JDSCS-Club/DENVER_CCP/DOC/11_SW코드/CPLD_FPGA/RF_COM/readme.txt

<Download file Content>
1. PAC board download file
  - Main CPU : DPAC_060224.bin
  - CPLD : pac_cpld_130419.jed
  - MP3 chip : Septa_Decord_150721.hex
2. DPO board download file
  - CPLD : dpo_151102.jed
3. VOIP board download file
  - VoIP app image : dvoip_0216.bin
4. INT board downlad file
  - CPLD : pac_int_160126.jed
5. PEI board download file
  - CPLD : pei_151029.jed
