JDSCS-Club/DENVER_CCP/DOC/Others/덴버_전동차_통신시스템_분석.md

# 미국 덴버 전동차 통신 시스템 분석 자료

> 작성일: 2026-04-02  
> 프로젝트: Denver EMU (Electric Multiple Unit) Communication System  
> 발주처: RTD (Regional Transportation District) - Denver, Colorado, USA  
> 원청: 현대로템 (Hyundai Rotem)

---

## 1. 프로젝트 개요

미국 콜로라도주 덴버 RTD 경전철 전동차에 탑재되는 **승객 안내 및 통신 시스템(PIS/Communication System)** 개발·납품 프로젝트.  
현대로템이 차량 제작을 담당하고, 우진산전(JDS)이 통신 시스템 서브시스템을 공급하는 구조.

### 1.1 차량 구성
- A Car / B Car 편성 (2량 1편성 기준, 중련 운행 지원)
- 총 50량 규모 (예비품 포함)

### 1.2 프로젝트 타임라인 (폴더 기반 추정)
| 시기 | 주요 활동 |
|---|---|
| 2011.11 | 초기 설계 검토, PT 발표 (Denver 2011_11_28) |
| 2012.01 | SEPTA 참고 자료 검토, 사양 확정 |
| 2012.03 | 현차 조치 방안 수립 (접지, 커넥터, 트랜스포머) |
| 2012.06 | 캐나다 출장 (프로그램, FPGA, LON 작업) |
| 2012.09~10 | 결선도 수정, ROTEM 도면 수신 |
| 2012.11~12 | 도면 수정, 설계 자료 확정 |
| 2013.01 | 창원 공장 확인 |
| 2013.05 | 설계 변경(설변) 내용 정리 |
| 2016.06 | 자동 방송 불량 시험 |
| 2017.03 | 중련 CI 고장 시험, 출장 |
| 2017.07~09 | CNCS 발열(FAN) 대응, FAN 도면/정비 지침서 |
| 2018.03~06 | MDS DDD 수정, CNCS 485통신, RMM/IPC 문서 작업 |
| 2018.09 | PID 파워 불량/영상 출력 불량 대응 |

---

## 2. 시스템 구성 장치

### 2.1 주요 장치 목록

| 장치 약어 | 장치명 | 기능 |
|---|---|---|
| **CRA** | Central Rack Assembly | 중앙 처리 장치 (메인 컨트롤러) |
| **MDS** | Master Display System (CDT) | 마스터 디스플레이 / 안내 표시 장치 |
| **PID** | Passenger Information Display | 객실 승객 안내 표시기 |
| **PEI** | Passenger Emergency Intercom | 승객 비상 인터콤 |
| **ISP** | Interior Speaker Panel | 객실 내 스피커 패널 |
| **LIC** | Line Intercom Controller | 라인 인터콤 제어기 |
| **CCP** | Cab Control Panel | 운전실 제어 패널 |
| **CNCS** | Communication Network Control System | 통신 네트워크 제어 시스템 |
| **ANSM** | Automatic Next Stop Module | 자동 다음 정거장 안내 모듈 |
| **DPO** | Driver's Panel Operator | 운전자 패널 조작기 |
| **SDI** | Serial Data Interface | 직렬 데이터 인터페이스 |
| **RMM** | Repair & Maintenance Manual | 정비 매뉴얼 (문서) |

### 2.2 통신 프로토콜 및 네트워크

| 기술 | 용도 |
|---|---|
| **LON Works** | 차량 내 제어 네트워크 (Echelon 기반) |
| **RS-485** | CNCS 직렬 통신 |
| **VoIP** | 음성 통신 (AudioCodes 프로세서 기반) |
| **WiMAX** | 무선 데이터 통신 (차량-지상 간) |
| **FTP** | 파일 전송 (데이터 다운로드/업로드) |
| **CCP 통신** | RTS 제어 기반 Cab 간 통신 |
| **CI (Consist Interface)** | 중련 편성 간 인터페이스 |

---

## 3. 하드웨어 설계

### 3.1 회로도 (PCB 보드)
- **LIC-C1** : LIC 메인 보드 Rev.1
- **LIC-C2** : LIC 보드 Rev.2
- **LIC-C3 / C3A** : LIC 보드 Rev.3 (DXF, GERBER, PCB 파일 포함)
- **APEM Switch** : 운전실 조작 스위치 회로

### 3.2 주요 부품 (데이터시트 기반)
| 카테고리 | 부품 |
|---|---|
| CPU | TMS320VC33 (DSP), Qseven 보드 |
| 통신 IC | XR16L784 (UART), MAX3535E (RS-485) |
| CPLD | XC95288XL (Xilinx) |
| VoIP | AudioCodes VoIP Processor, CFM53281 |
| 스피커 | Fly Installed Sound 시리즈 |
| 마이크 | AKG PS3F, Gooseneck MIC (MX405/410) |
| 스위치 | APEM Switch, EAO 시리즈, E-Switch |
| 커넥터 | Souriau MSG, Glenair (넥서스), ITH 시리즈 |
| 전원 | MZH30xx 시리즈 DC-DC |
| 네트워크 | MOXA TN-5508/5516 산업용 스위치 |
| 기타 | ULN2803 (드라이버), 슈퍼캐패시터 |

### 3.3 도면 관리
- 덴버 승인도 (ROTEM 승인)
- 차량 배선도 (A Car: RGA10001, B Car: RGA10002)
- 결선도 (2012.09 수정본)

---

## 4. 소프트웨어 구성

### 4.1 프로그램 구조
| 구분 | 내용 |
|---|---|
| LIC 펌웨어 | LIC 보드 제어 프로그램 (CPLD 포함) |
| CCP 프로그램 | AnCCP_MFC (MFC 기반 응용), CCP DB |
| LON 프로그램 | LON Works 네트워크 제어 |
| FPGA | 하드웨어 로직 설계 |
| DPViewer | 디스플레이 뷰어 프로그램 |
| 필드시험 | FTP 데이터 수집/분석 도구 |

### 4.2 SW 문서 체계 (CMMI 기반)
- **SDB** (Software Design Baseline) - WJ_SDB_001
- **STP** (Software Test Procedure) - WJ-STP-002
- **TP** (Test Procedure) - WJ-TP-001
- **SFD** (Software Functional Description / Dead Reckoning)
- **DDD** (Design Description Document) - MDS용
- **FDR** (Formal Design Review) 패키지
- Door System SW 문서 (REDE114718)

---

## 5. 주요 이슈 및 대응 이력

### 5.1 FMI (Field Modification Instruction) 목록

| FMI # | 내용 | 비고 |
|---|---|---|
| #7 | Audio 필터 | 오디오 품질 개선 |
| #8 | CRA Main Update | 메인 보드 업데이트 |
| #9 | BIOS Update | 시스템 BIOS 갱신 |
| #10 | PID Video Update | 영상 출력 업데이트 |
| #11 | RS-485 Board Replacement | 통신 보드 교체 |
| #12 | Software Update | 전체 SW 업데이트 |
| #13 | CAB Latch | 운전실 래치 개선 |
| #14 | ANSM 교체 작업 방법 | 모듈 교체 절차 |
| #15 | MDS Time Stamp | 시간 동기화 문제 |
| #16 | CCP Update | 제어 패널 업데이트 |
| #17 | FAN | 냉각팬 관련 |
| #18 | LIC / VoIP | 인터콤 및 VoIP 개선 |
| #18-1 | LIC Update | LIC 추가 업데이트 |
| #19, #20 | DPO / PEI | 운전자 패널, 비상 인터콤 |
| #21 | PID Power 서포트 변경 | 전원 공급 구조 변경 |

### 5.2 주요 기술 이슈

| 이슈 | 상세 |
|---|---|
| **CNCS 발열 (FAN)** | CNCS 장치 과열 → FAN 추가 설계, 정비 지침서 작성, 로템 추가 요청 자료 대응 (2017) |
| **자동 방송 불량** | 자동 안내 방송 오작동 → 로그 분석, 현차 시험 (2016.06) |
| **CNCS 485 통신** | RS-485 통신 불안정 → 프로그램 수정 (MainTest 6/7 버전) |
| **CI Shift** | 중련 편성 시 CI 인터페이스 고장 → 시험 대응 (2017.03) |
| **CCP 통신 고장** | RTS 제어 관련 통신 장애 |
| **PID 파워/영상 불량** | PID 전원 불량 및 영상 출력 장애 (2018.09) |
| **Gooseneck MIC 불량** | 마이크 입력 회로 불량 |
| **FTP 부하** | 파일 전송 시 윈도우 시스템 부하 발생 |
| **MDS Time Stamp** | MDS 시간 동기화 오류 |
| **MDS DDD 수정** | 설계 문서 수정 검토 (Paul Lee 수신, 2018) |
| **RF_COM NCR** | RF Communication 부적합 보고서 대응 (VoIP 포함) |
| **PEI-OCC** | 승객 비상 인터콤 ↔ OCC 연동 이슈 |
| **LIC 수리품** | LIC 보드 수리 및 재시험 (S/N 14017) |

---

## 6. 문서 체계

### 6.1 기술 문서
- Communications System Operator's Manual (운영 매뉴얼)
- IPC (Illustrated Parts Catalog) - Ch.10 Communication System (Rev.6~7)
- HMM (Heavy Maintenance Manual)
- RMM (Repair & Maintenance Manual)
- Test Procedure (EMI/EMC 포함)
- RAMS (Reliability, Availability, Maintainability, Safety)
- Denver RTD 문서
- MDS/CDT 인터페이스 문서
- 프로토콜 문서

### 6.2 설계 문서
- 회로도 (LIC-C1 ~ C3A)
- 결선도 / 차량 배선도
- 승인도 (ROTEM 승인)
- BOM (Bill of Materials)
- 데이터시트 (CPU, 통신, 전원, 커넥터 등)

### 6.3 품질/계약 문서
- CMMI SW 공학 문서
- PPS (Project Planning Summary)
- ROTEM 계약서 (PTS)
- 견적 자료
- EMI/EMC 시험 성적서

---

## 7. 협력 업체

| 업체 | 담당 분야 |
|---|---|
| 현대로템 (Hyundai Rotem) | 차량 제작, 원청 |
| RF_COM (r-f_com) | RF 통신 모듈 |
| 아이텍 | 하드웨어/소프트웨어 |
| 엑스바이더 | 시스템 관련 |
| 넥서스 (Nexus) | 커넥터 (Glenair) |
| 원텍 | 부품 공급 |
| 웨이브시스템 | 통신 관련 |
| 앤츠 | IPC 관련 |
| 이지파워 | PCB 제작 |
| HS_INS | 부품/장비 |
| SOURIAU MSG | 커넥터 |
| 에버론 | LON Works 관련 |

---

## 8. 폴더 구조 요약

```
denver/
├── 문서/                          # 기술 문서 전체
│   ├── cmmi/                      # CMMI SW 공학 문서
│   ├── Communications System Operator's Manual/
│   ├── denver fdr/                # FDR (설계 검토) 자료
│   ├── denver ipc/                # IPC (부품 카탈로그)
│   ├── mds(cdt) 문서/             # MDS 인터페이스/FDR 문서
│   ├── EMI_EMC 원본 스켄/         # EMI/EMC 시험 성적서
│   ├── Wimax/                     # WiMAX 통신 자료
│   ├── 업체 자료/                 # 협력업체별 자료
│   ├── 파워 포인트 자료/          # 발표/보고 자료
│   └── 견적 관련 자료/            # 견적/원가 자료
├── 설계/                          # 하드웨어 설계
│   ├── 회로도/                    # LIC-C1~C3A, APEM Switch
│   ├── 도면/                      # 승인도, 배선도, 결선도
│   └── DENVER 그림/               # 시스템 구성도
├── program/                       # 소프트웨어
│   ├── CCP/                       # CCP 프로그램
│   ├── lic/                       # LIC 펌웨어, CPLD
│   ├── DPViewer/                  # 디스플레이 뷰어
│   └── 필드시험/                  # 현장 시험 데이터
├── 이슈사항 정리/                 # 이슈 트래킹
│   ├── FMI/                       # FMI #7~#21
│   ├── CNCS 발열(FAN)/            # 발열 대응
│   ├── 자동 방송 불량/            # 방송 불량 대응
│   └── ... (30개 이슈 폴더)
├── 데이타 시트/                   # 부품 데이터시트
├── 자료/                          # 참고 자료, 사진, LON Works
├── 매뉴얼제출문서/                # IPC/RMM 제출 문서
├── VOIP 시험 자료/                # VoIP 시험
├── SEPTA 문제점/                  # SEPTA 프로젝트 참고
└── MDS 창원 시험 데이타/          # MDS 공장 시험 데이터
```

---

## 9. 핵심 요약

- **프로젝트 성격**: 미국 덴버 RTD 경전철 전동차 통신 시스템 (PIS/PA/Intercom/VoIP)
- **시스템 규모**: CRA, MDS, PID, PEI, ISP, LIC, CCP, CNCS, ANSM 등 10종 이상 장치
- **통신 기술**: LON Works + RS-485 + VoIP + WiMAX 복합 네트워크
- **핵심 HW**: TMS320VC33 DSP, Xilinx CPLD, AudioCodes VoIP, MOXA 산업용 스위치
- **주요 이슈**: CNCS 발열, 자동 방송 불량, RS-485 통신 불안정, PID 전원/영상 불량 등 30건 이상
- **문서 체계**: CMMI 기반 SW 공학 문서 + IPC/RMM/HMM 정비 문서 + EMI/EMC 인증
- **협력사**: RF_COM, 아이텍, 엑스바이더, 넥서스 등 10개 이상 업체 참여
