JDSCS-Club/DENVER_CCP/DOC/06_이슈_대응/FMI/42B-2018-0019 (FMI#19 HARDWARE MODIFICATION DPO_PEI).DOCX

DENVER RTD EAGLE P3
COMMUNICATION SYSTEM

# FIELD MODIFICATION INSTRUCTIONS FMI #19: HARDWARE MODIFICATION

# DPO / PEI

CONTRACT NO. | P110701149
CDRL NO. | N/A
WIS DOC. NO. | 42B-2018-0019
REVISION: | 1.0
DESIGNED: | D. S. JANG
REVIEWED: | J. Y. LEE
APPROVED: | B. J. JONE
DATE: | 2/08/2018

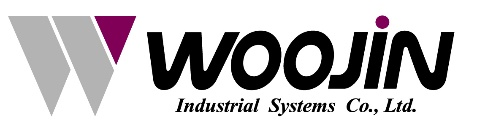
[picture p3: figure]
영문

# Record of Revisions

Rev. | Date | Description | Entered By
1.0 | 2/08/2018 | Initial release | D. S. Jang

# Table of Contents

# 1. Introduction

This FMI provides instructions to install the DPO,PEI and CCP.

# 2. Summary

This modification intends to implement the engineering change proposed as FMI #19. The modification applies to DPO and PEI units installed on the train.

# 3. Circuit changes

## 3.1 DPO / PEI changes

As a result of the DPO / PEI NCR cause analysis, most errors are caused by a malfunction of the AMP IC MP7720 at the speaker output terminals.

In the initial AMP IC design phase, designed DPO/PEI using a 10kΩ resistor (using AMP IC reference circuit) to stabilize the audio output level of the speaker output terminal.

However, the 10kΩ resistor cannot be protected from overload to the AMP IC and caused the operation to be disabled.

Therefore, the board changes the 10kΩ resistor to a 332pF capacitor and switches a circuit that bypasses external noise.

Other previous projects in 2017 have been verified by applying the change circuit. (Domestic Project - Seoul Metro Line No. 2)

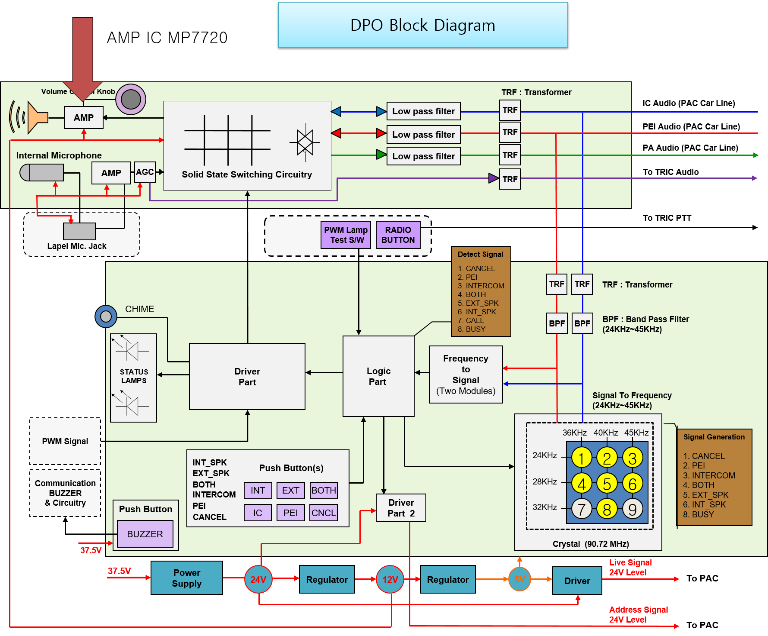
[picture p4: figure]

Figure 1 – DPO AMP IC Location.

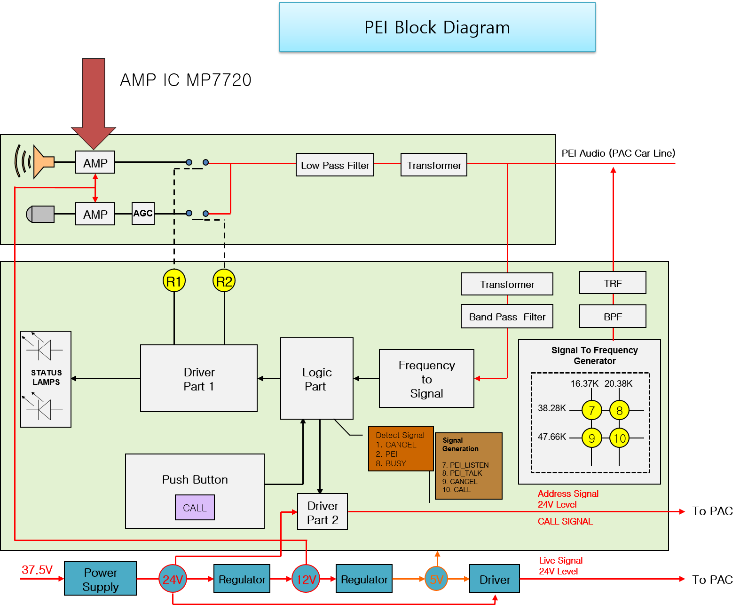
[picture p5: figure]

Figure 2 – PEI AMP IC Location.

1) Before Change
1 Proceeded the DPO and PEI design according to AMP IC MP7720 reference data sheet
2 Request the cause analysis to the IC manufacturer due that the NCR was consistently occurred to same IC
3 Received the scheme change for the Capacitor from IC manufacturer

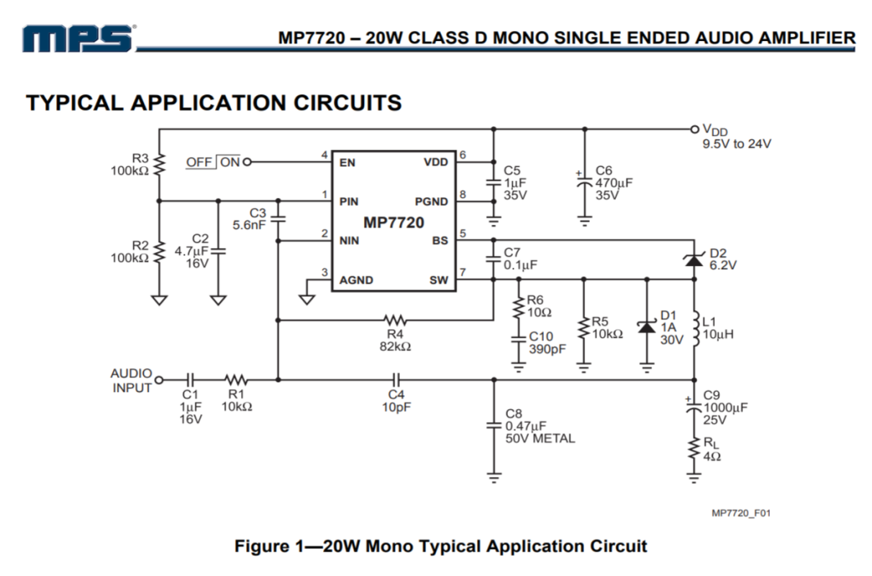
[picture p6: figure]

Figure 3 –AMP IC(MP7720) Reference circuit

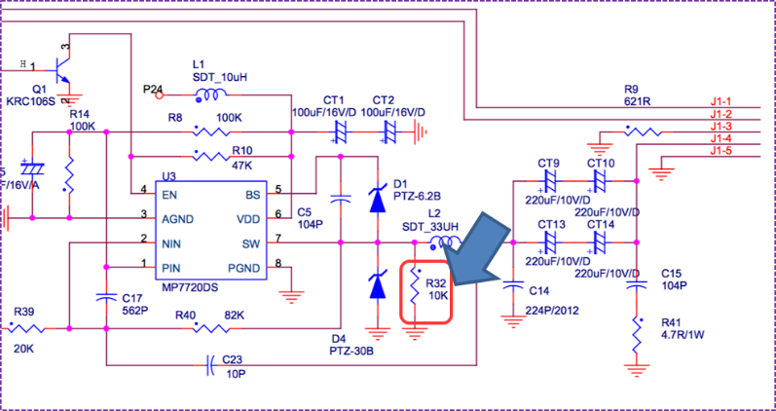
[picture p7: figure]
DPO Schematics

Figure 4 – DPO Board schematics

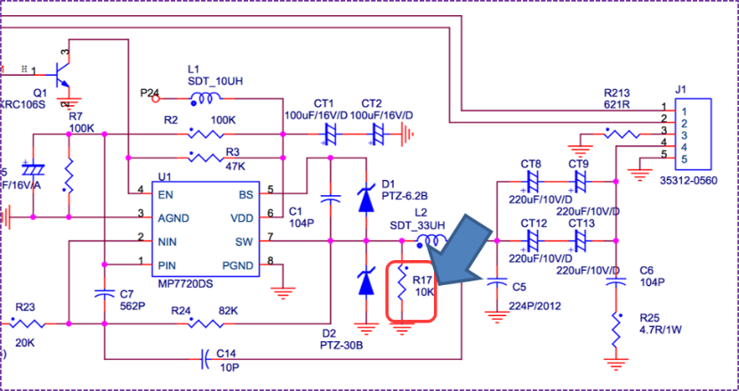
[picture p8: figure]
PEI Schematics

Figure 5 – PEI Board schematics

2) After Change.
1 Performed the simulation for the changes of Resistor to Capacitor
2 Confirmed the same audio output
3 Confirmed the improvement of the output waveform (Shown as the mark in Figure 7 and 8)

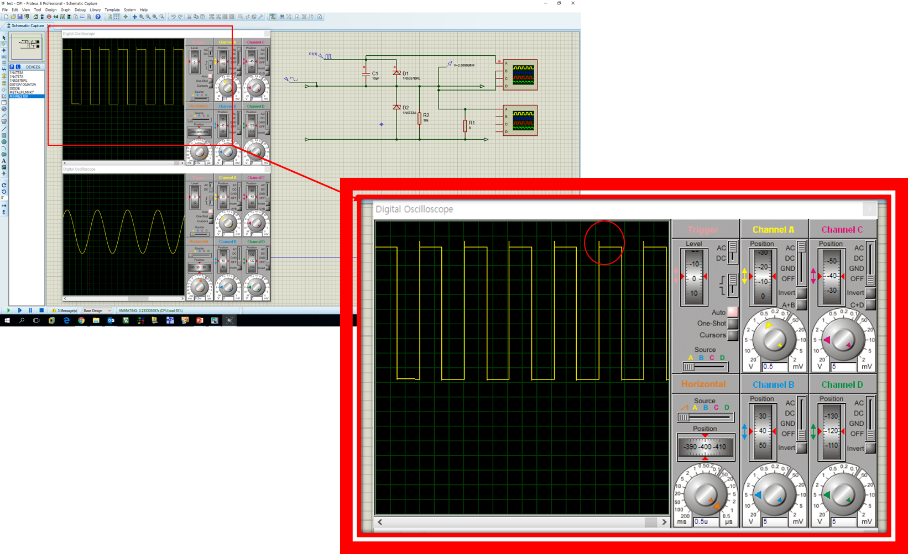
[picture p9: figure]

Figure 7 – 10kΩ Resistor simulation.

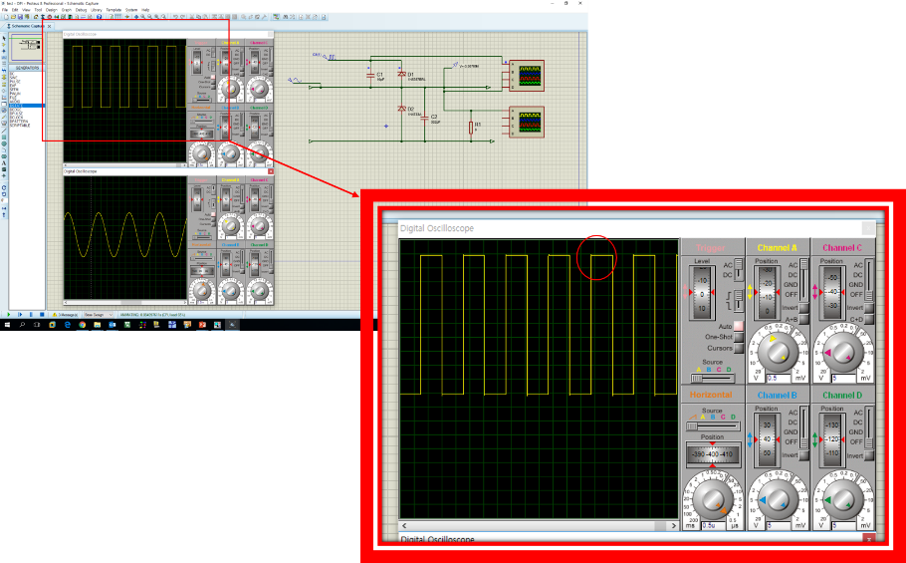
[picture p10: figure]

Figure 8 – 332pF capacitor simulation.

Description | Before Improvement | After Improvement | Remarks
DPO | R32 10kΩ | 332pF | capacitor
PEI | R17 10kΩ | 332pF | capacitor

# 4. Instructions

## 4.1 DPO Instructions

1) Place the COMCB and PICB to OFF position

2) Unscrew 4 mounting bolts on the DPO and PEI

3) Remove the DPO / PEI

4) Conduct PCB operations at designated locations

5) Installation the DPO / PEI

6) Place the COMCB and PICB to ON position

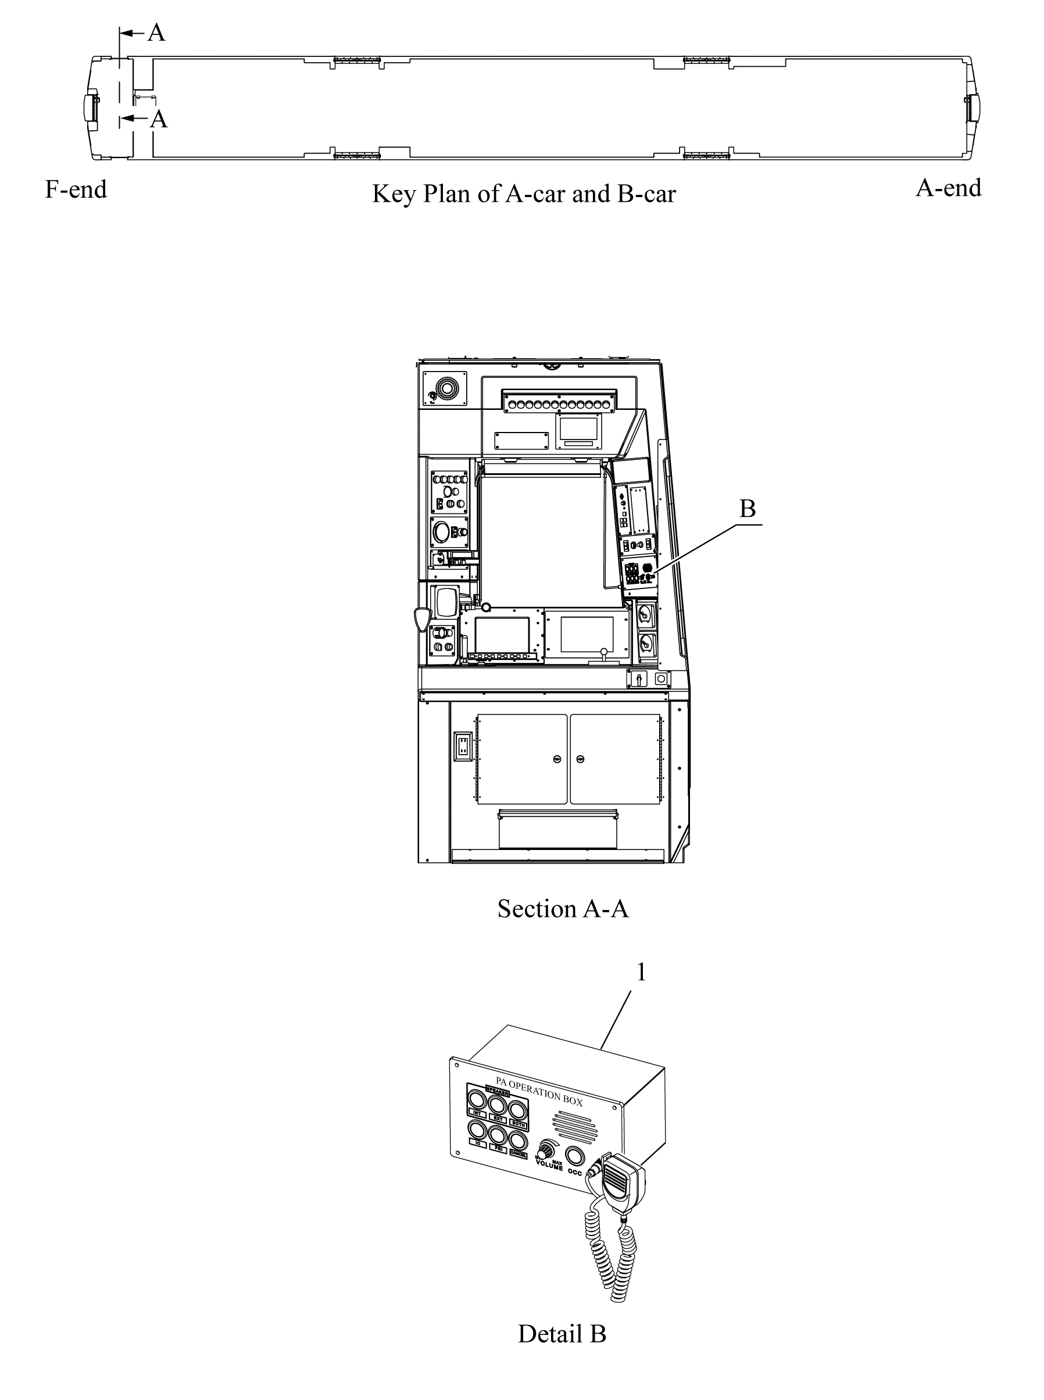
[picture p11: figure]
Loc of Driver PA Operation Box

Figure 9 – DPO Location

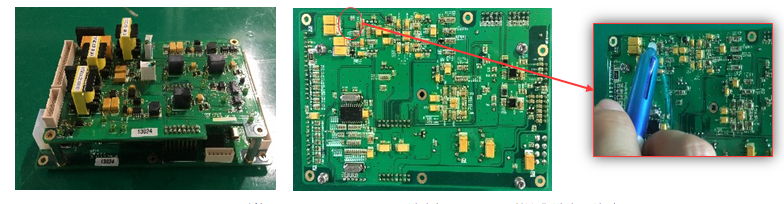
[picture p12: figure]

Figure 10 – DPO Board PCB

## 4.2 PEI Instructions

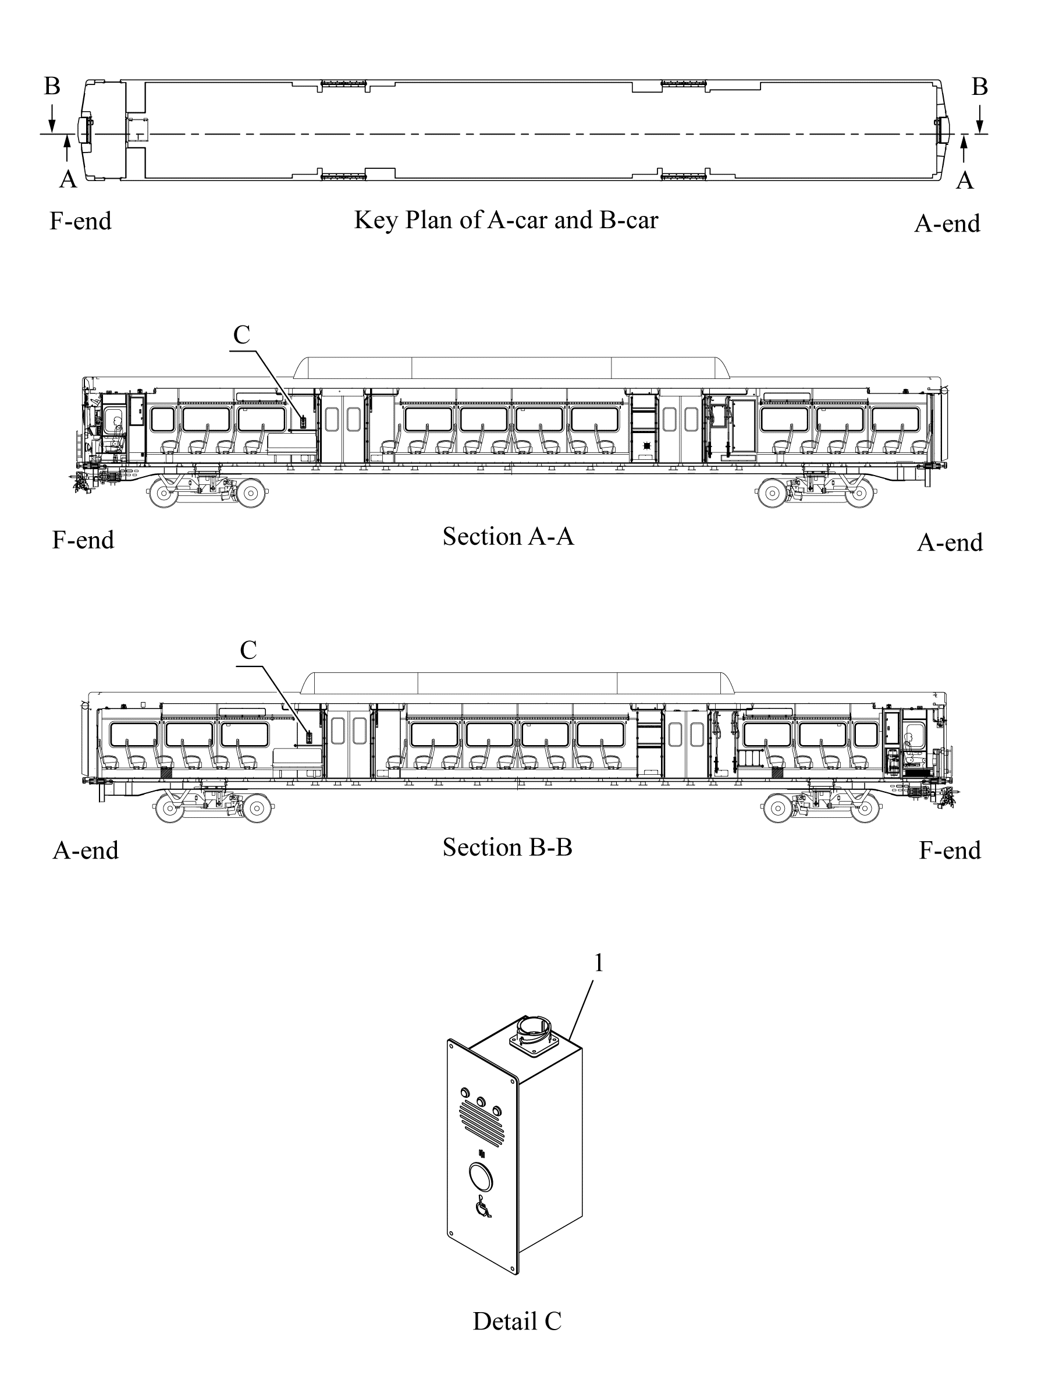
[picture p13: figure]
Location of PEI

Figure 11 – PEI Location

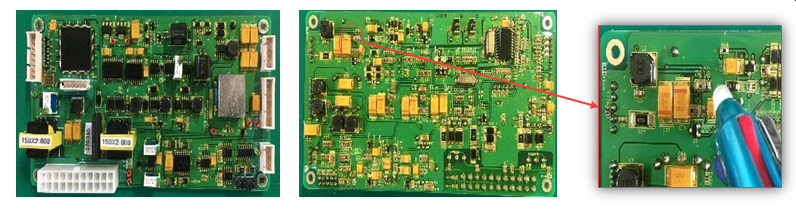
[picture p14: figure]

Figure 12 – PEI Board PCB

# 5. Testing

1) Key-on the cab

2) Using the CCP touchscreen, enter route number 10 or 11

3) Run the route simulation

4) Verify the simulated announcements and displays function appropriately.

7 of 10 © Copyright Woojin Industrial Systems Co., Ltd.

DENVER RTD EAGLE P3 COMMUNICATION SYSTEM FMI #19: HARDWARE MODIFICATION DPO / PEI DOC. NO. 42B-2018-0019 DATE 2/08/2018 REV. NO. 1.0
