JDSCS-Club/DENVER_CCP/DOC/06_이슈_대응/FMI/42B-2018-0020 (FMI #20 HARDWARE MODIFICATION CCP).DOCX

DENVER RTD EAGLE P3
COMMUNICATION SYSTEM

# FIELD MODIFICATION INSTRUCTIONS FMI #20: HARDWARE MODIFICATION

# CCP

CONTRACT NO. | P110701149
CDRL NO. | N/A
WIS DOC. NO. | 42B-2018-0020
REVISION: | 1.0
DESIGNED: | D. S. JANG
REVIEWED: | J. Y. LEE
APPROVED: | B. J. JONE
DATE: | 2/08/2018

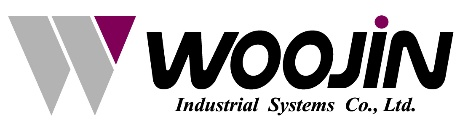
[picture p15: figure]
영문

# Record of Revisions

Rev. | Date | Description | Entered By
1.0 | 2/08/2018 | Initial release | D. S. Jang

# Table of Contents

# 1. Introduction

This FMI provides instructions to install the CCP.

# 2. Summary

This modification intends to implement the engineering change proposed as FMI #20. The modification applies to CCP units installed on the train.

# 3. Circuit changes

## 3.1 CCP CHANGES

As a result of CCP communication failure cause analysis, RTS failure which controls RS-485 communication was detected.

CCP Board controls RS-485 RTS using 74LS123 IC and RTS control time is controlled by capacitor and resistor.

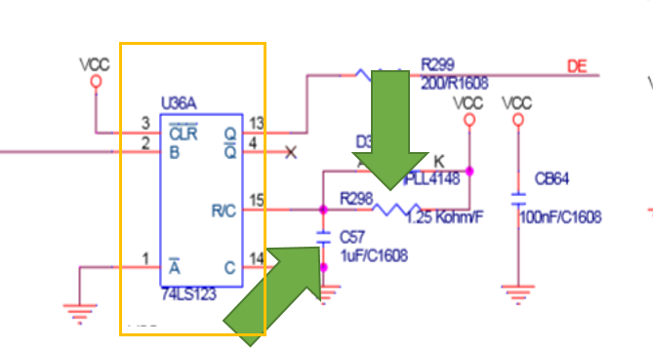
[picture p16: figure]

Figure 1 – CCP Borad RTS Control Circuit

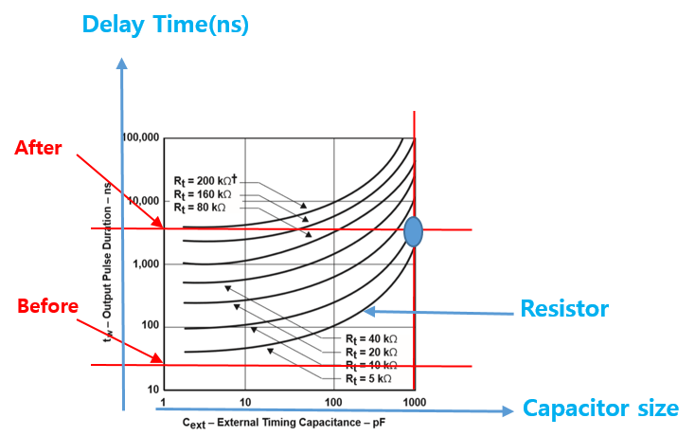
[picture p17: figure]
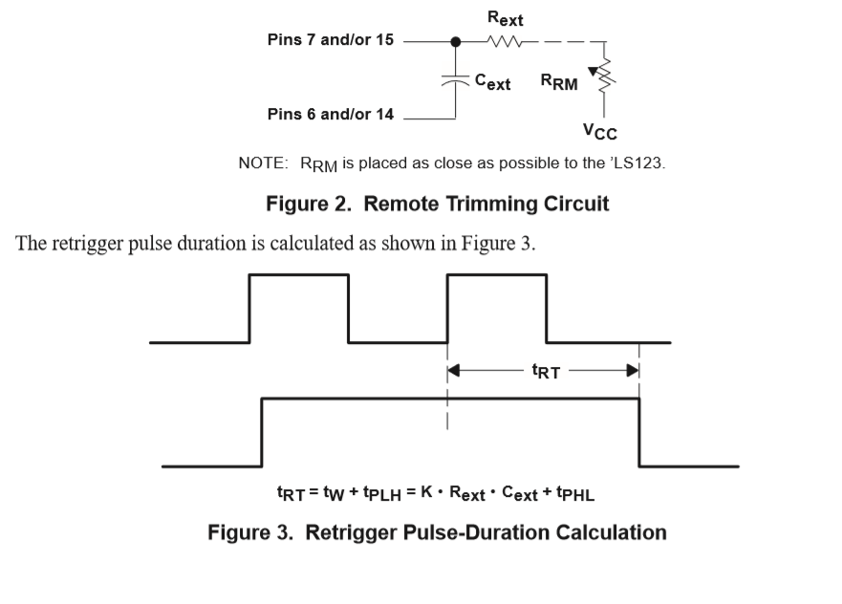
[picture p18: figure]

Figure 1 – CCP Board RTS control mechanism.

1) Before Change

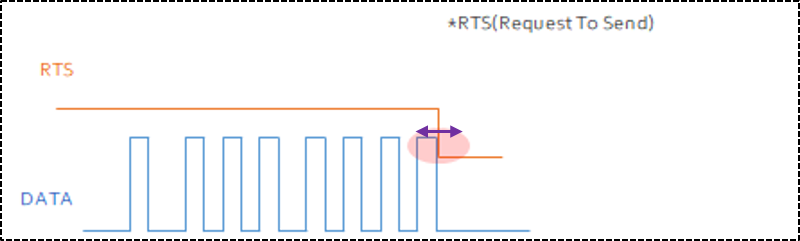
[picture p19: figure]

Figure 2 – Before RTS Control Circuit (R296 1.2kΩ)

CCP Board RTS control is designed to have a delay time of 50ns after transmitting the data. The length of protocol was longer than before since the functionalities were added. In case that the capacitor characteristics are temporary changed by the external factors, the RTS control time will be changed shown as figure 1.

If the RTS time is changed, the last Byte loss of the transferred data will be occurred and recognized as the communication fault

Since the delay time was short, the RTS control time due to external factors (noise and power supply) varied and RS-485 communication failure occurred.

2) After Change

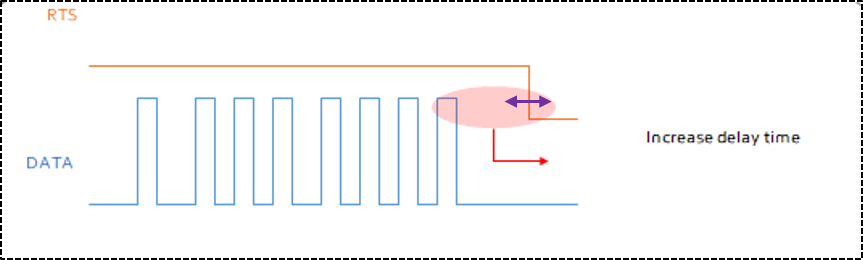
[picture p20: figure]

Figure 3 – After RTS Control Circuit (R296 10KΩ)

The resistance value was changed from 1.2kΩ to 10kΩ and the delay time increased from 50ns to about 1.7ms by about 30,000 times (1,700,000 ns / 50 ns = 34000)

Even if the RTS is changed due to external factors, there will be no issue with RS-485 communication because the sufficient RST control time was secured.

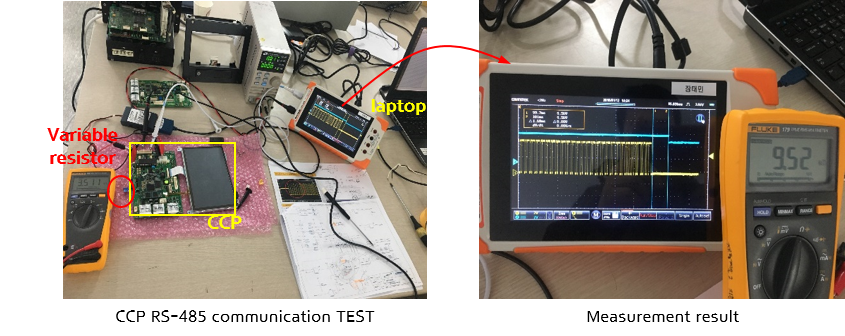
[picture p21: figure]

Figure 3 – CCP RS-485 Communication TEST(R296 10KΩ)

Description | Before Improvement | After Improvement | Remarks
CCP | R296 1.2kΩ(50ns) | R296 10kΩ(1.7ms) | Resistor

# 4. Instructions

## 4.1 CCP Instructions

1) Place the COMCB and PICB to OFF position

2) Unscrew 4 mounting bolts on the DPO and PEI and CCP

3) Remove the DPO / PEI / CCP

4) Conduct PCB operations at designated locations

5) Installation the DPO / PEI /CCP

6) Place the COMCB and PICB to ON position

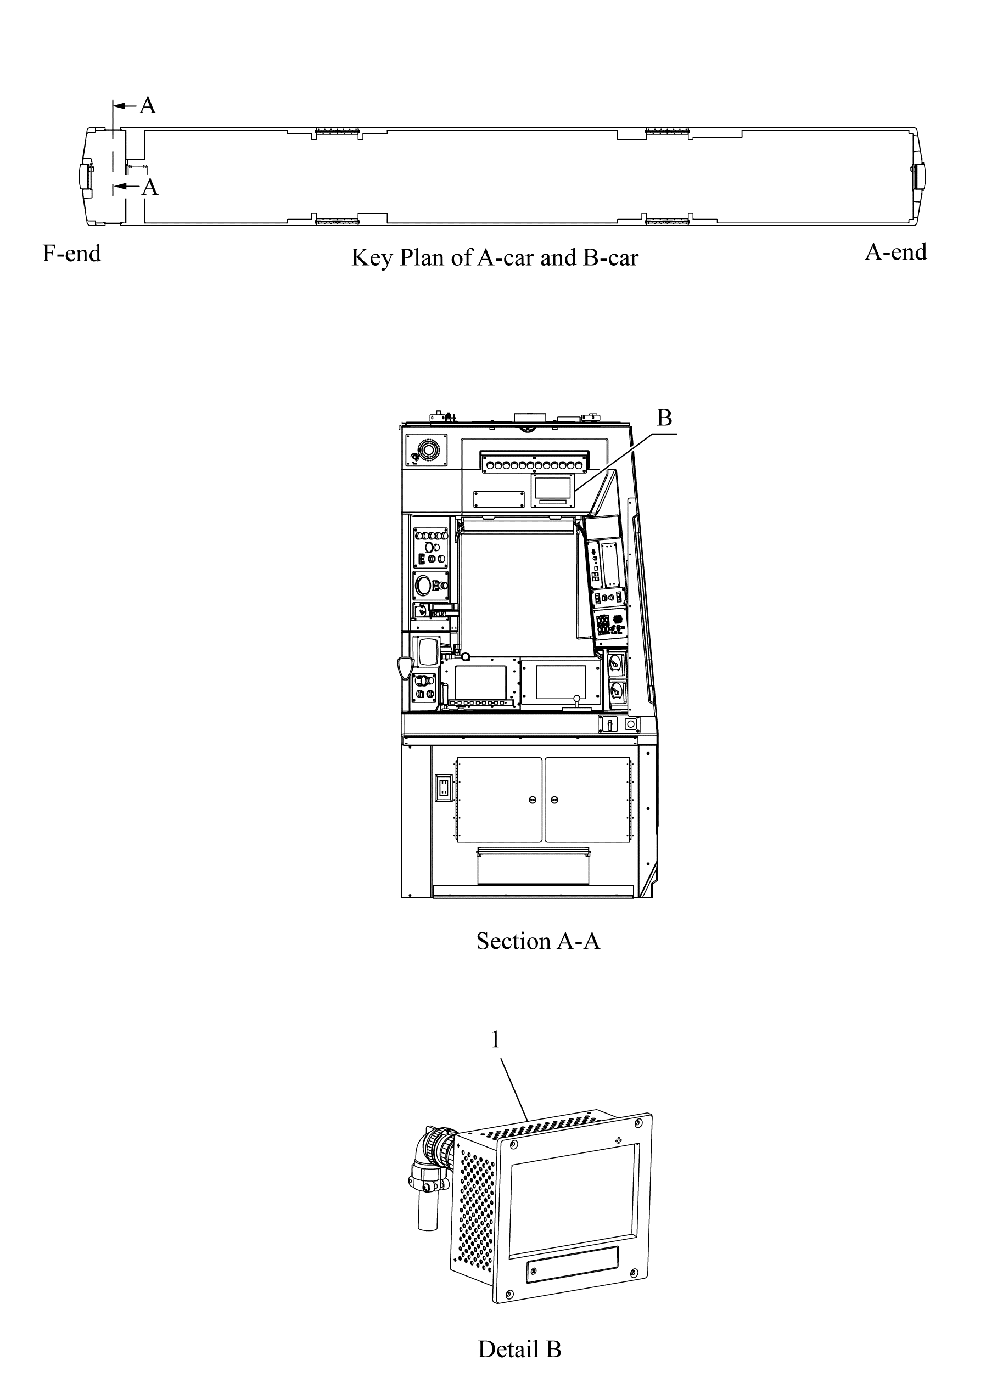
[picture p22: figure]
Location of CCP

Figure 4 – CCP Location

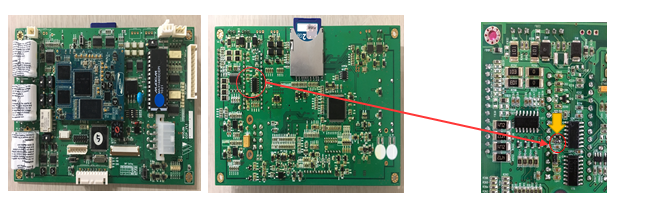
[picture p23: figure]

Figure 5 – CCP Board PCB

# 5. Testing

1) Key-on the cab

2) Using the CCP touchscreen, enter route number 10 or 11

3) Run the route simulation

4) Verify the simulated announcements and displays function appropriately.

8 of 9 © Copyright Woojin Industrial Systems Co., Ltd.

DENVER RTD EAGLE P3 COMMUNICATION SYSTEM FMI #20: HARDWARE MODIFICATION CCP DOC. NO. 42B-2018-0020 DATE 2/08/2018 REV. NO. 1.0
