JDSCS-Club/DENVER_CCP/DOC/06_이슈_대응/FMI/42B-2018-0021 (FMI#21 HARDWARE MODIFICATION PID).docx

DENVER RTD EAGLE P3
COMMUNICATION SYSTEM

# FIELD MODIFICATION INSTRUCTIONS FMI #21: HARDWARE MODIFICATION

# PID

CONTRACT NO. | P110701149
CDRL NO. | N/A
WIS DOC. NO. | 42B-2018-0021
REVISION: | 1.0
DESIGNED: | D. S. JANG
REVIEWED: | J. Y. LEE
APPROVED: | B. J. JONE
DATE: | 15/NOV/2018

영문

# Record of Revisions

Rev. | Date | Description | Entered By
1.0 | 15/NOV/2018 | Initial release | D. S. Jang

# Table of Contents

# 1. Introduction

This FMI provides instructions to install the PID power board.

# 2. Summary

This modification intends to implement the engineering change proposed as FMI #21. The modification applies to PID units installed on the train.

# 3. Changes

## 3.1 PID CHANGE

As a result of PID failure cause analysis, the spacer material between heatsink and baseboard of PID power will change to polyacetal(DURACON).

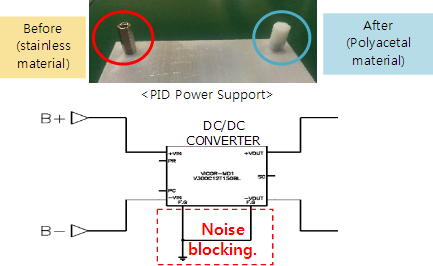
[picture p24: figure]

Figure 1 – PID POWER BOARD CIRCUIT

# 4. Instructions

## 4.1 PID Instructions

1) Place circuit breaker of PID power to OFF position

2) Unscrew 2 mounting bolts on PID.

3) Take off PID power board from PID unit.

4) Unscrew 2 mounting bolts backward of PID power board

5) Unscrew 6 mounting bolts between heatsink and DC/DC converter

6) Change spacer material to polyacetal

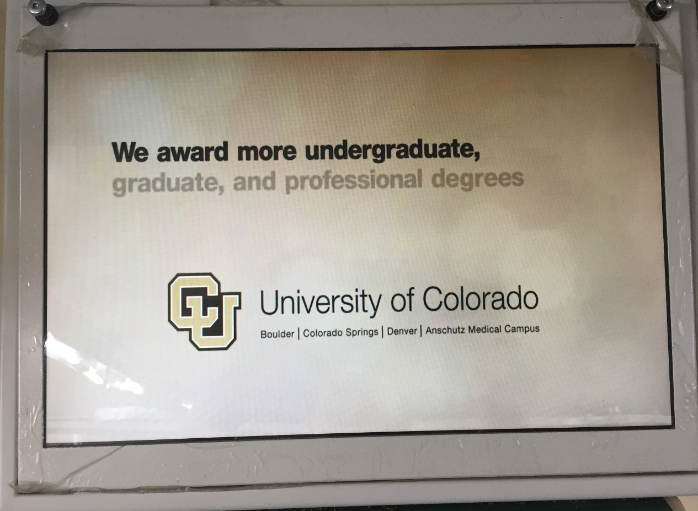
[picture p25: figure]

Figure 2 – PID unit

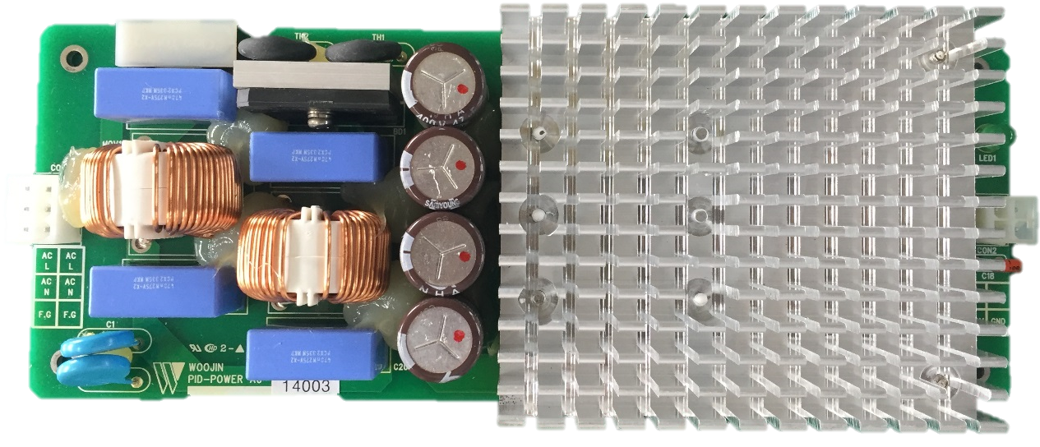
[picture p26: figure]

Figure 3 – PID Power Board

# 5. Testing

1) Turn on PID power circuit breaker

2) Verify the proper operation of PID units.

6 of 6 © Copyright Woojin Industrial Systems Co., Ltd.

DENVER RTD EAGLE P3 COMMUNICATION SYSTEM FMI #21: HARDWARE MODIFICATION PID DOC. NO. 42B-2018-0021 DATE 15/NOV/2018 REV. NO. 1.0
