JDSCS-Club/DENVER_CCP/DOC/06_이슈_대응/FMI/42C-2016-0001_OCC~PEI Proposal_rev1 1_denver.docx

DENVER EAGLE P3
COMMUNICATION SYSTEM

# OCC~PEI INTERFACE PROPOSAL

CONTRACT NO. | P110701149
CDRL NO. | N/A
WIS DOC. NO. | 42C-2016-0001
REVISION: | 1.1
DESIGNED: | J. S. JEONG
REVIEWED: | J. Y. LEE
APPROVED: | B. J. JONE
DATE: | 1/28/2016

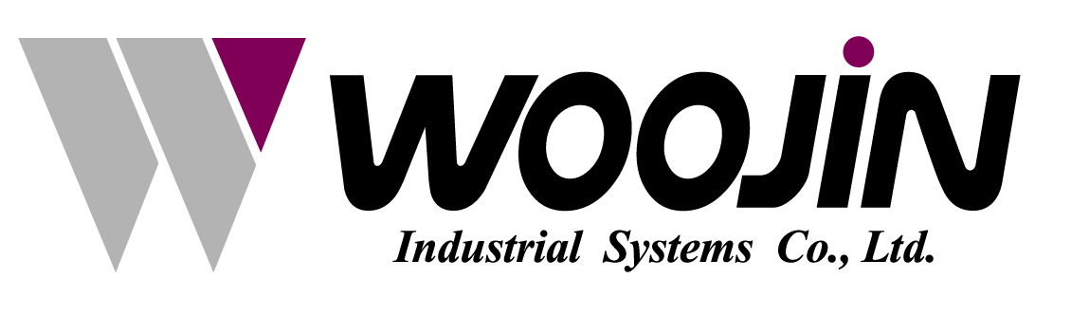
[picture p27: figure]

# Record of Revisions

Rev. | Date | Description | Entered By
1.1 | 1/28/2016 | Initial release | J. S. Jeong

# Table of Contents

# 1. Introduction

This document describes proposed methods to achieve the OCC~PEI communication interface.

# 2. Background

An interface concern has been raised during implementing the OCC~PEI call integration, where the on-board communication/intercom system is half duplex supporting and the wayside Avaya phone system is full duplex.

Based on the approved design, Woojin’s on-board intercom system is half-duplex supported analog-voice transmits. All on-board intercom function have standard ‘listen and push to talk design’ by embedded talk button on the handhold set of DPO and DPH which is the same design as SEPTA SVL. All details is presented on the “Table 3-H” and “Table 3-L” of Woojin On-board communication SFD, 423-309, and approved by DTP.

A VoIP module was later incorporated to the design upon the request from the customer for a ‘way to communicate over the WiMax network’. However, there was no given technical requirement describing what exactly needs to be accomplished. Also there were very limited interfacing discussions and/or documentation during the design phase, which is an essential aspect of a project when different parties need to work together.

Despite the difficulties, the following efforts and discussions were made with regards to this interface:

1) October 2012
  A. Conducted a limited scope of bench test with the Avaya phone at Woojin lab simulator over the VPN remotely
  B. The test verified communication between Avaya phone and Woojin VoIP simulator only
  C. The test did not verify communication down to DPO and individual PEIs from Avaya phone which should require more crucial interface and details design necessary
2) September 2015
  A. Woojin has issued how to implement interface issue between on-board half duplex each PEI and OCC Avaya full duplex phone
  B. Woojin asked DTP to check technical feasibility for push-to-talk from the OCC which is common design for OCC PEI call in terms of call priorities.
  C. DTP said the interface of “OCC to PA/TEXT” with Penta should be the highest priority. So, OCC to PEI interface was not seriously considered
3) November – December 2015
  A. Woojin noticed that DTP didn’t have a complete understanding on the issue
  B. Woojin communicated to DTP again about how it will not work together
  C. Now DTP has obtained understanding on the interfacing concern
4) Discussed about various options:
  A. OCC Avaya phone sending PTT signal over the WiMax – not possible (DTP)
  B. Using specific keys like mute switch or number keys – not feasible (Woojin)
  C. VOX feature – not feasible (Woojin)
  D. Meanwhile Woojin modified an on-board PEI(#4019, F-end) unit incorporating PEI ‘Call’ CPLD logic as push-to talk button – implemented successfully, but needed to be reviewed and approved by DTP.
  E. DTP requested to design development of separate “push-to-talk” box installed on OCC to send a PTT command to on-board PEI, must likely CNCS board of CRA during series of recent discussion.

# 3. ProposAL for OCC PTT SOULTION

Woojin proposes to deploy an additional PTT switch (or a soft button in a form of software) at the OCC to signal the on-board Comm. to switch between talk/listen modes.

While the on-board VoIP of CRA and Avaya telephone server communicates through regular SIP/RTP, the on-board CNCS of CRA and OCC PTT switch will communicate using customized special protocol to manage the talk/listen modes.

Figure below shows the functional concept of the proposed system.

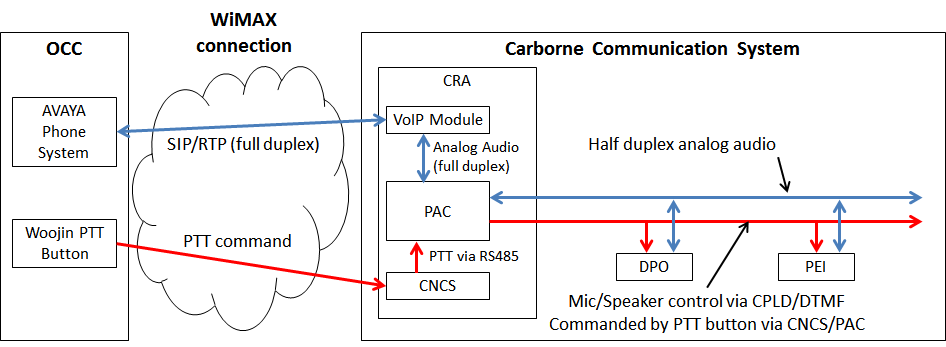
[picture p28: figure]

Figure below shows the limitation of the original system where the OCC and the PEI cannot appropriately communicate.

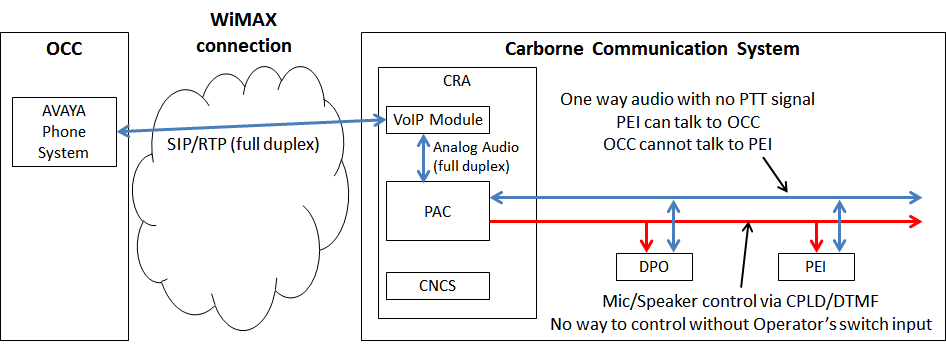
[picture p29: figure]

# 4. Functions

Below describes how the proposed system will function:

1) PEI requests an emergency call
2) No response from DPO for 13 seconds. This time is counted by PAC
3) If PAC does not acknowledge DPO’s response by 13 seconds, PAC signals VoIP to call the specific phone number, i.e. #2000. PAC uses internal dry contact to signal VoIP
4) OCC picks up the call
5) Call session between OCC phone and on-board VoIP module is initiated
6) CNCS and OCC PTT communicates in a different communication channel using custom protocol
7) When OCC PTT is “active”:
  A. PTT sends “PTT active” signal to CNCS over WiMax network
  B. CNCS acknowledges “PTT active” and transfers the signal to PAC board via RS-485 serial link.
  C. PAC acknowledges “PTT active”. Converts to DTMF signal for analog and transfers it to any of activated PEI (or DPO).

: Activate speaker and deactivate microphone on the PEI.

8) When OCC PTT is “inactive”:
  A. PTT sends “PTT inactive” signal to CNCS over WiMax network
A. CNCS acknowledges “PTT inactive” and transfers the signal to PAC board via RS-485 serial link.
  B. PAC acknowledges “PTT inactive”. Converts to DTMF signal for analog and transfers it to any of activated PEI (or DPO).

: Deactivate speaker and deactivate microphone on the PEI.

9) When call is completed, a contact on the VoIP is opened to close PAC communication.
10) PAC clears the call session using DTMF signal (analog)

# 5. Commissioning and Delivery

1) For on-site commissioning purpose, Woojin and Hyundai-Rotem will perform a demonstration using Windows-based software with PTT function described in this proposal. Woojin targets to complete this activity by 1 week after receipt of DTP’s approval.
2) Upon receipt of separate purchase order by DTP, Woojin and Hyundai-Rotem will supply actual PTT switch hardware equipped with the same function.

# 6. Limitations

The proposed PTT solution only considers a single call at a time. Advanced telephone-specific features such as multiple calls from different cars, standby calls in queue, etc. are not supported.

Any further expansion to this interface is out of Woojin’s scope of works and technical capability. Woojin will not be able to support any other request from DTP to review potential expansions besides what is proposed in this document.

2 of 7 © Copyright Woojin Industrial Systems Co., Ltd.

DENVER EAGLE P3 COMMUNICATION SYSTEM OCC~PEI INTERFACE PROPOSAL DOC. NO. 42C-2016-0001 DATE 1/28/2016 REV. NO. 1.1
