JDSCS-Club/DENVER_CCP/DOC/Others/권영진/DENVER SFD.pptx

Communication Rack-A

DC 12V

PSA

SCB

DC 37.5V

Wimx

PA System MA

LIC

WLR

A

LONWORKS for MDS

A

LAN

VTX

LVDS

CNCS

HDD

Digital Video Signal

Digital Video Signal

ATA

PAC

485
Card

VOIP

CAB ON

Door & F/R

ODMETER

DC 37.5V

DC 37.5V

DC 12V

BACK PLAN BOARD

RS485

RS485

PEI ADDRESS, CALL

PEI Audio & Signal

Passenger Emergency
Intercom

ANSM

Passenger Emergency
Intercom

PEI ADDRESS, CALL

PEI Audio & Signal

ANSM

PEI ADDRESS, CALL

PEI Audio & Signal

Dual - tone

DPO ADDRESS, ACT

PA Audio & Signal

IC Audio & Signal, PA Audio

Dual - tone

DPO ADDRESS, ACT

PA Audio & Signal

DPH

PEI TL

Audio

DC 37.5V

Driver PA
Operation Box

Audio

DIMMER

DC 12V

Audio

Driver Microphone

Driver PA
HandSet

Audio

IC TL

CPO ADDRESS, ACT

IC Audio & Signal, PA Audio

MUTE

IC Audio & Signal, PA Audio

CPO ADDRESS, ACT

CPO ADDRESS, ACT

RS485 TL

PA Audio TL

Dual- tone TL

TRF

DC 37.5V

ISP

TRF

Passenger
Emergency
Intercom

TRF

TRF

ISP

TRF

TRF

ISP

TRF

Passenger
Emergency
Intercom

DC 37.5V

TRF

AAB

Interior Speaker CH1

ISP

ISP

Interior Speaker CH1

ISP

ISP

ISP

DC 37.5V

Audio LINE

LEFT Side Exterior Speaker PA

Interior Speaker CH2

Interior Speaker CH2

RIGHT Side Exterior Speaker PA

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
RS485 TL

IC TL

PA Audio TL

Dual- tone TL

RS485 TL

Dual- tone TL

PA Audio TL

PEI TL

IC TL

PEI TL

## Slide 2

Communication Rack-A

DC 12V

PSA

SCB

DC 37.5V

Wimx

PA System MB

LIC

WLR

A

LONWORKS for MDS

A

LAN

VTX

LVDS

CNCS

HDD

Digital Video Signal

Digital Video Signal

ATA

PAC

485
Card

VOIP

CAB ON

Door & F/R

ODMETER

DC 37.5V

DC 37.5V

DC 12V

BACK PLAN BOARD

RS485

RS485

PEI ADDRESS, CALL

PEI Audio & Signal

Passenger Emergency
Intercom

ANSM

Passenger Emergency
Intercom

PEI ADDRESS, CALL

PEI Audio & Signal

ANSM

PEI ADDRESS, CALL

PEI Audio & Signal

Dual - tone

DPO ADDRESS, ACT

PA Audio & Signal

IC Audio & Signal, PA Audio

Dual - tone

DPO ADDRESS, ACT

PA Audio & Signal

DPH

PEI TL

Audio

DC 37.5V

Driver PA
Operation Box

Audio

DIMMER

DC 12V

Audio

Driver Microphone

Driver PA
HandSet

Audio

IC TL

CPO ADDRESS, ACT

IC Audio & Signal, PA Audio

MUTE

IC Audio & Signal, PA Audio

CPO ADDRESS, ACT

CPO ADDRESS, ACT

RS485 TL

PA Audio TL

Dual- tone TL

TRF

DC 37.5V

ISP

TRF

Passenger
Emergency
Intercom

TRF

TRF

ISP

TRF

TRF

ISP

TRF

Passenger
Emergency
Intercom

DC 37.5V

TRF

AAB

Interior Speaker CH1

ISP

ISP

Interior Speaker CH1

ISP

ISP

ISP

DC 37.5V

Audio LINE

LEFT Side Exterior Speaker PA

Interior Speaker CH2

Interior Speaker CH2

RIGHT Side Exterior Speaker PA

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
RS485 TL

IC TL

PA Audio TL

Dual- tone TL

RS485 TL

Dual- tone TL

PA Audio TL

PEI TL

IC TL

PEI TL

## Slide 3

Communication Rack-A

DC 12V

PSA

SCB

LIC

WLR

DC 37.5V

Communication
Control Head

DC 37.5V

CAB ON

ADDRESS

FDI

Passenger Information System MA

LONWORKS for MDS

AC 230V

DC 37.5V

AC 230V

SDI

AC 230V

AC 230V

SDI

AC 230V

LAN

LVDS

VTX

A

Digital Video Signal

Digital Video Signal

PII

AC 230V

ATA

CNCS

HDD

PAC

485
Card

VOIP

AAB

CAB ON

LCD Display

LCD Display

DC 12V

BACK PLAN BOARD

RS485

RS485

Door & F/R

ODMETER

LCD Display

AC 230V

LCD Display

AC 230V

LCD Display

AC 230V

PII

DC 37.5V

PEI TL

IC TL

PA Audio TL

Dual- tone TL

AC 230V

SDI

AC 230V

SDI

Audio LINE

RS485 TL

DC 37.5V

RS485 TL

Dual- tone TL

RS485 TL

Dual- tone TL

IC TL

PEI TL

PA Audio TL

IC TL

PEI TL

PA Audio TL

## Slide 4

Passenger Information System MB

Communication
Control Head

DC 37.5V

CAB ON

ADDRESS

FDI

DC 37.5V

PSA

SCB

LIC

WLR

Communication Rack-A

DC 12V

AC 230V

SDI

AC 230V

SDI

AC 230V

DC 37.5V

AC 230V

LONWORKS for MDS

PII

AC 230V

Digital Video Signal

Digital Video Signal

A

VTX

LVDS

LAN

LCD Display

LCD Display

CAB ON

CNCS

HDD

PAC

485
Card

VOIP

AAB

ATA

DC 12V

Door & F/R

ODMETER

RS485

RS485

BACK PLAN BOARD

LCD Display

AC 230V

LCD Display

AC 230V

LCD Display

AC 230V

DC 37.5V

PII

SDI

AC 230V

SDI

AC 230V

PA Audio TL

Dual- tone TL

PEI TL

IC TL

RS485 TL

Audio LINE

DC 37.5V

RS485 TL

Dual- tone TL

RS485 TL

Dual- tone TL

PA Audio TL

IC TL

PEI TL

PA Audio TL

IC TL

PEI TL

## Slide 5

CSP

ESP

ESP

DPO

P E I

ANS

P E I

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
CONTROLLER
& POWER AMP

DPH

ANS

P E I

ESP

P E I

ESP

CSP

ESP

ESP

DPO

P E I

ANS

P E I

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
CONTROLLER
& POWER AMP

DPH

ANS

P E I

ESP

P E I

ESP

## Slide 6

PA Controller Block Diagram

Audio Amplifier Board

Audio File CNCS
(via USB)

RS-485 CL

Cab On

Door

Conductor Audio

Intercom Audio

Driver Audio

Ether net

Audio File
Memory

Automatic
Broadcasting
Player

PA
Controller

Ether net VoIP
Control UNIT

Line Control

Interior Speaker
Channel 1

Recording
Control

Power AMP
Channel 1

Matching
Transformer

Interior SPK
Volume Control
(Interior Channels)

Power AMP
Channel 2

Matching
Transformer

Interior Speaker
Channel 2

I 2C

Exterior SPK
Volume Control
(Left Channel)

Exterior SPK
Volume Control
(Right Channel)

Power AMP
Channel 3

Exterior Speaker
Channel 1
Left Side

ANS Controller
MCU

Matching
Transformer

I²C (Inter-Integrated Circuit)

Exterior Speaker
Channel 2
Right Side

Power AMP
Channel 4

Matching
Transformer

TRF

TRF

Power
Module

ANS
Microphone

Intercom TL

ANS
Microphone

Trainlines

PA audio TL

Ether net
TL

DC37.5V

PA Controller Block Diagram-R01 - 20110228.ppt

## Slide 7

Diagram 4.5.2.5-B(54P)

Denver DPO Block Diagram

Volume Control Knob

Internal
Microphone

AMP

AMP

AUDIO EXPANDER

Solid State Switching Circuitry

L.P.F

L.P.F

ALC

ALC

Transformer

Transformer

CPO Audio

DPO Audio

AUDIO COMPANDOR

L.P.F

L.P.F

ALC

ALC

Transformer

Transformer

PEI Audio

VOIP Audio

Lapel Mic. Jack

CAB ON

Communication
BUZZER
& Circuitry

Push Button

BUZZER

Push Button

INT

SPEAKER

EXT

BOTH

IC

INTERCOM

PEI

CANCEL

Audio Controller

Logic
Controller

Power
Module

Tone
DRIVER

Transformer

Tone
Generator

Dual Tone Audio

DC37.5V

Tone
Filter

Digital
Detection

Digital
Control

Regulator

Live Signal
Address Signal

To PAC

DC37.5V

(DPO) Block Diagram-R01 - 20110316.ppt

## Slide 8

Diagram 4.5.3.2-B(59P)

Station Trigger Points map

Approaching Station

1001

R

1002

R

1003

A

Platform Station

1004

A

Center Point
Of Station

1005

Station

A

Station 001

TP1 | 1001 | Outer Relative
TP2 | 1002 | Inner Relative
TP3 | 1003 | Approaching Station
TP4 | 1004 | Platform Perimeter
TP5 | 1005 | Center of Station
TP6 | 1006 | Platform Perimeter
TP7 | 1007 | Approaching Station
TP8 | 1008 | Inner Relative
TP9 | 1009 | Outer Relative

A

1006

A

1007

R

1008

R

1009

Platform perimeter

Approaching Station

A

Absolute Trigger Point

R

Relative Trigger Point

## Slide 9

Diagram 4.5.4.3-A(61P)

Automatic
Broadcasting
Player

PA
Controller

A/D
Converter

Power AMP
Channel 1

Matching
Transformer

Interior Speaker
Channel 1

Relay 1

Relay 2

Relay 3

Interior SPK
Volume
Control

Power AMP
Channel 2

Interior Speaker
Channel 2

Relay 4

Matching
Transformer

Relay 5

Relay 6

I C

2

Low Pass Filter

37.5V

+12V

Power
Module

-12V

LPF

ANS
Microphone

ANS
Microphone

## PAC TL & RS-485 Block Diagram

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
RS-485 Train Line Circuitry Block Diagram - 20110331.ppt

## Slide 11

Diagram 5.1.5.12-B(117P)

Married Pair

Married A Car

Married B Car

Rt

Repeat

Rt

CRA

PAC

Rt

Repeat

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
Relay for train consist

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
Relay for train consist

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
## Slide 12

Ether net VoIP Block Diagram

SPI

Recording
AUDIO

RX AMP

TX AMP

LDO

FLASH

To Recording

DSP

BMP

TO RX AUDIO

TO TX AUDIO

TO MCU I/O

GPIO

TO RS-485 Car Line

UART

RMII

Ethernet

SDI

LDO

SDRAM

Regulator

12V

RJ45

Mac

Ether net VoIP Control Block Diagram-R01 - 20110228.ppt

## Slide 13

ANTENNA

TRIC

Screen Data

CCP

CRA/
CRB

Station Code Data

FDI

PID1

CPO

SDI

PII

PID2

INTERNAL/EXTERNAL SPEAKERS

Video Data

Voice Data

DPO

PEI

## Slide 14

Dispatcher

Voice Gateways
(VOIP

DENVER
Wimax Network

Application Server for.
- Text Messaging
- Control Center PA

VIOP

Public Address Audio

Comm
Rack

TEXT DATA

Ethernet

DENVER RTD

LED / LCD

## Slide 15

Communication Rack-A

DC 12V

PSA

SCB

DC 37.5V

Wimx

PA System MA

LIC

WLR

A

LONWORKS for MDS

A

LAN

VTX

LVDS

CNCS

HDD

Digital Video Signal

Digital Video Signal

ATA

PAC

485
Card

VOIP

CAB ON

Door & F/R

ODMETER

DC 37.5V

DC 37.5V

DC 12V

BACK PLAN BOARD

RS485

RS485

PEI ADDRESS, CALL

PEI Audio & Signal

Passenger Emergency
Intercom

ANSM

Passenger Emergency
Intercom

PEI ADDRESS, CALL

PEI Audio & Signal

ANSM

PEI ADDRESS, CALL

PEI Audio & Signal

Dual - tone

DPO ADDRESS, ACT

PA Audio & Signal

IC Audio & Signal, PA Audio

Dual - tone

DPO ADDRESS, ACT

PA Audio & Signal

DPH

PEI TL

Audio

DC 37.5V

Driver PA
Operation Box

Audio

DIMMER

DC 12V

Audio

Driver Microphone

Driver PA
HandSet

Audio

IC TL

CPO ADDRESS, ACT

IC Audio & Signal, PA Audio

MUTE

IC Audio & Signal, PA Audio

CPO ADDRESS, ACT

CPO ADDRESS, ACT

RS485 TL

PA Audio TL

Dual- tone TL

TRF

DC 37.5V

ISP

TRF

Passenger
Emergency
Intercom

TRF

TRF

ISP

TRF

TRF

ISP

TRF

Passenger
Emergency
Intercom

DC 37.5V

TRF

AAB

Interior Speaker CH1

ISP

ISP

Interior Speaker CH1

ISP

ISP

ISP

DC 37.5V

Audio LINE

LEFT Side Exterior Speaker PA

Interior Speaker CH2

Interior Speaker CH2

RIGHT Side Exterior Speaker PA

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
RS485 TL

IC TL

PA Audio TL

Dual- tone TL

RS485 TL

Dual- tone TL

PA Audio TL

PEI TL

IC TL

PEI TL

Communication Rack-A

DC 12V

PSA

SCB

DC 37.5V

Wimx

PA System MB

LIC

WLR

A

LONWORKS for MDS

A

LAN

VTX

LVDS

CNCS

HDD

Digital Video Signal

Digital Video Signal

ATA

PAC

485
Card

VOIP

CAB ON

Door & F/R

ODMETER

DC 37.5V

DC 37.5V

DC 12V

BACK PLAN BOARD

RS485

RS485

PEI ADDRESS, CALL

PEI Audio & Signal

Passenger Emergency
Intercom

ANSM

Passenger Emergency
Intercom

PEI ADDRESS, CALL

PEI Audio & Signal

ANSM

PEI ADDRESS, CALL

PEI Audio & Signal

Dual - tone

DPO ADDRESS, ACT

PA Audio & Signal

IC Audio & Signal, PA Audio

Dual - tone

DPO ADDRESS, ACT

PA Audio & Signal

DPH

PEI TL

Audio

DC 37.5V

Driver PA
Operation Box

Audio

DIMMER

DC 12V

Audio

Driver Microphone

Driver PA
HandSet

Audio

IC TL

CPO ADDRESS, ACT

IC Audio & Signal, PA Audio

MUTE

IC Audio & Signal, PA Audio

CPO ADDRESS, ACT

CPO ADDRESS, ACT

RS485 TL

PA Audio TL

Dual- tone TL

TRF

DC 37.5V

ISP

TRF

Passenger
Emergency
Intercom

TRF

TRF

ISP

TRF

TRF

ISP

TRF

Passenger
Emergency
Intercom

DC 37.5V

TRF

AAB

Interior Speaker CH1

ISP

ISP

Interior Speaker CH1

ISP

ISP

ISP

DC 37.5V

Audio LINE

LEFT Side Exterior Speaker PA

Interior Speaker CH2

Interior Speaker CH2

RIGHT Side Exterior Speaker PA

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
RS485 TL

IC TL

PA Audio TL

Dual- tone TL

RS485 TL

Dual- tone TL

PA Audio TL

PEI TL

IC TL

PEI TL

## Slide 16

RS 485 Train Line Relay States During Inauguration
Inauguration Steps Input Signal | | Married A 1nd | | Married B 2nd | | | Married A 3nd | | Married B 4nd | | | Married A 5nd | | Married B 6nd | | | Married A 7nd | | Married B 8nd
| | PAC A | PAC B | PAC A | PAC B | | PAC A | PAC B | PAC A | PAC B | | PAC A | PAC B | PAC A | PAC B | | PAC A | PAC B | PAC A | PAC B
| | Ra | Rb | Ra | Rb | | Ra | Rb | Ra | Rb | | Ra | Rb | Ra | Rb | | Ra | Rb | Ra | Rb | | | 1 | 2 | 3 | 4 | 5 | 6 | 7 | 8
1. Power ON | | c | c | c | c | | c | c | c | c | | c | c | c | c | | c | c | c | c | | | X | X | X | X | X | X | X | X
| | | | | | | | | | | | | | | | | | | | | | All Relays default to the close (on) State
2. Coupler Check | | c | c | c | c | | c | c | c | c | | c | c | c | c | | c | c | c | c | | | X | X | X | X | X | X | X | X
| | | | | | | | | | | | | | | | | | | | | | PAC - A of the 1st Car & PAC-B of 8th Car both hold a TOC token
3. Cab-ON @(2nd, PAC-A) SET Master PAC | | O | c | c | c | | c | c | c | c | | c | c | c | c | | c | c | c | O | | | X | X | X | X | X | X | X | X
| | | | | | | | | | | | | | | | | | | | | | PAC-A of the 2nd Car is the Master PAC.
4. Request TOC Response | | O | c | c | c | | c | O | c | c | | c | c | c | c | | c | c | c | O | | | 1 | X | X | X | X | X | X | X
| | | | | | | | | | | | | | | | | | | | | | Open(2nd,PAC-A,Rb)to disconnect from Paired PAC-B, Master PAC requests Toc response & (1st. PAC - A) responds.
5. Set HOC Token Flag | | O | c | c | c | | c | c | c | c | | c | c | c | c | | c | c | c | O | | | 1 | X | X | X | X | X | X | X
| | | | | | | | | | | | | | | | | | | | | | Master PAC sets (1st. PAC - A) HOC & then returns all relays to default status.
6. Request TOC Response | | O | c | c | c | | c | c | c | c | | c | c | c | c | | c | c | c | O | | | 1 | X | X | X | X | X | X | 8
| | | | | | | | | | | | | | | | | | | | | | The only remaining remaining TOC token is held by (8th, PAC-B) & responds to the request
7. Get Response & Update Consist Inauguration Tables | | O | c | c | c | | c | c | c | c | | c | c | c | c | | c | c | c | O | | | 1 | X | X | X | X | X | X | 8
| | | | | | | | | | | | | | | | | | | | | | All PAC's update their Inauguration table with HOC, TOC, and Master Info.
8. Pass Token (1ST. PAC-B) | | O | c | C | O | | O | c | c | O | | O | c | c | O | | O | c | c | O | | | 1 | X | X | X | X | X | X | 8
| | | | | | | | | | | | | | | | | | | | | | The PAS Token is passed from the HOC token holder to the next adjacent PAC.
9. Get Response & Update Consist Inauguration Tables | | O | c | C | C | | c | c | c | c | | c | c | c | c | | c | c | c | O | | | 1 | 2 | X | X | X | X | X | 8
| | | | | | | | | | | | | | | | | | | | | | All PAC's update their Inauguration table to include (2st. PAC-B) paramaters.
10. Pass Token (2nd, PAC-A) | | O | c | c | c | | C | O | O | c | | c | O | O | c | | c | O | c | O | | | 1 | 2 | X | X | X | X | X | 8
| | | | | | | | | | | | | | | | | | | | | | The PAS token is passed from the current token holder to the next adjacent PAC.
11. Get Response & Update Consist Inauguration Tables | | O | c | c | c | | C | C | c | c | | c | c | c | c | | c | c | c | O | | | 1 | 2 | 3 | X | X | X | X | 8
| | | | | | | | | | | | | | | | | | | | | | All PAC's update their Inauguration table to include (3st. PAC-B) paramaters.
12. Pass Token (2nd, PAC-A) | | O | c | c | c | | c | c | C | O | | O | c | c | O | | O | c | c | O | | | 1 | 2 | 3 | X | X | X | X | 8
| | | | | | | | | | | | | | | | | | | | | | The PAS token is passed from the current token holder to the next adjacent PAC.
13. Get Response & Update Consist Inauguration Tables | | O | c | c | c | | c | c | C | C | | c | c | c | c | | c | c | c | O | | | 1 | 2 | 3 | 4 | X | X | X | 8
| | | | | | | | | | | | | | | | | | | | | | All PAC's update their Inauguration table to include (4st. PAC-B) paramaters.
14. Pass Token (2nd, PAC-A) | | O | c | c | c | | c | c | c | c | | C | O | O | c | | c | O | c | O | | | 1 | 2 | 3 | 4 | X | X | X | 8
| | | | | | | | | | | | | | | | | | | | | | The PAS token is passed from the current token holder to the next adjacent PAC.
15. Get Response & Update Consist Inauguration Tables | | O | c | c | c | | c | c | c | c | | C | C | c | c | | c | c | c | O | | | 1 | 2 | 3 | 4 | 5 | X | X | 8
| | | | | | | | | | | | | | | | | | | | | | All PAC's update their Inauguration table to include (5st. PAC-B) paramaters.
16. Pass Token (2nd, PAC-A) | | O | c | c | c | | c | c | c | c | | c | c | C | O | | O | c | c | O | | | 1 | 2 | 3 | 4 | 5 | X | X | 8
| | | | | | | | | | | | | | | | | | | | | | The PAS token is passed from the current token holder to the next adjacent PAC.
17. Get Response & Update Consist Inauguration Tables | | O | c | c | c | | c | c | c | c | | c | c | C | C | | c | c | c | O | | | 1 | 2 | 3 | 4 | 5 | 6 | X | 8
| | | | | | | | | | | | | | | | | | | | | | All PAC's update their Inauguration table to include (6st. PAC-B) paramaters.
18. Pass Token (2nd, PAC-A) | | O | c | c | c | | c | c | c | c | | c | c | c | c | | C | O | c | O | | | 1 | 2 | 3 | 4 | 5 | 6 | X | 8
| | | | | | | | | | | | | | | | | | | | | | The PAS token is passed from the current token holder to the next adjacent PAC.
19. Get Response & Update Consist Inauguration Tables | | O | c | c | c | | c | c | c | c | | c | c | c | c | | C | C | c | O | | | 1 | 2 | 3 | 4 | 5 | 6 | 7 | 8
| | | | | | | | | | | | | | | | | | | | | | All PAC's update their Inauguration table to include (8st. PAC-B) paramaters. Inauguration Complete.
| | | | TOC Token Flag | | | | | | | | Master PAC | | | | | C = Closed
| | | | HOC Token Flag | | | | | | | | Update Consist Table | | | | | O = Open
| | | | Passing Token | | | | | | | | Temp TOC Token

## Slide 17

RS 485 Train Line Relay States During Inauguration
Inauguration Steps Input Signal | | Married A 1nd | | Married B 2nd | | | Married A 3nd | | Married B 4nd
| | PAC A | PAC B | PAC A | PAC B | | PAC A | PAC B | PAC A | PAC B
| | Ra | Rb | Ra | Rb | | Ra | Rb | Ra | Rb | | | 1 | 2 | 3 | 4
1. Power ON | | c | c | c | c | | c | c | c | c | | | X | X | X | X
| | | | | | | | | | | | All Relays default to the close (on) State
2. Coupler Check | | c | c | c | c | | c | c | c | c | | | X | X | X | X
| | | | | | | | | | | | PAC - A of the 1st Car & PAC-B of 8th Car both hold a TOC token
3. Cab-ON @(2nd, PAC-A) SET Master PAC | | O | c | c | c | | c | c | c | c | | | X | X | X | X
| | | | | | | | | | | | PAC-A of the 2nd Car is the Master PAC.
4. Request TOC Response | | O | c | c | c | | c | O | c | c | | | 1 | X | X | 4
| | | | | | | | | | | | Open(2nd,PAC-A,Rb)to disconnect from Paired PAC-B, Master PAC requests Toc response & (1st. PAC - A) responds.
5. Set HOC Token Flag | | O | c | c | c | | c | c | c | c | | | 1 | X | X | 4
| | | | | | | | | | | | Master PAC sets (1st. PAC - A) HOC & then returns all relays to default status.
6. Request TOC Response | | O | c | c | c | | c | c | c | c | | | 1 | X | X | 4
| | | | | | | | | | | | The only remaining remaining TOC token is held by (4th, PAC-B) & responds to the request
7. Get Response & Update Consist Inauguration Tables | | O | c | c | c | | c | c | c | c | | | 1 | X | X | 4
| | | | | | | | | | | | All PAC's update their Inauguration table with HOC, TOC, and Master Info.
8. Pass Token (1ST. PAC-B) | | O | c | C | O | | O | c | c | O | | | 1 | X | X | 4
| | | | | | | | | | | | The PAS Token is passed from the HOC token holder to the next adjacent PAC.
9. Get Response & Update Consist Inauguration Tables | | O | c | C | C | | c | c | c | c | | | 1 | 2 | X | 4
| | | | | | | | | | | | All PAC's update their Inauguration table to include (2st. PAC-B) paramaters.
10. Pass Token (2nd, PAC-A) | | O | c | c | c | | C | O | O | c | | | 1 | 2 | X | 4
| | | | | | | | | | | | The PAS token is passed from the current token holder to the next adjacent PAC.
11. Get Response & Update Consist Inauguration Tables | | O | c | c | c | | C | C | c | c | | | 1 | 2 | 3 | 4
| | | | | | | | | | | | All PAC's update their Inauguration table to include (3st. PAC-B) paramaters. Inauguration complete.
C = Closed | | | | TOC Token Flag | | | | | | | | Master PAC
O = Open | | | | HOC Token Flag | | | | | | | | Update Consist Table
| | | | Passing Token | | | | | | | | Temp TOC Token

## Slide 18

PTU

Wayside

CNCS

WLAN

VTX

PAC

LIC

Speakers

PASSENGER

ODOMETER

DOOR

PID

FDI

SDI

PII

CAB

VOIP

REC

PEI

DPO

MDS

CCP

CREW

: External Entity & System

: CS Unit

: Process
