JDSCS-Club/DENVER_CCP/DOC/09_발표_보고/03_DPO_통화절차/InterCom 진행 사항 4월 1째주.pptx

Inter Com 진행 사항.

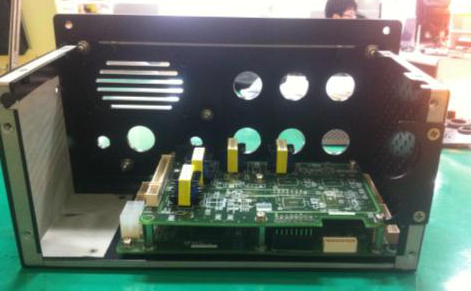
[picture p81: figure]

- DPO BOX 내부 PCB 설계를 변경하여 전체 사이즈를 변경 하였다.

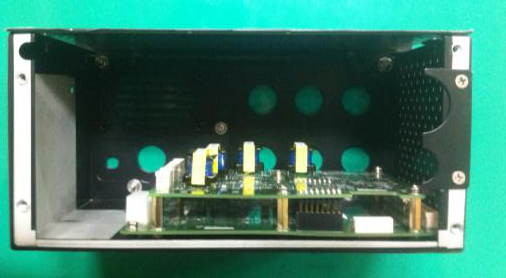
[picture p82: figure]

- PCB를 2층 구조를 변경 하여 배선 이동을 최소화 하였다.

## Slide 2

Inter Com 진행 사항.

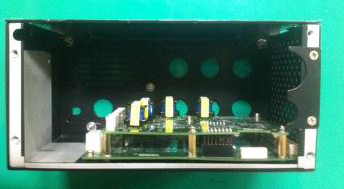
[picture p83: figure]
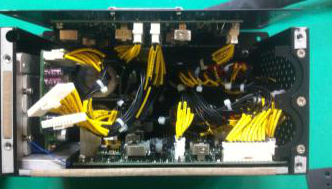
[picture p84: figure]

- PCB 구조를 2층 결합 TYPE 으로 변경하여 배선 이동을 최소화 하였다.

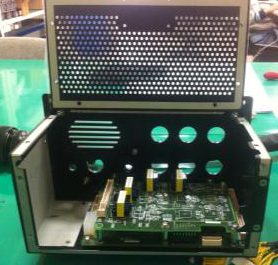
[picture p85: figure]
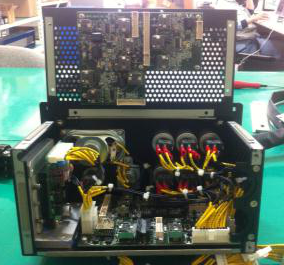
[picture p86: figure]

- PCB가 2층 결합 TYPE 이라 BOX Cover에 공간을 확보 하였다.
- A/S 및 사후 관리 기능을 강화 하였다.

## Slide 3

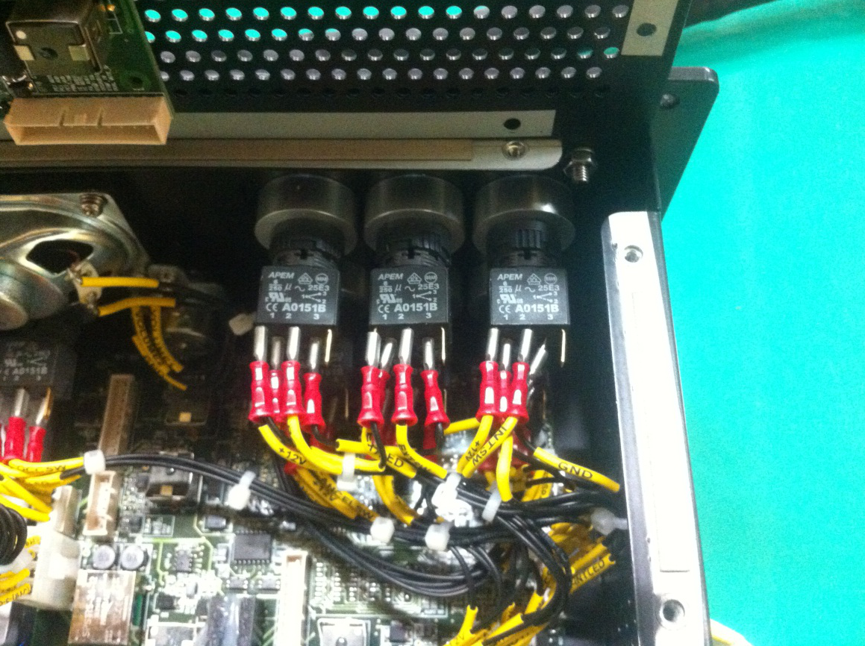
[picture p87: figure]
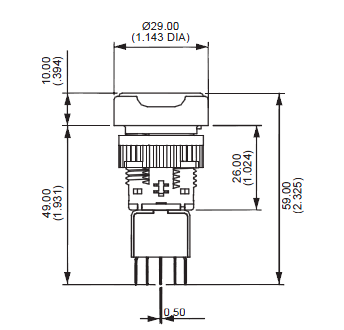
[picture p88: figure]

A1PCA1Y120K3

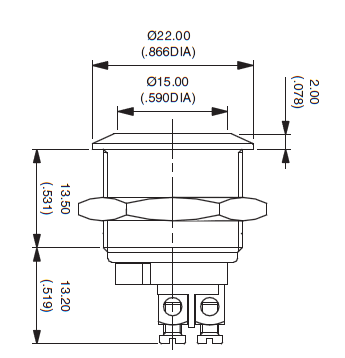
[picture p89: figure]

AV09C703D9

- 길이가 짧은 Switch 를 사용하여 공간을 확보 하였다.

-시행청 요청에 의해 Switch 고장 TYPE 변경.

## Slide 4

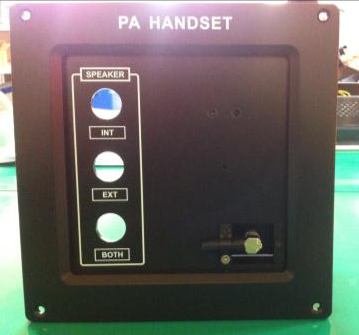
[picture p90: figure]
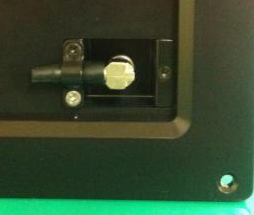
[picture p91: figure]

- 시행청 요청에 따라 HandSet MIC 취부 TYPE 변경.

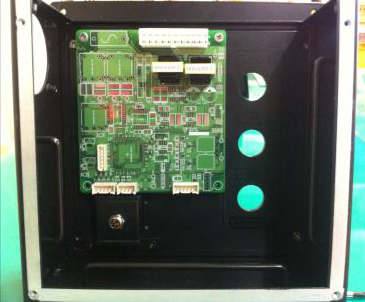
[picture p92: figure]
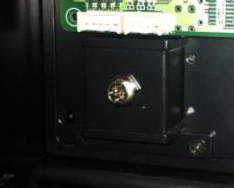
[picture p93: figure]

## 진행 사항 정리.

- Inter-Com PCB 1차 완료.
- Inter-Com Box 샘플 진행 완료.
- 04월 05~06일 1차 단품 TEST 진행 예정.
- DPO Switch 미 입고.4월말 입고 예정.
(기존 Switch 이용하여 1차 TEST 진행 예정)
