JDSCS-Club/DENVER_CCP/DOC/09_발표_보고/03_DPO_통화절차/덴버 RRDCC - InterCom 통신 방식.pptx

## VOIP – InterCom Communication.

OCC

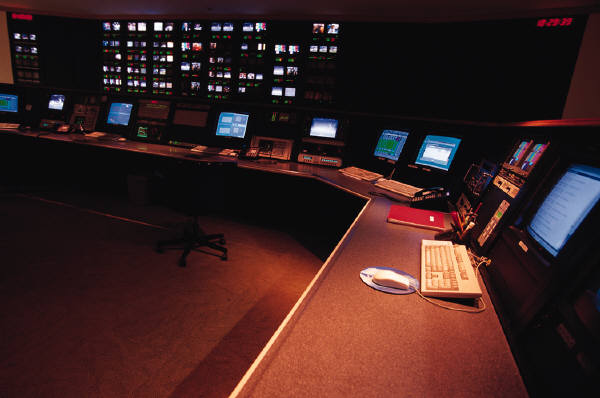
[picture p94: figure]

~~(voip Data) | UNIT CODE

~~(voip Data) | UNIT CODE

DPO CODE

PEI CODE

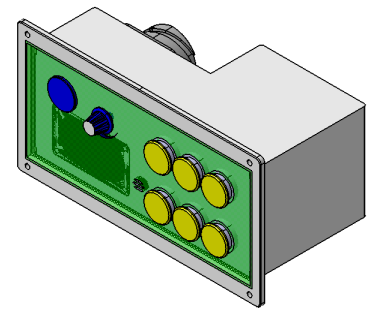
[picture p95: figure]
EMB00000c7c4363

DPO

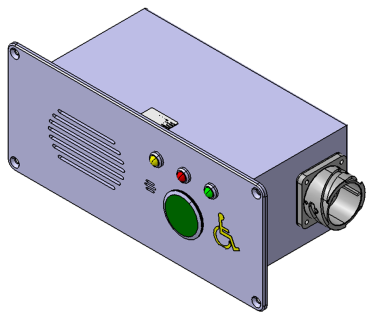
[picture p96: figure]

PEI

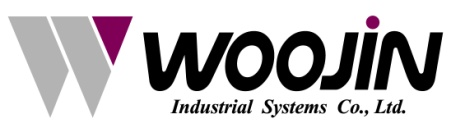
[picture p97: figure]

## Slide 2

OCC -> TRAIN Communication
Flowchart

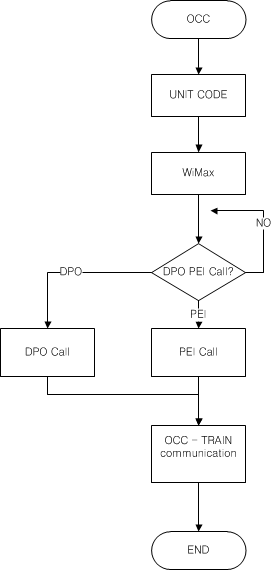
[picture p98: figure]

TRAIN -> OCC Communication
Flowchart

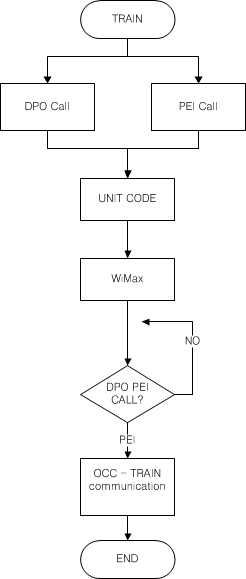
[picture p99: figure]
