JDSCS-Club/DENVER_CCP/DOC/09_발표_보고/04_장치별_기술/GOOSENECK MIC 볼트 돌출 자료.pptx

덴버 GOOSENECK MIC 볼트 취부 사진

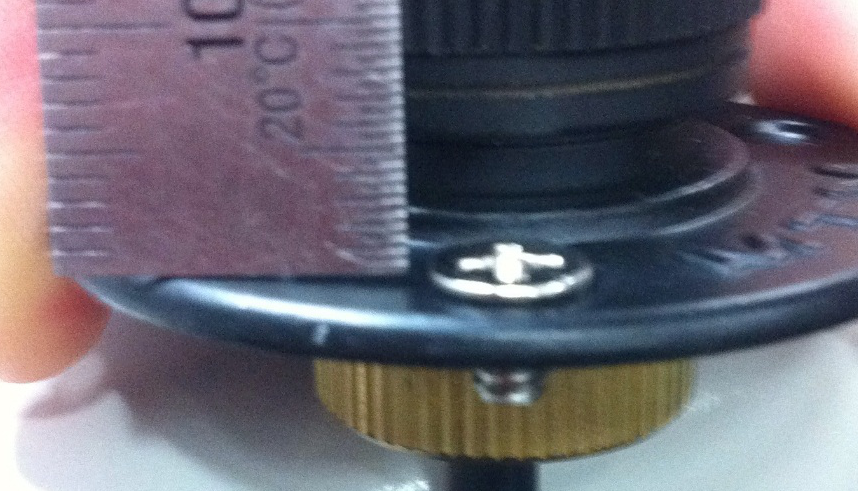
[picture p114: figure]

약 0.5mm 돌출

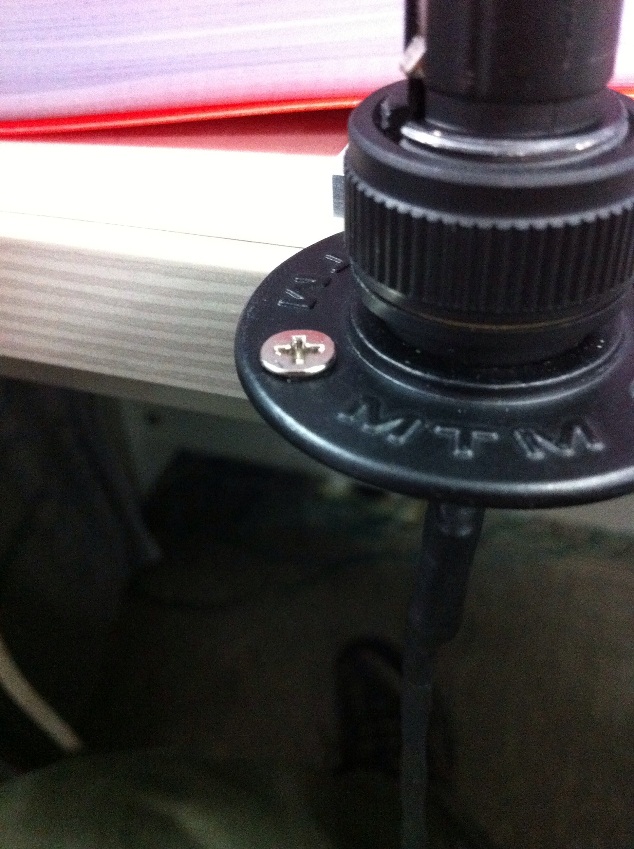
[picture p115: figure]
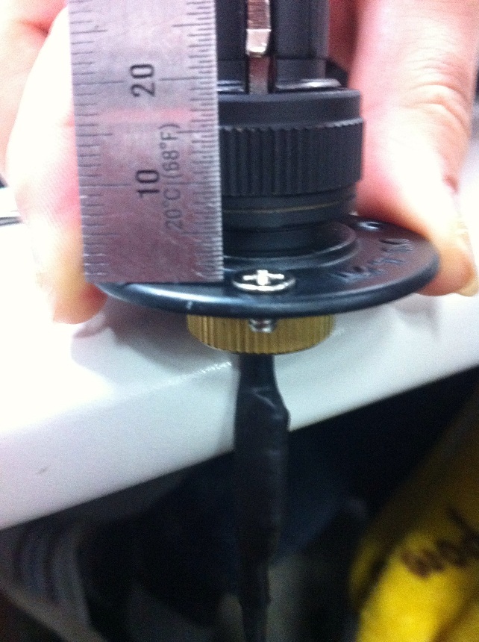
[picture p116: figure]
