JDSCS-Club/DENVER_CCP/DOC/09_발표_보고/04_장치별_기술/PCB 변경 내용.pptx

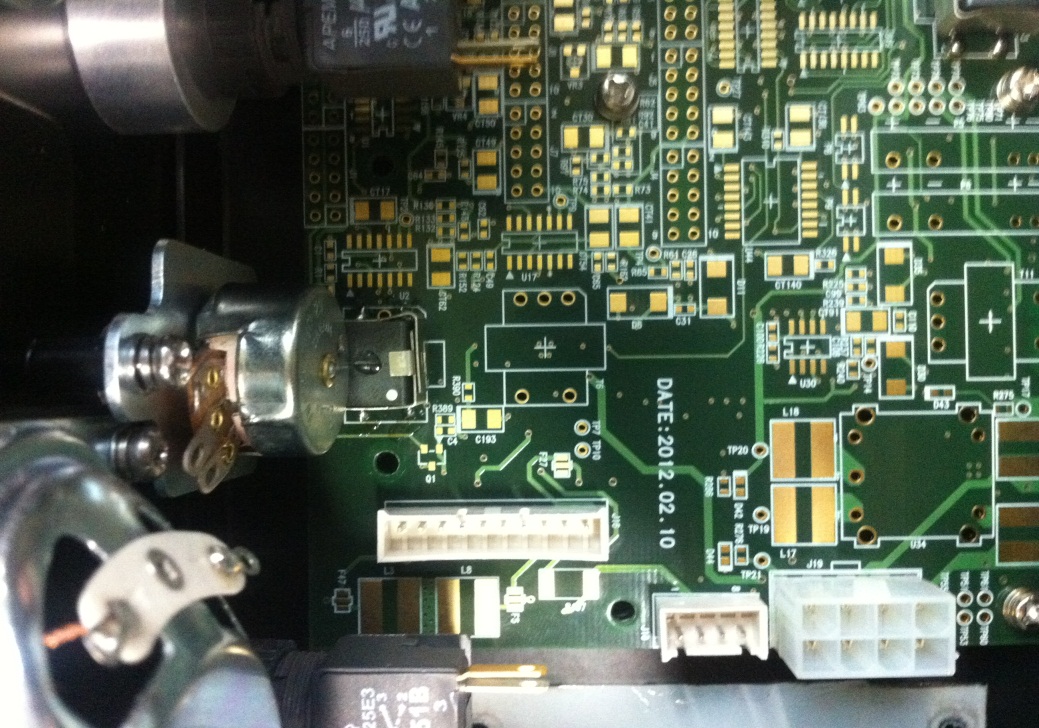
[picture p117: figure]

이동

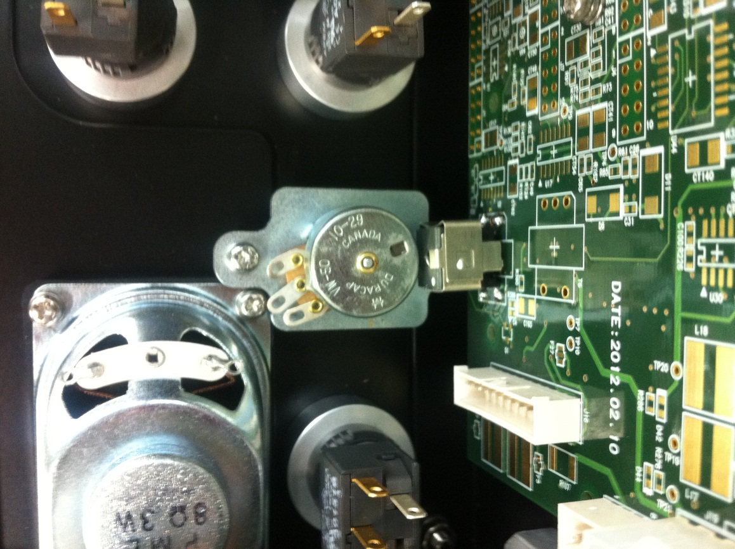
[picture p118: figure]

이부분은
그냥 진행 하겠습니다.

## Slide 2

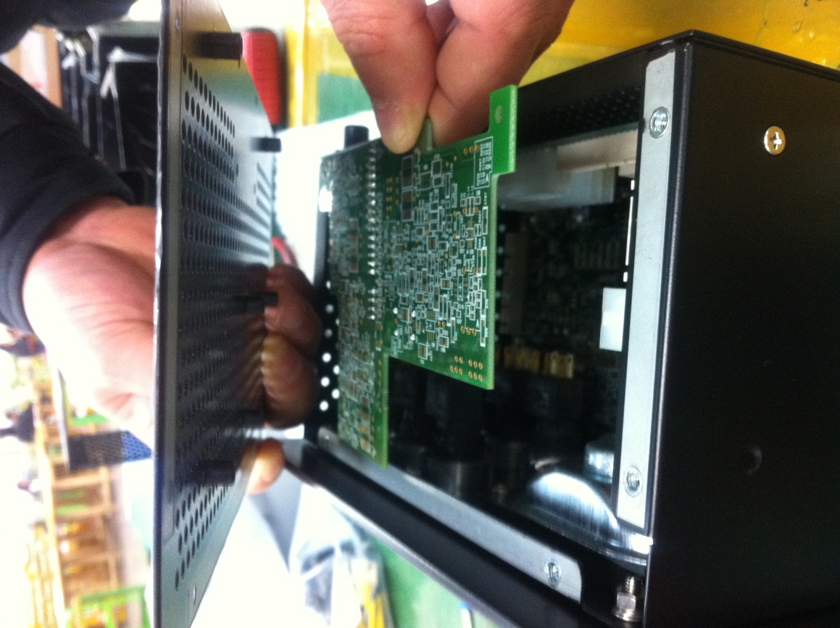
[picture p119: figure]

TOP PCB를 DPO 커버에 취부할 예정 입니다.

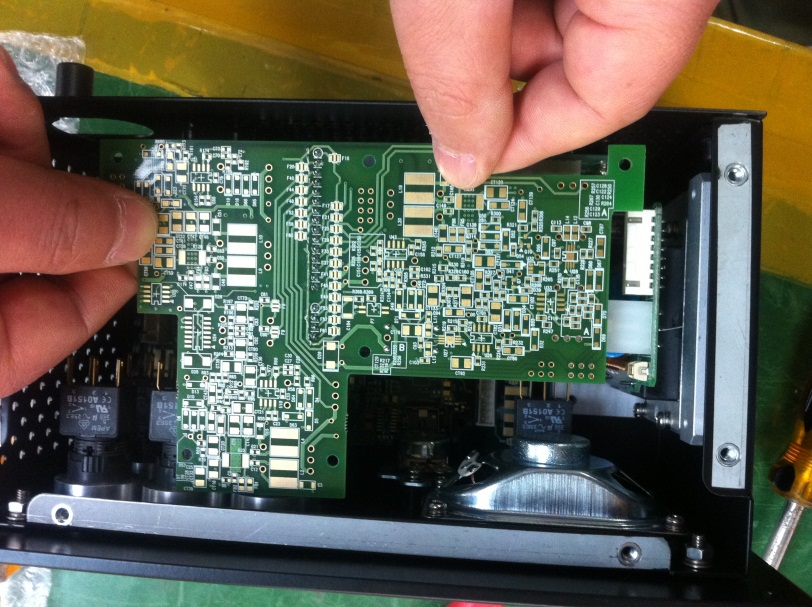
[picture p120: figure]
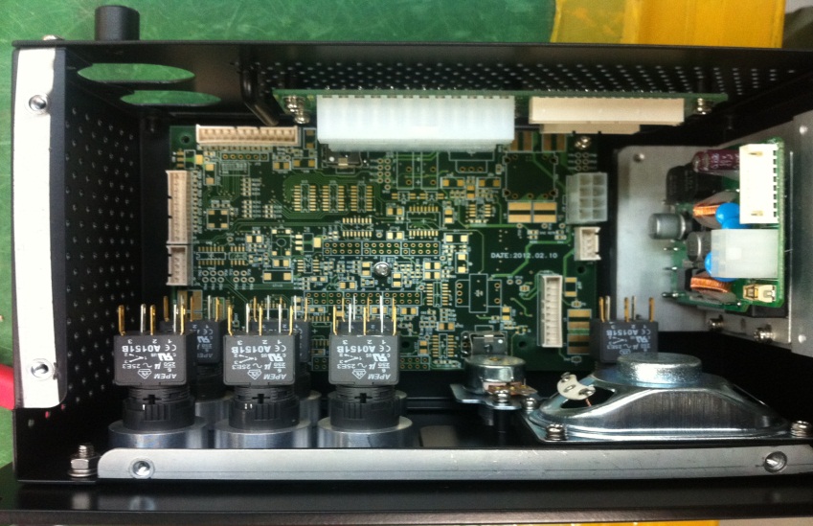
[picture p121: figure]

PCB 변경 사이즈

## Slide 3

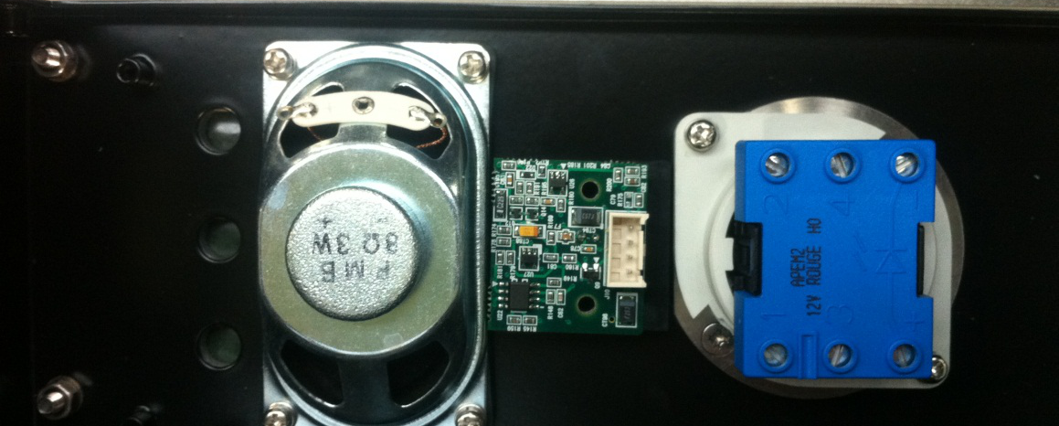
[picture p122: figure]

PCB를 옆으로 크게 작성하여 바닥에 부품을 위로 올려 주세요.

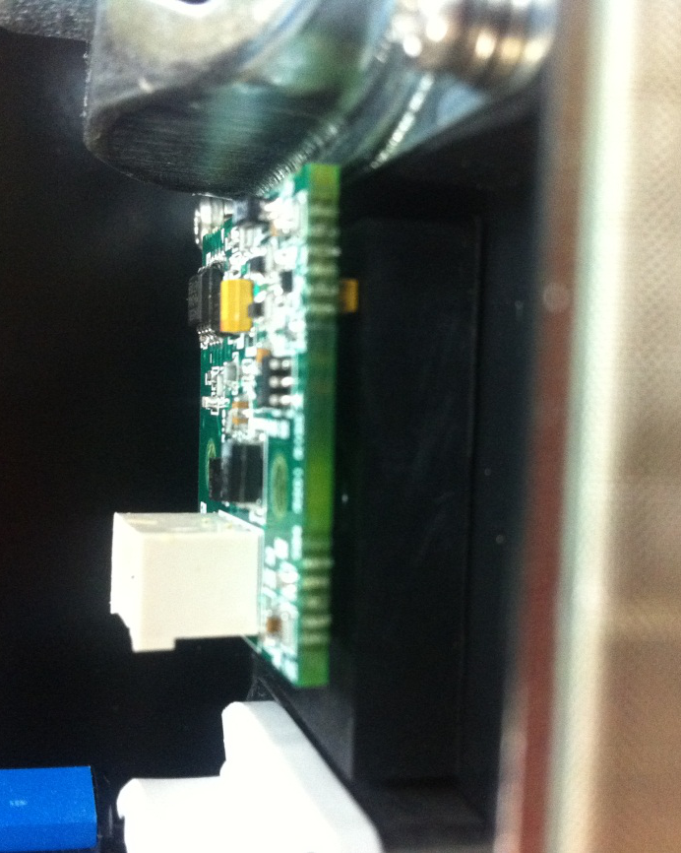
[picture p123: figure]
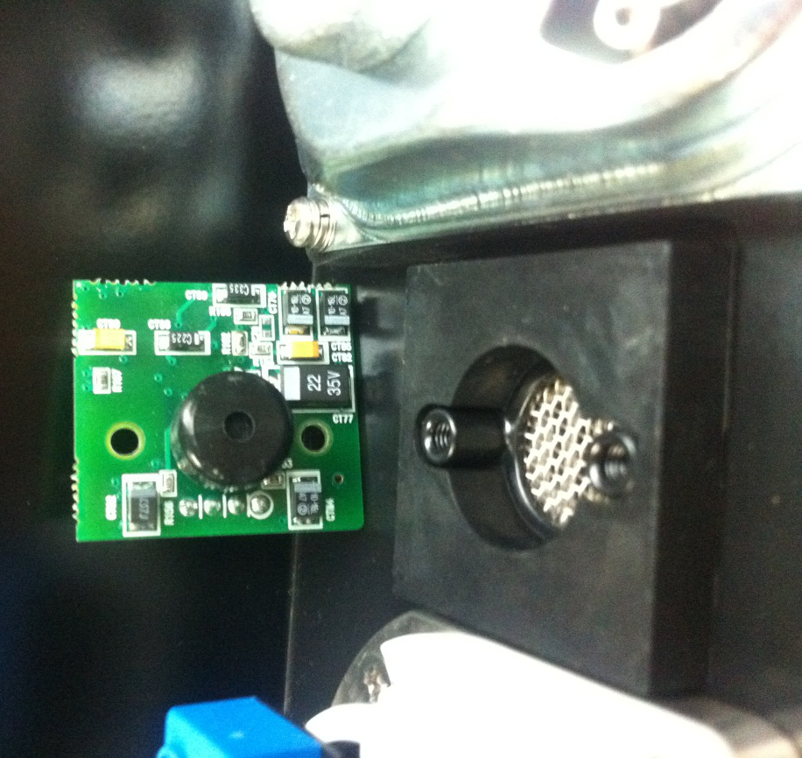
[picture p124: figure]

바닥 부분에 부품이 있어 취부에 문제가 있습니다.

바닥 부분이 사이가 발생 합니다.

## Slide 4

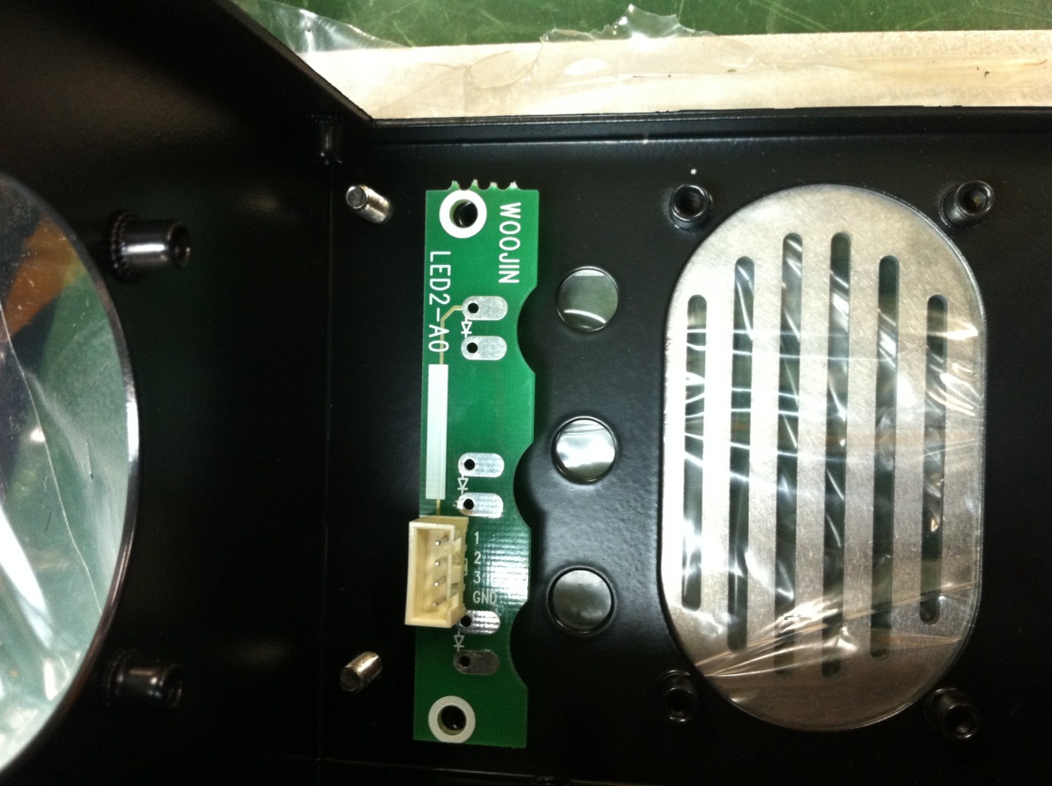
[picture p125: figure]

PCB 중심이 맞지 않습니다.

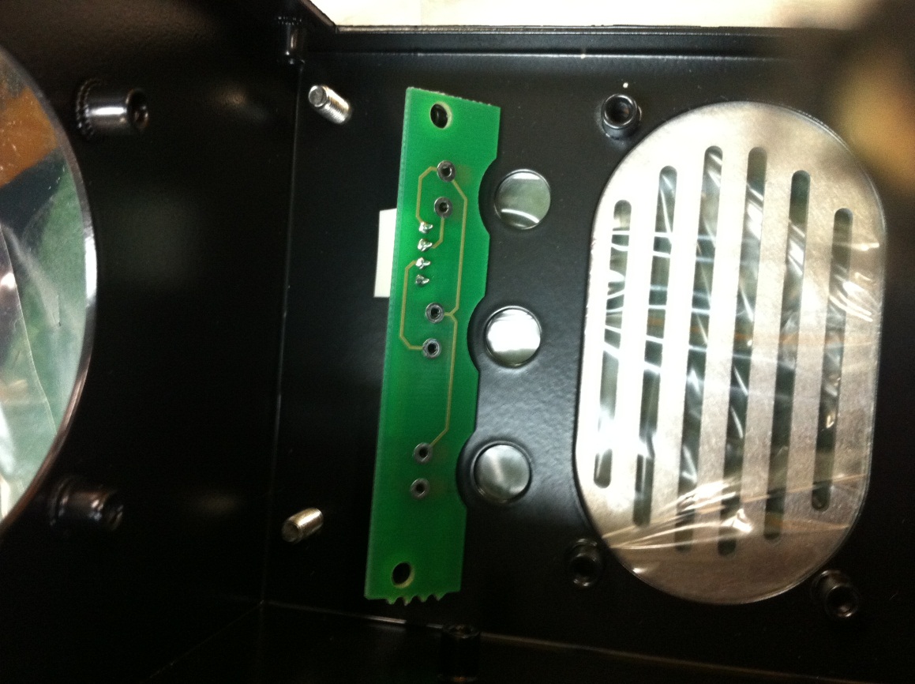
[picture p126: figure]
