JDSCS-Club/DENVER_CCP/DOC/09_발표_보고/04_장치별_기술/Wayside 블럭 다이어 그램.pptx

Woojin Wayside Reply Sheet 수정 내용

Woojin

Inter-M

On-board Ethernet Switch/Router(HR)

Loco Power Supply ??

PEI
(Public Emergency Intercomm)

PA

DVR/
CCTV

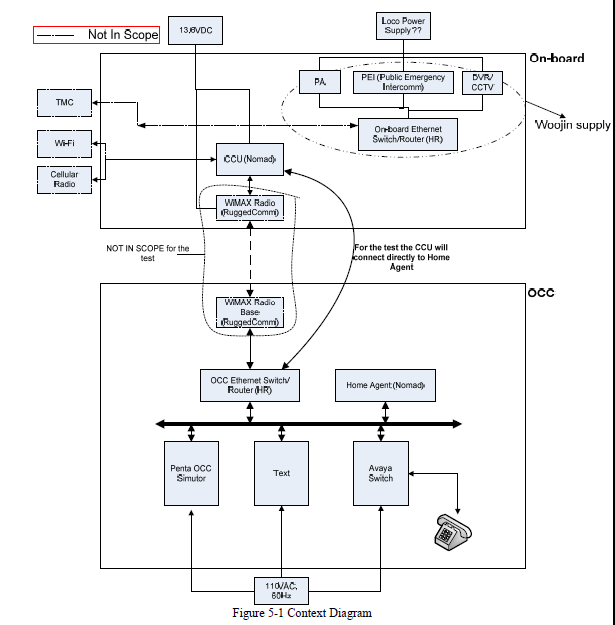
[picture p127: figure]

## Slide 2

Internet-based VPN test 블록 다이어 그램을 간락하게 표현.

Woojin

VPN SERVE

VPN

INTERNET

RSC

Nomad

Penta

Internet-based VPN test 블록 다이어 그램을 간락하게 표현.
- VPN Server를 우진에 설치 하여 각 업체가 접속하는 걸로 진행.
- 각 업체는 우진 VPN Server 로 접속할 IP를 우진에 제공 해야 한다.
- 우진은 각 업체가 IP에 대하여 서버 접속 Seting을 한다.
- 우진은 서버 Seting 후 SIP 전송 관련 포트를 각 업체에 알려 준다.

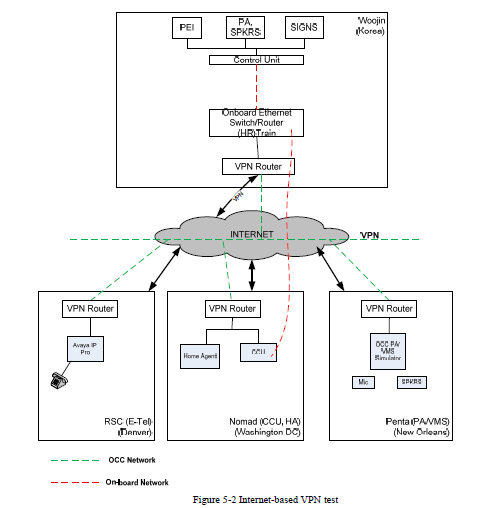
[picture p128: figure]

## Slide 3

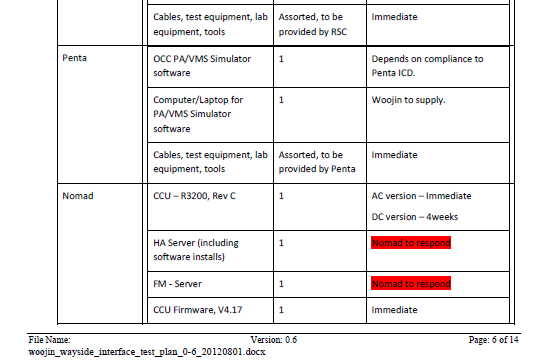
[picture p129: figure]

Woojin은 OCC 운영에 필요한 어떠한
프로그램도 제공 하지 않는다.

## Slide 4

CRA

INTERNET

CRA

VOIP PCB

HUB

VPN SERVER

VPN

E-Net cable

Avaya

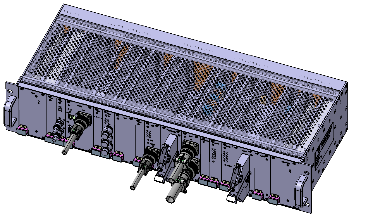
[picture p130: figure]

Woojin
VPN Server

## Slide 5

Woojin

VPN SERVE

VPN

INTERNET

RSC

Nomad

Penta

VPN SERVE

VPN SERVE

VPN SERVE

## Slide 6

Woojin

VPN SERVE

VPN

VPN SERVE

VPN SERVE

VPN

INTERNET

RSC

VPN SERVE

Nomad

VPN SERVE

Penta

VPN SERVE

## Slide 7

Woojin

VPN SERVE

VPN

VPN SERVE

VPN SERVER

CRA

INTERNET

VPN

RSC

Nomad

Penta

## Slide 8

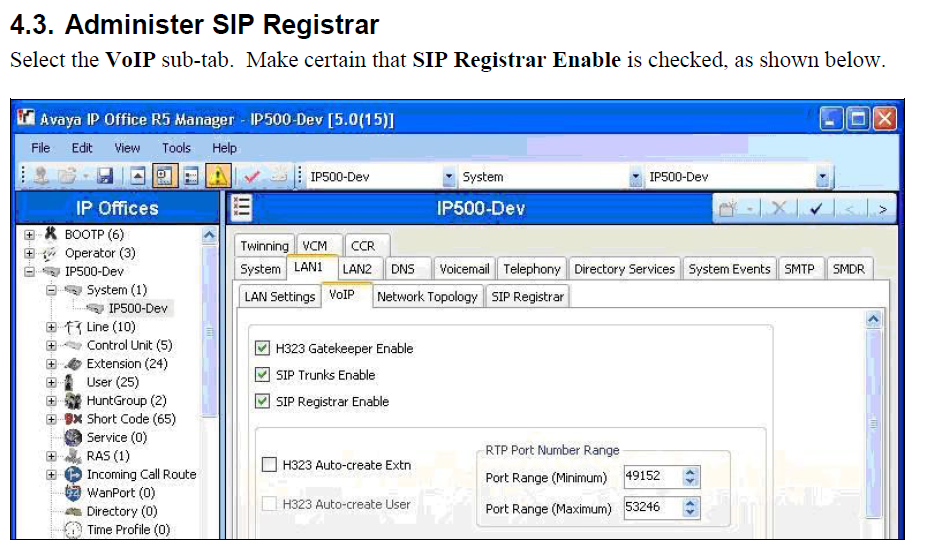
[picture p131: figure]
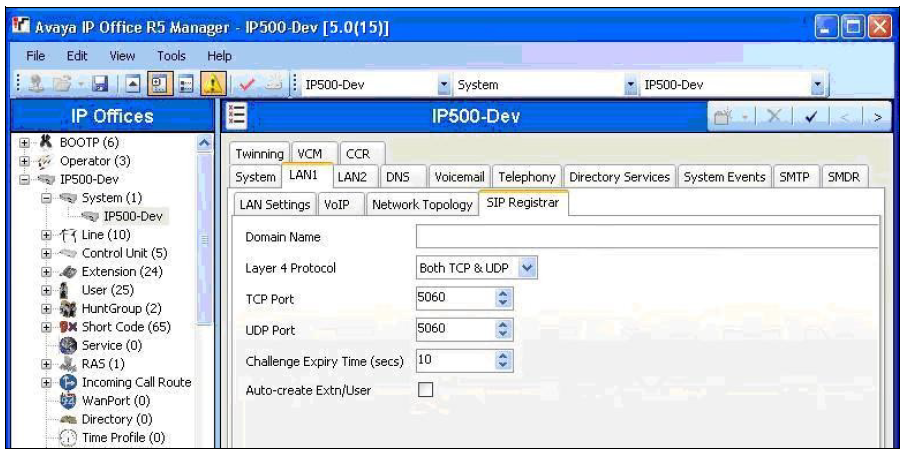
[picture p132: figure]

## Slide 9

Woojin

VPN SERVER

VPN

VPN SERVER

VPN SERVER

CRA

INTERNET

VPN

RSC

VPN SERVER

Nomad

VPN SERVER

Penta

VPN SERVER

## Slide 10

Woojin

VPN SERVE

VPN

VPN SERVE

VPN SERVE

CRA

VOIP VPN

INTERNET

VPN

RSC

VPN SERVE

Nomad

VPN SERVE

Penta

VPN SERVE
