JDSCS-Club/DENVER_CCP/DOC/09_발표_보고/04_장치별_기술/방송 장치 통화 절차 정리[영문].docx

1. Number of using Cab Devices(Scenario list)

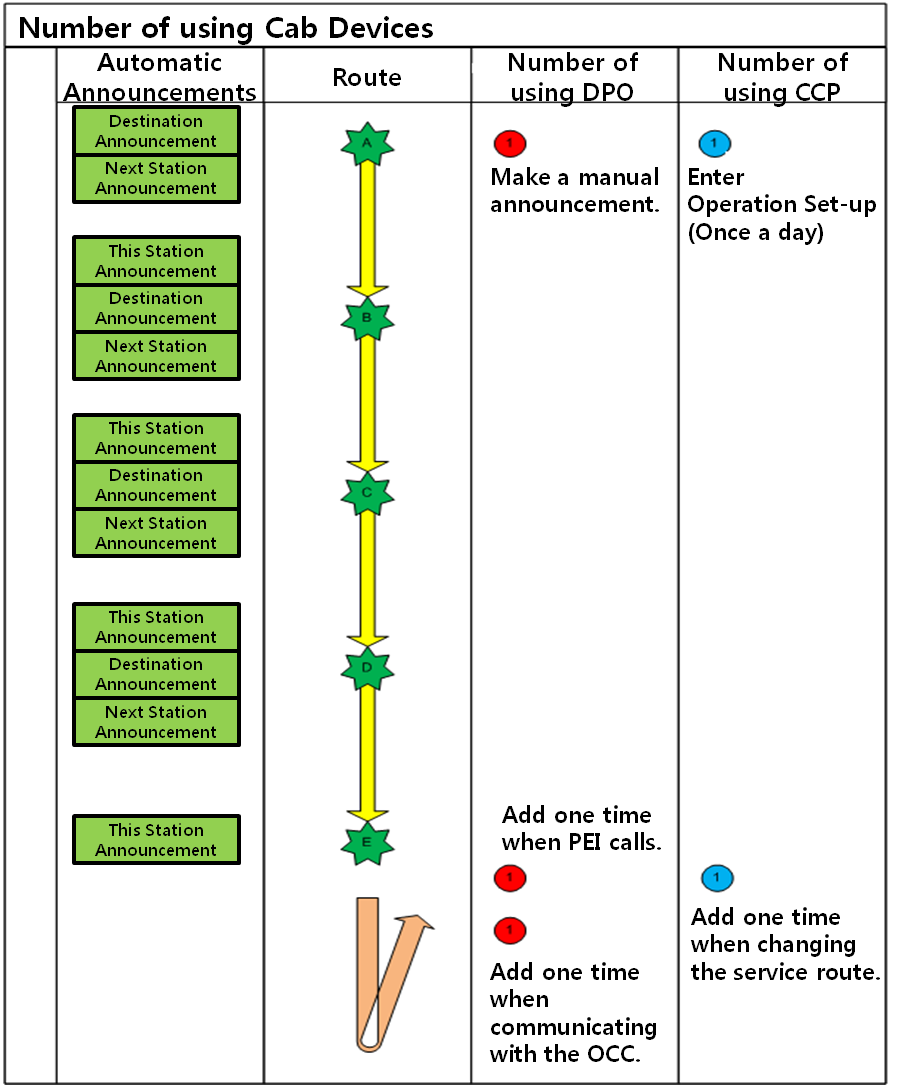
[picture p133: figure]

2. PEI – DPO Communication Function Identification.

# OCC/PEI/Cab to Cab Communication Procedure in an Operator position

2.1 Leading Cab Communication Procedure.

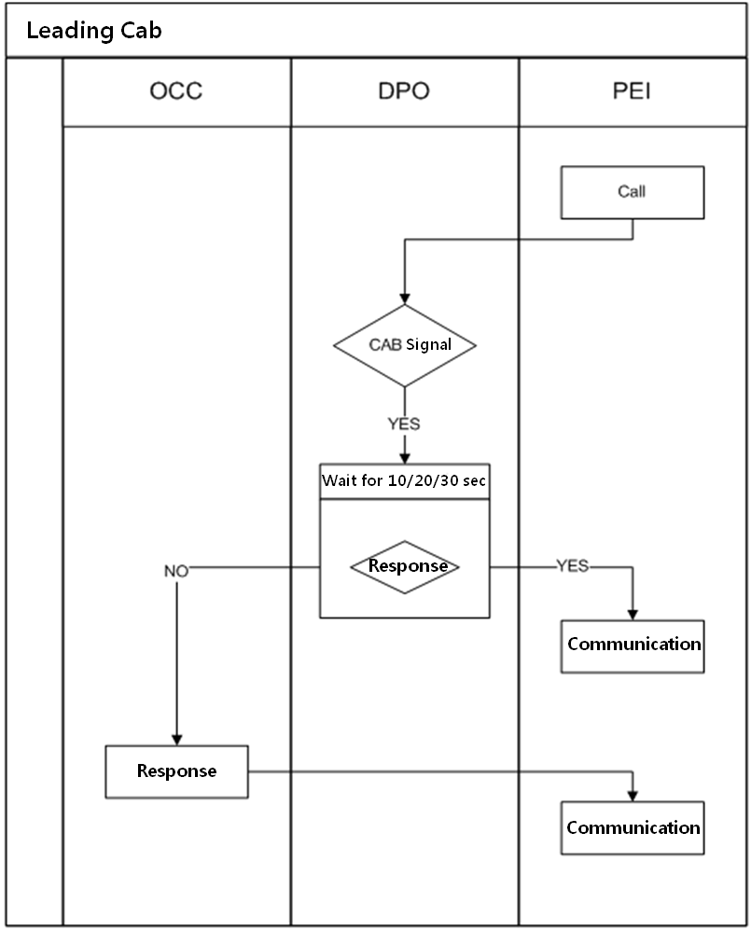
[picture p134: figure]

  2.2 Non-Leading Cab Procedure.

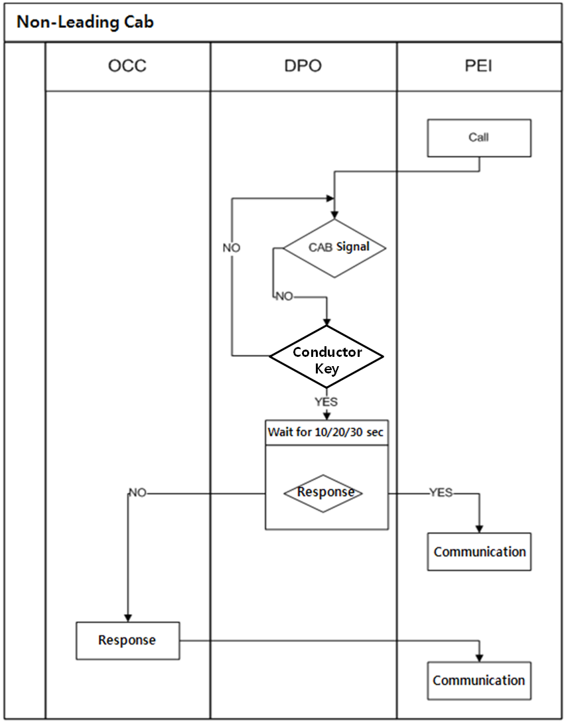
[picture p135: figure]

3. Device with Alarm Sound

3.1 Device Classification.

| Device installed in CAB | Device installed in Passenger Compartment
PEI | - | Announcement which will be played when the PEI push button has been pressed. - Woojin is reviewing the CAB only announcement or alarm sound as DENVER request to eliminate the emergency announcement in the vehicle.

4. Software Update Procedure

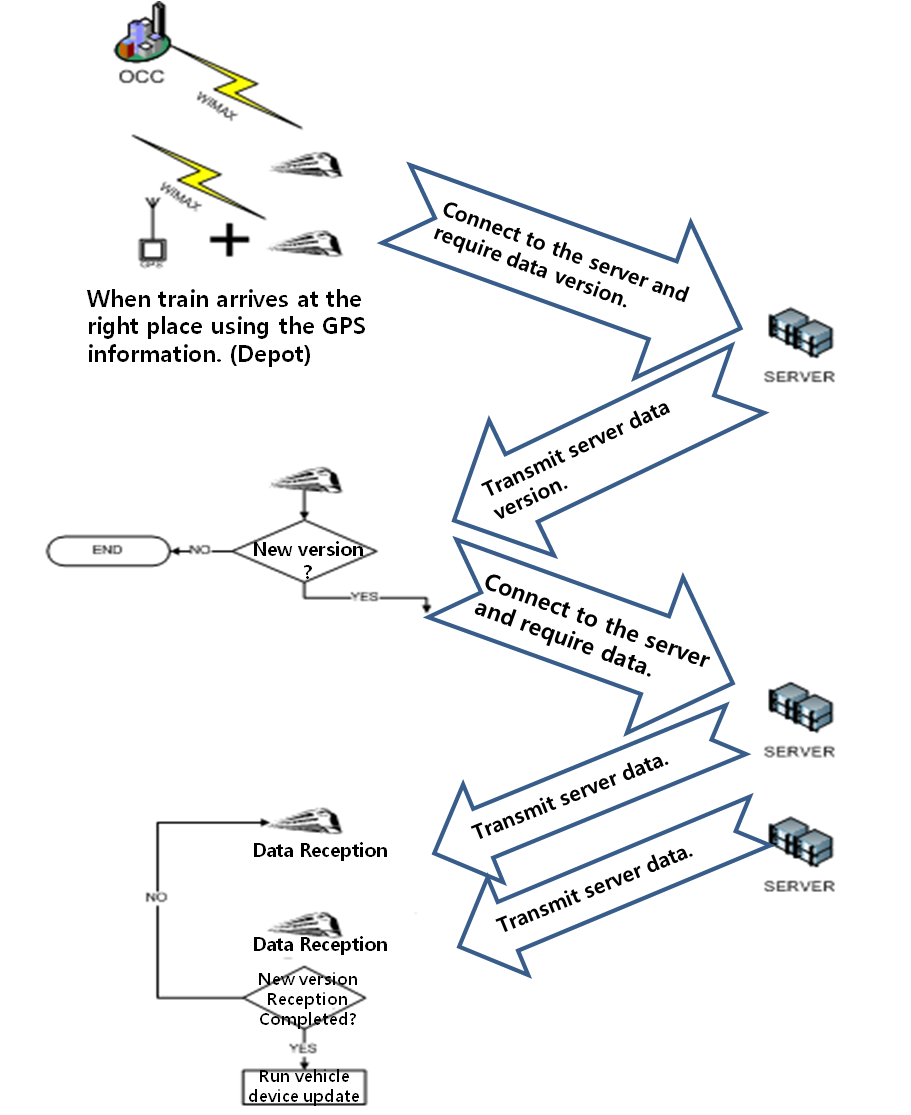
[picture p136: figure]
