JDSCS-Club/DENVER_CCP/DOC/01_인터페이스_설계/MDS_ICD/01_ICD_문서/DDN-0432-0066-R01 Block Diagrams and Schematics.pdf

# Quester Tangent Corporation

## Denver Regional Transportation District (Denver RTD) Contract N8US-30-F0003

# Monitoring and Diagnostic System (MDS)

# Block Diagrams and Schematics

Prepared by: | Steve Dyck
| Hardware Team Lead
Verified by: | Christian Leclerc
| Software Team Lead
Approved by: | Greg Nuttall
| Project Engineer

## Issue Date: 19 October 2011 Document Number: DDN-0432-0066 Revision: R01

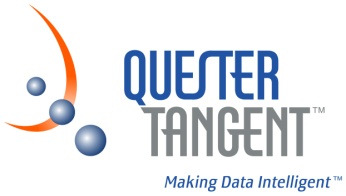
[picture p139: figure]

Eagle P3 Monitoring and Diagnostic System | Block Diagrams and Schematics
DDN-0432-0066-R01 | 2 of 4
DATE | REVISION | DESCRIPTION
02-Sept-2011 | R00 | Initial version
19-Oct-2011 | R01 | Removed Input Ethernet Module references

COPYRIGHT
Copyright © 2011 by Quester Tangent Corporation. All rights reserved. This item and the information contained herein are the property of Quester Tangent Corporation. No part of this document may be reproduced, transmitted, stored in a retrieval system, or translated into any language or computer language in any form or by any means, electronic, mechanical, magnetic, optical, chemical, manual, or otherwise, without the express written permission of Quester Tangent Corporation.

Quester Tangent Corporation
6582 Bryn Road
Saanichton, BC, Canada V8M 1X6 Tel: 250-656-6677
Fax: 250-655-4696
www.questertangent.com

# List of Tables

Table 1: Block Diagrams

HYUNDAI-ROTEM DRAWING NUMBER | QUESTER TANGENT DRAWING NUMBER | TITLE | NOTES
| DBD-MS10-0000 | Central Diagnostic Terminal – Functional Block Diagram
| DBD-DS06-0000 | Fault Display Panel – Functional Block Diagram
| DBD-MS10-1000 | Central Diagnostic Terminal – Modular Block Diagram

Table 2: Electrical Design Schematics – Car-level

HYUNDAI-ROTEM DRAWING NUMBER | QUESTER TANGENT DRAWING NUMBER | TITLE | NOTES
| DSC-0432-1500 | Fault Trainline Schematics | Note 1

Note 1: Fault Trainline schematics provide the architecture for the fault trainlines. This architecture addresses the functional requirements from the TS and PTS in a robust and fault-tolerant manner. The design and implementation of the fault trainlines is Hyundai-Rotem’s responsibility. Quester Tangent has worked with Hyundai-Rotem throughout the development of this design.
