JDSCS-Club/DENVER_CCP/CCP/CCP_PORTING_PLAN_SUPPLEMENT.md

# CCP 포팅 계획서 보완 사항

> 작성일: 2026-04-01
> 최종 수정: 2026-04-01 (GPS 확인 완료, 영문 전용 프로젝트 반영)
> 원본 문서: CCP_PORTING_PLAN.md
> 목적: 원본 계획서에서 누락되거나 미흡한 항목 정리

---

## 보완 항목 요약

| 우선순위 | # | 항목 | 분류 | 비고 |
|---|---|---|---|---|
| 🔴 필수 | 3 | RS-485 방향 제어 방식 확정 | 통신 | |
| 🔴 필수 | 7 | 통신 명령 코드 완전 목록 | 프로토콜 | |
| 🟠 중요 | 2 | 오디오(스피커) 포팅 계획 | 하드웨어 | |
| 🟠 중요 | 10 | i.MX6 BSP/커널 버전 확정 | 플랫폼 | 🟡→🟠 상향 |
| 🟡 권고 | 4 | 문자 인코딩 처리 (WCHAR→char) | 플랫폼 | 🔴→🟡 하향 (영문 전용) |
| 🟡 권고 | 5 | 폰트 렌더링 방안 | UI | 🟠→🟡 하향 (영문 전용) |
| 🟡 권고 | 6 | 실시간성 요구사항 | 플랫폼 | |
| 🟡 권고 | 9 | SW 업데이트 메커니즘 구체화 | 유틸리티 | |
| 🟡 권고 | 8 | 시뮬레이션 모드 구현 계획 | 기능 | |
| ℹ️ 참고 | 11 | 메모리/자원 관리 전략 | 품질 | |
| ℹ️ 참고 | 12 | PAC 통신 에러 처리 상세 | 통신 | |
| ✅ 해결 | 1 | GPS 기능 처리 방향 | 기능 스코프 | 기준 소스에 이미 포함 확인 |

---

## 상세 보완 항목

### 1. ✅ GPS 기능 — 확인 완료, 기존 포팅 범위에 포함

**현황 (수정)**
~~소스코드 버전 현황에 `CCP_1.0.0.4 - 2015-11-13(Gps).zip`이 존재하나, 포팅 계획 전반에 GPS 관련 내용이 전무함.~~

기준 소스(`v1.0.0.4 - 2016-01-31`)에 GPS 기능이 **이미 통합되어 있음을 확인**.
별도 GPS 버전 소스와의 diff 분석이나 추가 Phase는 불필요.

**소스 내 GPS 코드 현황**

| 파일 | GPS 관련 내용 |
|---|---|
| `Packet.h` | `MASK_GPSA`(0x02), `MASK_GPSB`(0x20), `MASK_GPS1`(0x20), `MASK_GPS2`(0x40) 상태 비트 마스크 및 CHECK 매크로, `m_bValidGPS`, `GetGPS()`, `GetValidGPS()` |
| `Packet.cpp` | `SetValidGPS()` 호출 (CNCS 데이터 파싱 시 GPS 유효성 설정), GIA 구조체 파싱 코드 (주석 처리 — 이전 직접 NMEA 파싱 흔적) |
| `DBRoute.cpp` | `SearchTriggerPoint(dblLAT, dblLOT, bOpenDoor)` — GPS 좌표 기반 트리거 포인트 탐색, `distance()` 좌표 간 거리 계산, DB에서 `LONGITUDE`/`LATITUDE` 조회 |
| `DBTrigger.h` | `TP_LAT`, `TP_LOT` 트리거 포인트 좌표 구조체 |
| `CCPDlg.cpp` | `IDC_STATE_GPS` UI 상태 표시, `GetGPS()==1` → "OK" 표시, `GetValidGPS()` 기반 조건 분기 |
| `Serial.cpp` | CNCS A/B 수신 시 GPS 상태 전달 (주석 처리된 `bGpsStatus` 흔적) |

**결론**
- GPS는 CNCS를 경유하여 좌표를 수신하는 방식 (별도 GPS 시리얼 포트/NMEA 파서 불필요)
- 포팅 시 기존 Phase 2(프로토콜 파싱) + Phase 5(DB/노선 로직)에서 자연 포함
- ~~별도 작업 항목 `2-12 | GPS 파서` 추가~~ → 불필요

---

### 2. 오디오(스피커) 포팅 계획 누락 🟠

**현황**
CONFIG 페이지(PageConfig.cpp, 16KB)에 스피커 볼륨 제어가 있으나, API 매핑 테이블 및 Phase 6(하드웨어 연동)에 오디오 관련 내용 없음.

**보완 필요 사항**

API 매핑 테이블 추가:

| WinCE API | Linux 대체 |
|---|---|
| `waveOutSetVolume()` | ALSA `snd_mixer_selem_set_playback_volume()` 또는 `amixer` |
| `PlaySound()` | ALSA `snd_pcm_*` 또는 `aplay` |

Phase 6 추가 항목:
```
6-7 | 오디오 볼륨 제어 | i.MX6 ALSA 사운드 카드 확인, amixer 또는 ALSA API 연동
6-8 | 경보음 출력 | PEI 호출 등 이벤트 발생 시 비프음 출력 방안
```

---

### 3. RS-485 방향 제어 방식 구체화 미흡 🔴

**현황**
Phase 3의 3-7 항목이 "GPIO로 RTS 핀 제어"로만 기술되어 구체성 부족.

**보완 필요 사항**

RS-485 반이중 방향 제어 방식 중 하나를 선택 및 명시:

| 방식 | 설명 | 조건 |
|---|---|---|
| **커널 내장 RS-485** | `TIOCSRS485` ioctl (SER_RS485_ENABLED 플래그) | i.MX6 UART 드라이버 지원 여부 확인 필요 |
| **GPIO 수동 제어** | 송신 전 GPIO(DE/RE 핀) High, 완료 후 Low | 드라이버 미지원 시 사용 |
| **RTS 자동 제어** | `termios` CRTSCTS 플래그 | 하드웨어 흐름 제어 핀이 DE에 연결된 경우 |

추가 명시 사항:
- RS-485 DE 핀에 연결된 i.MX6 GPIO 번호 (회로도 `HW/아이텍/CCP-V1.4` 참조 필요)
- 바이트 전송 완료 후 DE 핀 Low 전환 타이밍 (tcdrain() 완료 후)
- 반이중 타이밍 마진 값 (예: 1ms 대기)

```c
// 권장 구현 예시 (커널 내장 방식)
struct serial_rs485 rs485conf = {
    .flags = SER_RS485_ENABLED | SER_RS485_RTS_ON_SEND,
    .delay_rts_before_send = 0,
    .delay_rts_after_send = 1,
};
ioctl(fd, TIOCSRS485, &rs485conf);
```

---

### 4. 문자 인코딩 처리 (WCHAR → char) 🟡

> ⚠️ 우선순위 변경: 🔴 필수 → 🟡 권고 (덴버 프로젝트 — 영문 전용)

**현황**
WinCE는 UTF-16LE(TCHAR/WCHAR)를 사용하며, Linux에서는 `char`(ASCII/UTF-8)를 사용.
덴버 RTD 프로젝트는 **영문 전용**이므로 한글 인코딩 이슈는 해당 없음.

**영향 범위 (축소)**

| 데이터 | 인코딩 상황 | 영향도 |
|---|---|---|
| `DVDB.dat` 역명/노선명 | 영문 (예: "Union Station", "Peoria") | ASCII 범위, 변환 단순 |
| `HELP.TXT` | 영문 | ASCII 범위, 변환 단순 |
| `password.ini`, `CONFIG.INI` | 숫자/영문 | 영향 없음 |
| 런타임 텍스트 (열차번호, 메시지) | 숫자/영문 | 영향 없음 |

**필요 작업 (단순화)**
- 코드 내 `TCHAR`/`WCHAR`/`_T()` 매크로 → `char`/문자열 리터럴로 일괄 치환
- `_tcscpy`, `_tcslen`, `_stprintf` 등 → `strcpy`, `strlen`, `sprintf`로 변환
- `CString` → `char[]` 또는 `std::string`으로 변환
- 멀티바이트 처리(`mbstowcs`, UTF-8 시퀀스 등)는 **불필요**
- `DVDB.dat`, `HELP.TXT`는 영문이므로 별도 인코딩 변환 도구(`iconv`) 불필요

Phase 2 체크 항목:
```
- [ ] TCHAR/WCHAR → char 일괄 치환 완료 확인
- [ ] _T() 매크로 제거 확인
- [ ] CString → char[]/std::string 변환 확인
```

---

### 5. 폰트 렌더링 방안 🟡

> ⚠️ 우선순위 변경: 🟠 중요 → 🟡 권고 (영문 전용 — 비트맵 폰트로 충분)

**현황**
Phase 4-5에 "비트맵 폰트 또는 간단한 벡터 폰트"로만 기술.

**화면별 텍스트 렌더링 요구사항 (영문 전용)**

| 화면 | 동적 텍스트 | 문자 종류 |
|---|---|---|
| HOME | 열차번호(숫자), 승무원ID(숫자), 역명, ETA | 영문/숫자 |
| TRAIN/CREW | 숫자 입력 | 숫자 |
| ROUTE | 정차역 목록 | 영문 |
| CONFIG | 설정값 | 숫자/영문 |
| CHECK | 장비 상태 코드 | 영문/숫자 |
| HELP | HELP.TXT 내용 표시 | 영문 |
| MESSAGE | 텍스트 메시지 | 영문 |

**권장 방안 (단순화)**

```
비트맵 폰트 (권장): ASCII 95자(0x20~0x7E) 사전 생성
  - 필요 크기별(예: 16px, 24px, 32px) BMP 글리프 테이블 생성
  - 런타임 의존성 없음, 용량 극소 (수 KB)
  - FreeType2 등 외부 라이브러리 불필요
  - 구현 단순: 문자 코드 → 글리프 오프셋 직접 계산
```

~~옵션 A (FreeType2 + 한국어 TTF 폰트)~~ → 불필요
~~Phase 4-11 | 한국어 폰트 크로스 컴파일~~ → 삭제

Phase 4 추가 항목:
```
4-10 | 비트맵 폰트 생성 | ASCII 글리프 테이블 크기별 생성 및 렌더링 함수 구현
```

---

### 6. 실시간성 요구사항 미검토 🟡

**현황**
열차 제어 시스템이나 실시간 응답에 대한 요구사항 및 OS 설정 방안이 없음.

**보완 필요 사항**

시리얼 수신 스레드 스케줄링 정책 명시:
```c
// 권장 설정
struct sched_param param = { .sched_priority = 50 };
pthread_setschedparam(serial_thread, SCHED_FIFO, &param);
```

Linux 커널 설정 확인:
- `CONFIG_PREEMPT_RT` 패치 적용 여부 (Yocto BSP에 포함 여부 확인)
- 적용 불가 시 `CONFIG_PREEMPT` (선점형 커널) 최소 요구

타이머 정밀도:
- `SetTimer` 100ms 주기 → `timer_create(CLOCK_MONOTONIC, ...)` 으로 대체 시 jitter 허용 범위 명시

---

### 7. 통신 명령 코드 완전 목록 부재 🔴

**현황**
계획서에 명령 코드 4개(0x10~0x13)만 명시. Packet.h (25KB)에 더 많은 코드가 정의되어 있을 가능성 높음.

**보완 필요 사항**

`Packet.h` 전수 조사 후 `protocol_def.h`에 반영:
- PEI (승객 비상 인터콤) 관련 명령 코드
- C/I (Consist Information) 관련 명령 코드
- CM (Custom Message) 전송 관련 명령 코드
- 상태 요청/응답 외 이벤트성 명령 코드

**작업 추가**:
```
2-1-a | Packet.h 전수 분석 | 모든 CMD_CODE, 장비ID, 페이로드 구조 목록화 | protocol_def.h 초안
```

---

### 8. 시뮬레이션 모드 구현 계획 없음 🟡

**현황**
CONFIG 페이지에 시뮬레이션 모드가 있으나(PageConfig.cpp), 포팅 계획에 전혀 언급 없음.

**보완 필요 사항**
- 기존 WinCE 시뮬레이션 모드 동작 방식 파악 (Packet.cpp 내 로직 확인)
  - 실제 시리얼 수신 없이 더미 PAC 데이터를 내부 생성하는 방식 추정
- Linux 포팅 시 동일 기능 구현 여부 결정
- 개발 단계에서 실제 보드/장비 없이 테스트 가능하므로 개발 효율에 중요

Phase 2 또는 Phase 5 추가 항목:
```
x-x | 시뮬레이션 모드 | 더미 PAC 데이터 생성기 구현 | sim_pac.c/h
```

---

### 9. 소프트웨어 업데이트 메커니즘 구체화 부족 🟡

**현황**
Update.cpp(14KB)를 단순히 "NandFlash → eMMC 파일 복사, 파일 API 변환"으로만 처리.

**보완 필요 사항**

| 항목 | 현재 계획 | 보완 내용 |
|---|---|---|
| 업데이트 패키지 형식 | 미정 | tar.gz 또는 단일 바이너리 결정 필요 |
| 무결성 검증 | 없음 | MD5/SHA256 체크섬 파일 동봉 |
| 업데이트 후 재시작 | 미정 | `execv()` 재실행 또는 `systemctl restart` |
| 실패 시 롤백 | 없음 | 이전 바이너리 백업 후 업데이트 실패 시 복구 |
| 업데이트 파일 수신 경로 | 미정 | 시리얼 수신? USB 마운트? 네트워크? |

---

### 10. i.MX6 BSP/커널 버전 미확정 🟠

> ⚠️ 우선순위 변경: 🟡 권고 → 🟠 중요 (다른 작업의 전제 조건)

**현황**
타겟 플랫폼에 "Yocto 기반"이라고만 명시. 구체적 버전 정보 없음.

**보완 필요 사항**

| 확인 항목 | 영향 |
|---|---|
| Yocto 릴리즈 (kirkstone / dunfell / honister 등) | 사용 가능한 레시피/패키지 결정 |
| Linux 커널 버전 | `/dev/input` evdev ABI, fbdev 인터페이스 |
| 터치 컨트롤러 드라이버 | tslib 필요 여부, `evdev` 직접 사용 여부 |
| i.MX6 variant | Solo / Dual / Quad — 성능 차이 |
| eMMC 용량 | BMP 리소스 168개 + 폰트 + DB 적재 가능 여부 |

---

### 11. 메모리/자원 관리 전략 없음 ℹ️

**현황**
임베디드 시스템에서 장시간 운행 시 메모리 누수가 심각한 문제가 될 수 있으나 계획 없음.

**권고 사항**
- 동적 할당 최소화 원칙: UI 위젯, DB 결과셋 등 수명이 명확한 객체만 `malloc/free`
- 정적 배열 우선 사용 (스택 또는 전역 배열)
- 개발 단계: `valgrind --leak-check=full` 또는 `-fsanitize=address` 로 누수 점검
- 릴리즈 빌드에서 주기적 메모리 사용량 로깅 (`/proc/self/status` VmRSS 읽기)

---

### 12. PAC 통신 에러 처리 상세 부족 ℹ️

**현황**
리스크 테이블에 "시리얼 타이밍 차이"만 있고, 통신 에러 발생 시 UI/상태 처리 방안 없음.

**보완 필요 사항**

| 에러 상황 | 현재 처리 | 권고 처리 |
|---|---|---|
| PAC 타임아웃 (N초 이상 수신 없음) | 미정 | 상태 LED 황색/적색 전환, 타임아웃 횟수 카운트 |
| CRC 오류 패킷 수신 | 미정 | 패킷 폐기, 오류 카운터 증가, 로그 기록 |
| 시리얼 포트 오픈 실패 | 미정 | 재시도 N회 후 에러 화면 표시 |
| CNCS 송신 실패 | 미정 | 재시도 횟수/간격 정책 명시 |

타임아웃 기준값 (원본 코드 `Serial.cpp` 분석 후 확인):
- PAC 정상 송신 주기 확인 → 타임아웃 임계값 = 정상 주기 × N 배로 설정

---

## 보완 작업 반영 후 갱신 필요 항목

원본 `CCP_PORTING_PLAN.md`에서 다음 섹션 갱신 권고:

| 섹션 | 갱신 내용 |
|---|---|
| 3.2 API 매핑 테이블 | 오디오 API, RS-485 ioctl 추가 |
| 3.1 레이어별 포팅 난이도 | 오디오 레이어 행 추가 |
| 5 단계별 작업 계획 | 오디오, 시뮬레이션 모드, 비트맵 폰트 작업 항목 추가 |
| 8 리스크 및 대응 | WCHAR→char 변환 누락, PAC 에러 처리, 실시간성 리스크 행 추가 |
| 11 체크리스트 | TCHAR/WCHAR 제거 확인, 비트맵 폰트 영문 렌더링 검증 항목 추가 |
| (신규) 12 미결 사항 | BSP 버전, 오디오 코덱 탑재 여부 등 의사결정 대기 항목 목록 |
