JDSCS-Club/DENVER_CCP/DOC/09_발표_보고/01_PDR_FDR_발표/덴버 PDR 발표에 따른 미국 출장 보고서.docx

덴버 PDR 발표에 따른 미국 출장 보고서.

일정 | 내용
5월 23일 | - 미국 LA 오전 10시 도착 - 미국 김상현 과정 숙소로 이동, 짐을 풀고 LA 경전철 및 지하철 승차 및 현장 자료 조사.
5월 24일 | - 오전에 덴버로 출발 오후 3시 30분경 덴버 도착. - 숙소 도착 후 발표 예행 연습.

5월 25일

- 오전 PDR 발표 장소로 이동.
- 오후 Wimax 업체 발표 참가.
- 시행청 코멘트.

1. Communications

- Activated Cab 뿐만 아니라, Non-activated Cab에서도 DPO로 통화가 가능한지?

=> 가능하다.

- DPO, PEI, OCC간 3자 통화가 가능하도록 요청

=> 현재는 DPO가 응답시 OCC와의 통화가 불가능하나, 3자 통화기능의 가능여부를 검토하겠다.

- PEI 전원공급부는 어디에 위치하는가?

=> 박스내부에 위치

- The Emergency Responders와 DPO간 통화는 항시 가능해야 한다.

=> 당사에서는 The Emergency Responder가 OCC와 같은 설비를 갖추어야 가능하다고 답변

=> Train Radio를 통해 긴급상황시 무선통화가 가능 (Mr. Peter Strange)

- PEI 위치 선정시 Bicycle Storage Area 부근에는 사이드 패널쪽으로 이동하여 취부요청

=> PEI 를 세로로 하여 취부하면 가능하다.

- LCD 동작온도, 저장온도와 관련하여 CCP Log-in 필요여부

=> CCP의 경우, 차량 ID를 입력하도록 되어 있음

- 4량 중련운행시 Intermediate Car의 FDI 전원 OFF 가능여부

=> 현재는 기능이 없으나, 검토하겠다.

- DPO Volume Level을 최소 볼륨값을 갖도록 설계요청

=> 최소 볼륨이 Mute가 되지 않도록 설계예정

- CCP Shock Acceleration 설계여부

=> Lateral 4g/ Vertical 4g/ Longitudinal 8g를 견디도록 FEA 해석 후 설계예정

- 저온에 방치하여 고장이 발생하지 않도록 Layover 관련 개념수립

=> 현재는 없으나, Layover Mode에서 일정한 온도를 유지가 필요한지 확인 및 검토하겠다.
5월 26일 | - 덴버 현지 지하철 승차 및 현지 조사.
5월 27일 | - 아침 6시 30분에 체크 아웃 예정. - LA로 이동 후 귀국예정.
