JDSCS-Club/DENVER_CCP/DOC/09_발표_보고/02_시스템_설계/RF38.docx

RF38 | Screen | It would be optimal to have a screen shot showing all systems in the normal condition (PIS is failed, Con key is on) | WOOJIN has attached the initial screen shot showing all systems in the normal condition as follows. | Leo
RF39 | Enter the two digit route number using the touch screen key pad. | Need to provide the possible route numbers as a table. | Please refer the provided table with possible route number. | Leo
RF40 | Crew numbers are not the input. | What does this mean? | WOOJIN has removed the input function of the crew number but the input button still remains by RTDC request. | Leo
RF41 | cold start or a warm start. | Need to define the difference. | Please refer to the Appendix2. Section 3.2.1.1 for the difference with cold start and warm start. | Leo
RF42 | Using the CCP to Change Destination Sign Displays Based on the Route | Auto announcements also | Added the Auto announcements | Leo
RF54 | Sounding the audio alarm of TMS/alerter panel continuously. | Correct? | ATC equipment is not from WOOJIN | Leo
RF94 | EXP - The EXP train is a train that reaches to the destination without a stop. | Clarify – what if multiple EXP are pressed? | The multiple EXP cannot be pressed. If the other EXP is pressed, the selected station will be reset. | Leo
RF95 | LOCAL - The LOCAL train is a train that stops at every station. | How is this different from STOP? | LOCAL is available to stop at the every station to the selected station. But the STOP stops at the selected station only. | Leo
RF97 | near | Should this be in instead of near | The first speaker from the cab. | Leo
RF98 | Turn ON the crew key switch or the master controller key. | Not necessary | If the crew key switch or the master controller key is not Turn ON, PA is not available to operate. | Leo
WS99 | 'Attention! A passenger needs assistance’ | Update to actual message. | RTDC has not given for this actual message to WOOJIN. We will update the actual message before the field test. | Leo
RF100 | For operator, ensure master controller cab control key switch is set to other than OFF position. | Not necessary | It is not necessary. | Leo
RF101 | active | Does it have to be active? | It has to be active | Leo
RF102 | state | Add details about party line and OCC. | Details are added above number 5 of the PA announcement in section 2.2.10.2.1 | Leo

Two digit route number | Route
11 | Denver Union Station 38th / Blake Station Colorado Station Central Park Station Peoria Street Station 40th / Airport Station Denver International Airport Station
51 | Denver Union Station 41st / Fox Street Station Pecos Street Station Federal Boulevard Station Sheridan Boulevard Station Olde Town Arvada Station Arvada Ridge Station Ward Road Station
81 | Denver Union Station South Westminster Station
