JDSCS-Club/DENVER_CCP/DOC/09_발표_보고/02_시스템_설계/로템 수신 - system Blick Diagram.pptx

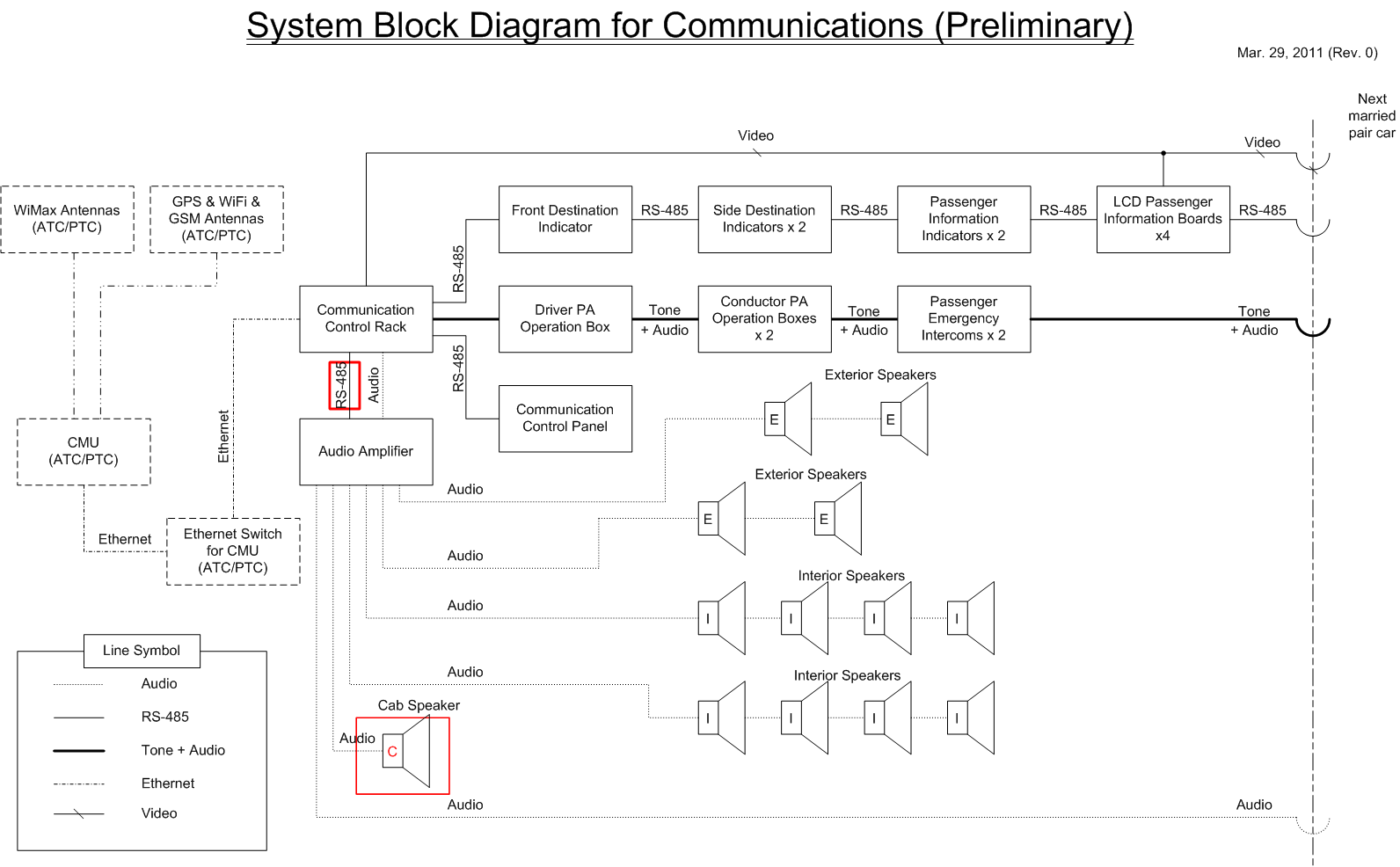
[picture p140: figure]

삭제

삭제
