JDSCS-Club/DENVER_CCP/DOC/09_발표_보고/03_DPO_통화절차/DPO 사진.pptx

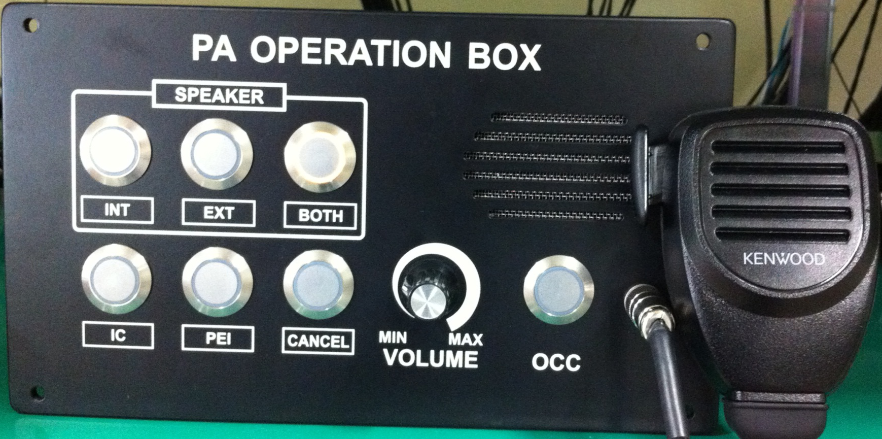
[picture p141: figure]

## Slide 2

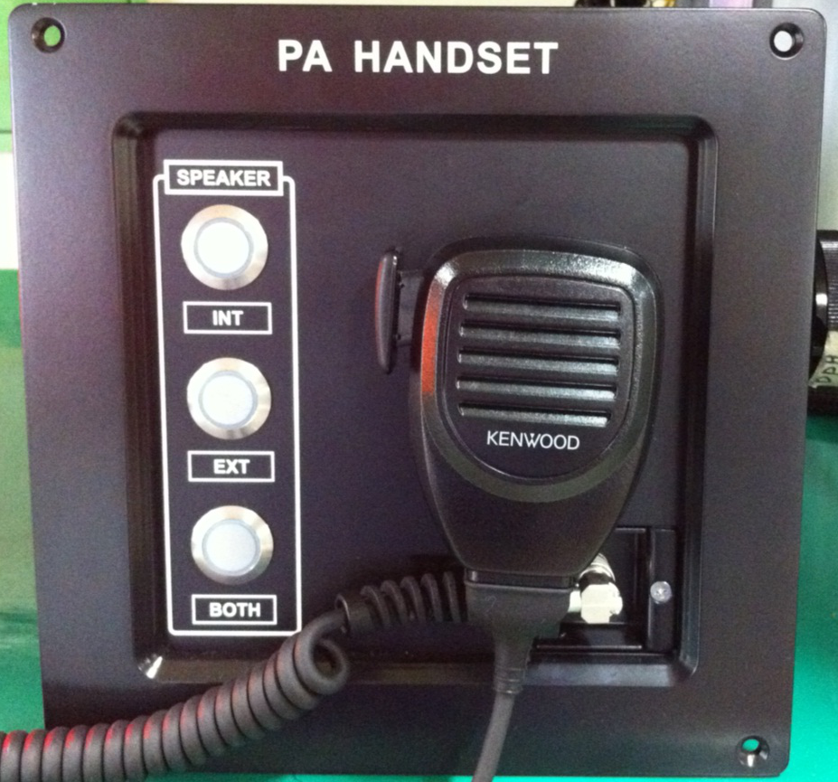
[picture p142: figure]
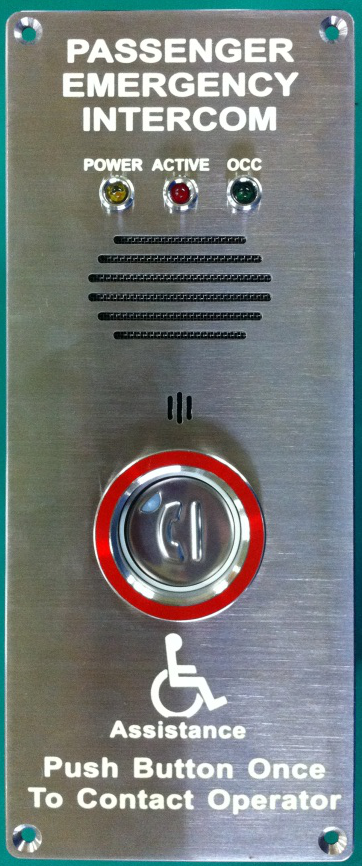
[picture p143: figure]
