JDSCS-Club/DENVER_CCP/DOC/09_발표_보고/03_DPO_통화절차/PEI 점차 추가.pptx

STADLER / 시카고 프로젝트 차량에서
내용을 참고 하였습니다.

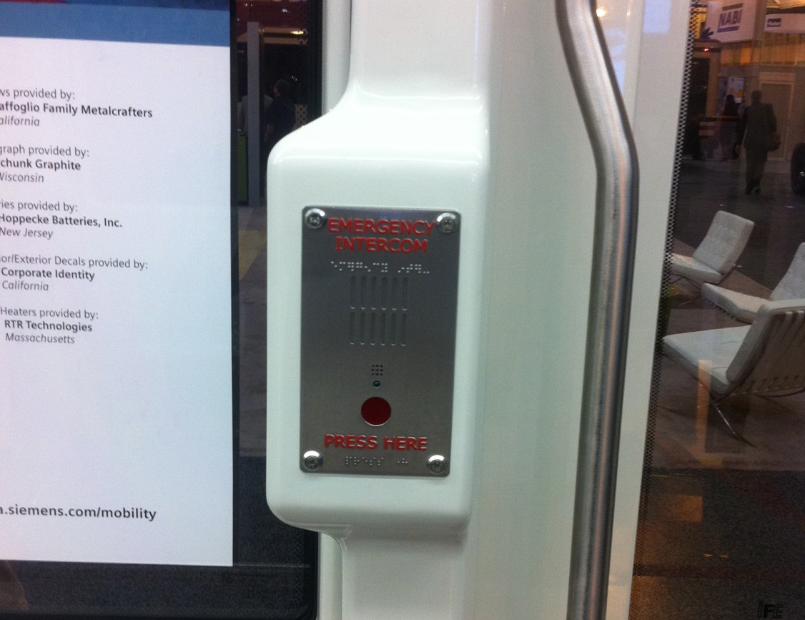
[picture p144: figure]

## Slide 2

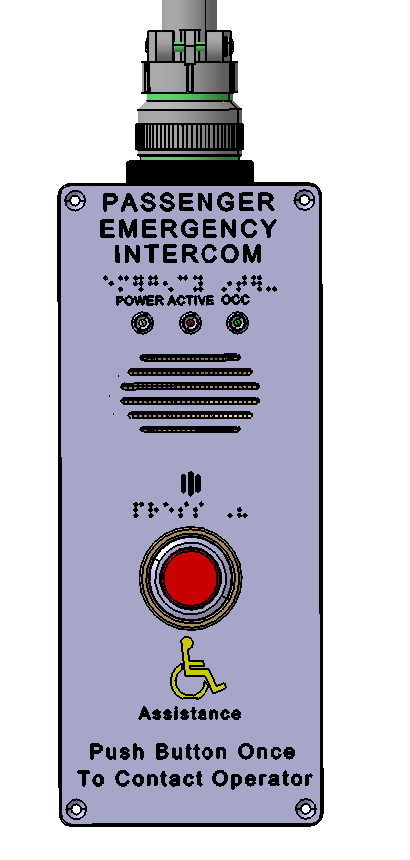
[picture p145: figure]

가격 : 각 장치당 10만원의 작업 비용이 추가로 발생.
기간 : 1달의 작업 시간이 더 필요함.

EMERGENCY INTER COM

PRESS HERE

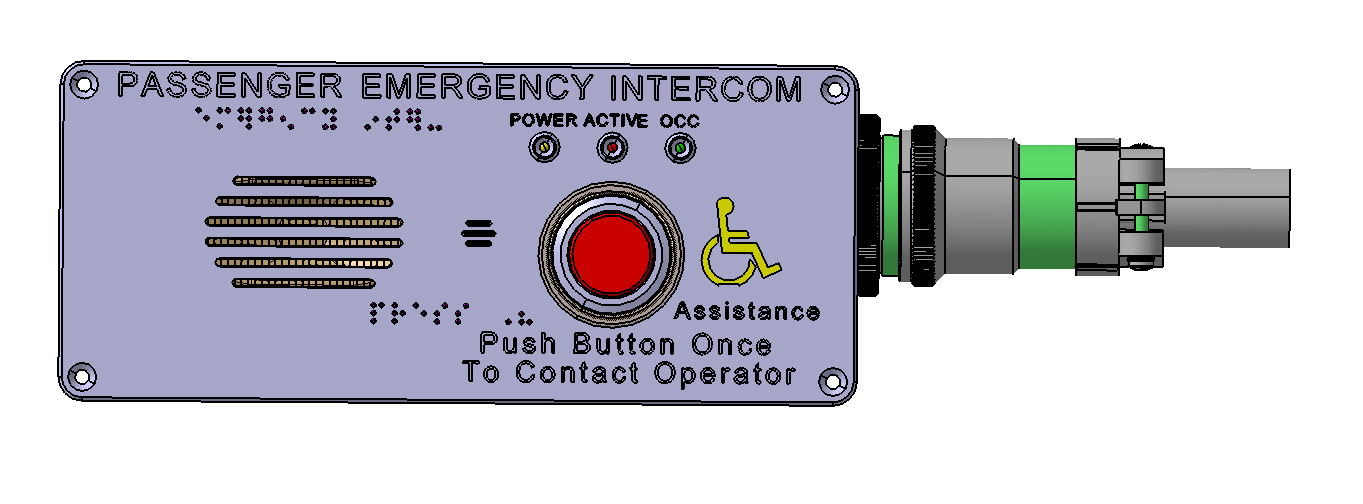
[picture p146: figure]
