JDSCS-Club/DENVER_CCP/DOC/09_발표_보고/04_장치별_기술/BPB 설계.pptx

DC 12

DC 37.5

DC 37.5

DC 5

E-Net

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
(디버깅)
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
(디버깅)
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
RS - 485

120

## Slide 2

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
## Slide 3

WIMAX

2011년 06월 23일 내용 확정.

P
W
R
12H

41 ANTS

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
(디버깅)
4H

79 RF-COM

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
(디버깅)
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
