JDSCS-Club/DENVER_CCP/DOC/09_발표_보고/04_장치별_기술/CCP 운행 스케줄 확인 방법.pptx

MA CBA

MB CBA

1. MA에서 처음 열차 번호를 입력 한다.
2. 시뮬레이션을 진행 한다.
3. 역명 표출을 확인 한다.
4. CBA을 뺀다.

1. MB 에서 CBA 신호를 입력 한다.
2. 운행 스케줄이 MA에서 시뮬레이션 했던 역순으로
설정 되었는가 확인 한다.
3. 시뮬레이션을 진행하여 역명 표출 확인

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
## Slide 2

MA CBA

MB CBA

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
MB에서는 상행 종착역 (E역) 스케줄 설정이 되고, 현재 위치 정보는 GPS 정보를 이용하여 찾는다.

중간에서 CAB 신호가 변경 되었을 경우

중간 역에서 CBA 신호가 빠지고 MB에서 CBA 신고가 들어 가면 운행 DIA는 상행선 종착(E역) 부터 스케줄 설정한다.

현재 위치

①

②
