JDSCS-Club/DENVER_CCP/DOC/09_발표_보고/04_장치별_기술/CRA X4 변경 방안.pptx

< 변경전>

외부 터미널에서 공통 신호라인 단말 처리

< 변경 방안>
