JDSCS-Club/DENVER_CCP/DOC/09_발표_보고/04_장치별_기술/DENVER MDS 인터페이스 추가 관련 내용 정리.pptx

## DENVER MDS 인터페이스 추가 관련 내용 정리.

PTC – CRA – MDS - CI

## Slide 2

DENVER MDS 인터페이스 보완 내용.

1. CRA(MA) 한곳에서만 Lonworks 통신
: SEPTA System 으로 구성시 MA-MB 중 한곳 에서만 Lonworks이 활성화 됩니다.
이 부분에 대한 보안 방법 필요 합니다.

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
## Slide 3

DENVER MDS 인터페이스 보완 내용.

2. CRA BACKUP 기능.
: MA-MB 중 CRA 장치 하나가 이상 동작시 BACKUP 동작이 가능 하다.
하지만 BACKUP 동작시 MDS – CI 동작에 영향을 줄 수 있다.
* 방송/ 표시기 BACKUP 동작 SYSTEM에 대한 하부 장치 보완 필요 합니다.

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
방송/ 표시기 시스템 완전 BACKUP
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
## Slide 4

DENVER MDS 인터페이스 보완 내용.

3. 각 장치간 통신 확인 방법 보완.
: PTC – CRA – MDS – CI 각 장치간 통신 이상에 대한 확인 방법 보안 필요.
장치간 서로 보완적 상태 체크 방법이 간구 되어야 할 것 같습니다.
SEPTA의 경우 명확한 확인 방법이 없어 문제 해결에 오랜 시간과 경비가 소비 되었습니다.

PTC – CRA 통신 이상에 대한
확인 방법
보완 필요.

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
CRA –MDS 통신 이상에 대한
확인 방법
보완 필요.

MDS

MDS

MDS-CI 통신 이상에 대한
확인 방법
보완 필요.

MDS

MDS

CI

CI

CI

CI

## Slide 5

DENVER MDS 인터페이스 애로 사항.

1. 추가 인터페이스에 따른 개발 기간 필요
-> 3개월 이상에 추가 개발 기간이 필요 합니다.
2. 상세 인터페이스 자료 필요.
-> PTC – CRA 상세 인터페이스 자료.
-> CRA – MDS 상세 인터페이스 자료.
3. 추가 경비 방생.
-> 인터페이스 시험 및 개발 기간 연장에 따른 추가 경비 발생.
-> 고장 발생 건수 추가에 대한 대응 인건비 추가 발생.
-> 출장 및 인건비 포함 300,000,000원에 추가 경비 발생.
# 최대한 빠른 대응이 가능 하도록 노력 하겠습니다.
