JDSCS-Club/DENVER_CCP/DOC/09_발표_보고/04_장치별_기술/DPH 취부 방법 설명서.pptx

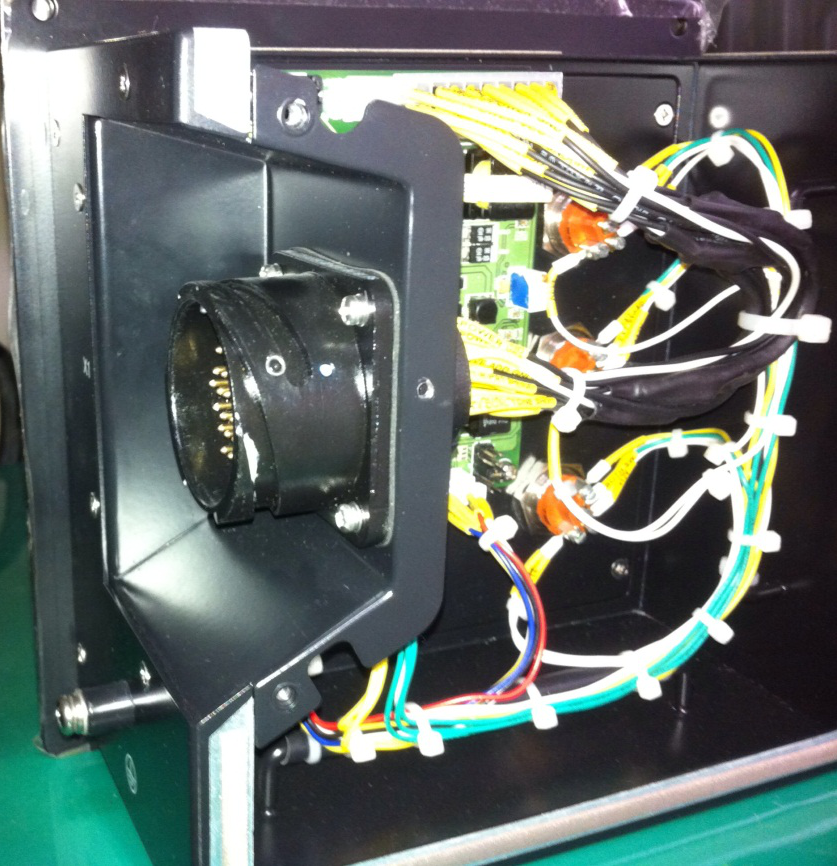
[picture p149: figure]
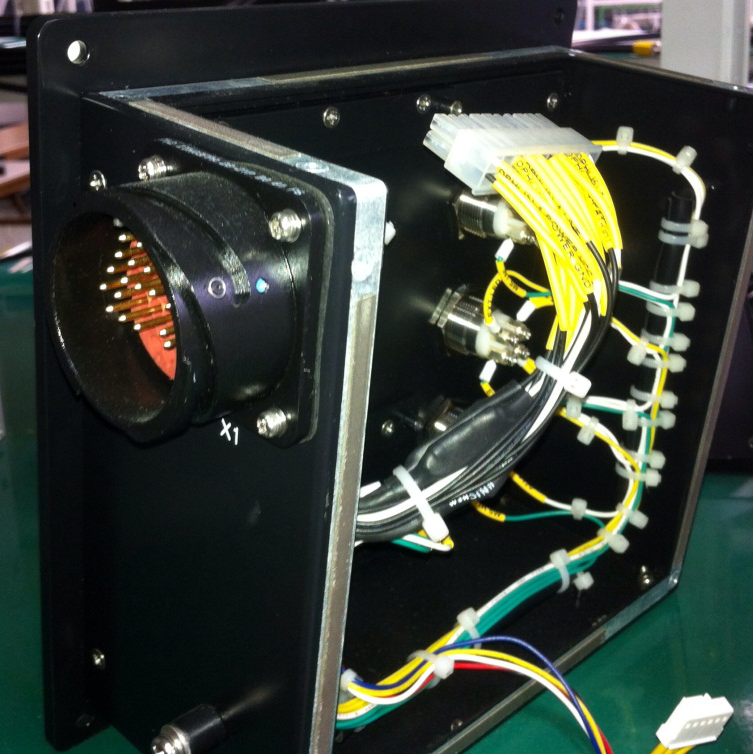
[picture p150: figure]

1차 설계

컨넥터를 박스 안쪽으로 변경 하였다.

2차 최종 설계

## Slide 2

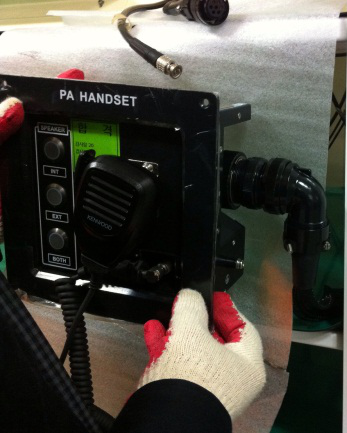
[picture p151: figure]
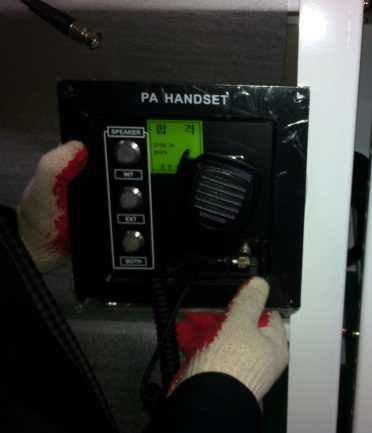
[picture p152: figure]
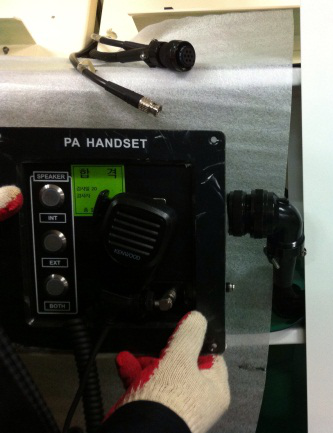
[picture p153: figure]

차량 컨넥터 결합 모습.

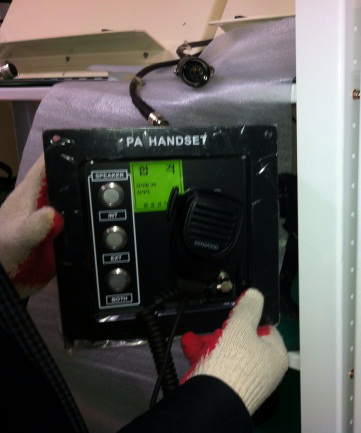
[picture p154: figure]

컨넥터 쪽 부분을 비스듬이 먼저 결합한다..

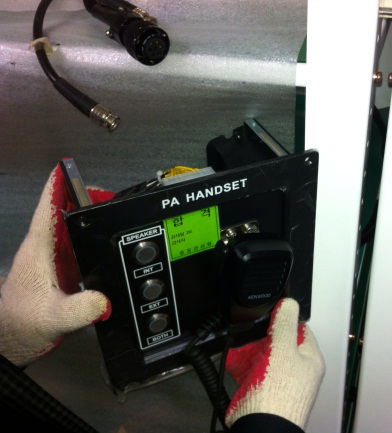
[picture p155: figure]

DPH
