JDSCS-Club/DENVER_CCP/DOC/09_발표_보고/04_장치별_기술/EMI-EMC 시험 SET.pptx

## EMI/EMC 시험SET_1 (PIS SYSTEM)

CCP

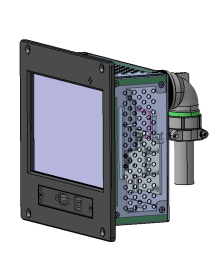
[picture p156: figure]
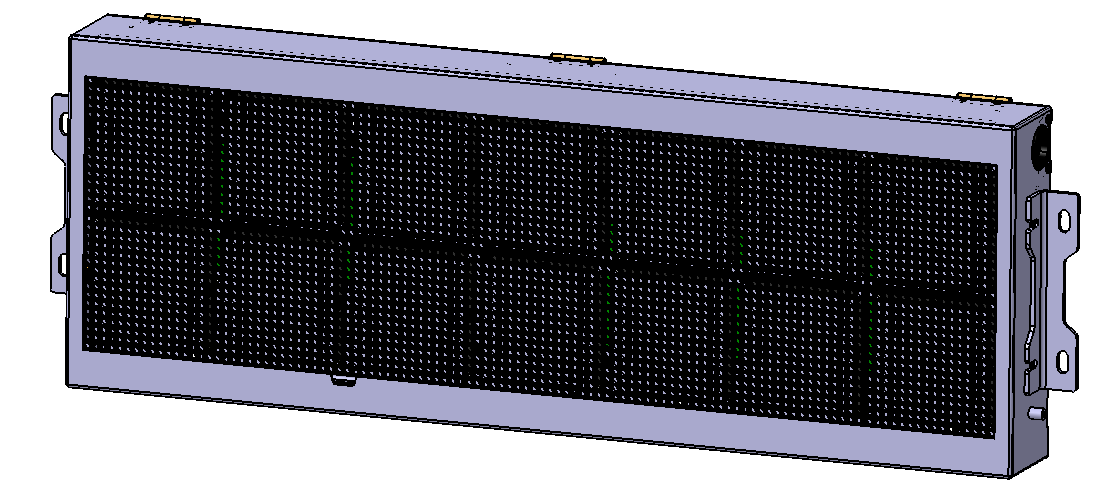
[picture p157: figure]

FDI

: 485

: 동영상
동축 케이블

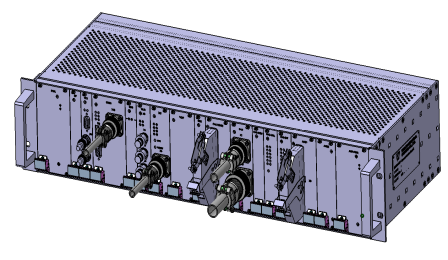
[picture p158: figure]

CRA

SDI

터미널 블럭

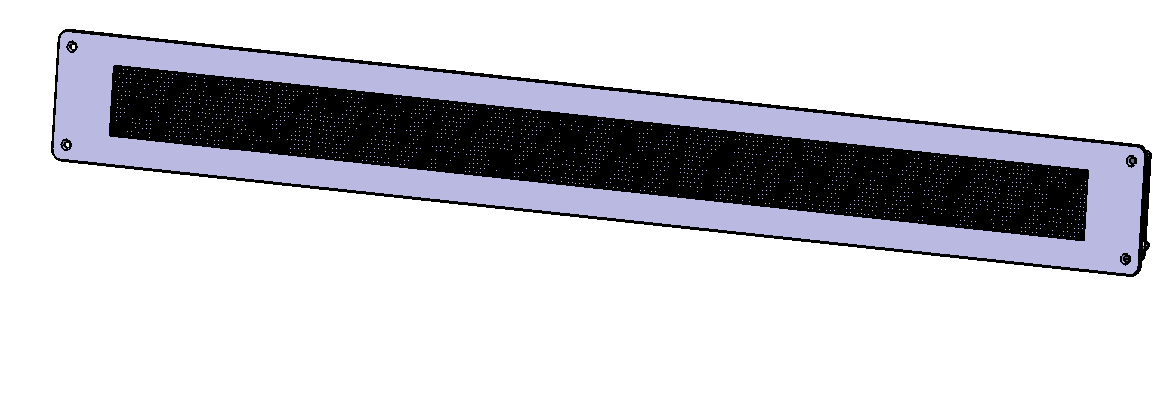
[picture p159: figure]

PID_2

PID_1

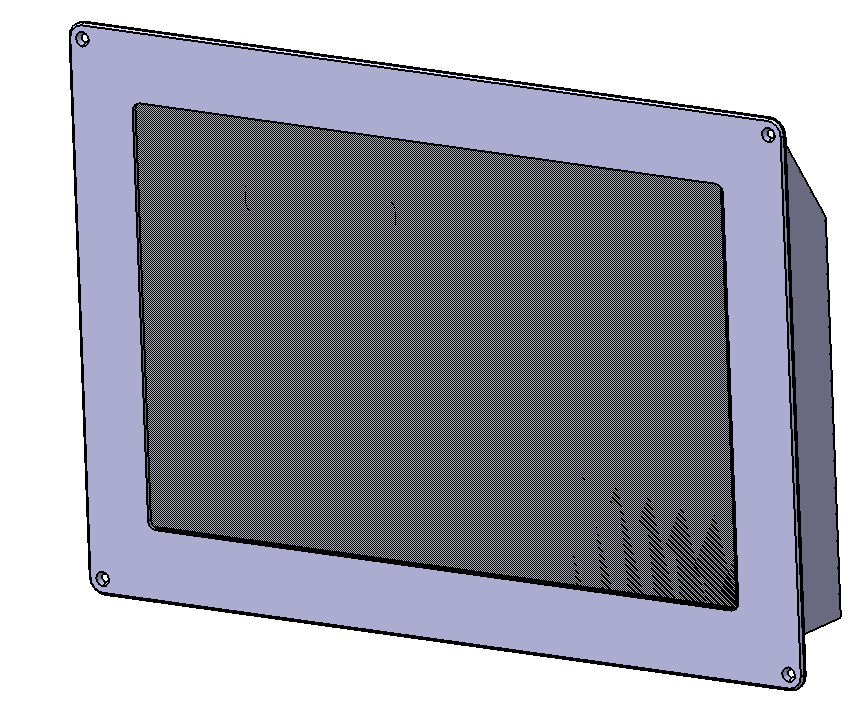
[picture p160: figure]

PII

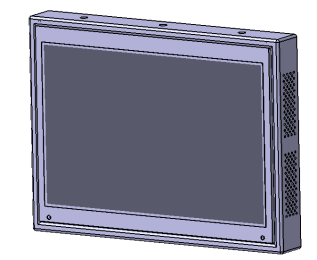
[picture p161: figure]
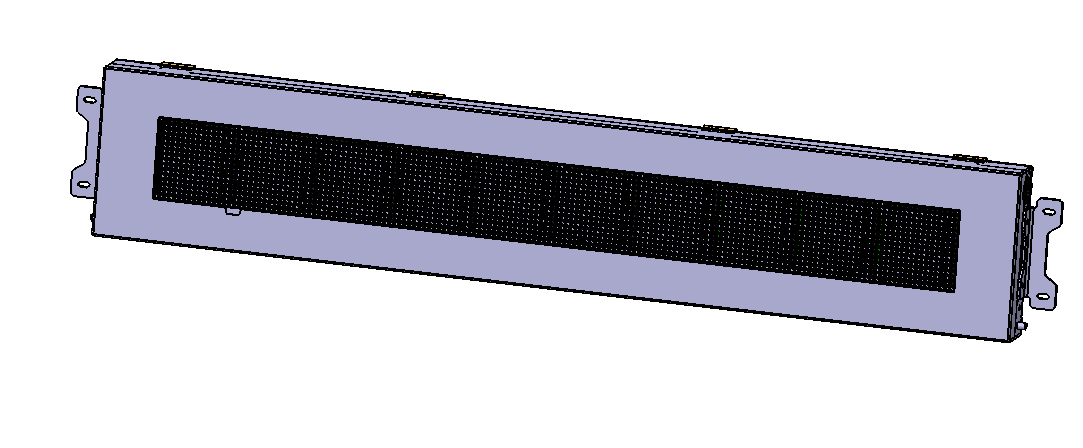
[picture p162: figure]

## EMI/EMC 시험SET_2 (PA SYSTEM)

: PA AUDIO LINE

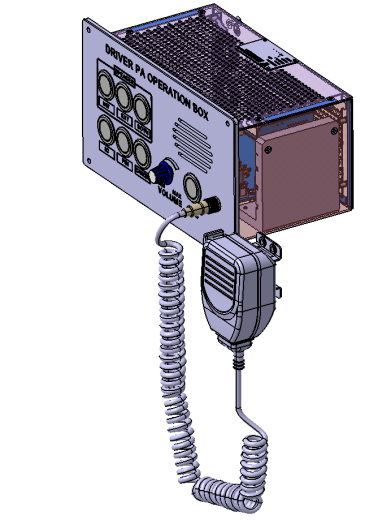
[picture p163: figure]
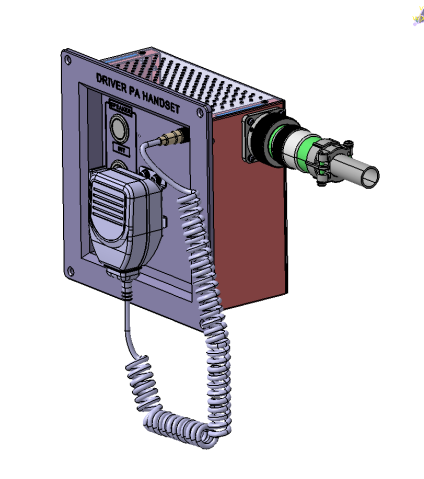
[picture p164: figure]

: PA DUAL TONE LINE

: MIC LINE

DPO

DPH

CRA

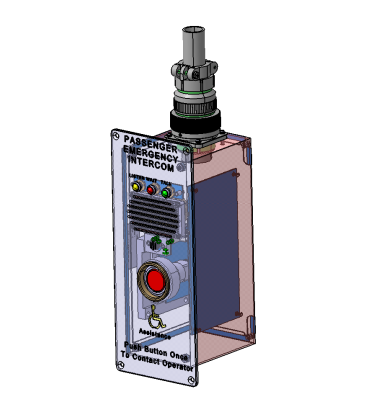
[picture p165: figure]

PEI-2

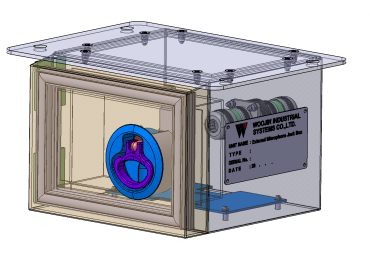
[picture p166: figure]

EMB

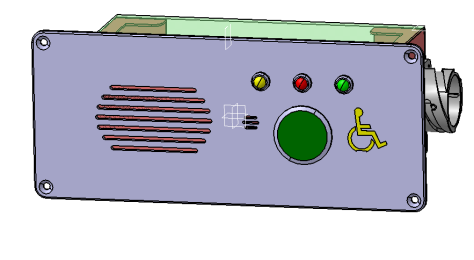
[picture p167: figure]

PEI-1
