JDSCS-Club/DENVER_CCP/DOC/09_발표_보고/04_장치별_기술/LIC S-W 정리.pptx

DENVER LIC 구조 정리.

문서 번호 : DDN-0432-0091-R04_Communications_Car_Monitoring_Network_ICD.
: DDN-0432-0080-R03_MDS_Car_Monitoring_Network_ICD.

1. 시간 전송

변수 | 내용
UNVT_CDT_command nvi00CDTCommand | MDS -> CRA 시간 요청 3600초 마다 요청 한다.
SNVT_time_stamp nvo00TimeStamp | CRA -> MDS 시간 전달

## Slide 2

2. MDS -> CRA 상태 정보 요청.

변수 | 내용
UNVT_subscribe nvi01Subscribe | MDS -> CRA 각 장치 상태 정보는 요청 한다..

UNVT_subscribe nvi01Subscribe
typedef struct { unsigned short param_id; unsigned long update_rate; } UNVT_subscribe;

param_id 내용 정리
param_id | 내용 | Default 시간(초)
param_id = 0 | 상태 데이타 요청. | 9
param_id = 1 | 차량 구성 요청. | 2
param_id = 2 | C/I 위치 요청. | 2
param_id = 3 | 차량 번호 요청. | 6
param_id = 4 | C/I 고장 난 위치 요청. | 2

※ 응답 시간은 update_rate 변수 값에 따라 유동 적으로 변경 될 수 있다.

## Slide 3

3. CRA -> MDS 정보 전송.

변수 | 내용
UNVT_parameter nvo01Parameter | CRA -> MDS 로 정보 전송.

param_id 내용 정리
param_id | 내용
param_id = 1 | 차량 구성 응답.
param_id = 2 | C/I 위치 응답.
param_id = 3 | 차량 번호 응답.
param_id = 4 | C/I 고장 난 위치 응답.

예제 소스
typedef struct { char stx; unsigned short Cmd; unsigned short MagCode; unsigned short Length; char Data[32]; } InData; InData InBuffer; | nvo01Parameter.param_id=1; nvo01Parameter.param_value=make_long(InBuffer.Data[1],InBuffer.Data[0]); propagate(nvo01Parameter);

※ 아래 내용 참고 “QUESTER TANGENT DDD” 문서 참고.

UNVT_parameter nvo01Parameter
typedef struct { unsigned short param_id; signed long param_value; } UNVT_parameter;

## Slide 4

QUESTER TANGENT DDD 문서 내용

ID # | Name (max 60 characters) incl. Units | Available Update Rate (msec) | Scale | Offset | Decimal | Notes | Help General
1 | Train Configuration | 2000 | 1 | 0 | 0 | 0: 2 cars; 1: 4 cars; 2: 6 cars; 3: 8 cars | 0: 2 cars; 1: 4 cars; 2: 6 cars; 3: 8 cars
2 | C/I Position | 2000 | 1 | 0 | 0 | 8 bits are required and corresponding bit for C/I’s position shall be “1” and other bits shall be “0” to indicate the position. The following table shows an example when the C/I is installed in No.2 car. Bit 0: Car 1; Bit 1: Car 2; Bit 2: Car 3; Bit 3: Car 4; Bit 4: Car 5; Bit 5: Car 6; Bit 6: Car 7; Bit 7: Car 8. | 8 bits are required and corresponding bit for C/I’s position shall be “1” and other bits shall be “0” to indicate the position. The following table shows an example when the C/I is installed in No.2 car. Bit 0: Car 1; Bit 1: Car 2; Bit 2: Car 3; Bit 3: Car 4; Bit 4: Car 5; Bit 5: Car 6; Bit 6: Car 7; Bit 7: Car 8.
3 | Car Number | 60000 | 1 | 0 | 0 | Car number coming from the ATC-PTC | Car number coming from the ATC-PTC
4 | Other C/I Fault Condition | 2000 | 1 | 0 | 0 | 8 bits are required and corresponding bit for faulty C/I shall be “1” and bits for healthy C/I shall be “0”. When the car is not connected to the train, the corresponding bit such as Bit5 in 2 cars train shall be “1”. Bit 0: Car 1; Bit 1: Car 2; Bit 2: Car 3; Bit 3: Car 4; Bit 4: Car 5; Bit 5: Car 6; Bit 6: Car 7; Bit 7: Car 8. | 8 bits are required and corresponding bit for faulty C/I shall be “1” and bits for healthy C/I shall be “0”. When the car is not connected to the train, the corresponding bit such as Bit5 in 2 cars train shall be “1”. Bit 0: Car 1; Bit 1: Car 2; Bit 2: Car 3; Bit 3: Car 4; Bit 4: Car 5; Bit 5: Car 6; Bit 6: Car 7; Bit 7: Car 8.

## Slide 5

4. MDS -> CRA 상시 정보 전송.

변수 | 내용
SNVT_state_64 nvi01CDTStBits | MDS -> CRA 상시 정보 전송.

※ DDN-0432-0091-R04_Communications_Car_Monitoring_Network_ICD 문서 참조.
