JDSCS-Club/DENVER_CCP/DOC/09_발표_보고/04_장치별_기술/SDI 커넥터 좌-우측 변경 방법.pptx

1) 커넥터 고정 볼트를 푼다.

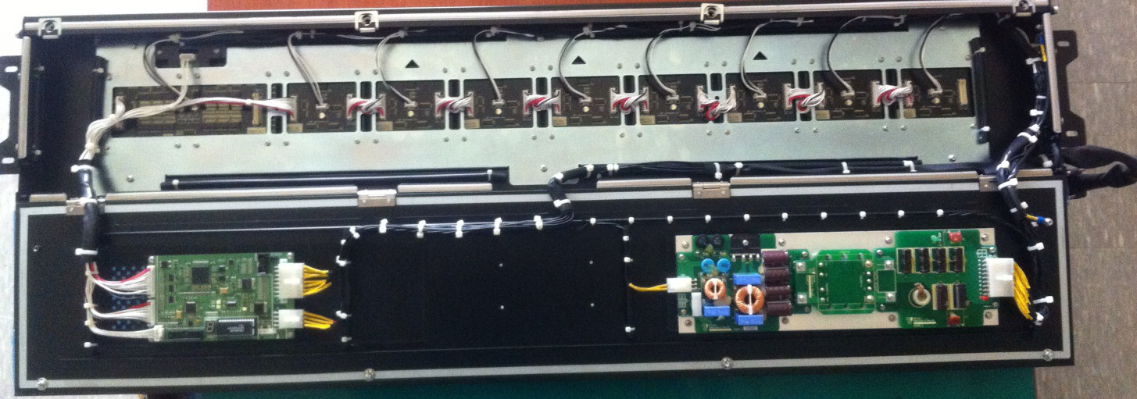
[picture p169: figure]
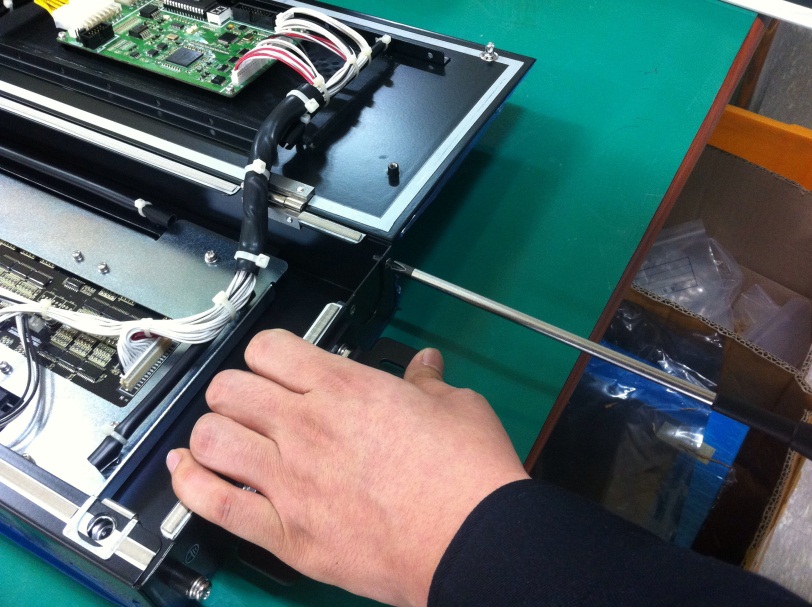
[picture p170: figure]
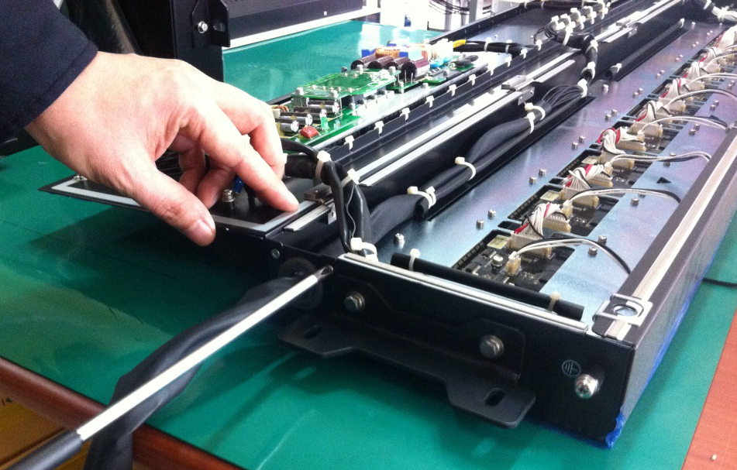
[picture p171: figure]

## Slide 2

2) 커넥터 케이블 타이를 전단 한다.

3) 커넥터 방향을 반대로 변경 한다.

## Slide 3

4) 커넥터를 케이블 타이로 고정 한다

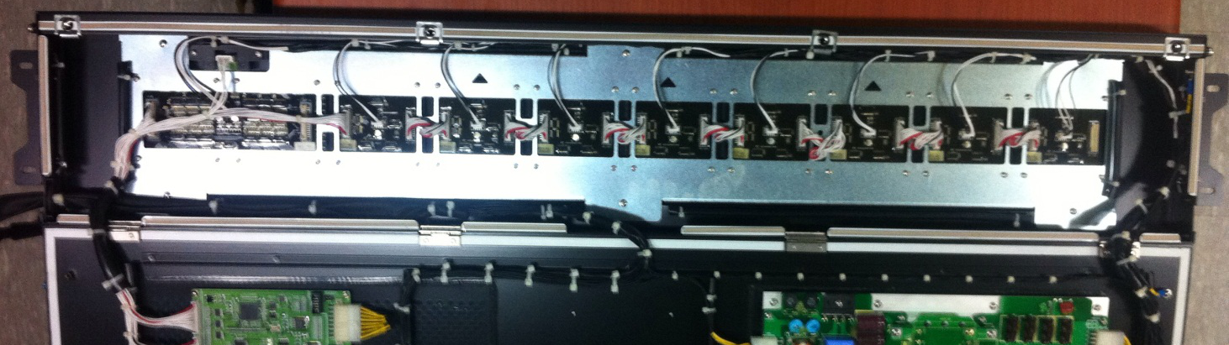
[picture p172: figure]

5) 커넥터 고정 볼트를 조립한다.

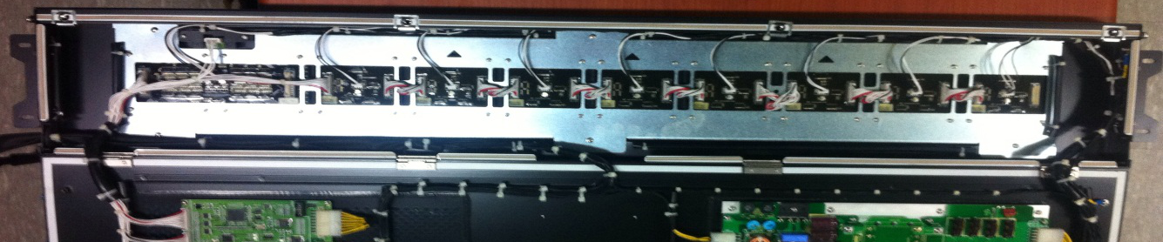
[picture p173: figure]
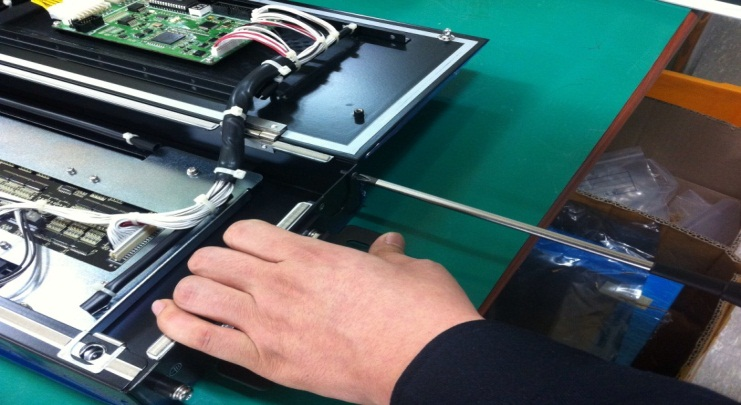
[picture p174: figure]
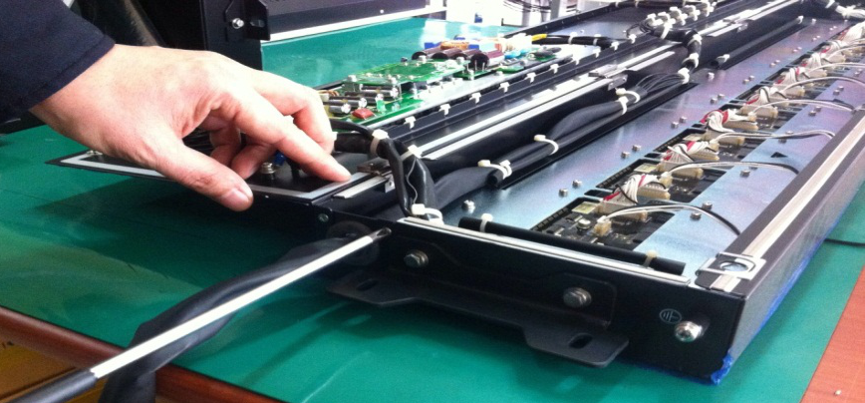
[picture p175: figure]
