JDSCS-Club/DENVER_CCP/DOC/09_발표_보고/04_장치별_기술/덴버 Wimax 협의 내용 정리-2.pptx

DENVER RTD
Communication System

Wimax 기술 협의
2011. 7. 27

## Contents

- 차량 데이터 관리.
- 실시간 문자 전송.
- 긴급 상황.

## 차량 데이터 관리.

Server

MDS

차량

데이터 편집 장치

1. 서버 운용 방법 : FTP? HTTP
2. 차량 및 Server간 데이터 통신 방법 : Wifi or WiMax
3. VOIP 음성 코덱 종류?(사용 칩셋 종류?)
4. 차량에서 수집된 MDS 파일의 이상유무를 판단하는 방법?

## 실시간 문자 전송.

RRDCC


1. SMRT 2호선 구축 방법을 설명.
  1. 차량 Event 일어날 경우, 사령 전송.
  2. 차량상태를 사령에서 호출.
2. 개발 영역
  1. 차량쪽는 우리개발을 한다.
  2. RRDCC쪽의 호출프로그램의 개발?
3. 문자전송종류(고객의 원하는 범위)
  1. Conetnet
  2. 비상 메시지냐??
4. WiMax or CDMA?

## 긴급 상황 1.

RRDCC


PEI On을 하고자 할 경우, RRDCC에서 차량의 호출을 통하여 제어가 가능하도록 함.
1. 개발 영역
  1. 차량쪽는 우리개발을 한다.
  2. OCC쪽의 호출프로그램의 개발?

## 긴급 상황 2.

EMB00000c7c4363

DPO – PEI 통신 Event가 발생할 경우.
- Event 정보를 OCC 로 전송함.
1. 개발 영역
  1. 차량쪽는 우리개발을 한다.
  2. OCC쪽의 모니터링 프로그램의 개발?

## Slide 7

THANK YOU !
Questions ?
