JDSCS-Club/DENVER_CCP/DOC/09_발표_보고/04_장치별_기술/동축 케이블 비교.pptx

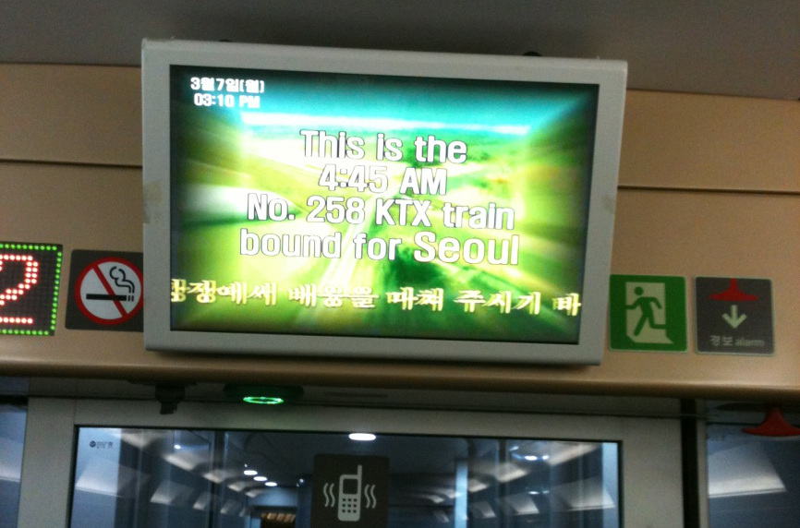
[picture p176: figure]
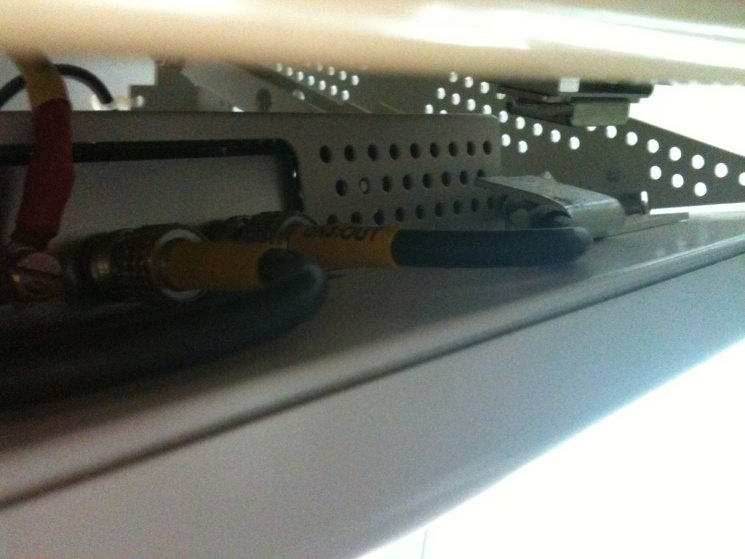
[picture p177: figure]

## Slide 2

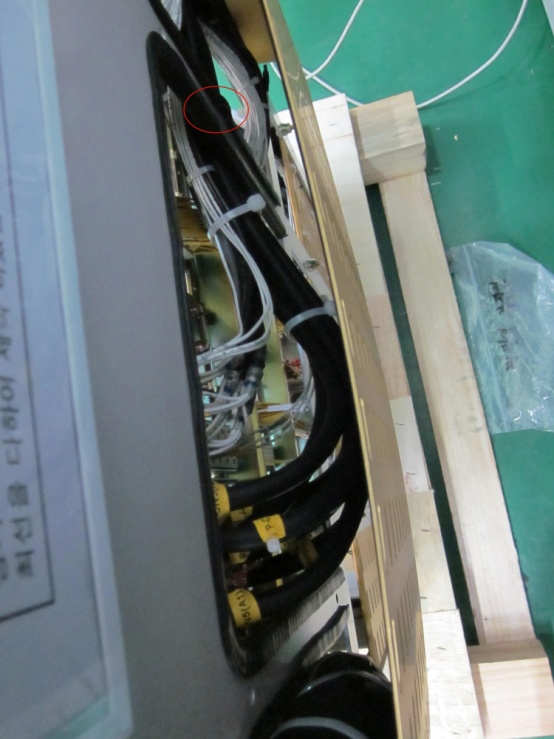
[picture p178: figure]
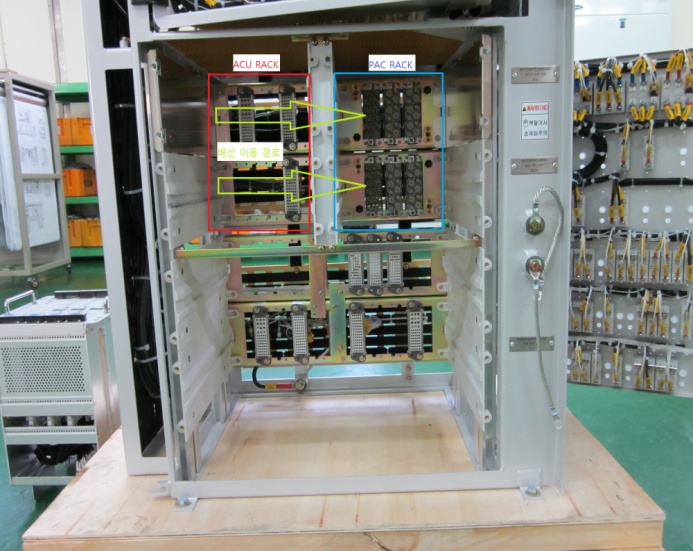
[picture p179: figure]
EMB000017ec0b4e
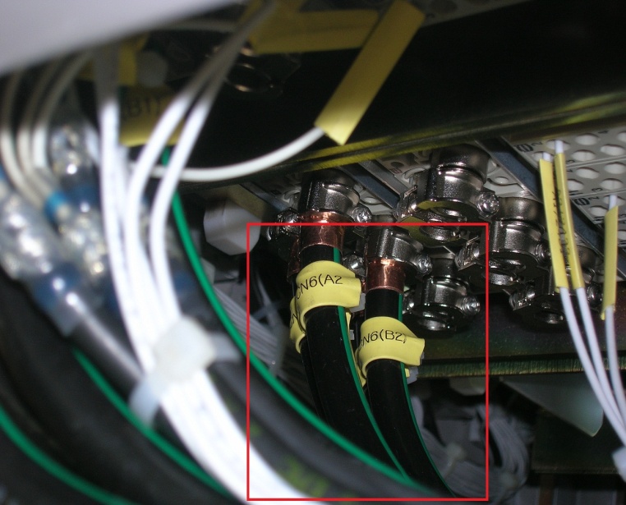
[picture p180: figure]
EMB000017ec0b4d

## Slide 3

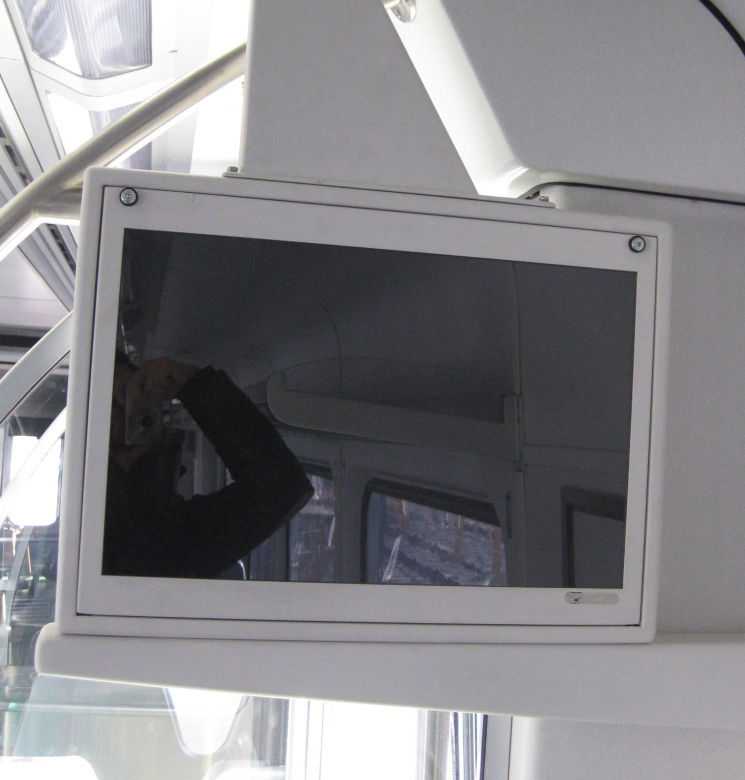
[picture p181: figure]
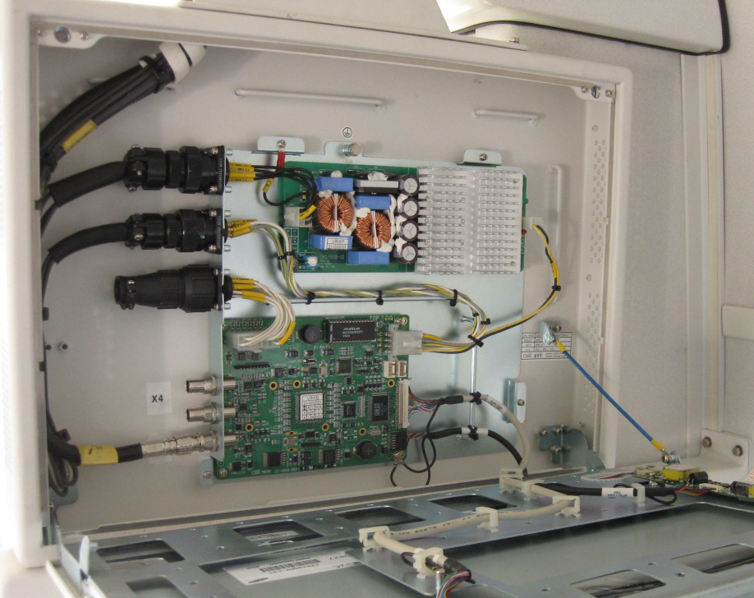
[picture p182: figure]
