JDSCS-Club/DENVER_CCP/DOC/09_발표_보고/04_장치별_기술/방송 장치 통화 절차 정리.docx

1. Cab에 설치 되는 방송 장치들의 사용 회수(빈도) 시나리오 나열.
2. PEI – DPO 통화 기능 확인 (선두 캡과 선두가 아닌 캡).

# Operator 입장에서 OCC/PEI/Cab to Cab 통신 절차.

2.1 선두 캡 통화 절차.

  2.2 선두가 아닌 캡 통화 절차.
3. 경고음 발생 장치.

3.1 장치 구분.

| CAB 설치 장치 | 객실 설치 장치
PEI | - | PEI 선택 시 방송. - 전체 방송기능 삭제 요청으로 운전실만 방송하는 기능 검토.
