JDSCS-Club/DENVER_CCP/DOC/02_설계_도면/시스템구성도/CRAO3.bmp

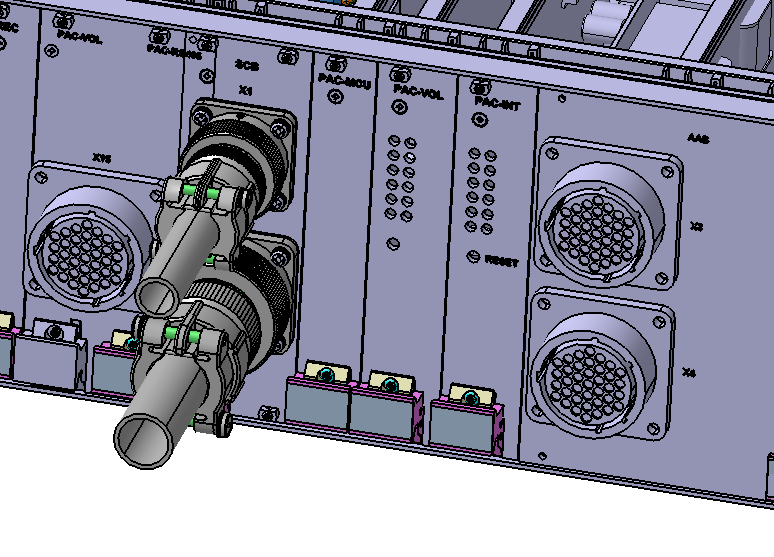
DOC/02_설계_도면/시스템구성도/CRAO3.bmp
