JDSCS-Club/DENVER_CCP/DOC/02_설계_도면/시스템구성도/IMG_1138.JPG

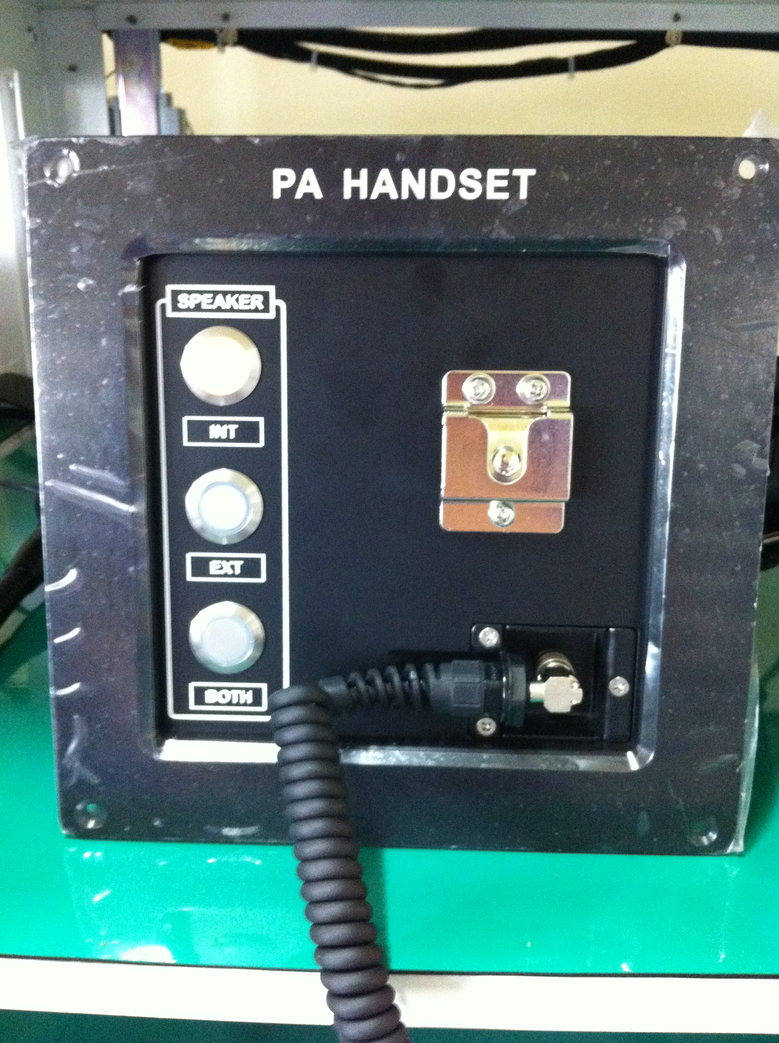
DOC/02_설계_도면/시스템구성도/IMG_1138.JPG
