JDSCS-Club/DENVER_CCP/DOC/02_설계_도면/시스템구성도/PII(2).bmp

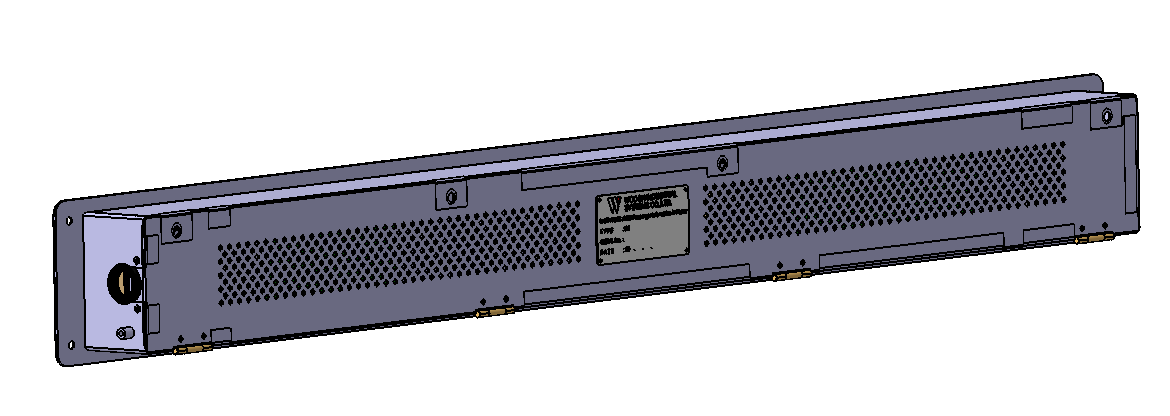
DOC/02_설계_도면/시스템구성도/PII(2).bmp
