JDSCS-Club/DENVER_CCP/DOC/02_설계_도면/회로도/APEM_Switch/APEM_3.bmp

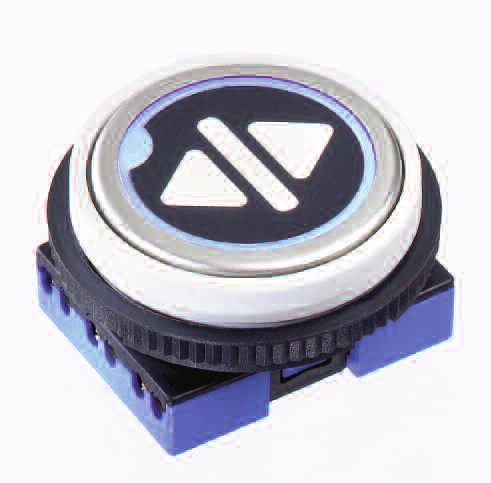
DOC/02_설계_도면/회로도/APEM_Switch/APEM_3.bmp
