JDSCS-Club/DENVER_CCP/DOC/02_설계_도면/회로도/APEM_Switch/APEM_11.bmp

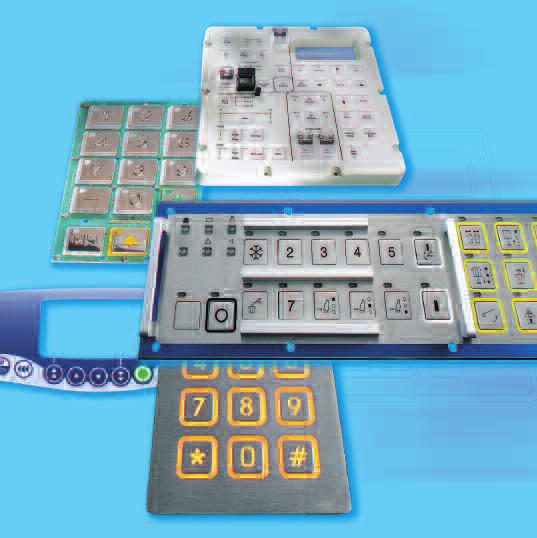
DOC/02_설계_도면/회로도/APEM_Switch/APEM_11.bmp
