JDSCS-Club/DENVER_CCP/DOC/03_시험_인증/VOIP_시험_자료/Denver_Train_VOIP_Setting.JPG

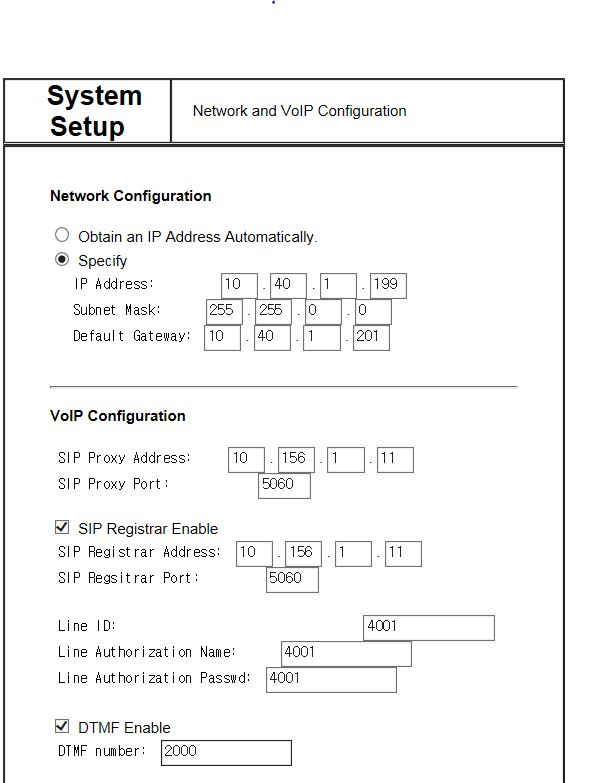
DOC/03_시험_인증/VOIP_시험_자료/Denver_Train_VOIP_Setting.JPG
