JDSCS-Club/DENVER_CCP/DOC/03_시험_인증/VOIP_시험_자료/September 2015 2708.jpg

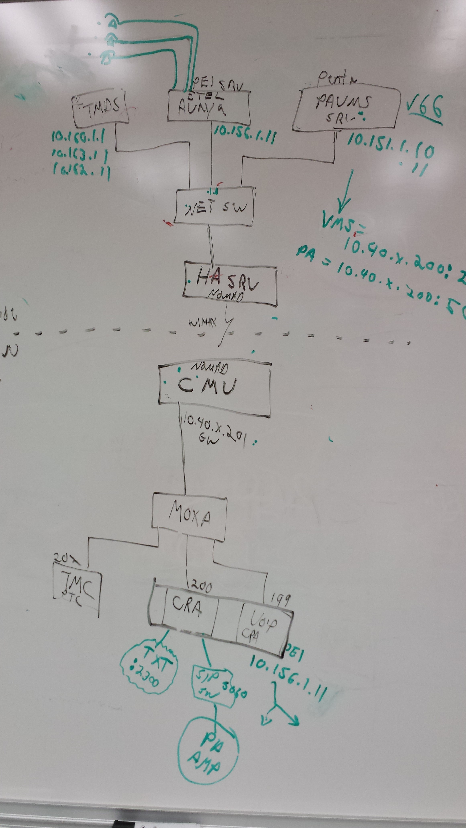
DOC/03_시험_인증/VOIP_시험_자료/September 2015 2708.jpg
