JDSCS-Club/DENVER_CCP/DOC/03_시험_인증/VOIP_시험_자료/UNADJUSTEDNONRAW_thumb_71a7.jpg

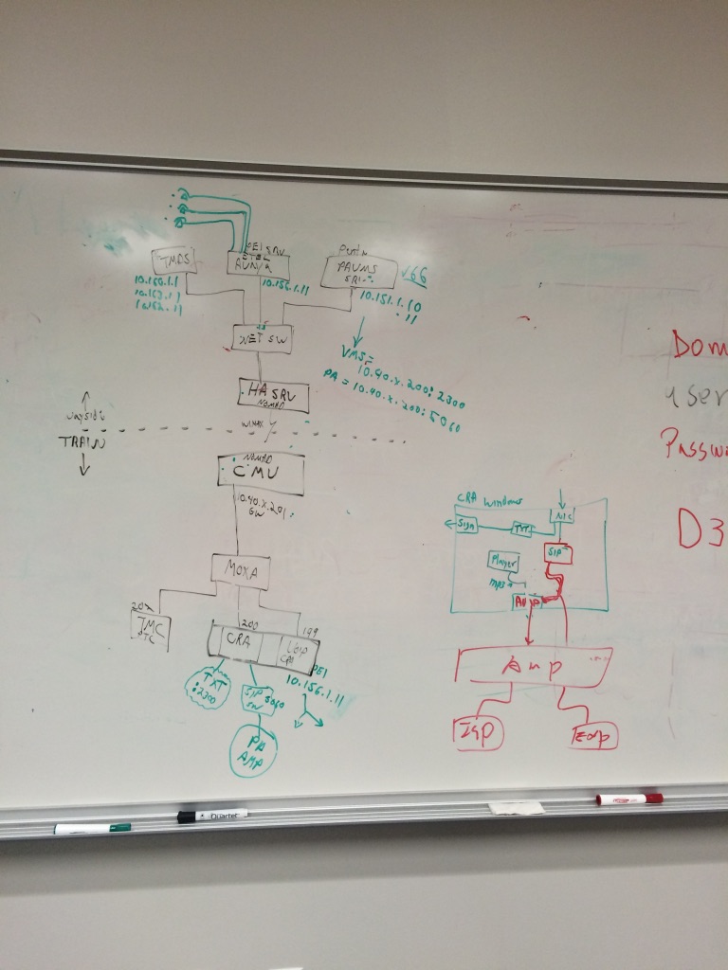
DOC/03_시험_인증/VOIP_시험_자료/UNADJUSTEDNONRAW_thumb_71a7.jpg
