JDSCS-Club/DENVER_CCP/DOC/05_정비_매뉴얼/IPC/IPC_기타/1.SSR315-AF.gif

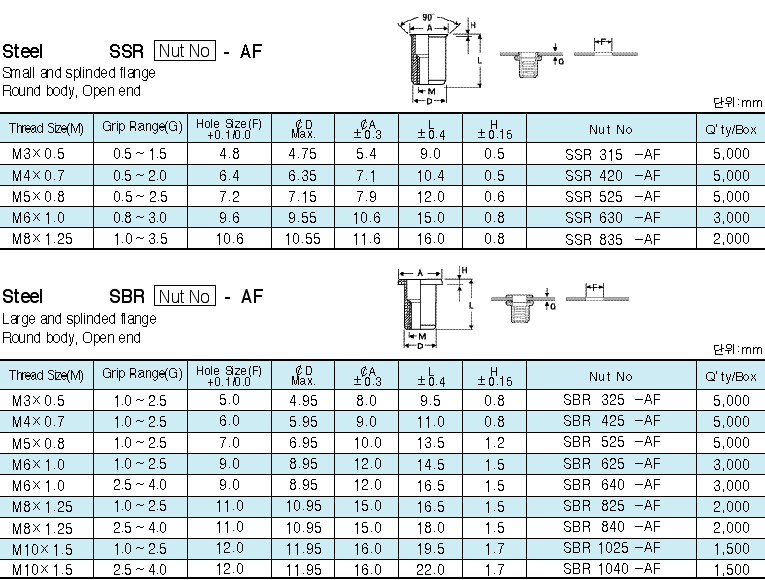
DOC/05_정비_매뉴얼/IPC/IPC_기타/1.SSR315-AF.gif
