JDSCS-Club/DENVER_CCP/DOC/05_정비_매뉴얼/IPC/IPC_기타/8.LAD1140-05.jpg

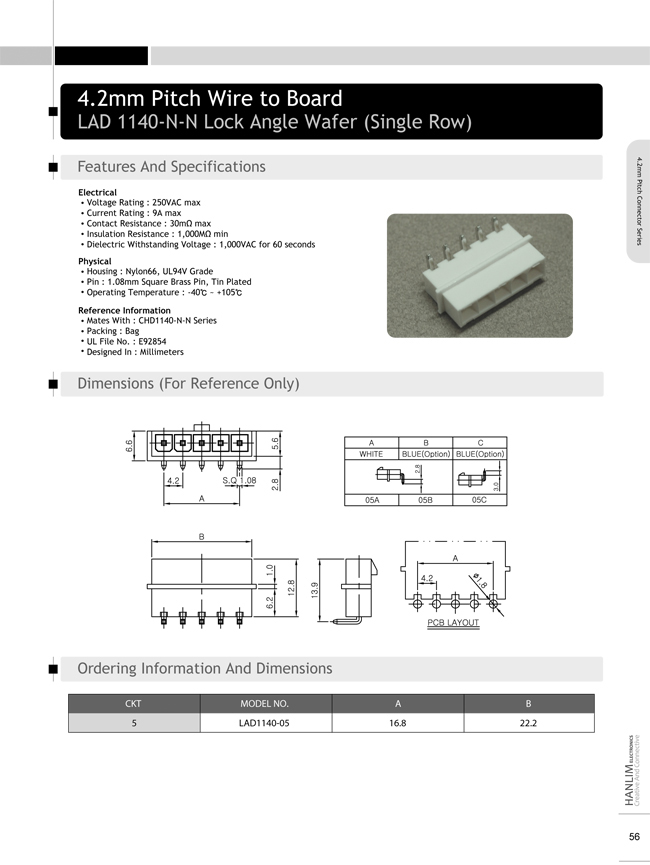
DOC/05_정비_매뉴얼/IPC/IPC_기타/8.LAD1140-05.jpg
