JDSCS-Club/DENVER_CCP/DOC/05_정비_매뉴얼/IPC/IPC_기타/11.BNC3124.jpg

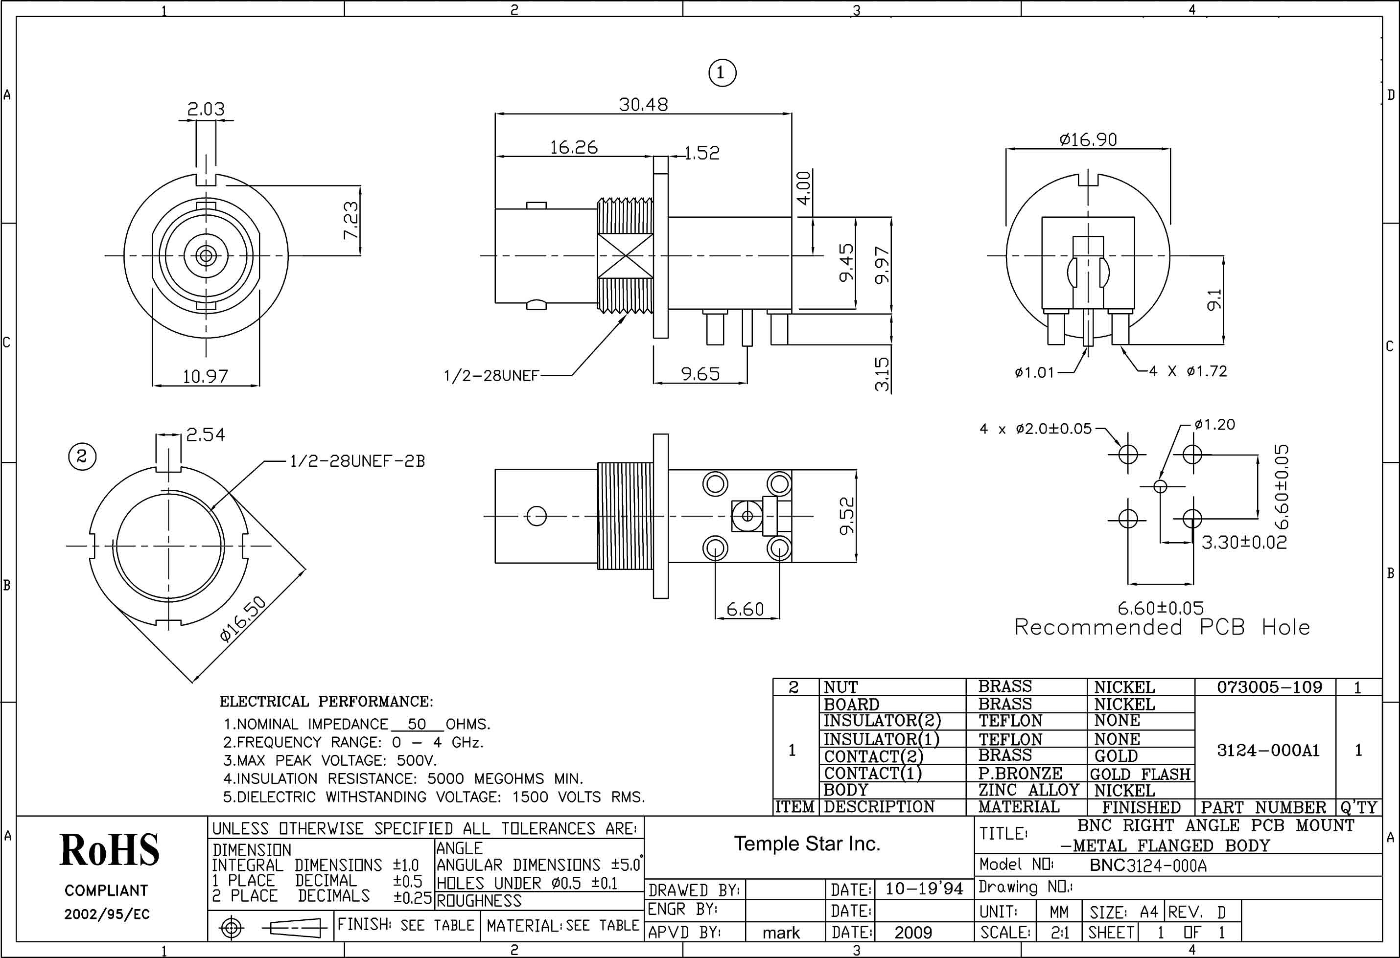
DOC/05_정비_매뉴얼/IPC/IPC_기타/11.BNC3124.jpg
