JDSCS-Club/DENVER_CCP/DOC/05_정비_매뉴얼/IPC/IPC_기타/45.ITS-1163.jpg

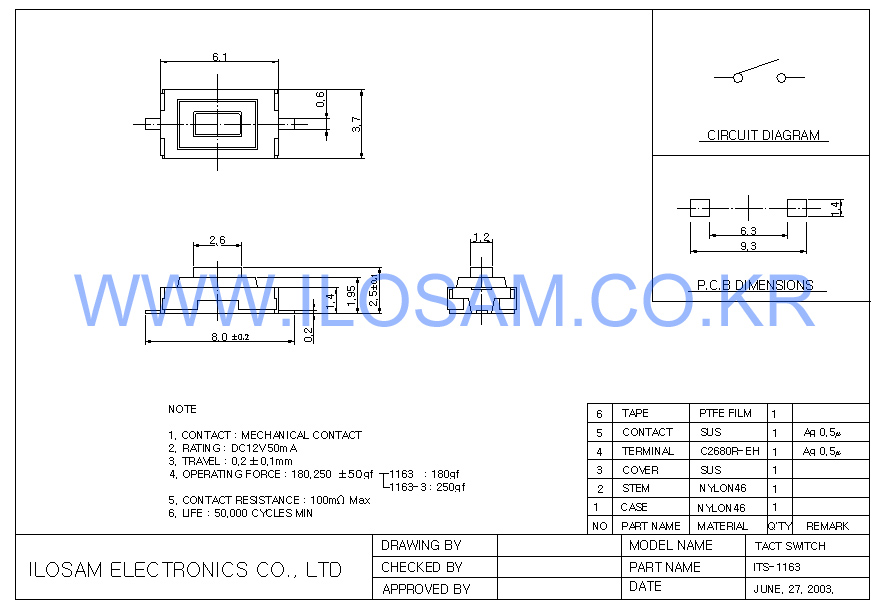
DOC/05_정비_매뉴얼/IPC/IPC_기타/45.ITS-1163.jpg
