JDSCS-Club/DENVER_CCP/DOC/05_정비_매뉴얼/RMM_HMM/CRA FAN ASSY IPC_20180625.PNG

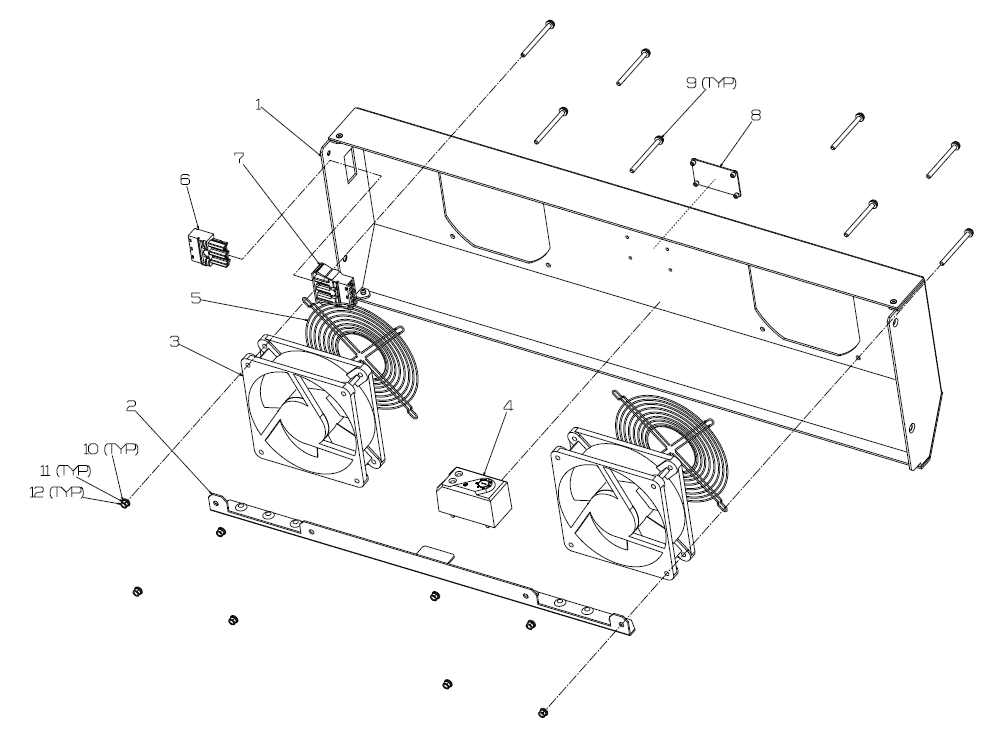
DOC/05_정비_매뉴얼/RMM_HMM/CRA FAN ASSY IPC_20180625.PNG
