JDSCS-Club/DENVER_CCP/DOC/05_정비_매뉴얼/RMM_HMM/DENVER 이미지_20180524.PNG

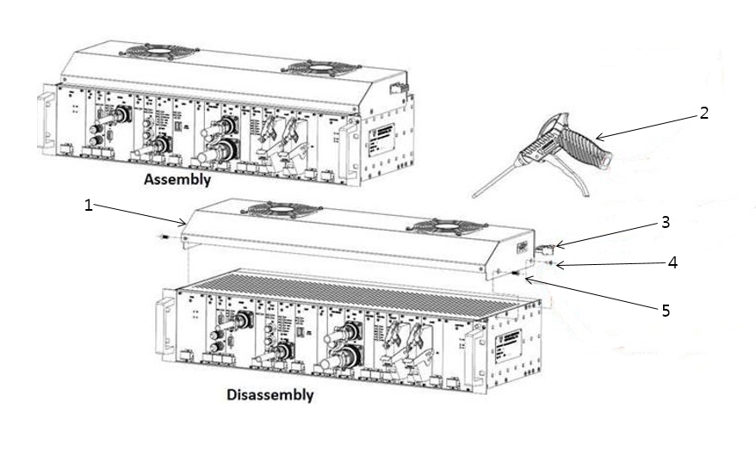
DOC/05_정비_매뉴얼/RMM_HMM/DENVER 이미지_20180524.PNG
