JDSCS-Club/DENVER_CCP/DOC/05_정비_매뉴얼/RMM_HMM/스크린샷 2018-04-20 오전 9.33.16.png

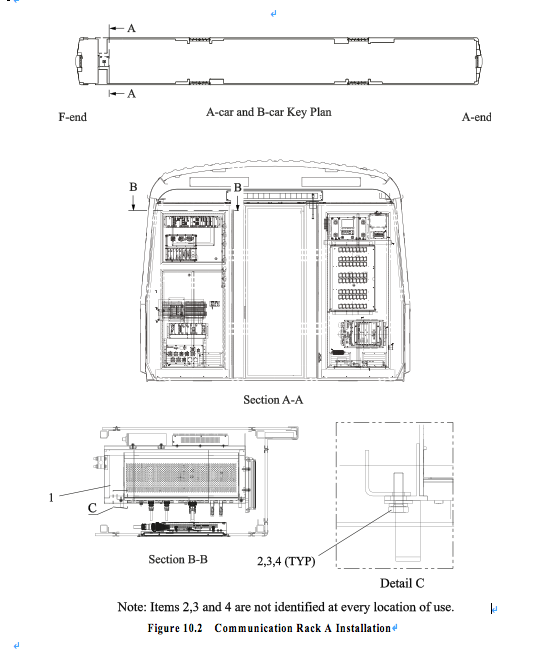
DOC/05_정비_매뉴얼/RMM_HMM/스크린샷 2018-04-20 오전 9.33.16.png
