JDSCS-Club/DENVER_CCP/DOC/06_이슈_대응/CCP_통신/02_회로도_데이터시트/74LS123_캡처3.PNG

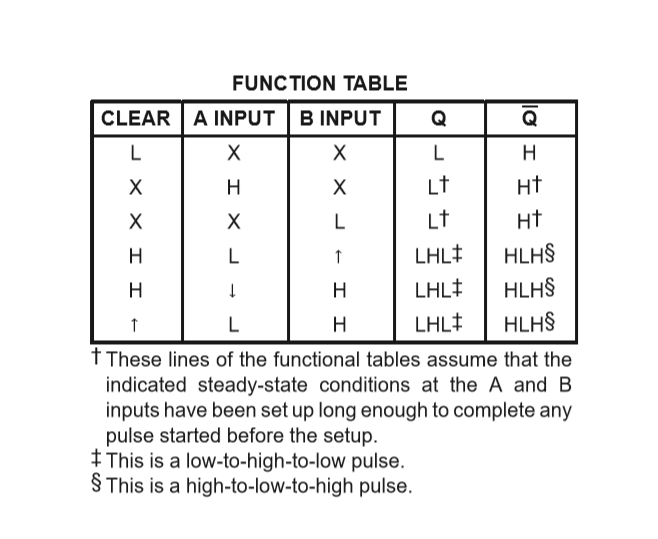
DOC/06_이슈_대응/CCP_통신/02_회로도_데이터시트/74LS123_캡처3.PNG
