JDSCS-Club/DENVER_CCP/DOC/06_이슈_대응/CCP_통신/03_사진_동영상/IMG_6256.JPG

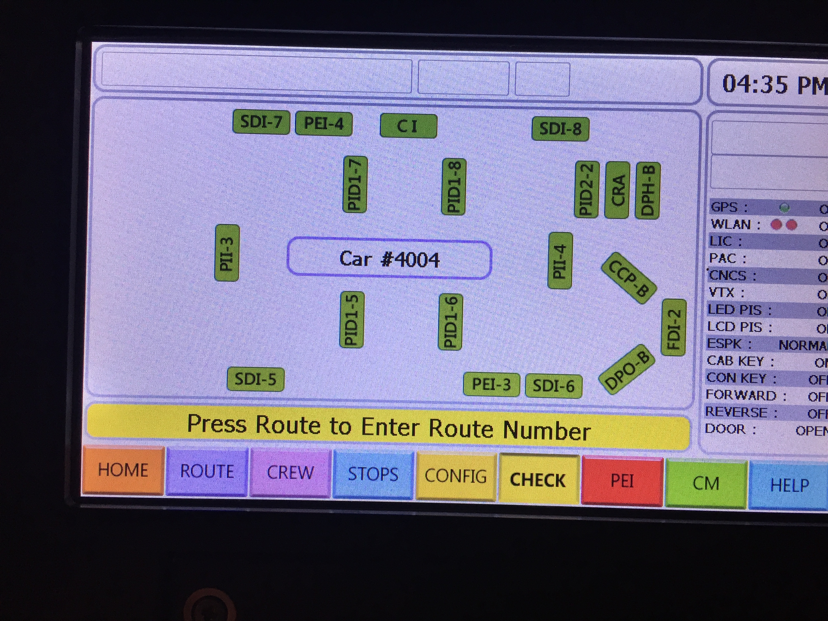
DOC/06_이슈_대응/CCP_통신/03_사진_동영상/IMG_6256.JPG
