JDSCS-Club/DENVER_CCP/DOC/06_이슈_대응/CNCS_발열/05_사진_동영상/IMG_6443.JPG

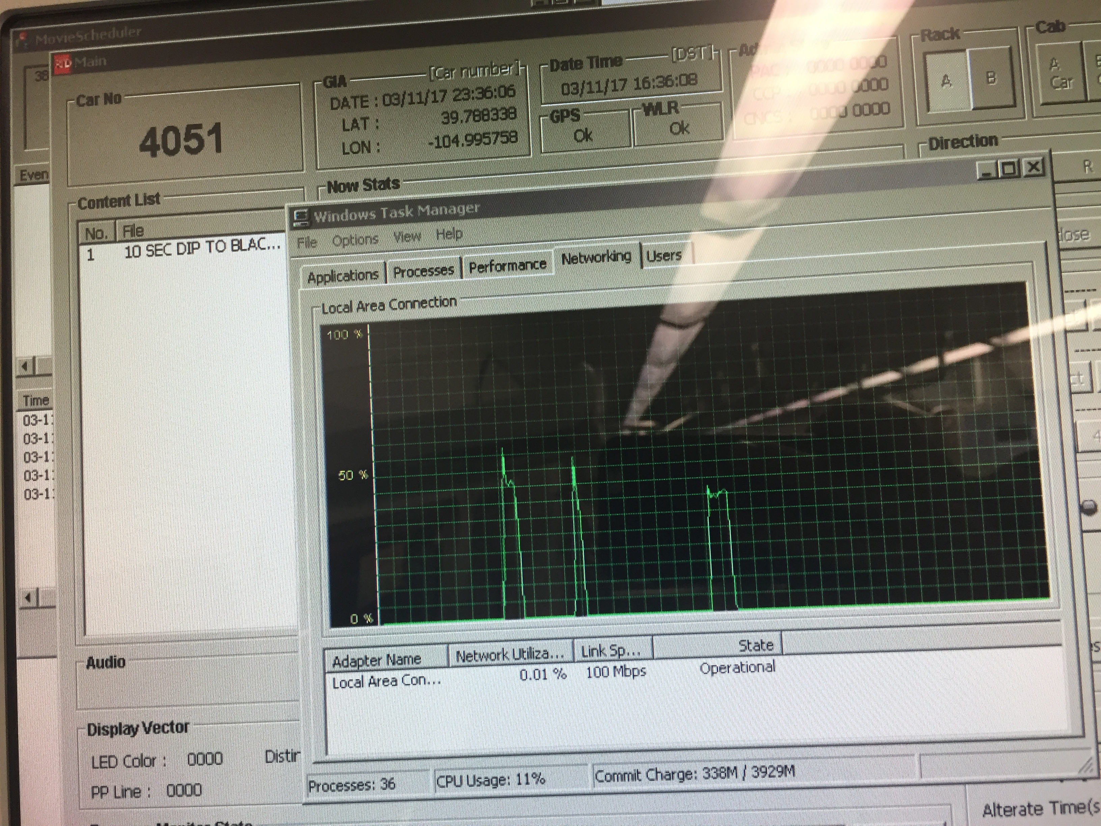
DOC/06_이슈_대응/CNCS_발열/05_사진_동영상/IMG_6443.JPG
