JDSCS-Club/DENVER_CCP/DOC/06_이슈_대응/CNCS_발열/05_사진_동영상/스크린샷 2017-07-26 00.22.52.png

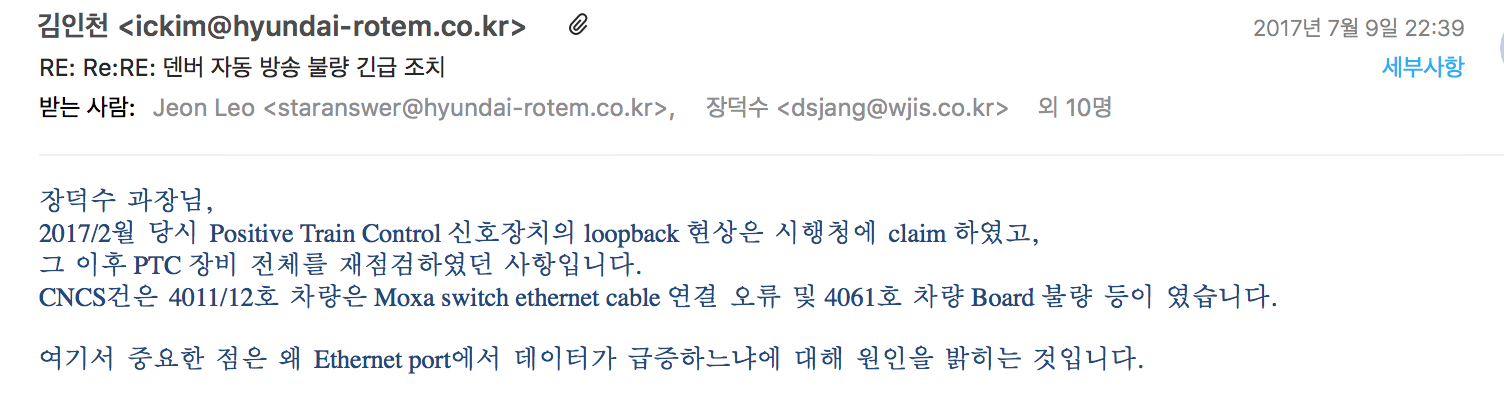
DOC/06_이슈_대응/CNCS_발열/05_사진_동영상/스크린샷 2017-07-26 00.22.52.png
