JDSCS-Club/DENVER_CCP/DOC/06_이슈_대응/CNCS_발열/05_사진_동영상/써멀 구리스.jpeg

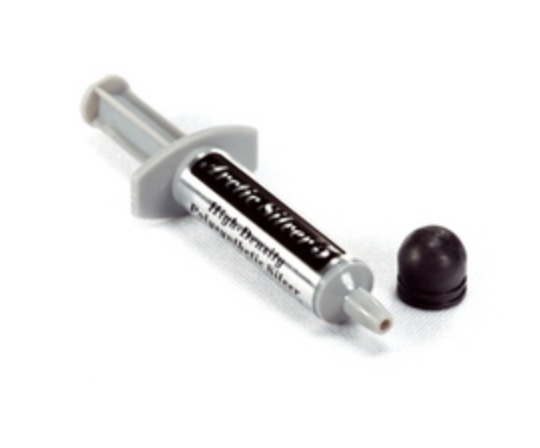
DOC/06_이슈_대응/CNCS_발열/05_사진_동영상/써멀 구리스.jpeg
