JDSCS-Club/DENVER_CCP/DOC/06_이슈_대응/FMI/IC 업체 회신.PNG

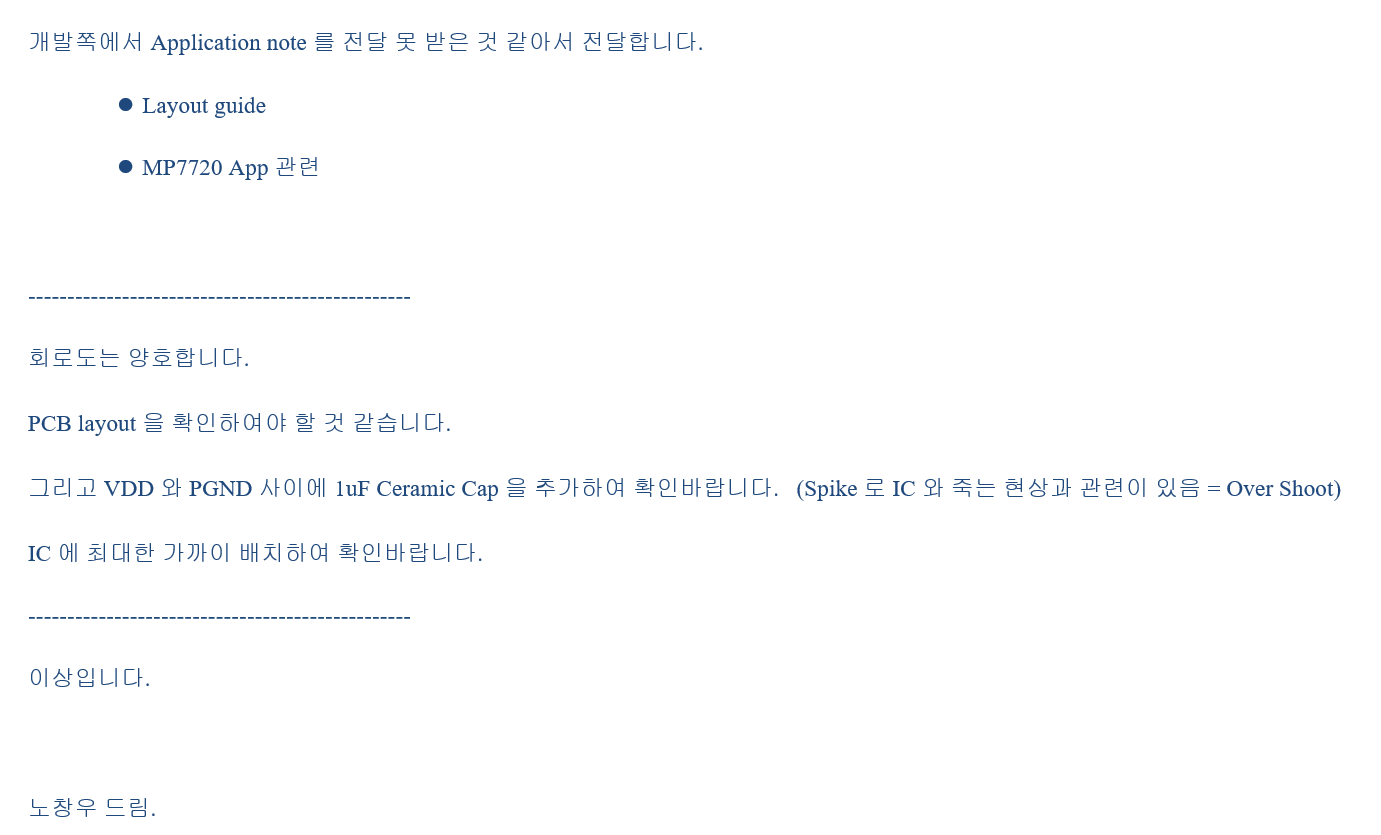
DOC/06_이슈_대응/FMI/IC 업체 회신.PNG
