JDSCS-Club/DENVER_CCP/DOC/06_이슈_대응/FMI/IMG_3931.JPG

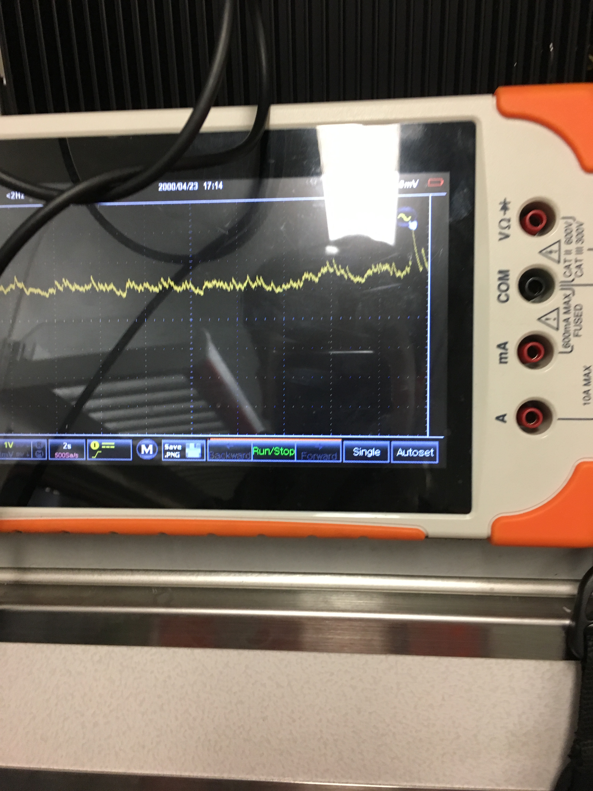
DOC/06_이슈_대응/FMI/IMG_3931.JPG
