JDSCS-Club/DENVER_CCP/DOC/06_이슈_대응/FMI/voip 부팅 화면 1.PNG

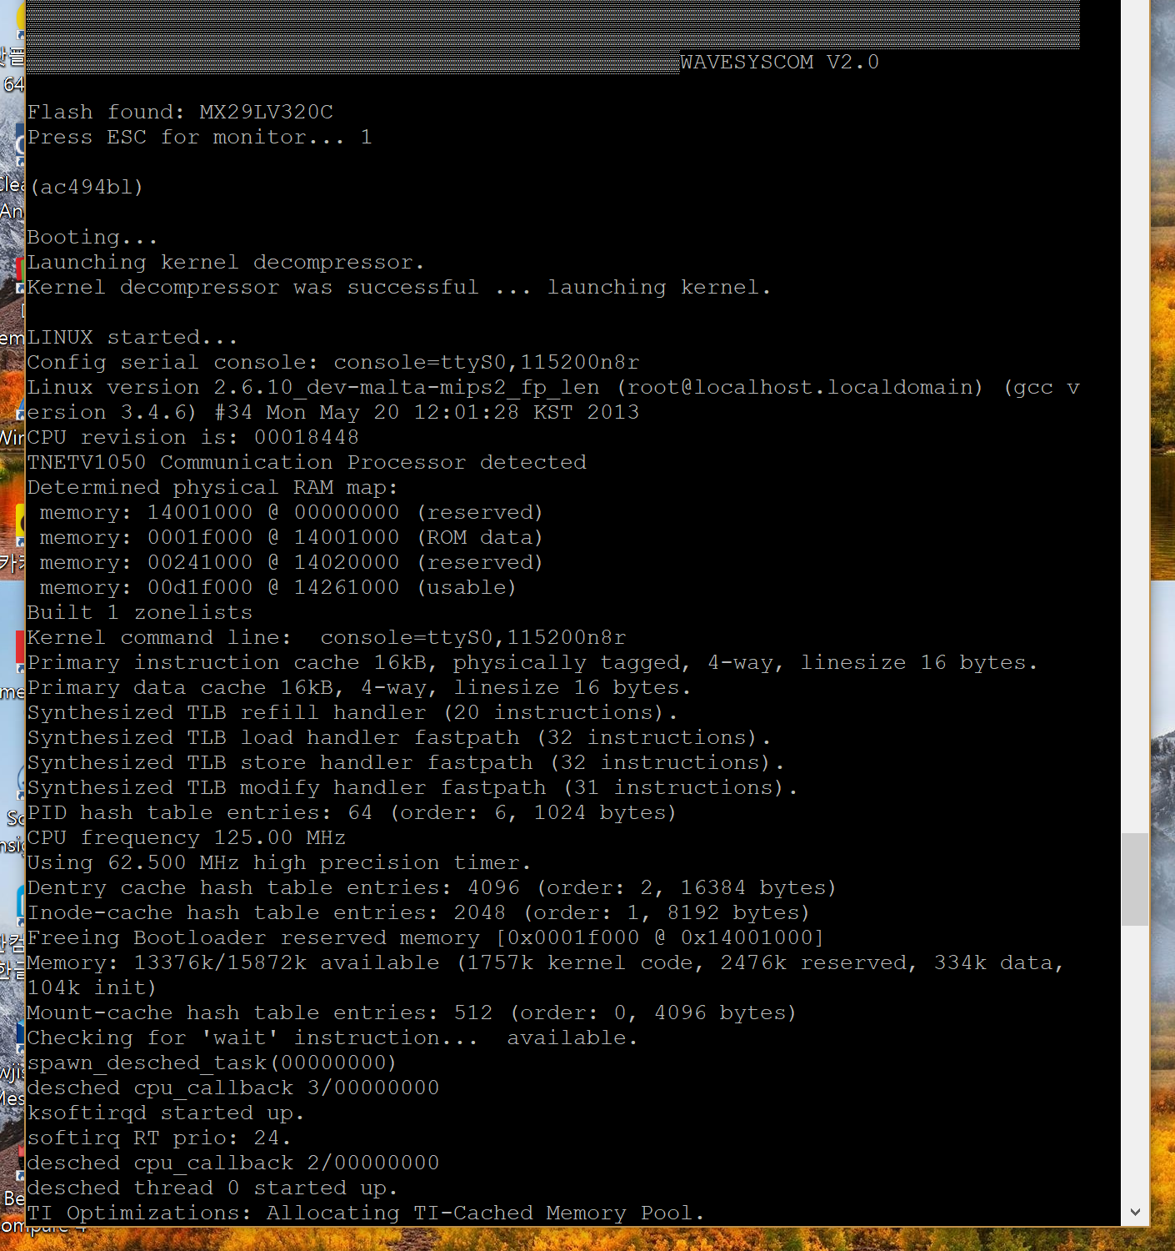
DOC/06_이슈_대응/FMI/voip 부팅 화면 1.PNG
