JDSCS-Club/DENVER_CCP/DOC/06_이슈_대응/PID_불량/02_영상신호_측정/VideoSignal at X6 of CRA on 4061A_01.PNG

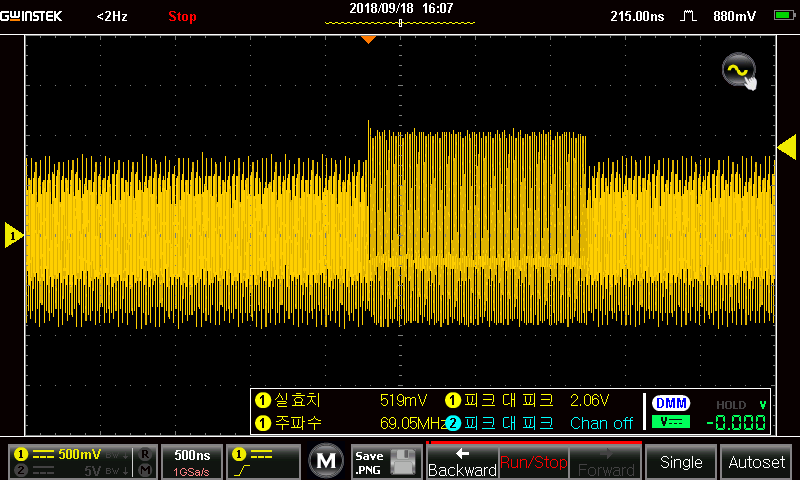
DOC/06_이슈_대응/PID_불량/02_영상신호_측정/VideoSignal at X6 of CRA on 4061A_01.PNG
