JDSCS-Club/DENVER_CCP/DOC/06_이슈_대응/PID_불량/03_오실로스코프_캡처/DS0004.PNG

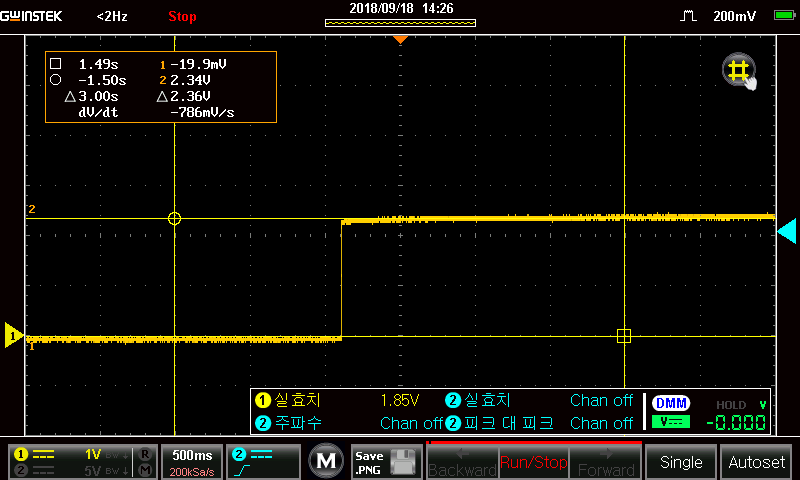
DOC/06_이슈_대응/PID_불량/03_오실로스코프_캡처/DS0004.PNG
