JDSCS-Club/DENVER_CCP/DOC/06_이슈_대응/RS485_통신/04_스크린샷/스크린샷 2018-02-21 오후 10.03.00.png

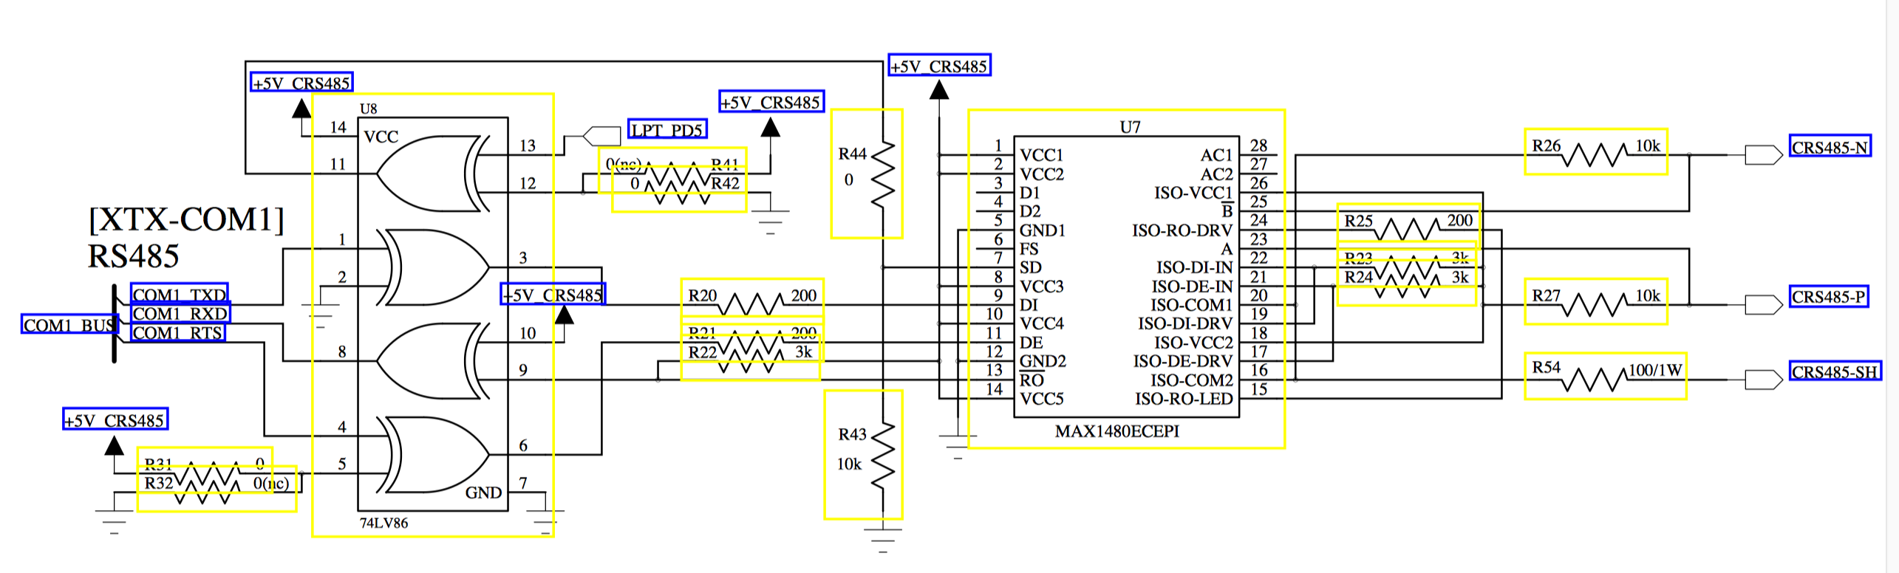
DOC/06_이슈_대응/RS485_통신/04_스크린샷/스크린샷 2018-02-21 오후 10.03.00.png
