JDSCS-Club/DENVER_CCP/DOC/06_이슈_대응/기타_문서/02_VoIP_관련/x-lite set.gif

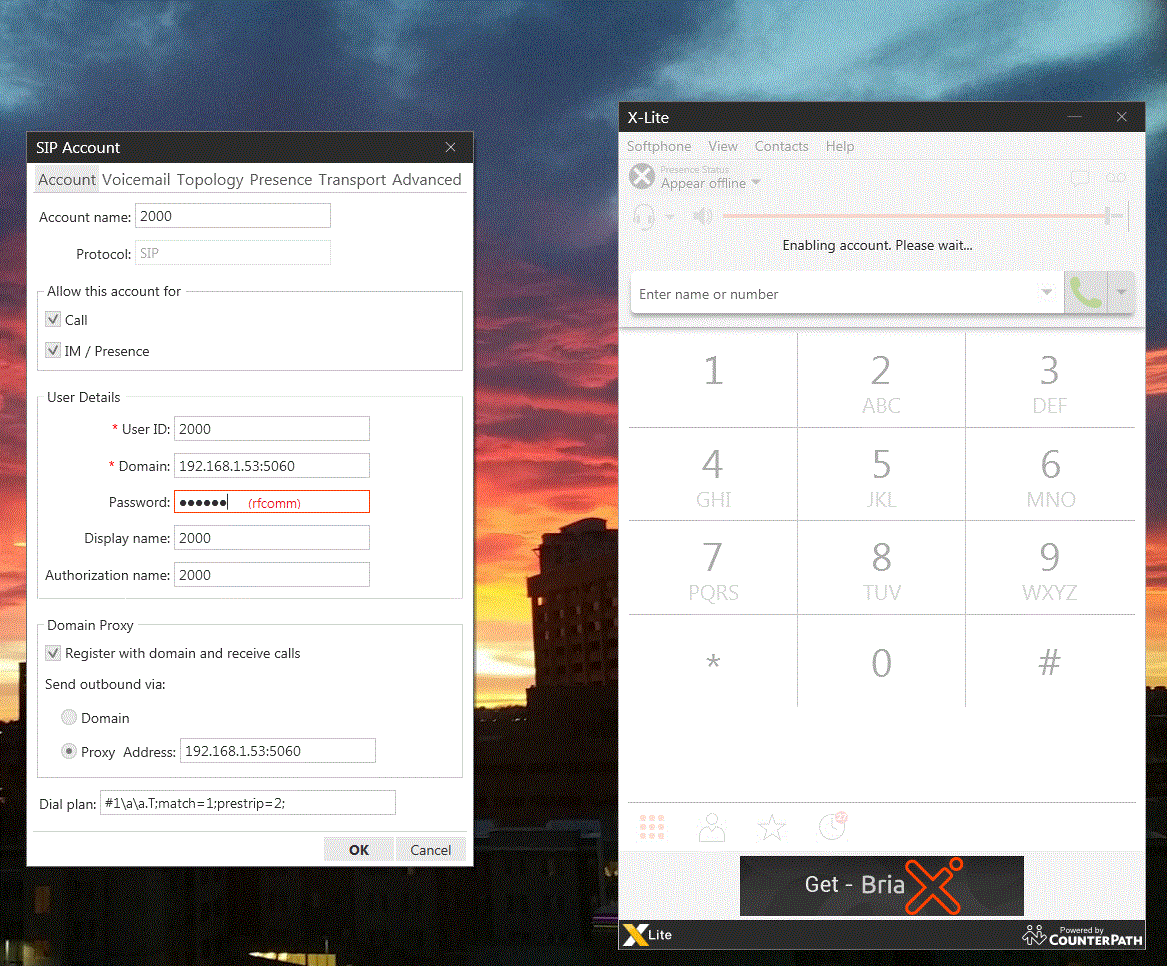
DOC/06_이슈_대응/기타_문서/02_VoIP_관련/x-lite set.gif
