JDSCS-Club/DENVER_CCP/DOC/06_이슈_대응/기타_문서/06_사진_동영상/20180305_100800.jpg

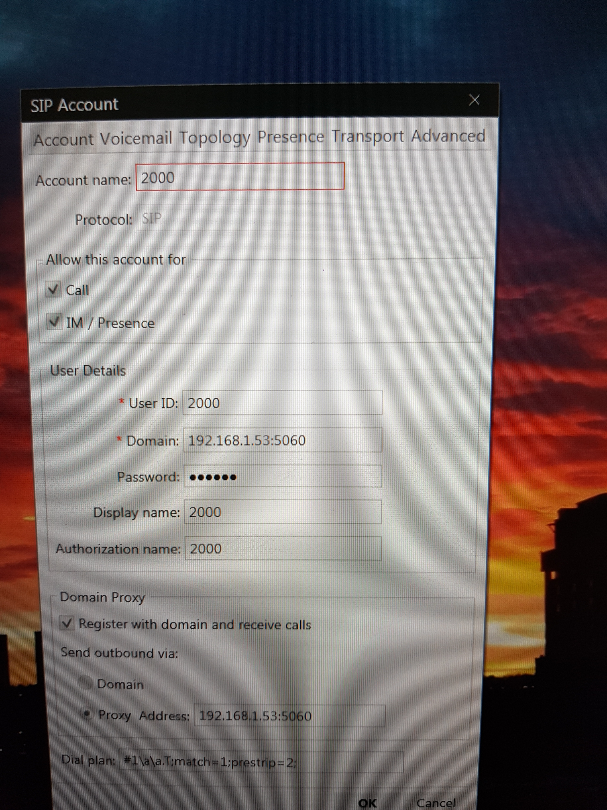
DOC/06_이슈_대응/기타_문서/06_사진_동영상/20180305_100800.jpg
