JDSCS-Club/DENVER_CCP/DOC/06_이슈_대응/자동방송_불량/06_사진_동영상/IMG_5081.jpg

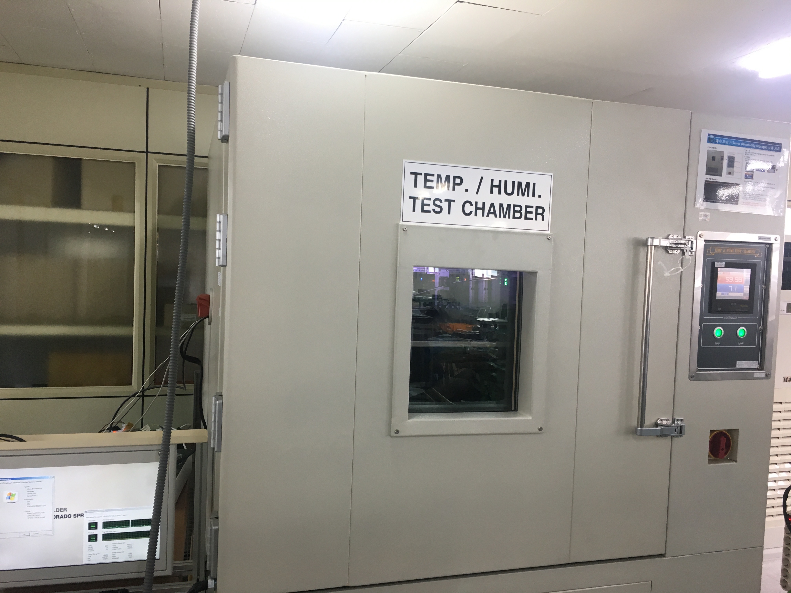
DOC/06_이슈_대응/자동방송_불량/06_사진_동영상/IMG_5081.jpg
