JDSCS-Club/DENVER_CCP/DOC/06_이슈_대응/자동방송_불량/06_사진_동영상/스크린샷 2017-07-09 20.33.39.png

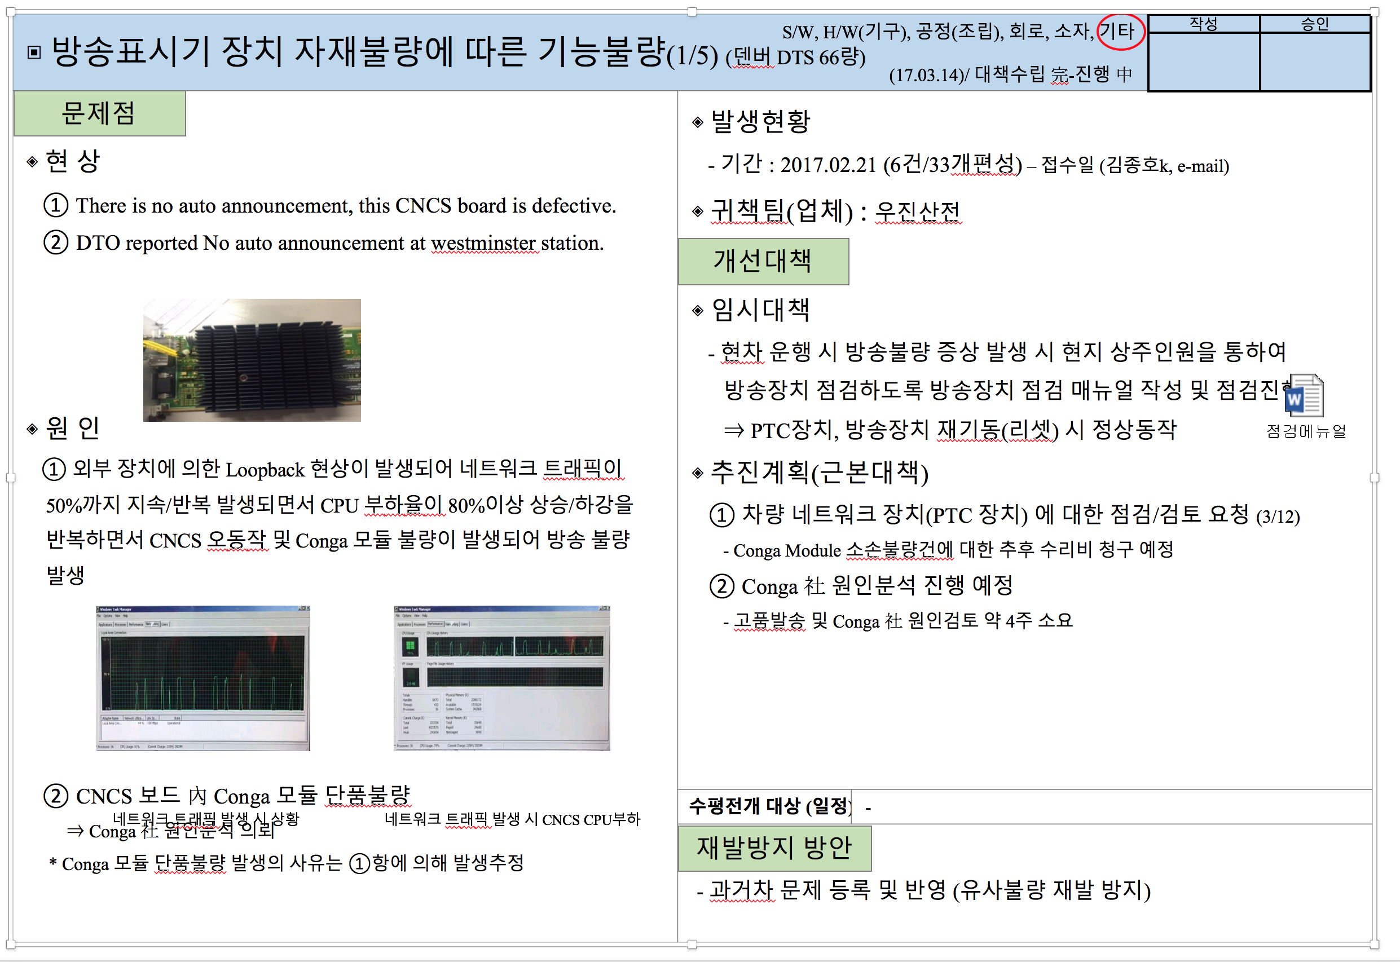
DOC/06_이슈_대응/자동방송_불량/06_사진_동영상/스크린샷 2017-07-09 20.33.39.png
