JDSCS-Club/DENVER_CCP/DOC/09_발표_보고/09_기타/Drawing1.jpg

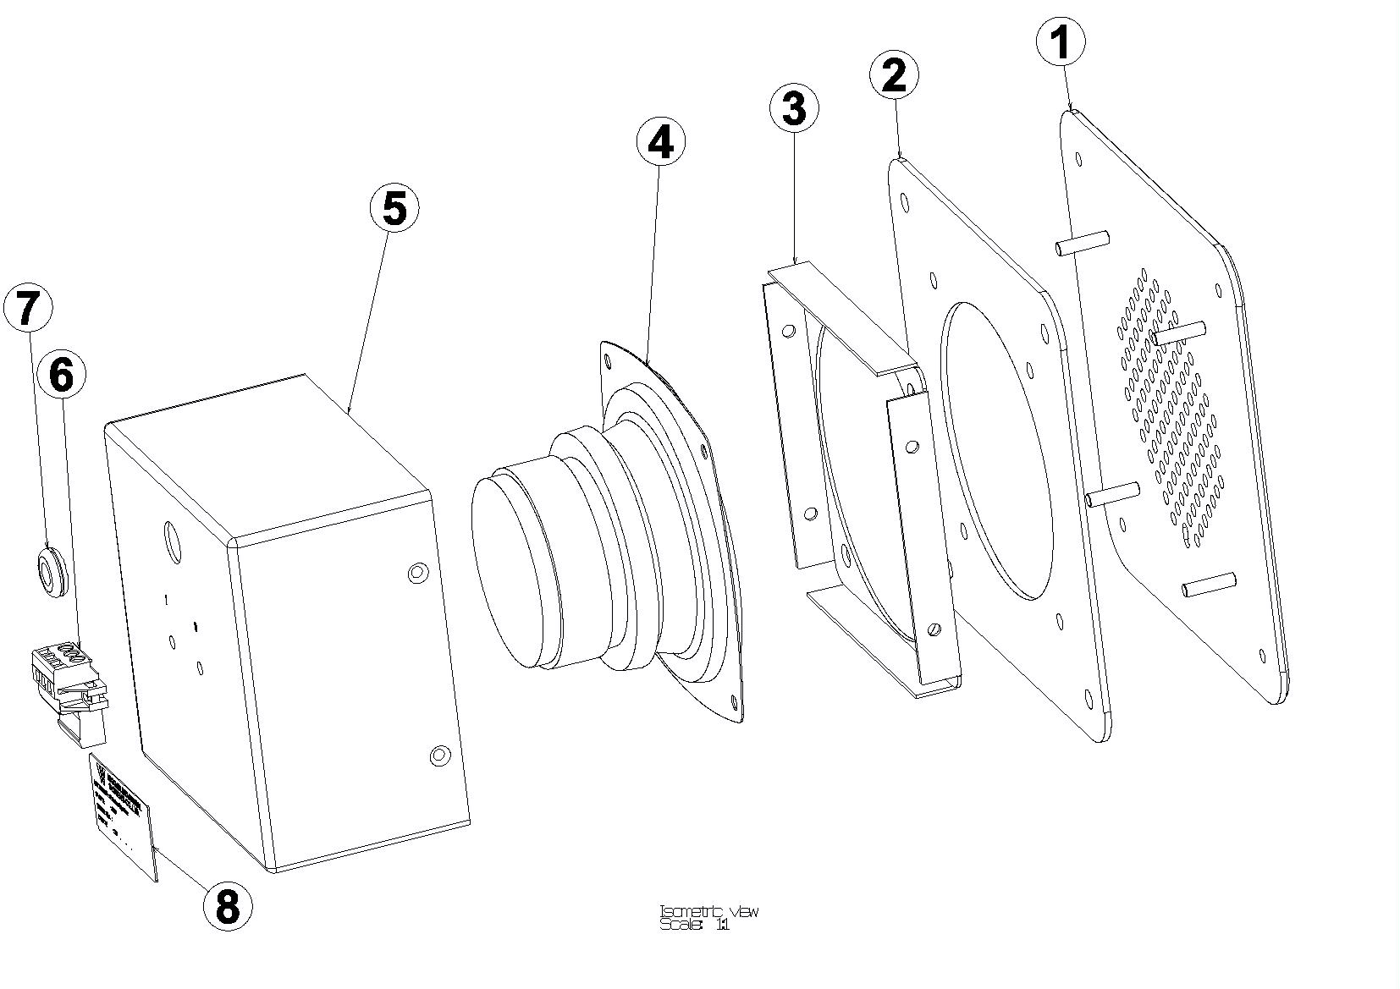
DOC/09_발표_보고/09_기타/Drawing1.jpg
