JDSCS-Club/DENVER_CCP/DOC/11_SW코드/2012_06_04(케나다 출장 완료)/LonScanner_Data/20170321/CRA_MA.JPG

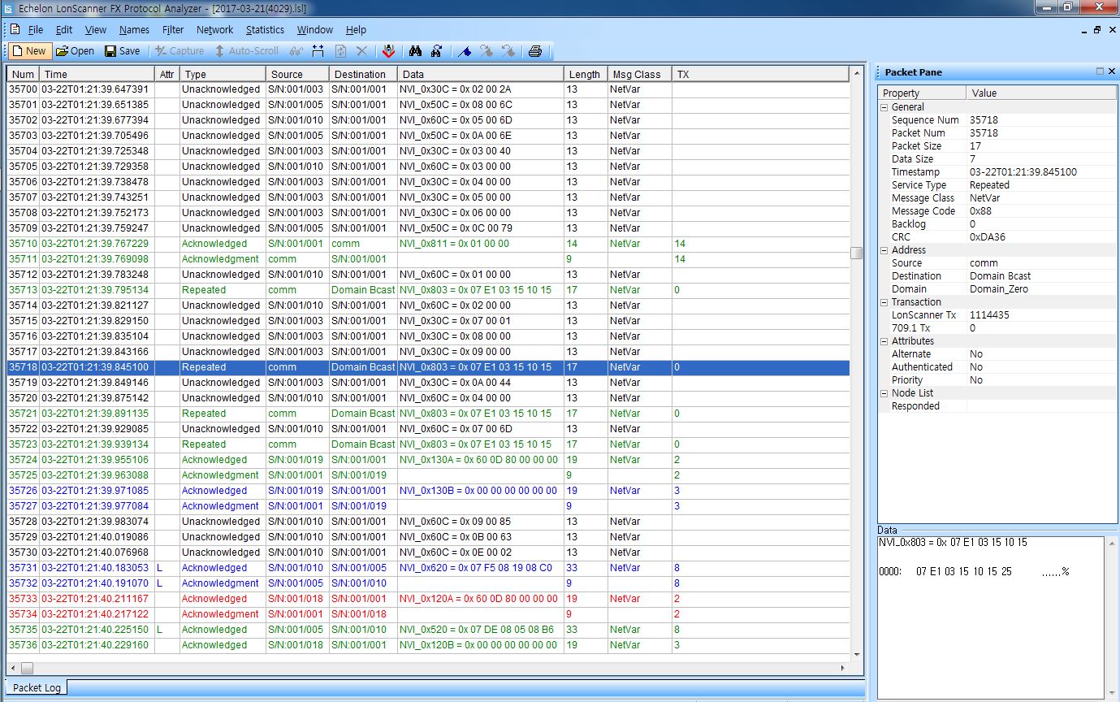
DOC/11_SW코드/2012_06_04(케나다 출장 완료)/LonScanner_Data/20170321/CRA_MA.JPG
