JDSCS-Club/DENVER_CCP/DOC/11_SW코드/lic/LON_Works/참고자료_소스/(특수법인)한국전파진흥협회_통장사본.jpg

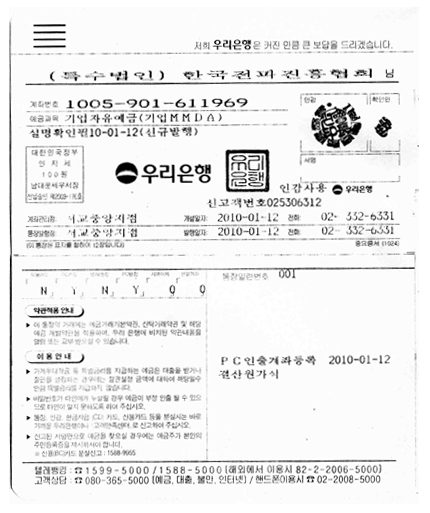
DOC/11_SW코드/lic/LON_Works/참고자료_소스/(특수법인)한국전파진흥협회_통장사본.jpg
