JDSCS-Club/DENVER_CCP/W_USA자료/DTO PSA Parts List 102919.xlsx

DTO Woojin Parts Supply Agreement Quantities Worksheet
Parts |  | WISK PART NUMBER | Part Number / Drawing Number | In-Service |  |  |  |  |  |  |  |  |  | Unit Price (USD)
 |  |  |  | MA | MB | MP | 2016 | 2017 | 2018 | 2019 | Total | Qty/Yr | Tot. Qty
CONTROLS
Communication Rack A |  |  | R1D1473-25838 | 33 | 33 | 66 | 0 | 0 | 0 | 0 | 0 | 0 | 0 | $50878.33333
 | Comm Rack Enclosure |  | R1D00287 | 33 | 33 | 66 | 0 | 0 | 0 | 0 | 0 | 0 | 0 | $0
 | Backplane Board |  | R1D001044 | 33 | 33 | 66 | 0 | 1 | 0 | 0 | 1 | 0 | 0 | $0
 | Power Supply ASSY |  | R1D000283 | 33 | 33 | 66 | 0 | 0 | 0 | 0 | 0 | 0 | 0 | $0
 | Signal Control Board |  | R1D000292 | 33 | 33 | 66 | 0 | 0 | 0 | 0 | 0 | 0 | 0 | $0
 | LonWorks Int. Card |  | R1D000262 | 33 | 33 | 66 | 0 | 1 | 1 | 0 | 2 | 0 | 0 | $0
 | Wireless LAN Router |  | R1D000308 | 33 | 33 | 66 | 0 | 0 | 0 | 0 | 0 | 0 | 0 | $0
 | Video TX Board |  | R1D000304 | 33 | 33 | 66 | 0 | 0 | 0 | 0 | 0 | 0 | 0 | $0
 | Hard Disk Drive Board |  | R1D000258 | 33 | 33 | 66 | 0 | 1 | 4 | 7 | 12 | 5 | 25 | $0
 | Content & Control Server |  | R1D000253 | 33 | 33 | 66 | 6 | 3 | 1 | 4 | 14 | 6 | 30 | $0
 | PAC-INT |  | R1D000270 | 33 | 33 | 66 | 2 | 3 | 1 | 0 | 6 | 3 | 15 | $0
 | PAC-MCU |  | R1D000274 | 33 | 33 | 66 | 1 | 3 | 2 | 0 | 6 | 3 | 15 | $0
 | PAC-VOL |  | R1D000278 | 33 | 33 | 66 | 0 | 0 | 0 | 0 | 0 | 0 | 0 | $0
 | PAC-RS485 |  | R1D000266 | 33 | 33 | 66 | 0 | 2 | 1 | 0 | 3 | 3 | 15 | $0
 | AAB1 board |  | R1D000242 | 33 | 33 | 66 | 0 | 1 | 0 | 0 | 1 | 2 | 10 | $0
 | AAB2 board |  | R1D000245 | 33 | 33 | 66 | 0 | 0 | 0 | 0 | 0 | 0 | 0 | $0
 | AMP Power |  | R1D000249 | 33 | 33 | 66 | 1 | 2 | 2 | 2 | 7 | 3 | 15 | $0
 | AF Board |  | R1D000288 | 33 | 33 | 66 | 0 | 0 | 0 | 0 | 0 | 0 | 0 | $0
 | VOIP Board |  | R1D000300 | 33 | 33 | 66 | 0 | 2 | 0 | 0 | 2 | 2 | 10 | $0
Communication Control Panel |  |  | R1D000312 | 33 | 33 | 66 | 0 | 0 | 0 | 0 | 0 | 0 | 0 | $3343.433333
 | 7” Touchscreen + LCD |  | LMS700KF05 + MN070000ACD 7Inch WIDE | 33 | 33 | 66 | 0 | 0 | 0 | 0 | 0 | 0 | 0 | $0
 | CCP Power Supply Board |  | R1D000316 | 33 | 33 | 66 | 0 | 0 | 1 | 0 | 1 | 0 | 0 | $0
 | CCP Control Board |  | R1D000313 | 33 | 33 | 66 | 0 | 4 | 4 | 0 | 8 | 4 | 20 | $0
LED SIGNS
Front Destination Indicator |  |  | R1B000015 | 33 | 33 | 66 | 0 | 0 | 0 | 0 | 0 | 0 | 0 | $3721.386667
Side Destination Indicator |  |  | R1B000019 | 132 | 132 | 264 | 0 | 0 | 0 | 0 | 0 | 0 | 0 | $3689.406
Passenger Information Indicator |  |  | R1B000024 | 66 | 66 | 132 | 0 | 0 | 0 | 0 | 0 | 0 | 0 | $4785.470667
 | FDI/SDI Power Supply Board |  | R1D000325 | 165 | 165 | 330 | 0 | 0 | 0 | 1 | 1 | 0 | 0 | $0
 | PII Power Supply Board |  | R1D000350 | 66 | 66 | 132 | 0 | 0 | 0 | 0 | 0 | 0 | 0 | $0
 | FDI/SDI Amber LED Module |  | R1D000320 |  |  |  | 0 | 2 | 0 | 0 | 2 | 2 | 10 | $0
 | RGB LED Module |  | R1D000332 |  |  |  | 0 | 0 | 0 | 0 | 0 | 0 | 0 | $0
 | PII Amber LED Module |  | R1D000348 |  |  |  | 0 | 0 | 0 | 0 | 0 | 0 | 0 | $0
 | FDI/SDI Light Sensor |  | R1D000326 | 165 | 165 | 330 | 0 | 0 | 0 | 0 | 0 | 0 | 0 | $0
 | LED Control Board |  | R1D000324 | 231 | 231 | 462 | 0 | 0 | 0 | 2 | 2 | 2 | 10 | $0
LCD DISPLAY & AUDIO
Passenger Information Display 1 |  |  | R1C000038 | 132 | 132 | 264 | 0 | 0 | 0 | 0 | 0 | 0 | 0 | $4794.192667
Passenger Information Display 2 |  |  | R1C000042 | 33 | 33 | 66 | 0 | 0 | 0 | 0 | 0 | 0 | 0 | $6316.181667
 | PID1 Enclosure |  |  | 165 | 165 | 330 | 0 | 0 | 0 | 0 | 0 | 0 | 0 | $0
 | PID2 Enclosure |  |  | 165 | 165 | 330 | 0 | 0 | 0 | 0 | 0 | 0 | 0 | $0
 | PID Power Supply |  | R1D000337 | 165 | 165 | 330 | 2 | 4 | 10 | 6 | 22 | 5 | 25 | $0
 | VRX Board |  | R1D000338 | 165 | 165 | 330 | 0 | 4 | 1 | 6 | 11 | 3 | 15 | $0
 | 19” LCD Panel + Inverter |  | LTM190BT03 + GH317A | 165 | 165 | 330 | 0 | 0 | 0 | 0 | 0 | 0 | 0 | $0
Cab Speaker |  |  | R1D000412 | 33 | 33 | 66 | 0 | 0 | 0 | 0 | 0 | 0 | 0 | $465.1733333
Interior Speaker |  |  | R1D000399 | 264 | 264 | 528 | 0 | 1 | 1 | 0 | 2 | 2 | 10 | $581.4666667
Exterior Speaker |  |  | R1D000400 | 132 | 132 | 264 | 0 | 1 | 2 | 1 | 4 | 2 | 10 | $436.1
Transformer (Ext. Speaker) |  |  | R1D000416 | 66 | 66 | 132 | 0 | 0 | 0 | 0 | 0 | 0 | 0 | $577.1056667
Jumper Plug and Receptacle ASSY |  |  |  | 33 | - | 33 | 0 | 0 | 0 | 0 | 0 | 0 | 0 | $766.0823333
 | Jumper Plug |  |  | 33 | - | 33 | 0 | 0 | 0 | 0 | 0 | 0 | 0 | $0
 | Receptacle |  |  | 33 | 33 | 66 | 0 | 0 | 0 | 0 | 0 | 0 | 0 | $0
INTERCOMS
Driver PA Operation Box |  |  | R1C000049 | 33 | 33 | 66 | 1 | 1 | 1 | 0 | 3 | 2 | 10 | $4724.416667
 | DPO Power Board |  | R1D000375 | 33 | 33 | 66 | 0 | 0 | 0 | 0 | 0 | 0 | 0 | $0
 | DPO Control Board |  | R1D000372_a | 33 | 33 | 66 | 0 | 7 | 4 | 2 | 13 | 5 | 25 | $0
Driver PA Handheld Box |  |  |  | 33 | 33 | 66 | 0 | 0 | 0 | 0 | 0 | 0 | 0 | $4052.822667
 | DPH Power Board |  |  | 33 | 33 | 66 | 0 | 0 | 0 | 0 | 0 | 0 | 0 | $0
 | DPH Control Board |  |  | 33 | 33 | 66 | 0 | 0 | 0 | 0 | 0 | 0 | 0 | $0
Passenger Emergency Intercom |  |  | R1D000468 | 66 | 66 | 132 | 0 | 0 | 0 | 0 | 0 | 0 | 0 | $5596.616667
 | PEI Power Board |  | R1D000389 | 66 | 66 | 132 | 0 | 0 | 0 | 1 | 1 | 2 | 10 | $0
 | PEI Control Board |  | R1D000386_a | 66 | 66 | 132 | 4 | 1 | 2 | 6 | 13 | 5 | 25 | $0
Microphones
Driver Microphone Assembly |  |  | R1D1473-25863_11~13 | 33 | 33 | 66 | 0 | 0 | 0 | 0 | 0 | 0 | 0 | $901.2733333
 | Gooseneck Mic |  |  | 33 | 33 | 66 | 0 | 0 | 1 | 1 | 2 | 2 | 10 | $0
 | Pushbutton |  |  | 33 | 33 | 66 | 0 | 0 | 0 | 2 | 2 | 2 | 10 | $0
ANSM |  |  | AOM-4544P-2R | 66 | 66 | 132 | 0 | 0 | 0 | 0 | 0 | 0 | 0 | $905.6343333
