JDSCS-Club/DENVER_CCP/W_USA자료/SEPTA SLV PSA Parts List.xlsx

Sheet: Sheet1
 | SPARE PARTS SOLD FOR SEPTA SL PROJECT UP 2014 TO 2/2019
 |  |  |  | Globe Connect |  |  |  |  | Qual Tran |  |  |  |  | Roraima |  |  |  |  | SEPTA
 | Item # | Description | COGS | Quoted Date | Date | Qty | Unit Price | Amount | Quoted Date | Date | Qty | Unit Price | Amount | Quoted Date | Date | Qty | Unit Price | Amount | Quoted Date | Date | Qty | Unit Price | Amount
1 | LTM190BT03 | PID 1&2 TFT LCD Panel | 240.00 |  |  |  |  |  |  |  |  |  |  |  |  |  |  |  | 2019-03-21 | 2019-04-03 | 10 | 572.90 | 5729.00 | informal quote via email
2 | LMS700KF06 | TFT - LCD unit touch screen part number LMS700KF05 for AVS/AVL Terminal | 0.00 |  |  |  |  |  |  |  |  |  |  |  |  |  |  |  |  | 2016-09-14 | 1 | 331.00 | 331.00 | one piece for sample testing
 |  |  | 191.00 |  |  |  |  |  |  |  |  |  |  |  |  |  |  |  | 2017-02-03 | 2017-03-20 | 7 | 423.25 | 2962.75
 |  |  | 191.00 |  |  |  |  |  |  |  |  |  |  |  |  |  |  |  | 2017-03-27 | 2017-06-15 | 25 | 423.25 | 10581.25
 |  |  | 220.00 |  |  |  |  |  | 2018-10-04 | 2018-12-13 | 25 | 503.81 | 12595.25
 |  |  | 220.00 |  |  |  |  |  |  |  |  |  |  |  |  |  |  |  | 2019-03-21 | 2019-04-01 | 10 | 532.00 | 5320.00 | open PO
3 | R1D1355-21525 | Communication System: Speaker Exterior SL V | 250.00 |  |  |  |  |  |  |  |  |  |  |  |  |  |  |  | 2013-12-16 | 2014-03-12 | 20 | 300.00 | 6000.00
 |  |  | 200.00 |  |  |  |  |  |  |  |  |  |  |  |  |  |  |  |  | 2015-07-14 | 6 | 435.00 | 2610.00
 |  |  | 225.00 |  |  |  |  |  | 2016-05-24 | 2016-09-12 | 8 | 580.00 | 4640.00
 |  |  | 225.00 |  |  |  |  |  | 2016-11-29 | 2017-01-13 | 8 | 580.00 | 4640.00
 |  |  | 170.00 |  |  |  |  |  |  |  |  |  |  |  |  |  |  |  | 2019-03-11 | 2019-03-15 | 5 | 555.34 | 2776.70 | open PO
4 | R1D1355-21526 | Jumper Plug and Receptacle Assy | 2120.00 | 2017-02-07 | 2017-04-27 | 10 | 3200.00 | 32000.00
5 | R1D1355-21528 | LED Front Destination Indicator | 3285.00 |  |  |  |  |  |  |  |  |  |  |  |  |  |  |  | 2018-02-26 | 2018-09-10 | 10 | 5376.80 | 53768.00
6 | R1D1355-21529 | LED Passenger Information Indicator | 2936.00 |  |  |  |  |  |  |  |  |  |  |  |  |  |  |  | 2017-12-18 | 2018-07-12 | 5 | 4992.94 | 24964.70
 |  |  | 2747.00 |  |  |  |  |  |  |  |  |  |  |  |  |  |  |  | 2018-11-29 | 2018-12-18 | 5 | 4992.94 | 24964.70 | open PO
7 | R1D1355-21530 | Exterior Side Destination Right Hand | 3072.30 |  |  |  |  |  |  |  |  |  |  |  |  |  |  |  | 2018-01-26 | 2018-07-31 | 3 | 5116.36 | 15349.08
8 | R1D1355-21552 | AVS/AVL Terminal 7" TFT Touch (CCP) | 2847.00 |  |  |  |  |  |  |  |  |  |  |  |  |  |  |  | 2015-12-09 | 2016-07-06 | 5 | 3913.00 | 19565.00
 |  |  | 2847.00 |  |  |  |  |  |  |  |  |  |  |  |  |  |  |  | 3/20/2015 ? | 2015-11-23 | 6 | 3913.00 | 23478.00
 |  |  | 3141.00 |  |  |  |  |  | 2017-02-10 | 2017-08-18 | 5 | 3908.20 | 19541.00
 |  |  | 4000.00 |  |  |  |  |  |  |  |  |  |  |  |  |  |  |  | 2019-03-11 | 2019-01-09 | 5 | 5892.90 | 29464.50 | open PO rev requested from 4403.32
9 | R1D1355-21628 | PAC-VOL / PAC-RS485 FRONT PANEL | 36.00 |  |  |  |  |  |  |  |  |  |  |  |  |  |  |  | 2018-10-04 | 2018-12-21 | 25 | 61.27 | 1531.75
10 | R1D1355-21629 | AAB FRONT PANEL | 42.00 |  |  |  |  |  |  |  |  |  |  |  |  |  |  |  | 2018-10-04 | 2018-12-21 | 25 | 69.77 | 1744.25
11 | R1D1355-21801 | PSA FRONT PANEL | 34.00 |  |  |  |  |  |  |  |  |  |  |  |  |  |  |  | 2018-10-04 | 2018-12-21 | 25 | 58.43 | 1460.75
12 | R1D1355-21804 | SCB FRONT PANEL | 33.00 |  |  |  |  |  |  |  |  |  |  |  |  |  |  |  | 2018-10-04 | 2018-12-21 | 25 | 57.02 | 1425.50
13 | R1D1355-21807 | LIC FRONT PANEL | 35.00 |  |  |  |  |  |  |  |  |  |  |  |  |  |  |  | 2018-10-04 | 2018-12-21 | 25 | 59.85 | 1496.25
14 | R1D1355-21809 | WLR FRONT PANEL | 33.00 |  |  |  |  |  |  |  |  |  |  |  |  |  |  |  | 2018-10-04 | 2018-12-21 | 25 | 57.02 | 1425.50
15 | R1D1355-21811 | GIA FRONT PANEL | 33.00 |  |  |  |  |  |  |  |  |  |  |  |  |  |  |  | 2018-10-04 | 2018-12-21 | 25 | 57.02 | 1425.50
16 | R1D1355-21813 | VTX FRONT PANEL | 33.00 |  |  |  |  |  |  |  |  |  |  |  |  |  |  |  | 2018-10-04 | 2018-12-21 | 25 | 57.02 | 1425.50
17 | R1D1355-21815 | HDD FRONT PANEL | 29.00 |  |  |  |  |  |  |  |  |  |  |  |  |  |  |  | 2018-10-04 | 2018-12-21 | 25 | 51.35 | 1283.75
18 | R1D1355-21817 | CNCS FRONT PANEL | 35.00 |  |  |  |  |  |  |  |  |  |  |  |  |  |  |  | 2018-10-04 | 2018-12-21 | 25 | 59.85 | 1496.25
19 | R1D1355-21819 | PAC-INT FRONT PANEL | 29.00 |  |  |  |  |  |  |  |  |  |  |  |  |  |  |  | 2018-10-04 | 2018-12-21 | 25 | 51.35 | 1283.75
20 | R1D1355-21822 | PAC-MCU FRONT PANEL | 40.00 |  |  |  |  |  |  |  |  |  |  |  |  |  |  |  | 2018-10-04 | 2018-12-21 | 25 | 66.94 | 1673.50
21 | R1D1355-21927 | Signal Connection Board Woojin ESP01086-002 | 722.00 |  |  |  |  |  |  |  |  |  |  | 2017-07-25 | 2018-02-08 | 12 | 1222.00 | 14664.00
22 | R1D1355-21932 | PA Control Board PAC-INT | 1220.00 |  |  |  |  |  |  |  |  |  |  |  |  |  |  |  | 2019-03-12 | 2019-04-01 | 10 | 1986.30 | 19863.00 | open PO
23 | R1D1355-21937 | PAC MCU Board Woojin ESP01086-009 | 919.00 |  |  |  |  |  |  |  |  |  |  | 2017-07-25 | 2018-02-08 | 12 | 1517.50 | 18210.00
24 | R1D1355-21945 | RS485 - Communication Board for SEPTA SL | 1250.00 |  |  |  |  |  |  |  |  |  |  |  |  |  |  |  | 2018-05-31 | 2019-02-05 | 15 | 2375.33 | 35629.95
 |  |  | 1280.00 |  |  |  |  |  |  |  |  |  |  |  |  |  |  |  | 2019-03-11 | 2019-03-18 | 10 | 2375.33 | 23753.30 | open PO
25 | R1D1355-21954 | Audio Amp Board 2 SEPTA 5903001504 | 860.00 |  |  |  |  |  |  |  |  |  |  |  |  |  |  |  | 2019-03-11 | 2019-03-15 | 12 | 1382.90 | 16594.80 | open PO
26 | R1D1355-21995 | Hard Disk Support Board Woojin ESP01086-008 | 525.00 |  |  |  |  |  |  |  |  |  |  | 2017-07-25 | 2018-02-08 | 12 | 926.50 | 11118.00
27 | R1D1355-22048 | Video TX Board Woojin ESP01086-006 | 853.00 |  |  |  |  |  |  |  |  |  |  | 2017-07-25 | 2018-02-08 | 12 | 1418.50 | 17022.00
28 | R1D1355-22059 | Wireless LAN Board C/L 59-05409-517 | 656.00 |  |  |  |  |  |  |  |  |  |  | 2017-07-25 | 2018-05-25 | 11 | 1123.00 | 12353.00
 |  |  | 656.00 |  |  |  |  |  |  |  |  |  |  | 2017-07-25 | 2018-06-18 | 1 | 1123.00 | 1123.00
29 | R1D1355-22068 | Audio Amplifier Power Board C/L 59-05409-505 | 1178.00 | 2017-07-25 | 2018-02-15 | 3 | 1920.66 | 5761.98
 |  |  | 1178.00 |  | 2018-05-03 | 9 | 1920.66 | 17285.94
30 | R1D1355-22088 | Power Supply Board C/L 59-05409-515 | 1077.00 |  |  |  |  |  |  |  |  |  |  | 2017-07-25 | 2018-02-14 | 12 | 1772.19 | 21266.28
31 | R1D1355-22114 | Interface GPS C/L 59-02627-501 | 984.00 |  |  |  |  |  |  |  |  |  |  | 2017-07-25 | 2018-02-16 | 3 | 1615.00 | 4845.00
 |  |  | 1009.00 |  |  |  |  |  |  |  |  |  |  |  |  |  |  |  | 2019-05-03 |  | 5 | 1890.93 | 9454.65 | pending PO
32 | R1D1355-22144 | PAC-Vol - Communication Board for SEPTA SL | 1170.00 |  |  |  |  |  |  |  |  |  |  |  |  |  |  |  | 2018-05-31 | 2019-02-05 | 15 | 2240.09 | 33601.35
 |  |  | 1170.00 |  |  |  |  |  |  |  |  |  |  |  |  |  |  |  | 2019-03-11 | 2019-03-18 | 10 | 2240.09 | 22400.90 | open PO
33 | R1D1357-2150309 | Buzzer Communication SL V | 340.00 |  |  |  |  |  |  |  |  |  |  |  |  |  |  |  | mid 2014? | 2014-08-19 | 10 | 634.60 | 6346.00
 |  |  |  |  |  |  |  | 55047.92 |  |  |  |  | 41416.25 |  |  |  |  | 100601.28 |  |  |  |  | 407451.88
 |  |  |  |  |  |  |  |  |  |  |  |  |  |  |  |  |  |  |  |  |  | GRAND TOTAL | 604517.33

Sheet: Sheet2
 | Item # | Description | COGS | Quoted Date | Date | Qty | Unit Price | Amount
1 | LTM190BT03 | PID 1&2 TFT LCD Panel | 240.00 | 2019-03-21 | 2019-04-03 | 10 | 572.90 | 5729.00 | 2019-03-21 | 10
2 | LMS700KF07 | TFT - LCD unit touch screen part number LMS700KF05 for AVS/AVL Terminal | 220.00 | 2019-03-21 | 2019-04-01 | 10 | 532.00 | 5320.00 | 2017-03-20 | 67
2 | LMS700KF07 | TFT - LCD unit touch screen part number LMS700KF05 for AVS/AVL Terminal | 220.00 | 2018-10-04 | 2018-12-13 | 25 | 503.81 | 12595.25 | 2017-03-20 | 58
2 | LMS700KF07 | TFT - LCD unit touch screen part number LMS700KF05 for AVS/AVL Terminal | 191.00 | 2017-03-27 | 2017-06-15 | 25 | 423.25 | 10581.25
2 | LMS700KF07 | TFT - LCD unit touch screen part number LMS700KF05 for AVS/AVL Terminal | 191.00 | 2017-02-03 | 2017-03-20 | 7 | 423.25 | 2962.75
2 | LMS700KF06 | TFT - LCD unit touch screen part number LMS700KF05 for AVS/AVL Terminal | 0.00 |  | 2016-09-14 | 1 | 331.00 | 331.00
3 | R1D1355-21525 | Communication System: Speaker Exterior SL V | 250.00 | 2019-03-21 | 2019-04-01 | 10 | 532.00 | 5320.00 | 2014-03-12 | 52
3 | R1D1355-21525 | Communication System: Speaker Exterior SL V | 170.00 | 2016-11-29 | 2017-01-13 | 8 | 580.00 | 4640.00
3 | R1D1355-21525 | Communication System: Speaker Exterior SL V | 225.00 | 2016-05-24 | 2016-09-12 | 8 | 580.00 | 4640.00
3 | R1D1355-21525 | Communication System: Speaker Exterior SL V | 225.00 |  | 2015-07-14 | 6 | 435.00 | 2610.00
3 | R1D1355-21525 | Communication System: Speaker Exterior SL V | 200.00 | 2013-12-16 | 2014-03-12 | 20 | 300.00 | 6000.00
4 | R1D1355-21526 | Jumper Plug and Receptacle Assy | 2120.00 | 2017-02-07 | 2017-04-27 | 10 | 3200.00 | 32000.00 | 2017-04-27 | 10
5 | R1D1355-21528 | LED Front Destination Indicator | 3285.00 | 2018-02-26 | 2018-09-10 | 10 | 5376.80 | 53768.00 | 2018-09-10 | 10
6 | R1D1355-21529 | LED Passenger Information Indicator | 2747.00 | 2018-11-29 | 2018-12-18 | 5 | 4992.94 | 24964.70 | 2018-07-12 | 10
6 | R1D1355-21529 | LED Passenger Information Indicator | 2936.00 | 2017-12-18 | 2018-07-12 | 5 | 4992.94 | 24964.70
7 | R1D1355-21530 | Exterior Side Destination Right Hand | 3072.30 | 2018-01-26 | 2018-07-31 | 3 | 5116.36 | 15349.08 | 2018-07-31 | 3
8 | R1D1355-21552 | AVS/AVL Terminal 7" TFT Touch (CCP) | 4000.00 | 2019-03-11 | 2019-01-09 | 5 | 5892.90 | 29464.50 | 2015-11-23 | 21
8 | R1D1355-21552 | AVS/AVL Terminal 7" TFT Touch (CCP) | 3141.00 | 2017-02-10 | 2017-08-18 | 5 | 3908.20 | 19541.00
8 | R1D1355-21552 | AVS/AVL Terminal 7" TFT Touch (CCP) | 2847.00 | 2015-12-09 | 2016-07-06 | 5 | 3913.00 | 19565.00
8 | R1D1355-21552 | AVS/AVL Terminal 7" TFT Touch (CCP) | 2847.00 | 3/20/2015 ? | 2015-11-23 | 6 | 3913.00 | 23478.00
9 | R1D1355-21628 | PAC-VOL / PAC-RS485 FRONT PANEL | 36.00 | 2018-10-04 | 2018-12-21 | 25 | 61.27 | 1531.75
10 | R1D1355-21629 | AAB FRONT PANEL | 42.00 | 2018-10-04 | 2018-12-21 | 25 | 69.77 | 1744.25
11 | R1D1355-21801 | PSA FRONT PANEL | 34.00 | 2018-10-04 | 2018-12-21 | 25 | 58.43 | 1460.75
12 | R1D1355-21804 | SCB FRONT PANEL | 33.00 | 2018-10-04 | 2018-12-21 | 25 | 57.02 | 1425.50
13 | R1D1355-21807 | LIC FRONT PANEL | 35.00 | 2018-10-04 | 2018-12-21 | 25 | 59.85 | 1496.25
14 | R1D1355-21809 | WLR FRONT PANEL | 33.00 | 2018-10-04 | 2018-12-21 | 25 | 57.02 | 1425.50
15 | R1D1355-21811 | GIA FRONT PANEL | 33.00 | 2018-10-04 | 2018-12-21 | 25 | 57.02 | 1425.50
16 | R1D1355-21813 | VTX FRONT PANEL | 33.00 | 2018-10-04 | 2018-12-21 | 25 | 57.02 | 1425.50
17 | R1D1355-21815 | HDD FRONT PANEL | 29.00 | 2018-10-04 | 2018-12-21 | 25 | 51.35 | 1283.75
18 | R1D1355-21817 | CNCS FRONT PANEL | 35.00 | 2018-10-04 | 2018-12-21 | 25 | 59.85 | 1496.25
19 | R1D1355-21819 | PAC-INT FRONT PANEL | 29.00 | 2018-10-04 | 2018-12-21 | 25 | 51.35 | 1283.75
20 | R1D1355-21822 | PAC-MCU FRONT PANEL | 40.00 | 2018-10-04 | 2018-12-21 | 25 | 66.94 | 1673.50
21 | R1D1355-21927 | Signal Connection Board Woojin ESP01086-002 | 722.00 | 2017-07-25 | 2018-02-08 | 12 | 1222.00 | 14664.00 | 2018-02-08 | 12
22 | R1D1355-21932 | PA Control Board PAC-INT | 1220.00 | 2019-03-12 | 2019-04-01 | 10 | 1986.30 | 19863.00 | 2019-04-01 | 10
23 | R1D1355-21937 | PAC MCU Board Woojin ESP01086-009 | 919.00 | 2017-07-25 | 2018-02-08 | 12 | 1517.50 | 18210.00 | 2018-02-08 | 12
24 | R1D1355-21945 | RS485 - Communication Board for SEPTA SL | 1280.00 | 2019-03-11 | 2019-03-18 | 10 | 2375.33 | 23753.30 | 2019-02-05 | 25
24 | R1D1355-21945 | RS485 - Communication Board for SEPTA SL | 1250.00 | 2018-05-31 | 2019-02-05 | 15 | 2375.33 | 35629.95 | 2019-03-18
25 | R1D1355-21954 | Audio Amp Board 2 SEPTA 5903001504 | 860.00 | 2019-03-11 | 2019-03-15 | 12 | 1382.90 | 16594.80 | 2019-03-15 | 12
26 | R1D1355-21995 | Hard Disk Support Board Woojin ESP01086-008 | 525.00 | 2017-07-25 | 2018-02-08 | 12 | 926.50 | 11118.00 | 2018-02-08 | 12
27 | R1D1355-22048 | Video TX Board Woojin ESP01086-006 | 853.00 | 2017-07-25 | 2018-02-08 | 12 | 1418.50 | 17022.00 | 2018-02-08 | 12
28 | R1D1355-22059 | Wireless LAN Board C/L 59-05409-517 | 656.00 | 2017-07-25 | 2018-06-18 | 1 | 1123.00 | 1123.00 | 2018-05-25 | 12
28 | R1D1355-22059 | Wireless LAN Board C/L 59-05409-517 | 656.00 | 2017-07-25 | 2018-05-25 | 11 | 1123.00 | 12353.00
29 | R1D1355-22068 | Audio Amplifier Power Board C/L 59-05409-505 | 1178.00 | 2017-07-25 | 2018-05-03 | 9 | 1920.66 | 17285.94 | 2018-02-15 | 12
29 | R1D1355-22068 | Audio Amplifier Power Board C/L 59-05409-505 | 1178.00 | 2017-07-25 | 2018-02-15 | 3 | 1920.66 | 5761.98
30 | R1D1355-22088 | Power Supply Board C/L 59-05409-515 | 1077.00 | 2017-07-25 | 2018-02-14 | 12 | 1772.19 | 21266.28 | 2018-02-14 | 12
31 | R1D1355-22114 | Interface GPS C/L 59-02627-501 | 984.00 | 2017-07-25 | 2018-02-16 | 3 | 1615.00 | 4845.00 | 2018-02-16 | 8
31 | R1D1355-22114 | Interface GPS C/L 59-02627-501 | 1009.00 | 2019-05-03 |  | 5 | 1890.93 | 9454.65
32 | R1D1355-22144 | PAC-Vol - Communication Board for SEPTA SL | 1170.00 | 2019-03-11 | 2019-03-18 | 10 | 2240.09 | 22400.90 | 2019-02-05 | 25
32 | R1D1355-22144 | PAC-Vol - Communication Board for SEPTA SL | 1170.00 | 2018-05-31 | 2019-02-05 | 15 | 2240.09 | 33601.35
33 | R1D1357-2150309 | Buzzer Communication SL V | 340.00 | mid 2014? | 2014-08-19 | 10 | 634.60 | 6346.00

Sheet: Sheet3
SEPTA Silverliner V Parts Supply Agreement Quantities Worksheet
Parts |  | Part Number / Drawing Number | In Service |  |  |  | PSA Recommended |  | Latest WISK Quote to Sharon | Quoted Date | Cost of Goods from 김선희 과장 | Quoted Date | Comparison | Difference in Time | WISK Quote to Use | Price Notes | Notes
 |  |  | SC | MPA | MPB | TOTAL | Qty / yr | Total Qty
Communication Rack A |  | R1D1355-21518 | 38 | 41 | - | 79 |  | 0 |  |  |  |  | $0.00 | NA | $18702.24
Communication Rack B |  | R1D1355-21521 | 38 | - | 41 | 79 |  | 0 |  |  |  |  | $0.00 | NA | $12958.04
 | Comm Rack Enclosure + Backplane Board | R1D1355-21519_A R1D1355-21521_B | 76 | 41 | 41 | 158 |  | 0 |  |  |  |  | $0.00 | NA | $2580.00
 | Comm Rack Enclosure | R1D1355-21521_R |  |  |  |  |  |  | $1560.00 | 2018-05-31 | $1800.00 | 2019-06-11 | $240.00 | 12 months | $1800.00
 | Backplane Board | R1D1355-21627 |  |  |  |  |  |  | $780.00 | 2018-05-31 |  |  | $0.00 | NA | $780.00
 | Power Supply ASSY | R1D1355-22088 | 76 | 41 | 41 | 158 | 2 | 10 | $1517.18 | 2017-08-24 | $1292.40 | 2019-06-11 | -$224.78 | 22 months | $1517.18 | re-engineered; conversion rate 1100
 | Signal Control Board | R1D1355-21927 | 76 | 41 | 41 | 158 | 2 | 10 | $722.00 | 2017-07-25 | $866.40 | 2019-06-11 | $144.40 | 23 months | $866.40
 | LonWorks Int. Card | R1D1355-21942 | 38 | 41 | - | 79 | 2 | 10 |  |  | $720.00 | 2019-06-11 | $0.00 | NA | $720.00
 | Wireless LAN Router | R1D1355-22059 | 38 | 41 | - | 79 | 2 | 10 | $656.00 | 2017-07-25 | $787.20 | 2019-06-11 | $131.20 | 23 months | $787.20
 | GPS Interface ASSY | R1D1355-22114 | 38 | 41 | - | 79 | 2 | 10 | $1009.00 | 2019-05-03 | $1200.00 | 2019-06-11 | $191.00 | 1 months | $1200.00
 | Video TX Board | R1D1355-22048 | 38 | 41 | - | 79 | 2 | 10 | $853.00 | 2017-07-25 | $853.00 | 2019-06-11 | NC | 23 months | $853.00
 | Hard Disk Drive Board 2 | R1D020767 | 38 | 41 | - | 79 | 5 | 25 | $896.00 | 2018-04-24 | $564.00 | 2019-06-11 | -$332.00 | 14 months | $564.00 | $525.00 was the price before re-engineering, concern is no change in base board; conversion rate 1081 from 4/25/18 | Considering age, high replacement rate anticipated
 | Content & Control Server 2 | R1C008308 | 38 | 41 | - | 79 | 5 | 25 | $2493.00 | 2018-04-24 | $1680.00 | 2019-06-11 | -$813.00 | 14 months | $1680.00 | $1680.00 is the quote of before or after re-engineering?; conversion rate 1081 from 4/25/18
 | PAC-INT | R1D1355-21932 | 76 | 41 | 41 | 158 | 3 | 15 | $1220.00 | 2019-03-12 | $1220.00 | 2019-06-11 | NC | 3 months | $1220.00
 | PAC-MCU | R1D1355-21937 | 76 | 41 | 41 | 158 | 4 | 20 | $919.00 | 2017-07-25 | $1102.80 | 2019-06-11 | $183.80 | 23 months | $1102.80
 | PAC-VOL | R1D1355-22144 | 76 | 41 | 41 | 158 | 4 | 20 | $1170.00 | 2019-03-11 | $1170.00 | 2019-06-11 | NC | 3 months | $1170.00 |  | PAC-Vol boards are possible to fix and reuse based on repair procedures using BTE
 | PAC-RS485 | R1D1355-21945 | 76 | 41 | 41 | 158 | 8 | 40 | $1280.00 | 2019-03-11 | $1280.00 | 2019-06-11 | NC | 3 months | $1280.00
 | RS-485 IC Chip |  | 456 | 246 | 246 | 948 | 20 | 100 |  |  | $30.00 | 2019-06-11 | $0.00 | NA |  | Price from 장덕수 과장 | New chips that are under testing
 | ~~Audio Amplifier Board~~ |  | 76 | 41 | 41 | 158 | 2 | 10 |  |  | ~~$1178.00~~ | ~~2019-06-11~~ | $0.00 | NA |  | Looks like an error, refer to AAB Power quote from 7/25/2017
 | AAB1 board (with front panel) | R1D1355-21950 | 76 | 41 | 41 | 158 | 5 | 25 | $969.00 | 2019-08-19 |  |  | $0.00 | NA | $969.00
 | AAB2 board (without front panel) | R1D1355-21954 | 76 | 41 | 41 | 158 |  | 0 | $860.00 | 2019-03-11 |  |  | $0.00 | NA | $860.00
 | AAB Power (without front panel) | R1D1355-22068 | 76 | 41 | 41 | 158 | 2 | 10 | $1332.66 | 2017-08-24 | $1178.00 | 2017-07-25 | -$154.66 | #NUM! | $1332.66 | re-engineered; conversion rate 1100
 | RCB Board | R1D1355-23579 | 38 | - | 41 | 79 |  | 0 |  |  | $60.00 | 2019-06-11 | $0.00 | NA | $60.00
Communication Control Panel |  | R1D1355-21552 | 76 | 41 | 41 | 158 | 2 | 10 | $4000.00 | 2019-03-11 | $4800.00 | 2019-06-11 | $800.00 | 3 months | $4800.00 | The requoted price from HQ was $4000 and in 3months it has jumped $800 Need to discuss with HQ
 | 7” Touchscreen + LCD | LMS700KF07 | 76 | 41 | 41 | 158 | 30 | 150 | $220.00 | 2019-03-21 | $144.00 | 2019-06-11 | -$76.00 | 3 months | $220.00 |  | nearly 60 screens ordered in span of 2 years
 | CCP Power Supply Board | PWR-CCP | 76 | 41 | 41 | 158 | 2 | 10 | $827.42 | 2017-08-24 | $864.00 | 2019-06-11 | $36.58 | 22 months | $864.00 | re-engineered; conversion rate 1100
 | CCP Control Board | R1D1355-22102 | 76 | 41 | 41 | 158 | 4 | 20 |  |  | $2835.60 | 2019-06-11 | $0.00 | NA | $2835.60
Front Destination Indicator |  | R1D1355-21528 | 76 | 41 | 41 | 158 |  | 0 | $3285.00 | 2018-02-26 | $3942.00 | 2019-06-11 | $657.00 | 15 months | $3942.00
Side Destination Indicator |  | R1D1355-21530 | 152 | 164 | 164 | 480 |  | 0 | $3072.30 | 2018-01-26 | $3686.40 | 2019-06-11 | $614.10 | 16 months | $3686.40
Passenger Information Indicator |  | R1D1355-21529 | 76 | 82 | 82 | 240 |  | 0 | $2747.00 | 2018-11-29 | $3296.40 | 2019-06-11 | $549.40 | 6 months | $3296.40
 | FDI/SDI Power Supply Board | PWR-FDI/SDI | 228 | 205 | 205 | 638 | 4 | 20 |  |  | $1020.00 | 2019-06-11 | $0.00 | NA | $1020.00
 | PII Power Supply Board | PWR-PII | 76 | 82 | 82 | 240 | 3 | 15 | $916.58 | 2017-08-24 | $960.00 | 2019-06-11 | $43.42 | 22 months | $960.00 | re-engineered; conversion rate 1100
 | FDI/SDI Amber LED Module | ODTLM-096CY-16A1 | 1976 | 1722 | 1722 | 5420 | 250 | 1250 |  |  | $254.00 | 2019-06-11 | $0.00 | NA | $254.00 |  | Considering the number of modules and the age of equipment, high replacement rate anticipated in the upcoming years.
 | FDI/SDI RGB LED Module | ODTLM-096CF-16B1 | 304 | 246 | 246 | 796 | 40 | 200 |  |  | $216.00 | 2019-06-11 | $0.00 | NA | $216.00
 | PII Amber LED Module | ODTLM-064CY-16B1 | 608 | 656 | 656 | 1920 | 100 | 500 |  |  | $576.00 | 2019-06-11 | $0.00 | NA | $576.00
 | FDI/SDI Light Sensor | BH1715FVC-E | 205 | 205 | 205 | 638 |  | 0 |  |  | $120.00 | 2019-06-11 | $0.00 | NA | $120.00
 | LED Control Board | ST-LEDC | 304 | 287 | 287 | 878 | 4 | 20 |  |  | $600.00 | 2019-06-11 | $0.00 | NA | $600.00
Passenger Information Display 1 |  | R1D1355-05496 | 152 | 164 | 164 | 480 |  | 0 |  |  | $3000.00 | 2019-06-11 | $0.00 | NA | $3000.00
Passenger Information Display 2 |  | R1C1356-05497 | 76 | 82 | 82 | 240 |  | 0 |  |  | $3000.00 | 2019-06-11 | $0.00 | NA | $3000.00
 | PID Power Supply | PWR-PID | 228 | 246 | 246 | 720 | 5 | 25 |  |  | $1080.00 | 2019-06-11 | $0.00 | NA | $1080.00
 | VRX Board | SP-RX | 228 | 246 | 246 | 720 | 5 | 25 |  |  | $1080.00 | 2019-06-11 | $0.00 | NA | $1080.00
 | 19” LCD Panel + Inverter | LTM190BT03 | 228 | 246 | 246 | 720 | 150 | 750 | $240.00 | 2019-03-21 | $288.00 | 2019-06-11 | $48.00 | 3 months | $288.00 |  | 19" screens will be harder and harder to find as time passes
Cab Speaker |  | R1D1358-21410 | 76 | 41 | 41 | 158 |  | 0 |  |  | $264.00 | 2019-06-11 | $0.00 | NA | $264.00
Interior Speaker |  | R1D1358-21438 | 304 | 328 | 328 | 960 |  | 0 |  |  | $480.00 | 2019-06-11 | $0.00 | NA | $480.00
Exterior Speaker |  | R1D1355-21525 | 152 | 164 | 164 | 480 | 12 | 60 | $250.00 | 2019-03-21 | $360.00 | 2019-06-11 | $110.00 | 3 months | $360.00
Transformer (Ext. Speaker) |  | R1D1361-21493 | 152 | 164 | 164 | 480 |  | 0 |  |  | $240.00 | 2019-06-11 | $0.00 | NA | $240.00
Driver Microphone Jack |  | R1D1361-21501 | 76 | 41 | 41 | 158 |  | 0 |  |  | $240.00 | 2019-06-11 | $0.00 | NA | $240.00
Ambient Noise Sensing Mic. |  | R1D1361-21499 | 38 | 41 | 41 | 120 |  | 0 |  |  | $240.00 | 2019-06-11 | $0.00 | NA | $240.00
Jumper Plug and Receptacle ASSY |  | R1D1355-21526 | 0 | 41 | 0 | 41 | 2 | 10 | $2120.00 | 2017-02-07 | $2544.00 | 2019-06-11 | $424.00 | 28 months | $2544.00
 | Jumper Plug |  | 0 | 41 | 0 | 41 |  | 0 |  |  | $1560.00 | 2019-06-11 | $0.00 | NA | $1560.00
 | Receptacle |  | 0 | 41 | 41 | 82 |  | 0 |  |  | $720.00 | 2019-06-11 | $0.00 | NA | $720.00
~~Wireless LAN/GPS Antenna~~ |  | ~~SWA 0859/360/4/0/DFRX30~~ | 38 | 41 | - | 79 | 4 | 20 |  |  |  |  | $0.00 | NA
 |  |  |  |  |  |  |  |  |  |  |  |  |  |  |  |  | High priority items
 |  |  |  |  |  |  |  |  |  |  |  |  |  |  |  |  | Moderate priority items
 |  |  |  |  |  |  |  |  |  |  |  |  |  |  |  |  | Low priority items
