JDSCS-Club/DENVER_CCP/DOC/04_SW_문서/CMMI/Attachment 2_Combustible Material Matrix.xls

Combustible Material Matrix
Vehicle Component | Location | Material Description | Flammability |  | Smoke Density (ASTM E 662) |  |  |  | Toxicity per BSS 7239 (ppm) |  |  |  |  |  | Material Weight (lb) | Heat Value (BTU/lb) | Total Heat Release (BTU) | Test Report No.
 |  |  | Test Method | Test Value | Flaming Mode |  | Non-Flaming Mode |  | CO | HF | NO2 | HCL | HCN | SO2
 |  |  |  |  | Ds(1.5) | Ds(4.0) | Ds(1.5) | Ds(4.0)
