JDSCS-Club/DENVER_CCP/DOC/02_설계_도면/BOM/ccp.xlsx

 |  |  |  |  | B O M L I S T
BOM 번호: 10007309-01 [10007309][R1D1473-25842][] (CCP)COMMUNICATION CONTROL PANEL
BOM 설명: 덴버 CCP
No | LEVEL | 품목코드 | 도면번호 | 품 명 | 품 명 | 수량 SET수량 | 조달 형태 | 품질 등급 | 구매L/T 양산/개발 | 표준 공수 | 품목형태
1 | 01.__.__.__.__.__.__ | 30138666 | R1D000312 | BOX ASS'Y | ASS'Y/ | 1 | 내자 | 무검사 | 0 / 0 | 0 | 제관품
2 | __.01.__.__.__.__.__ | 20064091 | R1D000315 | FRONT PANEL ASS'Y | ASS'Y/ | 1 | 내자 | 무검사 | 0 / 0 | 0 | 제어PANEL류
3 | __.__.01.__.__.__.__ | 30139236 |  | FRONT PANEL | AL(A6061)/ | 1 | 외작 | C | 0 / 0 | 0 | 제관품
4 | __.__.02.__.__.__.__ | 30140818 |  | COVER | A6061/AL | 1 | 외작 | C | 0 / 0 | 0 | 제관품
5 | __.__.03.__.__.__.__ | 30138677 |  | PLATE | A6061/AL | 1 | 내자 | 무검사 | 54 / 83 | 0 | 제관품
6 | __.__.04.__.__.__.__ | 30140819 |  | COVER PIN | 304SS/ | 1 | 외작 | C | 0 / 0 | 0 | 제관품
7 | __.02.__.__.__.__.__ | 30138671 | R1D000318 | UPPER COVER | ASS'Y/ | 1 | 내자 | 무검사 | 54 / 83 | 0 | 제관품
8 | __.__.01.__.__.__.__ | 30140820 |  | UPPER COVER | A366-91,t1.0/ | 1 | 외작 | C | 0 / 0 | 0 | 제관품
9 | __.03.__.__.__.__.__ | 30138672 | R1D000455 | REAR COVER | ASS'Y/ | 1 | 내자 | 무검사 | 54 / 83 | 0 | 제관품
10 | __.__.01.__.__.__.__ | 30140821 |  | REAR COVER | A591-CQ,t=1.6/ | 1 | 외작 | C | 0 / 0 | 0 | 제관품
11 | __.__.02.__.__.__.__ | 30138680 |  | EARTH PAD | #10-24 UNC 12I STAND-OFF/ | 1 | 내자 | 무검사 | 0 / 0 | 0 | 제관품
12 | __.__.03.__.__.__.__ | 30139467 |  | BLIND NUT | M3/ | 4 | 외작 | C | 0 / 0 | 0 | 제관품
13 | __.__.04.__.__.__.__ | 30140822 |  | WIRE SUPPORT | D4,L130,H10/SS400 | 1 | 내자 | 무검사 | 0 / 0 | 0 | 제관품
14 | __.04.__.__.__.__.__ | 30138675 | R1D000460 | LCD BRACKET | ASS'Y/ | 1 | 내자 | 무검사 | 54 / 83 | 0 | 제관품
15 | __.__.01.__.__.__.__ | 30140823 |  | LCD BRACKET | A366-91,t1.0/ | 1 | 외작 | C | 0 / 0 | 0 | 제관품
16 | __.__.02.__.__.__.__ | 30139352 |  | EARTH PAD | #10-24 UNC 12I STAND-OFF/ | 1 | 외작 | C | 0 / 0 | 0 | 제관품
17 | __.__.03.__.__.__.__ | 30139467 |  | BLIND NUT | M3/ | 4 | 외작 | C | 0 / 0 | 0 | 제관품
18 | __.__.04.__.__.__.__ | 30140822 |  | WIRE SUPPORT | D4,L130,H10/SS400 | 1 | 내자 | 무검사 | 0 / 0 | 0 | 제관품
19 | __.05.__.__.__.__.__ | 30139347 | R1D000454 | FRAME | ASS'Y/ | 1 | 외작 | C | 0 / 0 | 0 | 제관품
20 | __.__.01.__.__.__.__ | 30139348 |  | FRAME | A366-91,t=1.0/ | 1 | 외작 | C | 0 / 0 | 0 | 제관품
21 | __.__.02.__.__.__.__ | 30139349 |  | STANDOFF | D5,M3,L5.6/ | 5 | 내자 | 무검사 | 0 / 0 | 0 | 가공품
22 | __.__.03.__.__.__.__ | 30139350 |  | BILND NUT | M3/ | 8 | 내자 | 무검사 | 0 / 0 | 0 | 시중품
23 | 02.__.__.__.__.__.__ | 30120766 |  | TFT-LCD UNIT | LMS700KF05/ | 1 | 내자 | A | 0 / 0 | 0 | 시중품
24 | 03.__.__.__.__.__.__ | 30140824 | R1D000316 | POWER SUPPLY | ASS'Y/ | 1 | 내자 | 무검사 | 0 / 0 | 0 | 전자부품
25 | __.01.__.__.__.__.__ | 30140825 |  | POWER | CCP-PCB,12V,50W/ | 1 | 내자 | 무검사 | 0 / 0 | 0 | 전자부품
26 | __.02.__.__.__.__.__ | 30139450 |  | CONNECTOR | LAD1140-4P/ | 1 | 외자 | 무검사 | 0 / 0 | 0 | 전자부품
27 | __.03.__.__.__.__.__ | 30139449 |  | CONNECTOR | LAD1140-6P/ | 1 | 외자 | 무검사 | 0 / 0 | 0 | 전자부품
28 | 04.__.__.__.__.__.__ | 20064100 | R1D000313 | CCP CONTROL BOARD | CCP-CB/ | 1 | 내자 | 무검사 | 0 / 0 | 0 | P.C.B BOARD
29 | __.01.__.__.__.__.__ | 30139341 |  | CONTROL BOARD | CCP CPU BOARD ASS'Y/ | 1 | 내자 | 무검사 | 0 / 0 | 0 | PCB
30 | __.02.__.__.__.__.__ | 30139342 |  | SC CARD HOLDER | ASS'Y/ | 1 | 내자 | 무검사 | 0 / 0 | 0 | 모름
31 | __.03.__.__.__.__.__ | 30139343 |  | CONNECTOR | 05002HR-40A01/ | 1 | 내자 | 무검사 | 0 / 0 | 0 | 전자부품
32 | __.04.__.__.__.__.__ | 30139344 |  | CONNECTOR | 10003HR-NNL,10003HR-04L/ | 1 | 내자 | 무검사 | 0 / 0 | 0 | 전자부품
33 | __.05.__.__.__.__.__ | 30139345 |  | CONNECTOR | 039291088/ | 1 | 외자 | 무검사 | 0 / 0 | 0 | 전자부품
34 | __.06.__.__.__.__.__ | 30127387 |  | CONNECTOR | SMW250-02/ | 2 | 내자 | 무검사 | 0 / 0 | 0 | 시중품
35 | __.07.__.__.__.__.__ | 30139335 |  | CONNECTOR | SMW250-03/ | 5 | 내자 | A | 0 / 0 | 0 | 시중품
36 | __.08.__.__.__.__.__ | 30139336 |  | CONNECTOR | SMW250-04/ | 1 | 내자 | A | 0 / 0 | 0 | 시중품
37 | __.09.__.__.__.__.__ | 30137956 |  | CONNECTOR | SMW250-08/ | 2 | 내자 | 무검사 | 0 / 0 | 0 | 전기부품
38 | 05.__.__.__.__.__.__ | 30138685 |  | CONNECTOR | ITH03FPA22-14PB0G1F6/ | 1 | 내자 | 무검사 | 0 / 0 | 0 | 전자부품
39 | 06.__.__.__.__.__.__ | 30138686 |  | CONNECTOR | ITH08F22-14SB0F3/ | 1 | 내자 | 무검사 | 0 / 0 | 0 | 전자부품
40 | 07.__.__.__.__.__.__ | 30139313 | R1D000452(02) | NAME PLATE(CCP) | t=1.0/AL | 1 | 내자 | 무검사 | 0 / 0 | 0 | 명판
41 | 08.__.__.__.__.__.__ | 30138688 |  | BOLT&NUT LIST | ASS'Y/ | 1 | 내자 | 무검사 | 0 / 0 | 0 | 모름
42 | 09.__.__.__.__.__.__ | 30138689 |  | WIRE MESH | DUST FILTER #25/ | 2 | 내자 | 무검사 | 0 / 0 | 0 | 모름
43 | 10.__.__.__.__.__.__ | 30138690 |  | EMC GASKET | SF050010R-C-NA-A/ | 4 | 내자 | 무검사 | 29 / 58 | 0 | 시중품
44 | 11.__.__.__.__.__.__ | 30120765 |  | TOUCH SCREEN UNIT | MN070000ACD 7Inch WIDE/ | 1 | 내자 | A | 0 / 0 | 0 | 시중품
45 | 12.__.__.__.__.__.__ | 30120836 |  | MICRO SPEAKER | HSP1710-8(0.5W, 8Ω)/ | 1 | 내자 | 무검사 | 0 / 0 | 0 | 전기부품
46 | 13.__.__.__.__.__.__ | 30139334 | R1D000314 | DOWNLOAD BOARD | ASS'Y/ | 1 | 내자 | 무검사 | 0 / 0 | 0 | PCB
47 | __.01.__.__.__.__.__ | 30139335 |  | CONNECTOR | SMW250-03/ | 1 | 내자 | A | 0 / 0 | 0 | 시중품
48 | __.02.__.__.__.__.__ | 30139336 |  | CONNECTOR | SMW250-04/ | 1 | 내자 | A | 0 / 0 | 0 | 시중품
49 | __.03.__.__.__.__.__ | 30139337 |  | CONNECTOR | DSUB 9PIN/ | 1 | 내자 | 무검사 | 0 / 0 | 0 | 전자부품
50 | __.04.__.__.__.__.__ | 30139338 |  | CONNECTOR | DSUB 4PIN/ | 1 | 내자 | 무검사 | 0 / 0 | 0 | 전자부품
51 | 14.__.__.__.__.__.__ | 30139339 | R1D000453 | CR FORM SHEET | CR FORM, t=2.0/ | 1 | 내자 | 무검사 | 0 / 0 | 0 | 가공품
52 | __.01.__.__.__.__.__ | 30139340 |  | SHEET | CR FORM, EPDM, t2.0, BLACK/ | 1 | 내자 | 무검사 | 0 / 0 | 0 | 가공품
53 | 15.__.__.__.__.__.__ | 30140826 |  | CAPTIVE SCREW | F5-M4-P2/ | 1 | 외자 | 무검사 | 0 / 0 | 0 | 시중품
54 | 16.__.__.__.__.__.__ | 20064153 | R1D000446 | CCP WIRING DIAGRAM | ASS'Y/ | 1 | 내작 | 무검사 | 0 / 0 | 0 | 하네스도
55 | __.01.__.__.__.__.__ | 30067016 |  | WIRE | 100G0111-0.5-0/ | 1 | 내자 | C | 39 / 58 | 0 | 전선
56 | __.02.__.__.__.__.__ | 30128047 |  | WIRE | 100G1121-0.5-0/9/ | 1 | 외자 | 무검사 | 0 / 0 | 0 | 전선
57 | __.03.__.__.__.__.__ | 30075141 |  | WIRE | 100G0121-0.75-0/9-0/ | 1 | 외자 | C | 0 / 0 | 0 | 전선
58 | __.04.__.__.__.__.__ | 30115073 |  | CONNECTOR | 5557-04R/ | 1 | 내자 | 무검사 | 0 / 0 | 0 | 전자부품
59 | __.05.__.__.__.__.__ | 30139216 |  | CONNECTOR | 5557-06R/ | 1 | 내자 | 무검사 | 0 / 0 | 0 | 전자부품
60 | __.06.__.__.__.__.__ | 30081231 |  | TERMINAL | 5556, AWG18-24/ | 18 | 외자 | 무검사 | 0 / 0 | 0 | 전기부품
61 | __.07.__.__.__.__.__ | 30140827 |  | CONNECTOR | 5557-008R/ | 1 | 외자 | 무검사 | 0 / 0 | 0 | 전자부품
62 | __.08.__.__.__.__.__ | 30124456 |  | CONNECTOR | SMH250-02/ | 1 | 내자 | A | 0 / 0 | 0 | 시중품
63 | __.09.__.__.__.__.__ | 30121361 |  | CONNECTOR | SMH250-03/SMH250-03 | 3 | 내자 | A | 0 / 0 | 0 | 시중품
64 | __.10.__.__.__.__.__ | 30133749 |  | CONNECTOR | SMH250-04/ | 2 | 내자 | A | 0 / 0 | 0 | 시중품
65 | __.11.__.__.__.__.__ | 30124458 |  | CONNECTOR | SMH250-06/ | 1 | 내자 | A | 0 / 0 | 0 | 시중품
66 | __.12.__.__.__.__.__ | 30139220 |  | TERMINAL | SMH250-02/ | 27 | 내자 | A | 0 / 0 | 0 | 시중품
