JDSCS-Club/DENVER_CCP/DOC/02_설계_도면/BOM/cra.xlsx

 |  |  |  | B O M L I S T
BOM 번호: 10007307-01 [10007307][R1D1473-25838][] (CRA)COMMUNICATIONS RACK-A
BOM 설명: 미국 DENVER CRA
No | LEVEL | 품목코드 | 도면번호 | 품 명 | 품 명 | 수량 SET수량 | 조달 형태 | 품질 등급 | 구매L/T 양산/개발 | 표준 공수 | 품목형태
1 | 01.__.__.__.__.__.__ | 30138569 | R1D000283 | POWER SUPPLY | ASS'Y/ | 1 | 외작 | 무검사 | 0 / 0 | 0 | 제관품
2 | __.01.__.__.__.__.__ | 20064035 | R1D000285 | PWR FRT PANEL ASS'Y | ASS'Y/ | 1 | 외작 | 무검사 | 0 / 0 | 0 | 제어PANEL류
3 | __.__.01.__.__.__.__ | 20064036 | R1D000284 | FRONT PANEL | AL, t=2.5/ | 1 | 내자 | 무검사 | 0 / 0 | 0 | 제어PANEL류
4 | __.__.02.__.__.__.__ | 30138570 |  | FIXING BOLT | 21101-101.M2.5,L=12.5/ | 3 | 내자 | 무검사 | 0 / 0 | 0 | 가공품
5 | __.__.03.__.__.__.__ | 30138571 |  | METAL SLEEVE | 21100-660/ | 3 | 내자 | 무검사 | 0 / 0 | 0 | 모름
6 | __.__.04.__.__.__.__ | 30138572 |  | OVAL BOLT | 21100-429,M2.5,L=8/ | 2 | 내자 | 무검사 | 0 / 0 | 0 | 가공품
7 | __.__.05.__.__.__.__ | 30138573 |  | PB HOLDER | 60807-181/ | 2 | 외작 | B | 0 / 0 | 0 | 가공품
8 | __.__.06.__.__.__.__ | 30138574 |  | BOLT | 21101-220,M2.5,L=10/ | 2 | 내자 | 무검사 | 0 / 0 | 0 | 가공품
9 | __.__.07.__.__.__.__ | 30138575 |  | HANDLE | CANTILEVER/ | 1 | 내자 | 무검사 | 0 / 0 | 0 | 가공품
10 | __.02.__.__.__.__.__ | 20064037 | R1D000286 | PWR PCB BOARD ASS'Y | ASS'Y/ | 1 | 내자 | 무검사 | 0 / 0 | 0 | P.C.B BOARD
11 | __.__.01.__.__.__.__ | 30138576 |  | PWR PCB BOARD | ASS'Y/ | 1 | 내자 | 무검사 | 0 / 0 | 0 | PCB
12 | __.__.02.__.__.__.__ | 60007433 |  | RH BOLT | M2.5,L=12/ | 2 | 내자 | 무검사 | 0 / 0 | 0 | 공용(볼트류)
13 | __.__.03.__.__.__.__ | 30138577 |  | FLAT-WASHER | M2.5XΦ5Xt0.5/ | 2 | 내자 | 무검사 | 0 / 0 | 0 | 모름
14 | __.__.04.__.__.__.__ | 30138578 |  | SPRING WASHER | M2.5XΦ5Xt0.8/ | 2 | 내자 | 무검사 | 0 / 0 | 0 | 모름
15 | __.__.05.__.__.__.__ | 30136180 |  | CONNECTOR | ASS'Y/ASS'Y | 1 | 내자 | 무검사 | 0 / 0 | 0 | 전기부품
16 | __.__.06.__.__.__.__ | 30138579 |  | LIGHTING | ASS'Y/ | 2 | 내자 | 무검사 | 0 / 0 | 0 | 전기부품
17 | __.__.07.__.__.__.__ | 30138580 |  | HEATSINK | ASS'Y/ | 1 | 내자 | 무검사 | 0 / 0 | 0 | 가공품
18 | 02.__.__.__.__.__.__ | 30138581 | R1D000296 | SP ASS'Y | ASS'Y/ | 1 | 내자 | 무검사 | 0 / 0 | 0 | 가공품
19 | __.01.__.__.__.__.__ | 20064038 | R1D000297 | SP FRT PANEL ASS'Y | ASS'Y/ | 1 | 내자 | 무검사 | 0 / 0 | 0 | 제어PANEL류
20 | __.__.01.__.__.__.__ | 20064040 | R1D000298 | FRONT PANEL | AL, t=2.5/ | 1 | 내자 | 무검사 | 0 / 0 | 0 | 제어PANEL류
21 | __.__.02.__.__.__.__ | 30138570 |  | FIXING BOLT | 21101-101.M2.5,L=12.5/ | 1 | 내자 | 무검사 | 0 / 0 | 0 | 가공품
22 | __.__.03.__.__.__.__ | 30138571 |  | METAL SLEEVE | 21100-660/ | 1 | 내자 | 무검사 | 0 / 0 | 0 | 모름
23 | __.__.04.__.__.__.__ | 30138572 |  | OVAL BOLT | 21100-429,M2.5,L=8/ | 1 | 내자 | 무검사 | 0 / 0 | 0 | 가공품
24 | __.__.05.__.__.__.__ | 30138573 |  | PB HOLDER | 60807-181/ | 1 | 외작 | B | 0 / 0 | 0 | 가공품
25 | __.__.06.__.__.__.__ | 30138574 |  | BOLT | 21101-220,M2.5,L=10/ | 1 | 내자 | 무검사 | 0 / 0 | 0 | 가공품
26 | __.__.07.__.__.__.__ | 30138575 |  | HANDLE | CANTILEVER/ | 1 | 내자 | 무검사 | 0 / 0 | 0 | 가공품
27 | __.02.__.__.__.__.__ | 20064039 | R1D000299 | SP PCB BOARD ASS'Y | ASS'Y/ | 1 | 내자 | 무검사 | 0 / 0 | 0 | P.C.B BOARD
28 | __.__.01.__.__.__.__ | 30138582 |  | SP PCB BOARD | ASS'Y/ | 1 | 내자 | 무검사 | 0 / 0 | 0 | PCB
29 | __.__.02.__.__.__.__ | 60007433 |  | RH BOLT | M2.5,L=12/ | 2 | 내자 | 무검사 | 0 / 0 | 0 | 공용(볼트류)
30 | __.__.03.__.__.__.__ | 30138577 |  | FLAT-WASHER | M2.5XΦ5Xt0.5/ | 2 | 내자 | 무검사 | 0 / 0 | 0 | 모름
31 | __.__.04.__.__.__.__ | 30138578 |  | SPRING WASHER | M2.5XΦ5Xt0.8/ | 2 | 내자 | 무검사 | 0 / 0 | 0 | 모름
32 | __.__.05.__.__.__.__ | 30138583 |  | CONNECTOR | 850030177/ | 1 | 내자 | 무검사 | 0 / 0 | 0 | 전자부품
33 | 03.__.__.__.__.__.__ | 30138584 | R1D000304 | VTX ASS'Y | ASS'Y/ | 1 | 내자 | 무검사 | 0 / 0 | 0 | 제관품
34 | __.01.__.__.__.__.__ | 20064041 | R1D000305 | VTX FRT PANEL ASS'Y | ASS'Y/ | 1 | 내자 | 무검사 | 0 / 0 | 0 | 제어PANEL류
35 | __.__.01.__.__.__.__ | 20064043 | R1D000306 | FRONT PANEL | AL, t=2.5/ | 1 | 내자 | 무검사 | 0 / 0 | 0 | 제어PANEL류
36 | __.__.02.__.__.__.__ | 30138570 |  | FIXING BOLT | 21101-101.M2.5,L=12.5/ | 1 | 내자 | 무검사 | 0 / 0 | 0 | 가공품
37 | __.__.03.__.__.__.__ | 30138571 |  | METAL SLEEVE | 21100-660/ | 1 | 내자 | 무검사 | 0 / 0 | 0 | 모름
38 | __.__.04.__.__.__.__ | 30138572 |  | OVAL BOLT | 21100-429,M2.5,L=8/ | 1 | 내자 | 무검사 | 0 / 0 | 0 | 가공품
39 | __.__.05.__.__.__.__ | 30138573 |  | PB HOLDER | 60807-181/ | 1 | 외작 | B | 0 / 0 | 0 | 가공품
40 | __.__.06.__.__.__.__ | 30138574 |  | BOLT | 21101-220,M2.5,L=10/ | 1 | 내자 | 무검사 | 0 / 0 | 0 | 가공품
41 | __.__.07.__.__.__.__ | 30138575 |  | HANDLE | CANTILEVER/ | 1 | 내자 | 무검사 | 0 / 0 | 0 | 가공품
42 | __.02.__.__.__.__.__ | 20064042 | R1D000307 | VTX PCB BOARD ASS'Y | ASS'Y/ | 1 | 내자 | 무검사 | 0 / 0 | 0 | P.C.B BOARD
43 | __.__.01.__.__.__.__ | 30138585 |  | VTX BOARD ASS'Y | ASS'Y/ | 1 | 내자 | 무검사 | 0 / 0 | 0 | PCB
44 | __.__.02.__.__.__.__ | 60007433 |  | RH BOLT | M2.5,L=12/ | 2 | 내자 | 무검사 | 0 / 0 | 0 | 공용(볼트류)
45 | __.__.03.__.__.__.__ | 30138577 |  | FLAT-WASHER | M2.5XΦ5Xt0.5/ | 2 | 내자 | 무검사 | 0 / 0 | 0 | 모름
46 | __.__.04.__.__.__.__ | 30138578 |  | SPRING WASHER | M2.5XΦ5Xt0.8/ | 2 | 내자 | 무검사 | 0 / 0 | 0 | 모름
47 | __.__.05.__.__.__.__ | 30138586 |  | CONNECTOR | 364915/ | 1 | 내자 | 무검사 | 0 / 0 | 0 | 전자부품
48 | __.__.06.__.__.__.__ | 30138587 |  | LIGHTING | 7511A62/ | 1 | 내자 | 무검사 | 0 / 0 | 0 | 전기부품
49 | __.__.07.__.__.__.__ | 30138588 |  | D-SUB CONNECTOR | 748390,15F/ | 1 | 내자 | 무검사 | 0 / 0 | 0 | 전기부품
50 | __.__.08.__.__.__.__ | 30138589 |  | BNC CONNECTOR | CTP-BR-4001-Z,75ohm/ | 2 | 내자 | 무검사 | 0 / 0 | 0 | 전기부품
51 | __.__.09.__.__.__.__ | 30138590 |  | U5 IC SOCKET | 28PIN/ | 1 | 내자 | 무검사 | 0 / 0 | 0 | 전자부품
52 | __.__.10.__.__.__.__ | 30138591 |  | U5-IC | MAX1480ECEPI/ | 1 | 내자 | 무검사 | 0 / 0 | 0 | 모름
53 | 04.__.__.__.__.__.__ | 30138592 | R1D000253 | CNCS ASS'Y | ASS'Y/ | 1 | 내자 | 무검사 | 0 / 0 | 0 | 제관품
54 | __.01.__.__.__.__.__ | 20064044 | R1D000255 | CNCS FRT PANEL ASS'Y | ASS'Y/ | 1 | 내자 | 무검사 | 0 / 0 | 0 | 제어PANEL류
55 | __.__.01.__.__.__.__ | 20064046 | R1D000254 | FRONT PANEL | AL, t=2.5/ | 1 | 내자 | 무검사 | 0 / 0 | 0 | 제어PANEL류
56 | __.__.02.__.__.__.__ | 30138570 |  | FIXING BOLT | 21101-101.M2.5,L=12.5/ | 3 | 내자 | 무검사 | 0 / 0 | 0 | 가공품
57 | __.__.03.__.__.__.__ | 30138571 |  | METAL SLEEVE | 21100-660/ | 3 | 내자 | 무검사 | 0 / 0 | 0 | 모름
58 | __.__.04.__.__.__.__ | 30138572 |  | OVAL BOLT | 21100-429,M2.5,L=8/ | 1 | 내자 | 무검사 | 0 / 0 | 0 | 가공품
59 | __.__.05.__.__.__.__ | 30138573 |  | PB HOLDER | 60807-181/ | 1 | 외작 | B | 0 / 0 | 0 | 가공품
60 | __.__.06.__.__.__.__ | 30138574 |  | BOLT | 21101-220,M2.5,L=10/ | 1 | 내자 | 무검사 | 0 / 0 | 0 | 가공품
61 | __.__.07.__.__.__.__ | 30138575 |  | HANDLE | CANTILEVER/ | 1 | 내자 | 무검사 | 0 / 0 | 0 | 가공품
62 | __.02.__.__.__.__.__ | 20064045 | R1D000256 | CNCS PCB BOARD ASS'Y | ASS'Y/ | 1 | 내자 | 무검사 | 0 / 0 | 0 | P.C.B BOARD
63 | __.__.01.__.__.__.__ | 30138593 |  | CNCS PCB BOARD | ASS'Y/ | 1 | 내자 | 무검사 | 0 / 0 | 0 | PCB
64 | __.__.02.__.__.__.__ | 60007433 |  | RH BOLT | M2.5,L=12/ | 2 | 내자 | 무검사 | 0 / 0 | 0 | 공용(볼트류)
65 | __.__.03.__.__.__.__ | 30138577 |  | FLAT-WASHER | M2.5XΦ5Xt0.5/ | 2 | 내자 | 무검사 | 0 / 0 | 0 | 모름
66 | __.__.04.__.__.__.__ | 30138578 |  | SPRING WASHER | M2.5XΦ5Xt0.8/ | 2 | 내자 | 무검사 | 0 / 0 | 0 | 모름
67 | __.__.05.__.__.__.__ | 30138594 |  | CONNECTOR | 364918/ | 1 | 내자 | 무검사 | 0 / 0 | 0 | 전자부품
68 | __.__.06.__.__.__.__ | 30138587 |  | LIGHTING | 7511A62/ | 3 | 내자 | 무검사 | 0 / 0 | 0 | 전기부품
69 | __.__.07.__.__.__.__ | 30138595 |  | USB CONNECTOR | USB-A-2L/ | 7 | 내자 | 무검사 | 0 / 0 | 0 | 시중품
70 | __.__.08.__.__.__.__ | 30138596 |  | D-USB CONNECTOR | 748390,15F/ | 1 | 내자 | 무검사 | 0 / 0 | 0 | 전자부품
71 | __.__.09.__.__.__.__ | 30138597 |  | HEAT SINK | ASS'Y/ | 1 | 내자 | 무검사 | 0 / 0 | 0 | 가공품
72 | __.__.10.__.__.__.__ | 30138599 |  | MODULE | CONGA-X945/ | 1 | 내자 | 무검사 | 0 / 0 | 0 | 전자부품
73 | __.__.11.__.__.__.__ | 30138605 |  | CONNECTOR | X945-FX8-100-SV/ | 4 | 내자 | 무검사 | 0 / 0 | 0 | 전자부품
74 | __.03.__.__.__.__.__ | 60007434 |  | RH BOLT | M5 X L14/ | 4 | 내자 | 무검사 | 0 / 0 | 0 | 공용(볼트류)
75 | 05.__.__.__.__.__.__ | 30138609 | R1D000258 | HDD ASS'Y | ASS'Y/ | 1 | 내자 | 무검사 | 0 / 0 | 0 | 제관품
76 | __.01.__.__.__.__.__ | 20064047 | R1D000260 | HDD FRT PANEL ASS'Y | ASS'Y/ | 1 | 내자 | 무검사 | 0 / 0 | 0 | 제어PANEL류
77 | __.__.01.__.__.__.__ | 20064049 | R1D000259 | FRONT PANEL | AL, t=2.5/ | 1 | 내자 | 무검사 | 0 / 0 | 0 | 제어PANEL류
78 | __.__.02.__.__.__.__ | 30138570 |  | FIXING BOLT | 21101-101.M2.5,L=12.5/ | 1 | 내자 | 무검사 | 0 / 0 | 0 | 가공품
79 | __.__.03.__.__.__.__ | 30138571 |  | METAL SLEEVE | 21100-660/ | 1 | 내자 | 무검사 | 0 / 0 | 0 | 모름
80 | __.__.04.__.__.__.__ | 30138572 |  | OVAL BOLT | 21100-429,M2.5,L=8/ | 1 | 내자 | 무검사 | 0 / 0 | 0 | 가공품
81 | __.__.05.__.__.__.__ | 30138573 |  | PB HOLDER | 60807-181/ | 1 | 외작 | B | 0 / 0 | 0 | 가공품
82 | __.__.06.__.__.__.__ | 30138574 |  | BOLT | 21101-220,M2.5,L=10/ | 1 | 내자 | 무검사 | 0 / 0 | 0 | 가공품
83 | __.__.07.__.__.__.__ | 30138575 |  | HANDLE | CANTILEVER/ | 1 | 내자 | 무검사 | 0 / 0 | 0 | 가공품
84 | __.02.__.__.__.__.__ | 20064048 | R1D000261 | HDD PCB BOARD ASS'Y | ASS'Y/ | 1 | 내자 | 무검사 | 0 / 0 | 0 | P.C.B BOARD
85 | __.__.01.__.__.__.__ | 30120978 |  | HDD PCB BOARD | ASS'Y/ | 1 | 외작 | A | 0 / 0 | 0 | PCB
86 | __.__.02.__.__.__.__ | 60007433 |  | RH BOLT | M2.5,L=12/ | 2 | 내자 | 무검사 | 0 / 0 | 0 | 공용(볼트류)
87 | __.__.03.__.__.__.__ | 30138577 |  | FLAT-WASHER | M2.5XΦ5Xt0.5/ | 2 | 내자 | 무검사 | 0 / 0 | 0 | 모름
88 | __.__.04.__.__.__.__ | 30138578 |  | SPRING WASHER | M2.5XΦ5Xt0.8/ | 2 | 내자 | 무검사 | 0 / 0 | 0 | 모름
89 | __.__.05.__.__.__.__ | 30138621 |  | CONNECTOR | 254324/ | 1 | 내자 | 무검사 | 0 / 0 | 0 | 전자부품
90 | __.__.06.__.__.__.__ | 30138587 |  | LIGHTING | 7511A62/ | 1 | 내자 | 무검사 | 0 / 0 | 0 | 전기부품
91 | __.__.07.__.__.__.__ | 30138622 |  | HARD DISK SATA | AP-SAFD254QA 032GS/ | 1 | 내자 | 무검사 | 0 / 0 | 0 | 전자부품
92 | __.__.08.__.__.__.__ | 30138623 |  | HDD SUB BOARD | ASS'Y/ | 1 | 내자 | 무검사 | 0 / 0 | 0 | 모름
93 | __.__.09.__.__.__.__ | 30138624 |  | SATA CONNECTOR | 7103ST-715F-02/ | 1 | 외자 | 무검사 | 0 / 0 | 0 | 전자부품
94 | 06.__.__.__.__.__.__ | 30138625 | R1D000308 | WLR ASS'Y | ASS'Y/ | 1 | 내자 | 무검사 | 0 / 0 | 0 | 제관품
95 | __.01.__.__.__.__.__ | 20064050 | R1D000310 | WLR FRT PANEL ASS'Y | ASS'Y/ | 1 | 내자 | 무검사 | 0 / 0 | 0 | 제어PANEL류
96 | __.__.01.__.__.__.__ | 20064052 | R1D000309 | FRONT PANEL | AL, t=2.5/ | 1 | 내자 | 무검사 | 0 / 0 | 0 | 제어PANEL류
97 | __.__.02.__.__.__.__ | 30138570 |  | FIXING BOLT | 21101-101.M2.5,L=12.5/ | 1 | 내자 | 무검사 | 0 / 0 | 0 | 가공품
98 | __.__.03.__.__.__.__ | 30138571 |  | METAL SLEEVE | 21100-660/ | 1 | 내자 | 무검사 | 0 / 0 | 0 | 모름
99 | __.__.04.__.__.__.__ | 30138572 |  | OVAL BOLT | 21100-429,M2.5,L=8/ | 1 | 내자 | 무검사 | 0 / 0 | 0 | 가공품
100 | __.__.05.__.__.__.__ | 30138573 |  | PB HOLDER | 60807-181/ | 1 | 외작 | B | 0 / 0 | 0 | 가공품
101 | __.__.06.__.__.__.__ | 30138574 |  | BOLT | 21101-220,M2.5,L=10/ | 1 | 내자 | 무검사 | 0 / 0 | 0 | 가공품
102 | __.__.07.__.__.__.__ | 30138575 |  | HANDLE | CANTILEVER/ | 1 | 내자 | 무검사 | 0 / 0 | 0 | 가공품
103 | __.02.__.__.__.__.__ | 20064051 | R1D000311 | WLR PCB BOARD ASS'Y | ASS'Y/ | 1 | 내자 | 무검사 | 0 / 0 | 0 | P.C.B BOARD
104 | __.__.01.__.__.__.__ | 30120975 |  | WLR PCB BOARD | ASS'Y/ | 1 | 외작 | 무검사 | 0 / 0 | 0 | PCB
105 | __.__.02.__.__.__.__ | 60007433 |  | RH BOLT | M2.5,L=12/ | 2 | 내자 | 무검사 | 0 / 0 | 0 | 공용(볼트류)
106 | __.__.03.__.__.__.__ | 30138577 |  | FLAT-WASHER | M2.5XΦ5Xt0.5/ | 2 | 내자 | 무검사 | 0 / 0 | 0 | 모름
107 | __.__.04.__.__.__.__ | 30138578 |  | SPRING WASHER | M2.5XΦ5Xt0.8/ | 2 | 내자 | 무검사 | 0 / 0 | 0 | 모름
108 | __.__.05.__.__.__.__ | 30138626 |  | CONNECTOR | 364915/ | 1 | 내자 | 무검사 | 0 / 0 | 0 | 전자부품
109 | __.__.06.__.__.__.__ | 30138587 |  | LIGHTING | 7511A62/ | 3 | 내자 | 무검사 | 0 / 0 | 0 | 전기부품
110 | __.__.07.__.__.__.__ | 30138627 |  | CONNECTOR | 35312-04/ | 3 | 내자 | 무검사 | 0 / 0 | 0 | 전자부품
111 | __.__.08.__.__.__.__ | 30138628 |  | TRANSFORMER MODULE | HX1234NL/ | 2 | 내자 | 무검사 | 0 / 0 | 0 | 전기부품
112 | 07.__.__.__.__.__.__ | 30138629 | R1D000300 | VOIP ASS'Y | ASS'Y/ | 1 | 내자 | 무검사 | 0 / 0 | 0 | 제관품
113 | __.01.__.__.__.__.__ | 20064053 | R1D000302 | VOIP FRT PANEL ASS'Y | ASS'Y/ | 1 | 내자 | 무검사 | 0 / 0 | 0 | 제어PANEL류
114 | __.__.01.__.__.__.__ | 20064055 | R1D000303 | FRONT PANEL | AL, t=2.5/ | 1 | 내자 | 무검사 | 0 / 0 | 0 | 제어PANEL류
115 | __.__.02.__.__.__.__ | 30138570 |  | FIXING BOLT | 21101-101.M2.5,L=12.5/ | 3 | 내자 | 무검사 | 0 / 0 | 0 | 가공품
116 | __.__.03.__.__.__.__ | 30138571 |  | METAL SLEEVE | 21100-660/ | 3 | 내자 | 무검사 | 0 / 0 | 0 | 모름
117 | __.__.04.__.__.__.__ | 30138572 |  | OVAL BOLT | 21100-429,M2.5,L=8/ | 1 | 내자 | 무검사 | 0 / 0 | 0 | 가공품
118 | __.__.05.__.__.__.__ | 30138573 |  | PB HOLDER | 60807-181/ | 1 | 외작 | B | 0 / 0 | 0 | 가공품
119 | __.__.06.__.__.__.__ | 30138574 |  | BOLT | 21101-220,M2.5,L=10/ | 1 | 내자 | 무검사 | 0 / 0 | 0 | 가공품
120 | __.__.07.__.__.__.__ | 30138575 |  | HANDLE | CANTILEVER/ | 1 | 내자 | 무검사 | 0 / 0 | 0 | 가공품
121 | __.02.__.__.__.__.__ | 20064054 | R1D000301 | VOIP PCB BOARD ASS'Y | ASS'Y/ | 1 | 내자 | 무검사 | 0 / 0 | 0 | P.C.B BOARD
122 | __.__.01.__.__.__.__ | 30138630 |  | VOIP PCB BOARD | ASS'Y/ | 1 | 외작 | 무검사 | 0 / 0 | 0 | PCB
123 | __.__.02.__.__.__.__ | 60007433 |  | RH BOLT | M2.5,L=12/ | 2 | 내자 | 무검사 | 0 / 0 | 0 | 공용(볼트류)
124 | __.__.03.__.__.__.__ | 30138577 |  | FLAT-WASHER | M2.5XΦ5Xt0.5/ | 2 | 내자 | 무검사 | 0 / 0 | 0 | 모름
125 | __.__.04.__.__.__.__ | 30138578 |  | SPRING WASHER | M2.5XΦ5Xt0.8/ | 2 | 내자 | 무검사 | 0 / 0 | 0 | 모름
126 | __.__.05.__.__.__.__ | 30138583 |  | CONNECTOR | 850030177/ | 1 | 내자 | 무검사 | 0 / 0 | 0 | 전자부품
127 | 08.__.__.__.__.__.__ | 30138631 | R1D000288 | REC ASS'Y | ASS'Y/ | 1 | 내자 | 무검사 | 0 / 0 | 0 | 제관품
128 | __.01.__.__.__.__.__ | 20064057 | R1D000289 | REC FRT PANEL ASS'Y | ASS'Y/ | 1 | 내자 | 무검사 | 0 / 0 | 0 | 제어PANEL류
129 | __.__.01.__.__.__.__ | 20064059 | R1D000290 | FRONT PANEL | AL, t=2.5/ | 1 | 내자 | 무검사 | 0 / 0 | 0 | 제어PANEL류
130 | __.__.02.__.__.__.__ | 30138570 |  | FIXING BOLT | 21101-101.M2.5,L=12.5/ | 1 | 내자 | 무검사 | 0 / 0 | 0 | 가공품
131 | __.__.03.__.__.__.__ | 30138571 |  | METAL SLEEVE | 21100-660/ | 1 | 내자 | 무검사 | 0 / 0 | 0 | 모름
132 | __.__.04.__.__.__.__ | 30138572 |  | OVAL BOLT | 21100-429,M2.5,L=8/ | 1 | 내자 | 무검사 | 0 / 0 | 0 | 가공품
133 | __.__.05.__.__.__.__ | 30138573 |  | PB HOLDER | 60807-181/ | 1 | 외작 | B | 0 / 0 | 0 | 가공품
134 | __.__.06.__.__.__.__ | 30138574 |  | BOLT | 21101-220,M2.5,L=10/ | 1 | 내자 | 무검사 | 0 / 0 | 0 | 가공품
135 | __.__.07.__.__.__.__ | 30138575 |  | HANDLE | CANTILEVER/ | 1 | 내자 | 무검사 | 0 / 0 | 0 | 가공품
136 | __.02.__.__.__.__.__ | 20064058 | R1D000291 | REC PCB BOARD ASS'Y | ASS'Y/ | 1 | 내자 | 무검사 | 0 / 0 | 0 | P.C.B BOARD
137 | __.__.01.__.__.__.__ | 30138632 |  | REC PCB BOARD | ASS'Y/ | 1 | 외작 | 무검사 | 0 / 0 | 0 | PCB
138 | __.__.02.__.__.__.__ | 60007433 |  | RH BOLT | M2.5,L=12/ | 2 | 내자 | 무검사 | 0 / 0 | 0 | 공용(볼트류)
139 | __.__.03.__.__.__.__ | 30138577 |  | FLAT-WASHER | M2.5XΦ5Xt0.5/ | 2 | 내자 | 무검사 | 0 / 0 | 0 | 모름
140 | __.__.04.__.__.__.__ | 30138578 |  | SPRING WASHER | M2.5XΦ5Xt0.8/ | 2 | 내자 | 무검사 | 0 / 0 | 0 | 모름
141 | __.__.05.__.__.__.__ | 30138583 |  | CONNECTOR | 850030177/ | 1 | 내자 | 무검사 | 0 / 0 | 0 | 전자부품
142 | 09.__.__.__.__.__.__ | 30138633 | R1D000262 | LIC ASS'Y | ASS'Y/ | 1 | 내자 | 무검사 | 0 / 0 | 0 | 제관품
143 | __.01.__.__.__.__.__ | 20064060 | R1D000264 | LIC FRT PANEL ASS'Y | ASS'Y/ | 1 | 내자 | 무검사 | 0 / 0 | 0 | 제어PANEL류
144 | __.__.01.__.__.__.__ | 20064062 | R1D000263 | FRONT PANEL | AL, t=2.5/ | 1 | 내자 | 무검사 | 0 / 0 | 0 | 제어PANEL류
145 | __.__.02.__.__.__.__ | 30138570 |  | FIXING BOLT | 21101-101.M2.5,L=12.5/ | 3 | 내자 | 무검사 | 0 / 0 | 0 | 가공품
146 | __.__.03.__.__.__.__ | 30138571 |  | METAL SLEEVE | 21100-660/ | 3 | 내자 | 무검사 | 0 / 0 | 0 | 모름
147 | __.__.04.__.__.__.__ | 30138572 |  | OVAL BOLT | 21100-429,M2.5,L=8/ | 1 | 내자 | 무검사 | 0 / 0 | 0 | 가공품
148 | __.__.05.__.__.__.__ | 30138573 |  | PB HOLDER | 60807-181/ | 1 | 외작 | B | 0 / 0 | 0 | 가공품
149 | __.__.06.__.__.__.__ | 30138574 |  | BOLT | 21101-220,M2.5,L=10/ | 1 | 내자 | 무검사 | 0 / 0 | 0 | 가공품
150 | __.__.07.__.__.__.__ | 30138575 |  | HANDLE | CANTILEVER/ | 1 | 내자 | 무검사 | 0 / 0 | 0 | 가공품
151 | __.02.__.__.__.__.__ | 20064061 | R1D000265 | LIC PCB BOARD ASS'Y | ASS'Y/ | 1 | 내자 | 무검사 | 0 / 0 | 0 | P.C.B BOARD
152 | __.__.01.__.__.__.__ | 30138634 |  | LIC PCB BOARD | ASS'Y/ | 1 | 외작 | 무검사 | 0 / 0 | 0 | PCB
153 | __.__.02.__.__.__.__ | 60007433 |  | RH BOLT | M2.5,L=12/ | 2 | 내자 | 무검사 | 0 / 0 | 0 | 공용(볼트류)
154 | __.__.03.__.__.__.__ | 30138577 |  | FLAT-WASHER | M2.5XΦ5Xt0.5/ | 2 | 내자 | 무검사 | 0 / 0 | 0 | 모름
155 | __.__.04.__.__.__.__ | 30138578 |  | SPRING WASHER | M2.5XΦ5Xt0.8/ | 2 | 내자 | 무검사 | 0 / 0 | 0 | 모름
156 | __.__.05.__.__.__.__ | 30138583 |  | CONNECTOR | 850030177/ | 1 | 내자 | 무검사 | 0 / 0 | 0 | 전자부품
157 | __.__.06.__.__.__.__ | 30138587 |  | LIGHTING | 7511A62/ | 4 | 내자 | 무검사 | 0 / 0 | 0 | 전기부품
158 | __.03.__.__.__.__.__ | 60007435 |  | RH BOLT | M3 X L14/ | 4 | 내자 | 무검사 | 0 / 0 | 0 | 공용(볼트류)
159 | 10.__.__.__.__.__.__ | 30138635 | R1D000266 | PAC 485 ASS'Y | ASS'Y/ | 1 | 내자 | 무검사 | 0 / 0 | 0 | 제관품
160 | __.01.__.__.__.__.__ | 20064063 | R1D000267 | PAC 485 FRT PANEL ASS'Y | ASS'Y/ | 1 | 내자 | 무검사 | 0 / 0 | 0 | 제어PANEL류
161 | __.__.01.__.__.__.__ | 20064065 | R1D000268 | FRONT PANEL | AL, t=2.5/ | 1 | 내자 | 무검사 | 0 / 0 | 0 | 제어PANEL류
162 | __.__.02.__.__.__.__ | 30138570 |  | FIXING BOLT | 21101-101.M2.5,L=12.5/ | 3 | 내자 | 무검사 | 0 / 0 | 0 | 가공품
163 | __.__.03.__.__.__.__ | 30138571 |  | METAL SLEEVE | 21100-660/ | 3 | 내자 | 무검사 | 0 / 0 | 0 | 모름
164 | __.__.04.__.__.__.__ | 30138572 |  | OVAL BOLT | 21100-429,M2.5,L=8/ | 2 | 내자 | 무검사 | 0 / 0 | 0 | 가공품
165 | __.__.05.__.__.__.__ | 30138573 |  | PB HOLDER | 60807-181/ | 2 | 외작 | B | 0 / 0 | 0 | 가공품
166 | __.__.06.__.__.__.__ | 30138574 |  | BOLT | 21101-220,M2.5,L=10/ | 2 | 내자 | 무검사 | 0 / 0 | 0 | 가공품
167 | __.__.07.__.__.__.__ | 30138575 |  | HANDLE | CANTILEVER/ | 1 | 내자 | 무검사 | 0 / 0 | 0 | 가공품
168 | __.02.__.__.__.__.__ | 20064064 | R1D000269 | PAC 485 PCB BOARD ASS'Y | ASS'Y/ | 1 | 내자 | 무검사 | 0 / 0 | 0 | P.C.B BOARD
169 | __.__.01.__.__.__.__ | 30138636 |  | PAC 485 PCB BOARD | ASS'Y/ | 1 | 외작 | 무검사 | 0 / 0 | 0 | PCB
170 | __.__.02.__.__.__.__ | 60007433 |  | RH BOLT | M2.5,L=12/ | 2 | 내자 | 무검사 | 0 / 0 | 0 | 공용(볼트류)
171 | __.__.03.__.__.__.__ | 30138577 |  | FLAT-WASHER | M2.5XΦ5Xt0.5/ | 2 | 내자 | 무검사 | 0 / 0 | 0 | 모름
172 | __.__.04.__.__.__.__ | 30138578 |  | SPRING WASHER | M2.5XΦ5Xt0.8/ | 2 | 내자 | 무검사 | 0 / 0 | 0 | 모름
173 | __.__.05.__.__.__.__ | 30138583 |  | CONNECTOR | 850030177/ | 1 | 내자 | 무검사 | 0 / 0 | 0 | 전자부품
174 | __.__.06.__.__.__.__ | 30138637 |  | CONNECTOR | MSG59P-L111/ | 1 | 내자 | 무검사 | 0 / 0 | 0 | 전자부품
175 | 11.__.__.__.__.__.__ | 30138638 | R1D000292 | SCB ASS'Y | ASS'Y/ | 1 | 내자 | 무검사 | 0 / 0 | 0 | 제관품
176 | __.01.__.__.__.__.__ | 20064066 | R1D000294 | SCB FRT PANEL ASS'Y | ASS'Y/ | 1 | 내자 | 무검사 | 0 / 0 | 0 | 제어PANEL류
177 | __.__.01.__.__.__.__ | 20064068 | R1D000293 | FRONT PANEL | AL, t=2.5/ | 1 | 내자 | 무검사 | 0 / 0 | 0 | 제어PANEL류
178 | __.__.02.__.__.__.__ | 30138570 |  | FIXING BOLT | 21101-101.M2.5,L=12.5/ | 3 | 내자 | 무검사 | 0 / 0 | 0 | 가공품
179 | __.__.03.__.__.__.__ | 30138571 |  | METAL SLEEVE | 21100-660/ | 3 | 내자 | 무검사 | 0 / 0 | 0 | 모름
180 | __.__.04.__.__.__.__ | 30138572 |  | OVAL BOLT | 21100-429,M2.5,L=8/ | 1 | 내자 | 무검사 | 0 / 0 | 0 | 가공품
181 | __.__.05.__.__.__.__ | 30138573 |  | PB HOLDER | 60807-181/ | 1 | 외작 | B | 0 / 0 | 0 | 가공품
182 | __.__.06.__.__.__.__ | 30138574 |  | BOLT | 21101-220,M2.5,L=10/ | 1 | 내자 | 무검사 | 0 / 0 | 0 | 가공품
183 | __.__.07.__.__.__.__ | 30138575 |  | HANDLE | CANTILEVER/ | 1 | 내자 | 무검사 | 0 / 0 | 0 | 가공품
184 | __.02.__.__.__.__.__ | 20064067 | R1D000295 | SCB PCB BOARD ASS'Y | ASS'Y/ | 1 | 내자 | 무검사 | 0 / 0 | 0 | P.C.B BOARD
185 | __.__.01.__.__.__.__ | 30138639 |  | SCB 485 PCB BOARD | ASS'Y/ | 1 | 외작 | 무검사 | 0 / 0 | 0 | PCB
186 | __.__.02.__.__.__.__ | 60007433 |  | RH BOLT | M2.5,L=12/ | 2 | 내자 | 무검사 | 0 / 0 | 0 | 공용(볼트류)
187 | __.__.03.__.__.__.__ | 30138577 |  | FLAT-WASHER | M2.5XΦ5Xt0.5/ | 2 | 내자 | 무검사 | 0 / 0 | 0 | 모름
188 | __.__.04.__.__.__.__ | 30138578 |  | SPRING WASHER | M2.5XΦ5Xt0.8/ | 2 | 내자 | 무검사 | 0 / 0 | 0 | 모름
189 | __.__.05.__.__.__.__ | 30138583 |  | CONNECTOR | 850030177/ | 1 | 내자 | 무검사 | 0 / 0 | 0 | 전자부품
190 | __.03.__.__.__.__.__ | 60007435 |  | RH BOLT | M3 X L14/ | 8 | 내자 | 무검사 | 0 / 0 | 0 | 공용(볼트류)
191 | 12.__.__.__.__.__.__ | 30138640 | R1D000274 | PAC-MCU ASS'Y | ASS'Y/ | 1 | 내자 | 무검사 | 0 / 0 | 0 | 제관품
192 | __.01.__.__.__.__.__ | 20064069 | R1D000275 | PAC-MCU FRT PANEL ASS'Y | ASS'Y/ | 1 | 내자 | 무검사 | 0 / 0 | 0 | 제어PANEL류
193 | __.__.01.__.__.__.__ | 20064071 | R1D000276 | FRONT PANEL | AL, t=2.5/ | 1 | 내자 | 무검사 | 0 / 0 | 0 | 제어PANEL류
194 | __.__.02.__.__.__.__ | 30138570 |  | FIXING BOLT | 21101-101.M2.5,L=12.5/ | 1 | 내자 | 무검사 | 0 / 0 | 0 | 가공품
195 | __.__.03.__.__.__.__ | 30138571 |  | METAL SLEEVE | 21100-660/ | 1 | 내자 | 무검사 | 0 / 0 | 0 | 모름
196 | __.__.04.__.__.__.__ | 30138572 |  | OVAL BOLT | 21100-429,M2.5,L=8/ | 1 | 내자 | 무검사 | 0 / 0 | 0 | 가공품
197 | __.__.05.__.__.__.__ | 30138573 |  | PB HOLDER | 60807-181/ | 1 | 외작 | B | 0 / 0 | 0 | 가공품
198 | __.__.06.__.__.__.__ | 30138574 |  | BOLT | 21101-220,M2.5,L=10/ | 1 | 내자 | 무검사 | 0 / 0 | 0 | 가공품
199 | __.__.07.__.__.__.__ | 30138575 |  | HANDLE | CANTILEVER/ | 1 | 내자 | 무검사 | 0 / 0 | 0 | 가공품
200 | __.02.__.__.__.__.__ | 20064070 | R1D000277 | PAC-MCU PCB BOARD ASS'Y | ASS'Y/ | 1 | 내자 | 무검사 | 0 / 0 | 0 | P.C.B BOARD
201 | __.__.01.__.__.__.__ | 30138641 |  | PAC MCU PCB BOARD | ASS'Y/ | 1 | 외작 | 무검사 | 0 / 0 | 0 | PCB
202 | __.__.02.__.__.__.__ | 60007433 |  | RH BOLT | M2.5,L=12/ | 2 | 내자 | 무검사 | 0 / 0 | 0 | 공용(볼트류)
203 | __.__.03.__.__.__.__ | 30138577 |  | FLAT-WASHER | M2.5XΦ5Xt0.5/ | 2 | 내자 | 무검사 | 0 / 0 | 0 | 모름
204 | __.__.04.__.__.__.__ | 30138578 |  | SPRING WASHER | M2.5XΦ5Xt0.8/ | 2 | 내자 | 무검사 | 0 / 0 | 0 | 모름
205 | __.__.05.__.__.__.__ | 30138583 |  | CONNECTOR | 850030177/ | 1 | 내자 | 무검사 | 0 / 0 | 0 | 전자부품
206 | 13.__.__.__.__.__.__ | 30138642 | R1D000278 | PAC-VOL ASS'Y | ASS'Y/ | 1 | 내자 | 무검사 | 0 / 0 | 0 | 제관품
207 | __.01.__.__.__.__.__ | 20064072 | R1D000279 | PAC-VOL FRT PANEL ASS'Y | ASS'Y/ | 1 | 내자 | 무검사 | 0 / 0 | 0 | 제어PANEL류
208 | __.__.01.__.__.__.__ | 20064075 | R1D000280 | FRONT PANEL | AL, t=2.5/ | 1 | 내자 | 무검사 | 0 / 0 | 0 | 제어PANEL류
209 | __.__.02.__.__.__.__ | 30138570 |  | FIXING BOLT | 21101-101.M2.5,L=12.5/ | 1 | 내자 | 무검사 | 0 / 0 | 0 | 가공품
210 | __.__.03.__.__.__.__ | 30138571 |  | METAL SLEEVE | 21100-660/ | 1 | 내자 | 무검사 | 0 / 0 | 0 | 모름
211 | __.__.04.__.__.__.__ | 30138572 |  | OVAL BOLT | 21100-429,M2.5,L=8/ | 1 | 내자 | 무검사 | 0 / 0 | 0 | 가공품
212 | __.__.05.__.__.__.__ | 30138573 |  | PB HOLDER | 60807-181/ | 1 | 외작 | B | 0 / 0 | 0 | 가공품
213 | __.__.06.__.__.__.__ | 30138574 |  | BOLT | 21101-220,M2.5,L=10/ | 1 | 내자 | 무검사 | 0 / 0 | 0 | 가공품
214 | __.__.07.__.__.__.__ | 30138575 |  | HANDLE | CANTILEVER/ | 1 | 내자 | 무검사 | 0 / 0 | 0 | 가공품
215 | __.02.__.__.__.__.__ | 20064074 | R1D000281 | PAC-VOL PCB BOARD ASS'Y | ASS'Y/ | 1 | 내자 | 무검사 | 0 / 0 | 0 | P.C.B BOARD
216 | __.__.01.__.__.__.__ | 30138643 |  | PAC VOL PCB BOARD | ASS'Y/ | 1 | 외작 | 무검사 | 0 / 0 | 0 | PCB
217 | __.__.02.__.__.__.__ | 60007433 |  | RH BOLT | M2.5,L=12/ | 2 | 내자 | 무검사 | 0 / 0 | 0 | 공용(볼트류)
218 | __.__.03.__.__.__.__ | 30138577 |  | FLAT-WASHER | M2.5XΦ5Xt0.5/ | 2 | 내자 | 무검사 | 0 / 0 | 0 | 모름
219 | __.__.04.__.__.__.__ | 30138578 |  | SPRING WASHER | M2.5XΦ5Xt0.8/ | 2 | 내자 | 무검사 | 0 / 0 | 0 | 모름
220 | __.__.05.__.__.__.__ | 30138583 |  | CONNECTOR | 850030177/ | 1 | 내자 | 무검사 | 0 / 0 | 0 | 전자부품
221 | 14.__.__.__.__.__.__ | 30138644 | R1D000270 | PAC-INT ASS'Y | ASS'Y/ | 1 | 내자 | 무검사 | 0 / 0 | 0 | 제관품
222 | __.01.__.__.__.__.__ | 20064077 | R1D000271 | PAC-INT FRT PANEL ASS'Y | ASS'Y/ | 1 | 내자 | 무검사 | 0 / 0 | 0 | 제어PANEL류
223 | __.__.01.__.__.__.__ | 20064079 | R1D000272 | FRONT PANEL | AL, t=2.5/ | 1 | 내자 | 무검사 | 0 / 0 | 0 | 제어PANEL류
224 | __.__.02.__.__.__.__ | 30138570 |  | FIXING BOLT | 21101-101.M2.5,L=12.5/ | 1 | 내자 | 무검사 | 0 / 0 | 0 | 가공품
225 | __.__.03.__.__.__.__ | 30138571 |  | METAL SLEEVE | 21100-660/ | 1 | 내자 | 무검사 | 0 / 0 | 0 | 모름
226 | __.__.04.__.__.__.__ | 30138572 |  | OVAL BOLT | 21100-429,M2.5,L=8/ | 1 | 내자 | 무검사 | 0 / 0 | 0 | 가공품
227 | __.__.05.__.__.__.__ | 30138573 |  | PB HOLDER | 60807-181/ | 1 | 외작 | B | 0 / 0 | 0 | 가공품
228 | __.__.06.__.__.__.__ | 30138574 |  | BOLT | 21101-220,M2.5,L=10/ | 1 | 내자 | 무검사 | 0 / 0 | 0 | 가공품
229 | __.__.07.__.__.__.__ | 30138575 |  | HANDLE | CANTILEVER/ | 1 | 내자 | 무검사 | 0 / 0 | 0 | 가공품
230 | __.02.__.__.__.__.__ | 20064078 | R1D000273 | PAC-INT PCB BOARD ASS'Y | ASS'Y/ | 1 | 내자 | 무검사 | 0 / 0 | 0 | P.C.B BOARD
231 | __.__.01.__.__.__.__ | 30138649 |  | PAC INT PCB BOARD | ASS'Y/ | 1 | 외작 | 무검사 | 0 / 0 | 0 | PCB
232 | __.__.02.__.__.__.__ | 60007433 |  | RH BOLT | M2.5,L=12/ | 2 | 내자 | 무검사 | 0 / 0 | 0 | 공용(볼트류)
233 | __.__.03.__.__.__.__ | 30138577 |  | FLAT-WASHER | M2.5XΦ5Xt0.5/ | 2 | 내자 | 무검사 | 0 / 0 | 0 | 모름
234 | __.__.04.__.__.__.__ | 30138578 |  | SPRING WASHER | M2.5XΦ5Xt0.8/ | 2 | 내자 | 무검사 | 0 / 0 | 0 | 모름
235 | __.__.05.__.__.__.__ | 30138583 |  | CONNECTOR | 850030177/ | 1 | 내자 | 무검사 | 0 / 0 | 0 | 전자부품
236 | 15.__.__.__.__.__.__ | 30138650 | R1D000242 | AAB1 ASS'Y | ASS'Y/ | 1 | 내자 | 무검사 | 0 / 0 | 0 | 제관품
237 | __.01.__.__.__.__.__ | 20064080 | R1D000243 | AAB1 FRT PANEL ASS'Y | ASS'Y/ | 1 | 내자 | 무검사 | 0 / 0 | 0 | 제어PANEL류
238 | __.__.01.__.__.__.__ | 20064082 | R1D000319 | FRONT PANEL | AL, t=2.5/ | 1 | 내자 | 무검사 | 0 / 0 | 0 | 제어PANEL류
239 | __.__.02.__.__.__.__ | 30138570 |  | FIXING BOLT | 21101-101.M2.5,L=12.5/ | 3 | 내자 | 무검사 | 0 / 0 | 0 | 가공품
240 | __.__.03.__.__.__.__ | 30138571 |  | METAL SLEEVE | 21100-660/ | 3 | 내자 | 무검사 | 0 / 0 | 0 | 모름
241 | __.__.04.__.__.__.__ | 30138572 |  | OVAL BOLT | 21100-429,M2.5,L=8/ | 2 | 내자 | 무검사 | 0 / 0 | 0 | 가공품
242 | __.__.05.__.__.__.__ | 30138573 |  | PB HOLDER | 60807-181/ | 2 | 외작 | B | 0 / 0 | 0 | 가공품
243 | __.__.06.__.__.__.__ | 30138574 |  | BOLT | 21101-220,M2.5,L=10/ | 2 | 내자 | 무검사 | 0 / 0 | 0 | 가공품
244 | __.__.07.__.__.__.__ | 30138575 |  | HANDLE | CANTILEVER/ | 1 | 내자 | 무검사 | 0 / 0 | 0 | 가공품
245 | __.02.__.__.__.__.__ | 20064081 | R1D000244 | AAB1 PCB BOARD ASS'Y | ASS'Y/ | 1 | 내자 | 무검사 | 0 / 0 | 0 | P.C.B BOARD
246 | __.__.01.__.__.__.__ | 30138651 |  | AAB1 PCB BOARD | ASS'Y/ | 1 | 외작 | 무검사 | 0 / 0 | 0 | PCB
247 | __.__.02.__.__.__.__ | 60007433 |  | RH BOLT | M2.5,L=12/ | 2 | 내자 | 무검사 | 0 / 0 | 0 | 공용(볼트류)
248 | __.__.03.__.__.__.__ | 30138577 |  | FLAT-WASHER | M2.5XΦ5Xt0.5/ | 2 | 내자 | 무검사 | 0 / 0 | 0 | 모름
249 | __.__.04.__.__.__.__ | 30138578 |  | SPRING WASHER | M2.5XΦ5Xt0.8/ | 2 | 내자 | 무검사 | 0 / 0 | 0 | 모름
250 | __.__.05.__.__.__.__ | 30138583 |  | CONNECTOR | 850030177/ | 1 | 내자 | 무검사 | 0 / 0 | 0 | 전자부품
251 | __.__.06.__.__.__.__ | 30138637 |  | CONNECTOR | MSG59P-L111/ | 1 | 내자 | 무검사 | 0 / 0 | 0 | 전자부품
252 | 16.__.__.__.__.__.__ | 30138652 | R1D000245 | AAB2 ASS'Y | ASS'Y/ | 1 | 내자 | 무검사 | 0 / 0 | 0 | 제관품
253 | __.01.__.__.__.__.__ | 20064083 | R1D000246 | AAB2 FRT PANEL ASS'Y | ASS'Y/ | 1 | 내자 | 무검사 | 0 / 0 | 0 | 제어PANEL류
254 | __.__.01.__.__.__.__ | 20064086 | R1D000247 | FRONT PANEL | AL, t=2.5/ | 1 | 내자 | 무검사 | 0 / 0 | 0 | 제어PANEL류
255 | __.__.02.__.__.__.__ | 30138570 |  | FIXING BOLT | 21101-101.M2.5,L=12.5/ | 3 | 내자 | 무검사 | 0 / 0 | 0 | 가공품
256 | __.__.03.__.__.__.__ | 30138571 |  | METAL SLEEVE | 21100-660/ | 3 | 내자 | 무검사 | 0 / 0 | 0 | 모름
257 | __.__.04.__.__.__.__ | 30138572 |  | OVAL BOLT | 21100-429,M2.5,L=8/ | 2 | 내자 | 무검사 | 0 / 0 | 0 | 가공품
258 | __.__.05.__.__.__.__ | 30138573 |  | PB HOLDER | 60807-181/ | 2 | 외작 | B | 0 / 0 | 0 | 가공품
259 | __.__.06.__.__.__.__ | 30138574 |  | BOLT | 21101-220,M2.5,L=10/ | 2 | 내자 | 무검사 | 0 / 0 | 0 | 가공품
260 | __.__.07.__.__.__.__ | 30138575 |  | HANDLE | CANTILEVER/ | 1 | 내자 | 무검사 | 0 / 0 | 0 | 가공품
261 | __.02.__.__.__.__.__ | 20064085 | R1D000248 | AAB1 PCB BOARD ASS'Y | ASS'Y/ | 1 | 내자 | 무검사 | 0 / 0 | 0 | P.C.B BOARD
262 | __.__.01.__.__.__.__ | 30138656 |  | AAB2 PCB BOARD | ASS'Y/ | 1 | 외작 | 무검사 | 0 / 0 | 0 | PCB
263 | __.__.02.__.__.__.__ | 60007433 |  | RH BOLT | M2.5,L=12/ | 2 | 내자 | 무검사 | 0 / 0 | 0 | 공용(볼트류)
264 | __.__.03.__.__.__.__ | 30138577 |  | FLAT-WASHER | M2.5XΦ5Xt0.5/ | 2 | 내자 | 무검사 | 0 / 0 | 0 | 모름
265 | __.__.04.__.__.__.__ | 30138578 |  | SPRING WASHER | M2.5XΦ5Xt0.8/ | 2 | 내자 | 무검사 | 0 / 0 | 0 | 모름
266 | __.__.05.__.__.__.__ | 30138583 |  | CONNECTOR | 850030177/ | 1 | 내자 | 무검사 | 0 / 0 | 0 | 전자부품
267 | 17.__.__.__.__.__.__ | 30138657 | R1D000249 | AMP PWR ASS'Y | ASS'Y/ | 1 | 내자 | 무검사 | 0 / 0 | 0 | 제관품
268 | __.01.__.__.__.__.__ | 20064087 | R1D000251 | AMP PWR FRT PANEL ASS'Y | ASS'Y/ | 1 | 내자 | 무검사 | 0 / 0 | 0 | 제어PANEL류
269 | __.__.01.__.__.__.__ | 20064090 | R1D000250 | FRONT PANEL | AL, t=2.5/ | 1 | 내자 | 무검사 | 0 / 0 | 0 | 제어PANEL류
270 | __.__.02.__.__.__.__ | 30138570 |  | FIXING BOLT | 21101-101.M2.5,L=12.5/ | 3 | 내자 | 무검사 | 0 / 0 | 0 | 가공품
271 | __.__.03.__.__.__.__ | 30138571 |  | METAL SLEEVE | 21100-660/ | 3 | 내자 | 무검사 | 0 / 0 | 0 | 모름
272 | __.__.04.__.__.__.__ | 30138572 |  | OVAL BOLT | 21100-429,M2.5,L=8/ | 2 | 내자 | 무검사 | 0 / 0 | 0 | 가공품
273 | __.__.05.__.__.__.__ | 30138573 |  | PB HOLDER | 60807-181/ | 2 | 외작 | B | 0 / 0 | 0 | 가공품
274 | __.__.06.__.__.__.__ | 30138574 |  | BOLT | 21101-220,M2.5,L=10/ | 2 | 내자 | 무검사 | 0 / 0 | 0 | 가공품
275 | __.__.07.__.__.__.__ | 30138575 |  | HANDLE | CANTILEVER/ | 1 | 내자 | 무검사 | 0 / 0 | 0 | 가공품
276 | __.02.__.__.__.__.__ | 20064089 | R1D000252 | AMP PWR PCB BOARD ASS'Y | ASS'Y/ | 1 | 내자 | 무검사 | 0 / 0 | 0 | P.C.B BOARD
277 | __.__.01.__.__.__.__ | 30138658 |  | AMP PWR PCB BOARD | ASS'Y/ | 1 | 외작 | 무검사 | 0 / 0 | 0 | PCB
278 | __.__.02.__.__.__.__ | 60007433 |  | RH BOLT | M2.5,L=12/ | 2 | 내자 | 무검사 | 0 / 0 | 0 | 공용(볼트류)
279 | __.__.03.__.__.__.__ | 30138577 |  | FLAT-WASHER | M2.5XΦ5Xt0.5/ | 2 | 내자 | 무검사 | 0 / 0 | 0 | 모름
280 | __.__.04.__.__.__.__ | 30138578 |  | SPRING WASHER | M2.5XΦ5Xt0.8/ | 2 | 내자 | 무검사 | 0 / 0 | 0 | 모름
281 | __.__.05.__.__.__.__ | 30136180 |  | CONNECTOR | ASS'Y/ASS'Y | 1 | 내자 | 무검사 | 0 / 0 | 0 | 전기부품
282 | __.__.06.__.__.__.__ | 30138579 |  | LIGHTING | ASS'Y/ | 2 | 내자 | 무검사 | 0 / 0 | 0 | 전기부품
283 | __.__.07.__.__.__.__ | 30135054 |  | HEAT SINK | ASS'Y/ | 1 | 내자 | 무검사 | 0 / 0 | 0 | 전자부품
284 | 18.__.__.__.__.__.__ | 30139264 |  | PACR RACK | 21inch,120HP,SCHROFF/ASS'Y | 2 | 내작 | 무검사 | 0 / 0 | 0 | 제관품
285 | 19.__.__.__.__.__.__ | 30139312 | R1D000452(01) | NAME PLATE(CRA) | t=1.0/AL | 1 | 내자 | 무검사 | 0 / 0 | 0 | 명판
286 | 20.__.__.__.__.__.__ | 30138967 |  | CONNECTOR | BCP-C5FA/ | 2 | 외자 | C | 0 / 0 | 0 | 전자부품
287 | 21.__.__.__.__.__.__ | 30138968 |  | CONNECTOR | FRITS4102R14S-07PB1G1F6/ | 1 | 외자 | C | 0 / 0 | 0 | 전자부품
288 | 22.__.__.__.__.__.__ | 30138969 |  | CONNECTOR | FRITS4106F14S-07SB1F6/ | 1 | 외자 | C | 0 / 0 | 0 | 전자부품
289 | 23.__.__.__.__.__.__ | 30138970 |  | CONNECTOR | 801-009-07M9-210PA/ | 3 | 외자 | C | 0 / 0 | 0 | 전자부품
290 | 24.__.__.__.__.__.__ | 30138972 |  | CONNECTOR | 801-007-16M9-210SA/ | 3 | 외자 | C | 0 / 0 | 0 | 전자부품
291 | 25.__.__.__.__.__.__ | 30138973 |  | CONNECTOR | FRITS4102R14S-07PB0G1F6/ | 1 | 외자 | C | 0 / 0 | 0 | 전자부품
292 | 26.__.__.__.__.__.__ | 30138974 |  | CONNECTOR | FRITS4106F14S-07SB0F6/ | 1 | 외자 | C | 0 / 0 | 0 | 전자부품
293 | 27.__.__.__.__.__.__ | 30138975 |  | CONNECTOR | MSG59RR-L111/ | 1 | 외자 | C | 0 / 0 | 0 | 전자부품
294 | 28.__.__.__.__.__.__ | 30138976 |  | CONNECTOR | MSG59/ | 1 | 외자 | C | 0 / 0 | 0 | 전자부품
295 | 29.__.__.__.__.__.__ | 30138977 |  | CONNECTOR | FRITS4102R16S-1PB0G1F6/ | 1 | 외자 | C | 0 / 0 | 0 | 전자부품
296 | 30.__.__.__.__.__.__ | 30138978 |  | CONNECTOR | FRITS4106F16S-1SB0F6/ | 1 | 외자 | C | 0 / 0 | 0 | 전자부품
297 | 31.__.__.__.__.__.__ | 30138979 |  | CONNECTOR | FRITS4102F20-29PB0G1F6/ | 1 | 외자 | C | 0 / 0 | 0 | 전자부품
298 | 32.__.__.__.__.__.__ | 30138980 |  | CONNECTOR | FRITS4106F20-29SB0F6/ | 1 | 외자 | C | 0 / 0 | 0 | 전자부품
299 | 33.__.__.__.__.__.__ | 30138976 |  | CONNECTOR | MSG59/ | 1 | 외자 | C | 0 / 0 | 0 | 전자부품
300 | 34.__.__.__.__.__.__ | 60007449 |  | FLAT HEAD SCREW BOLT | M4X8/ | 32 | 내자 | 무검사 | 0 / 0 | 0 | 공용(볼트류)
