JDSCS-Club/DENVER_CCP/DOC/02_설계_도면/BOM/csp.xlsx

 |  |  |  |  |  | B O M L I S T
BOM 번호: 10007321-01 [10007321][R1D1473-25859][] (CSP)Cab Speaker Ass'y
BOM 설명: 미국 DENVER CSP
No | LEVEL | 품목코드 | 도면번호 |  | 품 명 |  | 수량 SET수량 | 조달 형태 | 품질 등급 | 구매L/T 양산/개발 | 표준 공수 | 품목형태
1 | 01.__.__.__.__.__.__ | 30139000 | R1D000412 | BOX ASS'Y |  | ASS'Y/ | 1 | 외작 | C | 0 / 0 | 0 | 제관품
2 | __.01.__.__.__.__.__ | 30139001 | R1D000409 | FRONT PLATE |  | ASS'Y/ | 1 | 외작 | C | 0 / 0 | 0 | 제관품
3 | __.__.01.__.__.__.__ | 30139005 |  | PANEL |  | 366-91,t3.0/ | 1 | 외작 | C | 0 / 0 | 0 | 제관품
4 | __.__.02.__.__.__.__ | 30139488 |  | WELDING NUT |  | D6,M4,L6/ | 4 | 내자 | 무검사 | 0 / 0 | 0 | 제관품
5 | __.02.__.__.__.__.__ | 30139002 | R1D000407 | BRACKET |  | ASS'Y/ | 4 | 외작 | C | 0 / 0 | 0 | 제관품
6 | __.__.01.__.__.__.__ | 30139007 |  | BRACKET |  | A366-91,t=1.2/ | 1 | 외작 | C | 0 / 0 | 0 | 제관품
7 | __.__.02.__.__.__.__ | 30139489 |  | HEXA HEAD STANDOF |  | D6,M4,L10.8/ | 2 | 내자 | 무검사 | 0 / 0 | 0 | 가공품
8 | __.__.03.__.__.__.__ | 30139487 |  | CLINCHING NUT |  | M3,L2/ | 4 | 내자 | 무검사 | 0 / 0 | 0 | 시중품
9 | __.03.__.__.__.__.__ | 30139003 | R1D000408 | COVER |  | ASS'Y/ | 2 | 외작 | C | 0 / 0 | 0 | 제관품
10 | __.__.01.__.__.__.__ | 30139009 |  | COVER |  | A366-91,t1.0/ | 1 | 외작 | C | 0 / 0 | 0 | 제관품
11 | __.__.02.__.__.__.__ | 30139490 |  | CLINCHING NUT |  | D6,M3,L2/ | 2 | 내자 | 무검사 | 0 / 0 | 0 | 시중품
12 | __.04.__.__.__.__.__ | 30139004 | R4D000411 | PLATE |  | ASS'Y/ | 2 | 외작 | C | 0 / 0 | 0 | 제관품
13 | __.__.01.__.__.__.__ | 30139010 |  | PLATE |  | A366-91,t=1.0/ | 1 | 외작 | C | 0 / 0 | 0 | 제관품
14 | 02.__.__.__.__.__.__ | 30138988 | R1D000405 | SPEAKER |  | CW-100B25/ | 1 | 내자 | C | 0 / 0 | 0 | 전기부품
15 | 03.__.__.__.__.__.__ | 30139011 |  | VOLUME CONTROL |  | VW50/ | 1 | 외자 | 무검사 | 0 / 0 | 0 | 전기부품
16 | 04.__.__.__.__.__.__ | 30118493 |  | CONNECTOR |  | 231-603/019-000/ | 1 | 내자 | C | 0 / 0 | 0 | 전기부품
17 | 05.__.__.__.__.__.__ | 30118494 |  | CONNECTOR |  | 231-103/037-000/ | 1 | 내자 | C | 0 / 0 | 0 | 전기부품
18 | 06.__.__.__.__.__.__ | 30139324 | R1D000452(13) | NAME PLATE(CSP) |  | t=1.0/AL | 1 | 내자 | 무검사 | 0 / 0 | 0 | 명판
19 | 07.__.__.__.__.__.__ | 30138939 | R1D000397 | GROMMET(ISP, ESP, CSP) |  | RUBBER/ | 1 | 외작 | 무검사 | 0 / 0 | 0 | 모름
20 | __.01.__.__.__.__.__ | 30139484 |  | GROMMET |  | EPDM,φ15mm(0.59)/ | 1 | 내자 | 무검사 | 0 / 0 | 0 | 모름
21 | 08.__.__.__.__.__.__ | 30139013 |  | EMC GASKET |  | SF050010R-C-NA-A/ | 1 | 내자 | 무검사 | 0 / 0 | 0 | 시중품
22 | 09.__.__.__.__.__.__ | 30139014 |  | BOLT&WASHER LIST |  | ASS'Y/ | 1 | 내자 | 무검사 | 0 / 0 | 0 | 모름
23 | 10.__.__.__.__.__.__ | 30139491 | R1D000410 | CSP GASKET |  | t=5.0/RUBBER | 1 | 내자 | 무검사 | 0 / 0 | 0 | 시중품
24 | 11.__.__.__.__.__.__ | 30139304 | R1D000449(01) | MESH(ESP,ISP,CSP) |  | ASS'Y/ | 1 | 내자 | 무검사 | 0 / 0 | 0 | 모름
25 | __.01.__.__.__.__.__ | 30139305 |  | MESH |  | SCREEN#24,φ0.3,OPEN 50%/304SS | 1 | 내자 | 무검사 | 0 / 0 | 0 | 시중품
26 | __.02.__.__.__.__.__ | 30139306 | R1D000449(02) | SHEET |  | 304SS,t=0.7/ | 2 | 내자 | 무검사 | 0 / 0 | 0 | 가공품
27 | 12.__.__.__.__.__.__ | 20064169 | R1D000499 | CSP WIRING DIAGRAM |  | ASS'Y/ | 1 | 내작 | 무검사 | 0 / 0 | 0 | 하네스도
28 | __.01.__.__.__.__.__ | 30054010 |  | WIRE |  | 100G0111-1.2-0/ | 1 | 외자 | 무검사 | 0 / 0 | 0 | 전기부품
29 | __.02.__.__.__.__.__ | 30124437 |  | FERRULES SLEEVE |  | 0.75SQ, 6mm/ | 2 | 내자 | 무검사 | 0 / 0 | 0 | 전자부품
30 | 13.__.__.__.__.__.__ | 30139492 | R1D000501 | CSP VW50&KNOB |  | ASS'Y/ | 1 | 내작 | A | 0 / 0 | 0 | 가공품
31 | __.01.__.__.__.__.__ | 30139493 |  | POTENSION METER |  | VW50/ | 1 | 내자 | 무검사 | 0 / 0 | 0 | 모름
32 | __.02.__.__.__.__.__ | 30098195 |  | KNOB |  | F-9/ | 1 | 외작 | B | 0 / 0 | 0 | 가공품
