JDSCS-Club/DENVER_CCP/DOC/02_설계_도면/BOM/DENVER 파트리스트.xlsx

Sheet: cra
 |  |  |  | B O M L I S T
BOM 번호: 10007307-01 [10007307][R1D1473-25838][] (CRA)COMMUNICATIONS RACK-A
BOM 설명: 미국 DENVER CRA
No | LEVEL | 품목코드 | 도면번호 | 품 명 | 품 명 | 수량 SET수량 | 조달 형태 | 품질 등급 | 구매L/T 양산/개발 | 표준 공수 | 품목형태
1 | 01.__.__.__.__.__.__ | 30138569 | R1D000283 | POWER SUPPLY | ASS'Y/ | 1 | 외작 | 무검사 | 0 / 0 | 0 | 제관품
2 | __.01.__.__.__.__.__ | 20064035 | R1D000285 | PWR FRT PANEL ASS'Y | ASS'Y/ | 1 | 외작 | 무검사 | 0 / 0 | 0 | 제어PANEL류
3 | __.__.01.__.__.__.__ | 20064036 | R1D000284 | FRONT PANEL | AL, t=2.5/ | 1 | 내자 | 무검사 | 0 / 0 | 0 | 제어PANEL류
4 | __.__.02.__.__.__.__ | 30138570 |  | FIXING BOLT | 21101-101.M2.5,L=12.5/ | 3 | 내자 | 무검사 | 0 / 0 | 0 | 가공품
5 | __.__.03.__.__.__.__ | 30138571 |  | METAL SLEEVE | 21100-660/ | 3 | 내자 | 무검사 | 0 / 0 | 0 | 모름
6 | __.__.04.__.__.__.__ | 30138572 |  | OVAL BOLT | 21100-429,M2.5,L=8/ | 2 | 내자 | 무검사 | 0 / 0 | 0 | 가공품
7 | __.__.05.__.__.__.__ | 30138573 |  | PB HOLDER | 60807-181/ | 2 | 외작 | B | 0 / 0 | 0 | 가공품
8 | __.__.06.__.__.__.__ | 30138574 |  | BOLT | 21101-220,M2.5,L=10/ | 2 | 내자 | 무검사 | 0 / 0 | 0 | 가공품
9 | __.__.07.__.__.__.__ | 30138575 |  | HANDLE | CANTILEVER/ | 1 | 내자 | 무검사 | 0 / 0 | 0 | 가공품
10 | __.02.__.__.__.__.__ | 20064037 | R1D000286 | PWR PCB BOARD ASS'Y | ASS'Y/ | 1 | 내자 | 무검사 | 0 / 0 | 0 | P.C.B BOARD
11 | __.__.01.__.__.__.__ | 30138576 |  | PWR PCB BOARD | ASS'Y/ | 1 | 내자 | 무검사 | 0 / 0 | 0 | PCB
12 | __.__.02.__.__.__.__ | 60007433 |  | RH BOLT | M2.5,L=12/ | 2 | 내자 | 무검사 | 0 / 0 | 0 | 공용(볼트류)
13 | __.__.03.__.__.__.__ | 30138577 |  | FLAT-WASHER | M2.5XΦ5Xt0.5/ | 2 | 내자 | 무검사 | 0 / 0 | 0 | 모름
14 | __.__.04.__.__.__.__ | 30138578 |  | SPRING WASHER | M2.5XΦ5Xt0.8/ | 2 | 내자 | 무검사 | 0 / 0 | 0 | 모름
15 | __.__.05.__.__.__.__ | 30136180 |  | CONNECTOR | ASS'Y/ASS'Y | 1 | 내자 | 무검사 | 0 / 0 | 0 | 전기부품
16 | __.__.06.__.__.__.__ | 30138579 |  | LIGHTING | ASS'Y/ | 2 | 내자 | 무검사 | 0 / 0 | 0 | 전기부품
17 | __.__.07.__.__.__.__ | 30138580 |  | HEATSINK | ASS'Y/ | 1 | 내자 | 무검사 | 0 / 0 | 0 | 가공품
18 | 02.__.__.__.__.__.__ | 30138581 | R1D000296 | SP ASS'Y | ASS'Y/ | 1 | 내자 | 무검사 | 0 / 0 | 0 | 가공품
19 | __.01.__.__.__.__.__ | 20064038 | R1D000297 | SP FRT PANEL ASS'Y | ASS'Y/ | 1 | 내자 | 무검사 | 0 / 0 | 0 | 제어PANEL류
20 | __.__.01.__.__.__.__ | 20064040 | R1D000298 | FRONT PANEL | AL, t=2.5/ | 1 | 내자 | 무검사 | 0 / 0 | 0 | 제어PANEL류
21 | __.__.02.__.__.__.__ | 30138570 |  | FIXING BOLT | 21101-101.M2.5,L=12.5/ | 1 | 내자 | 무검사 | 0 / 0 | 0 | 가공품
22 | __.__.03.__.__.__.__ | 30138571 |  | METAL SLEEVE | 21100-660/ | 1 | 내자 | 무검사 | 0 / 0 | 0 | 모름
23 | __.__.04.__.__.__.__ | 30138572 |  | OVAL BOLT | 21100-429,M2.5,L=8/ | 1 | 내자 | 무검사 | 0 / 0 | 0 | 가공품
24 | __.__.05.__.__.__.__ | 30138573 |  | PB HOLDER | 60807-181/ | 1 | 외작 | B | 0 / 0 | 0 | 가공품
25 | __.__.06.__.__.__.__ | 30138574 |  | BOLT | 21101-220,M2.5,L=10/ | 1 | 내자 | 무검사 | 0 / 0 | 0 | 가공품
26 | __.__.07.__.__.__.__ | 30138575 |  | HANDLE | CANTILEVER/ | 1 | 내자 | 무검사 | 0 / 0 | 0 | 가공품
27 | __.02.__.__.__.__.__ | 20064039 | R1D000299 | SP PCB BOARD ASS'Y | ASS'Y/ | 1 | 내자 | 무검사 | 0 / 0 | 0 | P.C.B BOARD
28 | __.__.01.__.__.__.__ | 30138582 |  | SP PCB BOARD | ASS'Y/ | 1 | 내자 | 무검사 | 0 / 0 | 0 | PCB
29 | __.__.02.__.__.__.__ | 60007433 |  | RH BOLT | M2.5,L=12/ | 2 | 내자 | 무검사 | 0 / 0 | 0 | 공용(볼트류)
30 | __.__.03.__.__.__.__ | 30138577 |  | FLAT-WASHER | M2.5XΦ5Xt0.5/ | 2 | 내자 | 무검사 | 0 / 0 | 0 | 모름
31 | __.__.04.__.__.__.__ | 30138578 |  | SPRING WASHER | M2.5XΦ5Xt0.8/ | 2 | 내자 | 무검사 | 0 / 0 | 0 | 모름
32 | __.__.05.__.__.__.__ | 30138583 |  | CONNECTOR | 850030177/ | 1 | 내자 | 무검사 | 0 / 0 | 0 | 전자부품
33 | 03.__.__.__.__.__.__ | 30138584 | R1D000304 | VTX ASS'Y | ASS'Y/ | 1 | 내자 | 무검사 | 0 / 0 | 0 | 제관품
34 | __.01.__.__.__.__.__ | 20064041 | R1D000305 | VTX FRT PANEL ASS'Y | ASS'Y/ | 1 | 내자 | 무검사 | 0 / 0 | 0 | 제어PANEL류
35 | __.__.01.__.__.__.__ | 20064043 | R1D000306 | FRONT PANEL | AL, t=2.5/ | 1 | 내자 | 무검사 | 0 / 0 | 0 | 제어PANEL류
36 | __.__.02.__.__.__.__ | 30138570 |  | FIXING BOLT | 21101-101.M2.5,L=12.5/ | 1 | 내자 | 무검사 | 0 / 0 | 0 | 가공품
37 | __.__.03.__.__.__.__ | 30138571 |  | METAL SLEEVE | 21100-660/ | 1 | 내자 | 무검사 | 0 / 0 | 0 | 모름
38 | __.__.04.__.__.__.__ | 30138572 |  | OVAL BOLT | 21100-429,M2.5,L=8/ | 1 | 내자 | 무검사 | 0 / 0 | 0 | 가공품
39 | __.__.05.__.__.__.__ | 30138573 |  | PB HOLDER | 60807-181/ | 1 | 외작 | B | 0 / 0 | 0 | 가공품
40 | __.__.06.__.__.__.__ | 30138574 |  | BOLT | 21101-220,M2.5,L=10/ | 1 | 내자 | 무검사 | 0 / 0 | 0 | 가공품
41 | __.__.07.__.__.__.__ | 30138575 |  | HANDLE | CANTILEVER/ | 1 | 내자 | 무검사 | 0 / 0 | 0 | 가공품
42 | __.02.__.__.__.__.__ | 20064042 | R1D000307 | VTX PCB BOARD ASS'Y | ASS'Y/ | 1 | 내자 | 무검사 | 0 / 0 | 0 | P.C.B BOARD
43 | __.__.01.__.__.__.__ | 30138585 |  | VTX BOARD ASS'Y | ASS'Y/ | 1 | 내자 | 무검사 | 0 / 0 | 0 | PCB
44 | __.__.02.__.__.__.__ | 60007433 |  | RH BOLT | M2.5,L=12/ | 2 | 내자 | 무검사 | 0 / 0 | 0 | 공용(볼트류)
45 | __.__.03.__.__.__.__ | 30138577 |  | FLAT-WASHER | M2.5XΦ5Xt0.5/ | 2 | 내자 | 무검사 | 0 / 0 | 0 | 모름
46 | __.__.04.__.__.__.__ | 30138578 |  | SPRING WASHER | M2.5XΦ5Xt0.8/ | 2 | 내자 | 무검사 | 0 / 0 | 0 | 모름
47 | __.__.05.__.__.__.__ | 30138586 |  | CONNECTOR | 364915/ | 1 | 내자 | 무검사 | 0 / 0 | 0 | 전자부품
48 | __.__.06.__.__.__.__ | 30138587 |  | LIGHTING | 7511A62/ | 1 | 내자 | 무검사 | 0 / 0 | 0 | 전기부품
49 | __.__.07.__.__.__.__ | 30138588 |  | D-SUB CONNECTOR | 748390,15F/ | 1 | 내자 | 무검사 | 0 / 0 | 0 | 전기부품
50 | __.__.08.__.__.__.__ | 30138589 |  | BNC CONNECTOR | CTP-BR-4001-Z,75ohm/ | 2 | 내자 | 무검사 | 0 / 0 | 0 | 전기부품
51 | __.__.09.__.__.__.__ | 30138590 |  | U5 IC SOCKET | 28PIN/ | 1 | 내자 | 무검사 | 0 / 0 | 0 | 전자부품
52 | __.__.10.__.__.__.__ | 30138591 |  | U5-IC | MAX1480ECEPI/ | 1 | 내자 | 무검사 | 0 / 0 | 0 | 모름
53 | 04.__.__.__.__.__.__ | 30138592 | R1D000253 | CNCS ASS'Y | ASS'Y/ | 1 | 내자 | 무검사 | 0 / 0 | 0 | 제관품
54 | __.01.__.__.__.__.__ | 20064044 | R1D000255 | CNCS FRT PANEL ASS'Y | ASS'Y/ | 1 | 내자 | 무검사 | 0 / 0 | 0 | 제어PANEL류
55 | __.__.01.__.__.__.__ | 20064046 | R1D000254 | FRONT PANEL | AL, t=2.5/ | 1 | 내자 | 무검사 | 0 / 0 | 0 | 제어PANEL류
56 | __.__.02.__.__.__.__ | 30138570 |  | FIXING BOLT | 21101-101.M2.5,L=12.5/ | 3 | 내자 | 무검사 | 0 / 0 | 0 | 가공품
57 | __.__.03.__.__.__.__ | 30138571 |  | METAL SLEEVE | 21100-660/ | 3 | 내자 | 무검사 | 0 / 0 | 0 | 모름
58 | __.__.04.__.__.__.__ | 30138572 |  | OVAL BOLT | 21100-429,M2.5,L=8/ | 1 | 내자 | 무검사 | 0 / 0 | 0 | 가공품
59 | __.__.05.__.__.__.__ | 30138573 |  | PB HOLDER | 60807-181/ | 1 | 외작 | B | 0 / 0 | 0 | 가공품
60 | __.__.06.__.__.__.__ | 30138574 |  | BOLT | 21101-220,M2.5,L=10/ | 1 | 내자 | 무검사 | 0 / 0 | 0 | 가공품
61 | __.__.07.__.__.__.__ | 30138575 |  | HANDLE | CANTILEVER/ | 1 | 내자 | 무검사 | 0 / 0 | 0 | 가공품
62 | __.02.__.__.__.__.__ | 20064045 | R1D000256 | CNCS PCB BOARD ASS'Y | ASS'Y/ | 1 | 내자 | 무검사 | 0 / 0 | 0 | P.C.B BOARD
63 | __.__.01.__.__.__.__ | 30138593 |  | CNCS PCB BOARD | ASS'Y/ | 1 | 내자 | 무검사 | 0 / 0 | 0 | PCB
64 | __.__.02.__.__.__.__ | 60007433 |  | RH BOLT | M2.5,L=12/ | 2 | 내자 | 무검사 | 0 / 0 | 0 | 공용(볼트류)
65 | __.__.03.__.__.__.__ | 30138577 |  | FLAT-WASHER | M2.5XΦ5Xt0.5/ | 2 | 내자 | 무검사 | 0 / 0 | 0 | 모름
66 | __.__.04.__.__.__.__ | 30138578 |  | SPRING WASHER | M2.5XΦ5Xt0.8/ | 2 | 내자 | 무검사 | 0 / 0 | 0 | 모름
67 | __.__.05.__.__.__.__ | 30138594 |  | CONNECTOR | 364918/ | 1 | 내자 | 무검사 | 0 / 0 | 0 | 전자부품
68 | __.__.06.__.__.__.__ | 30138587 |  | LIGHTING | 7511A62/ | 3 | 내자 | 무검사 | 0 / 0 | 0 | 전기부품
69 | __.__.07.__.__.__.__ | 30138595 |  | USB CONNECTOR | USB-A-2L/ | 7 | 내자 | 무검사 | 0 / 0 | 0 | 시중품
70 | __.__.08.__.__.__.__ | 30138596 |  | D-USB CONNECTOR | 748390,15F/ | 1 | 내자 | 무검사 | 0 / 0 | 0 | 전자부품
71 | __.__.09.__.__.__.__ | 30138597 |  | HEAT SINK | ASS'Y/ | 1 | 내자 | 무검사 | 0 / 0 | 0 | 가공품
72 | __.__.10.__.__.__.__ | 30138599 |  | MODULE | CONGA-X945/ | 1 | 내자 | 무검사 | 0 / 0 | 0 | 전자부품
73 | __.__.11.__.__.__.__ | 30138605 |  | CONNECTOR | X945-FX8-100-SV/ | 4 | 내자 | 무검사 | 0 / 0 | 0 | 전자부품
74 | __.03.__.__.__.__.__ | 60007434 |  | RH BOLT | M5 X L14/ | 4 | 내자 | 무검사 | 0 / 0 | 0 | 공용(볼트류)
75 | 05.__.__.__.__.__.__ | 30138609 | R1D000258 | HDD ASS'Y | ASS'Y/ | 1 | 내자 | 무검사 | 0 / 0 | 0 | 제관품
76 | __.01.__.__.__.__.__ | 20064047 | R1D000260 | HDD FRT PANEL ASS'Y | ASS'Y/ | 1 | 내자 | 무검사 | 0 / 0 | 0 | 제어PANEL류
77 | __.__.01.__.__.__.__ | 20064049 | R1D000259 | FRONT PANEL | AL, t=2.5/ | 1 | 내자 | 무검사 | 0 / 0 | 0 | 제어PANEL류
78 | __.__.02.__.__.__.__ | 30138570 |  | FIXING BOLT | 21101-101.M2.5,L=12.5/ | 1 | 내자 | 무검사 | 0 / 0 | 0 | 가공품
79 | __.__.03.__.__.__.__ | 30138571 |  | METAL SLEEVE | 21100-660/ | 1 | 내자 | 무검사 | 0 / 0 | 0 | 모름
80 | __.__.04.__.__.__.__ | 30138572 |  | OVAL BOLT | 21100-429,M2.5,L=8/ | 1 | 내자 | 무검사 | 0 / 0 | 0 | 가공품
81 | __.__.05.__.__.__.__ | 30138573 |  | PB HOLDER | 60807-181/ | 1 | 외작 | B | 0 / 0 | 0 | 가공품
82 | __.__.06.__.__.__.__ | 30138574 |  | BOLT | 21101-220,M2.5,L=10/ | 1 | 내자 | 무검사 | 0 / 0 | 0 | 가공품
83 | __.__.07.__.__.__.__ | 30138575 |  | HANDLE | CANTILEVER/ | 1 | 내자 | 무검사 | 0 / 0 | 0 | 가공품
84 | __.02.__.__.__.__.__ | 20064048 | R1D000261 | HDD PCB BOARD ASS'Y | ASS'Y/ | 1 | 내자 | 무검사 | 0 / 0 | 0 | P.C.B BOARD
85 | __.__.01.__.__.__.__ | 30120978 |  | HDD PCB BOARD | ASS'Y/ | 1 | 외작 | A | 0 / 0 | 0 | PCB
86 | __.__.02.__.__.__.__ | 60007433 |  | RH BOLT | M2.5,L=12/ | 2 | 내자 | 무검사 | 0 / 0 | 0 | 공용(볼트류)
87 | __.__.03.__.__.__.__ | 30138577 |  | FLAT-WASHER | M2.5XΦ5Xt0.5/ | 2 | 내자 | 무검사 | 0 / 0 | 0 | 모름
88 | __.__.04.__.__.__.__ | 30138578 |  | SPRING WASHER | M2.5XΦ5Xt0.8/ | 2 | 내자 | 무검사 | 0 / 0 | 0 | 모름
89 | __.__.05.__.__.__.__ | 30138621 |  | CONNECTOR | 254324/ | 1 | 내자 | 무검사 | 0 / 0 | 0 | 전자부품
90 | __.__.06.__.__.__.__ | 30138587 |  | LIGHTING | 7511A62/ | 1 | 내자 | 무검사 | 0 / 0 | 0 | 전기부품
91 | __.__.07.__.__.__.__ | 30138622 |  | HARD DISK SATA | AP-SAFD254QA 032GS/ | 1 | 내자 | 무검사 | 0 / 0 | 0 | 전자부품
92 | __.__.08.__.__.__.__ | 30138623 |  | HDD SUB BOARD | ASS'Y/ | 1 | 내자 | 무검사 | 0 / 0 | 0 | 모름
93 | __.__.09.__.__.__.__ | 30138624 |  | SATA CONNECTOR | 7103ST-715F-02/ | 1 | 외자 | 무검사 | 0 / 0 | 0 | 전자부품
94 | 06.__.__.__.__.__.__ | 30138625 | R1D000308 | WLR ASS'Y | ASS'Y/ | 1 | 내자 | 무검사 | 0 / 0 | 0 | 제관품
95 | __.01.__.__.__.__.__ | 20064050 | R1D000310 | WLR FRT PANEL ASS'Y | ASS'Y/ | 1 | 내자 | 무검사 | 0 / 0 | 0 | 제어PANEL류
96 | __.__.01.__.__.__.__ | 20064052 | R1D000309 | FRONT PANEL | AL, t=2.5/ | 1 | 내자 | 무검사 | 0 / 0 | 0 | 제어PANEL류
97 | __.__.02.__.__.__.__ | 30138570 |  | FIXING BOLT | 21101-101.M2.5,L=12.5/ | 1 | 내자 | 무검사 | 0 / 0 | 0 | 가공품
98 | __.__.03.__.__.__.__ | 30138571 |  | METAL SLEEVE | 21100-660/ | 1 | 내자 | 무검사 | 0 / 0 | 0 | 모름
99 | __.__.04.__.__.__.__ | 30138572 |  | OVAL BOLT | 21100-429,M2.5,L=8/ | 1 | 내자 | 무검사 | 0 / 0 | 0 | 가공품
100 | __.__.05.__.__.__.__ | 30138573 |  | PB HOLDER | 60807-181/ | 1 | 외작 | B | 0 / 0 | 0 | 가공품
101 | __.__.06.__.__.__.__ | 30138574 |  | BOLT | 21101-220,M2.5,L=10/ | 1 | 내자 | 무검사 | 0 / 0 | 0 | 가공품
102 | __.__.07.__.__.__.__ | 30138575 |  | HANDLE | CANTILEVER/ | 1 | 내자 | 무검사 | 0 / 0 | 0 | 가공품
103 | __.02.__.__.__.__.__ | 20064051 | R1D000311 | WLR PCB BOARD ASS'Y | ASS'Y/ | 1 | 내자 | 무검사 | 0 / 0 | 0 | P.C.B BOARD
104 | __.__.01.__.__.__.__ | 30120975 |  | WLR PCB BOARD | ASS'Y/ | 1 | 외작 | 무검사 | 0 / 0 | 0 | PCB
105 | __.__.02.__.__.__.__ | 60007433 |  | RH BOLT | M2.5,L=12/ | 2 | 내자 | 무검사 | 0 / 0 | 0 | 공용(볼트류)
106 | __.__.03.__.__.__.__ | 30138577 |  | FLAT-WASHER | M2.5XΦ5Xt0.5/ | 2 | 내자 | 무검사 | 0 / 0 | 0 | 모름
107 | __.__.04.__.__.__.__ | 30138578 |  | SPRING WASHER | M2.5XΦ5Xt0.8/ | 2 | 내자 | 무검사 | 0 / 0 | 0 | 모름
108 | __.__.05.__.__.__.__ | 30138626 |  | CONNECTOR | 364915/ | 1 | 내자 | 무검사 | 0 / 0 | 0 | 전자부품
109 | __.__.06.__.__.__.__ | 30138587 |  | LIGHTING | 7511A62/ | 3 | 내자 | 무검사 | 0 / 0 | 0 | 전기부품
110 | __.__.07.__.__.__.__ | 30138627 |  | CONNECTOR | 35312-04/ | 3 | 내자 | 무검사 | 0 / 0 | 0 | 전자부품
111 | __.__.08.__.__.__.__ | 30138628 |  | TRANSFORMER MODULE | HX1234NL/ | 2 | 내자 | 무검사 | 0 / 0 | 0 | 전기부품
112 | 07.__.__.__.__.__.__ | 30138629 | R1D000300 | VOIP ASS'Y | ASS'Y/ | 1 | 내자 | 무검사 | 0 / 0 | 0 | 제관품
113 | __.01.__.__.__.__.__ | 20064053 | R1D000302 | VOIP FRT PANEL ASS'Y | ASS'Y/ | 1 | 내자 | 무검사 | 0 / 0 | 0 | 제어PANEL류
114 | __.__.01.__.__.__.__ | 20064055 | R1D000303 | FRONT PANEL | AL, t=2.5/ | 1 | 내자 | 무검사 | 0 / 0 | 0 | 제어PANEL류
115 | __.__.02.__.__.__.__ | 30138570 |  | FIXING BOLT | 21101-101.M2.5,L=12.5/ | 3 | 내자 | 무검사 | 0 / 0 | 0 | 가공품
116 | __.__.03.__.__.__.__ | 30138571 |  | METAL SLEEVE | 21100-660/ | 3 | 내자 | 무검사 | 0 / 0 | 0 | 모름
117 | __.__.04.__.__.__.__ | 30138572 |  | OVAL BOLT | 21100-429,M2.5,L=8/ | 1 | 내자 | 무검사 | 0 / 0 | 0 | 가공품
118 | __.__.05.__.__.__.__ | 30138573 |  | PB HOLDER | 60807-181/ | 1 | 외작 | B | 0 / 0 | 0 | 가공품
119 | __.__.06.__.__.__.__ | 30138574 |  | BOLT | 21101-220,M2.5,L=10/ | 1 | 내자 | 무검사 | 0 / 0 | 0 | 가공품
120 | __.__.07.__.__.__.__ | 30138575 |  | HANDLE | CANTILEVER/ | 1 | 내자 | 무검사 | 0 / 0 | 0 | 가공품
121 | __.02.__.__.__.__.__ | 20064054 | R1D000301 | VOIP PCB BOARD ASS'Y | ASS'Y/ | 1 | 내자 | 무검사 | 0 / 0 | 0 | P.C.B BOARD
122 | __.__.01.__.__.__.__ | 30138630 |  | VOIP PCB BOARD | ASS'Y/ | 1 | 외작 | 무검사 | 0 / 0 | 0 | PCB
123 | __.__.02.__.__.__.__ | 60007433 |  | RH BOLT | M2.5,L=12/ | 2 | 내자 | 무검사 | 0 / 0 | 0 | 공용(볼트류)
124 | __.__.03.__.__.__.__ | 30138577 |  | FLAT-WASHER | M2.5XΦ5Xt0.5/ | 2 | 내자 | 무검사 | 0 / 0 | 0 | 모름
125 | __.__.04.__.__.__.__ | 30138578 |  | SPRING WASHER | M2.5XΦ5Xt0.8/ | 2 | 내자 | 무검사 | 0 / 0 | 0 | 모름
126 | __.__.05.__.__.__.__ | 30138583 |  | CONNECTOR | 850030177/ | 1 | 내자 | 무검사 | 0 / 0 | 0 | 전자부품
127 | 08.__.__.__.__.__.__ | 30138631 | R1D000288 | REC ASS'Y | ASS'Y/ | 1 | 내자 | 무검사 | 0 / 0 | 0 | 제관품
128 | __.01.__.__.__.__.__ | 20064057 | R1D000289 | REC FRT PANEL ASS'Y | ASS'Y/ | 1 | 내자 | 무검사 | 0 / 0 | 0 | 제어PANEL류
129 | __.__.01.__.__.__.__ | 20064059 | R1D000290 | FRONT PANEL | AL, t=2.5/ | 1 | 내자 | 무검사 | 0 / 0 | 0 | 제어PANEL류
130 | __.__.02.__.__.__.__ | 30138570 |  | FIXING BOLT | 21101-101.M2.5,L=12.5/ | 1 | 내자 | 무검사 | 0 / 0 | 0 | 가공품
131 | __.__.03.__.__.__.__ | 30138571 |  | METAL SLEEVE | 21100-660/ | 1 | 내자 | 무검사 | 0 / 0 | 0 | 모름
132 | __.__.04.__.__.__.__ | 30138572 |  | OVAL BOLT | 21100-429,M2.5,L=8/ | 1 | 내자 | 무검사 | 0 / 0 | 0 | 가공품
133 | __.__.05.__.__.__.__ | 30138573 |  | PB HOLDER | 60807-181/ | 1 | 외작 | B | 0 / 0 | 0 | 가공품
134 | __.__.06.__.__.__.__ | 30138574 |  | BOLT | 21101-220,M2.5,L=10/ | 1 | 내자 | 무검사 | 0 / 0 | 0 | 가공품
135 | __.__.07.__.__.__.__ | 30138575 |  | HANDLE | CANTILEVER/ | 1 | 내자 | 무검사 | 0 / 0 | 0 | 가공품
136 | __.02.__.__.__.__.__ | 20064058 | R1D000291 | REC PCB BOARD ASS'Y | ASS'Y/ | 1 | 내자 | 무검사 | 0 / 0 | 0 | P.C.B BOARD
137 | __.__.01.__.__.__.__ | 30138632 |  | REC PCB BOARD | ASS'Y/ | 1 | 외작 | 무검사 | 0 / 0 | 0 | PCB
138 | __.__.02.__.__.__.__ | 60007433 |  | RH BOLT | M2.5,L=12/ | 2 | 내자 | 무검사 | 0 / 0 | 0 | 공용(볼트류)
139 | __.__.03.__.__.__.__ | 30138577 |  | FLAT-WASHER | M2.5XΦ5Xt0.5/ | 2 | 내자 | 무검사 | 0 / 0 | 0 | 모름
140 | __.__.04.__.__.__.__ | 30138578 |  | SPRING WASHER | M2.5XΦ5Xt0.8/ | 2 | 내자 | 무검사 | 0 / 0 | 0 | 모름
141 | __.__.05.__.__.__.__ | 30138583 |  | CONNECTOR | 850030177/ | 1 | 내자 | 무검사 | 0 / 0 | 0 | 전자부품
142 | 09.__.__.__.__.__.__ | 30138633 | R1D000262 | LIC ASS'Y | ASS'Y/ | 1 | 내자 | 무검사 | 0 / 0 | 0 | 제관품
143 | __.01.__.__.__.__.__ | 20064060 | R1D000264 | LIC FRT PANEL ASS'Y | ASS'Y/ | 1 | 내자 | 무검사 | 0 / 0 | 0 | 제어PANEL류
144 | __.__.01.__.__.__.__ | 20064062 | R1D000263 | FRONT PANEL | AL, t=2.5/ | 1 | 내자 | 무검사 | 0 / 0 | 0 | 제어PANEL류
145 | __.__.02.__.__.__.__ | 30138570 |  | FIXING BOLT | 21101-101.M2.5,L=12.5/ | 3 | 내자 | 무검사 | 0 / 0 | 0 | 가공품
146 | __.__.03.__.__.__.__ | 30138571 |  | METAL SLEEVE | 21100-660/ | 3 | 내자 | 무검사 | 0 / 0 | 0 | 모름
147 | __.__.04.__.__.__.__ | 30138572 |  | OVAL BOLT | 21100-429,M2.5,L=8/ | 1 | 내자 | 무검사 | 0 / 0 | 0 | 가공품
148 | __.__.05.__.__.__.__ | 30138573 |  | PB HOLDER | 60807-181/ | 1 | 외작 | B | 0 / 0 | 0 | 가공품
149 | __.__.06.__.__.__.__ | 30138574 |  | BOLT | 21101-220,M2.5,L=10/ | 1 | 내자 | 무검사 | 0 / 0 | 0 | 가공품
150 | __.__.07.__.__.__.__ | 30138575 |  | HANDLE | CANTILEVER/ | 1 | 내자 | 무검사 | 0 / 0 | 0 | 가공품
151 | __.02.__.__.__.__.__ | 20064061 | R1D000265 | LIC PCB BOARD ASS'Y | ASS'Y/ | 1 | 내자 | 무검사 | 0 / 0 | 0 | P.C.B BOARD
152 | __.__.01.__.__.__.__ | 30138634 |  | LIC PCB BOARD | ASS'Y/ | 1 | 외작 | 무검사 | 0 / 0 | 0 | PCB
153 | __.__.02.__.__.__.__ | 60007433 |  | RH BOLT | M2.5,L=12/ | 2 | 내자 | 무검사 | 0 / 0 | 0 | 공용(볼트류)
154 | __.__.03.__.__.__.__ | 30138577 |  | FLAT-WASHER | M2.5XΦ5Xt0.5/ | 2 | 내자 | 무검사 | 0 / 0 | 0 | 모름
155 | __.__.04.__.__.__.__ | 30138578 |  | SPRING WASHER | M2.5XΦ5Xt0.8/ | 2 | 내자 | 무검사 | 0 / 0 | 0 | 모름
156 | __.__.05.__.__.__.__ | 30138583 |  | CONNECTOR | 850030177/ | 1 | 내자 | 무검사 | 0 / 0 | 0 | 전자부품
157 | __.__.06.__.__.__.__ | 30138587 |  | LIGHTING | 7511A62/ | 4 | 내자 | 무검사 | 0 / 0 | 0 | 전기부품
158 | __.03.__.__.__.__.__ | 60007435 |  | RH BOLT | M3 X L14/ | 4 | 내자 | 무검사 | 0 / 0 | 0 | 공용(볼트류)
159 | 10.__.__.__.__.__.__ | 30138635 | R1D000266 | PAC 485 ASS'Y | ASS'Y/ | 1 | 내자 | 무검사 | 0 / 0 | 0 | 제관품
160 | __.01.__.__.__.__.__ | 20064063 | R1D000267 | PAC 485 FRT PANEL ASS'Y | ASS'Y/ | 1 | 내자 | 무검사 | 0 / 0 | 0 | 제어PANEL류
161 | __.__.01.__.__.__.__ | 20064065 | R1D000268 | FRONT PANEL | AL, t=2.5/ | 1 | 내자 | 무검사 | 0 / 0 | 0 | 제어PANEL류
162 | __.__.02.__.__.__.__ | 30138570 |  | FIXING BOLT | 21101-101.M2.5,L=12.5/ | 3 | 내자 | 무검사 | 0 / 0 | 0 | 가공품
163 | __.__.03.__.__.__.__ | 30138571 |  | METAL SLEEVE | 21100-660/ | 3 | 내자 | 무검사 | 0 / 0 | 0 | 모름
164 | __.__.04.__.__.__.__ | 30138572 |  | OVAL BOLT | 21100-429,M2.5,L=8/ | 2 | 내자 | 무검사 | 0 / 0 | 0 | 가공품
165 | __.__.05.__.__.__.__ | 30138573 |  | PB HOLDER | 60807-181/ | 2 | 외작 | B | 0 / 0 | 0 | 가공품
166 | __.__.06.__.__.__.__ | 30138574 |  | BOLT | 21101-220,M2.5,L=10/ | 2 | 내자 | 무검사 | 0 / 0 | 0 | 가공품
167 | __.__.07.__.__.__.__ | 30138575 |  | HANDLE | CANTILEVER/ | 1 | 내자 | 무검사 | 0 / 0 | 0 | 가공품
168 | __.02.__.__.__.__.__ | 20064064 | R1D000269 | PAC 485 PCB BOARD ASS'Y | ASS'Y/ | 1 | 내자 | 무검사 | 0 / 0 | 0 | P.C.B BOARD
169 | __.__.01.__.__.__.__ | 30138636 |  | PAC 485 PCB BOARD | ASS'Y/ | 1 | 외작 | 무검사 | 0 / 0 | 0 | PCB
170 | __.__.02.__.__.__.__ | 60007433 |  | RH BOLT | M2.5,L=12/ | 2 | 내자 | 무검사 | 0 / 0 | 0 | 공용(볼트류)
171 | __.__.03.__.__.__.__ | 30138577 |  | FLAT-WASHER | M2.5XΦ5Xt0.5/ | 2 | 내자 | 무검사 | 0 / 0 | 0 | 모름
172 | __.__.04.__.__.__.__ | 30138578 |  | SPRING WASHER | M2.5XΦ5Xt0.8/ | 2 | 내자 | 무검사 | 0 / 0 | 0 | 모름
173 | __.__.05.__.__.__.__ | 30138583 |  | CONNECTOR | 850030177/ | 1 | 내자 | 무검사 | 0 / 0 | 0 | 전자부품
174 | __.__.06.__.__.__.__ | 30138637 |  | CONNECTOR | MSG59P-L111/ | 1 | 내자 | 무검사 | 0 / 0 | 0 | 전자부품
175 | 11.__.__.__.__.__.__ | 30138638 | R1D000292 | SCB ASS'Y | ASS'Y/ | 1 | 내자 | 무검사 | 0 / 0 | 0 | 제관품
176 | __.01.__.__.__.__.__ | 20064066 | R1D000294 | SCB FRT PANEL ASS'Y | ASS'Y/ | 1 | 내자 | 무검사 | 0 / 0 | 0 | 제어PANEL류
177 | __.__.01.__.__.__.__ | 20064068 | R1D000293 | FRONT PANEL | AL, t=2.5/ | 1 | 내자 | 무검사 | 0 / 0 | 0 | 제어PANEL류
178 | __.__.02.__.__.__.__ | 30138570 |  | FIXING BOLT | 21101-101.M2.5,L=12.5/ | 3 | 내자 | 무검사 | 0 / 0 | 0 | 가공품
179 | __.__.03.__.__.__.__ | 30138571 |  | METAL SLEEVE | 21100-660/ | 3 | 내자 | 무검사 | 0 / 0 | 0 | 모름
180 | __.__.04.__.__.__.__ | 30138572 |  | OVAL BOLT | 21100-429,M2.5,L=8/ | 1 | 내자 | 무검사 | 0 / 0 | 0 | 가공품
181 | __.__.05.__.__.__.__ | 30138573 |  | PB HOLDER | 60807-181/ | 1 | 외작 | B | 0 / 0 | 0 | 가공품
182 | __.__.06.__.__.__.__ | 30138574 |  | BOLT | 21101-220,M2.5,L=10/ | 1 | 내자 | 무검사 | 0 / 0 | 0 | 가공품
183 | __.__.07.__.__.__.__ | 30138575 |  | HANDLE | CANTILEVER/ | 1 | 내자 | 무검사 | 0 / 0 | 0 | 가공품
184 | __.02.__.__.__.__.__ | 20064067 | R1D000295 | SCB PCB BOARD ASS'Y | ASS'Y/ | 1 | 내자 | 무검사 | 0 / 0 | 0 | P.C.B BOARD
185 | __.__.01.__.__.__.__ | 30138639 |  | SCB 485 PCB BOARD | ASS'Y/ | 1 | 외작 | 무검사 | 0 / 0 | 0 | PCB
186 | __.__.02.__.__.__.__ | 60007433 |  | RH BOLT | M2.5,L=12/ | 2 | 내자 | 무검사 | 0 / 0 | 0 | 공용(볼트류)
187 | __.__.03.__.__.__.__ | 30138577 |  | FLAT-WASHER | M2.5XΦ5Xt0.5/ | 2 | 내자 | 무검사 | 0 / 0 | 0 | 모름
188 | __.__.04.__.__.__.__ | 30138578 |  | SPRING WASHER | M2.5XΦ5Xt0.8/ | 2 | 내자 | 무검사 | 0 / 0 | 0 | 모름
189 | __.__.05.__.__.__.__ | 30138583 |  | CONNECTOR | 850030177/ | 1 | 내자 | 무검사 | 0 / 0 | 0 | 전자부품
190 | __.03.__.__.__.__.__ | 60007435 |  | RH BOLT | M3 X L14/ | 8 | 내자 | 무검사 | 0 / 0 | 0 | 공용(볼트류)
191 | 12.__.__.__.__.__.__ | 30138640 | R1D000274 | PAC-MCU ASS'Y | ASS'Y/ | 1 | 내자 | 무검사 | 0 / 0 | 0 | 제관품
192 | __.01.__.__.__.__.__ | 20064069 | R1D000275 | PAC-MCU FRT PANEL ASS'Y | ASS'Y/ | 1 | 내자 | 무검사 | 0 / 0 | 0 | 제어PANEL류
193 | __.__.01.__.__.__.__ | 20064071 | R1D000276 | FRONT PANEL | AL, t=2.5/ | 1 | 내자 | 무검사 | 0 / 0 | 0 | 제어PANEL류
194 | __.__.02.__.__.__.__ | 30138570 |  | FIXING BOLT | 21101-101.M2.5,L=12.5/ | 1 | 내자 | 무검사 | 0 / 0 | 0 | 가공품
195 | __.__.03.__.__.__.__ | 30138571 |  | METAL SLEEVE | 21100-660/ | 1 | 내자 | 무검사 | 0 / 0 | 0 | 모름
196 | __.__.04.__.__.__.__ | 30138572 |  | OVAL BOLT | 21100-429,M2.5,L=8/ | 1 | 내자 | 무검사 | 0 / 0 | 0 | 가공품
197 | __.__.05.__.__.__.__ | 30138573 |  | PB HOLDER | 60807-181/ | 1 | 외작 | B | 0 / 0 | 0 | 가공품
198 | __.__.06.__.__.__.__ | 30138574 |  | BOLT | 21101-220,M2.5,L=10/ | 1 | 내자 | 무검사 | 0 / 0 | 0 | 가공품
199 | __.__.07.__.__.__.__ | 30138575 |  | HANDLE | CANTILEVER/ | 1 | 내자 | 무검사 | 0 / 0 | 0 | 가공품
200 | __.02.__.__.__.__.__ | 20064070 | R1D000277 | PAC-MCU PCB BOARD ASS'Y | ASS'Y/ | 1 | 내자 | 무검사 | 0 / 0 | 0 | P.C.B BOARD
201 | __.__.01.__.__.__.__ | 30138641 |  | PAC MCU PCB BOARD | ASS'Y/ | 1 | 외작 | 무검사 | 0 / 0 | 0 | PCB
202 | __.__.02.__.__.__.__ | 60007433 |  | RH BOLT | M2.5,L=12/ | 2 | 내자 | 무검사 | 0 / 0 | 0 | 공용(볼트류)
203 | __.__.03.__.__.__.__ | 30138577 |  | FLAT-WASHER | M2.5XΦ5Xt0.5/ | 2 | 내자 | 무검사 | 0 / 0 | 0 | 모름
204 | __.__.04.__.__.__.__ | 30138578 |  | SPRING WASHER | M2.5XΦ5Xt0.8/ | 2 | 내자 | 무검사 | 0 / 0 | 0 | 모름
205 | __.__.05.__.__.__.__ | 30138583 |  | CONNECTOR | 850030177/ | 1 | 내자 | 무검사 | 0 / 0 | 0 | 전자부품
206 | 13.__.__.__.__.__.__ | 30138642 | R1D000278 | PAC-VOL ASS'Y | ASS'Y/ | 1 | 내자 | 무검사 | 0 / 0 | 0 | 제관품
207 | __.01.__.__.__.__.__ | 20064072 | R1D000279 | PAC-VOL FRT PANEL ASS'Y | ASS'Y/ | 1 | 내자 | 무검사 | 0 / 0 | 0 | 제어PANEL류
208 | __.__.01.__.__.__.__ | 20064075 | R1D000280 | FRONT PANEL | AL, t=2.5/ | 1 | 내자 | 무검사 | 0 / 0 | 0 | 제어PANEL류
209 | __.__.02.__.__.__.__ | 30138570 |  | FIXING BOLT | 21101-101.M2.5,L=12.5/ | 1 | 내자 | 무검사 | 0 / 0 | 0 | 가공품
210 | __.__.03.__.__.__.__ | 30138571 |  | METAL SLEEVE | 21100-660/ | 1 | 내자 | 무검사 | 0 / 0 | 0 | 모름
211 | __.__.04.__.__.__.__ | 30138572 |  | OVAL BOLT | 21100-429,M2.5,L=8/ | 1 | 내자 | 무검사 | 0 / 0 | 0 | 가공품
212 | __.__.05.__.__.__.__ | 30138573 |  | PB HOLDER | 60807-181/ | 1 | 외작 | B | 0 / 0 | 0 | 가공품
213 | __.__.06.__.__.__.__ | 30138574 |  | BOLT | 21101-220,M2.5,L=10/ | 1 | 내자 | 무검사 | 0 / 0 | 0 | 가공품
214 | __.__.07.__.__.__.__ | 30138575 |  | HANDLE | CANTILEVER/ | 1 | 내자 | 무검사 | 0 / 0 | 0 | 가공품
215 | __.02.__.__.__.__.__ | 20064074 | R1D000281 | PAC-VOL PCB BOARD ASS'Y | ASS'Y/ | 1 | 내자 | 무검사 | 0 / 0 | 0 | P.C.B BOARD
216 | __.__.01.__.__.__.__ | 30138643 |  | PAC VOL PCB BOARD | ASS'Y/ | 1 | 외작 | 무검사 | 0 / 0 | 0 | PCB
217 | __.__.02.__.__.__.__ | 60007433 |  | RH BOLT | M2.5,L=12/ | 2 | 내자 | 무검사 | 0 / 0 | 0 | 공용(볼트류)
218 | __.__.03.__.__.__.__ | 30138577 |  | FLAT-WASHER | M2.5XΦ5Xt0.5/ | 2 | 내자 | 무검사 | 0 / 0 | 0 | 모름
219 | __.__.04.__.__.__.__ | 30138578 |  | SPRING WASHER | M2.5XΦ5Xt0.8/ | 2 | 내자 | 무검사 | 0 / 0 | 0 | 모름
220 | __.__.05.__.__.__.__ | 30138583 |  | CONNECTOR | 850030177/ | 1 | 내자 | 무검사 | 0 / 0 | 0 | 전자부품
221 | 14.__.__.__.__.__.__ | 30138644 | R1D000270 | PAC-INT ASS'Y | ASS'Y/ | 1 | 내자 | 무검사 | 0 / 0 | 0 | 제관품
222 | __.01.__.__.__.__.__ | 20064077 | R1D000271 | PAC-INT FRT PANEL ASS'Y | ASS'Y/ | 1 | 내자 | 무검사 | 0 / 0 | 0 | 제어PANEL류
223 | __.__.01.__.__.__.__ | 20064079 | R1D000272 | FRONT PANEL | AL, t=2.5/ | 1 | 내자 | 무검사 | 0 / 0 | 0 | 제어PANEL류
224 | __.__.02.__.__.__.__ | 30138570 |  | FIXING BOLT | 21101-101.M2.5,L=12.5/ | 1 | 내자 | 무검사 | 0 / 0 | 0 | 가공품
225 | __.__.03.__.__.__.__ | 30138571 |  | METAL SLEEVE | 21100-660/ | 1 | 내자 | 무검사 | 0 / 0 | 0 | 모름
226 | __.__.04.__.__.__.__ | 30138572 |  | OVAL BOLT | 21100-429,M2.5,L=8/ | 1 | 내자 | 무검사 | 0 / 0 | 0 | 가공품
227 | __.__.05.__.__.__.__ | 30138573 |  | PB HOLDER | 60807-181/ | 1 | 외작 | B | 0 / 0 | 0 | 가공품
228 | __.__.06.__.__.__.__ | 30138574 |  | BOLT | 21101-220,M2.5,L=10/ | 1 | 내자 | 무검사 | 0 / 0 | 0 | 가공품
229 | __.__.07.__.__.__.__ | 30138575 |  | HANDLE | CANTILEVER/ | 1 | 내자 | 무검사 | 0 / 0 | 0 | 가공품
230 | __.02.__.__.__.__.__ | 20064078 | R1D000273 | PAC-INT PCB BOARD ASS'Y | ASS'Y/ | 1 | 내자 | 무검사 | 0 / 0 | 0 | P.C.B BOARD
231 | __.__.01.__.__.__.__ | 30138649 |  | PAC INT PCB BOARD | ASS'Y/ | 1 | 외작 | 무검사 | 0 / 0 | 0 | PCB
232 | __.__.02.__.__.__.__ | 60007433 |  | RH BOLT | M2.5,L=12/ | 2 | 내자 | 무검사 | 0 / 0 | 0 | 공용(볼트류)
233 | __.__.03.__.__.__.__ | 30138577 |  | FLAT-WASHER | M2.5XΦ5Xt0.5/ | 2 | 내자 | 무검사 | 0 / 0 | 0 | 모름
234 | __.__.04.__.__.__.__ | 30138578 |  | SPRING WASHER | M2.5XΦ5Xt0.8/ | 2 | 내자 | 무검사 | 0 / 0 | 0 | 모름
235 | __.__.05.__.__.__.__ | 30138583 |  | CONNECTOR | 850030177/ | 1 | 내자 | 무검사 | 0 / 0 | 0 | 전자부품
236 | 15.__.__.__.__.__.__ | 30138650 | R1D000242 | AAB1 ASS'Y | ASS'Y/ | 1 | 내자 | 무검사 | 0 / 0 | 0 | 제관품
237 | __.01.__.__.__.__.__ | 20064080 | R1D000243 | AAB1 FRT PANEL ASS'Y | ASS'Y/ | 1 | 내자 | 무검사 | 0 / 0 | 0 | 제어PANEL류
238 | __.__.01.__.__.__.__ | 20064082 | R1D000319 | FRONT PANEL | AL, t=2.5/ | 1 | 내자 | 무검사 | 0 / 0 | 0 | 제어PANEL류
239 | __.__.02.__.__.__.__ | 30138570 |  | FIXING BOLT | 21101-101.M2.5,L=12.5/ | 3 | 내자 | 무검사 | 0 / 0 | 0 | 가공품
240 | __.__.03.__.__.__.__ | 30138571 |  | METAL SLEEVE | 21100-660/ | 3 | 내자 | 무검사 | 0 / 0 | 0 | 모름
241 | __.__.04.__.__.__.__ | 30138572 |  | OVAL BOLT | 21100-429,M2.5,L=8/ | 2 | 내자 | 무검사 | 0 / 0 | 0 | 가공품
242 | __.__.05.__.__.__.__ | 30138573 |  | PB HOLDER | 60807-181/ | 2 | 외작 | B | 0 / 0 | 0 | 가공품
243 | __.__.06.__.__.__.__ | 30138574 |  | BOLT | 21101-220,M2.5,L=10/ | 2 | 내자 | 무검사 | 0 / 0 | 0 | 가공품
244 | __.__.07.__.__.__.__ | 30138575 |  | HANDLE | CANTILEVER/ | 1 | 내자 | 무검사 | 0 / 0 | 0 | 가공품
245 | __.02.__.__.__.__.__ | 20064081 | R1D000244 | AAB1 PCB BOARD ASS'Y | ASS'Y/ | 1 | 내자 | 무검사 | 0 / 0 | 0 | P.C.B BOARD
246 | __.__.01.__.__.__.__ | 30138651 |  | AAB1 PCB BOARD | ASS'Y/ | 1 | 외작 | 무검사 | 0 / 0 | 0 | PCB
247 | __.__.02.__.__.__.__ | 60007433 |  | RH BOLT | M2.5,L=12/ | 2 | 내자 | 무검사 | 0 / 0 | 0 | 공용(볼트류)
248 | __.__.03.__.__.__.__ | 30138577 |  | FLAT-WASHER | M2.5XΦ5Xt0.5/ | 2 | 내자 | 무검사 | 0 / 0 | 0 | 모름
249 | __.__.04.__.__.__.__ | 30138578 |  | SPRING WASHER | M2.5XΦ5Xt0.8/ | 2 | 내자 | 무검사 | 0 / 0 | 0 | 모름
250 | __.__.05.__.__.__.__ | 30138583 |  | CONNECTOR | 850030177/ | 1 | 내자 | 무검사 | 0 / 0 | 0 | 전자부품
251 | __.__.06.__.__.__.__ | 30138637 |  | CONNECTOR | MSG59P-L111/ | 1 | 내자 | 무검사 | 0 / 0 | 0 | 전자부품
252 | 16.__.__.__.__.__.__ | 30138652 | R1D000245 | AAB2 ASS'Y | ASS'Y/ | 1 | 내자 | 무검사 | 0 / 0 | 0 | 제관품
253 | __.01.__.__.__.__.__ | 20064083 | R1D000246 | AAB2 FRT PANEL ASS'Y | ASS'Y/ | 1 | 내자 | 무검사 | 0 / 0 | 0 | 제어PANEL류
254 | __.__.01.__.__.__.__ | 20064086 | R1D000247 | FRONT PANEL | AL, t=2.5/ | 1 | 내자 | 무검사 | 0 / 0 | 0 | 제어PANEL류
255 | __.__.02.__.__.__.__ | 30138570 |  | FIXING BOLT | 21101-101.M2.5,L=12.5/ | 3 | 내자 | 무검사 | 0 / 0 | 0 | 가공품
256 | __.__.03.__.__.__.__ | 30138571 |  | METAL SLEEVE | 21100-660/ | 3 | 내자 | 무검사 | 0 / 0 | 0 | 모름
257 | __.__.04.__.__.__.__ | 30138572 |  | OVAL BOLT | 21100-429,M2.5,L=8/ | 2 | 내자 | 무검사 | 0 / 0 | 0 | 가공품
258 | __.__.05.__.__.__.__ | 30138573 |  | PB HOLDER | 60807-181/ | 2 | 외작 | B | 0 / 0 | 0 | 가공품
259 | __.__.06.__.__.__.__ | 30138574 |  | BOLT | 21101-220,M2.5,L=10/ | 2 | 내자 | 무검사 | 0 / 0 | 0 | 가공품
260 | __.__.07.__.__.__.__ | 30138575 |  | HANDLE | CANTILEVER/ | 1 | 내자 | 무검사 | 0 / 0 | 0 | 가공품
261 | __.02.__.__.__.__.__ | 20064085 | R1D000248 | AAB1 PCB BOARD ASS'Y | ASS'Y/ | 1 | 내자 | 무검사 | 0 / 0 | 0 | P.C.B BOARD
262 | __.__.01.__.__.__.__ | 30138656 |  | AAB2 PCB BOARD | ASS'Y/ | 1 | 외작 | 무검사 | 0 / 0 | 0 | PCB
263 | __.__.02.__.__.__.__ | 60007433 |  | RH BOLT | M2.5,L=12/ | 2 | 내자 | 무검사 | 0 / 0 | 0 | 공용(볼트류)
264 | __.__.03.__.__.__.__ | 30138577 |  | FLAT-WASHER | M2.5XΦ5Xt0.5/ | 2 | 내자 | 무검사 | 0 / 0 | 0 | 모름
265 | __.__.04.__.__.__.__ | 30138578 |  | SPRING WASHER | M2.5XΦ5Xt0.8/ | 2 | 내자 | 무검사 | 0 / 0 | 0 | 모름
266 | __.__.05.__.__.__.__ | 30138583 |  | CONNECTOR | 850030177/ | 1 | 내자 | 무검사 | 0 / 0 | 0 | 전자부품
267 | 17.__.__.__.__.__.__ | 30138657 | R1D000249 | AMP PWR ASS'Y | ASS'Y/ | 1 | 내자 | 무검사 | 0 / 0 | 0 | 제관품
268 | __.01.__.__.__.__.__ | 20064087 | R1D000251 | AMP PWR FRT PANEL ASS'Y | ASS'Y/ | 1 | 내자 | 무검사 | 0 / 0 | 0 | 제어PANEL류
269 | __.__.01.__.__.__.__ | 20064090 | R1D000250 | FRONT PANEL | AL, t=2.5/ | 1 | 내자 | 무검사 | 0 / 0 | 0 | 제어PANEL류
270 | __.__.02.__.__.__.__ | 30138570 |  | FIXING BOLT | 21101-101.M2.5,L=12.5/ | 3 | 내자 | 무검사 | 0 / 0 | 0 | 가공품
271 | __.__.03.__.__.__.__ | 30138571 |  | METAL SLEEVE | 21100-660/ | 3 | 내자 | 무검사 | 0 / 0 | 0 | 모름
272 | __.__.04.__.__.__.__ | 30138572 |  | OVAL BOLT | 21100-429,M2.5,L=8/ | 2 | 내자 | 무검사 | 0 / 0 | 0 | 가공품
273 | __.__.05.__.__.__.__ | 30138573 |  | PB HOLDER | 60807-181/ | 2 | 외작 | B | 0 / 0 | 0 | 가공품
274 | __.__.06.__.__.__.__ | 30138574 |  | BOLT | 21101-220,M2.5,L=10/ | 2 | 내자 | 무검사 | 0 / 0 | 0 | 가공품
275 | __.__.07.__.__.__.__ | 30138575 |  | HANDLE | CANTILEVER/ | 1 | 내자 | 무검사 | 0 / 0 | 0 | 가공품
276 | __.02.__.__.__.__.__ | 20064089 | R1D000252 | AMP PWR PCB BOARD ASS'Y | ASS'Y/ | 1 | 내자 | 무검사 | 0 / 0 | 0 | P.C.B BOARD
277 | __.__.01.__.__.__.__ | 30138658 |  | AMP PWR PCB BOARD | ASS'Y/ | 1 | 외작 | 무검사 | 0 / 0 | 0 | PCB
278 | __.__.02.__.__.__.__ | 60007433 |  | RH BOLT | M2.5,L=12/ | 2 | 내자 | 무검사 | 0 / 0 | 0 | 공용(볼트류)
279 | __.__.03.__.__.__.__ | 30138577 |  | FLAT-WASHER | M2.5XΦ5Xt0.5/ | 2 | 내자 | 무검사 | 0 / 0 | 0 | 모름
280 | __.__.04.__.__.__.__ | 30138578 |  | SPRING WASHER | M2.5XΦ5Xt0.8/ | 2 | 내자 | 무검사 | 0 / 0 | 0 | 모름
281 | __.__.05.__.__.__.__ | 30136180 |  | CONNECTOR | ASS'Y/ASS'Y | 1 | 내자 | 무검사 | 0 / 0 | 0 | 전기부품
282 | __.__.06.__.__.__.__ | 30138579 |  | LIGHTING | ASS'Y/ | 2 | 내자 | 무검사 | 0 / 0 | 0 | 전기부품
283 | __.__.07.__.__.__.__ | 30135054 |  | HEAT SINK | ASS'Y/ | 1 | 내자 | 무검사 | 0 / 0 | 0 | 전자부품
284 | 18.__.__.__.__.__.__ | 30139264 |  | PACR RACK | 21inch,120HP,SCHROFF/ASS'Y | 2 | 내작 | 무검사 | 0 / 0 | 0 | 제관품
285 | 19.__.__.__.__.__.__ | 30139312 | R1D000452(01) | NAME PLATE(CRA) | t=1.0/AL | 1 | 내자 | 무검사 | 0 / 0 | 0 | 명판
286 | 20.__.__.__.__.__.__ | 30138967 |  | CONNECTOR | BCP-C5FA/ | 2 | 외자 | C | 0 / 0 | 0 | 전자부품
287 | 21.__.__.__.__.__.__ | 30138968 |  | CONNECTOR | FRITS4102R14S-07PB1G1F6/ | 1 | 외자 | C | 0 / 0 | 0 | 전자부품
288 | 22.__.__.__.__.__.__ | 30138969 |  | CONNECTOR | FRITS4106F14S-07SB1F6/ | 1 | 외자 | C | 0 / 0 | 0 | 전자부품
289 | 23.__.__.__.__.__.__ | 30138970 |  | CONNECTOR | 801-009-07M9-210PA/ | 3 | 외자 | C | 0 / 0 | 0 | 전자부품
290 | 24.__.__.__.__.__.__ | 30138972 |  | CONNECTOR | 801-007-16M9-210SA/ | 3 | 외자 | C | 0 / 0 | 0 | 전자부품
291 | 25.__.__.__.__.__.__ | 30138973 |  | CONNECTOR | FRITS4102R14S-07PB0G1F6/ | 1 | 외자 | C | 0 / 0 | 0 | 전자부품
292 | 26.__.__.__.__.__.__ | 30138974 |  | CONNECTOR | FRITS4106F14S-07SB0F6/ | 1 | 외자 | C | 0 / 0 | 0 | 전자부품
293 | 27.__.__.__.__.__.__ | 30138975 |  | CONNECTOR | MSG59RR-L111/ | 1 | 외자 | C | 0 / 0 | 0 | 전자부품
294 | 28.__.__.__.__.__.__ | 30138976 |  | CONNECTOR | MSG59/ | 1 | 외자 | C | 0 / 0 | 0 | 전자부품
295 | 29.__.__.__.__.__.__ | 30138977 |  | CONNECTOR | FRITS4102R16S-1PB0G1F6/ | 1 | 외자 | C | 0 / 0 | 0 | 전자부품
296 | 30.__.__.__.__.__.__ | 30138978 |  | CONNECTOR | FRITS4106F16S-1SB0F6/ | 1 | 외자 | C | 0 / 0 | 0 | 전자부품
297 | 31.__.__.__.__.__.__ | 30138979 |  | CONNECTOR | FRITS4102F20-29PB0G1F6/ | 1 | 외자 | C | 0 / 0 | 0 | 전자부품
298 | 32.__.__.__.__.__.__ | 30138980 |  | CONNECTOR | FRITS4106F20-29SB0F6/ | 1 | 외자 | C | 0 / 0 | 0 | 전자부품
299 | 33.__.__.__.__.__.__ | 30138976 |  | CONNECTOR | MSG59/ | 1 | 외자 | C | 0 / 0 | 0 | 전자부품
300 | 34.__.__.__.__.__.__ | 60007449 |  | FLAT HEAD SCREW BOLT | M4X8/ | 32 | 내자 | 무검사 | 0 / 0 | 0 | 공용(볼트류)

Sheet: ccp
 |  |  |  |  | B O M L I S T
BOM 번호: 10007309-01 [10007309][R1D1473-25842][] (CCP)COMMUNICATION CONTROL PANEL
BOM 설명: 덴버 CCP
No | LEVEL | 품목코드 | 도면번호 | 품 명 | 품 명 |  | 수량 SET수량 | 조달 형태 | 품질 등급 | 구매L/T 양산/개발 | 표준 공수 | 품목형태
1 | 01.__.__.__.__.__.__ | 30138666 | R1D000312 | BOX ASS'Y | ASS'Y/ | 보성 | 1 | 내자 | 무검사 | 0 / 0 | 0 | 제관품
2 | __.01.__.__.__.__.__ | 20064091 | R1D000315 | FRONT PANEL ASS'Y | ASS'Y/ | 보성 | 1 | 내자 | 무검사 | 0 / 0 | 0 | 제어PANEL류
3 | __.__.01.__.__.__.__ | 30139236 |  | FRONT PANEL | AL(A6061)/ |  | 1 | 외작 | C | 0 / 0 | 0 | 제관품
4 | __.__.02.__.__.__.__ | 30140818 |  | COVER | A6061/AL |  | 1 | 외작 | C | 0 / 0 | 0 | 제관품
5 | __.__.03.__.__.__.__ | 30138677 |  | PLATE | A6061/AL |  | 1 | 내자 | 무검사 | 54 / 83 | 0 | 제관품
6 | __.__.04.__.__.__.__ | 30140819 |  | COVER PIN | 304SS/ |  | 1 | 외작 | C | 0 / 0 | 0 | 제관품
7 | __.02.__.__.__.__.__ | 30138671 | R1D000318 | UPPER COVER | ASS'Y/ | 보성 | 1 | 내자 | 무검사 | 54 / 83 | 0 | 제관품
8 | __.__.01.__.__.__.__ | 30140820 |  | UPPER COVER | A366-91,t1.0/ |  | 1 | 외작 | C | 0 / 0 | 0 | 제관품
9 | __.03.__.__.__.__.__ | 30138672 | R1D000455 | REAR COVER | ASS'Y/ | 보성 | 1 | 내자 | 무검사 | 54 / 83 | 0 | 제관품
10 | __.__.01.__.__.__.__ | 30140821 |  | REAR COVER | A591-CQ,t=1.6/ |  | 1 | 외작 | C | 0 / 0 | 0 | 제관품
11 | __.__.02.__.__.__.__ | 30138680 |  | EARTH PAD | #10-24 UNC 12I STAND-OFF/ |  | 1 | 내자 | 무검사 | 0 / 0 | 0 | 제관품
12 | __.__.03.__.__.__.__ | 30139467 |  | BLIND NUT | M3/ |  | 4 | 외작 | C | 0 / 0 | 0 | 제관품
13 | __.__.04.__.__.__.__ | 30140822 |  | WIRE SUPPORT | D4,L130,H10/SS400 |  | 1 | 내자 | 무검사 | 0 / 0 | 0 | 제관품
14 | __.04.__.__.__.__.__ | 30138675 | R1D000460 | LCD BRACKET | ASS'Y/ | 보성 | 1 | 내자 | 무검사 | 54 / 83 | 0 | 제관품
15 | __.__.01.__.__.__.__ | 30140823 |  | LCD BRACKET | A366-91,t1.0/ |  | 1 | 외작 | C | 0 / 0 | 0 | 제관품
16 | __.__.02.__.__.__.__ | 30139352 |  | EARTH PAD | #10-24 UNC 12I STAND-OFF/ |  | 1 | 외작 | C | 0 / 0 | 0 | 제관품
17 | __.__.03.__.__.__.__ | 30139467 |  | BLIND NUT | M3/ |  | 4 | 외작 | C | 0 / 0 | 0 | 제관품
18 | __.__.04.__.__.__.__ | 30140822 |  | WIRE SUPPORT | D4,L130,H10/SS400 |  | 1 | 내자 | 무검사 | 0 / 0 | 0 | 제관품
19 | __.05.__.__.__.__.__ | 30139347 | R1D000454 | FRAME | ASS'Y/ | 보성 | 1 | 외작 | C | 0 / 0 | 0 | 제관품
20 | __.__.01.__.__.__.__ | 30139348 |  | FRAME | A366-91,t=1.0/ |  | 1 | 외작 | C | 0 / 0 | 0 | 제관품
21 | __.__.02.__.__.__.__ | 30139349 |  | STANDOFF | D5,M3,L5.6/ |  | 5 | 내자 | 무검사 | 0 / 0 | 0 | 가공품
22 | __.__.03.__.__.__.__ | 30139350 |  | BILND NUT | M3/ |  | 8 | 내자 | 무검사 | 0 / 0 | 0 | 시중품
23 | 02.__.__.__.__.__.__ | 30120766 |  | TFT-LCD UNIT | LMS700KF05/ | 아이텍 | 1 | 내자 | A | 0 / 0 | 0 | 시중품
24 | 03.__.__.__.__.__.__ | 30140824 | R1D000316 | POWER SUPPLY | ASS'Y/ | 이즈파워 | 1 | 내자 | 무검사 | 0 / 0 | 0 | 전자부품
25 | __.01.__.__.__.__.__ | 30140825 |  | POWER | CCP-PCB,12V,50W/ |  | 1 | 내자 | 무검사 | 0 / 0 | 0 | 전자부품
26 | __.02.__.__.__.__.__ | 30139450 |  | CONNECTOR | LAD1140-4P/ |  | 1 | 외자 | 무검사 | 0 / 0 | 0 | 전자부품
27 | __.03.__.__.__.__.__ | 30139449 |  | CONNECTOR | LAD1140-6P/ |  | 1 | 외자 | 무검사 | 0 / 0 | 0 | 전자부품
28 | 04.__.__.__.__.__.__ | 20064100 | R1D000313 | CCP CONTROL BOARD | CCP-CB/ | 아이텍 | 1 | 내자 | 무검사 | 0 / 0 | 0 | P.C.B BOARD
29 | __.01.__.__.__.__.__ | 30139341 |  | CONTROL BOARD | CCP CPU BOARD ASS'Y/ |  | 1 | 내자 | 무검사 | 0 / 0 | 0 | PCB
30 | __.02.__.__.__.__.__ | 30139342 |  | SC CARD HOLDER | ASS'Y/ |  | 1 | 내자 | 무검사 | 0 / 0 | 0 | 모름
31 | __.03.__.__.__.__.__ | 30139343 |  | CONNECTOR | 05002HR-40A01/ |  | 1 | 내자 | 무검사 | 0 / 0 | 0 | 전자부품
32 | __.04.__.__.__.__.__ | 30139344 |  | CONNECTOR | 10003HR-NNL,10003HR-04L/ |  | 1 | 내자 | 무검사 | 0 / 0 | 0 | 전자부품
33 | __.05.__.__.__.__.__ | 30139345 |  | CONNECTOR | 039291088/ |  | 1 | 외자 | 무검사 | 0 / 0 | 0 | 전자부품
34 | __.06.__.__.__.__.__ | 30127387 |  | CONNECTOR | SMW250-02/ |  | 2 | 내자 | 무검사 | 0 / 0 | 0 | 시중품
35 | __.07.__.__.__.__.__ | 30139335 |  | CONNECTOR | SMW250-03/ |  | 5 | 내자 | A | 0 / 0 | 0 | 시중품
36 | __.08.__.__.__.__.__ | 30139336 |  | CONNECTOR | SMW250-04/ |  | 1 | 내자 | A | 0 / 0 | 0 | 시중품
37 | __.09.__.__.__.__.__ | 30137956 |  | CONNECTOR | SMW250-08/ |  | 2 | 내자 | 무검사 | 0 / 0 | 0 | 전기부품
38 | 05.__.__.__.__.__.__ | 30138685 |  | CONNECTOR | ITH03FPA22-14PB0G1F6/ |  | 1 | 내자 | 무검사 | 0 / 0 | 0 | 전자부품
39 | 06.__.__.__.__.__.__ | 30138686 |  | CONNECTOR | ITH08F22-14SB0F3/ |  | 1 | 내자 | 무검사 | 0 / 0 | 0 | 전자부품
40 | 07.__.__.__.__.__.__ | 30139313 | R1D000452(02) | NAME PLATE(CCP) | t=1.0/AL |  | 1 | 내자 | 무검사 | 0 / 0 | 0 | 명판
41 | 08.__.__.__.__.__.__ | 30138688 |  | BOLT&NUT LIST | ASS'Y/ |  | 1 | 내자 | 무검사 | 0 / 0 | 0 | 모름
42 | 09.__.__.__.__.__.__ | 30138689 |  | WIRE MESH | DUST FILTER #25/ |  | 2 | 내자 | 무검사 | 0 / 0 | 0 | 모름
43 | 10.__.__.__.__.__.__ | 30138690 |  | EMC GASKET | SF050010R-C-NA-A/ |  | 4 | 내자 | 무검사 | 29 / 58 | 0 | 시중품
44 | 11.__.__.__.__.__.__ | 30120765 |  | TOUCH SCREEN UNIT | MN070000ACD 7Inch WIDE/ | 아이텍 | 1 | 내자 | A | 0 / 0 | 0 | 시중품
45 | 12.__.__.__.__.__.__ | 30120836 |  | MICRO SPEAKER | HSP1710-8(0.5W, 8Ω)/ |  | 1 | 내자 | 무검사 | 0 / 0 | 0 | 전기부품
46 | 13.__.__.__.__.__.__ | 30139334 | R1D000314 | DOWNLOAD BOARD | ASS'Y/ | 아이텍 | 1 | 내자 | 무검사 | 0 / 0 | 0 | PCB
47 | __.01.__.__.__.__.__ | 30139335 |  | CONNECTOR | SMW250-03/ |  | 1 | 내자 | A | 0 / 0 | 0 | 시중품
48 | __.02.__.__.__.__.__ | 30139336 |  | CONNECTOR | SMW250-04/ |  | 1 | 내자 | A | 0 / 0 | 0 | 시중품
49 | __.03.__.__.__.__.__ | 30139337 |  | CONNECTOR | DSUB 9PIN/ |  | 1 | 내자 | 무검사 | 0 / 0 | 0 | 전자부품
50 | __.04.__.__.__.__.__ | 30139338 |  | CONNECTOR | DSUB 4PIN/ |  | 1 | 내자 | 무검사 | 0 / 0 | 0 | 전자부품
51 | 14.__.__.__.__.__.__ | 30139339 | R1D000453 | CR FORM SHEET | CR FORM, t=2.0/ |  | 1 | 내자 | 무검사 | 0 / 0 | 0 | 가공품
52 | __.01.__.__.__.__.__ | 30139340 |  | SHEET | CR FORM, EPDM, t2.0, BLACK/ |  | 1 | 내자 | 무검사 | 0 / 0 | 0 | 가공품
53 | 15.__.__.__.__.__.__ | 30140826 |  | CAPTIVE SCREW | F5-M4-P2/ |  | 1 | 외자 | 무검사 | 0 / 0 | 0 | 시중품
54 | 16.__.__.__.__.__.__ | 20064153 | R1D000446 | CCP WIRING DIAGRAM | ASS'Y/ |  | 1 | 내작 | 무검사 | 0 / 0 | 0 | 하네스도
55 | __.01.__.__.__.__.__ | 30067016 |  | WIRE | 100G0111-0.5-0/ |  | 1 | 내자 | C | 39 / 58 | 0 | 전선
56 | __.02.__.__.__.__.__ | 30128047 |  | WIRE | 100G1121-0.5-0/9/ |  | 1 | 외자 | 무검사 | 0 / 0 | 0 | 전선
57 | __.03.__.__.__.__.__ | 30075141 |  | WIRE | 100G0121-0.75-0/9-0/ |  | 1 | 외자 | C | 0 / 0 | 0 | 전선
58 | __.04.__.__.__.__.__ | 30115073 |  | CONNECTOR | 5557-04R/ |  | 1 | 내자 | 무검사 | 0 / 0 | 0 | 전자부품
59 | __.05.__.__.__.__.__ | 30139216 |  | CONNECTOR | 5557-06R/ |  | 1 | 내자 | 무검사 | 0 / 0 | 0 | 전자부품
60 | __.06.__.__.__.__.__ | 30081231 |  | TERMINAL | 5556, AWG18-24/ |  | 18 | 외자 | 무검사 | 0 / 0 | 0 | 전기부품
61 | __.07.__.__.__.__.__ | 30140827 |  | CONNECTOR | 5557-008R/ |  | 1 | 외자 | 무검사 | 0 / 0 | 0 | 전자부품
62 | __.08.__.__.__.__.__ | 30124456 |  | CONNECTOR | SMH250-02/ |  | 1 | 내자 | A | 0 / 0 | 0 | 시중품
63 | __.09.__.__.__.__.__ | 30121361 |  | CONNECTOR | SMH250-03/SMH250-03 |  | 3 | 내자 | A | 0 / 0 | 0 | 시중품
64 | __.10.__.__.__.__.__ | 30133749 |  | CONNECTOR | SMH250-04/ |  | 2 | 내자 | A | 0 / 0 | 0 | 시중품 | a
65 | __.11.__.__.__.__.__ | 30124458 |  | CONNECTOR | SMH250-06/ |  | 1 | 내자 | A | 0 / 0 | 0 | 시중품
66 | __.12.__.__.__.__.__ | 30139220 |  | TERMINAL | SMH250-02/ |  | 27 | 내자 | A | 0 / 0 | 0 | 시중품

Sheet: fdi
 |  |  |  |  | B O M L I S T
BOM 번호: 10007310-01 [10007310][R1D1473-25849][] (FDI)LED Front Destination SIGN
BOM 설명: 미국 DENVER FDI
No | LEVEL | 품목코드 | 도면번호 | 품 명 | 품 명 | 수량 SET수량 | 조달 형태 | 품질 등급 | 구매L/T 양산/개발 | 표준 공수 | 품목형태 | 품목형태
1 | 01.__.__.__.__.__.__ | 30139043 | R1B000015 | BOX ASS'Y | ASS'Y/ | 1 | 외작 | C | 0 / 0 | 0 |  | 제관품
2 | __.01.__.__.__.__.__ | 30139044 | R1B000017 | FRAME | ASS'Y/ | 1 | 외작 | C | 0 / 0 | 0 |  | 제관품
3 | __.__.01.__.__.__.__ | 30139049 |  | FRAME | A591-CQ,t=1.2/ | 1 | 외작 | C | 0 / 0 | 0 |  | 제관품
4 | __.__.02.__.__.__.__ | 30139050 |  | BOSS | A366-91, D8, M3, L6/ | 2 | 외작 | C | 0 / 0 | 0 |  | 제관품
5 | __.__.03.__.__.__.__ | 30139051 |  | BOSS | A366-91, D8, M4, L6/ | 6 | 외작 | C | 0 / 0 | 0 |  | 제관품
6 | __.__.04.__.__.__.__ | 30139052 |  | EARTH PAD | D8, M4, L10/ | 6 | 외작 | C | 0 / 0 | 0 |  | 제관품
7 | __.__.05.__.__.__.__ | 30139053 |  | W/D NUT | M5/ | 4 | 외작 | C | 0 / 0 | 0 |  | 제관품
8 | __.__.06.__.__.__.__ | 30139054 |  | WIRE SUPPORT | A366-91,D4, L280, H13/ | 4 | 외작 | C | 0 / 0 | 0 |  | 제관품
9 | __.__.07.__.__.__.__ | 30139055 |  | WIRE SUPPORT | A366-91,D4, L110, H12/ | 1 | 외작 | C | 0 / 0 | 0 |  | 제관품
10 | __.__.08.__.__.__.__ | 30139056 |  | EARTH PAD | #10-24 UNC/ | 1 | 외작 | C | 0 / 0 | 0 |  | 제관품
11 | __.02.__.__.__.__.__ | 30139045 | R1B000016 | COVER | ASS'Y/ | 1 | 외작 | C | 0 / 0 | 0 |  | 제관품
12 | __.__.01.__.__.__.__ | 30139057 |  | COVER | A591-CQ, t=1.2/ | 1 | 외작 | C | 0 / 0 | 0 |  | 제관품
13 | __.__.02.__.__.__.__ | 30139076 |  | WIRE SUPPORT | SPCC, D4, L10, H13/ | 4 | 외작 | C | 0 / 0 | 0 |  | 제관품
14 | __.__.03.__.__.__.__ | 30139088 |  | BOSS | SPCC, D6, M3, H6/ | 4 | 외작 | C | 0 / 0 | 0 |  | 제관품
15 | __.__.04.__.__.__.__ | 30139089 |  | BOSS | SPCC, D6, M3, H7/ | 8 | 외작 | C | 0 / 0 | 0 |  | 제관품
16 | __.__.05.__.__.__.__ | 30139095 |  | EARTH PAD | SPCC, D6, M3, H6/ | 1 | 외작 | C | 0 / 0 | 0 |  | 제관품
17 | __.__.06.__.__.__.__ | 30139096 |  | FRAME | SPCC, t1.2, L640/ | 1 | 외작 | C | 0 / 0 | 0 |  | 제관품
18 | __.__.07.__.__.__.__ | 30139097 |  | FRAME | SPCC, t1.2, L560/ | 1 | 외작 | C | 0 / 0 | 0 |  | 제관품
19 | __.03.__.__.__.__.__ | 30139046 | R1B000018 | LED BRKT | ASS'Y/ | 1 | 외작 | C | 0 / 0 | 0 |  | 제관품
20 | __.__.01.__.__.__.__ | 30139104 |  | LED BRACKET | A366-91,t=1.2/ | 1 | 외작 | C | 0 / 0 | 0 |  | 제관품
21 | __.04.__.__.__.__.__ | 30139047 | R1D000328 | INSTALL BRKT | ASS'Y/ | 1 | 외작 | C | 0 / 0 | 0 |  | 제관품
22 | __.__.01.__.__.__.__ | 30139108 |  | BRACKET | A569,t=3.2/ | 1 | 외작 | C | 0 / 0 | 0 |  | 제관품
23 | __.05.__.__.__.__.__ | 30139109 | R1D000333 | BRACKET | ASS'Y/ | 1 | 외작 | C | 0 / 0 | 0 |  | 제관품
24 | __.__.01.__.__.__.__ | 30139110 |  | BRACKET | A366-91,t=1.0/ | 1 | 외작 | C | 0 / 0 | 0 |  | 제관품
25 | __.__.02.__.__.__.__ | 30139111 |  | NUT | SS400,L=7/ | 2 | 외작 | C | 0 / 0 | 0 |  | 제관품
26 | __.06.__.__.__.__.__ | 30139105 | R1D000321 | CONNECTOR BRACKET | ASS'Y/ | 1 | 외작 | C | 0 / 0 | 0 |  | 제관품
27 | __.__.01.__.__.__.__ | 30139106 |  | CONNECTOR BRACKET | A569,t=2.0/ | 1 | 외작 | C | 0 / 0 | 0 |  | 제관품
28 | __.__.02.__.__.__.__ | 30138793 |  | POP NUT | M3/ | 4 | 외작 | C | 0 / 0 | 0 |  | 제관품
29 | __.07.__.__.__.__.__ | 30140805 | R1D000327 | BRACKET | ASS'Y/ | 1 | 외작 | C | 0 / 0 | 0 |  | 제관품
30 | __.__.01.__.__.__.__ | 30140806 |  | BRACKET | A366-91,t1.0/ | 1 | 외작 | C | 0 / 0 | 0 |  | 제관품
31 | __.__.02.__.__.__.__ | 30139467 |  | BLIND NUT | M3/ | 2 | 외작 | C | 0 / 0 | 0 |  | 제관품
32 | __.08.__.__.__.__.__ | 30139048 | R1D000329 | HINGE | ASS'Y/ | 1 | 외작 | C | 0 / 0 | 0 |  | 제관품
33 | __.__.01.__.__.__.__ | 30139112 |  | HINGE | HS-2638-F/ | 1 | 외작 | C | 0 / 0 | 0 |  | 제관품
34 | __.__.02.__.__.__.__ | 30139113 |  | HINGE | HS-2638-PIN/ | 1 | 외작 | C | 0 / 0 | 0 |  | 제관품
35 | 02.__.__.__.__.__.__ | 30138733 | R1D000320 | AMBER LED MODULE | ODTLM-096CY-16A1/ | 10 | 내자 | A | 0 / 0 | 0 |  | 전기부품
36 | 03.__.__.__.__.__.__ | 30138742 | R1D000325 | POWER BOARD | VICOR/ | 1 | 내자 | 무검사 | 0 / 0 | 0 |  | PCB
37 | __.01.__.__.__.__.__ | 30140840 |  | CONNECTOR | 5569-06/ | 1 | 외자 | 무검사 | 0 / 0 | 0 |  | 전기부품
38 | __.02.__.__.__.__.__ | 30140856 |  | CONNECTOR | 5569-18/ | 1 | 외자 | 무검사 | 0 / 0 | 0 |  | 전기부품
39 | 04.__.__.__.__.__.__ | 30138734 | R1D000324 | FDI SDI PII CONTROL BOARD | LEDC/ | 1 | 내자 | 무검사 | 0 / 0 | 0 |  | PCB
40 | __.01.__.__.__.__.__ | 30140857 |  | CONNECTOR | 5569-16A1/ | 1 | 외자 | 무검사 | 0 / 0 | 0 |  | 전기부품
41 | __.02.__.__.__.__.__ | 30139243 |  | CONNECTOR | 5569-08A1/ | 1 | 외자 | 무검사 | 0 / 0 | 0 |  | 전기부품
42 | __.03.__.__.__.__.__ | 30140858 |  | CONNECTOR | 35312-05/ | 1 | 내자 | 무검사 | 0 / 0 | 0 |  | 전자부품
43 | __.04.__.__.__.__.__ | 30140859 |  | CONNECTOR | B15B-PH-K-S/ | 2 | 내자 | 무검사 | 0 / 0 | 0 |  | 전자부품
44 | __.05.__.__.__.__.__ | 30140860 |  | CONNECTOR | B12B-PH-K-S/ | 2 | 내자 | 무검사 | 0 / 0 | 0 |  | 전자부품
45 | 05.__.__.__.__.__.__ | 30138703 |  | CONNECTOR | ITH030F22-14PBG0F1F6/ | 1 | 외자 | C | 39 / 58 | 0 |  | 전자부품
46 | 06.__.__.__.__.__.__ | 30138704 |  | CONNECTOR | ITH06F22-14SB0F6/ | 1 | 내자 | 무검사 | 0 / 0 | 0 |  | 전자부품
47 | 07.__.__.__.__.__.__ | 30139107 | R1D000332 | RGB LED MODULE | ODTLM-096CF-16B1/ | 2 | 내자 | A | 0 / 0 | 0 |  | 전기부품
48 | 08.__.__.__.__.__.__ | 30139311 | R1D000451 | GROMMET(FDI,SDI,PII,DPO) | RUBBER/ | 1 | 외작 | 무검사 | 0 / 0 | 0 |  | 모름
49 | 09.__.__.__.__.__.__ | 30139314 | R1D000452(03) | NAME PLATE(FDI) | t=1.0/AL | 1 | 내자 | 무검사 | 0 / 0 | 0 |  | 명판
50 | 10.__.__.__.__.__.__ | 30138690 |  | EMC GASKET | SF050010R-C-NA-A/ | 12 | 내자 | 무검사 | 29 / 58 | 0 |  | 시중품
51 | 11.__.__.__.__.__.__ | 30120840 |  | PHILLIPS RECESS | D3-316-713-190/ | 4 | 외자 | A | 0 / 0 | 0 |  | 전기부품
52 | 12.__.__.__.__.__.__ | 30120532 |  | RECEPTACLE SLIP ON | D3-336-330-190/ | 4 | 외자 | A | 0 / 0 | 0 |  | 전기부품
53 | 13.__.__.__.__.__.__ | 30139114 |  | RECEPTACLE SLIP N | D3-328-101-200/ | 4 | 외자 | A | 0 / 0 | 0 |  | 전기부품
54 | 14.__.__.__.__.__.__ | 30120534 |  | 6MM CPU HEAD EMBELISHR | D3-376-001-049/ | 4 | 외자 | A | 0 / 0 | 0 |  | 전기부품
55 | 15.__.__.__.__.__.__ | 30120535 |  | EJECTOR SPRING STAINLESS | D4-EHF5-3-950-QA/ | 4 | 외자 | A | 0 / 0 | 0 |  | 전기부품
56 | 16.__.__.__.__.__.__ | 30139122 | R1D000326 | LIGHT SENSOR | LEDS/ | 1 | 내자 | 무검사 | 0 / 0 | 0 |  | PCB
57 | 17.__.__.__.__.__.__ | 30140861 |  | RUBBER TUBE | ø17,t0.5/ | 1 | 내자 | 무검사 | 0 / 0 | 0 |  | 모름
58 | 18.__.__.__.__.__.__ | 30139127 |  | BOLT&WASHER LIST | ASS'Y/ | 1 | 내자 | 무검사 | 0 / 0 | 0 |  | 모름
59 | 19.__.__.__.__.__.__ | 20064152 | R1D000445 | FDI WIRING DIAGRAM | ASS'Y/ | 1 | 내작 | 무검사 | 0 / 0 | 0 |  | 하네스도
60 | __.01.__.__.__.__.__ | 30127617 |  | WIRE | 100G0111-0.75-0/ | 1 | 외자 | 무검사 | 0 / 0 | 0 |  | 전선
61 | __.02.__.__.__.__.__ | 30139217 |  | WIRE | 100G1121-0.75-2/6/ | 1 | 외자 | C | 0 / 0 | 0 |  | 전선
62 | __.03.__.__.__.__.__ | 30139216 |  | CONNECTOR | 5557-06R/ | 1 | 내자 | 무검사 | 0 / 0 | 0 |  | 전자부품
63 | __.04.__.__.__.__.__ | 30139218 |  | CONNECTOR | 5557-16R/ | 1 | 외자 | 무검사 | 0 / 0 | 0 |  | 전자부품
64 | __.05.__.__.__.__.__ | 30110820 |  | CONNECTOR HOUSING | 5557-08R/ | 1 | 외자 | 무검사 | 0 / 0 | 0 |  | 전자부품
65 | __.06.__.__.__.__.__ | 30139218 |  | CONNECTOR | 5557-16R/ | 1 | 외자 | 무검사 | 0 / 0 | 0 |  | 전자부품
66 | __.07.__.__.__.__.__ | 30081231 |  | TERMINAL | 5556, AWG18-24/ | 53 | 외자 | 무검사 | 0 / 0 | 0 |  | 전기부품
67 | __.08.__.__.__.__.__ | 30139219 |  | CONNECTOR | 03597/ | 2 | 내자 | 무검사 | 0 / 0 | 0 |  | 전자부품

Sheet: sdi
 |  |  |  |  | B O M L I S T
BOM 번호: 10007311-01 [10007311][R1D1473-25850][] (SDI)LED SIDE DESTINATION SIGN
BOM 설명: 덴버 SDI1
No | LEVEL | 품목코드 | 도면번호 | 품 명 | 품 명 | 수량 SET수량 | 조달 형태 | 품질 등급 | 구매L/T 양산/개발 | 표준 공수 | 품목형태
1 | 01.__.__.__.__.__.__ | 30138712 | R1B000019 | SDI BOX ASS'Y | ASS'Y/ | 1 | 내자 | 무검사 | 0 / 0 | 0 | 제관품
2 | __.01.__.__.__.__.__ | 30138713 | R1B000021 | FRAME | ASS'Y/ | 1 | 내자 | 무검사 | 0 / 0 | 0 | 제관품
3 | __.__.01.__.__.__.__ | 30138719 |  | FRAME | A591-CQ,t1.2/ | 1 | 내자 | 무검사 | 54 / 83 | 0 | 제관품
4 | __.__.02.__.__.__.__ | 30138720 |  | EARTH PAD | #10-24 UNCXL10[0.47]/ | 2 | 내자 | 무검사 | 0 / 0 | 0 | 제관품
5 | __.__.03.__.__.__.__ | 30138721 |  | EARTH PAD | D8[0.31],M4,H6[0.24]/ | 2 | 내자 | 무검사 | 0 / 0 | 0 | 제관품
6 | __.__.04.__.__.__.__ | 30139496 |  | BLIND NUT | M4/ | 6 | 외작 | C | 0 / 0 | 0 | 제관품
7 | __.__.05.__.__.__.__ | 30140782 |  | HEXA HEAD STANDOFF | D8,M4,H6/ | 2 | 내자 | 무검사 | 0 / 0 | 0 | 가공품
8 | __.__.06.__.__.__.__ | 30140781 |  | HEXA HEAD STANDOFF | M5/ | 4 | 내자 | 무검사 | 0 / 0 | 0 | 가공품
9 | __.__.07.__.__.__.__ | 30140783 |  | WIRE SUPPORT | D4,L351,H8/SS400 | 2 | 외작 | C | 0 / 0 | 0 | 제관품
10 | __.__.08.__.__.__.__ | 30140784 |  | WIRE SUPPORT | D4,L103,H8/SS400 | 2 | 외작 | C | 0 / 0 | 0 | 제관품
11 | __.02.__.__.__.__.__ | 30138714 | R1B000020 | COVER | ASS'Y/ | 1 | 내자 | 무검사 | 54 / 83 | 0 | 제관품
12 | __.__.01.__.__.__.__ | 30140785 |  | COVER | A591-CQ,t1.2/ | 1 | 외작 | C | 54 / 83 | 0 | 제관품
13 | __.__.02.__.__.__.__ | 30140786 |  | HEXA HEAD STANDOFF | M3,H6/ | 4 | 내자 | 무검사 | 0 / 0 | 0 | 가공품
14 | __.__.03.__.__.__.__ | 30140787 |  | HEXA HEAD STANDOFF | M3,H8/ | 8 | 내자 | 무검사 | 0 / 0 | 0 | 가공품
15 | __.__.04.__.__.__.__ | 30138700 |  | EARTH PAD | M4 H6[0.24]/ | 2 | 내자 | 무검사 | 0 / 0 | 0 | 제관품
16 | __.__.05.__.__.__.__ | 30138727 |  | WIRE SUPPORT | D4[0.16],L110[4.33],H13[0.51]/SPCC | 4 | 내자 | 무검사 | 0 / 0 | 0 | 제관품
17 | __.__.06.__.__.__.__ | 30138728 |  | PLATE | A366-91,t1.2[0.05],L998[39.32]/ | 1 | 내자 | 무검사 | 0 / 0 | 0 | 제관품
18 | __.__.07.__.__.__.__ | 30138729 |  | PLATE | A366-91,t1.2[0.05],L909[35.81]/ | 1 | 내자 | 무검사 | 0 / 0 | 0 | 제관품
19 | __.03.__.__.__.__.__ | 30138715 | R1B000022 | LED BRACKET | ASS'Y/ | 1 | 내자 | 무검사 | 54 / 83 | 0 | 제관품
20 | __.__.01.__.__.__.__ | 30140788 |  | LED BRACKET | A366-91,t1.2/ | 1 | 외작 | C | 0 / 0 | 0 | 제관품
21 | __.__.02.__.__.__.__ | 30140789 |  | WIRE SUPPORT | D4,L100,H10/SS400 | 1 | 내자 | 무검사 | 0 / 0 | 0 | 제관품
22 | __.04.__.__.__.__.__ | 30138716 | R1D000334 | INSTALL BRKT | ASS'Y/ | 2 | 내자 | 무검사 | 54 / 83 | 0 | 제관품
23 | __.__.01.__.__.__.__ | 30140790 |  | INSTALL BRKT | A569,t2/ | 1 | 외작 | C | 0 / 0 | 0 | 제관품
24 | __.05.__.__.__.__.__ | 30139109 | R1D000333 | BRACKET | ASS'Y/ | 1 | 외작 | C | 0 / 0 | 0 | 제관품
25 | __.__.01.__.__.__.__ | 30139110 |  | BRACKET | A366-91,t=1.0/ | 1 | 외작 | C | 0 / 0 | 0 | 제관품
26 | __.__.02.__.__.__.__ | 30139111 |  | NUT | SS400,L=7/ | 2 | 외작 | C | 0 / 0 | 0 | 제관품
27 | __.06.__.__.__.__.__ | 30139109 | R1D000333 | BRACKET | ASS'Y/ | 1 | 외작 | C | 0 / 0 | 0 | 제관품
28 | __.__.01.__.__.__.__ | 30140791 |  | BRACKET | A366-91,t=1.0/ | 1 | 외작 | C | 0 / 0 | 0 | 제관품
29 | __.__.02.__.__.__.__ | 30139467 |  | BLIND NUT | M3/ | 2 | 외작 | C | 0 / 0 | 0 | 제관품
30 | __.07.__.__.__.__.__ | 30139105 | R1D000321 | CONNECTOR BRACKET | ASS'Y/ | 1 | 외작 | C | 0 / 0 | 0 | 제관품
31 | __.__.01.__.__.__.__ | 30139106 |  | CONNECTOR BRACKET | A569,t=2.0/ | 1 | 외작 | C | 0 / 0 | 0 | 제관품
32 | __.__.02.__.__.__.__ | 30138793 |  | POP NUT | M3/ | 4 | 외작 | C | 0 / 0 | 0 | 제관품
33 | __.08.__.__.__.__.__ | 30139048 | R1D000329 | HINGE | ASS'Y/ | 1 | 외작 | C | 0 / 0 | 0 | 제관품
34 | __.__.01.__.__.__.__ | 30139112 |  | HINGE | HS-2638-F/ | 1 | 외작 | C | 0 / 0 | 0 | 제관품
35 | __.__.02.__.__.__.__ | 30139113 |  | HINGE | HS-2638-PIN/ | 1 | 외작 | C | 0 / 0 | 0 | 제관품
36 | __.09.__.__.__.__.__ | 30140736 | R1D000707 | LIGHT SENSOR BRACKET | ASS'Y/ | 1 | 내자 | 무검사 | 54 / 83 | 0 | 제관품
37 | __.__.01.__.__.__.__ | 30140792 |  | LIGHT SENSOR BRACKET | A366-91,t1/ | 1 | 외작 | C | 0 / 0 | 0 | 제관품
38 | __.__.02.__.__.__.__ | 30140768 |  | HEXA HEAD STANDOFF | M3,L6/ | 2 | 내자 | 무검사 | 44 / 73 | 0 | 가공품
39 | 02.__.__.__.__.__.__ | 30138733 | R1D000320 | AMBER LED MODULE | ODTLM-096CY-16A1/ | 10 | 내자 | A | 0 / 0 | 0 | 전기부품
40 | 03.__.__.__.__.__.__ | 30138734 | R1D000324 | FDI SDI PII CONTROL BOARD | LEDC/ | 1 | 내자 | 무검사 | 0 / 0 | 0 | PCB
41 | __.01.__.__.__.__.__ | 30140857 |  | CONNECTOR | 5569-16A1/ | 1 | 외자 | 무검사 | 0 / 0 | 0 | 전기부품
42 | __.02.__.__.__.__.__ | 30139243 |  | CONNECTOR | 5569-08A1/ | 1 | 외자 | 무검사 | 0 / 0 | 0 | 전기부품
43 | __.03.__.__.__.__.__ | 30140858 |  | CONNECTOR | 35312-05/ | 1 | 내자 | 무검사 | 0 / 0 | 0 | 전자부품
44 | __.04.__.__.__.__.__ | 30140859 |  | CONNECTOR | B15B-PH-K-S/ | 2 | 내자 | 무검사 | 0 / 0 | 0 | 전자부품
45 | __.05.__.__.__.__.__ | 30140860 |  | CONNECTOR | B12B-PH-K-S/ | 2 | 내자 | 무검사 | 0 / 0 | 0 | 전자부품
46 | 04.__.__.__.__.__.__ | 30138704 |  | CONNECTOR | ITH06F22-14SB0F6/ | 1 | 내자 | 무검사 | 0 / 0 | 0 | 전자부품
47 | 05.__.__.__.__.__.__ | 30138703 |  | CONNECTOR | ITH030F22-14PBG0F1F6/ | 1 | 외자 | C | 39 / 58 | 0 | 전자부품
48 | 06.__.__.__.__.__.__ | 30138742 | R1D000325 | POWER BOARD | VICOR/ | 1 | 내자 | 무검사 | 0 / 0 | 0 | PCB
49 | __.01.__.__.__.__.__ | 30140840 |  | CONNECTOR | 5569-06/ | 1 | 외자 | 무검사 | 0 / 0 | 0 | 전기부품
50 | __.02.__.__.__.__.__ | 30140856 |  | CONNECTOR | 5569-18/ | 1 | 외자 | 무검사 | 0 / 0 | 0 | 전기부품
51 | 07.__.__.__.__.__.__ | 30139107 | R1D000332 | RGB LED MODULE | ODTLM-096CF-16B1/ | 2 | 내자 | A | 0 / 0 | 0 | 전기부품
52 | 08.__.__.__.__.__.__ | 30139315 | R1D000452(04) | NAME PLATE(SDI) | t=1.0/AL | 1 | 내자 | 무검사 | 0 / 0 | 0 | 명판
53 | 09.__.__.__.__.__.__ | 30139311 | R1D000451 | GROMMET(FDI,SDI,PII,DPO) | RUBBER/ | 1 | 외작 | 무검사 | 0 / 0 | 0 | 모름
54 | 10.__.__.__.__.__.__ | 30120840 |  | PHILLIPS RECESS | D3-316-713-190/ | 4 | 외자 | A | 0 / 0 | 0 | 전기부품
55 | 11.__.__.__.__.__.__ | 30139248 |  | RECEPTACLE SLIP ON | D3-326-330-190/ | 4 | 외자 | A | 0 / 0 | 0 | 전기부품
56 | 12.__.__.__.__.__.__ | 30120533 |  | RECEPTACLE SLIP N | D3-326-101-200/ | 4 | 외자 | A | 0 / 0 | 0 | 전기부품
57 | 13.__.__.__.__.__.__ | 30120534 |  | 6MM CPU HEAD EMBELISHR | D3-376-001-049/ | 4 | 외자 | A | 0 / 0 | 0 | 전기부품
58 | 14.__.__.__.__.__.__ | 30120535 |  | EJECTOR SPRING STAINLESS | D4-EHF5-3-950-QA/ | 4 | 외자 | A | 0 / 0 | 0 | 전기부품
59 | 15.__.__.__.__.__.__ | 30138690 |  | EMC GASKET | SF050010R-C-NA-A/ | 13 | 내자 | 무검사 | 29 / 58 | 0 | 시중품
60 | 16.__.__.__.__.__.__ | 30139250 |  | BOLT&NUT LIST | ASS'Y/ | 1 | 내자 | 무검사 | 0 / 0 | 0 | 모름
61 | 17.__.__.__.__.__.__ | 30139122 | R1D000326 | LIGHT SENSOR | LEDS/ | 1 | 내자 | 무검사 | 0 / 0 | 0 | PCB
62 | 18.__.__.__.__.__.__ | 30140855 |  | RUBBER RUBE | ø17,t0.5/ | 1 | 내자 | 무검사 | 0 / 0 | 0 | 모름
63 | 19.__.__.__.__.__.__ | 30138689 |  | WIRE MESH | DUST FILTER #25/ | 1 | 내자 | 무검사 | 0 / 0 | 0 | 모름
64 | 20.__.__.__.__.__.__ | 20064151 | R1D000444 | SDI WIRING DIAGRAM | ASS'Y/ | 1 | 내작 | 무검사 | 0 / 0 | 0 | 하네스도
65 | __.01.__.__.__.__.__ | 30140793 |  | WIRE | 100G1121-0.75-0/ | 1 | 외자 | C | 0 / 0 | 0 | 전선
66 | __.02.__.__.__.__.__ | 30139217 |  | WIRE | 100G1121-0.75-2/6/ | 1 | 외자 | C | 0 / 0 | 0 | 전선
67 | __.03.__.__.__.__.__ | 30139216 |  | CONNECTOR | 5557-06R/ | 1 | 내자 | 무검사 | 0 / 0 | 0 | 전자부품
68 | __.04.__.__.__.__.__ | 30139218 |  | CONNECTOR | 5557-16R/ | 1 | 외자 | 무검사 | 0 / 0 | 0 | 전자부품
69 | __.05.__.__.__.__.__ | 30110820 |  | CONNECTOR HOUSING | 5557-08R/ | 1 | 외자 | 무검사 | 0 / 0 | 0 | 전자부품
70 | __.06.__.__.__.__.__ | 30139218 |  | CONNECTOR | 5557-16R/ | 1 | 외자 | 무검사 | 0 / 0 | 0 | 전자부품
71 | __.07.__.__.__.__.__ | 30081231 |  | TERMINAL | 5556, AWG18-24/ | 53 | 외자 | 무검사 | 0 / 0 | 0 | 전기부품
72 | __.08.__.__.__.__.__ | 30139219 |  | CONNECTOR | 03597/ | 2 | 내자 | 무검사 | 0 / 0 | 0 | 전자부품

Sheet: pii
 |  |  |  |  | B O M L I S T
BOM 번호: 10007314-01 [10007314][R1D1473-25853][] (PII)LED PASSENGER INFORMATION INDICATOR
BOM 설명: 미국 DENVER PII
No | LEVEL | 품목코드 | 도면번호 | 품 명 | 품 명 | 수량 SET수량 | 조달 형태 | 품질 등급 | 구매L/T 양산/개발 | 표준 공수 | 품목형태
1 | 01.__.__.__.__.__.__ | 30138691 | R1B000024 | PII BOX ASS'Y | ASS'Y/ | 1 | 내자 | 무검사 | 0 / 0 | 0 | 제관품
2 | __.01.__.__.__.__.__ | 30140794 | R1D000347 | FRONT PLATE | ASS'Y/ | 1 | 외작 | C | 0 / 0 | 0 | 제관품
3 | __.__.01.__.__.__.__ | 30140796 |  | FRONT PLATE | t3.0/304SS | 1 | 외작 | C | 0 / 0 | 0 | 제관품
4 | __.__.02.__.__.__.__ | 30140797 |  | STUD BOLT | M4,H12/ | 8 | 내자 | C | 0 / 0 | 0 | 가공품
5 | __.02.__.__.__.__.__ | 30138692 | R1C000045 | FRAME | ASS'Y/ | 1 | 내자 | 무검사 | 54 / 83 | 0 | 제관품
6 | __.__.01.__.__.__.__ | 30140798 |  | FRAME | A591-CQ,t1.2/ | 1 | 외작 | C | 0 / 0 | 0 | 제관품
7 | __.__.02.__.__.__.__ | 30140799 |  | EARTH PAD | #24-14,UNC/ | 1 | 외작 | C | 0 / 0 | 0 | 제관품
8 | __.__.03.__.__.__.__ | 30139496 |  | BLIND NUT | M4/ | 8 | 외작 | C | 0 / 0 | 0 | 제관품
9 | __.__.04.__.__.__.__ | 30139052 |  | EARTH PAD | D8, M4, L10/ | 1 | 외작 | C | 0 / 0 | 0 | 제관품
10 | __.__.05.__.__.__.__ | 30140800 |  | WIRE SUPPORT | D4,L248,H10/SS400 | 6 | 내자 | 무검사 | 0 / 0 | 0 | 가공품
11 | __.03.__.__.__.__.__ | 30138693 | R1B000023 | LED BRACKET | ASS'Y/ | 1 | 내자 | 무검사 | 54 / 83 | 0 | 제관품
12 | __.__.01.__.__.__.__ | 30140801 |  | LED BRACKET | A366-91,t1.2/ | 1 | 외작 | C | 0 / 0 | 0 | 제관품
13 | __.04.__.__.__.__.__ | 30138694 | R1B000025 | COVER | ASS'Y/ | 2 | 내자 | 무검사 | 54 / 83 | 0 | 제관품
14 | __.__.01.__.__.__.__ | 30140802 |  | COVER | A591-CA,t1.2/ | 1 | 외작 | C | 0 / 0 | 0 | 제관품
15 | __.__.02.__.__.__.__ | 30140803 |  | HEAX HEAD STANDOFF | M3,H8.5/ | 1 | 내자 | 무검사 | 0 / 0 | 0 | 가공품
16 | __.__.03.__.__.__.__ | 30140804 |  | HEAX HEAD STANDOFF | M3,H4.8/ | 6 | 내자 | 무검사 | 0 / 0 | 0 | 가공품
17 | __.__.04.__.__.__.__ | 30138700 |  | EARTH PAD | M4 H6[0.24]/ | 2 | 내자 | 무검사 | 0 / 0 | 0 | 제관품
18 | __.__.05.__.__.__.__ | 30138701 |  | WIRE SUPPORT | D4[0.16],L80[4.33],H15[0.59]/SS400 | 4 | 내자 | 무검사 | 0 / 0 | 0 | 제관품
19 | __.05.__.__.__.__.__ | 30140805 | R1D000327 | BRACKET | ASS'Y/ | 1 | 외작 | C | 0 / 0 | 0 | 제관품
20 | __.__.01.__.__.__.__ | 30140806 |  | BRACKET | A366-91,t1.0/ | 1 | 외작 | C | 0 / 0 | 0 | 제관품
21 | __.__.02.__.__.__.__ | 30139467 |  | BLIND NUT | M3/ | 2 | 외작 | C | 0 / 0 | 0 | 제관품
22 | __.06.__.__.__.__.__ | 30139105 | R1D000321 | CONNECTOR BRACKET | ASS'Y/ | 1 | 외작 | C | 0 / 0 | 0 | 제관품
23 | __.__.01.__.__.__.__ | 30139106 |  | CONNECTOR BRACKET | A569,t=2.0/ | 1 | 외작 | C | 0 / 0 | 0 | 제관품
24 | __.__.02.__.__.__.__ | 30138793 |  | POP NUT | M3/ | 4 | 외작 | C | 0 / 0 | 0 | 제관품
25 | 02.__.__.__.__.__.__ | 20064102 | R1D000348 | PII LED MODULE | ODTLM-064CY-16B1/ | 8 | 내자 | 무검사 | 0 / 0 | 0 | 표시장치
26 | 03.__.__.__.__.__.__ | 30138734 | R1D000324 | FDI SDI PII CONTROL BOARD | LEDC/ | 1 | 내자 | 무검사 | 0 / 0 | 0 | PCB
27 | __.01.__.__.__.__.__ | 30140857 |  | CONNECTOR | 5569-16A1/ | 1 | 외자 | 무검사 | 0 / 0 | 0 | 전기부품
28 | __.02.__.__.__.__.__ | 30139243 |  | CONNECTOR | 5569-08A1/ | 1 | 외자 | 무검사 | 0 / 0 | 0 | 전기부품
29 | __.03.__.__.__.__.__ | 30140858 |  | CONNECTOR | 35312-05/ | 1 | 내자 | 무검사 | 0 / 0 | 0 | 전자부품
30 | __.04.__.__.__.__.__ | 30140859 |  | CONNECTOR | B15B-PH-K-S/ | 2 | 내자 | 무검사 | 0 / 0 | 0 | 전자부품
31 | __.05.__.__.__.__.__ | 30140860 |  | CONNECTOR | B12B-PH-K-S/ | 2 | 내자 | 무검사 | 0 / 0 | 0 | 전자부품
32 | 04.__.__.__.__.__.__ | 30138702 | R1D000350 | PII POWER CONTROL BOARD | VICOR/ | 1 | 내자 | 무검사 | 0 / 0 | 0 | PCB
33 | __.01.__.__.__.__.__ | 30140840 |  | CONNECTOR | 5569-06/ | 1 | 외자 | 무검사 | 0 / 0 | 0 | 전기부품
34 | __.02.__.__.__.__.__ | 30140862 |  | CONNECTOR | 5569-10/ | 1 | 외자 | 무검사 | 0 / 0 | 0 | 전기부품
35 | 05.__.__.__.__.__.__ | 30138704 |  | CONNECTOR | ITH06F22-14SB0F6/ | 1 | 내자 | 무검사 | 0 / 0 | 0 | 전자부품
36 | 06.__.__.__.__.__.__ | 30138703 |  | CONNECTOR | ITH030F22-14PBG0F1F6/ | 1 | 내자 | 무검사 | 39 / 58 | 0 | 전자부품
37 | 07.__.__.__.__.__.__ | 30140863 |  | RUBBER GROMET | EPDM, Φ32MM(1.5inch)/ | 1 | 내자 | 무검사 | 0 / 0 | 0 | 모름
38 | 08.__.__.__.__.__.__ | 30139316 | R1D000452(05) | NAME PLATE(PII) | t=1.0/AL | 1 | 내자 | 무검사 | 0 / 0 | 0 | 명판
39 | 09.__.__.__.__.__.__ | 30120840 |  | PHILLIPS RECESS | D3-316-713-190/ | 4 | 외자 | A | 0 / 0 | 0 | 전기부품
40 | 10.__.__.__.__.__.__ | 30120532 |  | RECEPTACLE SLIP ON | D3-336-330-190/ | 4 | 외자 | A | 0 / 0 | 0 | 전기부품
41 | 11.__.__.__.__.__.__ | 30120533 |  | RECEPTACLE SLIP N | D3-326-101-200/ | 4 | 외자 | A | 0 / 0 | 0 | 전기부품
42 | 12.__.__.__.__.__.__ | 30120534 |  | 6MM CPU HEAD EMBELISHR | D3-376-001-049/ | 4 | 외자 | A | 0 / 0 | 0 | 전기부품
43 | 13.__.__.__.__.__.__ | 30120535 |  | EJECTOR SPRING STAINLESS | D4-EHF5-3-950-QA/ | 4 | 외자 | A | 0 / 0 | 0 | 전기부품
44 | 14.__.__.__.__.__.__ | 30140861 |  | RUBBER TUBE | ø17,t0.5/ | 1 | 내자 | 무검사 | 0 / 0 | 0 | 모름
45 | 15.__.__.__.__.__.__ | 30138690 |  | EMC GASKET | SF050010R-C-NA-A/ | 10 | 내자 | 무검사 | 29 / 58 | 0 | 시중품
46 | 16.__.__.__.__.__.__ | 30138709 |  | BOLT&WASHER LIST | ASS'Y/ | 1 | 내자 | 무검사 | 0 / 0 | 0 | 모름
47 | 17.__.__.__.__.__.__ | 30139048 | R1D000329 | HINGE | ASS'Y/ | 1 | 외작 | C | 0 / 0 | 0 | 제관품
48 | __.01.__.__.__.__.__ | 30139112 |  | HINGE | HS-2638-F/ | 1 | 외작 | C | 0 / 0 | 0 | 제관품
49 | __.02.__.__.__.__.__ | 30139113 |  | HINGE | HS-2638-PIN/ | 1 | 외작 | C | 0 / 0 | 0 | 제관품
50 | 18.__.__.__.__.__.__ | 30140864 | R1D000349 | COVER | POLYCARBONATE,t3/DARK BLUE COLOR | 1 | 외작 | C | 0 / 0 | 0 | 제관품
51 | 19.__.__.__.__.__.__ | 20064150 | R1D000443 | PII WIRING DIAGRAM | ASS'Y/ | 1 | 내작 | 무검사 | 0 / 0 | 0 | 하네스도
52 | __.01.__.__.__.__.__ | 30127617 |  | WIRE | 100G0111-0.75-0/ | 1 | 외자 | 무검사 | 0 / 0 | 0 | 전선
53 | __.02.__.__.__.__.__ | 30139217 |  | WIRE | 100G1121-0.75-2/6/ | 1 | 외자 | C | 0 / 0 | 0 | 전선
54 | __.03.__.__.__.__.__ | 30139216 |  | CONNECTOR | 5557-06R/ | 1 | 내자 | 무검사 | 0 / 0 | 0 | 전자부품
55 | __.04.__.__.__.__.__ | 30138256 |  | CONNECTOR | 5557-10R/ | 1 | 내자 | A | 0 / 0 | 0 | 전자부품
56 | __.05.__.__.__.__.__ | 30110820 |  | CONNECTOR HOUSING | 5557-08R/ | 1 | 외자 | 무검사 | 0 / 0 | 0 | 전자부품
57 | __.06.__.__.__.__.__ | 30139218 |  | CONNECTOR | 5557-16R/ | 1 | 외자 | 무검사 | 0 / 0 | 0 | 전자부품
58 | __.07.__.__.__.__.__ | 30081231 |  | TERMINAL | 5556, AWG18-24/ | 40 | 외자 | 무검사 | 0 / 0 | 0 | 전기부품
59 | 20.__.__.__.__.__.__ | 30139311 | R1D000451 | GROMMET(FDI,SDI,PII,DPO) | RUBBER/ | 1 | 외작 | 무검사 | 0 / 0 | 0 | 모름

Sheet: PID1
 |  |  |  |  | B O M L I S T
BOM 번호: 10007312-01 [10007312][R1D1473-25851][] (PID1)LCD DISPLAY-1
BOM 설명: 미국 DENVER PID1
No | LEVEL | 품목코드 | 도면번호 | 품 명 | 품 명 | 수량 SET수량 | 조달 형태 | 품질 등급 | 구매L/T 양산/개발 | 표준 공수 | 품목형태
1 | 01.__.__.__.__.__.__ | 30139166 | R1C000038 | BOX ASS'Y | ASS'Y/ | 1 | 외작 | C | 0 / 0 | 0 | 제관품
2 | __.01.__.__.__.__.__ | 30139167 | R1D000339 | COVER | ASS'Y/ | 1 | 외작 | C | 0 / 0 | 0 | 제관품
3 | __.__.01.__.__.__.__ | 30140764 |  | COVER | A366-91,t=1.2/ | 1 | 외작 | C | 0 / 0 | 0 | 제관품
4 | __.__.02.__.__.__.__ | 30139174 |  | HEAX HEAD STANDOFF | M3,L6/ | 7 | 외작 | C | 44 / 73 | 0 | 가공품
5 | __.__.03.__.__.__.__ | 30139175 |  | HEXA HEAD STANDOFF | M4,L6/ | 4 | 외작 | C | 44 / 73 | 0 | 가공품
6 | __.02.__.__.__.__.__ | 30139168 | R1C000040 | FRAME | ASS'Y/ | 1 | 외작 | C | 0 / 0 | 0 | 제관품
7 | __.__.01.__.__.__.__ | 30140767 |  | FRAME | A366-91,t=1.2/ | 1 | 외작 | C | 0 / 0 | 0 | 제관품
8 | __.__.02.__.__.__.__ | 30139176 |  | WIRE SUPPORT | D4, L110, H12/AL | 2 | 외작 | C | 0 / 0 | 0 | 제관품
9 | __.__.03.__.__.__.__ | 30139177 |  | WIRE SUPPORT | D4, L100, H12/AL | 1 | 외작 | C | 0 / 0 | 0 | 제관품
10 | __.__.04.__.__.__.__ | 30139178 |  | WIRE SUPPORT | D4, L50, H12/AL | 2 | 외작 | C | 0 / 0 | 0 | 제관품
11 | __.__.05.__.__.__.__ | 30139179 |  | HEXA HEAD STANDOFF | M4,L6/ | 4 | 내자 | 무검사 | 0 / 0 | 0 | 가공품
12 | __.__.06.__.__.__.__ | 30139180 |  | HEXA HEAD STANDOFF | M4,L8/ | 6 | 내자 | 무검사 | 0 / 0 | 0 | 가공품
13 | __.__.07.__.__.__.__ | 30140768 |  | HEXA HEAD STANDOFF | M3,L6/ | 4 | 외작 | C | 44 / 73 | 0 | 가공품
14 | __.__.08.__.__.__.__ | 30139183 |  | NUT | #10-24, L12/ | 11 | 외작 | C | 0 / 0 | 0 | 소모품
15 | __.__.09.__.__.__.__ | 30139240 | R1D000336 | HINGE | ASS'Y/ | 2 | 외작 | C | 0 / 0 | 0 | 제관품
16 | __.__.__.01.__.__.__ | 30139185 |  | HINGE BRACKET | 304SS, t2/ | 1 | 외작 | C | 0 / 0 | 0 | 제관품
17 | __.__.__.02.__.__.__ | 30139186 |  | HINGE BRACKET | 304SS, t2/ | 1 | 외작 | C | 0 / 0 | 0 | 제관품
18 | __.__.__.03.__.__.__ | 30139241 |  | HINGE PIN | 304SS, D3.4/ | 1 | 내자 | 무검사 | 0 / 0 | 0 | 모름
19 | __.__.__.04.__.__.__ | 30139188 |  | SLEEVE | 304SS,t0.5/ | 2 | 내자 | 무검사 | 0 / 0 | 0 | 가공품
20 | __.__.__.05.__.__.__ | 30139189 |  | E-RING | SKD5/ | 1 | 내자 | 무검사 | 0 / 0 | 0 | 시중품
21 | __.03.__.__.__.__.__ | 30139172 | R1C000037 | LCD BRACKET | ASS'Y/ | 1 | 외작 | C | 0 / 0 | 0 | 제관품
22 | __.__.01.__.__.__.__ | 30138695 |  | BRACKET | A366-91,t=1.0/ | 1 | 내자 | 무검사 | 0 / 0 | 0 | 제관품
23 | __.__.02.__.__.__.__ | 30139190 |  | HEXA HEAD STANDOFF | D5,M3,L5/ | 2 | 외작 | C | 44 / 73 | 0 | 가공품
24 | __.__.03.__.__.__.__ | 30140769 |  | CLINCHING NUT | M3/ | 2 | 내자 | 무검사 | 0 / 0 | 0 | 시중품
25 | __.__.04.__.__.__.__ | 30140770 |  | HEXA HEAD STANDOFF | D5,M3,L7.3/ | 2 | 내자 | 무검사 | 0 / 0 | 0 | 가공품
26 | __.04.__.__.__.__.__ | 30139171 | R1C000039 | INVERTER BRACKET | ASS'Y/ | 1 | 외작 | C | 0 / 0 | 0 | 제관품
27 | __.__.01.__.__.__.__ | 30138695 |  | BRACKET | A366-91,t=1.0/ | 1 | 내자 | 무검사 | 0 / 0 | 0 | 제관품
28 | __.__.02.__.__.__.__ | 30139192 |  | WIRE SUPPORT | D4, L219, H18/SS400 | 1 | 외작 | C | 44 / 73 | 0 | 가공품
29 | __.__.03.__.__.__.__ | 30140771 |  | WIRE SUPPORT | D4, L96, H18/SS400 | 1 | 내자 | 무검사 | 0 / 0 | 0 | 가공품
30 | __.__.04.__.__.__.__ | 30139194 |  | BLIND NUT | M3/ | 8 | 내자 | 무검사 | 0 / 0 | 0 | 소모품
31 | __.__.05.__.__.__.__ | 30140772 |  | HEXA HEAD STANDOFF | M3,D5,L6/ | 10 | 내자 | 무검사 | 0 / 0 | 0 | 가공품
32 | __.__.06.__.__.__.__ | 30139198 |  | EARTH PAD | #10-24, L12/ | 1 | 외작 | C | 0 / 0 | 0 | 제관품
33 | __.05.__.__.__.__.__ | 30139173 | R1D000461 | WIRE BRACKET | ASS'Y/ | 2 | 외작 | C | 0 / 0 | 0 | 제관품
34 | __.__.01.__.__.__.__ | 30140773 |  | FIXING WIRE | ASS'Y/ | 1 | 내자 | 무검사 | 0 / 0 | 0 | 제관품
35 | __.__.02.__.__.__.__ | 30140774 |  | WIRE BRACKET | 304SS,t2.0/ | 1 | 외작 | C | 0 / 0 | 0 | 제관품
36 | 02.__.__.__.__.__.__ | 30139200 | R1D000341 | LCD PC COVER | ASS'Y/ | 1 | 외작 | C | 0 / 0 | 0 | 제관품
37 | __.01.__.__.__.__.__ | 30139201 |  | LCD PC COVER | POLYCARBONATE,t3.0/ | 1 | 외작 | C | 0 / 0 | 0 | 제관품
38 | 03.__.__.__.__.__.__ | 30118138 |  | TFT-LCD | LTM190BT03/ | 1 | 내자 | 무검사 | 0 / 0 | 0 | 전기부품
39 | 04.__.__.__.__.__.__ | 30139202 |  | INVERTER BOARD | GH317A/ | 1 | 내자 | 무검사 | 0 / 0 | 0 | PCB
40 | 05.__.__.__.__.__.__ | 30139155 | R1D000338 | VIDEO RX BOARD | PID-RXB/ | 1 | 내작 | 무검사 | 0 / 0 | 0 | PCB
41 | __.01.__.__.__.__.__ | 30139242 |  | VIDEO RX BOARD | RX BOARD ASS'Y/ | 1 | 내자 | 무검사 | 0 / 0 | 0 | PCB
42 | __.02.__.__.__.__.__ | 30138589 |  | BNC CONNECTOR | CTP-BR-4001-Z,75ohm/ | 2 | 내자 | 무검사 | 0 / 0 | 0 | 전기부품
43 | __.03.__.__.__.__.__ | 30130315 |  | CONNECTOR | 5566-14/ | 1 | 내자 | A | 0 / 0 | 0 | 전자부품
44 | __.04.__.__.__.__.__ | 30139243 |  | CONNECTOR | 5569-08A1/ | 1 | 외자 | 무검사 | 0 / 0 | 0 | 전기부품
45 | __.05.__.__.__.__.__ | 30139244 |  | CONNECTOR | F1-X30SSL-HF/ | 1 | 내자 | 무검사 | 0 / 0 | 0 | 전기부품
46 | __.06.__.__.__.__.__ | 70000402 |  | CONNECTOR | DF11-12DP-2DS/ | 1 | 내자 | 무검사 | 0 / 0 | 0 | 전자부품
47 | 06.__.__.__.__.__.__ | 30139156 | R1D000337 | POWER CONVERTER BOARD | PID-PCB/ | 1 | 내작 | 무검사 | 30 / 45 | 0 | PCB
48 | __.01.__.__.__.__.__ | 30139245 |  | POWER BOARD | POWER BOARD ASS'Y/ | 1 | 외작 | C | 0 / 0 | 0 | PCB
49 | __.02.__.__.__.__.__ | 30139246 |  | CONNECTOR | 5557-06/ | 1 | 내자 | 무검사 | 0 / 0 | 0 | 전자부품
50 | __.03.__.__.__.__.__ | 30138958 |  | CONNECTOR | 5557-04/ | 1 | 외자 | 무검사 | 0 / 0 | 0 | 전자부품
51 | __.04.__.__.__.__.__ | 30135054 |  | HEAT SINK | ASS'Y/ | 1 | 내자 | 무검사 | 0 / 0 | 0 | 전자부품
52 | 07.__.__.__.__.__.__ | 30139203 |  | WIRING HARNESS | PID1-WH/ | 1 | 내자 | 무검사 | 0 / 0 | 0 | 전선
53 | 08.__.__.__.__.__.__ | 30139204 |  | CONNECTOR | FRITS4102R16S-1PB1G1F6/ | 1 | 외자 | C | 0 / 0 | 0 | 전자부품
54 | 09.__.__.__.__.__.__ | 30139204 |  | CONNECTOR | FRITS4102R16S-1PB1G1F6/ | 1 | 외자 | C | 0 / 0 | 0 | 전자부품
55 | 10.__.__.__.__.__.__ | 30139205 |  | TRIM TRIO CONNECTOR | UTP01412P/ | 1 | 내자 | 무검사 | 0 / 0 | 0 | 전자부품
56 | 11.__.__.__.__.__.__ | 30139206 |  | TRIM TRIO CONNECTOR | UTP01412S/ | 1 | 내자 | 무검사 | 0 / 0 | 0 | 전자부품
57 | 12.__.__.__.__.__.__ | 30120533 |  | RECEPTACLE SLIP N | D3-326-101-200/ | 2 | 외자 | A | 0 / 0 | 0 | 전기부품
58 | 13.__.__.__.__.__.__ | 30120534 |  | 6MM CPU HEAD EMBELISHR | D3-376-001-049/ | 2 | 외자 | A | 0 / 0 | 0 | 전기부품
59 | 14.__.__.__.__.__.__ | 30120535 |  | EJECTOR SPRING STAINLESS | D4-EHF5-3-950-QA/ | 2 | 외자 | A | 0 / 0 | 0 | 전기부품
60 | 15.__.__.__.__.__.__ | 30120536 |  | 6MM RIVET PLATE RECEPT | D3-336-400-190/ | 2 | 외자 | A | 0 / 0 | 0 | 전기부품
61 | 16.__.__.__.__.__.__ | 30120824 |  | TAMPER-RESISTANT | D3-316-620-190/ | 2 | 외자 | A | 0 / 0 | 0 | 전기부품
62 | 17.__.__.__.__.__.__ | 30139317 | R1D000452(06) | NAME PLATE(PID1) | t=1.0/AL | 1 | 내자 | 무검사 | 0 / 0 | 0 | 명판
63 | 18.__.__.__.__.__.__ | 30139208 |  | FIXED WIRE | WIRE/ | 1 | 내자 | 무검사 | 0 / 0 | 0 | 모름
64 | 19.__.__.__.__.__.__ | 30139160 |  | TIE MOUNT | JOTM-2SS/ | 2 | 내자 | 무검사 | 0 / 0 | 0 | 시중품
65 | 20.__.__.__.__.__.__ | 30139163 |  | MESH COVER | / | 1 | 내자 | 무검사 | 0 / 0 | 0 | 모름
66 | 21.__.__.__.__.__.__ | 30139209 |  | BOLT&WASHER LIST | ASS'Y/ | 1 | 내자 | 무검사 | 0 / 0 | 0 | 모름
67 | 22.__.__.__.__.__.__ | 30139165 |  | CONNECTOR | BCP C7FA/ | 2 | 내자 | 무검사 | 0 / 0 | 0 | 전자부품
68 | 23.__.__.__.__.__.__ | 20064149 | R1D000442 | PID1 WIRING DIAGRAM | ASS'Y/ | 1 | 내작 | 무검사 | 0 / 0 | 0 | 하네스도
69 | __.01.__.__.__.__.__ | 30139212 |  | WIRE | 100G1121-0.75-0/9/ | 1 | 외자 | C | 0 / 0 | 0 | 전선
70 | __.02.__.__.__.__.__ | 30139213 |  | WIRE | 100G1121-0.75/ | 1 | 외자 | C | 0 / 0 | 0 | 전선
71 | __.03.__.__.__.__.__ | 30139214 |  | CONNECTOR | 5557-14R/ | 1 | 외자 | 무검사 | 0 / 0 | 0 | 전자부품
72 | __.04.__.__.__.__.__ | 30110820 |  | CONNECTOR HOUSING | 5557-08R/ | 1 | 외자 | 무검사 | 0 / 0 | 0 | 전자부품
73 | __.05.__.__.__.__.__ | 30139215 |  | CONNECTOR | 5557-04R/ | 1 | 내자 | 무검사 | 0 / 0 | 0 | 전자부품
74 | __.06.__.__.__.__.__ | 30139216 |  | CONNECTOR | 5557-06R/ | 1 | 내자 | 무검사 | 0 / 0 | 0 | 전자부품
75 | __.07.__.__.__.__.__ | 30081231 |  | TERMINAL | 5556, AWG18-24/ | 32 | 외자 | 무검사 | 0 / 0 | 0 | 전기부품

Sheet: pid2
 |  |  |  |  | B O M L I S T
BOM 번호: 10007313-01 [10007313][R1D1473-25852][] (PID2)LCD PASSENGER INFORMATION DISPLAY2
BOM 설명: 미국 DENVER PID2
No | LEVEL | 품목코드 | 도면번호 | 품 명 | 품 명 | 수량 SET수량 | 조달 형태 | 품질 등급 | 구매L/T 양산/개발 | 표준 공수 | 품목형태
1 | 01.__.__.__.__.__.__ | 30139133 | R1C000042 | BOX ASS'Y | ASS'Y/ | 1 | 외작 | C | 0 / 0 | 0 | 제관품
2 | __.01.__.__.__.__.__ | 30139136 | R1C000044 | FRAME | ASS'Y/ | 1 | 외작 | C | 0 / 0 | 0 | 제관품
3 | __.__.01.__.__.__.__ | 30139144 |  | FRAME | A366-91,t=3.0/ | 1 | 외작 | C | 0 / 0 | 0 | 제관품
4 | __.__.02.__.__.__.__ | 30139145 |  | PLATE | A591-CQ,t=1.2/ | 2 | 외작 | C | 0 / 0 | 0 | 제관품
5 | __.__.03.__.__.__.__ | 30140777 |  | PLATE | A591-CQ,t=1.2/ | 2 | 외작 | C | 0 / 0 | 0 | 제관품
6 | __.__.04.__.__.__.__ | 30138924 |  | HEXA HEAD STANDOFF | D5, M3, L6/ | 2 | 외작 | C | 0 / 0 | 0 | 제관품
7 | __.__.05.__.__.__.__ | 30139146 |  | PEM NUT | M4,D5,L5/ | 4 | 내자 | 무검사 | 0 / 0 | 0 | 소모품
8 | __.__.06.__.__.__.__ | 30140769 |  | CLINCHING NUT | M3/ | 1 | 내자 | 무검사 | 0 / 0 | 0 | 시중품
9 | __.02.__.__.__.__.__ | 30139137 | R1C000043 | COVER | ASS'Y/ | 8 | 외작 | C | 0 / 0 | 0 | 제관품
10 | __.__.01.__.__.__.__ | 30139141 |  | COVER | A366-91, t=1.2/ | 1 | 외작 | C | 0 / 0 | 0 | 제관품
11 | __.__.02.__.__.__.__ | 30139142 |  | EARTH PAD | 304SS,D6/#10-24 UNC TAP H8.8 | 1 | 외작 | C | 0 / 0 | 0 | 제관품
12 | __.__.03.__.__.__.__ | 30139440 |  | BLIND NUT | M3/ | 12 | 내자 | 무검사 | 0 / 0 | 0 | 가공품
13 | __.03.__.__.__.__.__ | 30139138 | R1D000344 | REAR COVER | ASS'Y/ | 1 | 외작 | C | 0 / 0 | 0 | 제관품
14 | __.__.01.__.__.__.__ | 30139148 |  | REAR COVER | A591-CQ, t=1.2/ | 1 | 외작 | C | 0 / 0 | 0 | 제관품
15 | __.04.__.__.__.__.__ | 30139139 | R1C000041 | LCD BRACKET | ASS'Y/ | 1 | 외작 | C | 0 / 0 | 0 | 제관품
16 | __.__.01.__.__.__.__ | 30139150 |  | BRACKET | A366-91, t=1.0/ | 1 | 외작 | C | 0 / 0 | 0 | 제관품
17 | __.__.02.__.__.__.__ | 30139151 |  | HEXA HEAD STANDOFF | D5,M3,L9/ | 4 | 외작 | C | 44 / 73 | 0 | 가공품
18 | __.__.03.__.__.__.__ | 30139152 |  | HEXA HEAD STANDOFF | D5,M3,L5/ | 10 | 외작 | C | 44 / 73 | 0 | 가공품
19 | __.__.04.__.__.__.__ | 30140769 |  | CLINCHING NUT | M3/ | 2 | 내자 | 무검사 | 0 / 0 | 0 | 시중품
20 | __.05.__.__.__.__.__ | 30139140 | R1D000342 | CONNECTOR BRACKET | ASS'Y/ | 1 | 외작 | C | 0 / 0 | 0 | 제관품
21 | __.__.01.__.__.__.__ | 30140778 |  | BRACKET | A366-91,t1.0/ | 1 | 외작 | C | 0 / 0 | 0 | 제관품
22 | __.__.02.__.__.__.__ | 30140779 |  | HEXA HEAD STANDOFF | M3/ | 1 | 내자 | 무검사 | 0 / 0 | 0 | 가공품
23 | 02.__.__.__.__.__.__ | 30139154 |  | PC COVER | t2/PC | 1 | 외작 | A | 0 / 0 | 0 | 가공품
24 | 03.__.__.__.__.__.__ | 30118138 |  | TFT-LCD | LTM190BT03/ | 1 | 내자 | 무검사 | 0 / 0 | 0 | 전기부품
25 | 04.__.__.__.__.__.__ | 30138695 |  | BRACKET | A366-91,t=1.0/ | 1 | 내자 | 무검사 | 0 / 0 | 0 | 제관품
26 | 05.__.__.__.__.__.__ | 30130800 |  | INVERTER BOARD | GH053A(19')/ | 1 | 내자 | 무검사 | 0 / 0 | 0 | 전자부품
27 | 06.__.__.__.__.__.__ | 30139155 | R1D000338 | VIDEO RX BOARD | PID-RXB/ | 1 | 내작 | 무검사 | 0 / 0 | 0 | PCB
28 | __.01.__.__.__.__.__ | 30139242 |  | VIDEO RX BOARD | RX BOARD ASS'Y/ | 1 | 내자 | 무검사 | 0 / 0 | 0 | PCB
29 | __.02.__.__.__.__.__ | 30138589 |  | BNC CONNECTOR | CTP-BR-4001-Z,75ohm/ | 2 | 내자 | 무검사 | 0 / 0 | 0 | 전기부품
30 | __.03.__.__.__.__.__ | 30130315 |  | CONNECTOR | 5566-14/ | 1 | 내자 | A | 0 / 0 | 0 | 전자부품
31 | __.04.__.__.__.__.__ | 30139243 |  | CONNECTOR | 5569-08A1/ | 1 | 외자 | 무검사 | 0 / 0 | 0 | 전기부품
32 | __.05.__.__.__.__.__ | 30139244 |  | CONNECTOR | F1-X30SSL-HF/ | 1 | 내자 | 무검사 | 0 / 0 | 0 | 전기부품
33 | __.06.__.__.__.__.__ | 70000402 |  | CONNECTOR | DF11-12DP-2DS/ | 1 | 내자 | 무검사 | 0 / 0 | 0 | 전자부품
34 | 07.__.__.__.__.__.__ | 30139156 | R1D000337 | POWER CONVERTER BOARD | PID-PCB/ | 1 | 내작 | 무검사 | 30 / 45 | 0 | PCB
35 | __.01.__.__.__.__.__ | 30139245 |  | POWER BOARD | POWER BOARD ASS'Y/ | 1 | 외작 | C | 0 / 0 | 0 | PCB
36 | __.02.__.__.__.__.__ | 30139246 |  | CONNECTOR | 5557-06/ | 1 | 내자 | 무검사 | 0 / 0 | 0 | 전자부품
37 | __.03.__.__.__.__.__ | 30138958 |  | CONNECTOR | 5557-04/ | 1 | 외자 | 무검사 | 0 / 0 | 0 | 전자부품
38 | __.04.__.__.__.__.__ | 30135054 |  | HEAT SINK | ASS'Y/ | 1 | 내자 | 무검사 | 0 / 0 | 0 | 전자부품
39 | 08.__.__.__.__.__.__ | 30139157 |  | CONNECTOR | FRITS4102R20-29PB1G1F6/ | 1 | 외자 | C | 0 / 0 | 0 | 전자부품
40 | 09.__.__.__.__.__.__ | 30139159 |  | CONNECTOR | FRITS4106F20-29SB1F6/ | 1 | 외자 | C | 0 / 0 | 0 | 전자부품
41 | 10.__.__.__.__.__.__ | 30139318 | R1D000452(07) | NAME PLATE(PID2) | t=1.0/AL | 1 | 내자 | 무검사 | 0 / 0 | 0 | 명판
42 | 11.__.__.__.__.__.__ | 30139160 |  | TIE MOUNT | JOTM-2SS/ | 4 | 내자 | 무검사 | 0 / 0 | 0 | 시중품
43 | 12.__.__.__.__.__.__ | 30138689 |  | WIRE MESH | DUST FILTER #25/ | 7 | 내자 | 무검사 | 0 / 0 | 0 | 모름
44 | 13.__.__.__.__.__.__ | 30139161 |  | WIRING HARNESS | PID2-WH/ | 1 | 내자 | 무검사 | 0 / 0 | 0 | 전선
45 | 14.__.__.__.__.__.__ | 30139162 |  | BNC CONNECTOR BRACKET | A366-91, t=1.0/ | 1 | 외작 | C | 0 / 0 | 0 | 제관품
46 | 15.__.__.__.__.__.__ | 30139163 |  | MESH COVER | / | 7 | 내자 | 무검사 | 0 / 0 | 0 | 모름
47 | 16.__.__.__.__.__.__ | 30138690 |  | EMC GASKET | SF050010R-C-NA-A/ | 8 | 내자 | 무검사 | 29 / 58 | 0 | 시중품
48 | 17.__.__.__.__.__.__ | 30139164 |  | BOLT&WASHER LIST | ASS'Y/ | 1 | 내자 | 무검사 | 0 / 0 | 0 | 모름
49 | 18.__.__.__.__.__.__ | 30139165 |  | CONNECTOR | BCP C7FA/ | 2 | 내자 | 무검사 | 0 / 0 | 0 | 전자부품
50 | 19.__.__.__.__.__.__ | 20064147 | R1D000441 | PID2 WIRING DIAGRAM | ASS'Y/ | 1 | 내작 | 무검사 | 0 / 0 | 0 | 하네스도
51 | __.01.__.__.__.__.__ | 30127617 |  | WIRE | 100G0111-0.75-0/ | 1 | 외자 | 무검사 | 0 / 0 | 0 | 전선
52 | __.02.__.__.__.__.__ | 30139213 |  | WIRE | 100G1121-0.75/ | 1 | 외자 | C | 0 / 0 | 0 | 전선
53 | __.03.__.__.__.__.__ | 30139214 |  | CONNECTOR | 5557-14R/ | 1 | 외자 | 무검사 | 0 / 0 | 0 | 전자부품
54 | __.04.__.__.__.__.__ | 30110820 |  | CONNECTOR HOUSING | 5557-08R/ | 1 | 외자 | 무검사 | 0 / 0 | 0 | 전자부품
55 | __.05.__.__.__.__.__ | 30139215 |  | CONNECTOR | 5557-04R/ | 1 | 내자 | 무검사 | 0 / 0 | 0 | 전자부품
56 | __.06.__.__.__.__.__ | 30139216 |  | CONNECTOR | 5557-06R/ | 1 | 내자 | 무검사 | 0 / 0 | 0 | 전자부품
57 | __.07.__.__.__.__.__ | 30081231 |  | TERMINAL | 5556, AWG18-24/ | 32 | 외자 | 무검사 | 0 / 0 | 0 | 전기부품

Sheet: dpo
 |  |  |  |  | B O M L I S T
BOM 번호: 10007315-01 [10007315][R1D1473-25854][] (DPO)DRIVER PA OPERATION BOX
BOM 설명: 미국 DENVER DRIVER PA OPERATION BOX
No | LEVEL | 품목코드 | 도면번호 | 품 명 | 품 명 | 수량 SET수량 | 조달 형태 | 품질 등급 | 구매L/T 양산/개발 | 표준 공수 | 품목형태
1 | 01.__.__.__.__.__.__ | 30138819 | R1C000049 | DPO BOX ASS'Y | ASS'Y/ | 1 | 외작 | C | 0 / 0 | 0 | 제관품
2 | __.01.__.__.__.__.__ | 30138822 | R1D000373 | FRONT PANEL | ASS'Y/ | 4 | 외작 | C | 54 / 83 | 0 | 제관품
3 | __.__.01.__.__.__.__ | 30138697 |  | STUD BOLT | M4,L8/ | 4 | 외작 | 무검사 | 0 / 0 | 0 | 가공품
4 | __.__.02.__.__.__.__ | 30140828 |  | FRONT PANEL | STS304, t=4/ | 1 | 외작 | C | 0 / 0 | 0 | 제관품
5 | __.02.__.__.__.__.__ | 30138827 | R1C000050 | FRAME | ASS'Y/ | 1 | 외작 | C | 0 / 0 | 0 | 제관품
6 | __.__.01.__.__.__.__ | 30140829 |  | FRAME | A366-91,t1/ | 1 | 외작 | C | 0 / 0 | 0 | 제관품
7 | __.__.02.__.__.__.__ | 30139439 |  | HEXA HEAD STANDOF | D5,M3,L6/ | 13 | 내자 | 무검사 | 0 / 0 | 0 | 가공품
8 | __.__.03.__.__.__.__ | 30139440 |  | BLIND NUT | M3/ | 10 | 내자 | 무검사 | 0 / 0 | 0 | 가공품
9 | __.03.__.__.__.__.__ | 30138828 | R1D000376 | REAR PANEL | ASS'Y/ | 1 | 외작 | C | 54 / 83 | 0 | 제관품
10 | __.__.01.__.__.__.__ | 30140831 |  | REAR PANEL | A591-CQ,t1.2/ | 1 | 외작 | C | 0 / 0 | 0 | 제관품
11 | __.__.02.__.__.__.__ | 30138837 |  | EARTH PAD | #10-24 UNC TAP ,D8,L9/ | 1 | 내자 | 무검사 | 0 / 0 | 0 | 제관품
12 | __.__.03.__.__.__.__ | 30140832 |  | WIRE SUPPORT | Ø4,L=138/SS400 | 1 | 외작 | C | 0 / 0 | 0 | 제관품
13 | __.__.04.__.__.__.__ | 30140833 |  | WIRE SUPPORT | Ø4,L=40/SS400 | 1 | 외작 | C | 0 / 0 | 0 | 제관품
14 | __.04.__.__.__.__.__ | 30138840 | R1D000379 | UPPER COVER | ASS'Y/ | 1 | 외작 | C | 0 / 0 | 0 | 제관품
15 | __.__.01.__.__.__.__ | 30140834 |  | UPPER COVER | A591-CQ,t1.2/ | 1 | 외작 | C | 0 / 0 | 0 | 제관품
16 | __.05.__.__.__.__.__ | 30138844 | R1C000050 | BRACKET | ASS'Y/ | 1 | 외작 | C | 0 / 0 | 0 | 제관품
17 | __.__.01.__.__.__.__ | 30140835 |  | BRACKET | A366-91,t1.0/ | 1 | 외작 | C | 0 / 0 | 0 | 제관품
18 | __.__.02.__.__.__.__ | 30139440 |  | BLIND NUT | M3/ | 3 | 내자 | 무검사 | 0 / 0 | 0 | 가공품
19 | 02.__.__.__.__.__.__ | 30138999 | R1D000374 | SPEAKER | 4070N01-8C240-5H15+8OHM,3W/ | 1 | 내자 | 무검사 | 0 / 0 | 0 | 전기부품
20 | __.01.__.__.__.__.__ | 30138909 |  | SPEAKER | 3W / 8Ω/ | 1 | 내자 | C | 0 / 0 | 0 | 조립품
21 | 03.__.__.__.__.__.__ | 30138823 | R1D000382 | ILLUMINATED SWITCHES | A1PCA1Y120K303/ | 7 | 외자 | C | 0 / 0 | 0 | 전기부품
22 | 04.__.__.__.__.__.__ | 30138866 | R1D000372 | DPO CONTROL BOARD | ASS'Y/ | 1 | 내작 | C | 0 / 0 | 0 | PCB
23 | __.01.__.__.__.__.__ | 30139441 |  | CONNECTOR | 87427-0843/ | 1 | 내자 | 무검사 | 0 / 0 | 0 | 전자부품
24 | __.02.__.__.__.__.__ | 30140836 |  | CONNECTOR | 35312-1060/ | 1 | 내자 | 무검사 | 0 / 0 | 0 | 전자부품
25 | __.03.__.__.__.__.__ | 30140837 |  | CONNECTOR | 35312-1560/ | 1 | 내자 | 무검사 | 0 / 0 | 0 | 전자부품
26 | __.04.__.__.__.__.__ | 30140838 |  | CONNECTOR(J15) | 35312-1060/ | 1 | 내자 | 무검사 | 0 / 0 | 0 | 전자부품
27 | __.05.__.__.__.__.__ | 30140839 |  | CONNECTOR | 35312-1260/ | 1 | 내자 | 무검사 | 0 / 0 | 0 | 전자부품
28 | __.06.__.__.__.__.__ | 30139478 |  | CONNECTOR | 35312-0560/ | 1 | 내자 | 무검사 | 0 / 0 | 0 | 전자부품
29 | __.07.__.__.__.__.__ | 30120273 |  | CONNECTOR | 35312-0460/ | 1 | 내자 | 무검사 | 0 / 0 | 0 | 전자부품
30 | 05.__.__.__.__.__.__ | 30138868 | R1D000375 | DPO POWER SUPPLY | ASS'Y/ | 1 | 외자 | C | 0 / 0 | 0 | 전기부품
31 | __.01.__.__.__.__.__ | 30140840 |  | CONNECTOR | 5569-06/ | 1 | 외자 | 무검사 | 0 / 0 | 0 | 전기부품
32 | __.02.__.__.__.__.__ | 30137956 |  | CONNECTOR | SMW250-08/ | 1 | 내자 | 무검사 | 0 / 0 | 0 | 전기부품
33 | 06.__.__.__.__.__.__ | 30138864 |  | VOLUME CONTROL | RV15YN-2K/ | 1 | 내자 | 무검사 | 0 / 0 | 0 | 전기부품
34 | 07.__.__.__.__.__.__ | 30138870 |  | CONNECTOR | ITH03FPA28-21PB0G1F6/ | 1 | 외자 | C | 0 / 0 | 0 | 전자부품
35 | 08.__.__.__.__.__.__ | 30138871 |  | CONNECTOR | ITH08F28-21PBG0F6/ | 1 | 외자 | C | 39 / 58 | 0 | 전자부품
36 | 09.__.__.__.__.__.__ | 30138873 |  | CONNECTOR | ITH03FPA18-19PB0G1F6/ | 1 | 외자 | C | 0 / 0 | 0 | 전자부품
37 | 10.__.__.__.__.__.__ | 30139221 |  | CONNECTOR | ITH08F18-19SB0F6/ | 1 | 외자 | C | 0 / 0 | 0 | 전자부품
38 | 11.__.__.__.__.__.__ | 30139307 | R1D000450 | MESH(DPO,PEI1,PEI2) | ASS'Y/ | 1 | 내자 | 무검사 | 0 / 0 | 0 | 모름
39 | __.01.__.__.__.__.__ | 30139308 |  | MESH | SCREEN#24,φ0.3,OPEN 50%/304SS | 1 | 내자 | 무검사 | 0 / 0 | 0 | 시중품
40 | __.02.__.__.__.__.__ | 30139309 |  | MESH | SCREEN#24,φ0.3,OPEN 50%/304SS | 1 | 내자 | 무검사 | 0 / 0 | 0 | 시중품
41 | __.03.__.__.__.__.__ | 30139310 | R1D000450(03) | SHEET | 304SS,t=0.7/ | 1 | 내자 | 무검사 | 0 / 0 | 0 | 가공품
42 | 12.__.__.__.__.__.__ | 30139319 | R1D000452(08) | NAME PLATE(DPO) | t=1.0/AL | 1 | 내자 | 무검사 | 0 / 0 | 0 | 명판
43 | 13.__.__.__.__.__.__ | 30138833 | R1D000381 | DPO DPH HAND MIC | ASS'Y/ | 1 | 내작 | C | 0 / 0 | 0 | 전기부품
44 | __.01.__.__.__.__.__ | 30138836 |  | HAND MIC | KMC-30/ | 1 | 내자 | 무검사 | 0 / 0 | 0 | 전기부품
45 | __.02.__.__.__.__.__ | 30139453 |  | BRACKET | ASS'Y/ | 1 | 내자 | 무검사 | 0 / 0 | 0 | 가공품
46 | __.03.__.__.__.__.__ | 30139454 |  | CONNECTOR | R03-R5F/ | 1 | 내자 | 무검사 | 0 / 0 | 0 | 전자부품
47 | __.04.__.__.__.__.__ | 30139455 |  | CONNECTOR | R03-PB5M/ | 1 | 내자 | 무검사 | 0 / 0 | 0 | 전자부품
48 | 14.__.__.__.__.__.__ | 30138688 |  | BOLT&NUT LIST | ASS'Y/ | 1 | 내자 | 무검사 | 0 / 0 | 0 | 모름
49 | 15.__.__.__.__.__.__ | 30138690 |  | EMC GASKET | SF050010R-C-NA-A/ | 1 | 내자 | 무검사 | 29 / 58 | 0 | 시중품
50 | 16.__.__.__.__.__.__ | 30139222 |  | RUBBER GROMMET | EPDM,φ19mm(0.75inch)/ | 2 | 외작 | 무검사 | 0 / 0 | 0 | 모름
51 | 17.__.__.__.__.__.__ | 30139311 | R1D000451 | GROMMET(FDI,SDI,PII,DPO) | RUBBER/ | 1 | 외작 | 무검사 | 0 / 0 | 0 | 모름
52 | 18.__.__.__.__.__.__ | 30139456 | R1D000377 | SPEAKER RUBBER SHEET | t=6/RUBBER | 1 | 내자 | 무검사 | 0 / 0 | 0 | 가공품
53 | 19.__.__.__.__.__.__ | 20064164 | R1D000463 | DPO WIRING DIAGRAM | ASS'Y/ | 1 | 내작 | 무검사 | 0 / 0 | 0 | 하네스도
54 | __.01.__.__.__.__.__ | 30139212 |  | WIRE | 100G1121-0.75-0/9/ | 1 | 외자 | C | 0 / 0 | 0 | 전선
55 | __.02.__.__.__.__.__ | 30128047 |  | WIRE | 100G1121-0.5-0/9/ | 1 | 외자 | 무검사 | 0 / 0 | 0 | 전선
56 | __.03.__.__.__.__.__ | 30089538 |  | SHIELD WIRE | 100G1141-0.5-0/2/6/9/ | 1 | 내자 | 무검사 | 0 / 0 | 0 | 전선
57 | __.04.__.__.__.__.__ | 30124460 |  | CONNECTOR | SMH250-08/ | 1 | 내자 | A | 0 / 0 | 0 | 시중품
58 | __.05.__.__.__.__.__ | 30139216 |  | CONNECTOR | 5557-06R/ | 1 | 내자 | 무검사 | 0 / 0 | 0 | 전자부품
59 | __.06.__.__.__.__.__ | 30140841 |  | CONNECTOR | 35572-1500/ | 1 | 내자 | 무검사 | 0 / 0 | 0 | 전자부품
60 | __.07.__.__.__.__.__ | 30139544 |  | CONNECTOR | 35572-1000/ | 2 | 내자 | 무검사 | 0 / 0 | 0 | 전자부품
61 | __.08.__.__.__.__.__ | 30139545 |  | CONNECTOR | 35572-1200/ | 1 | 내자 | 무검사 | 0 / 0 | 0 | 전자부품
62 | __.09.__.__.__.__.__ | 30139258 |  | CONNECTOR | 35572-0400/ | 1 | 내자 | 무검사 | 0 / 0 | 0 | 전자부품
63 | __.10.__.__.__.__.__ | 30139543 |  | CONNECTOR | 35572-0500/ | 1 | 내자 | 무검사 | 0 / 0 | 0 | 전자부품
64 | __.11.__.__.__.__.__ | 30139346 |  | CONNECTOR | 5557-08R/ | 1 | 외자 | 무검사 | 0 / 0 | 0 | 전자부품
65 | __.12.__.__.__.__.__ | 30140842 |  | CONNECTOR(J13) | 35572-0500/ | 1 | 내자 | 무검사 | 0 / 0 | 0 | 전자부품
66 | __.13.__.__.__.__.__ | 30139542 |  | CONNECTOR | 5557-24R/ | 1 | 내자 | 무검사 | 0 / 0 | 0 | 전자부품
67 | __.14.__.__.__.__.__ | 30140843 |  | CONNECTOR | 5557-22R/ | 1 | 내자 | 무검사 | 0 / 0 | 0 | 전자부품
68 | __.15.__.__.__.__.__ | 30081231 |  | TERMINAL | 5556, AWG18-24/ | 135 | 외자 | 무검사 | 0 / 0 | 0 | 전기부품
69 | __.16.__.__.__.__.__ | 30140844 |  | WIRE | 100G0121-0.5-0/ | 1 | 외자 | 무검사 | 0 / 0 | 0 | 전기부품

Sheet: dph
 |  |  |  |  | B O M L I S T
BOM 번호: 10007316-01 [10007316][R1D1473-26838][] (DPH)DRIVER PA HANDSET
BOM 설명: 미국 DENVER DPH
No | LEVEL | 품목코드 | 도면번호 | 품 명 | 품 명 | 수량 SET수량 | 조달 형태 | 품질 등급 | 구매L/T 양산/개발 | 표준 공수 | 품목형태
1 | 01.__.__.__.__.__.__ | 30138787 | R1C000051 | DPH BOX ASSY | ASS'Y/ | 1 | 내작 | C | 0 / 0 | 0 | 제관품
2 | __.01.__.__.__.__.__ | 30138779 | R1C000053 | FRONT PANEL | ASS'Y/ | 1 | 외작 | C | 0 / 0 | 0 | 제관품
3 | __.__.01.__.__.__.__ | 30139466 |  | FRONT PANEL | AL(6061)/ | 1 | 외작 | C | 0 / 0 | 0 | 제관품
4 | __.02.__.__.__.__.__ | 30138789 | R1C000052 | FRAME | A366-91, t=1.2/ | 1 | 외작 | C | 0 / 0 | 0 | 제관품 / N6.7
5 | __.__.01.__.__.__.__ | 30138792 |  | FRAME | A366-91, t=1.2/ | 1 | 외작 | C | 0 / 0 | 0 | 제관품
6 | __.__.02.__.__.__.__ | 30139467 |  | BLIND NUT | M3/ | 10 | 외작 | C | 0 / 0 | 0 | 제관품
7 | __.__.03.__.__.__.__ | 30139352 |  | EARTH PAD | #10-24 UNC 12I STAND-OFF/ | 1 | 외작 | C | 0 / 0 | 0 | 제관품
8 | __.03.__.__.__.__.__ | 30138790 | R1D000380 | COVER | A591-CQ, t=1.2/ | 1 | 외작 | C | 0 / 0 | 0 | 제관품
9 | __.04.__.__.__.__.__ | 30139462 | R1C000065 | SWITCH PANEL | ASS'Y/ | 1 | 외작 | C | 0 / 0 | 0 | 제관품
10 | __.__.01.__.__.__.__ | 30139463 |  | PANEL | AL(6061),t5.0/ | 1 | 외작 | C | 0 / 0 | 0 | 제관품
11 | __.__.02.__.__.__.__ | 30139465 |  | SUPPORT | M3/ | 4 | 내자 | 무검사 | 0 / 0 | 0 | 시중품
12 | 02.__.__.__.__.__.__ | 30138685 |  | CONNECTOR | ITH03FPA22-14PB0G1F6/ | 1 | 내자 | 무검사 | 0 / 0 | 0 | 전자부품
13 | 03.__.__.__.__.__.__ | 30138820 |  | CONNECTOR | ITH08F22-14SB0F6/ | 1 | 외자 | C | 0 / 0 | 0 | 전자부품
14 | 04.__.__.__.__.__.__ | 30138823 | R1D000382 | ILLUMINATED SWITCHES | A1PCA1Y120K303/ | 1 | 외자 | C | 0 / 0 | 0 | 전기부품
15 | 05.__.__.__.__.__.__ | 30135657 |  | CONNECTOR | R03-R0F, R03-PBOM/ | 1 | 내자 | 무검사 | 0 / 0 | 0 | 전자부품
16 | 06.__.__.__.__.__.__ | 30138833 | R1D000381 | DPO DPH HAND MIC | ASS'Y/ | 1 | 내작 | C | 0 / 0 | 0 | 전기부품
17 | __.01.__.__.__.__.__ | 30138836 |  | HAND MIC | KMC-30/ | 1 | 내자 | 무검사 | 0 / 0 | 0 | 전기부품
18 | __.02.__.__.__.__.__ | 30138839 |  | BRACKET | ASS'Y/ | 1 | 외작 | 무검사 | 0 / 0 | 0 | 제관품
19 | __.03.__.__.__.__.__ | 30133119 |  | RECEPTACLE | R03-R5F/ | 1 | 내자 | 무검사 | 0 / 0 | 0 | 전기부품
20 | __.04.__.__.__.__.__ | 30133120 |  | PLUG | R03-PB5M/ | 1 | 내자 | 무검사 | 0 / 0 | 0 | 전기부품
21 | 07.__.__.__.__.__.__ | 30138846 |  | BOLT&NUT LIST | ASS'Y/ | 1 | 내자 | 무검사 | 0 / 0 | 0 | 모름
22 | 08.__.__.__.__.__.__ | 30138690 |  | EMC GASKET | SF050010R-C-NA-A/ | 1 | 내자 | 무검사 | 29 / 58 | 0 | 시중품
23 | 09.__.__.__.__.__.__ | 30140850 | R1D000708 | CONTROL BOARD | ASS'Y/ | 1 | 내자 | 무검사 | 0 / 0 | 0 | PCB
24 | __.01.__.__.__.__.__ | 30139476 |  | CONNECTOR | 87427-2043/ | 1 | 외자 | 무검사 | 0 / 0 | 0 | 전자부품
25 | __.02.__.__.__.__.__ | 30120273 |  | CONNECTOR | 35312-0460/ | 1 | 내자 | 무검사 | 0 / 0 | 0 | 전자부품
26 | __.03.__.__.__.__.__ | 30139478 |  | CONNECTOR | 35312-0560/ | 1 | 내자 | 무검사 | 0 / 0 | 0 | 전자부품
27 | __.04.__.__.__.__.__ | 30140851 |  | CONNECTOR | 35312-0660/ | 1 | 내자 | 무검사 | 0 / 0 | 0 | 전자부품
28 | 10.__.__.__.__.__.__ | 30139320 | R1D000452(09) | NAME PLATE(DPH) | t=1.0/AL | 1 | 내자 | 무검사 | 0 / 0 | 0 | 명판
29 | 11.__.__.__.__.__.__ | 20064166 | R1D000464 | DPH WIRING DIAGRAM | ASS'Y/ | 1 | 내작 | 무검사 | 0 / 0 | 0 | 하네스도
30 | __.01.__.__.__.__.__ | 30139212 |  | WIRE | 100G1121-0.75-0/9/ | 1 | 외자 | C | 0 / 0 | 0 | 전선
31 | __.02.__.__.__.__.__ | 30128047 |  | WIRE | 100G1121-0.5-0/9/ | 1 | 외자 | 무검사 | 0 / 0 | 0 | 전선
32 | __.03.__.__.__.__.__ | 30139560 |  | CONNECTOR | 5557-20R/ | 1 | 내자 | 무검사 | 0 / 0 | 0 | 전자부품
33 | __.04.__.__.__.__.__ | 30139258 |  | CONNECTOR | 35572-0400/ | 1 | 내자 | 무검사 | 0 / 0 | 0 | 전자부품
34 | __.05.__.__.__.__.__ | 30139543 |  | CONNECTOR | 35572-0500/ | 1 | 내자 | 무검사 | 0 / 0 | 0 | 전자부품
35 | __.06.__.__.__.__.__ | 30139561 |  | CONNECTOR | 35572-0600/ | 1 | 내자 | 무검사 | 0 / 0 | 0 | 전자부품
36 | __.07.__.__.__.__.__ | 30081231 |  | TERMINAL | 5556, AWG18-24/ | 35 | 외자 | 무검사 | 0 / 0 | 0 | 전기부품
37 | __.08.__.__.__.__.__ | 30067016 |  | WIRE | 100G0111-0.5-0/ | 1 | 내자 | C | 39 / 58 | 0 | 전선

Sheet: pei1
 |  |  |  |  | B O M L I S T
BOM 번호: 10007318-01 [10007318][R1D1473-25856][] (PEI)PASSENGER EMERGENCY INTERCOM
BOM 설명: 미국 DENVER PEI1
No | LEVEL | 품목코드 | 도면번호 | 품 명 | 품 명 | 수량 SET수량 | 조달 형태 | 품질 등급 | 구매L/T 양산/개발 | 표준 공수 | 품목형태
1 | 01.__.__.__.__.__.__ | 30139470 | R1D000468 | PEI1 BOX ASS'Y | ASS'Y/ | 1 | 외작 | C | 0 / 0 | 0 | 제관품
2 | __.01.__.__.__.__.__ | 20064112 | R1D000393 | FRONT PANEL | ASS'Y/ | 1 | 외작 | 무검사 | 0 / 0 | 0 | 조작기류
3 | __.__.01.__.__.__.__ | 30139473 |  | PANEL | 304SS,t3/ | 1 | 외작 | C | 0 / 0 | 0 | 제관품
4 | __.__.02.__.__.__.__ | 30138877 |  | STUD BOLT | M4, L10/ | 4 | 내자 | C | 0 / 0 | 0 | 가공품
5 | __.02.__.__.__.__.__ | 30138895 | R1C000056 | PEI1 FRAME | ASS'Y/ | 1 | 외작 | C | 0 / 0 | 0 | 제관품 / 외부색 도장
6 | __.__.01.__.__.__.__ | 30138896 |  | FRAME | A366-91, t1.2/ | 1 | 외작 | C | 0 / 0 | 0 | 제관품 / 외부색 도장
7 | __.__.02.__.__.__.__ | 30139439 |  | HEXA HEAD STANDOF | D5,M3,L6/ | 12 | 내자 | 무검사 | 0 / 0 | 0 | 가공품
8 | __.__.03.__.__.__.__ | 30139440 |  | BLIND NUT | M3/ | 8 | 내자 | 무검사 | 0 / 0 | 0 | 가공품
9 | __.__.04.__.__.__.__ | 30139352 |  | EARTH PAD | #10-24 UNC 12I STAND-OFF/ | 1 | 외작 | C | 0 / 0 | 0 | 제관품
10 | __.03.__.__.__.__.__ | 30138887 | R1D000392 | PEI1 COVER | ASS'Y/ | 1 | 외작 | C | 0 / 0 | 0 | 제관품 / 외부색 도장
11 | __.__.01.__.__.__.__ | 30140846 |  | PEI1 COVER | A591-CQ,t1.2/ | 1 | 외작 | C | 0 / 0 | 0 | 제관품
12 | 02.__.__.__.__.__.__ | 20064114 | R1D000389 | PEI1 PEI2 POWER SUPPLY | ASS'Y/ | 1 | 외자 | C | 0 / 0 | 0 | 보조전원장치
13 | __.01.__.__.__.__.__ | 30138906 |  | POWER SUPPLY | / | 1 | 외작 | C | 0 / 0 | 0 | 전자부품
14 | __.02.__.__.__.__.__ | 30138907 |  | HEATSINK | ASS'Y, AL/ | 1 | 외작 | C | 0 / 0 | 0 | 전기부품
15 | __.03.__.__.__.__.__ | 30140840 |  | CONNECTOR | 5569-06/ | 1 | 외자 | 무검사 | 0 / 0 | 0 | 전기부품
16 | __.04.__.__.__.__.__ | 30140847 |  | CONNECTOR | SMW250-8P/ | 1 | 내자 | A | 0 / 0 | 0 | 시중품
17 | 03.__.__.__.__.__.__ | 20064115 | R1D000386 | PEI1 PEI2 CONTROL BOARD ASS'Y | ASS'Y/ | 1 | 외작 | C | 0 / 0 | 0 | P.C.B BOARD
18 | __.01.__.__.__.__.__ | 30139441 |  | CONNECTOR | 87427-0843/ | 1 | 내자 | 무검사 | 0 / 0 | 0 | 전자부품
19 | __.02.__.__.__.__.__ | 30139476 |  | CONNECTOR | 87427-2043/ | 1 | 외자 | 무검사 | 0 / 0 | 0 | 전자부품
20 | __.03.__.__.__.__.__ | 30139477 |  | CONNETOR | 35312-0860/ | 1 | 외자 | 무검사 | 0 / 0 | 0 | 전기부품
21 | __.04.__.__.__.__.__ | 30120273 |  | CONNECTOR | 35312-0460/ | 1 | 내자 | 무검사 | 0 / 0 | 0 | 전자부품
22 | __.05.__.__.__.__.__ | 30139478 |  | CONNECTOR | 35312-0560/ | 1 | 내자 | 무검사 | 0 / 0 | 0 | 전자부품
23 | 04.__.__.__.__.__.__ | 30138999 | R1D000374 | SPEAKER | 4070N01-8C240-5H15+8OHM,3W/ | 1 | 내자 | 무검사 | 0 / 0 | 0 | 전기부품
24 | __.01.__.__.__.__.__ | 30138909 |  | SPEAKER | 3W / 8Ω/ | 1 | 내자 | C | 0 / 0 | 0 | 조립품
25 | 05.__.__.__.__.__.__ | 20064116 | R1D000387 | PEI1 PEI2 MIC N BOARD ASS'Y | ASS'Y/ | 1 | 외작 | C | 0 / 0 | 0 | P.C.B BOARD
26 | __.01.__.__.__.__.__ | 30138908 |  | MIC | AOM-4544P/ | 1 | 내자 | 무검사 | 0 / 0 | 0 | 전기부품
27 | __.02.__.__.__.__.__ | 10007636 |  | BOARD | ASSY/ | 1 | 외작 | C | 0 / 0 | 0 | P.C.B BOARD
28 | 06.__.__.__.__.__.__ | 20064117 | R1D000383 | PEI1 PEI2 LED BOARD ASSY | ASS'Y/ | 1 | 외작 | C | 0 / 0 | 0 | P.C.B BOARD
29 | __.01.__.__.__.__.__ | 20064125 |  | PCB BOARD | ASS'Y/ | 1 | 외작 | C | 0 / 0 | 0 | P.C.B BOARD
30 | __.02.__.__.__.__.__ | 30138914 | R1D000383(02) | LED INDICATOR (YELLOW) | VL1000P500/ | 1 | 외자 | C | 0 / 0 | 0 | 전기부품
31 | __.03.__.__.__.__.__ | 30138916 | R1D000383(03) | LED INDICATOR (RED) | VL1000P600/ | 1 | 외자 | C | 0 / 0 | 0 | 전기부품
32 | __.04.__.__.__.__.__ | 30138915 | R1D000383(04) | LED INDICATOR (GREEN) | VL1000P300/ | 1 | 외자 | C | 0 / 0 | 0 | 전기부품
33 | 07.__.__.__.__.__.__ | 20064118 | R1D000390 | PEI1 PEI2 SWITCH ASS'Y | ASS'Y/ | 1 | 외작 | C | 0 / 0 | 0 | SWITCH류
34 | __.01.__.__.__.__.__ | 30140848 |  | SWITCH BLOCK | LPI5412B/ | 1 | 내자 | 무검사 | 0 / 0 | 0 | 전기부품
35 | __.02.__.__.__.__.__ | 30140849 |  | OPERATOR | 2KN1723/ | 1 | 내자 | 무검사 | 0 / 0 | 0 | 전기부품
36 | 08.__.__.__.__.__.__ | 30138690 |  | EMC GASKET | SF050010R-C-NA-A/ | 7 | 내자 | 무검사 | 29 / 58 | 0 | 시중품
37 | 09.__.__.__.__.__.__ | 20064119 | R1D000391 | PEI1 PEI2 SWITCH HOLDER | ASS'Y/ | 1 | 외작 | C | 0 / 0 | 0 | SWITCH류
38 | __.01.__.__.__.__.__ | 20064121 |  | SWITCH GUARD | 304SS/ | 1 | 외작 | C | 0 / 0 | 0 | SWITCH류
39 | __.02.__.__.__.__.__ | 20064122 |  | FIXTURE | 304SS, M40, PITCH 1.0/ | 1 | 외작 | C | 0 / 0 | 0 | SWITCH류
40 | 10.__.__.__.__.__.__ | 30139321 | R1D000452(10) | NAME PLATE(PEI1) | t=1.0/AL | 1 | 내자 | 무검사 | 0 / 0 | 0 | 명판
41 | 11.__.__.__.__.__.__ | 30138918 |  | BOLT&WASHER LIST | ASS'Y/ | 1 | 내자 | 무검사 | 0 / 0 | 0 | 모름
42 | 12.__.__.__.__.__.__ | 30138685 |  | CONNECTOR | ITH03FPA22-14PB0G1F6/ | 1 | 내자 | 무검사 | 0 / 0 | 0 | 전자부품
43 | 13.__.__.__.__.__.__ | 30138820 |  | CONNECTOR | ITH08F22-14SB0F6/ | 1 | 외자 | C | 0 / 0 | 0 | 전자부품
44 | 14.__.__.__.__.__.__ | 30139307 | R1D000450 | MESH(DPO,PEI1,PEI2) | ASS'Y/ | 1 | 내자 | 무검사 | 0 / 0 | 0 | 모름
45 | __.01.__.__.__.__.__ | 30139308 |  | MESH | SCREEN#24,φ0.3,OPEN 50%/304SS | 1 | 내자 | 무검사 | 0 / 0 | 0 | 시중품
46 | __.02.__.__.__.__.__ | 30139309 |  | MESH | SCREEN#24,φ0.3,OPEN 50%/304SS | 1 | 내자 | 무검사 | 0 / 0 | 0 | 시중품
47 | __.03.__.__.__.__.__ | 30139310 | R1D000450(03) | SHEET | 304SS,t=0.7/ | 1 | 내자 | 무검사 | 0 / 0 | 0 | 가공품
48 | 15.__.__.__.__.__.__ | 30139456 | R1D000377 | SPEAKER RUBBER SHEET | t=6/RUBBER | 1 | 내자 | 무검사 | 0 / 0 | 0 | 가공품
49 | 16.__.__.__.__.__.__ | 30139479 | R1D000388 | PEI1,PEI2 MIC RUBBER SHEET | t=6.0/RUBBER | 1 | 내자 | 무검사 | 0 / 0 | 0 | 가공품
50 | 17.__.__.__.__.__.__ | 20064155 | R1D000448 | PEI1 WIRING DIAGRAM | ASS'Y/ | 1 | 내작 | 무검사 | 0 / 0 | 0 | 하네스도
51 | __.01.__.__.__.__.__ | 30139212 |  | WIRE | 100G1121-0.75-0/9/ | 1 | 외자 | C | 0 / 0 | 0 | 전선
52 | __.02.__.__.__.__.__ | 30140547 |  | WIRE | 100G1121-0.5-0/9/ | 1 | 외자 | C | 0 / 0 | 0 | 전선
53 | __.03.__.__.__.__.__ | 30140854 |  | WIRE | 100G1141-0.5-0/9/ | 1 | 외자 | C | 0 / 0 | 0 | 전선
54 | __.04.__.__.__.__.__ | 30124460 |  | CONNECTOR | SMH250-08/ | 1 | 내자 | A | 0 / 0 | 0 | 시중품
55 | __.05.__.__.__.__.__ | 30139216 |  | CONNECTOR | 5557-06R/ | 1 | 내자 | 무검사 | 0 / 0 | 0 | 전자부품
56 | __.06.__.__.__.__.__ | 30139258 |  | CONNECTOR | 35572-0400/ | 1 | 내자 | 무검사 | 0 / 0 | 0 | 전자부품
57 | __.07.__.__.__.__.__ | 30139259 |  | TERMINAL | 5557-08R/ | 1 | 내자 | 무검사 | 0 / 0 | 0 | 전자부품
58 | __.08.__.__.__.__.__ | 30139260 |  | TERMINAL | 35572-0500/ | 1 | 내자 | 무검사 | 0 / 0 | 0 | 전자부품
59 | __.09.__.__.__.__.__ | 30140843 |  | CONNECTOR | 5557-22R/ | 1 | 내자 | 무검사 | 0 / 0 | 0 | 전자부품
60 | __.10.__.__.__.__.__ | 30081231 |  | TERMINAL | 5556, AWG18-24/ | 69 | 외자 | 무검사 | 0 / 0 | 0 | 전기부품
61 | __.11.__.__.__.__.__ | 30067016 |  | WIRE | 100G0111-0.5-0/ | 1 | 내자 | C | 39 / 58 | 0 | 전선

Sheet: pei2
 |  |  |  |  | B O M L I S T
BOM 번호: 10007637-01 [10007637][R1D1473-26839][] (PEI2)PASSENGER EMERGENCY INTERCOM2
BOM 설명: 미국 DENVER PEI2
No | LEVEL | 품목코드 | 도면번호 | 품 명 | 품 명 | 수량 SET수량 | 조달 형태 | 품질 등급 | 구매L/T 양산/개발 | 표준 공수 | 품목형태
1 | 01.__.__.__.__.__.__ | 30138919 | R1C000054 | PEI2 BOX ASSY | ASS'Y/ | 1 | 내작 | C | 0 / 0 | 0 | 제관품
2 | __.01.__.__.__.__.__ | 20064124 | R1D000384 | PEI2 FRONT PANEL | ASS'Y/ | 1 | 외작 | C | 0 / 0 | 0 | 제어PANEL류
3 | __.__.01.__.__.__.__ | 30138920 |  | PANEL | 304SS, t=3.0/ | 1 | 외작 | C | 0 / 0 | 0 | 제관품
4 | __.__.02.__.__.__.__ | 30138921 |  | STUD BOLT | D4, M3, L10/ | 4 | 외작 | C | 0 / 0 | 0 | 제관품
5 | __.02.__.__.__.__.__ | 30138922 | R1C000055 | FRAME | ASS'Y/ | 1 | 외작 | C | 0 / 0 | 0 | 제관품 / 외부색 도장
6 | __.__.01.__.__.__.__ | 30138923 |  | FRAME | A366-91, t1.2/ | 1 | 외작 | C | 0 / 0 | 0 | 제관품 / 외부색 도장
7 | __.__.02.__.__.__.__ | 30139439 |  | HEXA HEAD STANDOF | D5,M3,L6/ | 1 | 내자 | 무검사 | 0 / 0 | 0 | 가공품
8 | __.__.03.__.__.__.__ | 30139440 |  | BLIND NUT | M3/ | 4 | 내자 | 무검사 | 0 / 0 | 0 | 가공품
9 | __.__.04.__.__.__.__ | 30140852 |  | EARTH PAD | #10-24 UNC TAPS STAND-OFF/ | 1 | 외작 | C | 0 / 0 | 0 | 제관품
10 | __.03.__.__.__.__.__ | 30138925 | R1D000385 | COVER | ASS'Y/ | 12 | 외작 | C | 0 / 0 | 0 | 제관품 / 외부색 도장
11 | __.__.01.__.__.__.__ | 30140853 |  | COVER | A591-CQ,t1.2/ | 1 | 외작 | C | 0 / 0 | 0 | 제관품
12 | 02.__.__.__.__.__.__ | 30138999 | R1D000374 | SPEAKER | 4070N01-8C240-5H15+8OHM,3W/ | 1 | 내자 | 무검사 | 0 / 0 | 0 | 전기부품
13 | __.01.__.__.__.__.__ | 30138909 |  | SPEAKER | 3W / 8Ω/ | 1 | 내자 | C | 0 / 0 | 0 | 조립품
14 | 03.__.__.__.__.__.__ | 20064118 | R1D000390 | PEI1 PEI2 SWITCH ASS'Y | ASS'Y/ | 1 | 외작 | C | 0 / 0 | 0 | SWITCH류
15 | __.01.__.__.__.__.__ | 30140848 |  | SWITCH BLOCK | LPI5412B/ | 1 | 내자 | 무검사 | 0 / 0 | 0 | 전기부품
16 | __.02.__.__.__.__.__ | 30140849 |  | OPERATOR | 2KN1723/ | 1 | 내자 | 무검사 | 0 / 0 | 0 | 전기부품
17 | 04.__.__.__.__.__.__ | 20064119 | R1D000391 | PEI1 PEI2 SWITCH HOLDER | ASS'Y/ | 1 | 외작 | C | 0 / 0 | 0 | SWITCH류
18 | __.01.__.__.__.__.__ | 20064121 |  | SWITCH GUARD | 304SS/ | 1 | 외작 | C | 0 / 0 | 0 | SWITCH류
19 | __.02.__.__.__.__.__ | 20064122 |  | FIXTURE | 304SS, M40, PITCH 1.0/ | 1 | 외작 | C | 0 / 0 | 0 | SWITCH류
20 | 05.__.__.__.__.__.__ | 20064117 | R1D000383 | PEI1 PEI2 LED BOARD ASSY | ASS'Y/ | 1 | 외작 | C | 0 / 0 | 0 | P.C.B BOARD
21 | __.01.__.__.__.__.__ | 20064125 |  | PCB BOARD | ASS'Y/ | 1 | 외작 | C | 0 / 0 | 0 | P.C.B BOARD
22 | __.02.__.__.__.__.__ | 30138914 | R1D000383(02) | LED INDICATOR (YELLOW) | VL1000P500/ | 1 | 외자 | C | 0 / 0 | 0 | 전기부품
23 | __.03.__.__.__.__.__ | 30138916 | R1D000383(03) | LED INDICATOR (RED) | VL1000P600/ | 1 | 외자 | C | 0 / 0 | 0 | 전기부품
24 | __.04.__.__.__.__.__ | 30138915 | R1D000383(04) | LED INDICATOR (GREEN) | VL1000P300/ | 1 | 외자 | C | 0 / 0 | 0 | 전기부품
25 | 06.__.__.__.__.__.__ | 20064114 | R1D000389 | PEI1 PEI2 POWER SUPPLY | ASS'Y/ | 1 | 외자 | C | 0 / 0 | 0 | 보조전원장치
26 | __.01.__.__.__.__.__ | 30138906 |  | POWER SUPPLY | / | 1 | 외작 | C | 0 / 0 | 0 | 전자부품
27 | __.02.__.__.__.__.__ | 30138907 |  | HEATSINK | ASS'Y, AL/ | 1 | 외작 | C | 0 / 0 | 0 | 전기부품
28 | __.03.__.__.__.__.__ | 30140840 |  | CONNECTOR | 5569-06/ | 1 | 외자 | 무검사 | 0 / 0 | 0 | 전기부품
29 | __.04.__.__.__.__.__ | 30140847 |  | CONNECTOR | SMW250-8P/ | 1 | 내자 | A | 0 / 0 | 0 | 시중품
30 | 07.__.__.__.__.__.__ | 20064115 | R1D000386 | PEI1 PEI2 CONTROL BOARD ASS'Y | ASS'Y/ | 1 | 외작 | C | 0 / 0 | 0 | P.C.B BOARD
31 | __.01.__.__.__.__.__ | 30139441 |  | CONNECTOR | 87427-0843/ | 1 | 내자 | 무검사 | 0 / 0 | 0 | 전자부품
32 | __.02.__.__.__.__.__ | 30139476 |  | CONNECTOR | 87427-2043/ | 1 | 외자 | 무검사 | 0 / 0 | 0 | 전자부품
33 | __.03.__.__.__.__.__ | 30139477 |  | CONNETOR | 35312-0860/ | 1 | 외자 | 무검사 | 0 / 0 | 0 | 전기부품
34 | __.04.__.__.__.__.__ | 30120273 |  | CONNECTOR | 35312-0460/ | 1 | 내자 | 무검사 | 0 / 0 | 0 | 전자부품
35 | __.05.__.__.__.__.__ | 30139478 |  | CONNECTOR | 35312-0560/ | 1 | 내자 | 무검사 | 0 / 0 | 0 | 전자부품
36 | 08.__.__.__.__.__.__ | 20064116 | R1D000387 | PEI1 PEI2 MIC N BOARD ASS'Y | ASS'Y/ | 1 | 외작 | C | 0 / 0 | 0 | P.C.B BOARD
37 | __.01.__.__.__.__.__ | 30138908 |  | MIC | AOM-4544P/ | 1 | 내자 | 무검사 | 0 / 0 | 0 | 전기부품
38 | __.02.__.__.__.__.__ | 10007636 |  | BOARD | ASSY/ | 1 | 외작 | C | 0 / 0 | 0 | P.C.B BOARD
39 | 09.__.__.__.__.__.__ | 30138870 |  | CONNECTOR | ITH03FPA28-21PB0G1F6/ | 1 | 외자 | C | 0 / 0 | 0 | 전자부품
40 | 10.__.__.__.__.__.__ | 30139322 | R1D000452(11) | NAME PLATE(PEI2) | t=1.0/AL | 1 | 내자 | 무검사 | 0 / 0 | 0 | 명판
41 | 11.__.__.__.__.__.__ | 30138927 |  | BOLT&WASHER LIST | ASS'Y/ | 1 | 내자 | 무검사 | 0 / 0 | 0 | 모름
42 | 12.__.__.__.__.__.__ | 30138690 |  | EMC GASKET | SF050010R-C-NA-A/ | 7 | 내자 | 무검사 | 29 / 58 | 0 | 시중품
43 | 13.__.__.__.__.__.__ | 30138928 |  | CONNECTOR | ITH08F28-21SB0F6/ | 1 | 외자 | C | 0 / 0 | 0 | 전자부품
44 | 14.__.__.__.__.__.__ | 30139307 | R1D000450 | MESH(DPO,PEI1,PEI2) | ASS'Y/ | 1 | 내자 | 무검사 | 0 / 0 | 0 | 모름
45 | __.01.__.__.__.__.__ | 30139308 |  | MESH | SCREEN#24,φ0.3,OPEN 50%/304SS | 1 | 내자 | 무검사 | 0 / 0 | 0 | 시중품
46 | __.02.__.__.__.__.__ | 30139309 |  | MESH | SCREEN#24,φ0.3,OPEN 50%/304SS | 1 | 내자 | 무검사 | 0 / 0 | 0 | 시중품
47 | __.03.__.__.__.__.__ | 30139310 | R1D000450(03) | SHEET | 304SS,t=0.7/ | 1 | 내자 | 무검사 | 0 / 0 | 0 | 가공품
48 | 15.__.__.__.__.__.__ | 30139456 | R1D000377 | SPEAKER RUBBER SHEET | t=6/RUBBER | 1 | 내자 | 무검사 | 0 / 0 | 0 | 가공품
49 | 16.__.__.__.__.__.__ | 30139479 | R1D000388 | PEI1,PEI2 MIC RUBBER SHEET | t=6.0/RUBBER | 1 | 내자 | 무검사 | 0 / 0 | 0 | 가공품
50 | 17.__.__.__.__.__.__ | 20064154 | R1D000447 | PEI2 WIRING DIAGRAM | ASS'Y/ | 1 | 내작 | 무검사 | 0 / 0 | 0 | 하네스도
51 | __.01.__.__.__.__.__ | 30139212 |  | WIRE | 100G1121-0.75-0/9/ | 1 | 외자 | C | 0 / 0 | 0 | 전선
52 | __.02.__.__.__.__.__ | 30140547 |  | WIRE | 100G1121-0.5-0/9/ | 1 | 외자 | C | 0 / 0 | 0 | 전선
53 | __.03.__.__.__.__.__ | 30140854 |  | WIRE | 100G1141-0.5-0/9/ | 1 | 외자 | C | 0 / 0 | 0 | 전선
54 | __.04.__.__.__.__.__ | 30124460 |  | CONNECTOR | SMH250-08/ | 1 | 내자 | A | 0 / 0 | 0 | 시중품
55 | __.05.__.__.__.__.__ | 30139216 |  | CONNECTOR | 5557-06R/ | 1 | 내자 | 무검사 | 0 / 0 | 0 | 전자부품
56 | __.06.__.__.__.__.__ | 30139258 |  | CONNECTOR | 35572-0400/ | 2 | 내자 | 무검사 | 0 / 0 | 0 | 전자부품
57 | __.07.__.__.__.__.__ | 30139259 |  | TERMINAL | 5557-08R/ | 1 | 내자 | 무검사 | 0 / 0 | 0 | 전자부품
58 | __.08.__.__.__.__.__ | 30139260 |  | TERMINAL | 35572-0500/ | 1 | 내자 | 무검사 | 0 / 0 | 0 | 전자부품
59 | __.09.__.__.__.__.__ | 30140843 |  | CONNECTOR | 5557-22R/ | 1 | 내자 | 무검사 | 0 / 0 | 0 | 전자부품
60 | __.10.__.__.__.__.__ | 30081231 |  | TERMINAL | 5556, AWG18-24/ | 75 | 외자 | 무검사 | 0 / 0 | 0 | 전기부품
61 | __.11.__.__.__.__.__ | 30067016 |  | WIRE | 100G0111-0.5-0/ | 1 | 내자 | C | 39 / 58 | 0 | 전선

Sheet: emb
 |  |  |  |  | B O M L I S T
BOM 번호: 10007325-01 [10007325][R1D1473-25840][] (EMJ)EXTERIOR MICROPHONE JACK
BOM 설명: 미국 DENVER EMB
No | LEVEL | 품목코드 | 도면번호 | 품 명 | 품 명 | 수량 SET수량 | 조달 형태 | 품질 등급 | 구매L/T 양산/개발 | 표준 공수 | 품목형태 | 품목형태
1 | 01.__.__.__.__.__.__ | 30139017 | R1D000419 | BOX ASS'Y | ASS'Y/ | 1 | 외작 | C | 0 / 0 | 0 |  | 제관품
2 | __.01.__.__.__.__.__ | 30139018 | R1D000418 | DOOR COVER | ASS'Y/ | 1 | 외작 | C | 0 / 0 | 0 |  | 제관품
3 | __.__.01.__.__.__.__ | 30139024 |  | DOOR COVER | 304SS,t=2.0/ | 1 | 외작 | C | 0 / 0 | 0 |  | 제관품
4 | __.02.__.__.__.__.__ | 30139019 | R1D000417 | CASE | ASS'Y/ | 1 | 외작 | C | 0 / 0 | 0 |  | 제관품
5 | __.__.01.__.__.__.__ | 30139025 |  | CASE | 304SS,t=1.2/ | 1 | 외작 | C | 0 / 0 | 0 |  | 제관품
6 | __.__.02.__.__.__.__ | 30139496 |  | BLIND NUT | M4/ | 1 | 외작 | C | 0 / 0 | 0 |  | 제관품
7 | __.__.03.__.__.__.__ | 30139439 |  | HEXA HEAD STANDOF | D5,M3,L6/ | 1 | 내자 | 무검사 | 0 / 0 | 0 |  | 가공품
8 | __.__.04.__.__.__.__ | 30139028 |  | HINGE | ASS'Y/ | 2 | 외작 | C | 0 / 0 | 0 |  | 제관품
9 | __.__.05.__.__.__.__ | 30139029 |  | INNER PLATE | 304SS,t=1.2/ | 1 | 외작 | C | 0 / 0 | 0 |  | 제관품
10 | __.__.06.__.__.__.__ | 30139030 |  | EARTH PAD | #10-24 UNC TAP, H8.8/STS304 | 1 | 외작 | C | 0 / 0 | 0 |  | 제관품
11 | __.03.__.__.__.__.__ | 30139020 | R1D000422 | INSTALL BRACKET | 304SS,t=3.0/ | 1 | 외작 | C | 0 / 0 | 0 |  | 제관품
12 | __.04.__.__.__.__.__ | 30139021 | R1D000493 | LABEL PLATE | 304SS,t=1.5/ | 1 | 외작 | C | 0 / 0 | 0 |  | 제관품
13 | __.05.__.__.__.__.__ | 30139023 |  | HINGE | ASS'Y,304SS/ | 1 | 외작 | C | 0 / 0 | 0 |  | 제관품
14 | 02.__.__.__.__.__.__ | 30138185 |  | HANDLE | A-53/ | 1 | 내자 | 무검사 | 0 / 0 | 0 |  | 시중품
15 | 03.__.__.__.__.__.__ | 20064171 | R1D000420 | EMB CONTROL BOARD | ASS'Y/ | 1 | 내자 | 무검사 | 0 / 0 | 0 |  | P.C.B BOARD
16 | __.01.__.__.__.__.__ | 30139575 |  | CONNECTOR | 87427-1243/ | 1 | 외자 | 무검사 | 0 / 0 | 0 |  | 전자부품
17 | __.02.__.__.__.__.__ | 30139478 |  | CONNECTOR | 35312-0560/ | 1 | 내자 | 무검사 | 0 / 0 | 0 |  | 전자부품
18 | 04.__.__.__.__.__.__ | 30139499 |  | LOCK HANDLE | M1-20-31-38/ | 1 | 내자 | 무검사 | 0 / 0 | 0 |  | 가공품
19 | 05.__.__.__.__.__.__ | 30139033 | R1D000421 | SEALING FORM | EPDM, CR FORM, t=3.0/ | 1 | 내자 | 무검사 | 0 / 0 | 0 |  | 모름
20 | 06.__.__.__.__.__.__ | 30139034 |  | CONNECTOR | FRITS4106A14S-07SB1PHM11F6/ | 1 | 외자 | C | 0 / 0 | 0 |  | 전자부품
21 | 07.__.__.__.__.__.__ | 30139035 |  | CONNECTOR | FRITS4100A14S-07PB1PHM11F6/ | 1 | 외자 | C | 0 / 0 | 0 |  | 전자부품
22 | 08.__.__.__.__.__.__ | 30139500 |  | PHONE JACK | H40580130N/ | 1 | 내자 | 무검사 | 0 / 0 | 0 |  | 전기부품
23 | 09.__.__.__.__.__.__ | 30139326 | R1D000452(15) | NAME PLATE(EMB) | t=1.0/304SS | 1 | 내자 | 무검사 | 0 / 0 | 0 |  | 명판
24 | 10.__.__.__.__.__.__ | 30139037 |  | HINGE | 304SS/ | 2 | 내자 | 무검사 | 0 / 0 | 0 |  | 제관품
25 | 11.__.__.__.__.__.__ | 30139042 |  | BOLT&WASHER LIST | ASS'Y/ | 1 | 내자 | 무검사 | 0 / 0 | 0 |  | 모름
26 | 12.__.__.__.__.__.__ | 30139501 |  | SEALING GASKET | EPDM, CR FORM/ | 1 | 내자 | 무검사 | 0 / 0 | 0 |  | 제관품
27 | 13.__.__.__.__.__.__ | 20064172 | R1D000465 | EMB WIRING DIAGRAM | ASS'Y/ | 1 | 내작 | 무검사 | 0 / 0 | 0 |  | 하네스도
28 | __.01.__.__.__.__.__ | 30139573 |  | WIRE | 100G1141-0.75-0/ | 1 | 외자 | C | 0 / 0 | 0 |  | 전선
29 | __.02.__.__.__.__.__ | 30139574 |  | CONNECTOR | 3901-2125/ | 1 | 내자 | 무검사 | 0 / 0 | 0 |  | 전자부품
30 | __.03.__.__.__.__.__ | 30139543 |  | CONNECTOR | 35572-0500/ | 1 | 내자 | 무검사 | 0 / 0 | 0 |  | 전자부품
31 | __.04.__.__.__.__.__ | 30081231 |  | TERMINAL | 5556, AWG18-24/ | 17 | 외자 | 무검사 | 0 / 0 | 0 |  | 전기부품

Sheet: ansm
 |  |  |  |  | B O M L I S T
BOM 번호: 10007323-01 [10007323][R1D1473-25864][] (ANSM)ANS MICROPHONE ASS'Y
BOM 설명: 미국 DENVER ANS MICROPHONE
No | LEVEL | 품목코드 | 도면번호 | 품 명 | 품 명 | 수량 SET수량 | 조달 형태 | 품질 등급 | 구매L/T 양산/개발 | 표준 공수 | 품목형태
1 | 01.__.__.__.__.__.__ | 30120230 |  | MICRO PHONE | AOM-4544P-2R/ | 1 | 내자 | 무검사 | 0 / 0 | 0 | 전기부품
2 | 02.__.__.__.__.__.__ | 30138805 | R1D000414 | BRACKET | A569,t1.5/ | 1 | 외작 | A | 0 / 0 | 0 | 제관품
3 | 03.__.__.__.__.__.__ | 30138812 |  | BYONET COUPLING CONNECTOR | FRITS4106F14S-01SB1F6/ | 1 | 외자 | 무검사 | 0 / 0 | 0 | 전자부품
4 | 04.__.__.__.__.__.__ | 30138813 |  | BYONET COUPLING CONNECTOR | FRITS100F14S-07SB1G1F6/ | 1 | 외자 | 무검사 | 0 / 0 | 0 | 전자부품
5 | 05.__.__.__.__.__.__ | 30062576 |  | GRAND | PG7/ASS'Y | 1 | 내자 | C | 0 / 0 | 0 | 전기부품
6 | 06.__.__.__.__.__.__ | 30139327 | R1D000452(16) | NAME PLATE(ANSM) | t=0.025/PVC | 1 | 내자 | 무검사 | 0 / 0 | 0 | 명판
7 | 07.__.__.__.__.__.__ | 30138814 | R1D000415 | MIC CAP | A6061/AL | 1 | 외작 | A | 0 / 0 | 0 | 제관품
8 | 08.__.__.__.__.__.__ | 20064173 | R1D000507 | ANSM WIRING DIAGRAM | ASS'Y/ | 1 | 내작 | 무검사 | 0 / 0 | 0 | 하네스도
9 | __.01.__.__.__.__.__ | 30138815 |  | WIRE | 100G1121-0.5/ | 1 | 외자 | 무검사 | 0 / 0 | 0 | 전선

Sheet: dma
 |  |  |  |  | B O M L I S T
BOM 번호: 10007322-01 [10007322][R1D1473-25863][] DRIVER MICROPHONE ASSEMBLY
BOM 설명: 미국 DENVER DMA
No | LEVEL | 품목코드 | 도면번호 | 품 명 | 품 명 | 수량 SET수량 | 조달 형태 | 품질 등급 | 구매L/T 양산/개발 | 표준 공수 | 품목형태
1 | 01.__.__.__.__.__.__ | 30139235 |  | GOOSENECK MIC | D-503B/ | 1 | 외자 | C | 0 / 0 | 0 | 전기부품
2 | 02.__.__.__.__.__.__ | 30139507 |  | XLR CONNECTOR | 3-PIN MALE XLR/ | 1 | 내자 | 무검사 | 0 / 0 | 0 | 전자부품
3 | 03.__.__.__.__.__.__ | 20064293 | R1D000705 | GNM WIRING DIAGRAM | ASS'Y/ | 1 | 내작 | 무검사 | 0 / 0 | 0 | 하네스도
4 | __.01.__.__.__.__.__ | 30138815 |  | WIRE | 100G1121-0.5/ | 1 | 외자 | 무검사 | 0 / 0 | 0 | 전선

Sheet: trf
 |  |  |  |  | B O M L I S T
BOM 번호: 10007324-01 [10007324][R1D1473-25866][] (TRF)TRANSFORMER
BOM 설명: 미국 DENVER TRF
No | LEVEL | 품목코드 | 도면번호 | 품 명 | 품 명 | 수량 SET수량 | 조달 형태 | 품질 등급 | 구매L/T 양산/개발 | 표준 공수 | 품목형태
1 | 01.__.__.__.__.__.__ | 30139223 | R1D000416 | BRACKET | ASS'Y/ | 1 | 외작 | C | 0 / 0 | 0 | 제관품
2 | __.01.__.__.__.__.__ | 30139224 |  | BRACKET | A366-91,t1/ | 1 | 외작 | C | 0 / 0 | 0 | 제관품
3 | __.02.__.__.__.__.__ | 30139494 |  | HEXA HEAD STANDOF | D5,M3,L4/ | 4 | 내자 | 무검사 | 0 / 0 | 0 | 가공품
4 | __.03.__.__.__.__.__ | 30139495 |  | HEXA HEAD STANDOF | D5,M3,L7.5/ | 4 | 내자 | 무검사 | 0 / 0 | 0 | 가공품
5 | 02.__.__.__.__.__.__ | 30120237 |  | CONNECTOR | 231-606/019-000/ | 1 | 내자 | C | 0 / 0 | 0 | 전기부품
6 | 03.__.__.__.__.__.__ | 30120268 |  | CONNECTOR | 231-106/037-000/ | 1 | 내자 | C | 0 / 0 | 0 | 전기부품
7 | 04.__.__.__.__.__.__ | 30118493 |  | CONNECTOR | 231-603/019-000/ | 1 | 내자 | C | 0 / 0 | 0 | 전기부품
8 | 05.__.__.__.__.__.__ | 30118494 |  | CONNECTOR | 231-103/037-000/ | 1 | 내자 | C | 0 / 0 | 0 | 전기부품
9 | 06.__.__.__.__.__.__ | 30139227 |  | ISP BOARD | ASS'Y/ | 1 | 내자 | 무검사 | 0 / 0 | 0 | PCB
10 | 07.__.__.__.__.__.__ | 30139229 |  | BOLT&NUT LIST | ASS'Y/ | 1 | 내자 | 무검사 | 0 / 0 | 0 | 모름
11 | 08.__.__.__.__.__.__ | 30124441 |  | TERMINAL | CE007506/ | 8 | 내자 | 무검사 | 0 / 0 | 0 | 전기부품
12 | 09.__.__.__.__.__.__ | 30121248 |  | TRANSFORMER | WJ-ST-70KV 4W/ | 1 | 내자 | C | 0 / 0 | 0 | 전기부품
13 | 10.__.__.__.__.__.__ | 30139328 | R1D000452(17) | NAME PLATE(TRF) | t=1.0/AL | 1 | 내자 | 무검사 | 0 / 0 | 0 | 명판
14 | 11.__.__.__.__.__.__ | 20064170 | R1D000502 | TRF WIRING DIAGRAM | ASS'Y/ | 1 | 내작 | 무검사 | 0 / 0 | 0 | 하네스도
15 | __.01.__.__.__.__.__ | 30127617 |  | WIRE | 100G0111-0.75-0/ | 1 | 외자 | 무검사 | 0 / 0 | 0 | 전선
16 | __.02.__.__.__.__.__ | 30138256 |  | CONNECTOR | 5557-10R/ | 2 | 내자 | A | 0 / 0 | 0 | 전자부품
17 | __.03.__.__.__.__.__ | 30139485 |  | CONNECTOR | 5557-02R/ | 1 | 외자 | C | 0 / 0 | 0 | 전기부품
18 | __.04.__.__.__.__.__ | 30139215 |  | CONNECTOR | 5557-04R/ | 1 | 내자 | 무검사 | 0 / 0 | 0 | 전자부품
19 | __.05.__.__.__.__.__ | 30081231 |  | TERMINAL | 5556, AWG18-24/ | 12 | 외자 | 무검사 | 0 / 0 | 0 | 전기부품

Sheet: esp
 |  |  |  |  | B O M L I S T
BOM 번호: 10007320-01 [10007320][R1D1473-25858][] (ESP)EXTERIOR SPEAKER
BOM 설명: 미국 DENVER ESP
No | LEVEL | 품목코드 | 도면번호 | 품 명 | 품 명 | 수량 SET수량 | 조달 형태 | 품질 등급 | 구매L/T 양산/개발 | 표준 공수 | 품목형태
1 | 01.__.__.__.__.__.__ | 30138929 | R1D000400 | ESP BOX ASSY | ASS'Y/ | 1 | 내작 | C | 0 / 0 | 0 | 제관품
2 | __.01.__.__.__.__.__ | 30138930 | R1D000403 | FRONT PLATE | ASS'Y/ | 1 | 외작 | C | 0 / 0 | 0 | 제관품
3 | __.__.01.__.__.__.__ | 30138931 |  | FRONT PLATE | 304SS, t3.0,HAIRLINE #4/ | 1 | 외작 | C | 0 / 0 | 0 | 제관품
4 | __.__.02.__.__.__.__ | 30140817 |  | WELDING NUT | D6,M4,L6/ | 1 | 내자 | 무검사 | 0 / 0 | 0 | 시중품
5 | __.02.__.__.__.__.__ | 30138933 | R1D000401 | BRACKET | ASS'Y/ | 4 | 외작 | C | 0 / 0 | 0 | 제관품
6 | __.__.01.__.__.__.__ | 30138934 |  | BRACKET | A366-91,t=1.2/ | 1 | 외작 | C | 0 / 0 | 0 | 제관품
7 | __.__.02.__.__.__.__ | 30139487 |  | CLINCHING NUT | M3,L2/ | 1 | 내자 | 무검사 | 0 / 0 | 0 | 시중품
8 | __.03.__.__.__.__.__ | 30138936 | R1D000402 | ESP COVER | ASS'Y/ | 4 | 외작 | C | 0 / 0 | 0 | 제관품
9 | __.__.01.__.__.__.__ | 30138937 |  | COVER | A366-91,t1.0/ | 1 | 외작 | C | 0 / 0 | 0 | 제관품
10 | __.__.02.__.__.__.__ | 30139487 |  | CLINCHING NUT | M3,L2/ | 2 | 내자 | 무검사 | 0 / 0 | 0 | 시중품
11 | 02.__.__.__.__.__.__ | 30138988 | R1D000405 | SPEAKER | CW-100B25/ | 1 | 내자 | C | 0 / 0 | 0 | 전기부품
12 | 03.__.__.__.__.__.__ | 30138938 | R1D000406 | ESP SEALING FORM | EPDM, CR FORM, t5/ | 1 | 내자 | 무검사 | 0 / 0 | 0 | 모름
13 | 04.__.__.__.__.__.__ | 30138940 |  | BOLT&NUT LIST | ASS'Y/ | 1 | 내자 | 무검사 | 0 / 0 | 0 | 모름
14 | 05.__.__.__.__.__.__ | 30139325 | R1D000452(14) | NAME PLATE(ESP) | t=1.0/AL | 1 | 내자 | 무검사 | 0 / 0 | 0 | 명판
15 | 06.__.__.__.__.__.__ | 30138963 |  | EMC GASKET | SF050010R-C-NA-A/ | 1 | 내자 | 무검사 | 0 / 0 | 0 | 시중품
16 | 07.__.__.__.__.__.__ | 60004336 |  | THREEBOND | 1521/ | 1 | 내자 | 무검사 | 0 / 0 | 0 | 공용(이화학제품)
17 | 08.__.__.__.__.__.__ | 30138942 | R1D000404 | ESP GASKET | t3.0/EPDM | 1 | 내자 | 무검사 | 0 / 0 | 0 | 시중품
18 | 09.__.__.__.__.__.__ | 30138939 | R1D000397 | GROMMET(ISP, ESP, CSP) | RUBBER/ | 1 | 외작 | 무검사 | 0 / 0 | 0 | 모름
19 | __.01.__.__.__.__.__ | 30139484 |  | GROMMET | EPDM,φ15mm(0.59)/ | 1 | 내자 | 무검사 | 0 / 0 | 0 | 모름
20 | 10.__.__.__.__.__.__ | 30139304 | R1D000449(01) | MESH(ESP,ISP,CSP) | ASS'Y/ | 1 | 내자 | 무검사 | 0 / 0 | 0 | 모름
21 | __.01.__.__.__.__.__ | 30139305 |  | MESH | SCREEN#24,φ0.3,OPEN 50%/304SS | 1 | 내자 | 무검사 | 0 / 0 | 0 | 시중품
22 | __.02.__.__.__.__.__ | 30139306 | R1D000449(02) | SHEET | 304SS,t=0.7/ | 1 | 내자 | 무검사 | 0 / 0 | 0 | 가공품
23 | 11.__.__.__.__.__.__ | 20064168 | R1D000498 | ESP WIRING DIAGRAM | ASS'Y/ | 1 | 내작 | 무검사 | 0 / 0 | 0 | 하네스도
24 | __.01.__.__.__.__.__ | 30054010 |  | WIRE | 100G0111-1.2-0/ | 2 | 외자 | 무검사 | 0 / 0 | 0 | 전기부품
25 | __.02.__.__.__.__.__ | 30118493 |  | CONNECTOR | 231-603/019-000/ | 1 | 내자 | C | 0 / 0 | 0 | 전기부품
26 | __.03.__.__.__.__.__ | 30118494 |  | CONNECTOR | 231-103/037-000/ | 1 | 내자 | C | 0 / 0 | 0 | 전기부품

Sheet: isp
 |  |  |  |  | B O M L I S T
BOM 번호: 10007319-01 [10007319][R1D1473-25857][] (ISP)INTERIOR SPEAKER
BOM 설명: 미국 DENVER ISP
No | LEVEL | 품목코드 | 도면번호 | 품 명 | 품 명 | 수량 SET수량 | 조달 형태 | 품질 등급 | 구매L/T 양산/개발 | 표준 공수 | 품목형태
1 | 01.__.__.__.__.__.__ | 30138944 | R1D000399 | ISP BOX ASSY | ASS'Y/ | 1 | 내작 | C | 0 / 0 | 0 | 제관품
2 | __.01.__.__.__.__.__ | 30138945 | R1D000395 | ISP FRONT PANEL | ASS'Y/ | 1 | 외작 | C | 0 / 0 | 0 | 제관품
3 | __.__.01.__.__.__.__ | 30138946 |  | PANEL | 304SS, t=3.0,HAIRLINE/ | 1 | 외작 | C | 0 / 0 | 0 | 제관품
4 | __.__.02.__.__.__.__ | 30138932 |  | BOSS | D6, M4, L6/ | 4 | 외작 | C | 0 / 0 | 0 | 제관품
5 | __.02.__.__.__.__.__ | 30138947 | R1D000394 | BRACKET | ASS'Y/ | 1 | 외작 | C | 0 / 0 | 0 | 제관품
6 | __.__.01.__.__.__.__ | 30138948 |  | BRACKET | A366-91t=1.2/ | 1 | 외작 | C | 0 / 0 | 0 | 제관품
7 | __.__.02.__.__.__.__ | 30139480 |  | CLINCHING NUT | M3,D5,L2/ | 4 | 내자 | 무검사 | 0 / 0 | 0 | 시중품
8 | __.03.__.__.__.__.__ | 30138950 | R1C00057 | ISP COVER | ASS'Y/ | 4 | 외작 | C | 0 / 0 | 0 | 제관품
9 | __.__.01.__.__.__.__ | 30139481 |  | COVER | A366-91,t1.0/ | 1 | 외작 | C | 0 / 0 | 0 | 제관품
10 | __.__.02.__.__.__.__ | 30139482 |  | HEXA HEAD STANDOF | D6,M3,L7/ | 4 | 내자 | 무검사 | 0 / 0 | 0 | 가공품
11 | __.__.03.__.__.__.__ | 30139483 |  | CLINCHING NUT | D6,M3,L5/ | 2 | 내자 | 무검사 | 0 / 0 | 0 | 시중품
12 | 02.__.__.__.__.__.__ | 30138988 | R1D000405 | SPEAKER | CW-100B25/ | 1 | 내자 | C | 0 / 0 | 0 | 전기부품
13 | 03.__.__.__.__.__.__ | 20064126 | R1D000396 | ISP CONTROL BOARD ASSY | ASS'Y/ | 1 | 내작 | 무검사 | 0 / 0 | 0 | P.C.B BOARD
14 | __.01.__.__.__.__.__ | 20064128 |  | PCB BOARD | ASS'Y/ | 1 | 내작 | 무검사 | 0 / 0 | 0 | P.C.B BOARD
15 | __.02.__.__.__.__.__ | 20064129 |  | TRANSFORMER | ASS'Y/ | 1 | 외작 | C | 0 / 0 | 0 | 전력변환장치
16 | __.03.__.__.__.__.__ | 30138954 |  | CONNECTOR | 5566-02/ | 5 | 외자 | C | 0 / 0 | 0 | 전기부품
17 | __.04.__.__.__.__.__ | 30138956 |  | CONNECTOR | 5566-04/ | 1 | 외자 | C | 0 / 0 | 0 | 전자부품
18 | __.05.__.__.__.__.__ | 30138959 |  | CONNECTOR | 5566-08/ | 1 | 외자 | 무검사 | 0 / 0 | 0 | 전자부품
19 | __.06.__.__.__.__.__ | 30138960 |  | CONNECTOR | 5566-10/ | 1 | 내자 | C | 0 / 0 | 0 | 전기부품
20 | 04.__.__.__.__.__.__ | 30120269 |  | CONNECTOR | 231-608/019-000/ | 1 | 내자 | C | 0 / 0 | 0 | 전기부품
21 | 05.__.__.__.__.__.__ | 30120270 |  | CONNECTOR | 231-108/037-000/ | 1 | 내자 | C | 0 / 0 | 0 | 전기부품
22 | 06.__.__.__.__.__.__ | 30138954 |  | CONNECTOR | 5566-02/ | 5 | 외자 | C | 0 / 0 | 0 | 전기부품
23 | 07.__.__.__.__.__.__ | 30138955 |  | CONNECTOR | 5557-02/ | 2 | 외자 | C | 0 / 0 | 0 | 전기부품
24 | 08.__.__.__.__.__.__ | 30138956 |  | CONNECTOR | 5566-04/ | 1 | 외자 | C | 0 / 0 | 0 | 전자부품
25 | 09.__.__.__.__.__.__ | 30138958 |  | CONNECTOR | 5557-04/ | 1 | 외자 | 무검사 | 0 / 0 | 0 | 전자부품
26 | 10.__.__.__.__.__.__ | 30138959 |  | CONNECTOR | 5566-08/ | 1 | 외자 | 무검사 | 0 / 0 | 0 | 전자부품
27 | 11.__.__.__.__.__.__ | 30140815 |  | CONNECTOR | 5557-08/ | 1 | 외자 | 무검사 | 0 / 0 | 0 | 전자부품
28 | 12.__.__.__.__.__.__ | 30138960 |  | CONNECTOR | 5566-10/ | 1 | 내자 | C | 0 / 0 | 0 | 전기부품
29 | 13.__.__.__.__.__.__ | 30140816 |  | CONNECTOR | 5557-10/ | 1 | 내자 | C | 0 / 0 | 0 | 전기부품
30 | 14.__.__.__.__.__.__ | 30139486 |  | TRANSFORMER | 70V,4W/ | 1 | 내자 | 무검사 | 0 / 0 | 0 | 전기부품
31 | 15.__.__.__.__.__.__ | 30139323 | R1D000452(12) | NAME PLATE(ISP) | t=1.0/AL | 1 | 내자 | 무검사 | 0 / 0 | 0 | 명판
32 | 16.__.__.__.__.__.__ | 30138939 | R1D000397 | GROMMET(ISP, ESP, CSP) | RUBBER/ | 1 | 외작 | 무검사 | 0 / 0 | 0 | 모름
33 | __.01.__.__.__.__.__ | 30139484 |  | GROMMET | EPDM,φ15mm(0.59)/ | 1 | 내자 | 무검사 | 0 / 0 | 0 | 모름
34 | 17.__.__.__.__.__.__ | 30138962 |  | HARNESS | / | 1 | 내작 | 무검사 | 0 / 0 | 0 | 전선
35 | 18.__.__.__.__.__.__ | 30138963 |  | EMC GASKET | SF050010R-C-NA-A/ | 5 | 내자 | 무검사 | 0 / 0 | 0 | 시중품
36 | 19.__.__.__.__.__.__ | 30138964 |  | BOLT&WAHSER LIST | ASS'Y/ | 1 | 내자 | 무검사 | 0 / 0 | 0 | 모름
37 | 20.__.__.__.__.__.__ | 30138966 | R1D000398 | ISP GASKET | RUBBER, t=5.0/ | 1 | 내자 | 무검사 | 0 / 0 | 0 | 모름
38 | 21.__.__.__.__.__.__ | 30139304 | R1D000449(01) | MESH(ESP,ISP,CSP) | ASS'Y/ | 1 | 내자 | 무검사 | 0 / 0 | 0 | 모름
39 | __.01.__.__.__.__.__ | 30139305 |  | MESH | SCREEN#24,φ0.3,OPEN 50%/304SS | 1 | 내자 | 무검사 | 0 / 0 | 0 | 시중품
40 | __.02.__.__.__.__.__ | 30139306 | R1D000449(02) | SHEET | 304SS,t=0.7/ | 2 | 내자 | 무검사 | 0 / 0 | 0 | 가공품
41 | 22.__.__.__.__.__.__ | 20064167 | R1D000467 | ISP WIRING DIAGRAM | ASS'Y/ | 1 | 내작 | 무검사 | 0 / 0 | 0 | 하네스도
42 | __.01.__.__.__.__.__ | 30127617 |  | WIRE | 100G0111-0.75-0/ | 1 | 외자 | 무검사 | 0 / 0 | 0 | 전선
43 | __.02.__.__.__.__.__ | 30138256 |  | CONNECTOR | 5557-10R/ | 2 | 내자 | A | 0 / 0 | 0 | 전자부품
44 | __.03.__.__.__.__.__ | 30139485 |  | CONNECTOR | 5557-02R/ | 1 | 외자 | C | 0 / 0 | 0 | 전기부품
45 | __.04.__.__.__.__.__ | 30139215 |  | CONNECTOR | 5557-04R/ | 1 | 내자 | 무검사 | 0 / 0 | 0 | 전자부품
46 | __.05.__.__.__.__.__ | 30081231 |  | TERMINAL | 5556, AWG18-24/ | 12 | 외자 | 무검사 | 0 / 0 | 0 | 전기부품

Sheet: csp
 |  |  |  |  |  | B O M L I S T
BOM 번호: 10007321-01 [10007321][R1D1473-25859][] (CSP)Cab Speaker Ass'y
BOM 설명: 미국 DENVER CSP
No | LEVEL | 품목코드 | 도면번호 |  | 품 명 |  | 수량 SET수량 | 조달 형태 | 품질 등급 | 구매L/T 양산/개발 | 표준 공수 | 품목형태
1 | 01.__.__.__.__.__.__ | 30139000 | R1D000412 | BOX ASS'Y |  | ASS'Y/ | 1 | 외작 | C | 0 / 0 | 0 | 제관품
2 | __.01.__.__.__.__.__ | 30139001 | R1D000409 | FRONT PLATE |  | ASS'Y/ | 1 | 외작 | C | 0 / 0 | 0 | 제관품
3 | __.__.01.__.__.__.__ | 30139005 |  | PANEL |  | 366-91,t3.0/ | 1 | 외작 | C | 0 / 0 | 0 | 제관품
4 | __.__.02.__.__.__.__ | 30139488 |  | WELDING NUT |  | D6,M4,L6/ | 4 | 내자 | 무검사 | 0 / 0 | 0 | 제관품
5 | __.02.__.__.__.__.__ | 30139002 | R1D000407 | BRACKET |  | ASS'Y/ | 4 | 외작 | C | 0 / 0 | 0 | 제관품
6 | __.__.01.__.__.__.__ | 30139007 |  | BRACKET |  | A366-91,t=1.2/ | 1 | 외작 | C | 0 / 0 | 0 | 제관품
7 | __.__.02.__.__.__.__ | 30139489 |  | HEXA HEAD STANDOF |  | D6,M4,L10.8/ | 2 | 내자 | 무검사 | 0 / 0 | 0 | 가공품
8 | __.__.03.__.__.__.__ | 30139487 |  | CLINCHING NUT |  | M3,L2/ | 4 | 내자 | 무검사 | 0 / 0 | 0 | 시중품
9 | __.03.__.__.__.__.__ | 30139003 | R1D000408 | COVER |  | ASS'Y/ | 2 | 외작 | C | 0 / 0 | 0 | 제관품
10 | __.__.01.__.__.__.__ | 30139009 |  | COVER |  | A366-91,t1.0/ | 1 | 외작 | C | 0 / 0 | 0 | 제관품
11 | __.__.02.__.__.__.__ | 30139490 |  | CLINCHING NUT |  | D6,M3,L2/ | 2 | 내자 | 무검사 | 0 / 0 | 0 | 시중품
12 | __.04.__.__.__.__.__ | 30139004 | R4D000411 | PLATE |  | ASS'Y/ | 2 | 외작 | C | 0 / 0 | 0 | 제관품
13 | __.__.01.__.__.__.__ | 30139010 |  | PLATE |  | A366-91,t=1.0/ | 1 | 외작 | C | 0 / 0 | 0 | 제관품
14 | 02.__.__.__.__.__.__ | 30138988 | R1D000405 | SPEAKER |  | CW-100B25/ | 1 | 내자 | C | 0 / 0 | 0 | 전기부품
15 | 03.__.__.__.__.__.__ | 30139011 |  | VOLUME CONTROL |  | VW50/ | 1 | 외자 | 무검사 | 0 / 0 | 0 | 전기부품
16 | 04.__.__.__.__.__.__ | 30118493 |  | CONNECTOR |  | 231-603/019-000/ | 1 | 내자 | C | 0 / 0 | 0 | 전기부품
17 | 05.__.__.__.__.__.__ | 30118494 |  | CONNECTOR |  | 231-103/037-000/ | 1 | 내자 | C | 0 / 0 | 0 | 전기부품
18 | 06.__.__.__.__.__.__ | 30139324 | R1D000452(13) | NAME PLATE(CSP) |  | t=1.0/AL | 1 | 내자 | 무검사 | 0 / 0 | 0 | 명판
19 | 07.__.__.__.__.__.__ | 30138939 | R1D000397 | GROMMET(ISP, ESP, CSP) |  | RUBBER/ | 1 | 외작 | 무검사 | 0 / 0 | 0 | 모름
20 | __.01.__.__.__.__.__ | 30139484 |  | GROMMET |  | EPDM,φ15mm(0.59)/ | 1 | 내자 | 무검사 | 0 / 0 | 0 | 모름
21 | 08.__.__.__.__.__.__ | 30139013 |  | EMC GASKET |  | SF050010R-C-NA-A/ | 1 | 내자 | 무검사 | 0 / 0 | 0 | 시중품
22 | 09.__.__.__.__.__.__ | 30139014 |  | BOLT&WASHER LIST |  | ASS'Y/ | 1 | 내자 | 무검사 | 0 / 0 | 0 | 모름
23 | 10.__.__.__.__.__.__ | 30139491 | R1D000410 | CSP GASKET |  | t=5.0/RUBBER | 1 | 내자 | 무검사 | 0 / 0 | 0 | 시중품
24 | 11.__.__.__.__.__.__ | 30139304 | R1D000449(01) | MESH(ESP,ISP,CSP) |  | ASS'Y/ | 1 | 내자 | 무검사 | 0 / 0 | 0 | 모름
25 | __.01.__.__.__.__.__ | 30139305 |  | MESH |  | SCREEN#24,φ0.3,OPEN 50%/304SS | 1 | 내자 | 무검사 | 0 / 0 | 0 | 시중품
26 | __.02.__.__.__.__.__ | 30139306 | R1D000449(02) | SHEET |  | 304SS,t=0.7/ | 2 | 내자 | 무검사 | 0 / 0 | 0 | 가공품
27 | 12.__.__.__.__.__.__ | 20064169 | R1D000499 | CSP WIRING DIAGRAM |  | ASS'Y/ | 1 | 내작 | 무검사 | 0 / 0 | 0 | 하네스도
28 | __.01.__.__.__.__.__ | 30054010 |  | WIRE |  | 100G0111-1.2-0/ | 1 | 외자 | 무검사 | 0 / 0 | 0 | 전기부품
29 | __.02.__.__.__.__.__ | 30124437 |  | FERRULES SLEEVE |  | 0.75SQ, 6mm/ | 2 | 내자 | 무검사 | 0 / 0 | 0 | 전자부품
30 | 13.__.__.__.__.__.__ | 30139492 | R1D000501 | CSP VW50&KNOB |  | ASS'Y/ | 1 | 내작 | A | 0 / 0 | 0 | 가공품
31 | __.01.__.__.__.__.__ | 30139493 |  | POTENSION METER |  | VW50/ | 1 | 내자 | 무검사 | 0 / 0 | 0 | 모름
32 | __.02.__.__.__.__.__ | 30098195 |  | KNOB |  | F-9/ | 1 | 외작 | B | 0 / 0 | 0 | 가공품
