JDSCS-Club/DENVER_CCP/DOC/02_설계_도면/BOM/PCB 추가 발주 물품 리스트.xlsx

장치면 | 분류 | 품명 | 수량(량당) | 도면번호(우진) | 품목코드
CRA | VTX | Video TX Board | 1 | R1D1473-25838 | 10007307
 | CNCS | Content & Control Server | 1
 | HDD | Hard Disk Drive PCB Ass'y | 1
 | WLR | Wireless LAN Router Board | 1
 | VOIP | VoIP Board | 1
 | LIC | LonWorks Interface Card | 1
 | PAC 485 | PA Control Board-RS485 | 1
 | SCB | Signal Connection Board | 1
 | PAC MCU | PA Control Board-MCU | 1
 | PAC VOL | PA Control Board-VOL | 1
 | PAC INT | PA Control Board-INT | 1
 | PAC AAB1 | Audio Amplifier Board1 | 1
 | PAC AAB2 | Audio Amplifier Board2 | 1
CCP | CCP-CB | PCB ass'y, CCP Control Board | 1 | R1D1473-25842 | 10007309
DPO | DPO-CB | PCB ass'y,DPO Control Board | 1 | R1D1473-25854 | 10007315
DPH | DPH-CB | PCB ass'y,DPH Control Board | 1 | R1D1473-26838 | 10007316
PEI | PEI-CB | PCB ass'y,PEI Control Board | 2 | R1D1473-26839 | 10007637
FDI | LEDC | PCB ass'y,LED Control Borard | 1 | R1D1473-25849 | 10007310
SDI | LEDC | PCB ass'y,LED Control Borard | 4 | R1D1473-25850 | 10007311
PII | LEDC | PCB ass'y,LED Control Borard | 2 | R1D1473-25853 | 10007314
PID1 | VRX | PCB ass'y,Video RX Board | 4 | R1D1473-25851 | 10007312
PID2 | VRX | PCB ass'y,Video RX Board | 1 | R1D1473-25852 | 10007313
ISP | SP-ISP | PCB ass'y,Transformer Board | 8 | R1D1473-25857 | 10007319
TRF | SP-ISP | PCB ass'y,Transformer Board | 4 | R1D1473-25866 | 10007324
