JDSCS-Club/DENVER_CCP/DOC/01_인터페이스_설계/MDS_ICD/02_DDD_데이터사전/DCM-0432-0200-R03 Diagnostic Data Dictionary  Main_(Supplier Fault Code Update).xls

Sheet: CDT(차량회로)
System: |  | CDT
Supplier: |  | Quester Tangent
Date Last Updated: |  | 2013-04-24
Software/Firmware Version:
SCI Name | Part Number/Descriptor | Version
CCP | ISI-MS10-0001 | R03
IOP | ISI-DM08-0001 | R00
Status Data
Index | Name (max 60 characters) | Supplier Fault # | RTD Fault # | Severity (1-4) | Possible Cause | Effect | Notes | Faulty LRU | Operations Instructions | On-Train Maintenance Instructions | Help General | Help Operations | Help Maintenance | Display | Invert | Log-P | Trig-P | VS-P | Log-A | Trig-A | VS-A | Way-RF | Way-HD | Cust | Persist (s) | GFT | PROP FT | FBCU FT | APU FT | HVAC FT | DOOR | FT6
0 | Power On or Reset |  |  | 4 | Set momentarily each time CDT powers on. Can be used in CDT log to record startup. |  |  |  |  |  | Set momentarily each time CDT powers on. Can be used in CDT log to record startup. |  |  | 1 | 0 | 1 | 0 | 0 | 1 | 0 | 0 | 1 | 1 | 0 | 0 | 0 | 0 | 0 | 0 | 0 | 0 | 0
1 | Watchdog Reset |  |  | 3 | CDT reset due to watchdog timeout. Possible CDT software or hardware error. | CDT reboots |  | CDT |  | Check CDT log. Replace CDT if fault persists. May indicate failure of RAM or flash memory. | CDT reset due to watchdog timeout. Possible CDT software or hardware error. CDT reboots |  | Check CDT log. Replace CDT if fault persists. May indicate failure of RAM or flash memory. | 1 | 0 | 1 | 0 | 0 | 1 | 0 | 0 | 1 | 1 | 0 | 0 | 1 | 0 | 0 | 0 | 0 | 0 | 0
3 | LVPS Low voltage |  |  | 2 | LVPS voltage is below 24V. | LVPS Low LED lit on CDT. CDT turns off car network and I/O circuitry. The FDP General Fault LED will be lit and will not turn off when Reset button is pressed. |  | CDT | Report to Maintenance | If LVPS level is okay when measured independently then CDT LVPS monitoring circuit may be faulty. Replace CDT if fault persist when LVPS > 24V. | LVPS voltage is below 24V. LVPS Low LED lit on CDT. CDT turns off car network and I/O circuitry. The FDP General Fault LED will be lit and will not turn off when Reset button is pressed. | Report to Maintenance | If LVPS level is okay when measured independently then CDT LVPS monitoring circuit may be faulty. Replace CDT if fault persist when LVPS > 24V. | 1 | 0 | 1 | 0 | 0 | 1 | 0 | 0 | 1 | 1 | 0 | 0 | 1 | 0 | 0 | 0 | 0 | 0 | 0
4 | Power fault: Shutdown |  |  | 2 | CDT power supply shut down due to high temperature, low output voltage or high output current. | LVPS Fault LED lit on CDT. | CDT must be power cycled to restart. This condition is set momentarily on power up to indicate fault occurred. | CDT | Report to Maintenance | Check S5, S6, and S7 to determine cause. Replace CDT if fault persist. | CDT power supply shut down due to high temperature, low output voltage or high output current. LVPS Fault LED lit on CDT. | Report to Maintenance | Check S5, S6, and S7 to determine cause. Replace CDT if fault persist. | 1 | 0 | 1 | 0 | 0 | 1 | 0 | 0 | 1 | 1 | 0 | 0 | 1 | 0 | 0 | 0 | 0 | 0 | 0
5 | Power fault: High Temp Shutdown |  |  | 2 | CDT power supply shut down due to high temperature. | LVPS Fault LED lit on CDT. | CDT must be power cycled to restart. This condition is set momentarily on power up to indicate fault occurred. | CDT | Report to Maintenance | Replace CDT if fault persists. | CDT power supply shut down due to high temperature. LVPS Fault LED lit on CDT. | Report to Maintenance | Replace CDT if fault persists. | 1 | 0 | 1 | 0 | 0 | 1 | 0 | 0 | 1 | 1 | 0 | 0 | 1 | 0 | 0 | 0 | 0 | 0 | 0
6 | Power fault: High Current |  |  | 2 | CDT power supply shut down due to output current high on 6VDC supply. | LVPS Fault LED lit on CDT. | CDT must be power cycled to restart. This condition is set momentarily on power up to indicate fault occurred. | CDT | Report to Maintenance | Replace CDT if fault persists. | CDT power supply shut down due to output current high on 6VDC supply. LVPS Fault LED lit on CDT. | Report to Maintenance | Replace CDT if fault persists. | 1 | 0 | 1 | 0 | 0 | 1 | 0 | 0 | 1 | 1 | 0 | 0 | 1 | 0 | 0 | 0 | 0 | 0 | 0
7 | Power fault: High or Low Voltage |  |  | 2 | CDT internal power supply shut down due to low or high output voltage. | LVPS Fault LED lit on CDT. | CDT must be power cycled to restart. This condition is set momentarily on power up to indicate fault occurred. | CDT | Report to Maintenance | Replace CDT if fault persists. | CDT internal power supply shut down due to low or high output voltage. LVPS Fault LED lit on CDT. | Report to Maintenance | Replace CDT if fault persists. | 1 | 0 | 1 | 0 | 0 | 1 | 0 | 0 | 0 | 0 | 0 | 0 | 1 | 0 | 0 | 0 | 0 | 0 | 0
13 | Display On |  |  | 4 | CDT display is turned on. | Turned on at power up and whenever touch screen pressed. Turned off after 15 minutes |  |  |  |  | CDT display is turned on. Turned on at power up and whenever touch screen pressed. Turned off after 15 minutes |  |  | 1 | 0 | 0 | 0 | 0 | 1 | 0 | 0 | 0 | 0 | 0 | 0 | 0 | 0 | 0 | 0 | 0 | 0 | 0
14 | Display High Temperature |  |  | 4 | CDT display temperature > 158F (70C). | Display will not turn on to protect display damage. Display Temp LED is yellow on CDT. |  |  | Wait until the CDT has cooled down before using the touchscreen. | Replace CDT if condition persists. | CDT display temperature > 158F (70C). Display will not turn on to protect display damage. Display Temp LED is yellow on CDT. | Wait until the CDT has cooled down before using the touchscreen. | Replace CDT if condition persists. | 1 | 0 | 1 | 0 | 0 | 1 | 0 | 0 | 0 | 0 | 0 | 0 | 0 | 0 | 0 | 0 | 0 | 0 | 0
15 | Display Low Temperature |  |  | 4 | CDT display temperature < 14F (-10C). | Display will not turn on to prevent display damage. Display Temp LED is yellow on CDT. |  |  | Wait until the CDT has warmed up before using the touchscreen. | Replace CDT if condition persists. | CDT display temperature < 14F (-10C). Display will not turn on to prevent display damage. Display Temp LED is yellow on CDT. | Wait until the CDT has warmed up before using the touchscreen. | Replace CDT if condition persists. | 1 | 0 | 1 | 0 | 0 | 1 | 0 | 0 | 0 | 0 | 0 | 0 | 0 | 0 | 0 | 0 | 0 | 0 | 0
16 | Display Fault |  |  | 3 | Display, backlight or touchscreen is faulty. | Display will not turn on. Display Healthy LED is not lit on CDT. |  | CDT | Power cycle CDT. | Check S17, S18, S19 and S22 to determine cause. Replace CDT. | Display, backlight or touchscreen is faulty. Display will not turn on. Display Healthy LED is not lit on CDT. | Power cycle CDT. | Check S17, S18, S19 and S22 to determine cause. Replace CDT. | 1 | 0 | 1 | 0 | 0 | 1 | 0 | 0 | 1 | 1 | 0 | 0 | 0 | 0 | 0 | 0 | 0 | 0 | 0
17 | Display backlight burnt out |  |  | 3 | Display backlight bulb burnt out. | Display will not turn on. Display Healthy LED is not lit on CDT. |  | CDT | Power cycle CDT. If condition does not clear, report to maintenance. | Replace CDT if fault persists. | Display backlight bulb burnt out. Display will not turn on. Display Healthy LED is not lit on CDT. | Power cycle CDT. If condition does not clear, report to maintenance. | Replace CDT if fault persists. | 1 | 0 | 1 | 0 | 0 | 1 | 0 | 0 | 1 | 1 | 0 | 0 | 0 | 0 | 0 | 0 | 0 | 0 | 0
18 | Video controller fault |  |  | 3 | Error with video controller. | Display will not turn on. Display Healthy LED is not lit on CDT. |  | CDT | Power cycle CDT. If condition does not clear, report to maintenance. | Replace CDT if fault persists. | Error with video controller. Display will not turn on. Display Healthy LED is not lit on CDT. | Power cycle CDT. If condition does not clear, report to maintenance. | Replace CDT if fault persists. | 1 | 0 | 1 | 0 | 0 | 1 | 0 | 0 | 1 | 1 | 0 | 0 | 0 | 0 | 0 | 0 | 0 | 0 | 0
19 | Touch screen fault |  |  | 3 | Touch screen hardware failure. | Display will not turn on. Display Healthy LED is not lit on CDT. |  | CDT | Power cycle CDT. If condition does not clear, report to maintenance. | Replace CDT if fault persists. | Touch screen hardware failure. Display will not turn on. Display Healthy LED is not lit on CDT. | Power cycle CDT. If condition does not clear, report to maintenance. | Replace CDT if fault persists. | 1 | 0 | 1 | 0 | 0 | 1 | 0 | 0 | 1 | 1 | 0 | 0 | 0 | 0 | 0 | 0 | 0 | 0 | 0
21 | CDT LED Test |  |  | 4 | The button 'LED Test' is pressed on CDT. | All CDT LEDs are lit. | Used with BTE to verify LED Test button |  |  |  | The button 'LED Test' is pressed on CDT. All CDT LEDs are lit. |  |  | 1 | 0 | 0 | 0 | 0 | 1 | 0 | 0 | 0 | 0 | 0 | 0 | 0 | 0 | 0 | 0 | 0 | 0 | 0
22 | Display backlight fault |  |  | 3 | Error with backlight controller. | Display will not turn on. Display Healthy LED is not lit on CDT. |  | CDT | Power cycle CDT. If condition does not clear, report to maintenance. | Replace CDT if fault persists. | Error with backlight controller. Display will not turn on. Display Healthy LED is not lit on CDT. | Power cycle CDT. If condition does not clear, report to maintenance. | Replace CDT if fault persists. | 1 | 0 | 1 | 0 | 0 | 1 | 0 | 0 | 1 | 1 | 0 | 0 | 0 | 0 | 0 | 0 | 0 | 0 | 0
25 | Unconfigured |  |  | 2 | CDT is not programmed with a valid configuration file. | CDT will not monitor car network data or I/O interface. The FDP General Fault LED will be lit and will not turn off when Reset button is pressed. |  | CDT | Report to Maintenance | Load configuration on CDT using PTU. Repeat if necessary. Replace CDT if unsuccessful. | CDT is not programmed with a valid configuration file. CDT will not monitor car network data or I/O interface. The FDP General Fault LED will be lit and will not turn off when Reset button is pressed. | Report to Maintenance | Load configuration on CDT using PTU. Repeat if necessary. Replace CDT if unsuccessful. | 1 | 0 | 1 | 0 | 0 | 1 | 0 | 0 | 1 | 1 | 0 | 0 | 1 | 0 | 0 | 0 | 0 | 0 | 0
26 | Configuring |  |  | 4 | Configuration is being sent to CDT from PTU. | CDT will not monitor car network data or I/O interface during operation. The FDP General Fault LED will be lit and will not turn off when Reset button is pressed. | Condition clears automatically when configuration transfer completed. |  |  |  | Configuration is being sent to CDT from PTU. CDT will not monitor car network data or I/O interface during operation. The FDP General Fault LED will be lit and will not turn off when Reset button is pressed. |  |  | 1 | 0 | 1 | 0 | 0 | 1 | 0 | 0 | 0 | 0 | 0 | 0 | 1 | 0 | 0 | 0 | 0 | 0 | 0
27 | Updating |  |  | 4 | CDT Software update is being performed from the PTU. | CDT will reboot when update is complete and run new software. |  |  |  |  | CDT Software update is being performed from the PTU. CDT will reboot when update is complete and run new software. |  |  | 1 | 0 | 1 | 0 | 0 | 1 | 0 | 0 | 0 | 0 | 0 | 0 | 0 | 0 | 0 | 0 | 0 | 0 | 0
28 | Programming |  |  | 4 | The CDT is sending updated software to a network subsystem from the PTU. | CDT suspends all other car network traffic. | Condition clears automatically when software transfer completed. |  |  |  | The CDT is sending updated software to a network subsystem from the PTU. CDT suspends all other car network traffic. |  |  | 1 | 0 | 1 | 0 | 0 | 1 | 0 | 0 | 0 | 0 | 0 | 0 | 0 | 0 | 0 | 0 | 0 | 0 | 0
29 | BTE Connected |  |  | 4 | CDT is connected to the BTE. | Some CDT functions differ to support BTE testing. |  |  |  |  | CDT is connected to the BTE. Some CDT functions differ to support BTE testing. |  |  | 1 | 0 | 1 | 0 | 0 | 1 | 0 | 0 | 0 | 0 | 0 | 0 | 0 | 0 | 0 | 0 | 0 | 0 | 0
31 | PTU Active |  |  | 4 | CDT is receiving serial communications from PTU or BTE. | Can be used to record when operator accesses CDT through PTU. |  |  |  |  | CDT is receiving serial communications from PTU or BTE. Can be used to record when operator accesses CDT through PTU. |  |  | 1 | 0 | 1 | 0 | 0 | 1 | 0 | 0 | 0 | 1 | 0 | 60 | 0 | 0 | 0 | 0 | 0 | 0 | 0
32 | Screen Saver |  |  | 4 | CDT Screen saver is active. | Can be used to confirm that screen is turned off due to screen saver |  |  |  |  | CDT Screen saver is active. Can be used to confirm that screen is turned off due to screen saver |  |  | 1 | 0 | 0 | 0 | 0 | 1 | 0 | 0 | 0 | 0 | 0 | 0 | 0 | 0 | 0 | 0 | 0 | 0 | 0
33 | GFR Detected |  |  | 4 | The General Fault Reset button on the front of the CDT is being pressed. | Will acknowledge any general fault on the CDT and will cause the CDT to release the General Fault Trainline. | Does not cause the General Fault Reset trainline to be asserted. |  |  |  | The General Fault Reset button on the front of the CDT is being pressed. Will acknowledge any general fault on the CDT and will cause the CDT to release the General Fault Trainline. |  |  | 1 | 0 | 1 | 0 | 0 | 1 | 0 | 0 | 0 | 0 | 0 | 0 | 0 | 0 | 0 | 0 | 0 | 0 | 0
34 | General Fault trainline Asserted |  |  | 4 | The CDT has activated the General Fault Trainline (open circuit). | General Fault LED will blink on FDPs in cabs between this CDT and the active cab. | GFT is asserted when any non-service-affecting fault occurs. Other status bits are used to determine which type of fault. | Depends on actual fault | Look for another active fault causing the GFT activation. | Diagnose fault causing the General Fault trainline activation. If fault persists when no other fault is present, replace the CDT. | The CDT has activated the General Fault Trainline (open circuit). General Fault LED will blink on FDPs in cabs between this CDT and the active cab. | Look for another active fault causing the GFT activation. | Diagnose fault causing the General Fault trainline activation. If fault persists when no other fault is present, replace the CDT. | 1 | 0 | 1 | 0 | 0 | 1 | 0 | 0 | 1 | 1 | 0 | 0 | 0 | 0 | 0 | 0 | 0 | 0 | 0
35 | PROP FT Asserted |  |  | 4 | The CDT has activated the PROP Fault Trainline (pulled low). | Propulsion LED will light on cab's FDP. |  |  | Look for another active fault causing the PROP trainline activation. | Diagnose fault causing the PROP trainline activation. If fault persists when no other fault is present, replace the CDT. | The CDT has activated the PROP Fault Trainline (pulled low). Propulsion LED will light on cab's FDP. | Look for another active fault causing the PROP trainline activation. | Diagnose fault causing the PROP trainline activation. If fault persists when no other fault is present, replace the CDT. | 1 | 0 | 1 | 0 | 0 | 1 | 0 | 0 | 1 | 1 | 0 | 0 | 0 | 0 | 0 | 0 | 0 | 0 | 0
36 | FBCU FT Asserted |  |  | 4 | The CDT has activated the FBCU Fault Trainline (pulled low). | Brake LED will light on cab's FDP. |  |  | Look for another active fault causing the FBCU trainline activation. | Diagnose fault causing the FBCU trainline activation. If fault persists when no other fault is present, replace the CDT. | The CDT has activated the FBCU Fault Trainline (pulled low). Brake LED will light on cab's FDP. | Look for another active fault causing the FBCU trainline activation. | Diagnose fault causing the FBCU trainline activation. If fault persists when no other fault is present, replace the CDT. | 1 | 0 | 1 | 0 | 0 | 1 | 0 | 0 | 1 | 1 | 0 | 0 | 0 | 0 | 0 | 0 | 0 | 0 | 0
37 | APU FT Asserted |  |  | 4 | The CDT has activated the APU Fault Trainline (pulled low). | APU LED will light on cab's FDP. |  |  | Look for another active fault causing the APU trainline activation. | Diagnose fault causing the APU trainline activation. If fault persists when no other fault is present, replace the CDT. | The CDT has activated the APU Fault Trainline (pulled low). APU LED will light on cab's FDP. | Look for another active fault causing the APU trainline activation. | Diagnose fault causing the APU trainline activation. If fault persists when no other fault is present, replace the CDT. | 1 | 0 | 1 | 0 | 0 | 1 | 0 | 0 | 1 | 1 | 0 | 0 | 0 | 0 | 0 | 0 | 0 | 0 | 0
38 | HVAC FT Asserted |  |  | 4 | The CDT has activated the HVAC Fault Trainline (pulled low). | HVAC LED will light on cab's FDP. |  |  | Look for another active fault causing the HVAC trainline activation. | Diagnose fault causing the HVAC trainline activation. If fault persists when no other fault is present, replace the CDT. | The CDT has activated the HVAC Fault Trainline (pulled low). HVAC LED will light on cab's FDP. | Look for another active fault causing the HVAC trainline activation. | Diagnose fault causing the HVAC trainline activation. If fault persists when no other fault is present, replace the CDT. | 1 | 0 | 1 | 0 | 0 | 1 | 0 | 0 | 1 | 1 | 0 | 0 | 0 | 0 | 0 | 0 | 0 | 0 | 0
39 | DOOR FT Asserted |  |  | 4 | The CDT has activated the Fault Trainline #5 (pulled low). | Spare #1 LED will light on cab's FDP. | Not assigned |  | Look for another active fault causing spare fault trainline activation. | Diagnose fault causing the spare trainline activation. If fault persists when no other fault is present, replace the CDT. | The CDT has activated the Fault Trainline #5 (pulled low). Spare #1 LED will light on cab's FDP. | Look for another active fault causing spare fault trainline activation. | Diagnose fault causing the spare trainline activation. If fault persists when no other fault is present, replace the CDT. | 1 | 0 | 1 | 0 | 0 | 1 | 0 | 0 | 1 | 1 | 0 | 0 | 0 | 0 | 0 | 0 | 0 | 0 | 0
40 | FT #6 Asserted |  |  | 4 | The CDT has activated the Fault Trainline #6 (pulled low). | Spare #2 LED will light on cab's FDP. | Not assigned |  | Look for another active fault causing spare fault trainline activation. | Diagnose fault causing the spare trainline activation. If fault persists when no other fault is present, replace the CDT. | The CDT has activated the Fault Trainline #6 (pulled low). Spare #2 LED will light on cab's FDP. | Look for another active fault causing spare fault trainline activation. | Diagnose fault causing the spare trainline activation. If fault persists when no other fault is present, replace the CDT. | 1 | 0 | 1 | 0 | 0 | 1 | 0 | 0 | 1 | 1 | 0 | 0 | 0 | 0 | 0 | 0 | 0 | 0 | 0
41 | GFT LED On |  |  | 4 | The CDT has activated the GFT LED on the front panel of the CDT. | General Fault LED is on. External MDS Fault LED will illuminate also. | General Fault LED is asserted when any non-service-affecting fault occurs. Other status bits are used to determine which type of fault. |  | Look for another active fault causing the GFT activation. | Diagnose fault causing the General Fault trainline activation. If fault persists when no other fault is present, replace the CDT. | The CDT has activated the GFT LED on the front panel of the CDT. General Fault LED is on. External MDS Fault LED will illuminate also. | Look for another active fault causing the GFT activation. | Diagnose fault causing the General Fault trainline activation. If fault persists when no other fault is present, replace the CDT. | 1 | 0 | 0 | 0 | 0 | 0 | 0 | 0 | 0 | 0 | 0 | 0 | 0 | 0 | 0 | 0 | 0 | 0 | 0
42 | RTC Power Loss |  |  | 3 | The CDT was turned off for > 20 days resulting in power loss to the Real-Time Clock. | CDT will have invalid time until set. Time can be set by the COMM system on the train or manually through the PTU. | Can result in CDT log records being recorded with invalid times. | CDT | None | If this fault is persistent then there could be a fault with the CDT RTC circuit. Replace CDT. | The CDT was turned off for > 20 days resulting in power loss to the Real-Time Clock. CDT will have invalid time until set. Time can be set by the COMM system on the train or manually through the PTU. | None | If this fault is persistent then there could be a fault with the CDT RTC circuit. Replace CDT. | 1 | 0 | 1 | 0 | 0 | 1 | 0 | 0 | 1 | 1 | 0 | 0 | 0 | 0 | 0 | 0 | 0 | 0 | 0
44 | Car Location ID |  |  | 4 | Location ID in a Married Pair Car. Set = CAR B, Clr = CAR A. | CDT configures car network addresses based on location. | As read when the CDT was powered up. |  |  |  | Location ID in a Married Pair Car. Set = CAR B, Clr = CAR A. CDT configures car network addresses based on location. |  |  | 1 | 0 | 0 | 0 | 0 | 1 | 0 | 0 | 0 | 0 | 0 | 0 | 0 | 0 | 0 | 0 | 0 | 0 | 0
45 | Spare |  |  | 4 | Spare |  |  |  |  |  | Spare |  |  | 0 | 0 | 0 | 0 | 0 | 0 | 0 | 0 | 0 | 0 | 0 | 0 | 0 | 0 | 0 | 0 | 0 | 0 | 0
46 | Current Car Location ID |  |  | 4 | Location ID in a Married Pair Car. Set = CAR B, Clr = CAR A. | CDT configures car network addresses based on location. | As read in real-time. |  |  |  | Location ID in a Married Pair Car. Set = CAR B, Clr = CAR A. CDT configures car network addresses based on location. |  |  | 1 | 0 | 0 | 0 | 0 | 1 | 0 | 0 | 0 | 0 | 0 | 0 | 0 | 0 | 0 | 0 | 0 | 0 | 0
47 | Spare |  |  | 4 | Spare |  |  |  |  |  | Spare |  |  | 0 | 0 | 0 | 0 | 0 | 0 | 0 | 0 | 0 | 0 | 0 | 0 | 0 | 0 | 0 | 0 | 0 | 0 | 0
48 | PROP Comm Loss |  |  | 2 | Car network communication lost with PROP subsystem. | Car network communications with subsystem is stopped or intermittent. |  | CDT or PROP | Ensure PROP system is turned on | Verify Car Network Wiring between PROP and CDT, if fault persists replace PROP and/or CDT. | Car network communication lost with PROP subsystem. Car network communications with subsystem is stopped or intermittent. | Ensure PROP system is turned on | Verify Car Network Wiring between PROP and CDT, if fault persists replace PROP and/or CDT. | 1 | 0 | 1 | 0 | 0 | 1 | 0 | 0 | 1 | 1 | 0 | 0 | 0 | 1 | 0 | 0 | 0 | 0 | 0
49 | FBCU Comm Loss |  |  | 2 | Car network communication lost with FBCU subsystem. | Car network communications with subsystem is stopped or intermittent. |  | CDT or FBCU | Ensure FBCU system is turned on | Verify Car Network Wiring between FBCU and CDT, if fault persists replace FBCU and/or CDT. | Car network communication lost with FBCU subsystem. Car network communications with subsystem is stopped or intermittent. | Ensure FBCU system is turned on | Verify Car Network Wiring between FBCU and CDT, if fault persists replace FBCU and/or CDT. | 1 | 0 | 1 | 0 | 0 | 1 | 0 | 0 | 1 | 1 | 0 | 0 | 0 | 0 | 1 | 0 | 0 | 0 | 0
50 | COMM Comm Loss |  |  | 2 | Car network communication lost with COMM subsystem. | Car network communications with subsystem is stopped or intermittent. |  | CDT or COMM | Ensure COMM system is turned on | Verify Car Network Wiring between COMM and CDT, if fault persists replace COMM and/or CDT. | Car network communication lost with COMM subsystem. Car network communications with subsystem is stopped or intermittent. | Ensure COMM system is turned on | Verify Car Network Wiring between COMM and CDT, if fault persists replace COMM and/or CDT. | 1 | 0 | 1 | 0 | 0 | 1 | 0 | 0 | 1 | 1 | 0 | 0 | 1 | 0 | 0 | 0 | 0 | 0 | 0
51 | APU Comm Loss |  |  | 2 | Car network communication lost with APU subsystem. | Car network communications with subsystem is stopped or intermittent. |  | CDT or APU | Ensure APU system is turned on | Verify Car Network Wiring between APU and CDT, if fault persists replace APU and/or CDT. | Car network communication lost with APU subsystem. Car network communications with subsystem is stopped or intermittent. | Ensure APU system is turned on | Verify Car Network Wiring between APU and CDT, if fault persists replace APU and/or CDT. | 1 | 0 | 1 | 0 | 0 | 1 | 0 | 0 | 1 | 1 | 0 | 0 | 0 | 0 | 0 | 1 | 0 | 0 | 0
52 | Spare |  |  | 4 |  |  |  |  |  |  |  |  |  | 0 | 0 | 0 | 0 | 0 | 0 | 0 | 0 | 0 | 0 | 0 | 0 | 0 | 0 | 0 | 0 | 0 | 0 | 0
53 | HVAC-A Comm Loss |  |  | 2 | Car network communication lost with HVAC-A subsystem. | Car network communications with subsystem is stopped or intermittent. |  | CDT or HVAC-A | Ensure HVAC-A system is turned on | Verify Car Network Wiring between HVAC-A and CDT, if fault persists replace HVAC-A and/or CDT. | Car network communication lost with HVAC-A subsystem. Car network communications with subsystem is stopped or intermittent. | Ensure HVAC-A system is turned on | Verify Car Network Wiring between HVAC-A and CDT, if fault persists replace HVAC-A and/or CDT. | 1 | 0 | 1 | 0 | 0 | 1 | 0 | 0 | 1 | 1 | 0 | 0 | 0 | 0 | 0 | 0 | 1 | 0 | 0
54 | HVAC-F Comm Loss |  |  | 2 | Car network communication lost with HVAC-F subsystem. | Car network communications with subsystem is stopped or intermittent. |  | CDT or HVAC-F | Ensure HVAC-F system is turned on | Verify Car Network Wiring between HVAC-F and CDT, if fault persists replace HVAC-F and/or CDT. | Car network communication lost with HVAC-F subsystem. Car network communications with subsystem is stopped or intermittent. | Ensure HVAC-F system is turned on | Verify Car Network Wiring between HVAC-F and CDT, if fault persists replace HVAC-F and/or CDT. | 1 | 0 | 1 | 0 | 0 | 1 | 0 | 0 | 1 | 1 | 0 | 0 | 0 | 0 | 0 | 0 | 1 | 0 | 0
55 | CCTV Comm Loss |  |  | 2 | Car network communication lost with CCTV subsystem. | Car network communications with subsystem is stopped or intermittent. |  | CDT or CCTV | Ensure CCTV system is turned on | Verify Car Network Wiring between CCTV and CDT, if fault persists replace CCTV and/or CDT. | Car network communication lost with CCTV subsystem. Car network communications with subsystem is stopped or intermittent. | Ensure CCTV system is turned on | Verify Car Network Wiring between CCTV and CDT, if fault persists replace CCTV and/or CDT. | 1 | 0 | 1 | 0 | 0 | 1 | 0 | 0 | 1 | 1 | 0 | 0 | 1 | 0 | 0 | 0 | 0 | 0 | 0
56 | DCU-R1 Comm Loss |  |  | 2 | Car network communication lost with DCU-R1 subsystem. | Car network communications with subsystem is stopped or intermittent. |  | CDT or DCU-R1 | Ensure DCU-R1 system is turned on | Verify Car Network Wiring between DCU-R1 and CDT, if fault persists replace DCU-R1 and/or the CDT. | Car network communication lost with DCU-R1 subsystem. Car network communications with subsystem is stopped or intermittent. | Ensure DCU-R1 system is turned on | Verify Car Network Wiring between DCU-R1 and CDT, if fault persists replace DCU-R1 and/or the CDT. | 1 | 0 | 1 | 0 | 0 | 1 | 0 | 0 | 1 | 1 | 0 | 0 | 0 | 0 | 0 | 0 | 0 | 1 | 0
57 | DCU-R2 Comm Loss |  |  | 2 | Car network communication lost with DCU-R2 subsystem. | Car network communications with subsystem is stopped or intermittent. |  | CDT or DCU-R2 | Ensure DCU-R2 system is turned on | Verify Car Network Wiring between DCU-R2 and CDT, if fault persists replace DCU-R2 and/or the CDT. | Car network communication lost with DCU-R2 subsystem. Car network communications with subsystem is stopped or intermittent. | Ensure DCU-R2 system is turned on | Verify Car Network Wiring between DCU-R2 and CDT, if fault persists replace DCU-R2 and/or the CDT. | 1 | 0 | 1 | 0 | 0 | 1 | 0 | 0 | 1 | 1 | 0 | 0 | 0 | 0 | 0 | 0 | 0 | 1 | 0
58 | DCU-L2 Comm Loss |  |  | 2 | Car network communication lost with DCU-L2 subsystem. | Car network communications with subsystem is stopped or intermittent. |  | CDT or DCU-L2 | Ensure DCU-L2 system is turned on | Verify Car Network Wiring between DCU-L2 and CDT, if fault persists replace DCU-L2 and/or the CDT. | Car network communication lost with DCU-L2 subsystem. Car network communications with subsystem is stopped or intermittent. | Ensure DCU-L2 system is turned on | Verify Car Network Wiring between DCU-L2 and CDT, if fault persists replace DCU-L2 and/or the CDT. | 1 | 0 | 1 | 0 | 0 | 1 | 0 | 0 | 1 | 1 | 0 | 0 | 0 | 0 | 0 | 0 | 0 | 1 | 0
59 | DCU-L1 Comm Loss |  |  | 2 | Car network communication lost with DCU-L1 subsystem. | Car network communications with subsystem is stopped or intermittent. |  | CDT or DCU-L1 | Ensure DCU-L1 system is turned on | Verify Car Network Wiring between DCU-L1 and CDT, if fault persists replace DCU-L1 and/or the CDT. | Car network communication lost with DCU-L1 subsystem. Car network communications with subsystem is stopped or intermittent. | Ensure DCU-L1 system is turned on | Verify Car Network Wiring between DCU-L1 and CDT, if fault persists replace DCU-L1 and/or the CDT. | 1 | 0 | 1 | 0 | 0 | 1 | 0 | 0 | 1 | 1 | 0 | 0 | 0 | 0 | 0 | 0 | 0 | 1 | 0
60 | Spare |  |  | 4 |  |  |  |  |  |  |  |  |  | 0 | 0 | 0 | 0 | 0 | 0 | 0 | 0 | 0 | 0 | 0 | 0 | 0 | 0 | 0 | 0 | 0 | 0 | 0
61 | Spare |  |  | 4 |  |  |  |  |  |  |  |  |  | 0 | 0 | 0 | 0 | 0 | 0 | 0 | 0 | 0 | 0 | 0 | 0 | 0 | 0 | 0 | 0 | 0 | 0 | 0
64 | PROP Timing Error |  |  | 4 | Network variable received early or late from PROP subsystem. | Minor effect on data timing. |  |  |  | Can indicate network congestion if occuring regularly. | Network variable received early or late from PROP subsystem. Minor effect on data timing. |  | Can indicate network congestion if occuring regularly. | 0 | 0 | 0 | 0 | 0 | 0 | 0 | 0 | 0 | 0 | 0 | 60 | 0 | 0 | 0 | 0 | 0 | 0 | 0
65 | FBCU Timing Error |  |  | 4 | Network variable received early or late from FBCU subsystem. | Minor effect on data timing. |  |  |  | Can indicate network congestion if occuring regularly. | Network variable received early or late from FBCU subsystem. Minor effect on data timing. |  | Can indicate network congestion if occuring regularly. | 0 | 0 | 0 | 0 | 0 | 0 | 0 | 0 | 0 | 0 | 0 | 60 | 0 | 0 | 0 | 0 | 0 | 0 | 0
66 | COMM Timing Error |  |  | 4 | Network variable received early or late from COMM subsystem. | Minor effect on data timing. |  |  |  | Can indicate network congestion if occuring regularly. | Network variable received early or late from COMM subsystem. Minor effect on data timing. |  | Can indicate network congestion if occuring regularly. | 0 | 0 | 0 | 0 | 0 | 0 | 0 | 0 | 0 | 0 | 0 | 60 | 0 | 0 | 0 | 0 | 0 | 0 | 0
67 | APU Timing Error |  |  | 4 | Network variable received early or late from APU subsystem. | Minor effect on data timing. |  |  |  | Can indicate network congestion if occuring regularly. | Network variable received early or late from APU subsystem. Minor effect on data timing. |  | Can indicate network congestion if occuring regularly. | 0 | 0 | 0 | 0 | 0 | 0 | 0 | 0 | 0 | 0 | 0 | 60 | 0 | 0 | 0 | 0 | 0 | 0 | 0
68 | Spare |  |  | 4 |  |  |  |  |  |  |  |  |  | 0 | 0 | 0 | 0 | 0 | 0 | 0 | 0 | 0 | 0 | 0 | 0 | 0 | 0 | 0 | 0 | 0 | 0 | 0
69 | HVAC-A Timing Error |  |  | 4 | Network variable received early or late from HVAC-A subsystem. | Minor effect on data timing. |  |  |  | Can indicate network congestion if occuring regularly. | Network variable received early or late from HVAC-A subsystem. Minor effect on data timing. |  | Can indicate network congestion if occuring regularly. | 0 | 0 | 0 | 0 | 0 | 0 | 0 | 0 | 0 | 0 | 0 | 60 | 0 | 0 | 0 | 0 | 0 | 0 | 0
70 | HVAC-F Timing Error |  |  | 4 | Network variable received early or late from HVAC-F subsystem. | Minor effect on data timing. |  |  |  | Can indicate network congestion if occuring regularly. | Network variable received early or late from HVAC-F subsystem. Minor effect on data timing. |  | Can indicate network congestion if occuring regularly. | 0 | 0 | 0 | 0 | 0 | 0 | 0 | 0 | 0 | 0 | 0 | 60 | 0 | 0 | 0 | 0 | 0 | 0 | 0
71 | CCTV Timing Error |  |  | 4 | Network variable received early or late from CCTV subsystem. | Minor effect on data timing. |  |  |  | Can indicate network congestion if occuring regularly. | Network variable received early or late from CCTV subsystem. Minor effect on data timing. |  | Can indicate network congestion if occuring regularly. | 0 | 0 | 0 | 0 | 0 | 0 | 0 | 0 | 0 | 0 | 0 | 60 | 0 | 0 | 0 | 0 | 0 | 0 | 0
72 | DCU-R1 Timing Error |  |  | 4 | Network variable received early or late from DCU-R1 subsystem. | Minor effect on data timing. |  |  |  | Can indicate network congestion if occuring regularly. | Network variable received early or late from DCU-R1 subsystem. Minor effect on data timing. |  | Can indicate network congestion if occuring regularly. | 0 | 0 | 0 | 0 | 0 | 0 | 0 | 0 | 0 | 0 | 0 | 60 | 0 | 0 | 0 | 0 | 0 | 0 | 0
73 | DCU-R2 Timing Error |  |  | 4 | Network variable received early or late from DCU-R2 subsystem. | Minor effect on data timing. |  |  |  | Can indicate network congestion if occuring regularly. | Network variable received early or late from DCU-R2 subsystem. Minor effect on data timing. |  | Can indicate network congestion if occuring regularly. | 0 | 0 | 0 | 0 | 0 | 0 | 0 | 0 | 0 | 0 | 0 | 60 | 0 | 0 | 0 | 0 | 0 | 0 | 0
74 | DCU-L2 Timing Error |  |  | 4 | Network variable received early or late from DCU-L2 subsystem. | Minor effect on data timing. |  |  |  | Can indicate network congestion if occuring regularly. | Network variable received early or late from DCU-L2 subsystem. Minor effect on data timing. |  | Can indicate network congestion if occuring regularly. | 0 | 0 | 0 | 0 | 0 | 0 | 0 | 0 | 0 | 0 | 0 | 60 | 0 | 0 | 0 | 0 | 0 | 0 | 0
75 | DCU-L1 Timing Error |  |  | 4 | Network variable received early or late from DCU-L1 subsystem. | Minor effect on data timing. |  |  |  | Can indicate network congestion if occuring regularly. | Network variable received early or late from DCU-L1 subsystem. Minor effect on data timing. |  | Can indicate network congestion if occuring regularly. | 0 | 0 | 0 | 0 | 0 | 0 | 0 | 0 | 0 | 0 | 0 | 60 | 0 | 0 | 0 | 0 | 0 | 0 | 0
76 | Spare |  |  | 4 |  |  |  |  |  |  |  |  |  | 0 | 0 | 0 | 0 | 0 | 0 | 0 | 0 | 0 | 0 | 0 | 0 | 0 | 0 | 0 | 0 | 0 | 0 | 0
77 | Spare |  |  | 4 |  |  |  |  |  |  |  |  |  | 0 | 0 | 0 | 0 | 0 | 0 | 0 | 0 | 0 | 0 | 0 | 0 | 0 | 0 | 0 | 0 | 0 | 0 | 0
80 | PROP Status missed or repeated |  |  | 4 | Status variable missed or repeated from PROP subsystem. | One or more data transmissions lost from subystem |  |  |  | Can indicate network congestion if occuring regularly. | Status variable missed or repeated from PROP subsystem. One or more data transmissions lost from subystem |  | Can indicate network congestion if occuring regularly. | 1 | 0 | 1 | 0 | 0 | 1 | 0 | 0 | 0 | 0 | 0 | 60 | 0 | 0 | 0 | 0 | 0 | 0 | 0
81 | FBCU Status missed or repeated |  |  | 4 | Status variable missed or repeated from FBCU subsystem. | One or more data transmissions lost from subystem |  |  |  | Can indicate network congestion if occuring regularly. | Status variable missed or repeated from FBCU subsystem. One or more data transmissions lost from subystem |  | Can indicate network congestion if occuring regularly. | 1 | 0 | 1 | 0 | 0 | 1 | 0 | 0 | 0 | 0 | 0 | 60 | 0 | 0 | 0 | 0 | 0 | 0 | 0
82 | COMM Status missed or repeated |  |  | 4 | Status variable missed or repeated from COMM subsystem. | One or more data transmissions lost from subystem |  |  |  | Can indicate network congestion if occuring regularly. | Status variable missed or repeated from COMM subsystem. One or more data transmissions lost from subystem |  | Can indicate network congestion if occuring regularly. | 1 | 0 | 1 | 0 | 0 | 1 | 0 | 0 | 0 | 0 | 0 | 60 | 0 | 0 | 0 | 0 | 0 | 0 | 0
83 | APU Status missed or repeated |  |  | 4 | Status variable missed or repeated from APU subsystem. | One or more data transmissions lost from subystem |  |  |  | Can indicate network congestion if occuring regularly. | Status variable missed or repeated from APU subsystem. One or more data transmissions lost from subystem |  | Can indicate network congestion if occuring regularly. | 1 | 0 | 1 | 0 | 0 | 1 | 0 | 0 | 0 | 0 | 0 | 60 | 0 | 0 | 0 | 0 | 0 | 0 | 0
84 | Spare |  |  | 4 |  |  |  |  |  |  |  |  |  | 0 | 0 | 0 | 0 | 0 | 0 | 0 | 0 | 0 | 0 | 0 | 0 | 0 | 0 | 0 | 0 | 0 | 0 | 0
85 | HVAC-A Status missed or repeated |  |  | 4 | Status variable missed or repeated from HVAC-A subsystem. | One or more data transmissions lost from subystem |  |  |  | Can indicate network congestion if occuring regularly. | Status variable missed or repeated from HVAC-A subsystem. One or more data transmissions lost from subystem |  | Can indicate network congestion if occuring regularly. | 1 | 0 | 1 | 0 | 0 | 1 | 0 | 0 | 0 | 0 | 0 | 60 | 0 | 0 | 0 | 0 | 0 | 0 | 0
86 | HVAC-F Status missed or repeated |  |  | 4 | Status variable missed or repeated from HVAC-F subsystem. | One or more data transmissions lost from subystem |  |  |  | Can indicate network congestion if occuring regularly. | Status variable missed or repeated from HVAC-F subsystem. One or more data transmissions lost from subystem |  | Can indicate network congestion if occuring regularly. | 1 | 0 | 1 | 0 | 0 | 1 | 0 | 0 | 0 | 0 | 0 | 60 | 0 | 0 | 0 | 0 | 0 | 0 | 0
87 | CCTV Status missed or repeated |  |  | 4 | Status variable missed or repeated from CCTV subsystem. | One or more data transmissions lost from subystem |  |  |  | Can indicate network congestion if occuring regularly. | Status variable missed or repeated from CCTV subsystem. One or more data transmissions lost from subystem |  | Can indicate network congestion if occuring regularly. | 1 | 0 | 1 | 0 | 0 | 1 | 0 | 0 | 0 | 0 | 0 | 60 | 0 | 0 | 0 | 0 | 0 | 0 | 0
88 | DCU-R1 Status missed or repeated |  |  | 4 | Status variable missed or repeated from DCU-R1 subsystem. | One or more data transmissions lost from subystem |  |  |  | Can indicate network congestion if occuring regularly. | Status variable missed or repeated from DCU-R1 subsystem. One or more data transmissions lost from subystem |  | Can indicate network congestion if occuring regularly. | 1 | 0 | 1 | 0 | 0 | 1 | 0 | 0 | 0 | 0 | 0 | 60 | 0 | 0 | 0 | 0 | 0 | 0 | 0
89 | DCU-R2 Status missed or repeated |  |  | 4 | Status variable missed or repeated from DCU-R2 subsystem. | One or more data transmissions lost from subystem |  |  |  | Can indicate network congestion if occuring regularly. | Status variable missed or repeated from DCU-R2 subsystem. One or more data transmissions lost from subystem |  | Can indicate network congestion if occuring regularly. | 1 | 0 | 1 | 0 | 0 | 1 | 0 | 0 | 0 | 0 | 0 | 60 | 0 | 0 | 0 | 0 | 0 | 0 | 0
90 | DCU-L2 Status missed or repeated |  |  | 4 | Status variable missed or repeated from DCU-L2 subsystem. | One or more data transmissions lost from subystem |  |  |  | Can indicate network congestion if occuring regularly. | Status variable missed or repeated from DCU-L2 subsystem. One or more data transmissions lost from subystem |  | Can indicate network congestion if occuring regularly. | 1 | 0 | 1 | 0 | 0 | 1 | 0 | 0 | 0 | 0 | 0 | 60 | 0 | 0 | 0 | 0 | 0 | 0 | 0
91 | DCU-L1 Status missed or repeated |  |  | 4 | Status variable missed or repeated from DCU-L1 subsystem. | One or more data transmissions lost from subystem |  |  |  | Can indicate network congestion if occuring regularly. | Status variable missed or repeated from DCU-L1 subsystem. One or more data transmissions lost from subystem |  | Can indicate network congestion if occuring regularly. | 1 | 0 | 1 | 0 | 0 | 1 | 0 | 0 | 0 | 0 | 0 | 60 | 0 | 0 | 0 | 0 | 0 | 0 | 0
92 | Spare |  |  | 4 |  |  |  |  |  |  |  |  |  | 0 | 0 | 0 | 0 | 0 | 0 | 0 | 0 | 0 | 0 | 0 | 60 | 0 | 0 | 0 | 0 | 0 | 0 | 0
93 | Spare |  |  | 4 |  |  |  |  |  |  |  |  |  | 0 | 0 | 0 | 0 | 0 | 0 | 0 | 0 | 0 | 0 | 0 | 60 | 0 | 0 | 0 | 0 | 0 | 0 | 0
96 | Unknown Parameter |  |  | 4 | CDT received an undefined parameter from another car network subsystem. |  |  |  |  | Can indicate misbehaviour by one or more network subsystems if occuring regularly. | CDT received an undefined parameter from another car network subsystem. |  | Can indicate misbehaviour by one or more network subsystems if occuring regularly. | 1 | 0 | 1 | 0 | 0 | 1 | 0 | 0 | 0 | 0 | 0 | 60 | 0 | 0 | 0 | 0 | 0 | 0 | 0
97 | PROP Stale Parameter |  |  | 3 | Parameter not being received before stale timeout from PROP subsystem. | Parameter updates from subsystem are stopped or intermittent. |  | CDT or PROP | If Communication lost with PROP (S48), this is a normal consequence. Otherwise, report to maintenance. | Can indicate misconfigured CDT. Make sure CDT configuration is appropriate for the current PROP Software. Can also indicate network congestion if occuring regularly. | Parameter not being received before stale timeout from PROP subsystem. Parameter updates from subsystem are stopped or intermittent. | If Communication lost with PROP (S48), this is a normal consequence. Otherwise, report to maintenance. | Can indicate misconfigured CDT. Make sure CDT configuration is appropriate for the current PROP Software. Can also indicate network congestion if occuring regularly. | 1 | 0 | 1 | 0 | 0 | 1 | 0 | 0 | 1 | 1 | 0 | 0 | 0 | 1 | 0 | 0 | 0 | 0 | 0
98 | FBCU Stale Parameter |  |  | 3 | Parameter not being received before stale timeout from FBCU subsystem. | Parameter updates from subsystem are stopped or intermittent. |  | CDT or FBCU | If Communication lost with FBCU (S49), this is a normal consequence. Otherwise, report to maintenance. | Can indicate misconfigured CDT. Make sure CDT configuration is appropriate for the current FBCU Software. Can also indicate network congestion if occuring regularly. | Parameter not being received before stale timeout from FBCU subsystem. Parameter updates from subsystem are stopped or intermittent. | If Communication lost with FBCU (S49), this is a normal consequence. Otherwise, report to maintenance. | Can indicate misconfigured CDT. Make sure CDT configuration is appropriate for the current FBCU Software. Can also indicate network congestion if occuring regularly. | 1 | 0 | 1 | 0 | 0 | 1 | 0 | 0 | 1 | 1 | 0 | 0 | 0 | 0 | 1 | 0 | 0 | 0 | 0
99 | COMM Stale Parameter |  |  | 3 | Parameter not being received before stale timeout from COMM subsystem. | Parameter updates from subsystem are stopped or intermittent. |  | CDT or COMM | If Communication lost with COMM (S50), this is a normal consequence. Otherwise, report to maintenance. | Can indicate misconfigured CDT. Make sure CDT configuration is appropriate for the current COMM Software. Can also indicate network congestion if occuring regularly. | Parameter not being received before stale timeout from COMM subsystem. Parameter updates from subsystem are stopped or intermittent. | If Communication lost with COMM (S50), this is a normal consequence. Otherwise, report to maintenance. | Can indicate misconfigured CDT. Make sure CDT configuration is appropriate for the current COMM Software. Can also indicate network congestion if occuring regularly. | 1 | 0 | 1 | 0 | 0 | 1 | 0 | 0 | 1 | 1 | 0 | 0 | 0 | 0 | 0 | 0 | 0 | 0 | 0
100 | APU Stale Parameter |  |  | 3 | Parameter not being received before stale timeout from APU subsystem. | Parameter updates from subsystem are stopped or intermittent. |  | CDT or APU | If Communication lost with APU (S51), this is a normal consequence. Otherwise, report to maintenance. | Can indicate misconfigured CDT. Make sure CDT configuration is appropriate for the current APU Software. Can also indicate network congestion if occuring regularly. | Parameter not being received before stale timeout from APU subsystem. Parameter updates from subsystem are stopped or intermittent. | If Communication lost with APU (S51), this is a normal consequence. Otherwise, report to maintenance. | Can indicate misconfigured CDT. Make sure CDT configuration is appropriate for the current APU Software. Can also indicate network congestion if occuring regularly. | 1 | 0 | 1 | 0 | 0 | 1 | 0 | 0 | 1 | 1 | 0 | 0 | 0 | 0 | 0 | 1 | 0 | 0 | 0
101 | Spare |  |  | 3 | Parameter not being received before stale timeout from ATC subsystem. | Parameter updates from subsystem are stopped or intermittent. |  | CDT or ATC | If Communication lost with ATC (S52), this is a normal consequence. Otherwise, report to maintenance. | Can indicate misconfigured CDT. Make sure CDT configuration is appropriate for the current ATC Software. Can also indicate network congestion if occuring regularly. | Parameter not being received before stale timeout from ATC subsystem. Parameter updates from subsystem are stopped or intermittent. | If Communication lost with ATC (S52), this is a normal consequence. Otherwise, report to maintenance. | Can indicate misconfigured CDT. Make sure CDT configuration is appropriate for the current ATC Software. Can also indicate network congestion if occuring regularly. | 1 | 0 | 1 | 0 | 0 | 1 | 0 | 0 | 1 | 1 | 0 | 0 | 0 | 0 | 0 | 0 | 0 | 0 | 0
102 | HVAC-A Stale Parameter |  |  | 3 | Parameter not being received before stale timeout from HVAC-A subsystem. | Parameter updates from subsystem are stopped or intermittent. |  | CDT or HVAC-A | If Communication lost with HVAC-A (S53), this is a normal consequence. Otherwise, report to maintenance. | Can indicate misconfigured CDT. Make sure CDT configuration is appropriate for the current HVAC-A Software. Can also indicate network congestion if occuring regularly. | Parameter not being received before stale timeout from HVAC-A subsystem. Parameter updates from subsystem are stopped or intermittent. | If Communication lost with HVAC-A (S53), this is a normal consequence. Otherwise, report to maintenance. | Can indicate misconfigured CDT. Make sure CDT configuration is appropriate for the current HVAC-A Software. Can also indicate network congestion if occuring regularly. | 1 | 0 | 1 | 0 | 0 | 1 | 0 | 0 | 1 | 1 | 0 | 0 | 0 | 0 | 0 | 0 | 1 | 0 | 0
103 | HVAC-F Stale Parameter |  |  | 3 | Parameter not being received before stale timeout from HVAC-F subsystem. | Parameter updates from subsystem are stopped or intermittent. |  | CDT or HVAC-F | If Communication lost with HVAC-F (S54), this is a normal consequence. Otherwise, report to maintenance. | Can indicate misconfigured CDT. Make sure CDT configuration is appropriate for the current HVAC-F Software. Can also indicate network congestion if occuring regularly. | Parameter not being received before stale timeout from HVAC-F subsystem. Parameter updates from subsystem are stopped or intermittent. | If Communication lost with HVAC-F (S54), this is a normal consequence. Otherwise, report to maintenance. | Can indicate misconfigured CDT. Make sure CDT configuration is appropriate for the current HVAC-F Software. Can also indicate network congestion if occuring regularly. | 1 | 0 | 1 | 0 | 0 | 1 | 0 | 0 | 1 | 1 | 0 | 0 | 0 | 0 | 0 | 0 | 1 | 0 | 0
104 | CCTV Stale Parameter |  |  | 3 | Parameter not being received before stale timeout from CCTV subsystem. | Parameter updates from subsystem are stopped or intermittent. |  | CDT or CCTV | If Communication lost with CCTV (S55), this is a normal consequence. Otherwise, report to maintenance. | Can indicate misconfigured CDT. Make sure CDT configuration is appropriate for the current CCTV Software. Can also indicate network congestion if occuring regularly. | Parameter not being received before stale timeout from CCTV subsystem. Parameter updates from subsystem are stopped or intermittent. | If Communication lost with CCTV (S55), this is a normal consequence. Otherwise, report to maintenance. | Can indicate misconfigured CDT. Make sure CDT configuration is appropriate for the current CCTV Software. Can also indicate network congestion if occuring regularly. | 1 | 0 | 1 | 0 | 0 | 1 | 0 | 0 | 1 | 1 | 0 | 0 | 0 | 0 | 0 | 0 | 0 | 0 | 0
105 | DCU-R1 Stale Parameter |  |  | 3 | Parameter not being received before stale timeout from DCU-R1 subsystem. | Parameter updates from subsystem are stopped or intermittent. |  | CDT or DCU-R1 | If Communication lost with DCU-R1 (S56), this is a normal consequence. Otherwise, report to maintenance. | Can indicate misconfigured CDT. Make sure CDT configuration is appropriate for the current DCU-R1 Software. Can also indicate network congestion if occuring regularly. | Parameter not being received before stale timeout from DCU-R1 subsystem. Parameter updates from subsystem are stopped or intermittent. | If Communication lost with DCU-R1 (S56), this is a normal consequence. Otherwise, report to maintenance. | Can indicate misconfigured CDT. Make sure CDT configuration is appropriate for the current DCU-R1 Software. Can also indicate network congestion if occuring regularly. | 1 | 0 | 1 | 0 | 0 | 1 | 0 | 0 | 1 | 1 | 0 | 0 | 0 | 0 | 0 | 0 | 0 | 0 | 0
106 | DCU-R2 Stale Parameter |  |  | 3 | Parameter not being received before stale timeout from DCU-R2 subsystem. | Parameter updates from subsystem are stopped or intermittent. |  | CDT or DCU-R2 | If Communication lost with DCU-R2 (S57), this is a normal consequence. Otherwise, report to maintenance. | Can indicate misconfigured CDT. Make sure CDT configuration is appropriate for the current DCU-R2 Software. Can also indicate network congestion if occuring regularly. | Parameter not being received before stale timeout from DCU-R2 subsystem. Parameter updates from subsystem are stopped or intermittent. | If Communication lost with DCU-R2 (S57), this is a normal consequence. Otherwise, report to maintenance. | Can indicate misconfigured CDT. Make sure CDT configuration is appropriate for the current DCU-R2 Software. Can also indicate network congestion if occuring regularly. | 1 | 0 | 1 | 0 | 0 | 1 | 0 | 0 | 1 | 1 | 0 | 0 | 0 | 0 | 0 | 0 | 0 | 0 | 0
107 | DCU-L2 Stale Parameter |  |  | 3 | Parameter not being received before stale timeout from DCU-L2 subsystem. | Parameter updates from subsystem are stopped or intermittent. |  | CDT or DCU-L2 | If Communication lost with DCU-L2 (S58), this is a normal consequence. Otherwise, report to maintenance. | Can indicate misconfigured CDT. Make sure CDT configuration is appropriate for the current DCU-L2 Software. Can also indicate network congestion if occuring regularly. | Parameter not being received before stale timeout from DCU-L2 subsystem. Parameter updates from subsystem are stopped or intermittent. | If Communication lost with DCU-L2 (S58), this is a normal consequence. Otherwise, report to maintenance. | Can indicate misconfigured CDT. Make sure CDT configuration is appropriate for the current DCU-L2 Software. Can also indicate network congestion if occuring regularly. | 1 | 0 | 1 | 0 | 0 | 1 | 0 | 0 | 1 | 1 | 0 | 0 | 0 | 0 | 0 | 0 | 0 | 0 | 0
108 | DCU-L1 Stale Parameter |  |  | 3 | Parameter not being received before stale timeout from DCU-L1 subsystem. | Parameter updates from subsystem are stopped or intermittent. |  | CDT or DCU-L1 | If Communication lost with DCU-L1 (S59), this is a normal consequence. Otherwise, report to maintenance. | Can indicate misconfigured CDT. Make sure CDT configuration is appropriate for the current DCU-L1 Software. Can also indicate network congestion if occuring regularly. | Parameter not being received before stale timeout from DCU-L1 subsystem. Parameter updates from subsystem are stopped or intermittent. | If Communication lost with DCU-L1 (S59), this is a normal consequence. Otherwise, report to maintenance. | Can indicate misconfigured CDT. Make sure CDT configuration is appropriate for the current DCU-L1 Software. Can also indicate network congestion if occuring regularly. | 1 | 0 | 1 | 0 | 0 | 1 | 0 | 0 | 1 | 1 | 0 | 0 | 0 | 0 | 0 | 0 | 0 | 0 | 0
109 | Spare |  |  | 4 |  |  |  |  |  |  |  |  |  | 0 | 0 | 0 | 0 | 0 | 0 | 0 | 0 | 0 | 0 | 0 | 0 | 0 | 0 | 0 | 0 | 0 | 0 | 0
110 | Spare |  |  | 4 |  |  |  |  |  |  |  |  |  | 0 | 0 | 0 | 0 | 0 | 0 | 0 | 0 | 0 | 0 | 0 | 0 | 0 | 0 | 0 | 0 | 0 | 0 | 0
113 | Network Silenced |  |  | 4 | A software update or log download is occuring over the car network. | Status and parameter data not updated from network subsystems during this time. |  |  |  |  | A software update or log download is occuring over the car network. Status and parameter data not updated from network subsystems during this time. |  |  | 1 | 0 | 1 | 0 | 0 | 1 | 0 | 0 | 0 | 0 | 0 | 0 | 0 | 0 | 0 | 0 | 0 | 0 | 0
114 | Spare |  |  | 4 |  |  |  |  |  |  |  |  |  | 0 | 0 | 0 | 0 | 0 | 0 | 0 | 0 | 0 | 0 | 0 | 0 | 0 | 0 | 0 | 0 | 0 | 0 | 0
115 | PTU requested Network Silence |  |  | 4 | Network has been silenced on command from connected PTU. |  |  |  |  |  | Network has been silenced on command from connected PTU. |  |  | 1 | 0 | 1 | 0 | 0 | 1 | 0 | 0 | 0 | 0 | 0 | 0 | 0 | 0 | 0 | 0 | 0 | 0 | 0
116 | Invalid Time Received |  |  | 2 | COMM System is broadcasting invalid time as current time. | Clock on other subsystems may be set wrong. |  | COMM | Report to Maintenance | Check COMM system's clock | COMM System is broadcasting invalid time as current time. Clock on other subsystems may be set wrong. | Report to Maintenance | Check COMM system's clock | 1 | 0 | 1 | 0 | 0 | 0 | 0 | 0 | 0 | 0 | 0 | 0 | 1 | 0 | 0 | 0 | 0 | 0 | 0
117 | COMM Failed to Reply to Time Request |  |  | 3 | COMM system is not responding to a request for a time broadcast. | CDT will broadcast time over car network when COMM system is not doing it. |  | COMM | Ensure COMM system is turned on | Check COMM network connection. | COMM system is not responding to a request for a time broadcast. CDT will broadcast time over car network when COMM system is not doing it. | Ensure COMM system is turned on | Check COMM network connection. | 1 | 0 | 1 | 0 | 0 | 1 | 0 | 0 | 1 | 1 | 0 | 0 | 0 | 0 | 0 | 0 | 0 | 0 | 0
118 | COMM Failed to Send Periodic Time BC |  |  | 3 | COMM system is not sending time broadcasts periodically. | CDT will broadcast time over car network when COMM system is not doing it. |  | COMM | Ensure COMM system is turned on | Check COMM network connection. | COMM system is not sending time broadcasts periodically. CDT will broadcast time over car network when COMM system is not doing it. | Ensure COMM system is turned on | Check COMM network connection. | 1 | 0 | 1 | 0 | 0 | 1 | 0 | 0 | 1 | 1 | 0 | 0 | 0 | 0 | 0 | 0 | 0 | 0 | 0
119 | Service Button Pressed |  |  | 4 | The CDT Service button is being pressed. | CDT Neuron broadcasts a LonWorks service message. |  |  |  |  | The CDT Service button is being pressed. CDT Neuron broadcasts a LonWorks service message. |  |  | 1 | 0 | 0 | 0 | 0 | 0 | 0 | 0 | 0 | 0 | 0 | 0 | 0 | 0 | 0 | 0 | 0 | 0 | 0
120 | Neuron Reset |  |  | 3 | CDT LonWorks network Neuron has reset. | CDT car network communications is temporarily lost. |  | CDT | Report to Maintenance | If this fault is persistent then there could be a fault with the CDT car network circuit. Replace CDT. | CDT LonWorks network Neuron has reset. CDT car network communications is temporarily lost. | Report to Maintenance | If this fault is persistent then there could be a fault with the CDT car network circuit. Replace CDT. | 1 | 0 | 1 | 0 | 0 | 1 | 0 | 0 | 1 | 1 | 0 | 0 | 1 | 0 | 0 | 0 | 0 | 0 | 0
121 | Invalid Network Variable |  |  | 3 | CDT received an invalid network variable over the car network. | Indicates a software error on one or more car network subsystems. |  | Unknown | Report to Maintenance if fault persists | Diagnose fault by turning on and off other subsystems and see which one makes the fault go away. | CDT received an invalid network variable over the car network. Indicates a software error on one or more car network subsystems. | Report to Maintenance if fault persists | Diagnose fault by turning on and off other subsystems and see which one makes the fault go away. | 1 | 0 | 1 | 0 | 0 | 1 | 0 | 0 | 0 | 0 | 0 | 0 | 0 | 0 | 0 | 0 | 0 | 0 | 0
128 | DM Unhealthy |  |  | 3 | CDT is unhealthy. See S129-S142 for details. | Healthy LED turned OFF. |  | CDT | See S129-S142 for details | See S129-S142 for details | CDT is unhealthy. See S129-S142 for details. Healthy LED turned OFF. | See S129-S142 for details | See S129-S142 for details | 1 | 0 | 1 | 0 | 0 | 1 | 0 | 0 | 1 | 1 | 0 | 0 | 0 | 0 | 0 | 0 | 0 | 0 | 0
129 | DM Unhealthy - Test |  |  | 4 | Only set during CDT tests. |  |  |  |  |  | Only set during CDT tests. |  |  | 1 | 0 | 0 | 0 | 0 | 1 | 0 | 0 | 0 | 0 | 0 | 0 | 0 | 0 | 0 | 0 | 0 | 0 | 0
130 | DM Unhealthy - WDT Failure |  |  | 3 | CDT watch dog timer failed. | CDT is not protected by software watchdog. |  | CDT | Report to Maintenance | Replace CDT if this fault persists. | CDT watch dog timer failed. CDT is not protected by software watchdog. | Report to Maintenance | Replace CDT if this fault persists. | 1 | 0 | 1 | 0 | 0 | 1 | 0 | 0 | 0 | 0 | 0 | 0 | 0 | 0 | 0 | 0 | 0 | 0 | 0
132 | DM Unhealthy - NVR Failure |  |  | 3 | CDT Non-Volatile RAM is corrupted. | One or more non-critical functions may be impaired such as screen calibration, car number ID and wayside transfer information. |  | CDT | Report to Maintenance | Replace CDT if this fault persists. | CDT Non-Volatile RAM is corrupted. One or more non-critical functions may be impaired such as screen calibration, car number ID and wayside transfer information. | Report to Maintenance | Replace CDT if this fault persists. | 1 | 0 | 1 | 0 | 0 | 1 | 0 | 0 | 1 | 1 | 0 | 0 | 0 | 0 | 0 | 0 | 0 | 0 | 0
133 | DM Unhealthy - High Temperature |  |  | 2 | CDT temperature is too high. Probably due to external temperature too high. | CDT hardware failure may occur. |  | CDT | If maintenance locker is hot, attempt to ventilate. | Replace CDT if this fault persists. | CDT temperature is too high. Probably due to external temperature too high. CDT hardware failure may occur. | If maintenance locker is hot, attempt to ventilate. | Replace CDT if this fault persists. | 1 | 0 | 1 | 0 | 0 | 1 | 0 | 0 | 1 | 1 | 0 | 0 | 0 | 0 | 0 | 0 | 0 | 0 | 0
134 | DM Unhealthy - Log Failure |  |  | 2 | CDT log is corrupted. | CDT may not be logging data correctly. |  | CDT | Report to Maintenance | Replace CDT if this fault persists. | CDT log is corrupted. CDT may not be logging data correctly. | Report to Maintenance | Replace CDT if this fault persists. | 1 | 0 | 1 | 0 | 0 | 1 | 0 | 0 | 1 | 1 | 0 | 0 | 1 | 0 | 0 | 0 | 0 | 0 | 0
135 | DM Unhealthy - Unconfigured |  |  | 2 | The CDT is not loaded with a configuration file or configuration may be corrupted. | CDT is not logging or reporting data from car network subsystems. |  | CDT | Report to Maintenance | Reload configuration on CDT from PTU. Replace CDT if this fault persists. | The CDT is not loaded with a configuration file or configuration may be corrupted. CDT is not logging or reporting data from car network subsystems. | Report to Maintenance | Reload configuration on CDT from PTU. Replace CDT if this fault persists. | 1 | 0 | 1 | 0 | 0 | 1 | 0 | 0 | 1 | 1 | 0 | 0 | 1 | 0 | 0 | 0 | 0 | 0 | 0
136 | DM Unhealthy - RTC Failure |  |  | 2 | CDT real-time clock has failed. | CDT time will be invalid on startup until set from the COMM system or through the PTU. | Can result in CDT log records being recorded with invalid times. | CDT | Report to Maintenance | Replace CDT if fault persists. | CDT real-time clock has failed. CDT time will be invalid on startup until set from the COMM system or through the PTU. | Report to Maintenance | Replace CDT if fault persists. | 1 | 0 | 1 | 0 | 0 | 1 | 0 | 0 | 1 | 1 | 0 | 0 | 1 | 0 | 0 | 0 | 0 | 0 | 0
137 | DM Unhealthy - Neuron |  |  | 2 | Fault with Neuron processor. | CDT is not communicating with car network subsystems. |  | CDT | Report to Maintenance | Replace CDT if fault persists. | Fault with Neuron processor. CDT is not communicating with car network subsystems. | Report to Maintenance | Replace CDT if fault persists. | 1 | 0 | 1 | 0 | 0 | 1 | 0 | 0 | 1 | 1 | 0 | 0 | 1 | 0 | 0 | 0 | 0 | 0 | 0
138 | DM Unhealthy - CAN Bus |  |  | 2 | Backplane CAN Bus communications error. | CDT is not communicating with IOM's. Discrete I/O disabled. |  | CDT | Report to Maintenance | Replace CDT if fault persists. | Backplane CAN Bus communications error. CDT is not communicating with IOM's. Discrete I/O disabled. | Report to Maintenance | Replace CDT if fault persists. | 1 | 0 | 1 | 0 | 0 | 1 | 0 | 0 | 1 | 1 | 0 | 0 | 1 | 0 | 0 | 0 | 0 | 0 | 0
139 | DM Unhealthy - Power |  |  | 2 | CDT internal power supply fault. High current or high temperature. | CDT internal power supplies not working correctly. |  | CDT | Report to Maintenance | Replace CDT if fault persists. | CDT internal power supply fault. High current or high temperature. CDT internal power supplies not working correctly. | Report to Maintenance | Replace CDT if fault persists. | 1 | 0 | 1 | 0 | 0 | 1 | 0 | 0 | 1 | 1 | 0 | 0 | 1 | 0 | 0 | 0 | 0 | 0 | 0
140 | DM Unhealthy - Power Shutdown |  |  | 2 | CDT internal power supply shutdown failure. | CDT internal power supplies not working correctly. |  | CDT | Report to Maintenance | Replace CDT if fault persists. | CDT internal power supply shutdown failure. CDT internal power supplies not working correctly. | Report to Maintenance | Replace CDT if fault persists. | 1 | 0 | 1 | 0 | 0 | 1 | 0 | 0 | 1 | 1 | 0 | 0 | 1 | 0 | 0 | 0 | 0 | 0 | 0
141 | DM Unhealthy - Missed Heartbeat |  |  | 2 | Backplane CAN Bus communications error. | CDT is not communicating with IOM's. Discrete I/O disabled. |  | CDT | Report to Maintenance | Replace CDT if fault persists. | Backplane CAN Bus communications error. CDT is not communicating with IOM's. Discrete I/O disabled. | Report to Maintenance | Replace CDT if fault persists. | 1 | 0 | 1 | 0 | 0 | 1 | 0 | 0 | 1 | 1 | 0 | 0 | 1 | 0 | 0 | 0 | 0 | 0 | 0
142 | DM Unhealthy - Display Fail |  |  | 3 | CDT display has failed. Check CDT S16 to S20 for more info. | Operator may not be able to access CDT through its display. |  | CDT | Report to Maintenance | Use PTU to interact with CDT. Replace CDT if this fault persists. | CDT display has failed. Check CDT S16 to S20 for more info. Operator may not be able to access CDT through its display. | Report to Maintenance | Use PTU to interact with CDT. Replace CDT if this fault persists. | 1 | 0 | 1 | 0 | 0 | 1 | 0 | 0 | 1 | 1 | 0 | 0 | 0 | 0 | 0 | 0 | 0 | 0 | 0
144 | Log 75% Full |  |  | 4 | CDT Log is >75% full. |  |  |  |  |  | CDT Log is >75% full. |  |  | 1 | 0 | 0 | 0 | 0 | 1 | 0 | 0 | 0 | 0 | 0 | 0 | 0 | 0 | 0 | 0 | 0 | 0 | 0
145 | Log 99% Full |  |  | 4 | CDT Log is >99% full. This status is clear each time the log overwrites a sector of data and then is set again when that sector is almost full. | Older data is lost on log overwrite. |  |  |  |  | CDT Log is >99% full. This status is clear each time the log overwrites a sector of data and then is set again when that sector is almost full. Older data is lost on log overwrite. |  |  | 1 | 0 | 0 | 0 | 0 | 1 | 0 | 0 | 0 | 0 | 0 | 0 | 0 | 0 | 0 | 0 | 0 | 0 | 0
146 | Log Time Error |  |  | 4 | Time is set backwards in the log more than 16 times. | Only affects search function. Log is not corrupted. |  | COMM or CDT |  | Make sure COMM system broadcast proper time consistantly | Time is set backwards in the log more than 16 times. Only affects search function. Log is not corrupted. |  | Make sure COMM system broadcast proper time consistantly | 1 | 0 | 0 | 0 | 0 | 1 | 0 | 0 | 0 | 0 | 0 | 0 | 0 | 0 | 0 | 0 | 0 | 0 | 0
147 | Log Initialization Error |  |  | 3 | Log was found corrupted when CDT initialized. | CDT log data may be lost. |  | CDT | Report to Maintenance | Replace CDT if fault persists. | Log was found corrupted when CDT initialized. CDT log data may be lost. | Report to Maintenance | Replace CDT if fault persists. | 1 | 0 | 1 | 0 | 0 | 1 | 0 | 0 | 1 | 1 | 0 | 0 | 0 | 0 | 0 | 0 | 0 | 0 | 0
148 | Log Write Error |  |  | 3 | Error writing data to log. | CDT log data may be lost. |  | CDT | Report to Maintenance | Replace CDT if fault persists. | Error writing data to log. CDT log data may be lost. | Report to Maintenance | Replace CDT if fault persists. | 1 | 0 | 1 | 0 | 0 | 1 | 0 | 0 | 1 | 1 | 0 | 0 | 0 | 0 | 0 | 0 | 0 | 0 | 0
149 | Log Read Error |  |  | 3 | Error reading data from log. | CDT log data may be lost. |  | CDT | Report to Maintenance | Replace CDT if fault persists. | Error reading data from log. CDT log data may be lost. | Report to Maintenance | Replace CDT if fault persists. | 1 | 0 | 1 | 0 | 0 | 1 | 0 | 0 | 1 | 1 | 0 | 0 | 0 | 0 | 0 | 0 | 0 | 0 | 0
150 | Log Overrun Error |  |  | 3 | Log data generated too fast. Data lost due to overrun. | CDT log data may be lost. |  | CDT | Report to Maintenance | Replace CDT if fault persists. | Log data generated too fast. Data lost due to overrun. CDT log data may be lost. | Report to Maintenance | Replace CDT if fault persists. | 1 | 0 | 1 | 0 | 0 | 1 | 0 | 0 | 1 | 1 | 0 | 0 | 0 | 0 | 0 | 0 | 0 | 0 | 0
151 | Log Erased |  |  | 4 | The CDT log has been erased by command from the PTU. | All CDT log data lost. |  |  |  |  | The CDT log has been erased by command from the PTU. All CDT log data lost. |  |  | 1 | 0 | 0 | 0 | 0 | 1 | 0 | 0 | 0 | 0 | 0 | 0 | 0 | 0 | 0 | 0 | 0 | 0 | 0
152 | Log Flash Error |  |  | 3 | Timeout error writing to CDT Log flash memory. | CDT log data may be lost. |  | CDT | Report to Maintenance | Replace CDT if fault persists. | Timeout error writing to CDT Log flash memory. CDT log data may be lost. | Report to Maintenance | Replace CDT if fault persists. | 1 | 0 | 1 | 0 | 0 | 1 | 0 | 0 | 1 | 1 | 0 | 0 | 0 | 0 | 0 | 0 | 0 | 0 | 0
157 | Temperature Log Error |  |  | 3 | Extreme temperature log stored in NVR is corrupted. | Extreme temperature data lost. |  | CDT | Report to Maintenance | Replace CDT if fault persists. | Extreme temperature log stored in NVR is corrupted. Extreme temperature data lost. | Report to Maintenance | Replace CDT if fault persists. | 1 | 0 | 1 | 0 | 0 | 1 | 0 | 0 | 1 | 1 | 0 | 0 | 0 | 0 | 0 | 0 | 0 | 0 | 0
158 | NVR Read Error |  |  | 3 | Error reading from NVR. | NVR data may be lost. |  | CDT | Report to Maintenance | Replace CDT if fault persists. | Error reading from NVR. NVR data may be lost. | Report to Maintenance | Replace CDT if fault persists. | 1 | 0 | 1 | 0 | 0 | 1 | 0 | 0 | 1 | 1 | 0 | 0 | 0 | 0 | 0 | 0 | 0 | 0 | 0
159 | NVR Write Error |  |  | 3 | Error writing to NVR. | NVR data may be lost. |  | CDT | Report to Maintenance | Replace CDT if fault persists. | Error writing to NVR. NVR data may be lost. | Report to Maintenance | Replace CDT if fault persists. | 1 | 0 | 1 | 0 | 0 | 1 | 0 | 0 | 1 | 1 | 0 | 0 | 0 | 0 | 0 | 0 | 0 | 0 | 0
160 | Alternate Logging |  |  | 4 | Alternate logging (as selected from the CDT display) is on. | CDT will log data using alternate logging configuration attributes. |  |  |  |  | Alternate logging (as selected from the CDT display) is on. CDT will log data using alternate logging configuration attributes. |  |  | 1 | 0 | 1 | 0 | 0 | 1 | 0 | 0 | 1 | 1 | 0 | 0 | 0 | 0 | 0 | 0 | 0 | 0 | 0
163 | Bad Equation |  |  | 3 | One or more equations in the configuration are invalid. | Some equation data will not be evaluated correctly. |  | CDT | Report to Maintenance | Reload configuration on CDT from PTU. Replace CDT if this fault persists. | One or more equations in the configuration are invalid. Some equation data will not be evaluated correctly. | Report to Maintenance | Reload configuration on CDT from PTU. Replace CDT if this fault persists. | 1 | 0 | 1 | 0 | 0 | 1 | 0 | 0 | 1 | 1 | 0 | 0 | 0 | 0 | 0 | 0 | 0 | 0 | 0
164 | IOM #1 Process Data is Stale |  |  | 2 | When this value is Set the process data coming from IOM #1 is not being updated. | CCM is not communicating with IOM1. Discrete I/O may be disabled. |  | CDT | Report to Maintenance | Replace CDT if fault persists. | When this value is Set the process data coming from IOM #1 is not being updated. CCM is not communicating with IOM1. Discrete I/O may be disabled. | Report to Maintenance | Replace CDT if fault persists. | 1 | 0 | 1 | 0 | 0 | 1 | 0 | 0 | 1 | 1 | 0 | 0 | 1 | 0 | 0 | 0 | 0 | 0 | 0
165 | IOM #1 MDN Data is Stale |  |  | 2 | When this value is Set the MDN data coming from IOM #1 is not being updated. | CCM is not communicating with IOM1. Discrete I/O may be disabled. |  | CDT | Report to Maintenance | Replace CDT if fault persists. | When this value is Set the MDN data coming from IOM #1 is not being updated. CCM is not communicating with IOM1. Discrete I/O may be disabled. | Report to Maintenance | Replace CDT if fault persists. | 1 | 0 | 1 | 0 | 0 | 1 | 0 | 0 | 1 | 1 | 0 | 0 | 1 | 0 | 0 | 0 | 0 | 0 | 0
166 | IOM #2 Process Data is Stale |  |  | 2 | When this value is Set the process data coming from IOM #2 is not being updated. | CCM is not communicating with IOM2. Discrete I/O may be disabled. |  | CDT | Report to Maintenance | Replace CDT if fault persists. | When this value is Set the process data coming from IOM #2 is not being updated. CCM is not communicating with IOM2. Discrete I/O may be disabled. | Report to Maintenance | Replace CDT if fault persists. | 1 | 0 | 1 | 0 | 0 | 1 | 0 | 0 | 1 | 1 | 0 | 0 | 1 | 0 | 0 | 0 | 0 | 0 | 0
167 | IOM #2 MDN Data is Stale |  |  | 2 | When this value is Set the MDN data coming from IOM #2 is not being updated. | CCM is not communicating with IOM2. Discrete I/O may be disabled. |  | CDT | Report to Maintenance | Replace CDT if fault persists. | When this value is Set the MDN data coming from IOM #2 is not being updated. CCM is not communicating with IOM2. Discrete I/O may be disabled. | Report to Maintenance | Replace CDT if fault persists. | 1 | 0 | 1 | 0 | 0 | 1 | 0 | 0 | 1 | 1 | 0 | 0 | 1 | 0 | 0 | 0 | 0 | 0 | 0
168 | IOM #1 Unhealthy |  |  | 2 | IOM #1 is unhealthy. See S169-S176 for details. | Healthy LED turned OFF. | I/O Modules #1 is unhealthy | CDT | See S169-S176 for details | See S169-S176 for details | IOM #1 is unhealthy. See S169-S176 for details. Healthy LED turned OFF. | See S169-S176 for details | See S169-S176 for details | 1 | 0 | 1 | 0 | 0 | 1 | 0 | 0 | 0 | 0 | 0 | 0 | 0 | 0 | 0 | 0 | 0 | 0 | 0
169 | IOM #1 Unhealthy - Test |  |  | 2 | Only set during CDT tests. |  | A test fault has been set by the BTE on IOM #1 | CDT | Call maintenance for PTU. | Use CDT-PTU software to clean this status. | Only set during CDT tests. | Call maintenance for PTU. | Use CDT-PTU software to clean this status. | 1 | 0 | 1 | 0 | 0 | 1 | 0 | 0 | 0 | 0 | 0 | 0 | 0 | 0 | 0 | 0 | 0 | 0 | 0
170 | IOM #1 Unhealthy - WDT |  |  | 2 | Watchdog timer on IOM#1 did not pass boot-up tests. | If an error occurs within the CDT cause a software error the CDT will not be reset automatically. | The watchdog timer expired on IOM #1 | CDT | Report to Maintenance | Replace CDT if fault persists. | Watchdog timer on IOM#1 did not pass boot-up tests. If an error occurs within the CDT cause a software error the CDT will not be reset automatically. | Report to Maintenance | Replace CDT if fault persists. | 1 | 0 | 1 | 0 | 0 | 1 | 0 | 0 | 0 | 0 | 0 | 0 | 0 | 0 | 0 | 0 | 0 | 0 | 0
172 | IOM #1 Unhealthy - NVR |  |  | 2 | Non-volatile RAM could not be written to. | Control output calibration may be corrupt. | NVR failed on IOM #1 | CDT | Report to Maintenance | Replace CDT if fault persists. | Non-volatile RAM could not be written to. Control output calibration may be corrupt. | Report to Maintenance | Replace CDT if fault persists. | 1 | 0 | 1 | 0 | 0 | 1 | 0 | 0 | 0 | 0 | 0 | 0 | 0 | 0 | 0 | 0 | 0 | 0 | 0
173 | IOM #1 Unhealthy - High Temp |  |  | 2 | A temperature sensor on IOM #1 is reading higher then acceptable values. | Output wetting current is disabled and outputs are turned off. | The temperature is too high on IOM #1 | CDT | If maintenance locker is hot, attempt to ventilate. | Replace CDT if fault persists. | A temperature sensor on IOM #1 is reading higher then acceptable values. Output wetting current is disabled and outputs are turned off. | If maintenance locker is hot, attempt to ventilate. | Replace CDT if fault persists. | 1 | 0 | 1 | 0 | 0 | 1 | 0 | 0 | 0 | 0 | 0 | 0 | 0 | 0 | 0 | 0 | 0 | 0 | 0
174 | IOM #1 Unhealthy - Input Fault |  |  | 2 | One or more of the input banks have detected a fault. | Inputs on this module are not reporting properly. | There is a fault on one or more discrete inputs on IOM #1 | CDT | Report to Maintenance | Replace CDT if fault persists. | One or more of the input banks have detected a fault. Inputs on this module are not reporting properly. | Report to Maintenance | Replace CDT if fault persists. | 1 | 0 | 1 | 0 | 0 | 1 | 0 | 0 | 0 | 0 | 0 | 0 | 1 | 0 | 0 | 0 | 0 | 0 | 0
175 | IOM #1 Unhealthy - Output Fault |  |  | 2 | One or more outputs on this module have detected a fault. | An output on this module is not reporting properly. | There is a fault on one or more control outputs on IOM #1 | CDT | Report to Maintenance | Replace CDT if fault persists. | One or more outputs on this module have detected a fault. An output on this module is not reporting properly. | Report to Maintenance | Replace CDT if fault persists. | 1 | 0 | 1 | 0 | 0 | 1 | 0 | 0 | 0 | 0 | 0 | 0 | 1 | 0 | 0 | 0 | 0 | 0 | 0
176 | IOM #1 Unhealthy - CAN Fault |  |  | 2 | Fault being reported from CAN bus. | Communication between the IOMs and the CCM either not working or is sporadic. | There is a CAN bus failure on IOM #1 | CDT | Report to Maintenance | Replace CDT if fault persists. | Fault being reported from CAN bus. Communication between the IOMs and the CCM either not working or is sporadic. | Report to Maintenance | Replace CDT if fault persists. | 1 | 0 | 1 | 0 | 0 | 1 | 0 | 0 | 0 | 0 | 0 | 0 | 1 | 0 | 0 | 0 | 0 | 0 | 0
177 | IOM #1 Control Output High Temperature |  |  | 2 | An output temperature sensor is reading higher then acceptable values. | Output wetting current is disabled and outputs are turned off. | Control outputs on IOM #1 have been shut down due to high temperature. | CDT | Report to Maintenance | Replace CDT if fault persists. | An output temperature sensor is reading higher then acceptable values. Output wetting current is disabled and outputs are turned off. | Report to Maintenance | Replace CDT if fault persists. | 1 | 0 | 1 | 0 | 0 | 1 | 0 | 0 | 0 | 0 | 0 | 0 | 0 | 0 | 0 | 0 | 0 | 0 | 0
178 | IOM #1 BTE Connected |  |  | 4 | IOM#1 is reporting that CDT is currently connected to the Bench Test Equipment. | Fault statuses are not cleared automatically but can only be cleared manually. |  | None |  |  | IOM#1 is reporting that CDT is currently connected to the Bench Test Equipment. Fault statuses are not cleared automatically but can only be cleared manually. |  |  | 1 | 0 | 0 | 0 | 0 | 1 | 0 | 0 | 0 | 0 | 0 | 0 | 0 | 0 | 0 | 0 | 0 | 0 | 0
179 | IOM #1 Control Output Timeout |  |  | 3 | Control Output update from the CCM was not received by expected time. | All Control outputs will be turned off until an update from the CCM arrives. | A control output has timed out on IOM #1 | CDT | Report to Maintenance | Replace CDT if fault persists. | Control Output update from the CCM was not received by expected time. All Control outputs will be turned off until an update from the CCM arrives. | Report to Maintenance | Replace CDT if fault persists. | 1 | 0 | 1 | 0 | 0 | 1 | 0 | 0 | 0 | 0 | 0 | 0 | 0 | 0 | 0 | 0 | 0 | 0 | 0
180 | IOM #1 Control Output Uncalibrated |  |  | 3 | Calibration of the Control Outputs has not been done or have been corrupted. | Current measurements of the control outputs will not be in Amps. | The current feedback on an IOM #1 control output is uncalibrated. | CDT | Report to Maintenance | Replace CDT if fault persists. | Calibration of the Control Outputs has not been done or have been corrupted. Current measurements of the control outputs will not be in Amps. | Report to Maintenance | Replace CDT if fault persists. | 1 | 0 | 1 | 0 | 0 | 1 | 0 | 0 | 0 | 0 | 0 | 0 | 0 | 0 | 0 | 0 | 0 | 0 | 0
181 | IOM #1 Reset |  |  | 4 | This module was reset recently. |  | Set momentarily each time IOM #1 resets. | None |  |  | This module was reset recently. |  |  | 1 | 0 | 0 | 0 | 0 | 1 | 0 | 0 | 0 | 0 | 0 | 30 | 0 | 0 | 0 | 0 | 0 | 0 | 0
182 | IOM #1 WDT Timeout |  |  | 3 | A Watchdog timeout on IOM#1 was the cause of the last reset. | No effect on normal behaviour but the IOM was in an inappropriate state before reset. | IOM #1 reset due to a watchdog timeout | CDT | Report to Maintenance | Replace CDT if fault persists. | A Watchdog timeout on IOM#1 was the cause of the last reset. No effect on normal behaviour but the IOM was in an inappropriate state before reset. | Report to Maintenance | Replace CDT if fault persists. | 1 | 0 | 1 | 0 | 0 | 1 | 0 | 0 | 0 | 0 | 0 | 0 | 0 | 0 | 0 | 0 | 0 | 0 | 0
183 | IOM #1 wetting current disabled |  |  | 3 | Temperature of the IOM is too hot. | Wetting current operation have been suspended. | The discrete input wetting current loads on IOM #1 are disabled due to high temperature. | CDT | Report to Maintenance | Replace CDT if fault persists. | Temperature of the IOM is too hot. Wetting current operation have been suspended. | Report to Maintenance | Replace CDT if fault persists. | 1 | 0 | 1 | 0 | 0 | 1 | 0 | 0 | 0 | 0 | 0 | 0 | 0 | 0 | 0 | 0 | 0 | 0 | 0
192 | Output Failure - IOM #1 OP#1 |  |  | 2 | Fault has been detected in Output #1. | This output in not responding to controller commands. | A hardware fault is detected on IOM #1 Fault Trainline - General A (control output #1) | CDT | Report to Maintenance | Replace CDT if fault persists. | Fault has been detected in Output #1. This output in not responding to controller commands. | Report to Maintenance | Replace CDT if fault persists. | 1 | 0 | 1 | 0 | 0 | 1 | 0 | 0 | 0 | 0 | 0 | 0 | 1 | 0 | 0 | 0 | 0 | 0 | 0
193 | Output Failure - IOM #1 OP#2 |  |  | 2 | Fault has been detected in Output #2. | This output in not responding to controller commands. | A hardware fault is detected on IOM #1 Fault Trainline - General B (control output #2) | CDT | Report to Maintenance | Replace CDT if fault persists. | Fault has been detected in Output #2. This output in not responding to controller commands. | Report to Maintenance | Replace CDT if fault persists. | 1 | 0 | 1 | 0 | 0 | 1 | 0 | 0 | 0 | 0 | 0 | 0 | 1 | 0 | 0 | 0 | 0 | 0 | 0
194 | Output Failure - IOM #1 OP#3 |  |  | 2 | Fault has been detected in Output #3. | This output in not responding to controller commands. | A hardware fault is detected on IOM #1 Fault Trainline - Propulsion (control output #3) | CDT | Report to Maintenance | Replace CDT if fault persists. | Fault has been detected in Output #3. This output in not responding to controller commands. | Report to Maintenance | Replace CDT if fault persists. | 1 | 0 | 1 | 0 | 0 | 1 | 0 | 0 | 0 | 0 | 0 | 0 | 1 | 0 | 0 | 0 | 0 | 0 | 0
195 | Output Failure - IOM #1 OP#4 |  |  | 2 | Fault has been detected in Output #4. | This output in not responding to controller commands. | A hardware fault is detected on IOM #1 Fault Trainline - Brake (control output #4) | CDT | Report to Maintenance | Replace CDT if fault persists. | Fault has been detected in Output #4. This output in not responding to controller commands. | Report to Maintenance | Replace CDT if fault persists. | 1 | 0 | 1 | 0 | 0 | 1 | 0 | 0 | 0 | 0 | 0 | 0 | 1 | 0 | 0 | 0 | 0 | 0 | 0
196 | Output Failure - IOM #1 OP#5 |  |  | 2 | Fault has been detected in Output #5. | This output in not responding to controller commands. | A hardware fault is detected on IOM #1 Fault Trainline - APU (control output #5) | CDT | Report to Maintenance | Replace CDT if fault persists. | Fault has been detected in Output #5. This output in not responding to controller commands. | Report to Maintenance | Replace CDT if fault persists. | 1 | 0 | 1 | 0 | 0 | 1 | 0 | 0 | 0 | 0 | 0 | 0 | 1 | 0 | 0 | 0 | 0 | 0 | 0
197 | Output Failure - IOM #1 OP#6 |  |  | 2 | Fault has been detected in Output #6 | This output in not responding to controller commands. | A hardware fault is detected on IOM #1 Fault Trainline - HVAC (control output #6) | CDT | Report to Maintenance | Replace CDT if fault persists. | Fault has been detected in Output #6 This output in not responding to controller commands. | Report to Maintenance | Replace CDT if fault persists. | 1 | 0 | 1 | 0 | 0 | 1 | 0 | 0 | 0 | 0 | 0 | 0 | 1 | 0 | 0 | 0 | 0 | 0 | 0
198 | Output Failure - IOM #1 OP#7 |  |  | 2 | Fault has been detected in Output #7. | This output in not responding to controller commands. | A hardware fault is detected on IOM #1 Fault Trainline - Spare1 (control output #7) | CDT | Report to Maintenance | Replace CDT if fault persists. | Fault has been detected in Output #7. This output in not responding to controller commands. | Report to Maintenance | Replace CDT if fault persists. | 1 | 0 | 1 | 0 | 0 | 1 | 0 | 0 | 0 | 0 | 0 | 0 | 1 | 0 | 0 | 0 | 0 | 0 | 0
199 | Output Failure - IOM #1 OP#8 |  |  | 2 | Fault has been detected in Output #8. | This output in not responding to controller commands. | A hardware fault is detected on IOM #1 Fault Trainline - Spare2 (control output #8) | CDT | Report to Maintenance | Replace CDT if fault persists. | Fault has been detected in Output #8. This output in not responding to controller commands. | Report to Maintenance | Replace CDT if fault persists. | 1 | 0 | 1 | 0 | 0 | 1 | 0 | 0 | 0 | 0 | 0 | 0 | 1 | 0 | 0 | 0 | 0 | 0 | 0
200 | Output Failure - IOM #1 OP#9 |  |  | 2 | Fault has been detected in Output #9. | This output in not responding to controller commands. | A hardware fault is detected on IOM #1 Spare Fault Trainline Control (control output #9) | CDT | Report to Maintenance | Replace CDT if fault persists. | Fault has been detected in Output #9. This output in not responding to controller commands. | Report to Maintenance | Replace CDT if fault persists. | 1 | 0 | 1 | 0 | 0 | 1 | 0 | 0 | 0 | 0 | 0 | 0 | 1 | 0 | 0 | 0 | 0 | 0 | 0
201 | Fault Trainline - General A |  |  | 4 | General Fault Trainline has been asserted. | LED indicators on FDP are illuminated. | IOM #1 has turned on Fault Trainline-General (control output #1) | None |  |  | General Fault Trainline has been asserted. LED indicators on FDP are illuminated. |  |  | 1 | 0 | 0 | 0 | 0 | 1 | 0 | 0 | 0 | 0 | 0 | 0 | 0 | 0 | 0 | 0 | 0 | 0 | 0
202 | Fault Trainline - General B |  |  | 4 | General Fault Trainline has been asserted. | LED indicators on FDP are illuminated. | IOM #1 has turned on Fault Trainline-General (control output #2) | None |  |  | General Fault Trainline has been asserted. LED indicators on FDP are illuminated. |  |  | 1 | 0 | 0 | 0 | 0 | 1 | 0 | 0 | 0 | 0 | 0 | 0 | 0 | 0 | 0 | 0 | 0 | 0 | 0
203 | Fault Trainline - Propulsion |  |  | 4 | Propulsion Trainline has been asserted. | LED indicators on FDP are illuminated. | IOM #1 has turned on Fault Trainline-Propulsion (control output #3) | None |  |  | Propulsion Trainline has been asserted. LED indicators on FDP are illuminated. |  |  | 1 | 0 | 0 | 0 | 0 | 1 | 0 | 0 | 0 | 0 | 0 | 0 | 0 | 0 | 0 | 0 | 0 | 0 | 0
204 | Fault Trainline - Brake |  |  | 4 | Brake Trainline has been asserted. | LED indicators on FDP are illuminated. | IOM #1 has turned on Fault Trainline-Brake (control output #4) | None |  |  | Brake Trainline has been asserted. LED indicators on FDP are illuminated. |  |  | 1 | 0 | 0 | 0 | 0 | 1 | 0 | 0 | 0 | 0 | 0 | 0 | 0 | 0 | 0 | 0 | 0 | 0 | 0
205 | Fault Trainline - HVAC |  |  | 4 | HVAC Trainline has been asserted. | LED indicators on FDP are illuminated. | IOM #1 has turned on Fault Trainline-HVAC (control output #5) | None |  |  | HVAC Trainline has been asserted. LED indicators on FDP are illuminated. |  |  | 1 | 0 | 0 | 0 | 0 | 1 | 0 | 0 | 0 | 0 | 0 | 0 | 0 | 0 | 0 | 0 | 0 | 0 | 0
206 | Fault Trainline - APU |  |  | 4 | APU Trainline has been asserted. | LED indicators on FDP are illuminated. | IOM #1 has turned on Fault Trainline - APU (control output #6) | None |  |  | APU Trainline has been asserted. LED indicators on FDP are illuminated. |  |  | 1 | 0 | 0 | 0 | 0 | 1 | 0 | 0 | 0 | 0 | 0 | 0 | 0 | 0 | 0 | 0 | 0 | 0 | 0
207 | Fault Trainline - Spare1 |  |  | 4 | Spare 1 Trainline has been asserted. |  | IOM #1 has turned on Fault Trainline-Spare1 (control output #7) | None |  |  | Spare 1 Trainline has been asserted. |  |  | 0 | 0 | 0 | 0 | 0 | 1 | 0 | 0 | 0 | 0 | 0 | 0 | 0 | 0 | 0 | 0 | 0 | 0 | 0
208 | Fault Trainline - Spare2 |  |  | 4 | Spare 2 Trainline has been asserted. |  | IOM #1 has turned on Fault Trainline-Spare2 (control output #8) | None |  |  | Spare 2 Trainline has been asserted. |  |  | 0 | 0 | 0 | 0 | 0 | 1 | 0 | 0 | 0 | 0 | 0 | 0 | 0 | 0 | 0 | 0 | 0 | 0 | 0
209 | MDS Fault LED |  |  | 4 | FDP Fault has been asserted. |  | IOM #1 has turned on Fault Trainline - FDP (control output #9) | None |  |  | FDP Fault has been asserted. |  |  | 1 | 0 | 0 | 0 | 0 | 1 | 0 | 0 | 0 | 0 | 0 | 0 | 0 | 0 | 0 | 0 | 0 | 0 | 0
210 | Feedback FTL - General A |  |  | 4 | IOM's reading of the fault trainline. |  | The IOM #1 feedback is on for Fault Trainline - General A (control output #1) | None |  |  | IOM's reading of the fault trainline. |  |  | 1 | 0 | 0 | 0 | 0 | 1 | 0 | 0 | 0 | 0 | 0 | 0 | 0 | 0 | 0 | 0 | 0 | 0 | 0
211 | Feedback FTL - General B |  |  | 4 | IOM's reading of the fault trainline. |  | The IOM #1 feedback is on for Fault Trainline - General B (control output #2) | None |  |  | IOM's reading of the fault trainline. |  |  | 1 | 0 | 0 | 0 | 0 | 1 | 0 | 0 | 0 | 0 | 0 | 0 | 0 | 0 | 0 | 0 | 0 | 0 | 0
212 | Feedback FTL - Propulsion |  |  | 4 | IOM's reading of the fault trainline. |  | The IOM #1 feedback is on for Fault Trainline - Propulsion (control output #3) | None |  |  | IOM's reading of the fault trainline. |  |  | 1 | 0 | 0 | 0 | 0 | 1 | 0 | 0 | 0 | 0 | 0 | 0 | 0 | 0 | 0 | 0 | 0 | 0 | 0
213 | Feedback FTL - Brake |  |  | 4 | IOM's reading of the fault trainline. |  | The IOM #1 feedback is on for Fault Trainline - Brake (control output #4) | None |  |  | IOM's reading of the fault trainline. |  |  | 1 | 0 | 0 | 0 | 0 | 1 | 0 | 0 | 0 | 0 | 0 | 0 | 0 | 0 | 0 | 0 | 0 | 0 | 0
214 | Feedback FTL - APU |  |  | 4 | IOM's reading of the fault trainline. |  | The IOM #1 feedback is on for Fault Trainline - APU (control output #5) | None |  |  | IOM's reading of the fault trainline. |  |  | 1 | 0 | 0 | 0 | 0 | 1 | 0 | 0 | 0 | 0 | 0 | 0 | 0 | 0 | 0 | 0 | 0 | 0 | 0
215 | Feedback FTL - HVAC |  |  | 4 | IOM's reading of the fault trainline. |  | The IOM #1 feedback is on for Fault Trainline - HVAC (control output #6) | None |  |  | IOM's reading of the fault trainline. |  |  | 1 | 0 | 0 | 0 | 0 | 1 | 0 | 0 | 0 | 0 | 0 | 0 | 0 | 0 | 0 | 0 | 0 | 0 | 0
216 | Feedback FTL - Spare1 |  |  | 4 | IOM's reading of the fault trainline. |  | The IOM #1 feedback is on for Fault Trainline - Soare1 (control output #7) | None |  |  | IOM's reading of the fault trainline. |  |  | 1 | 0 | 0 | 0 | 0 | 1 | 0 | 0 | 0 | 0 | 0 | 0 | 0 | 0 | 0 | 0 | 0 | 0 | 0
217 | Feedback FTL - Spare2 |  |  | 4 | IOM's reading of the fault trainline. |  | The IOM #1 feedback is on for Fault Trainline - Spare2 (control output #8) | None |  |  | IOM's reading of the fault trainline. |  |  | 1 | 0 | 0 | 0 | 0 | 1 | 0 | 0 | 0 | 0 | 0 | 0 | 0 | 0 | 0 | 0 | 0 | 0 | 0
218 | Feedback Spare FTL Control |  |  | 4 | IOM's reading of the fault trainline. |  | The IOM #1 feedback is on for Spare Fault Trainline Control (control output #9) | None |  |  | IOM's reading of the fault trainline. |  |  | 1 | 0 | 0 | 0 | 0 | 1 | 0 | 0 | 0 | 0 | 0 | 0 | 0 | 0 | 0 | 0 | 0 | 0 | 0
219 | Input Failure - IOM #1 IP#1 |  |  | 2 | Fault Detected on Input #1. | Input is not reporting accurately. | A hardware fault is detected on IOM #1 discrete input #1 | CDT | Report to Maintenance | Replace CDT if fault persists. | Fault Detected on Input #1. Input is not reporting accurately. | Report to Maintenance | Replace CDT if fault persists. | 1 | 0 | 1 | 0 | 0 | 1 | 0 | 0 | 0 | 0 | 0 | 0 | 1 | 0 | 0 | 0 | 0 | 0 | 0
220 | Input Failure - IOM #1 IP#2 |  |  | 2 | Fault Detected on Input #2. | Input is not reporting accurately. | A hardware fault is detected on IOM #1 discrete input #2 | CDT | Report to Maintenance | Replace CDT if fault persists. | Fault Detected on Input #2. Input is not reporting accurately. | Report to Maintenance | Replace CDT if fault persists. | 1 | 0 | 1 | 0 | 0 | 1 | 0 | 0 | 0 | 0 | 0 | 0 | 1 | 0 | 0 | 0 | 0 | 0 | 0
221 | Input Failure - IOM #1 IP#3 |  |  | 2 | Fault Detected on Input #3. | Input is not reporting accurately. | A hardware fault is detected on IOM #1 discrete input #3 | CDT | Report to Maintenance | Replace CDT if fault persists. | Fault Detected on Input #3. Input is not reporting accurately. | Report to Maintenance | Replace CDT if fault persists. | 1 | 0 | 1 | 0 | 0 | 1 | 0 | 0 | 0 | 0 | 0 | 0 | 1 | 0 | 0 | 0 | 0 | 0 | 0
222 | Input Failure - IOM #1 IP#4 |  |  | 2 | Fault Detected on Input #4. | Input is not reporting accurately. | A hardware fault is detected on IOM #1 discrete input #4 | CDT | Report to Maintenance | Replace CDT if fault persists. | Fault Detected on Input #4. Input is not reporting accurately. | Report to Maintenance | Replace CDT if fault persists. | 1 | 0 | 1 | 0 | 0 | 1 | 0 | 0 | 0 | 0 | 0 | 0 | 1 | 0 | 0 | 0 | 0 | 0 | 0
223 | Input Failure - IOM #1 IP#5 |  |  | 2 | Fault Detected on Input #5. | Input is not reporting accurately. | A hardware fault is detected on IOM #1 discrete input #5 | CDT | Report to Maintenance | Replace CDT if fault persists. | Fault Detected on Input #5. Input is not reporting accurately. | Report to Maintenance | Replace CDT if fault persists. | 1 | 0 | 1 | 0 | 0 | 1 | 0 | 0 | 0 | 0 | 0 | 0 | 1 | 0 | 0 | 0 | 0 | 0 | 0
224 | Input Failure - IOM #1 IP#6 |  |  | 2 | Fault Detected on Input #6. | Input is not reporting accurately. | A hardware fault is detected on IOM #1 discrete input #6 | CDT | Report to Maintenance | Replace CDT if fault persists. | Fault Detected on Input #6. Input is not reporting accurately. | Report to Maintenance | Replace CDT if fault persists. | 1 | 0 | 1 | 0 | 0 | 1 | 0 | 0 | 0 | 0 | 0 | 0 | 1 | 0 | 0 | 0 | 0 | 0 | 0
225 | Input Failure - IOM #1 IP#7 |  |  | 2 | Fault Detected on Input #7. | Input is not reporting accurately. | A hardware fault is detected on IOM #1 discrete input #7 | CDT | Report to Maintenance | Replace CDT if fault persists. | Fault Detected on Input #7. Input is not reporting accurately. | Report to Maintenance | Replace CDT if fault persists. | 1 | 0 | 1 | 0 | 0 | 1 | 0 | 0 | 0 | 0 | 0 | 0 | 1 | 0 | 0 | 0 | 0 | 0 | 0
226 | Input Failure - IOM #1 IP#8 |  |  | 2 | Fault Detected on Input #8. | Input is not reporting accurately. | A hardware fault is detected on IOM #1 discrete input #8 | CDT | Report to Maintenance | Replace CDT if fault persists. | Fault Detected on Input #8. Input is not reporting accurately. | Report to Maintenance | Replace CDT if fault persists. | 1 | 0 | 1 | 0 | 0 | 1 | 0 | 0 | 0 | 0 | 0 | 0 | 1 | 0 | 0 | 0 | 0 | 0 | 0
227 | Input Failure - IOM #1 IP#9 |  |  | 2 | Fault Detected on Input #9. | Input is not reporting accurately. | A hardware fault is detected on IOM #1 discrete input #9 | CDT | Report to Maintenance | Replace CDT if fault persists. | Fault Detected on Input #9. Input is not reporting accurately. | Report to Maintenance | Replace CDT if fault persists. | 1 | 0 | 1 | 0 | 0 | 1 | 0 | 0 | 0 | 0 | 0 | 0 | 1 | 0 | 0 | 0 | 0 | 0 | 0
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
255 | Input Failure - IOM #1 IP#37 |  |  | 2 | Fault Detected on Input #37. | Input is not reporting accurately. | A hardware fault is detected on IOM #1 discrete input #37 | CDT | Report to Maintenance | Replace CDT if fault persists. | Fault Detected on Input #37. Input is not reporting accurately. | Report to Maintenance | Replace CDT if fault persists. | 1 | 0 | 1 | 0 | 0 | 1 | 0 | 0 | 0 | 0 | 0 | 0 | 1 | 0 | 0 | 0 | 0 | 0 | 0
256 | Input Failure - IOM #1 IP#38 |  |  | 2 | Fault Detected on Input #38. | Input is not reporting accurately. | A hardware fault is detected on IOM #1 discrete input #38 | CDT | Report to Maintenance | Replace CDT if fault persists. | Fault Detected on Input #38. Input is not reporting accurately. | Report to Maintenance | Replace CDT if fault persists. | 1 | 0 | 1 | 0 | 0 | 1 | 0 | 0 | 0 | 0 | 0 | 0 | 1 | 0 | 0 | 0 | 0 | 0 | 0
257 | Input Failure - IOM #1 IP#39 |  |  | 2 | Fault Detected on Input #39. | Input is not reporting accurately. | A hardware fault is detected on IOM #1 discrete input #39 | CDT | Report to Maintenance | Replace CDT if fault persists. | Fault Detected on Input #39. Input is not reporting accurately. | Report to Maintenance | Replace CDT if fault persists. | 1 | 0 | 1 | 0 | 0 | 1 | 0 | 0 | 0 | 0 | 0 | 0 | 1 | 0 | 0 | 0 | 0 | 0 | 0
258 | Input Failure - IOM #1 IP#40 |  |  | 2 | Fault Detected on Input #40. | Input is not reporting accurately. | A hardware fault is detected on IOM #1 discrete input #40 | CDT | Report to Maintenance | Replace CDT if fault persists. | Fault Detected on Input #40. Input is not reporting accurately. | Report to Maintenance | Replace CDT if fault persists. | 1 | 0 | 1 | 0 | 0 | 1 | 0 | 0 | 0 | 0 | 0 | 0 | 1 | 0 | 0 | 0 | 0 | 0 | 0
259 | Input Failure - IOM #1 IP#41 |  |  | 2 | Fault Detected on Input #41. | Input is not reporting accurately. | A hardware fault is detected on IOM #1 discrete input #41 | CDT | Report to Maintenance | Replace CDT if fault persists. | Fault Detected on Input #41. Input is not reporting accurately. | Report to Maintenance | Replace CDT if fault persists. | 1 | 0 | 1 | 0 | 0 | 1 | 0 | 0 | 0 | 0 | 0 | 0 | 1 | 0 | 0 | 0 | 0 | 0 | 0
264 | MS FORWARD |  |  | 4 | Current input state: Set: FORWARD Clr: NOT FORWARD |  | IOM #1 input # 1 | Master Controller | Information Only. | Information Only. | Current input state: Set: FORWARD Clr: NOT FORWARD | Information Only. | Information Only. | 1 | 0 | 0 | 0 | 1 | 1 | 0 | 0 | 0 | 0 | 0 | 0 | 0 | 0 | 0 | 0 | 0 | 0 | 0
265 | MS REVERSE |  |  | 4 | Current input state: Set: REVERSE Clr: NOT REVERSE |  | IOM #1 input # 2 | Master Controller | Information Only. | Information Only. | Current input state: Set: REVERSE Clr: NOT REVERSE | Information Only. | Information Only. | 1 | 0 | 0 | 0 | 1 | 1 | 0 | 0 | 0 | 0 | 0 | 0 | 0 | 0 | 0 | 0 | 0 | 0 | 0
266 | MS NEUTRAL |  |  | 4 | Current input state: Set: NEUTRAL Clr: NOT NEUTRAL |  | IOM #1 input # 3 | Master Controller | Information Only. | Information Only. | Current input state: Set: NEUTRAL Clr: NOT NEUTRAL | Information Only. | Information Only. | 1 | 0 | 0 | 0 | 1 | 1 | 0 | 0 | 0 | 0 | 0 | 0 | 0 | 0 | 0 | 0 | 0 | 0 | 0
267 | FORWARD RELAY |  |  | 4 | Current input state: Set: ENERGIZED Clr: NOT ENERGIZED |  | IOM #1 input # 4 | EDB | Information Only. | Information Only. | Current input state: Set: ENERGIZED Clr: NOT ENERGIZED | Information Only. | Information Only. | 1 | 0 | 0 | 0 | 1 | 1 | 0 | 0 | 0 | 0 | 0 | 0 | 0 | 0 | 0 | 0 | 0 | 0 | 0
268 | REVERSE RELAY |  |  | 4 | Current input state: Set: ENERGIZED Clr: NOT ENERGIZED |  | IOM #1 input # 5 | EDB | Information Only. | Information Only. | Current input state: Set: ENERGIZED Clr: NOT ENERGIZED | Information Only. | Information Only. | 1 | 0 | 0 | 0 | 1 | 1 | 0 | 0 | 0 | 0 | 0 | 0 | 0 | 0 | 0 | 0 | 0 | 0 | 0
269 | MASTER CONTROLLER COAST |  |  | 4 | Current input state: Set: COAST POSITION Clr: NOT COAST |  | IOM #1 input # 6 | Master Controller | Information Only. | Information Only. | Current input state: Set: COAST POSITION Clr: NOT COAST | Information Only. | Information Only. | 1 | 0 | 0 | 0 | 1 | 1 | 0 | 0 | 0 | 0 | 0 | 0 | 0 | 0 | 0 | 0 | 0 | 0 | 0
270 | MASTER CONTROLLER SWITC |  |  | 4 | Current input state: Set: SWITCH POSITION Clr: NOT SWITCH |  | IOM #1 input # 7 | Master Controller | Information Only. | Information Only. | Current input state: Set: SWITCH POSITION Clr: NOT SWITCH | Information Only. | Information Only. | 1 | 0 | 0 | 0 | 1 | 1 | 0 | 0 | 0 | 0 | 0 | 0 | 0 | 0 | 0 | 0 | 0 | 0 | 0
271 | MASTER CONTROLLER P1 |  |  | 4 | Current input state: Set: P1 POSITION Clr: NOT P1 |  | IOM #1 input # 8 | Master Controller | Information Only. | Information Only. | Current input state: Set: P1 POSITION Clr: NOT P1 | Information Only. | Information Only. | 1 | 0 | 0 | 0 | 1 | 1 | 0 | 0 | 0 | 0 | 0 | 0 | 0 | 0 | 0 | 0 | 0 | 0 | 0
272 | MASTER CONTROLLER P2 |  |  | 4 | Current input state: Set: P2 POSITION Clr: NOT P2 |  | IOM #1 input # 9 | Master Controller | Information Only. | Information Only. | Current input state: Set: P2 POSITION Clr: NOT P2 | Information Only. | Information Only. | 1 | 0 | 0 | 0 | 1 | 1 | 0 | 0 | 0 | 0 | 0 | 0 | 0 | 0 | 0 | 0 | 0 | 0 | 0
273 | MASTER CONTROLLER P3 |  |  | 4 | Current input state: Set: P3 POSITION Clr: NOT P3 |  | IOM #1 input # 10 | Master Controller | Information Only. | Information Only. | Current input state: Set: P3 POSITION Clr: NOT P3 | Information Only. | Information Only. | 1 | 0 | 0 | 0 | 1 | 1 | 0 | 0 | 0 | 0 | 0 | 0 | 0 | 0 | 0 | 0 | 0 | 0 | 0
274 | M/C BRAKE RELEASE |  |  | 4 | Current input state: Set: NOT BRAKE SET Clr: BRAKE APPLY |  | IOM #1 input # 11 | Master Controller | Information Only. | Information Only. | Current input state: Set: NOT BRAKE SET Clr: BRAKE APPLY | Information Only. | Information Only. | 1 | 0 | 0 | 0 | 0 | 1 | 0 | 0 | 0 | 0 | 0 | 0 | 0 | 0 | 0 | 0 | 0 | 0 | 0
275 | M/C EMERGENCY BRAKE |  |  | 4 | Current input state: Set: EMERGENCY APPLY Clr: NOT EMERGENCY APPLY |  | IOM #1 input # 12 | Master Controller | Information Only. | Information Only. | Current input state: Set: EMERGENCY APPLY Clr: NOT EMERGENCY APPLY | Information Only. | Information Only. | 1 | 0 | 0 | 0 | 0 | 1 | 0 | 0 | 0 | 0 | 0 | 0 | 0 | 0 | 0 | 0 | 0 | 0 | 0
276 | M/C DEADMAN SWITCH |  |  | 4 | Current input state: Set: SWITCH ON Clr: SWITCH OFF |  | IOM #1 input # 13 | Master Controller | Information Only. | Information Only. | Current input state: Set: SWITCH ON Clr: SWITCH OFF | Information Only. | Information Only. | 1 | 0 | 0 | 0 | 0 | 1 | 0 | 0 | 0 | 0 | 0 | 0 | 0 | 0 | 0 | 0 | 0 | 0 | 0
277 | ACTIVE CAB |  |  | 4 | Current input state: Set: ENERGIZED Clr: NOT ENERGIZED |  | IOM #1 input # 14 | EDB | Information Only. | Information Only. | Current input state: Set: ENERGIZED Clr: NOT ENERGIZED | Information Only. | Information Only. | 1 | 0 | 0 | 0 | 0 | 1 | 0 | 0 | 0 | 0 | 0 | 0 | 0 | 0 | 0 | 0 | 0 | 0 | 0
278 | NON ACTIVE CAB |  |  | 4 | Current input state: Set: ENERGIZED Clr: NOT ENERGIZED |  | IOM #1 input # 15 | EDB | Information Only. | Information Only. | Current input state: Set: ENERGIZED Clr: NOT ENERGIZED | Information Only. | Information Only. | 1 | 0 | 0 | 0 | 0 | 1 | 0 | 0 | 0 | 0 | 0 | 0 | 0 | 0 | 0 | 0 | 0 | 0 | 0
279 | HORN ACTIVE |  |  | 4 | Current input state: Set: ENERGIZED Clr: NOT ENERGIZED |  | IOM #1 input # 16 | EDB | Information Only. | Information Only. | Current input state: Set: ENERGIZED Clr: NOT ENERGIZED | Information Only. | Information Only. | 1 | 0 | 0 | 0 | 0 | 1 | 0 | 0 | 0 | 0 | 0 | 0 | 0 | 0 | 0 | 0 | 0 | 0 | 0
280 | ELECTRICAL BELL SWITCH |  |  | 4 | Current input state: Set: SWITCH ON Clr: SWITCH OFF |  | IOM #1 input # 17 | Operation Panel | Information Only. | Information Only. | Current input state: Set: SWITCH ON Clr: SWITCH OFF | Information Only. | Information Only. | 1 | 0 | 0 | 0 | 0 | 1 | 0 | 0 | 0 | 0 | 0 | 0 | 0 | 0 | 0 | 0 | 0 | 0 | 0
281 | ZONE SELECTION SWITCH F-end |  |  | 4 | Current input state: Set: DOOR ZONE SELECTION Clr: NORMAL |  | IOM #1 input # 18 | Operation Panel | Information Only. | Information Only. | Current input state: Set: DOOR ZONE SELECTION Clr: NORMAL | Information Only. | Information Only. | 1 | 1 | 0 | 0 | 0 | 1 | 0 | 0 | 0 | 0 | 0 | 0 | 0 | 0 | 0 | 0 | 0 | 0 | 0
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
