JDSCS-Club/DENVER_CCP/DOC/06_이슈_대응/FMI/() PTT BOX ASSY.stp

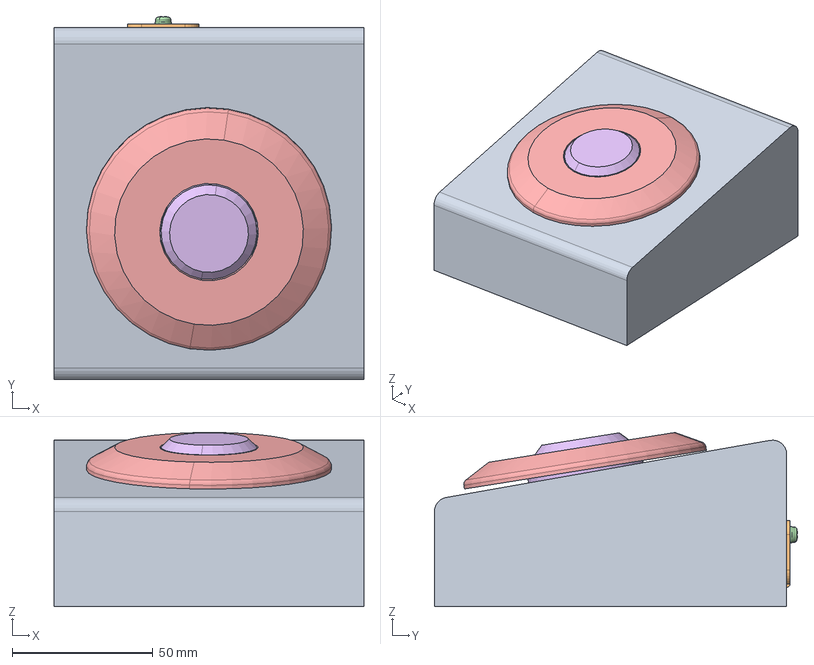
[picture p433: CAD file, 2026-04-02]
DOC/06_이슈_대응/FMI/() PTT BOX ASSY.stp
110.0 x 128.9 x 61.8 mm
