JDSCS-Club/DENVER_CCP/DOC/02_설계_도면/회로도/APEM_Switch/APEM_Image_8.dxf

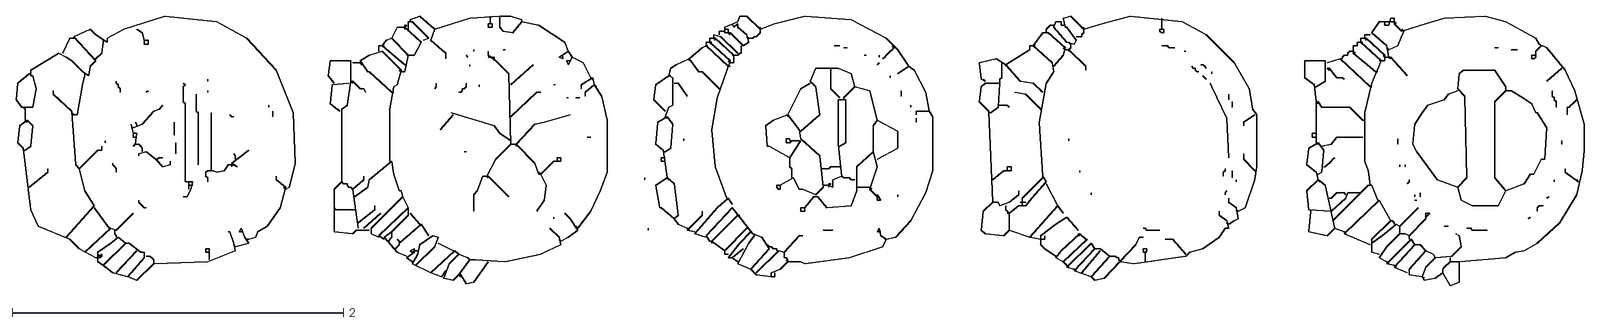
[picture p434: CAD file, 2026-04-02]
DOC/02_설계_도면/회로도/APEM_Switch/APEM_Image_8.dxf
9.47 x 1.63
