JDSCS-Club/DENVER_CCP/DOC/02_설계_도면/회로도/APEM_Switch/APEM_9.dxf

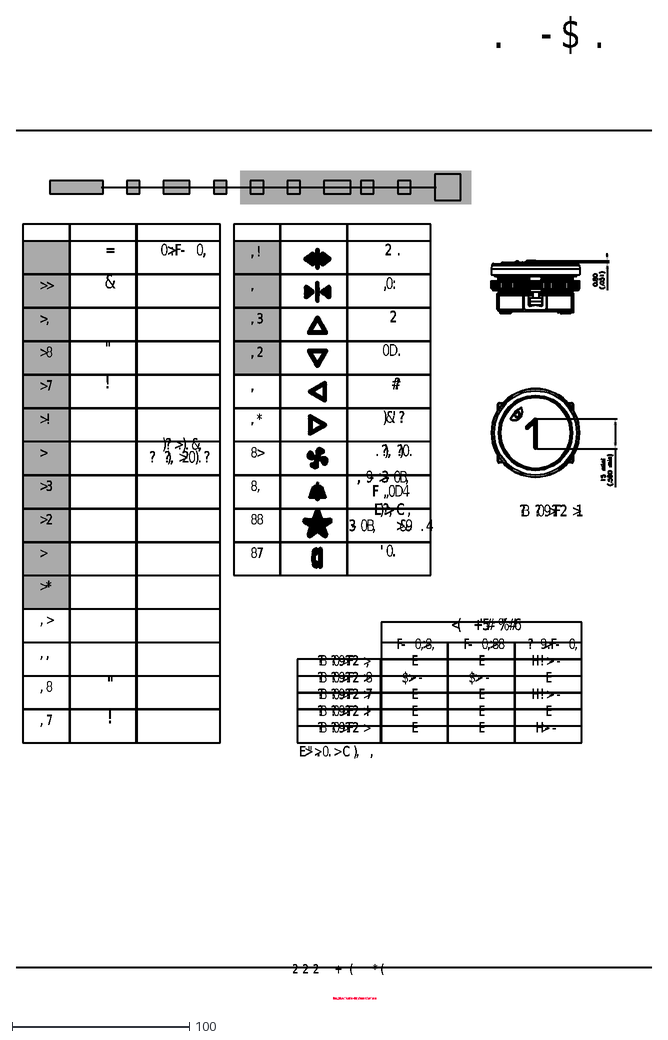
[picture p435: CAD file, 2026-04-02]
DOC/02_설계_도면/회로도/APEM_Switch/APEM_9.dxf
Unregistered Version - http://www.aidecad.com
.
-
$
2
+
(
*
=
&
0
>
:
F
,
!
3
D
#
?
)
'
8
B
9
1
4
E
C
7
"
<
5
%
6
H
