JDSCS-Club/DENVER_CCP/DOC/02_설계_도면/회로도/APEM_Switch/APEM_Image_9.dxf

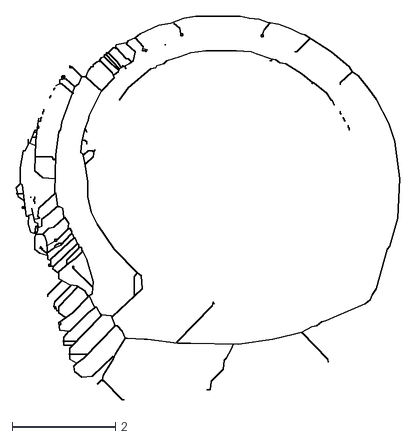
[picture p436: CAD file, 2026-04-02]
DOC/02_설계_도면/회로도/APEM_Switch/APEM_Image_9.dxf
7.44 x 7.44
