JDSCS-Club/DENVER_CCP/DOC/02_설계_도면/회로도/APEM_Switch/APEM_Image_3.dxf

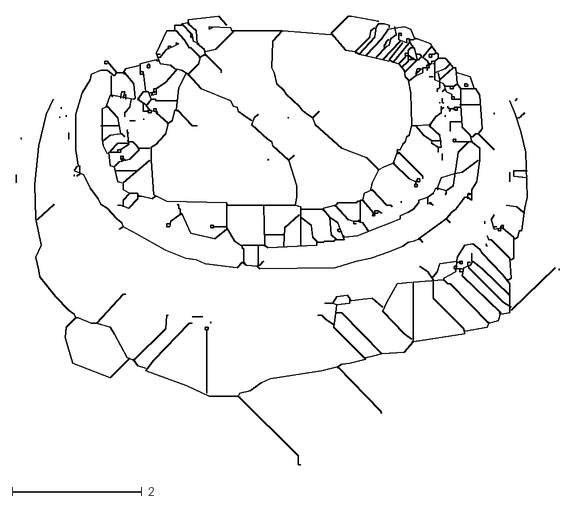
[picture p437: CAD file, 2026-04-02]
DOC/02_설계_도면/회로도/APEM_Switch/APEM_Image_3.dxf
8.37 x 6.92
