JDSCS-Club/DENVER_CCP/DOC/02_설계_도면/회로도/APEM_Switch/APEM_Image_12.dxf

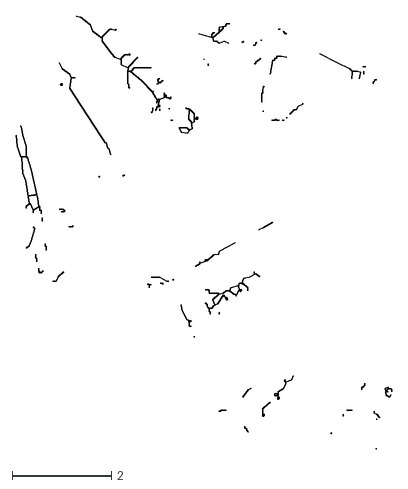
[picture p438: CAD file, 2026-04-02]
DOC/02_설계_도면/회로도/APEM_Switch/APEM_Image_12.dxf
7.57 x 8.72
