JDSCS-Club/DENVER_CCP/DOC/02_설계_도면/회로도/APEM_Switch/APEM_Image_11.dxf

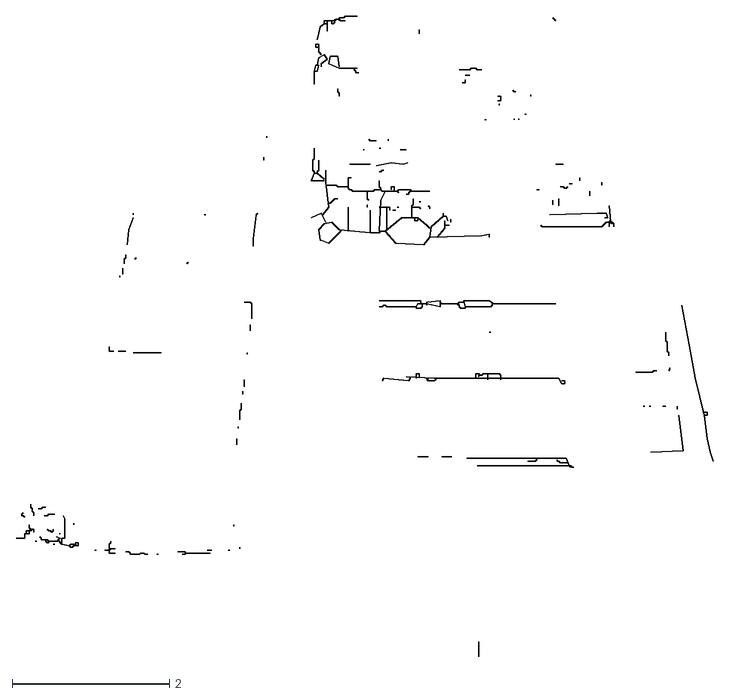
[picture p439: CAD file, 2026-04-02]
DOC/02_설계_도면/회로도/APEM_Switch/APEM_Image_11.dxf
8.87 x 8.15
