JDSCS-Club/DENVER_CCP/DOC/02_설계_도면/회로도/APEM_Switch/APEM_7.dxf

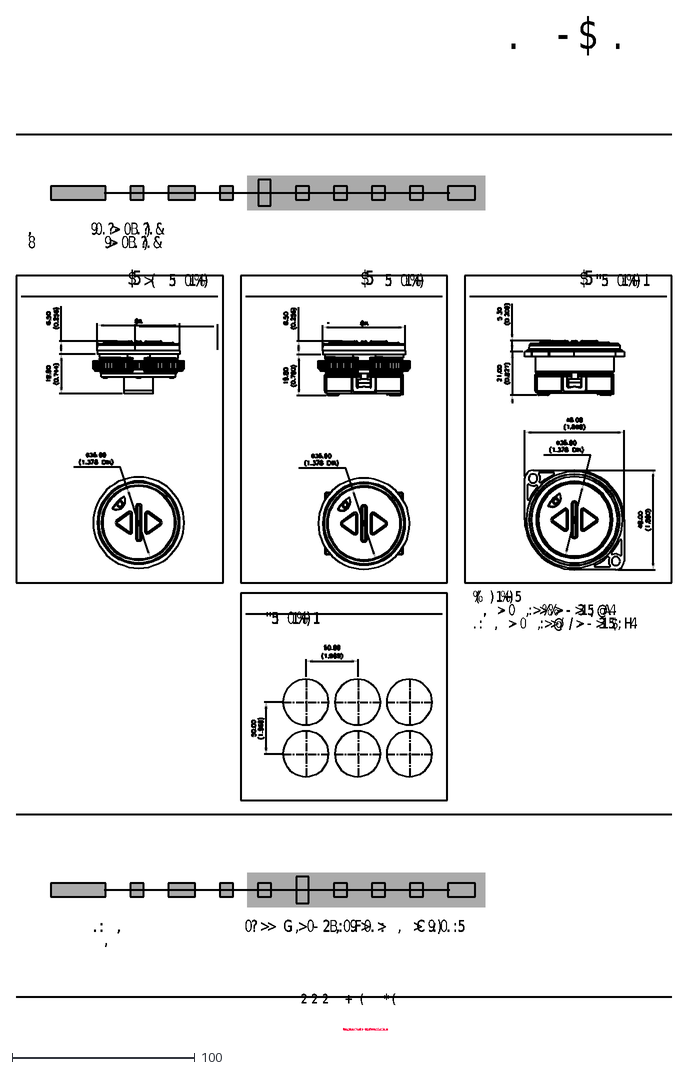
[picture p443: CAD file, 2026-04-02]
DOC/02_설계_도면/회로도/APEM_Switch/APEM_7.dxf
Unregistered Version - http://www.aidecad.com
.
-
$
2
+
(
*
,
9
0
?
>
B
)
&
8
:
G
F
C
5
1
%
'
3
;
@
A
4
/
H
