JDSCS-Club/DENVER_CCP/DOC/02_설계_도면/회로도/APEM_Switch/APEM_8.dxf

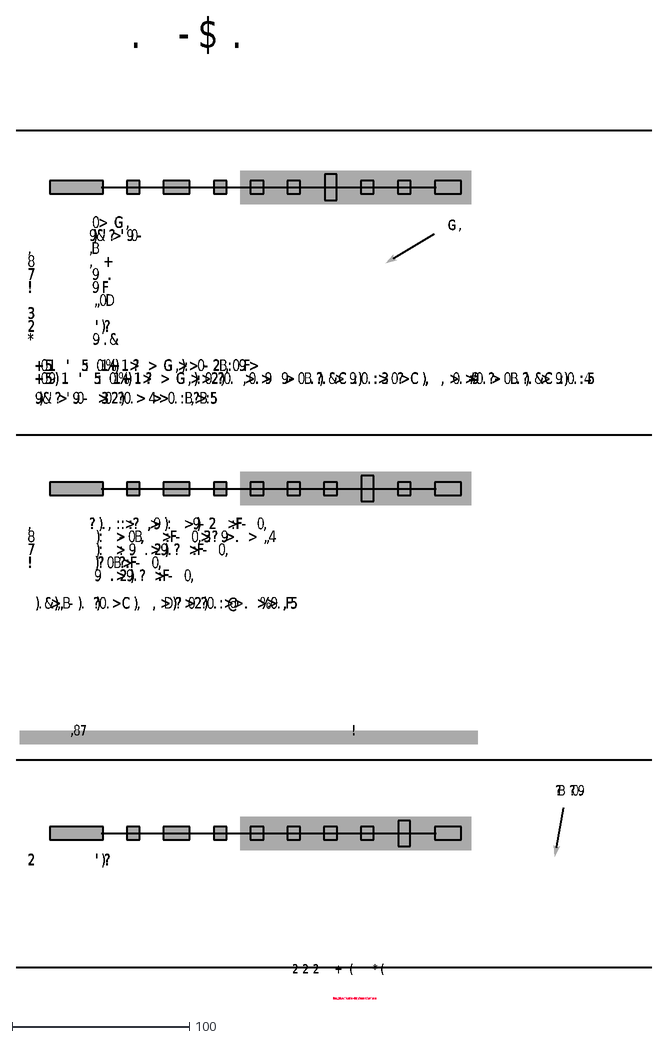
[picture p446: CAD file, 2026-04-02]
DOC/02_설계_도면/회로도/APEM_Switch/APEM_8.dxf
Unregistered Version - http://www.aidecad.com
2
+
(
*
.
-
$
0
>
G
,
9
)
&
'
?
B
8
7
!
F
D
3
:
4
5
1
%
C
#
@
,87
