JDSCS-Club/DENVER_CCP/DOC/02_설계_도면/회로도/APEM_Switch/APEM_2.dxf

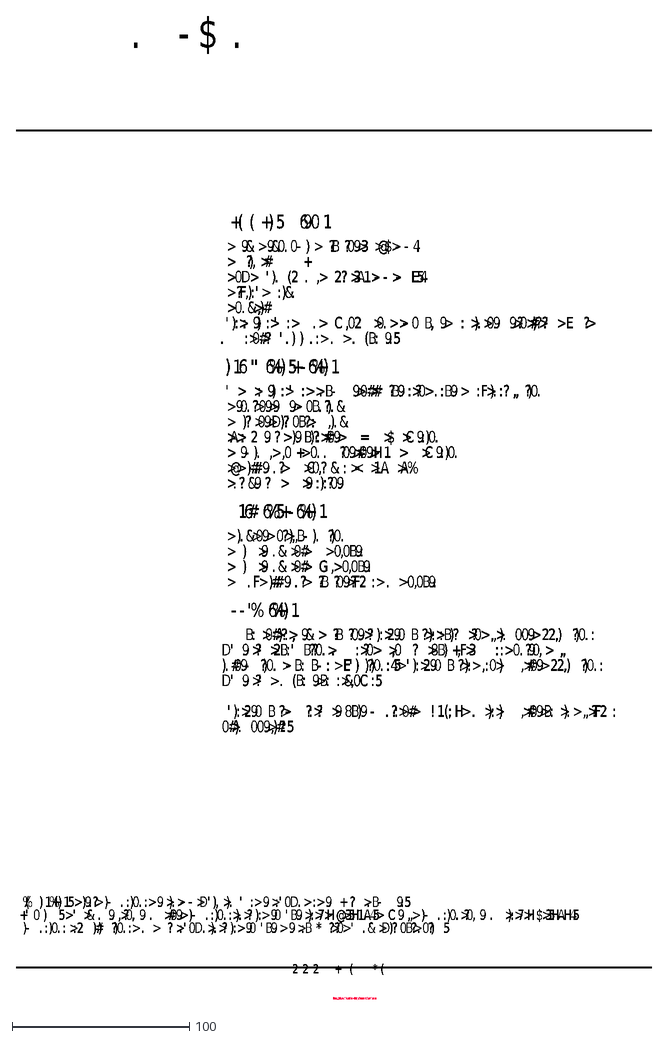
[picture p447: CAD file, 2026-04-02]
DOC/02_설계_도면/회로도/APEM_Switch/APEM_2.dxf
Unregistered Version - http://www.aidecad.com
2
+
(
*
.
-
$
)
5
6
9
0
1
>
&
?
B
3
@
4
,
#
D
'
A
E
F
:
C
%
=
H
<
G
8
!
;
7
