JDSCS-Club/DENVER_CCP/DOC/02_설계_도면/회로도/APEM_Switch/APEM_3.dxf

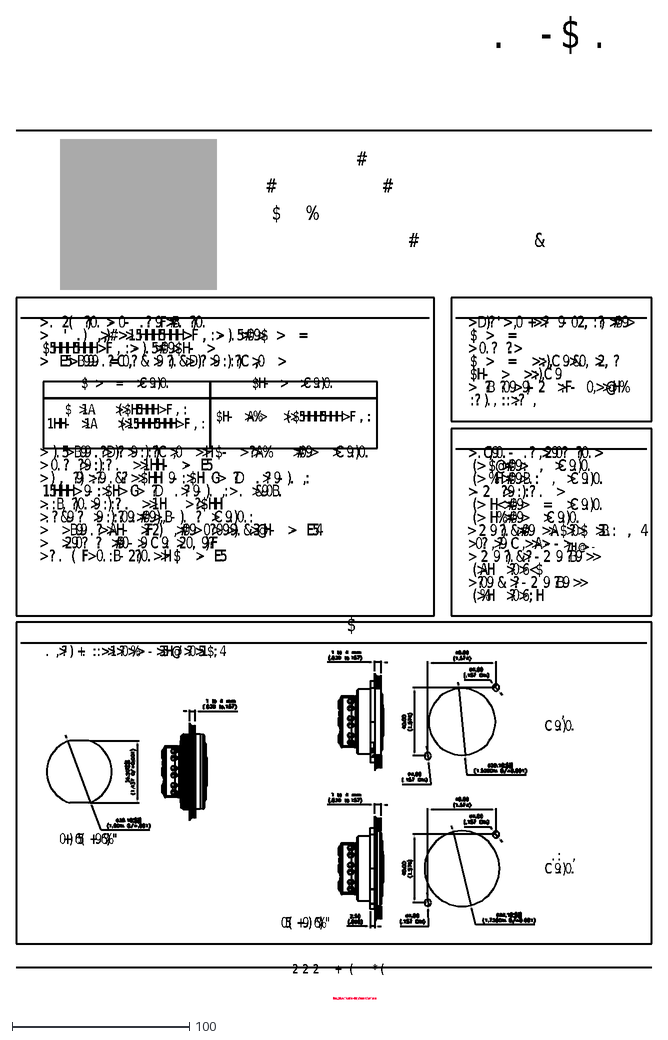
[picture p448: CAD file, 2026-04-02]
DOC/02_설계_도면/회로도/APEM_Switch/APEM_3.dxf
Unregistered Version - http://www.aidecad.com
$
.
-
2
+
(
*
#
%
&
>
?
)
0
9
F
B
'
,
1
5
H
:
=
E
C
D
A
G
3
@
4
<
7
6
;
/
"
