JDSCS-Club/DENVER_CCP/DOC/02_설계_도면/회로도/APEM_Switch/APEM_5.dxf

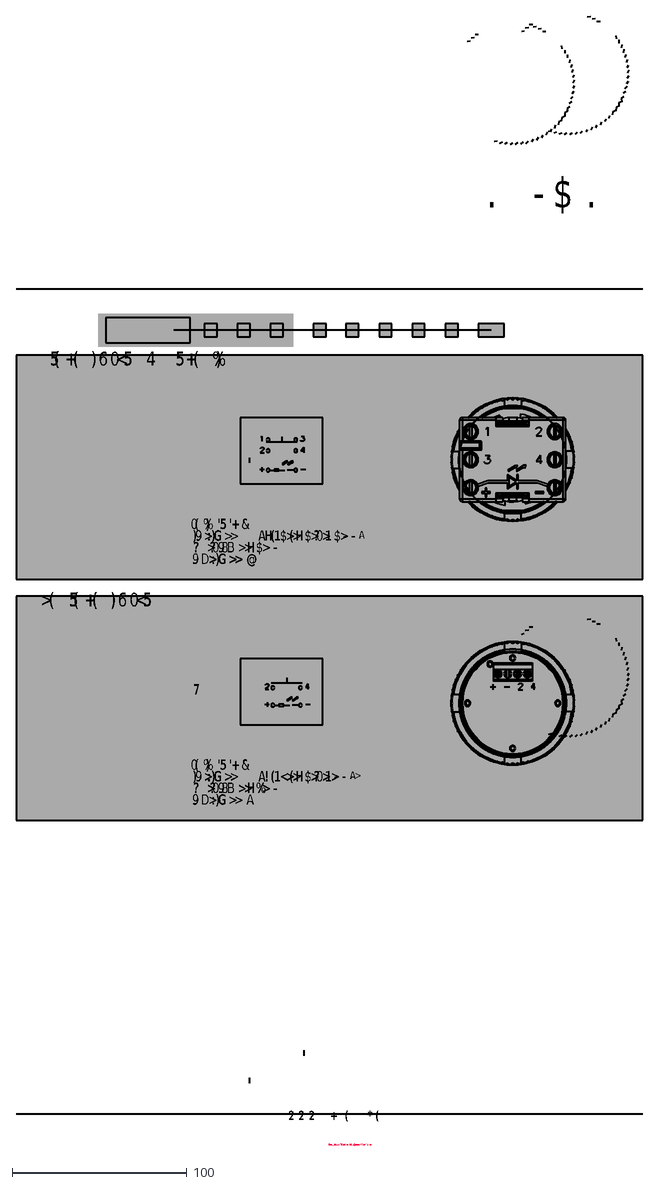
[picture p449: CAD file, 2026-04-02]
DOC/02_설계_도면/회로도/APEM_Switch/APEM_5.dxf
Unregistered Version - http://www.aidecad.com
.
-
$
2
+
(
*
5
)
6
0
<
4
%
>
7
'
&
9
:
G
A
H
1
?
8
B
D
@
!
