JDSCS-Club/DENVER_CCP/DOC/05_정비_매뉴얼/IPC/IPC_도면_DWG/FDI_SDI-POWER2.dxf

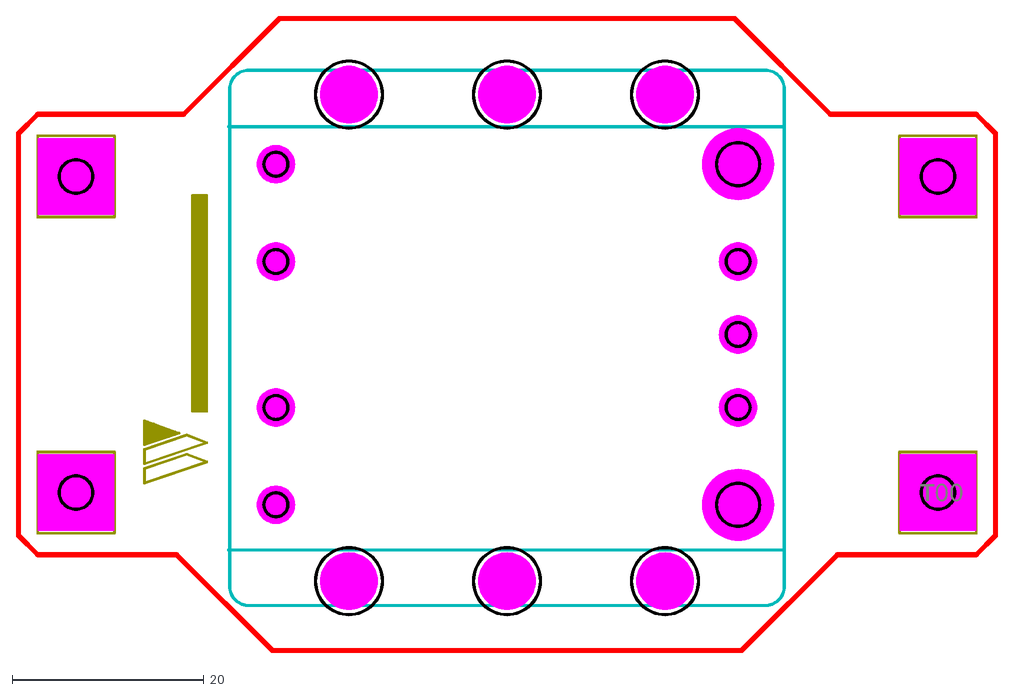
[picture p450: CAD file, 2026-04-02]
DOC/05_정비_매뉴얼/IPC/IPC_도면_DWG/FDI_SDI-POWER2.dxf
T00
