JDSCS-Club/DENVER_CCP/DOC/02_설계_도면/회로도/APEM_Switch/APEM_4.dxf

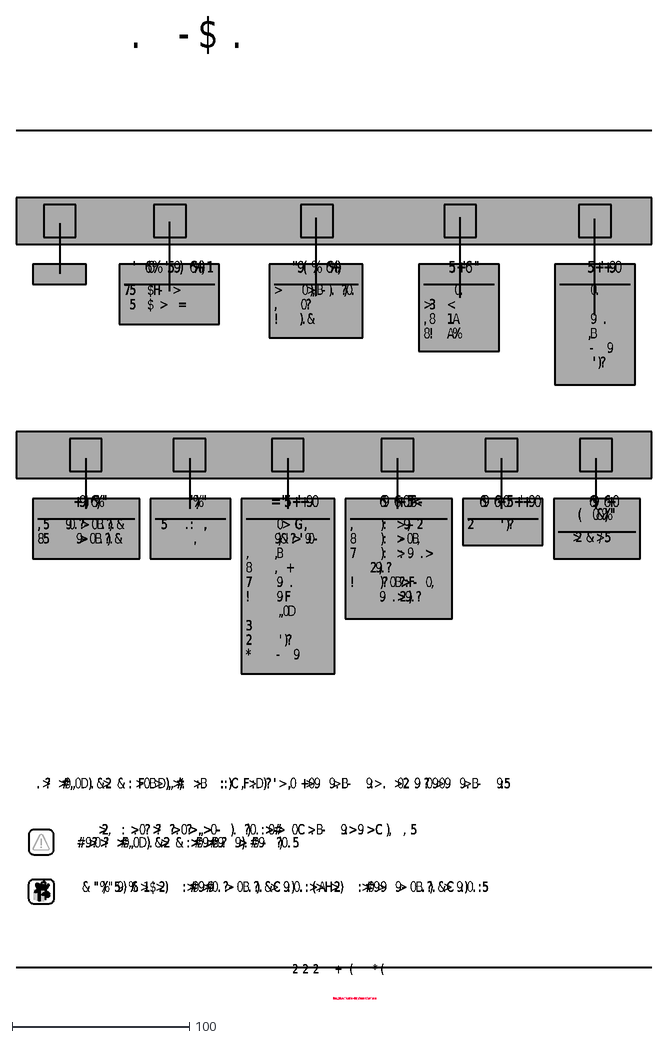
[picture p452: CAD file, 2026-04-02]
DOC/02_설계_도면/회로도/APEM_Switch/APEM_4.dxf
Unregistered Version - http://www.aidecad.com
2
+
(
*
.
-
$
'
6
0
%
5
9
)
1
7
H
>
=
,
B
?
!
&
:
"
3
<
8
A
#
D
F
C
G
/
