JDSCS-Club/DENVER_CCP/DOC/02_설계_도면/회로도/APEM_Switch/APEM_6.dxf

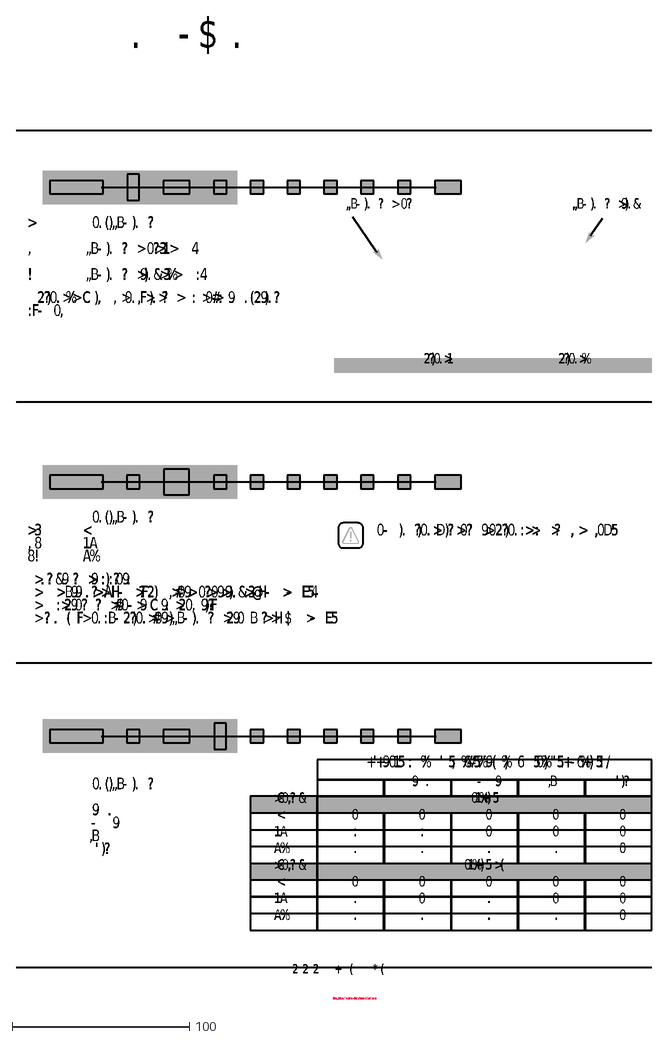
[picture p453: CAD file, 2026-04-02]
DOC/02_설계_도면/회로도/APEM_Switch/APEM_6.dxf
Unregistered Version - http://www.aidecad.com
2
+
(
*
.
-
$
>
0
)
,
B
?
3
1
4
!
9
&
%
:
C
F
'
#
<
D
5
8
A
H
@
E
;
6
"
/
