JDSCS-Club/DENVER_CCP/(list of files, cad)

Other CAD files:
DOC/06_이슈_대응/FMI/R1D000386_a (PEI1,PEI2-CONTROL BOARD ASSY).dwg
DOC/11_SW코드/lic/잡동사니/program/dts_lic_sw/DTS_LON(Ver1.1.05)/main.obj
DOC/11_SW코드/CPLD_FPGA/RF_COM/DPO_KM/isim/dpo_isim_beh.exe.sim/work/dpo_isim_beh.exe_main.nt64.obj
DOC/11_SW코드/lic/LIC_MCU/Ver1.0.35_20150917/main.obj
DOC/05_정비_매뉴얼/IPC/IPC_도면_DWG/13-15.DPO_MAIN Layer4.dwg
DOC/06_이슈_대응/FMI/R1C003058 (PTT BOX ASSY).dwg
DOC/06_이슈_대응/CNCS_발열/02_FAN_설계도면/R1C003498 (EXHAUST FAN ASSY) 20170718.dwg
DOC/11_SW코드/lic/LIC_MCU/Ver1.1.05/main.obj
DOC/06_이슈_대응/FMI/R1D000313_Aa (CCP-CONTROL BOARD ASSY).dwg
DOC/11_SW코드/lic/LIC_MCU/Ver1.0.35_Test/main.obj
DOC/02_설계_도면/승인도/APP R1D1358-21410 Bb(CAB SPEAKER ASSY).dwg
DOC/05_정비_매뉴얼/IPC/IPC_도면_DWG/13-10.DPO_MAIN Board1.dwg
DOC/05_정비_매뉴얼/IPC/IPC_도면_DWG/13-12.DPO_MAIN Layer1.dwg
DOC/05_정비_매뉴얼/IPC/IPC_도면_DWG/13-11.DPO_MAIN Board2.dwg
DOC/05_정비_매뉴얼/IPC/IPC_도면_DWG/13-19.DPO_MAIN Partlist4.dwg
DOC/05_정비_매뉴얼/IPC/IPC_도면_DWG/13-13.DPO_MAIN Layer2.dwg
DOC/05_정비_매뉴얼/IPC/IPC_도면_DWG/13-20.DPO_MAIN Partlist5.dwg
DOC/05_정비_매뉴얼/IPC/IPC_도면_DWG/13-14.DPO_MAIN Layer3.dwg
DOC/05_정비_매뉴얼/IPC/IPC_도면_DWG/13-16.DPO_MAIN Partlist1.dwg
DOC/05_정비_매뉴얼/IPC/IPC_도면_DWG/13-17.DPO_MAIN Partlist2.dwg
DOC/05_정비_매뉴얼/IPC/IPC_도면_DWG/13-18.DPO_MAIN Partlist3.dwg
DOC/02_설계_도면/결선도_배선도/MASTER,MS,REW40023CT0,V00,REW40023CT0,R--,1,DRWG,A3.dwg
DOC/02_설계_도면/승인도/MASTER,MS,REC90008CT0,V00,REC90008CT0,R--,8,DRWG,A3_미수정.dwg
DOC/05_정비_매뉴얼/IPC/IPC_도면_DWG/01.PWR_FDI,SDI_Block Diagram.dwg
DOC/06_이슈_대응/CNCS_발열/02_FAN_설계도면/R1C003565 (BRACKET) 20170713.dwg
DOC/11_SW코드/CPLD_FPGA/RF_COM/DPO_KM/isim/dpo_isim_beh.exe.sim/work/a_3215644826_3212880686.nt64.obj
DOC/11_SW코드/lic/LIC_MCU/Ver1.0.35_20150917/start.obj
DOC/11_SW코드/lic/LIC_MCU/Ver1.0.35_Test/xr16l784.obj
DOC/11_SW코드/lic/LIC_MCU/Ver1.1.05/xr16l784.obj
DOC/11_SW코드/아이텍_GPIO/CCP_PCB도면(임시)_20111008-a.dwg
DOC/02_설계_도면/결선도_배선도/MASTER,MS,REW00083CT0,V00,REW00083CT0,R--,1,DRWG,A3.dwg
DOC/02_설계_도면/승인도/R1D000507-ANSM-WIRING DIAGRAM-A3 20120217.dwg
DOC/05_정비_매뉴얼/IPC/IPC_도면_DWG/12-13.DPH Layer3.dwg
DOC/06_이슈_대응/CNCS_발열/02_FAN_설계도면/R1D014257 (WIRING DIAGRAM) 20170713.dwg
DOC/06_이슈_대응/FMI/2016-0211 PTT BOX R03.dwg
DOC/11_SW코드/lic/LIC_MCU/Ver1.0.35_Test/debug3x.obj
DOC/11_SW코드/lic/LIC_MCU/Ver1.1.05/user.obj
DOC/11_SW코드/lic/잡동사니/program/dts_lic_sw/DTS_LON(Ver1.1.05)/mpudebug.obj
DOC/11_SW코드/아이텍_GPIO/CCP_PCB도면(임시)_20111008.dwg
DOC/02_설계_도면/결선도_배선도/MASTER,MS,REW00092CT0,V00,REW00092CT0,R--,1,DRWG,A3.dwg
DOC/02_설계_도면/승인도/MASTER,MS,REC90008CT0,V00,REC90008CT0,R--,8,DRWG,A3 20120917.dwg
DOC/06_이슈_대응/CNCS_발열/02_FAN_설계도면/R1C003564 (FAN FRAME) 20170718.dwg
DOC/11_SW코드/lic/LIC_MCU/Ver1.0.35_20150917/loninfo.obj
DOC/11_SW코드/lic/LIC_MCU/Ver1.0.35_Test/start.obj
DOC/11_SW코드/lic/LIC_MCU/Ver1.1.05/mpudebug.obj
DOC/11_SW코드/lic/잡동사니/program/dts_lic_sw/DTS_LON(Ver1.1.05)/xr16l784.obj
DOC/02_설계_도면/결선도_배선도/MASTER,MS,REC90002CT0,V00,REC90002CT0,R--,2,DRWG,A3.dwg
DOC/02_설계_도면/승인도/MASTER,MS,REC90010CT0,V00,REC90010CT0,R--,10,DRWG,A3 20120917.dwg
DOC/05_정비_매뉴얼/IPC/IPC_도면_DWG/01-16.AAB1 Partlist2.dwg
DOC/06_이슈_대응/FMI/R1D1473-25842_Ab (COMMUNICATION CONTROL PANEL).dwg
DOC/11_SW코드/lic/LIC_MCU/Ver1.0.35_20150917/en29lv040.obj
DOC/11_SW코드/lic/LIC_MCU/Ver1.0.35_Test/user.obj
DOC/11_SW코드/lic/잡동사니/program/dts_lic_sw/DTS_LON(Ver1.1.05)/en29lv040.obj
DOC/02_설계_도면/결선도_배선도/MASTER,MS,REC90010CT0,V00,REC90010CT0,R--,10,DRWG,A3.dwg
DOC/02_설계_도면/승인도/MASTER,MS,REW00084CT0,V00,REW00084CT0,R-A,2,DRWG,A3_120927.dwg
DOC/05_정비_매뉴얼/IPC/IPC_도면_DWG/15-19.PEI Partlist4.dwg
DOC/06_이슈_대응/FMI/R1D000372_a (DPO CONTROL BOARD).dwg
DOC/11_SW코드/lic/LIC_MCU/Ver1.0.35_20150917/user.obj
DOC/11_SW코드/lic/LIC_MCU/Ver1.0.35_Test/loninfo.obj
DOC/11_SW코드/lic/LIC_MCU/Ver1.1.05/start.obj
DOC/11_SW코드/lic/잡동사니/program/dts_lic_sw/DTS_LON(Ver1.1.05)/user.obj
DOC/02_설계_도면/결선도_배선도/MASTER,MS,REW00091CT0,V00,REW00091CT0,R--,1,DRWG,A3.dwg
DOC/02_설계_도면/승인도/MASTER,MS,REW00093CT0,V00,REW00093CT0,R--,1,DRWG,A3_이상없음.dwg
DOC/05_정비_매뉴얼/IPC/IPC_도면_DWG/16-06.PEI_MIC Layer2.dwg
DOC/11_SW코드/lic/LIC_MCU/Ver1.0.35_20150917/mpudebug.obj
DOC/11_SW코드/lic/LIC_MCU/Ver1.0.35_Test/en29lv040.obj
DOC/11_SW코드/lic/LIC_MCU/Ver1.1.05/en29lv040.obj
DOC/11_SW코드/lic/잡동사니/program/dts_lic_sw/DTS_LON(Ver1.1.05)/debug3x.obj
DOC/02_설계_도면/결선도_배선도/MASTER,MS,REW00076CT0,V00,REW00076CT0,R--,1,DRWG,A3.dwg
DOC/02_설계_도면/승인도/MASTER,MS,REC90006CT0,V00,REC90006CT0,R--,6,DRWG,A3 20120917.dwg
DOC/05_정비_매뉴얼/IPC/IPC_도면_DWG/CCP-POWER1.dxf
DOC/11_SW코드/lic/LIC_MCU/Ver1.0.35_20150917/debug3x.obj
DOC/11_SW코드/lic/LIC_MCU/Ver1.1.05/debug3x.obj
DOC/11_SW코드/lic/잡동사니/program/dts_lic_sw/DTS_LON(Ver1.1.05)/loninfo.obj
DOC/02_설계_도면/결선도_배선도/MASTER,MS,REW00090CT0,V00,REW00090CT0,R--,1,DRWG,A3.dwg
DOC/02_설계_도면/승인도/R1D000499-CSP-WIRING DIAGRAM-A3 20120507.dwg
DOC/02_설계_도면/회로도/APEM_Switch/APEM_Image_10.dxf
DOC/05_정비_매뉴얼/IPC/IPC_도면_DWG/10-13.VOIP-SUB Board2.dwg
DOC/11_SW코드/lic/LIC_MCU/Ver1.0.35_20150917/xr16l784.obj
DOC/11_SW코드/lic/LIC_MCU/Ver1.0.35_Test/mpudebug.obj
DOC/11_SW코드/lic/LIC_MCU/Ver1.1.05/loninfo.obj
DOC/11_SW코드/lic/잡동사니/program/dts_lic_sw/DTS_LON(Ver1.1.05)/start.obj
DOC/02_설계_도면/결선도_배선도/MASTER,MS,REW00082CT0,V00,REW00082CT0,R--,1,DRWG,A3.dwg
DOC/02_설계_도면/승인도/APP R1D1473-25868 b(JUMPER COUPLER PLUG).dwg
DOC/05_정비_매뉴얼/IPC/IPC_도면_DWG/18-04.TRANSFOMER Layer1.dwg
DOC/02_설계_도면/결선도_배선도/MASTER,MS,REW00084CT0,V00,REW00084CT0,R--,1,DRWG,A3.dwg
DOC/02_설계_도면/승인도/MASTER,MS,REC90004CT0,V00,REC90004CT0,R--,4,DRWG,A3 20120917.dwg
DOC/05_정비_매뉴얼/IPC/IPC_도면_DWG/07-10.RS485 Partlist2.dwg
DOC/02_설계_도면/결선도_배선도/MASTER,MS,REC90004CT0,V00,REC90004CT0,R--,4,DRWG,A3.dwg
DOC/02_설계_도면/승인도/MASTER,MS,REW00087CT0,V00,REW00087CT0,R-A,1,DRWG,A3_120927.dwg
DOC/05_정비_매뉴얼/IPC/IPC_도면_DWG/14-16.DPO_TOP Partlist4.dwg
DOC/02_설계_도면/결선도_배선도/MASTER,MS,REW00093CT0,V00,REW00093CT0,R--,1,DRWG,A3.dwg
DOC/02_설계_도면/승인도/MASTER,MS,REW00084CT0,V00,REW00084CT0,R--,1,DRWG,A3_120927.dwg
DOC/05_정비_매뉴얼/IPC/IPC_도면_DWG/17-06.PEI_LED Partlist1.dwg
DOC/02_설계_도면/결선도_배선도/MASTER,MS,REW00084CT0,V00,REW00084CT0,R-A,2,DRWG,A3.dwg
DOC/02_설계_도면/승인도/MASTER,MS,REC90002CT0,V00,REC90002CT0,R--,2,DRWG,A3 20120917.dwg
DOC/05_정비_매뉴얼/IPC/IPC_도면_DWG/15-11.PEI Board2.dwg
DOC/02_설계_도면/결선도_배선도/MASTER,MS,REW00081CT0,V00,REW00081CT0,R--,1,DRWG,A3.dwg
DOC/02_설계_도면/승인도/MASTER,MS,REW00091CT0,V00,REW00091CT0,R--,1,DRWG,A3_이상없음.dwg
DOC/05_정비_매뉴얼/IPC/IPC_도면_DWG/15-17.PEI Partlist2.dwg
DOC/02_설계_도면/결선도_배선도/MASTER,MS,REW00077CT0,V00,REW00077CT0,R--,1,DRWG,A3.dwg
DOC/02_설계_도면/승인도/MASTER,MS,REC90008CT0,V00,REC90008CT0,R--,8,DRWG,A3_120927.dwg
DOC/05_정비_매뉴얼/IPC/IPC_도면_DWG/16-03.PEI_MIC Board1.dwg
DOC/02_설계_도면/결선도_배선도/MASTER,MS,REC90008CT0,V00,REC90008CT0,R--,8,DRWG,A3.dwg
DOC/05_정비_매뉴얼/IPC/IPC_도면_DWG/17-03.PEI_LED Board1.dwg
DOC/02_설계_도면/결선도_배선도/MASTER,MS,REW00087CT0,V00,REW00087CT0,R-A,1,DRWG,A3.dwg
DOC/02_설계_도면/승인도/MASTER,MS,REW00090CT0,V00,REW00090CT0,R--,1,DRWG,A3_120927.dwg
DOC/02_설계_도면/결선도_배선도/MASTER,MS,REC90006CT0,V00,REC90006CT0,R--,6,DRWG,A3.dwg
DOC/02_설계_도면/승인도/APP R1D1473-25868 c(JUMPER COUPLER PLUG)20121119.dwg
DOC/05_정비_매뉴얼/IPC/IPC_도면_DWG/10-12.VOIP-SUB Board1.dwg
DOC/02_설계_도면/승인도/MASTER,MS,REC90006CT0,V00,REC90006CT0,R--,6,DRWG,A3 20120420420.dwg
DOC/02_설계_도면/승인도/MASTER,MS,REC90004CT0,V00,REC90004CT0,R--,4,DRWG,A3_120924.dwg
DOC/05_정비_매뉴얼/IPC/IPC_도면_DWG/01.PWR_DPO_Block Diagram.dwg
DOC/02_설계_도면/승인도/MASTER,MS,REC90010CT0,V00,REC90010CT0,R--,10,DRWG,A3_120924.dwg
DOC/05_정비_매뉴얼/IPC/IPC_도면_DWG/11-13.VOL Layer2.dwg
DOC/02_설계_도면/승인도/MASTER,MS,REW00076CT0,V00,REW00076CT0,R--,1,DRWG,A3_120927.dwg
DOC/05_정비_매뉴얼/IPC/IPC_도면_DWG/14-10.DPO_TOP Layer2.dwg
DOC/02_설계_도면/승인도/MASTER,MS,REW00076CT0,V00,REW00076CT0,R--,1,DRWG,A3_121009.dwg
DOC/05_정비_매뉴얼/IPC/IPC_도면_DWG/PID-POWER.dxf
DOC/02_설계_도면/승인도/MASTER,MS,REW00081CT0,V00,REW00081CT0,R--,1,DRWG,A3_이상없음.dwg
DOC/02_설계_도면/승인도/MASTER,MS,REC90002CT0,V00,REC90002CT0,R--,2,DRWG,A3_120924.dwg
DOC/05_정비_매뉴얼/IPC/IPC_도면_DWG/09-07.VOIP Board1.dwg
DOC/02_설계_도면/승인도/MASTER,MS,REC90006CT0,V00,REC90006CT0,R--,6,DRWG,A3_120924.dwg
DOC/05_정비_매뉴얼/IPC/IPC_도면_DWG/12-12.DPH Layer2.dwg
DOC/02_설계_도면/승인도/APP R1D1473-25838 Ab(CRA-COMMUNICAION RACK 2-2).dwg
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
