JDSCS-Club/DENVER_CCP/DOC/09_발표_보고/02_시스템_설계/Woojin_Wiring_Circuit_Diagram(20110331).pptx

## Wiring Diagram of Communication System

DENVER RTD EAGLE P3 PROJECT

## Slide 2

Communication Rack-A

DC 12V

PSA

SCB

DC 37.5V

Wimx

PA System MA

LIC

WLR

LONWORKS for CDT

A

LAN

VTX

LVDS

CNCS

HDD

A

Digital Video Signal

Digital Video Signal

ATA

PAC

485
Card

VOIP

CAB ON

DC 12V

BACK PLAN BOARD

RS485

RS485

Door & F/R

ODMETER

Passenger Emergency
Intercom

DC 37.5V

ANSM

Passenger Emergency
Intercom

DC 37.5V

Passenger Emergency
Intercom

DC 37.5V

ANSM

Dual - tone

DPO ADDRESS, ACT

PA Audio & Signal

PEI ADDRESS, CALL

PEI Audio & Signal

PEI ADDRESS, CALL

PEI Audio & Signal

PEI ADDRESS, CALL

PEI Audio & Signal

Dual - tone

DPO ADDRESS, ACT

PA Audio & Signal

IC Audio & Signal, PA Audio

IC Audio & Signal, PA Audio

Driver PA
Operation Box

DC 37.5V

Audio

DIMMER

DC 37.5V

Driver Microphone

TRF

ISP

ISP

IC Audio & Signal, PA Audio

CPO ADDRESS, ACT

PEI TL

IC TL

PA Audio TL

Dual- tone TL

CPO ADDRESS, ACT

MUTE

Conductor PA
Operation Box

TRF

ISP

TRF

Conductor PA
Operation Box

DC 37.5V

TRF

CPO ADDRESS, ACT

AAB

RS485 TL

TRF

Interior Speaker CH1

MUTE

ISP

TRF

ISP

TRF

Interior Speaker CH1

MUTE

ISP

TRF

ISP

ISP

DC 37.5V

Audio LINE

LEFT Side Exterior Speaker PA

Interior Speaker CH2

TRF

ESP

TRF

ESP

Interior Speaker CH2

TRF

ESP

TRF

ESP

RS485 TL

Dual- tone TL

RIGHT Side Exterior Speaker PA

RS485 TL

Dual- tone TL

IC TL

PEI TL

PA Audio TL

IC TL

PEI TL

PA Audio TL

## Slide 3

PA System MB

Wimx

DC 37.5V

PSA

SCB

Communication Rack-A

DC 12V

A

LONWORKS for CDT

LIC

WLR

Digital Video Signal

Digital Video Signal

A

VTX

LVDS

CNCS

HDD

LAN

CAB ON

PAC

485
Card

VOIP

ATA

ANSM

Passenger Emergency
Intercom

DC 37.5V

Passenger Emergency
Intercom

DC 37.5V

ANSM

Passenger Emergency
Intercom

DC 37.5V

DC 12V

Door & F/R

ODMETER

RS485

BACK PLAN BOARD

PEI ADDRESS, CALL

PEI Audio & Signal

Dual - tone

DPO ADDRESS, ACT

PA Audio & Signal

IC Audio & Signal, PA Audio

PEI ADDRESS, CALL

PEI Audio & Signal

DPO ADDRESS, ACT

PA Audio & Signal

Dual - tone

PEI ADDRESS, CALL

PEI Audio & Signal

RS485

IC Audio & Signal, PA Audio

CPO ADDRESS, ACT

Driver Microphone

TRF

ISP

ISP

Audio

DIMMER

DC 37.5V

Driver PA
Operation Box

DC 37.5V

IC Audio & Signal, PA Audio

CPO ADDRESS, ACT

DC 37.5V

TRF

Conductor PA
Operation Box

ISP

TRF

TRF

Conductor PA
Operation Box

MUTE

CPO ADDRESS, ACT

IC TL

PEI TL

PA Audio TL

Dual- tone TL

ISP

ISP

TRF

Interior Speaker CH1

MUTE

ISP

TRF

ISP

TRF

Interior Speaker CH1

MUTE

ISP

TRF

RS485 TL

AAB

ESP

TRF

ESP

Interior Speaker CH2

TRF

ESP

TRF

ESP

TRF

Interior Speaker CH2

LEFT Side Exterior Speaker PA

Audio LINE

DC 37.5V

RS485 TL

Dual- tone TL

RIGHT Side Exterior Speaker PA

Dual- tone TL

RS485 TL

PA Audio TL

IC TL

PEI TL

PA Audio TL

IC TL

PEI TL

## Slide 4

Communication Rack-A

DC 12V

PSA

SCB

DC 37.5V

Communication
Control Head

DC 37.5V

CAB ON

ADDRESS

FDI

Passenger Information System MA

LIC

WLR

LONWORKS for CDT

AC 230V

DC 37.5V

AC 230V

SDI

AC 230V

AC 230V

SDI

AC 230V

LAN

VTX

LVDS

CNCS

HDD

A

Digital Video Signal

Digital Video Signal

PII

AC 230V

ATA

PAC

485
Card

VOIP

AAB

CAB ON

LCD Display

LCD Display

LCD Display

DC 12V

BACK PLAN BOARD

RS485

RS485

Door & F/R

ODMETER

LCD Display

AC 230V

LCD Display

AC 230V

LCD Display

AC 230V

PII

DC 37.5V

PEI TL

IC TL

PA Audio TL

Dual- tone TL

AC 230V

SDI

AC 230V

SDI

Audio LINE

RS485 TL

DC 37.5V

RS485 TL

Dual- tone TL

RS485 TL

Dual- tone TL

IC TL

PEI TL

PA Audio TL

IC TL

PEI TL

PA Audio TL

## Slide 5

Passenger Information System MB

Communication
Control Head

DC 37.5V

CAB ON

ADDRESS

FDI

DC 37.5V

PSA

SCB

Communication Rack-A

DC 12V

AC 230V

SDI

AC 230V

AC 230V

SDI

AC 230V

DC 37.5V

AC 230V

LONWORKS for CDT

LIC

WLR

PII

AC 230V

Digital Video Signal

Digital Video Signal

A

VTX

LVDS

CNCS

HDD

LAN

LCD Display

LCD Display

LCD Display

CAB ON

PAC

485
Card

VOIP

AAB

ATA

DC 12V

Door & F/R

ODMETER

RS485

RS485

BACK PLAN BOARD

LCD Display

AC 230V

LCD Display

AC 230V

LCD Display

AC 230V

DC 37.5V

PII

SDI

AC 230V

SDI

AC 230V

PA Audio TL

Dual- tone TL

PEI TL

IC TL

RS485 TL

Audio LINE

DC 37.5V

RS485 TL

Dual- tone TL

RS485 TL

Dual- tone TL

PA Audio TL

IC TL

PEI TL

PA Audio TL

IC TL

PEI TL

## Slide 6

Circuit Diagram of Passenger Information System

## Slide 7

장치 별 BLOCKDIAGRAM - VTX

RELAY

DRV

[ VTX BOARD ]

BOARD INTERNAL POWER
( 5V , 3.3V , 1.8V )

[ BACK PLAN ]

DC 12V POWER IN

CNCS VIDEO
OUTPUT
[LVDS]

CAR 485 LINE

BNC VIDEO OUT

RACK-B
BNC VIDEO IN

VIDEO OUT SELECT

FPGA
[ CONTROL LOGIC ]

LVDS
RECEIVE

RS485

SDI

SerDes

VIDEO
TTL IN

SDI

BUS

BUS

STATE OUTPUT
&
DEBUG PORT

RX,TX

## Slide 8

장치 별 BLOCKDIAGRAM - VRX

[ VRX BOARD ]

DC 12V POWER IN

BOARD INTERNAL POWER
( 5V , 3.3V , 1.8V )

VIDEO
FRAME BUF
MEMORY

MEMORY BUS

FPGA
[ CONTROL LOGIC ]

LCD PANEL

LCD BACKLIGHT
INVERT BD.

BNC VIDEO OUT

DRV

SDI

SerDes

BUS

VIDEO
TTL OUT

LVDS
TRANS

BNC VIDEO IN

EQ.

SDI

BUS

CAR 485 LINE

CABLE ID SELECT

RS485

Device ID ( 12EA )

RX,TX

I/O

Bright
control

INVERT
POWER

## Slide 9

장치 별 BLOCKDIAGRAM - LEDC

[ LEDC BOARD : FDI/SDI/PII CONTROL ]

DC 5V POWER IN

BOARD INTERNAL POWER
( 3.3V , 1.8V )

RS485

MICRO PROCESS

Device ID & ADDRESS
( FDI ADDRESS : 5 EA )
( SDI ADDRESS : 9 EA )
( PII ADDRESS : 5 EA )

LED IMAGE
FLASH MEMORY

SPI-INTERFACE

FPGA
[ CONTROL LOGIC ]

CAR 485 LINE

DATA
BUF
[DRIVER]

DATA
BUF
[DRIVER]

COLOR
LED
MODULE

RX,TX

LED DATA
OUTPUT

DATA
BUS

YELLOW
LED
MODULE

I/O

LED DATA
OUTPUT

CABLE ID SELECT

## Slide 10

장치 별 BLOCKDIAGRAM - ESW ( 가칭 : ETHERNET SWITCH )

[ ESW BOARD ]

BOARD INTERNAL POWER
( 5V , 3.3V , 1.8V )

ETHERNET
SWITCH

[ BACK PLAN ]

DC 12V POWER IN

VOIP
ETHERNET
PORT

CNCS
ETHERNET
PORT

UP-LINK #1
ETHERNET
PORT

UP-LINK #2
ETHERNET
PORT

ETHERNET
LINK
&
SPEED
LED

#1 FRONT

ETHERNET PORT

#2 FRONT

ETHERNET PORT

#3 FRONT

ETHERNET PORT

## Slide 11

장치 별 BLOCKDIAGRAM - CNCS

[ CNCS BOARD ]

BOARD INTERNAL POWER
( 3.3V , 1.8V )

CONGA
COMPUTER
MODULE

DC 5V POWER IN

FRONT VIDEO
OUT PORT [ RGB ]

VIDEO LVDS OUT
[ VTX BOARD ]

FRONT USB
INTERFACE PORT

ETHERNET
TRANS

RS485

ETHERNET PORT
[ ESW BOARD ]

RS232

FRONT PTU
INTERFACE PORT

RX,TX

RX,TX

CAR 485 LINE

## Slide 12

장치 별 BLOCKDIAGRAM - HDD

[ HDD BOARD ]

BOARD INTERNAL POWER ( 5V )

SSD SATA
HARD DISK

[ BACK PLAN ]

DC 12V POWER IN

CNCS
SATA
HDD PORT

## Circuit Diagram of PA System

## Slide 14

PA Controller Block Diagram

Audio Amplifier Board

Audio File
Memory

Automatic
Broadcasting
Player

Audio File CNCS
(via USB)

VOIP Audio

RS-485 CL

Cab On

Door

Conductor Audio

Intercom Audio

Driver Audio

Ether net

PA
Controller

Ether net VoIP
Control UNIT

Line Control

Recording
Control

Power AMP
Channel 1

Matching
Transformer

Interior Speaker
Channel 1

Interior SPK
Volume Control
(Interior Channels)

I²C (Inter-Integrated Circuit)

Exterior SPK
Volume Control
(Left Channel)

Power AMP
Channel 2

Matching
Transformer

Interior Speaker
Channel 2

I 2C

Exterior SPK
Volume Control
(Right Channel)

Power AMP
Channel 3

Exterior Speaker
Channel 1
Left Side

ANS Controller
MCU

Matching
Transformer

Power AMP
Channel 4

Matching
Transformer

Exterior Speaker
Channel 2
Right Side

TRF

TRF

Power
Module

ANS
Microphone

PA audio TL

Intercom TL

Ether net
TL

ANS
Microphone

Trainlines

DC37.5V

PA Controller Block Diagram-R01 - 20110316ppt

## Slide 15

Denver DPO Block Diagram

Volume Control Knob

AMP

AMP

AUDIO EXPANDER

Solid State Switching Circuitry

L.P.F

ALC

Transformer

DPO Audio

AUDIO COMPANDOR

L.P.F

L.P.F

ALC

ALC

Transformer

Transformer

CPO Audio

PEI Audio

VOIP Audio

Mic. Jack

CAB ON

L.P.F

ALC

Transformer

Dual Tone Audio

PWM
Controller

Audio Controller

Logic
Controller

Power
Module

Tone
DRIVER

Tone
Filter

Transformer

Tone
Generator

Push Button

INT

SPEAKER

EXT

BOTH

IC

INTERCOM

PEI

CANCEL

VOIP

Digital
Detection

Digital
Control

Regulator

Live Signal
Address Signal

To PAC

MUTE

DC37.5V

(DPO) Block Diagram-R01 - 20110316.ppt

## Slide 16

Denver CPO Block Diagram

Volume Control Knob

Microphone

AMP

AMP

AUDIO EXPANDER

Solid State Switching Circuitry

Audio Controller

Logic
Controller

Power
Module

L.P.F

L.P.F

ALC

ALC

Transformer

Transformer

DPO Audio

CPO Audio

AUDIO COMPANDOR

L.P.F

ALC

Transformer

PEI Audio

Tone
DRIVER

Transformer

Tone
Generator

Dual Tone Audio

Train Car
Door Panel

Push Button

INT

SPEAKER

EXT

BOTH

IC

INTERCOM

PEI

CANCEL

KEY IN

Tone
Filter

Digital
Detection

Digital
Control

MUTE

Regulator

Live Signal
Address Signal

To PAC

DC37.5V

(CPO) Block Diagram-R01 - 20110316.ppt

## Slide 17

Denver PEI Block Diagram

AMP

AMP

AUDIO EXPANDER

L.P.F

ALC

Tone
DRIVER

Transformer

PEI Audio

AUDIO COMPANDOR

Transformer

Dual Tone Audio

STATUS
LAMPS

Tone
Filter

Tone
Generator

POWER

AUDIO S/W

Logic
Controller

Digital
Detection

Digital
Control

TALK

LISTEN
WAIT

Live Signal
Address Signal

To PAC

Push Button

CALL

Regulator

DC37.5V

Power
Module

(PEI) Block Diagram-R01 - 20110316ppt

## PAC TL & RS-485 Block Diagram

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
RS-485 Train Line Circuitry Block Diagram - 20110331.ppt

## Slide 19

PAC CL & RS-485 Block Diagram

Train Line 485

Train Line 485

R
t

Repeat

R
t

R
t

Repeat

R
t

Communication
Rack
A

Rt : Terminating Resistor

Communication
Rack
B

RS-485A

Rt

Device

Device

Device

RS-485A

RS-485B

Rt

Device

Device

Device

RS-485 CL Circuitry Block Diagram - 20110331.ppt
