JDSCS-Club/DENVER_CCP/DOC/06_이슈_대응/FMI/42A-2018-0001_FMI#17_Rev.1.0 (Installation of Fan).docx

DENVER RTD EAGLE P3
COMMUNICATION SYSTEM

# FIELD MODIFICATION INSTRUCTIONS FMI #17: CRA FAN installation

CONTRACT NO. | P110701149
CDRL NO. | N/A
WIS DOC. NO. | 42A-2018-0001
REVISION: | 1.0
DESIGNED: | D. S. JANG
REVIEWED: | J. Y. LEE
APPROVED: | B. J. JONE
DATE: | 12/20/2017

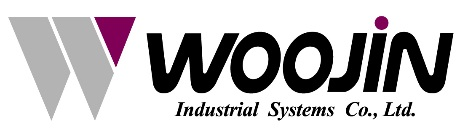
[picture p454: figure]
영문

# Record of Revisions

Rev. | Date | Description | Entered By
1.0 | 01/04/2018 | Initial release | D. S. Jang
1.1 | 01/10/2018 | Section 5.5,5.6,5.7 | D. S. Jang

# Table of Contents

# 1. Introduction

This FMI provides instructions to install the CRA FAN installation to the vehicles.

# 2. Summary

This FMI applies to following item:

- CRA FAN Installation

# 3. Instructions

## 3.1 Location of Equipment

Following figures show the location of equipment to be installed.

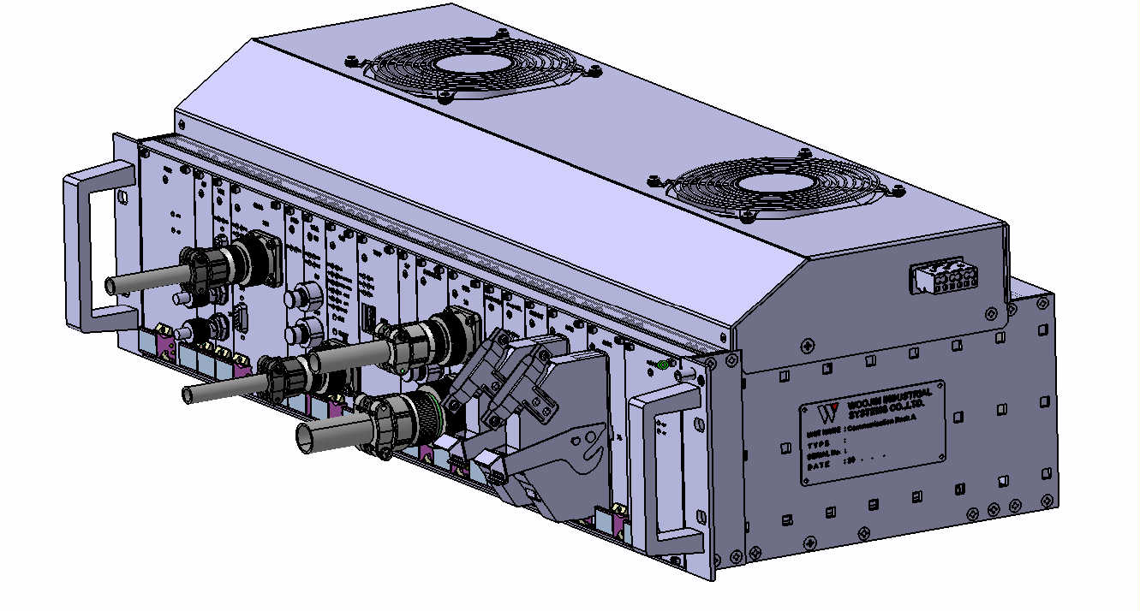
[picture p455: figure]

Figure 1 –CRA-FAN Installation

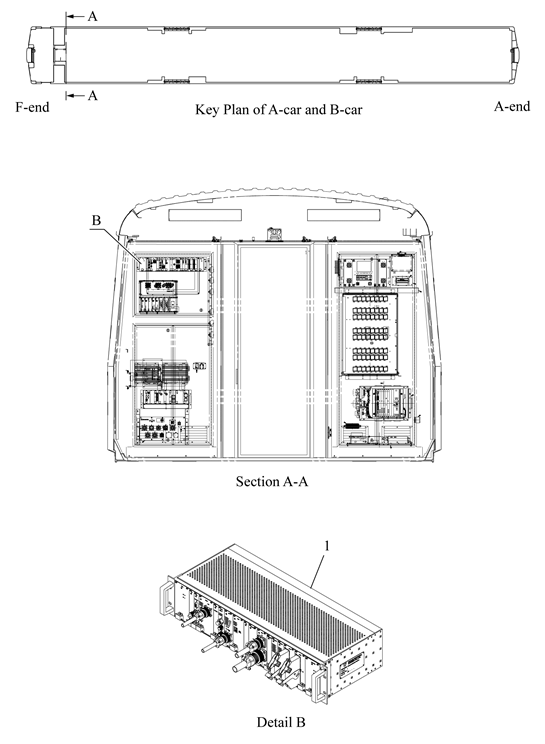
[picture p456: figure]

Figure 2 – CRA Location

## 3.2 HARDWARE UPDATE DESCRIPTION

: CPU high temperature occurs due to overload in GPS data process of CRA-CNCS. Therefore, forced cooling method using FAN was performed for the automatic PA abnormal operation.

### FAN Installation Method

1) Remove CRA from the car.

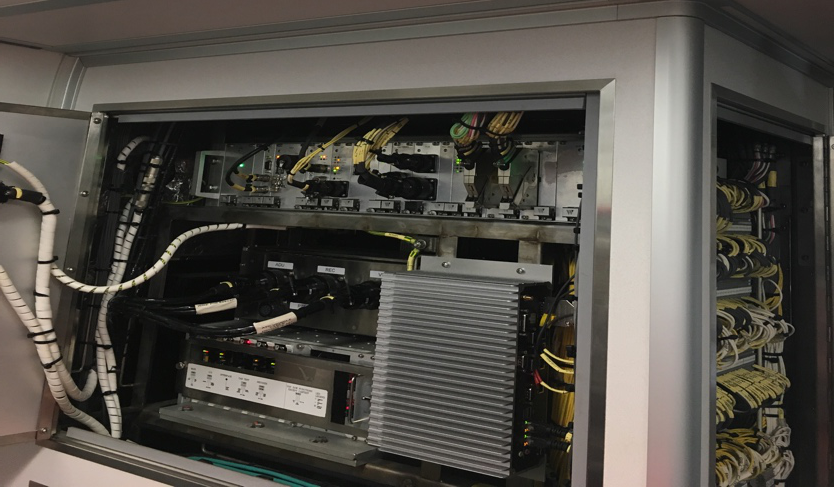
[picture p457: figure]
../../../../../../../../../../Desktop

Figure 3 – CRA

2) Use the CRA side bolt to fix the FAN

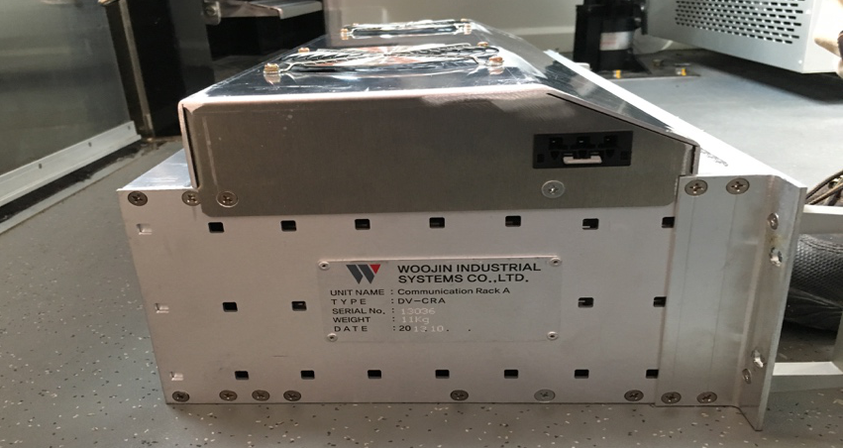
[picture p458: figure]
../../../../../../../../../../Desktop

Figure 4 – FAN Installation

3) FAN installation in CRA

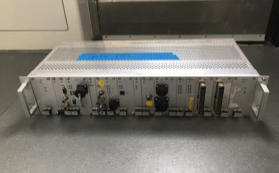
[picture p459: figure]
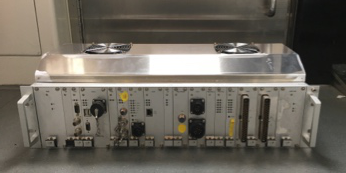
[picture p460: figure]

<Before FAN installation>

<After FAN installation>

### FAN Operation Method

1) Use train power as operating power

2) The operating temperature can be set by the temperature sensor

3) The FAN operates when the CRA ambient temperature is higher than the set temperature

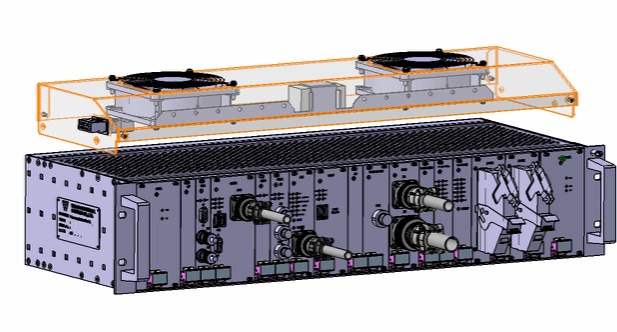
[picture p461: figure]
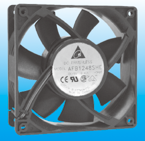
[picture p462: figure]

<FAN >

<temperature sensor>

Figure 5 – FAN components.

### FAN Operation Results

: Test result of FAN installation

-> CPU internal temperature 95 degree → 62 degree

-> CNCS heating plate 75 degree → 43 degree

# Before

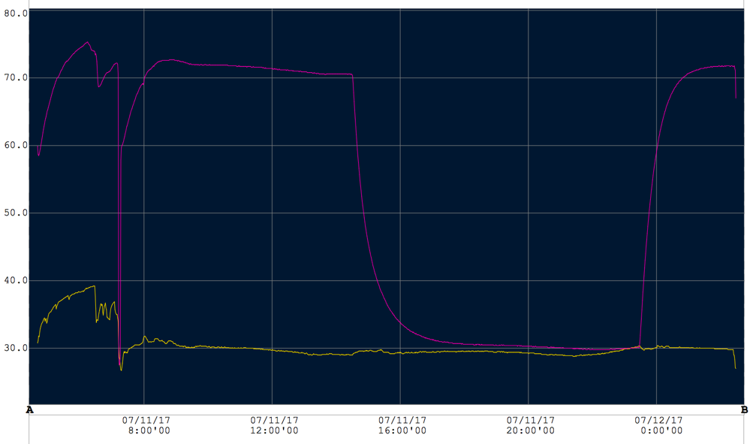
[picture p463: figure]

4066 CRA-CNCS Heating plate temperature change.

<CRA-CNCS Heating plate >

maximum 75℃ / Average 70℃

<CRA CNCS ambient temperature >

maximum 40℃ / Average 30℃

# 4066 CRA-CNCS heat plate temperature is 70℃ on average.

# After

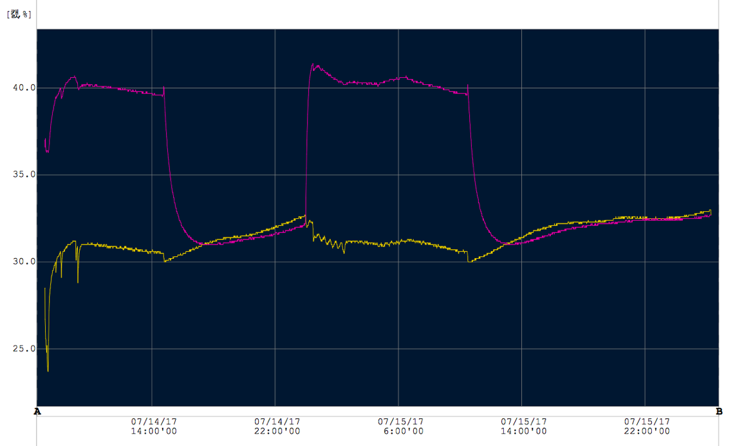
[picture p464: figure]

4066 CRA-CNCS Heating plate temperature change.

<CRA-CNCS Heating plate >

maximum 43℃ / Average 40℃ 이상

<CRA CNCS ambient temperature >

maximum 35℃/ Average 30℃

# 4066 CRA-CNCS heat plate temperature is 40℃ on average.

# 4. Tracking

Status of the field modification activities will be tracked and managed for car number and items completed. The progress will be reported to DTP/H-Rotem in daily basis as the modification proceeds.

# 5. DTP Q&A (2017.7 DTP Presentation).

## 5.1 Fans are blowing air into CRA or sucking air from CRA? What will be final configuration?

- Fans are blowing air from CRA.

- The test sample will also change direction.(blowing air from CRA)

## 5.2 What circuit breaker will fans be connected to? What is the updated load on that circuit breaker?

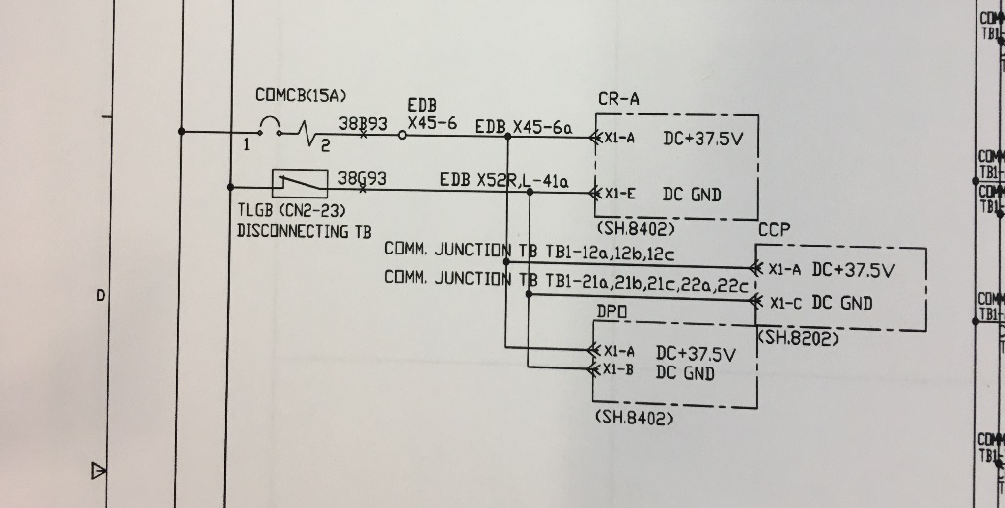
[picture p465: figure]

FAN

- COMCB circuit breaker

-> FAN 1EA -0.3A

## 5.3 Where is fresh air coming from in the electrical locker?

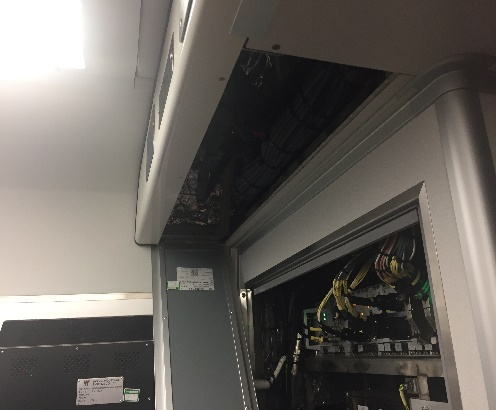
[picture p466: figure]
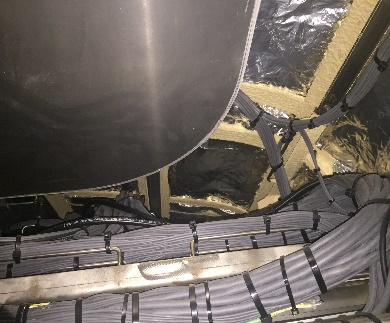
[picture p467: figure]

- Fresh air comes from ceiling

## 5.4 Is the thermostat necessary? What is the thermostat setting? Will fans be on all the time?

- The function of the temperature sensor is to stop the fan operation until CRA fully warm up at a cold start in winter.

- Thermostat will be set at 20 degree C.

## 5.5 the monitoring result after FAN installation (Monitoring period from july to august)

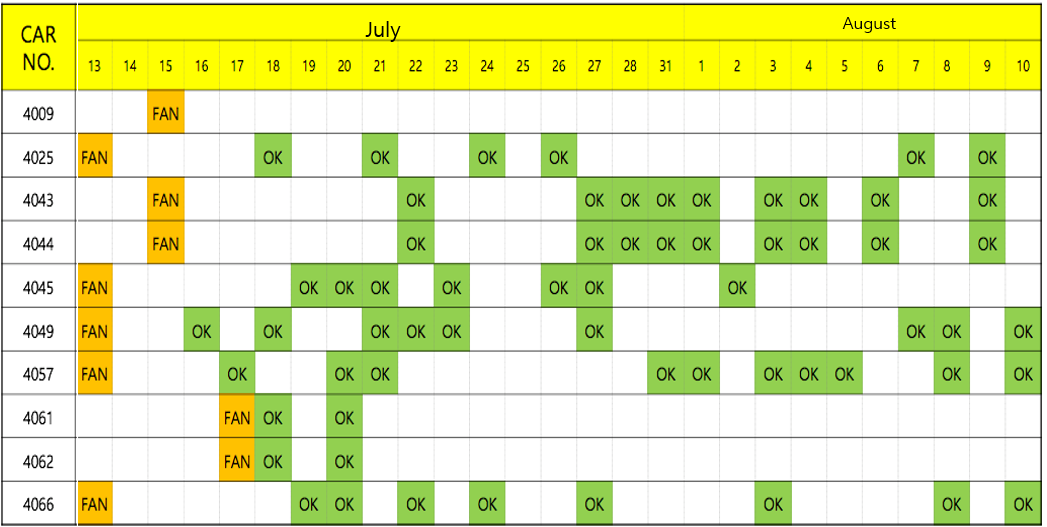
[picture p468: figure]

## 5.6 spare part supply for FAN

- WOOJIN will supply the spare part 10% of the total quantity.

65SET (Total quantity) + 7SET (Spare part) = 72SET

## 5.7 FAN air flow

- The air from the FAN will flow upward.
- The test sample installed on the car and the remained production unit will be installed on same direction.

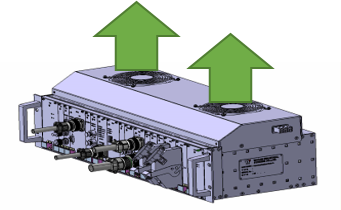
[picture p469: figure]

11 of 11 © Copyright Woojin Industrial Systems Co., Ltd.

DENVER RTD EAGLE P3 COMMUNICATION SYSTEM FMI #17: CRA FAN installation DOC. NO. 42A-2018-0001 DATE 01/04/2018 REV. NO. 1.1
