JDSCS-Club/DENVER_CCP/DOC/03_시험_인증/VOIP_시험_자료/VOIP Test Instructions.pptx

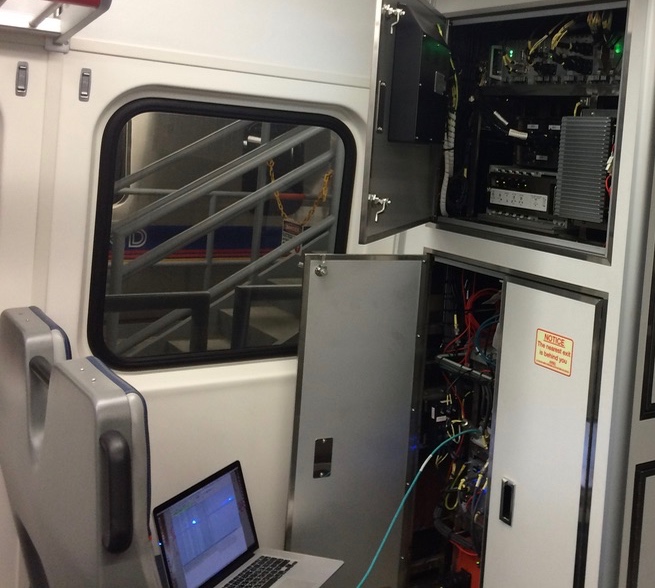
[picture p479: figure]
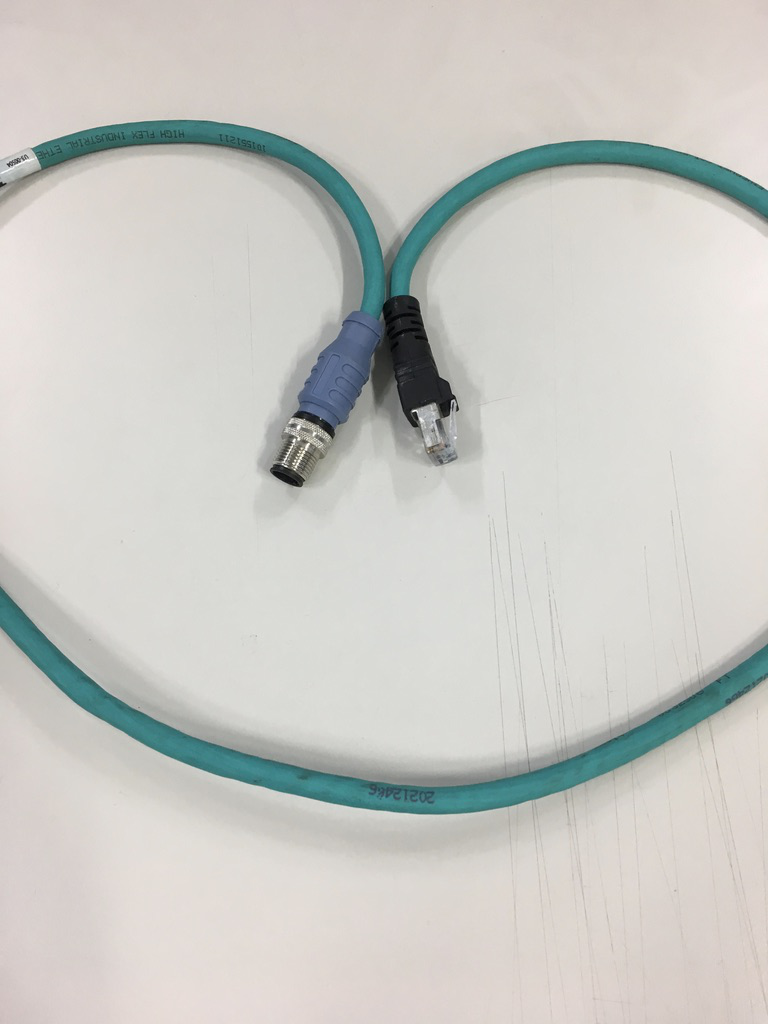
[picture p480: figure]

Moxa Switch hub

Ethernet for Laptop

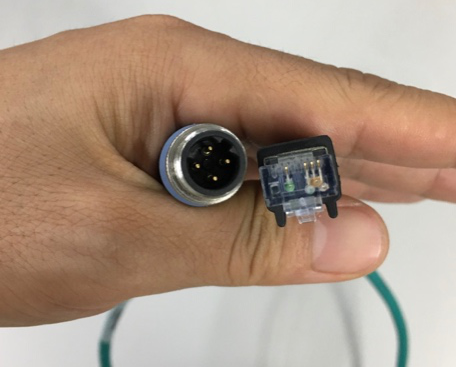
[picture p481: figure]

## Slide 2

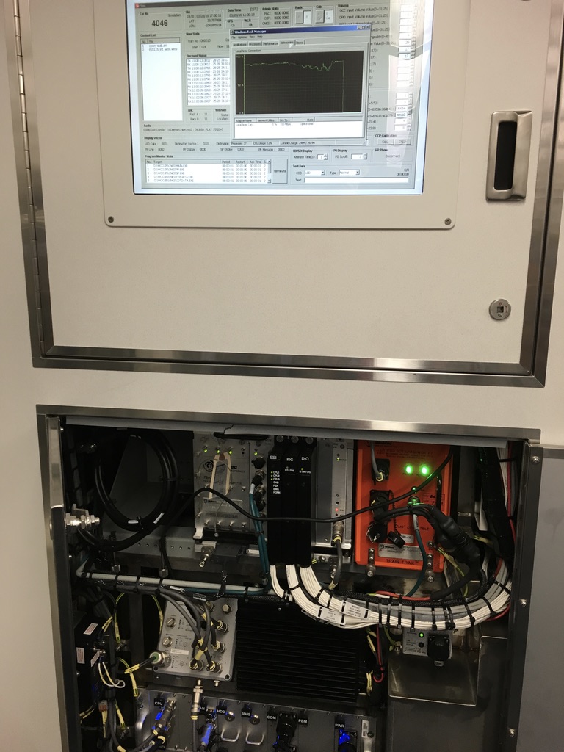
[picture p482: figure]

Moxa Switch hub connect laptop

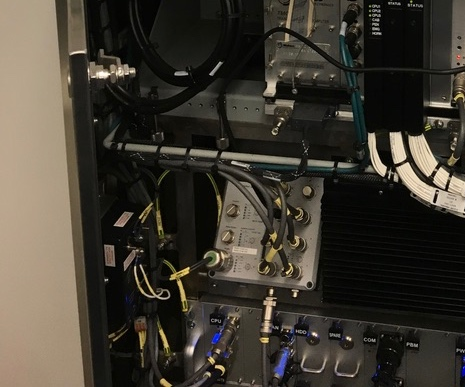
[picture p483: figure]

## Slide 3

1. VOIP Connection Check

1. Connect cable to laptop on one side and Moxa Switch hub on the other
2. Change laptop IP address to match car number
Ex) 10.xx.yy.223(xx.yy is car number 40.15 for car 4015, the last digits 223 is for laptop)
3. Open Windows command window
4. Type “ping 10.xx.yy.199” and then Enter
5. Check ping test

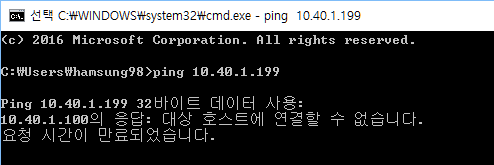
[picture p484: figure]
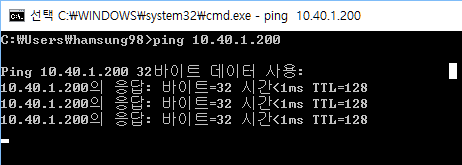
[picture p485: figure]

199

199

199

199

199

6. If VOIP passes the ping test then VOIP Local status is good

Voip not connected

Voip connected

## Slide 4

2. VOIP status check

1. Voip can only be accessed using Internet Explorer browser
2. In the Explorer address bar enter http://10.xx.yy.199


3. If what is shown looks the same as above then the VOIP setttings are good

## Slide 5

3. CNCS connection check

1. Connect cable to laptop on one side and Moxa Switch hub on the other
2. Change laptop IP address to match car number
Ex) 10.xx.yy.223(xx.yy is car number 40.15 for car 4015, the last digits 223 is for laptop)
3. Open Windows command window
4. Type “ping 10.xx.yy.200” and then Enter
5. Check ping test

CNCS not connected

200

200

200

6. If ping test shows CNCS is connected, then CNCS connection is good
7. Check CNCS’s network status and if the gateway is set as 10.xx.yy.201 then the settings are good

CNCS connected

## Slide 6

4. CNCS SIP Status Check

1. Connect keyboard to CNCS
2. Press Alt+Tab keys and check if the Woojin TrainCar SIPPhone V1.0 program is still running

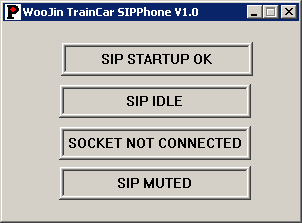
[picture p486: figure]

3. If the above program is still running, then SIP is good
