JDSCS-Club/DENVER_CCP/DOC/06_이슈_대응/CNCS_발열/04_데이터시트/X945-L2400_guide page 20.pdf

## 3.1 Heatspreader Dimensions

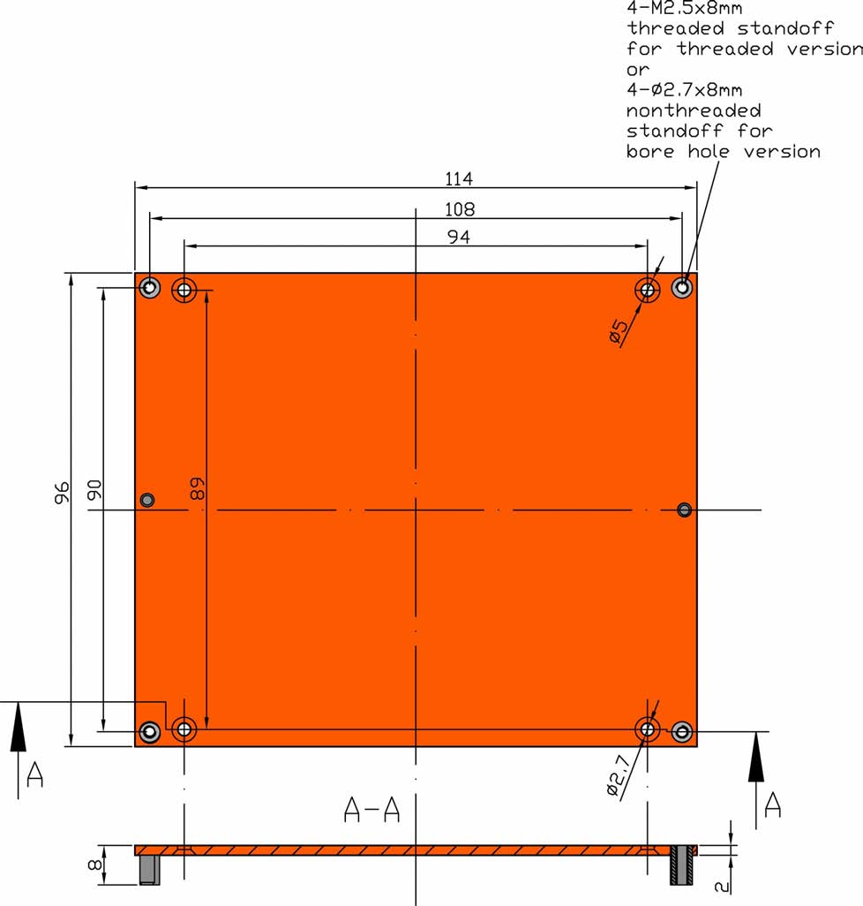
[picture p504: figure]

Note

All measurements are in millimeters. Torque specification for heatspreader screws is 0.5 Nm.

Copyright © 2006 congatec AG | X945m12 | 20/101
