JDSCS-Club/DENVER_CCP/DOC/01_인터페이스_설계/MDS_ICD/01_ICD_문서/DDN-0432-0064-R01 Mechanical Assembly and Layout.pdf

# Quester Tangent Corporation

## Denver Regional Transportation District (Denver RTD) Contract N8US-30-F0003

# Monitoring and Diagnostic System (MDS)

# Mechanical Assembly and Layout

Prepared by: | Steve Dyck
| Hardware Team Lead
Verified by: | Christian Leclerc
| Software Team Lead
Approved by: | Greg Nuttall
| Project Engineer

## Issue Date: October 19, 2011 Document Number: DDN-0432-0064 Revision: R01


Eagle P3 Monitoring and Diagnostic System | Mechanical Assembly and Layout
DDN-0432-0064-R01 | 2 of 4
DATE | REVISION | DESCRIPTION
02-Sept-2011 | R00 | Initial version
19-Oct-2011 | R01 | Removed Input Ethernet Module references

COPYRIGHT
Copyright © 2011 by Quester Tangent Corporation. All rights reserved. This item and the information contained herein are the property of Quester Tangent Corporation. No part of this document may be reproduced, transmitted, stored in a retrieval system, or translated into any language or computer language in any form or by any means, electronic, mechanical, magnetic, optical, chemical, manual, or otherwise, without the express written permission of Quester Tangent Corporation.

Quester Tangent Corporation
6582 Bryn Road
Saanichton, B.C., Canada V8M 1X6 Tel: 250-656-6677
Fax: 250-655-4696
www.questertangent.com

# List of Tables

Table 1: Mechanical Assembly Drawings

HYUNDAI-ROTEM DRAWING NUMBER | QUESTER TANGENT DRAWING NUMBER | TITLE | NOTES
| DAS-MS10-0001 | Central Diagnostic Terminal – Assembly
| DAS-DS06-0001 | Fault Display Panel – Assembly

Table 2: Installed Dimensions Drawings

HYUNDAI-ROTEM DRAWING NUMBER | QUESTER TANGENT DRAWING NUMBER | TITLE | NOTES
| DMC-MS10-0001 | Central Diagnostic Terminal – Installed Dimensions
| DMC-DS06-0001 | Fault Display Panel – Installed Dimensions
