JDSCS-Club/DENVER_CCP/DOC/09_발표_보고/04_장치별_기술/ISP 조립 과정.pptx

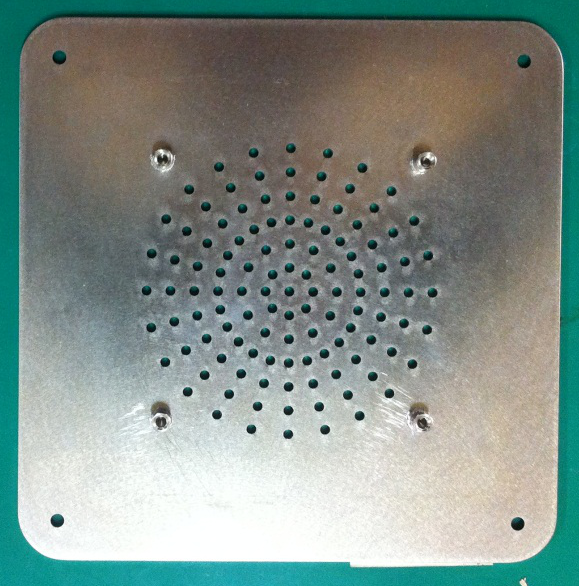
[picture p505: figure]
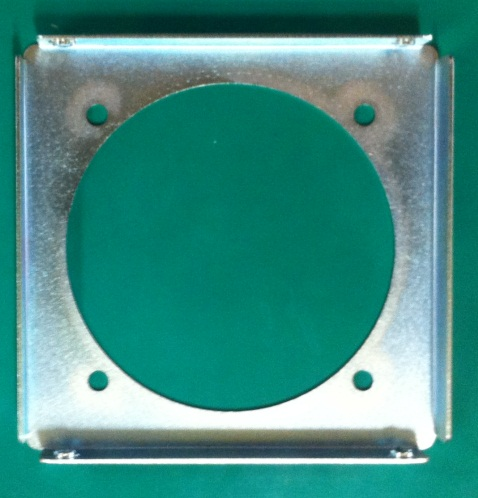
[picture p506: figure]
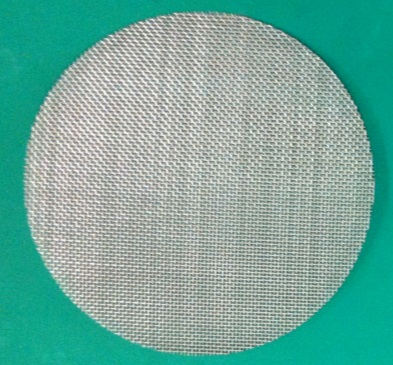
[picture p507: figure]
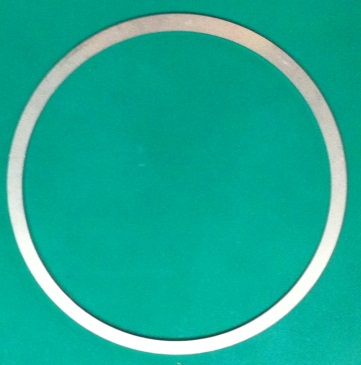
[picture p508: figure]
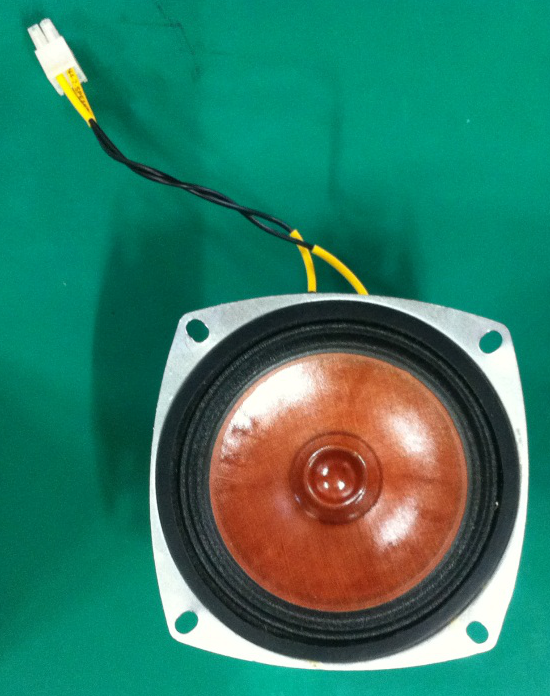
[picture p509: figure]
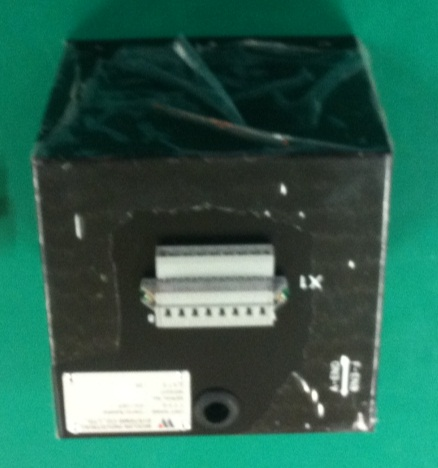
[picture p510: figure]
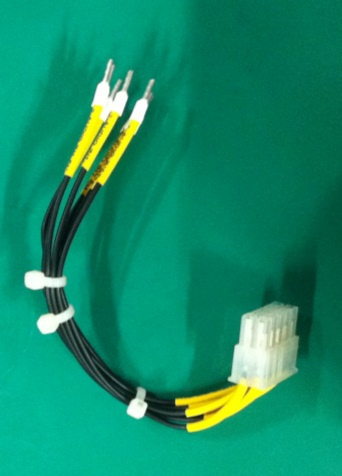
[picture p511: figure]
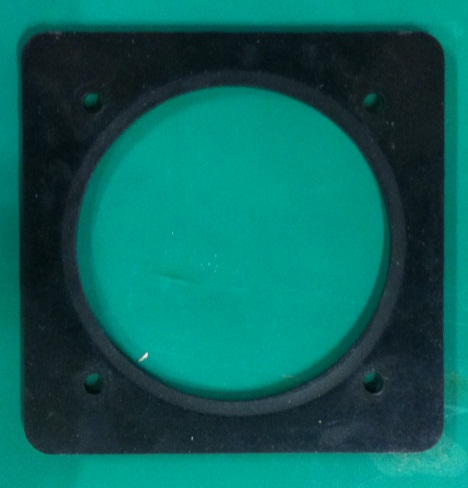
[picture p512: figure]
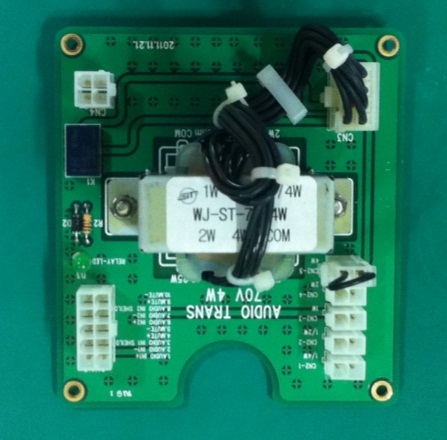
[picture p513: figure]

## Slide 2

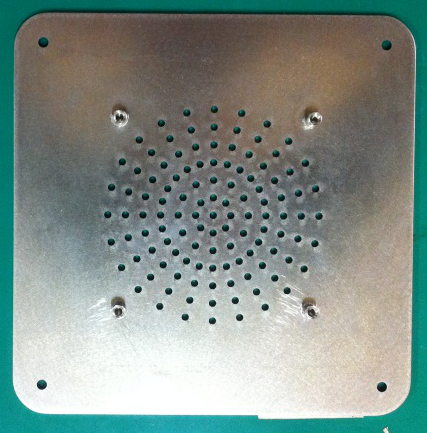
[picture p514: figure]

+

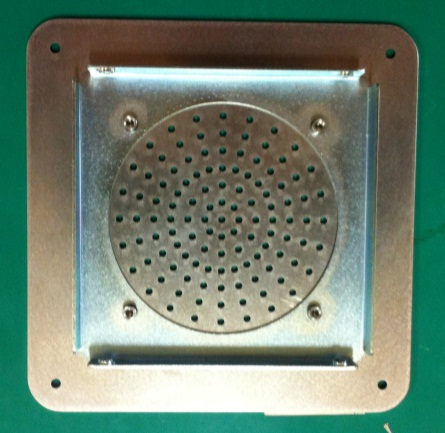
[picture p515: figure]

=

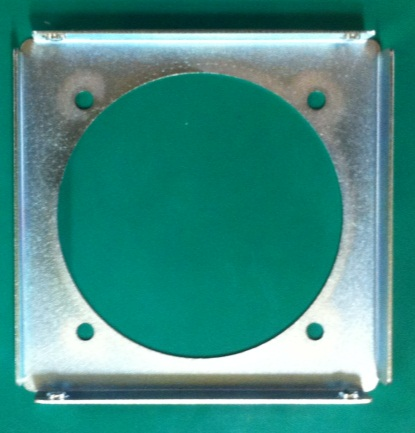
[picture p516: figure]

## Slide 3

+

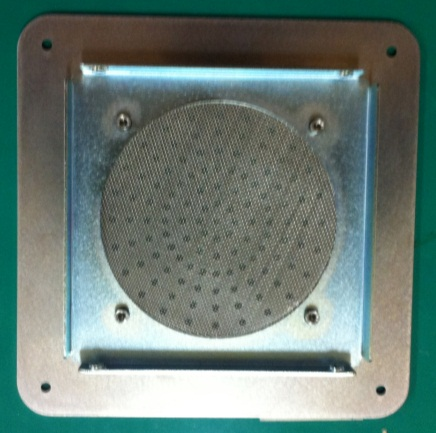
[picture p517: figure]

=

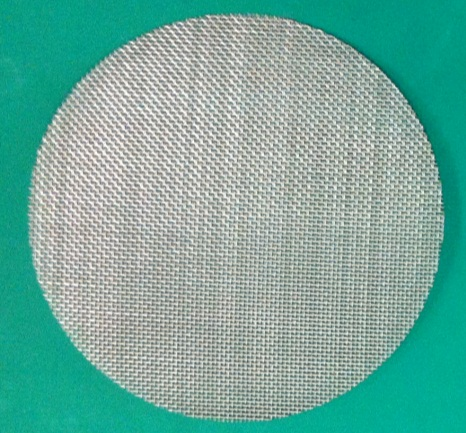
[picture p518: figure]

## Slide 4

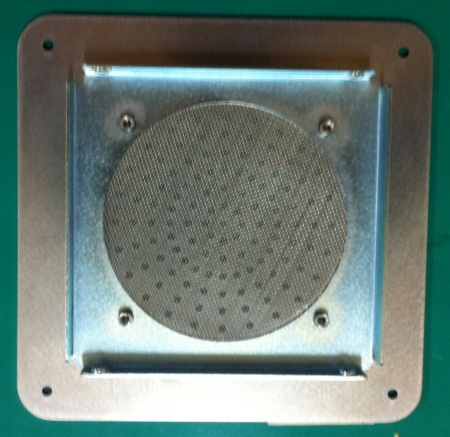
[picture p519: figure]

+

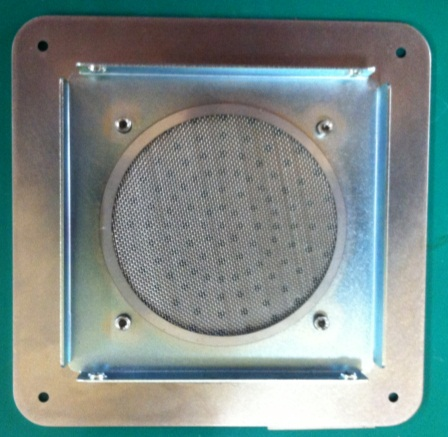
[picture p520: figure]

=

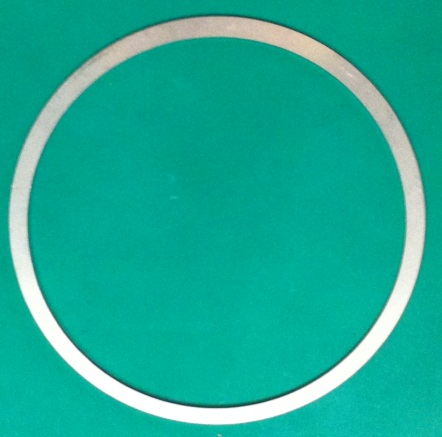
[picture p521: figure]

## Slide 5

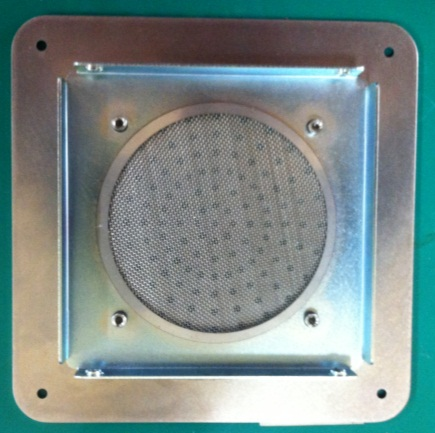
[picture p522: figure]

+

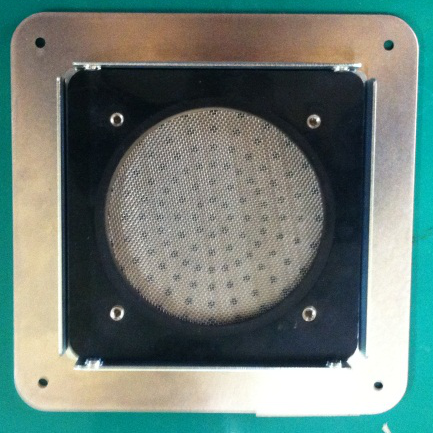
[picture p523: figure]

=

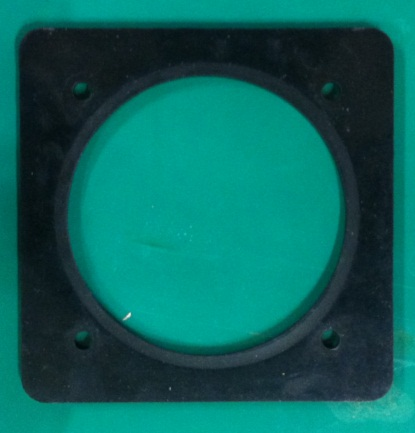
[picture p524: figure]

## Slide 6

+

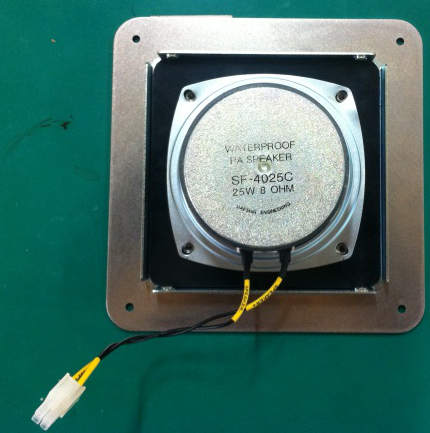
[picture p525: figure]

=

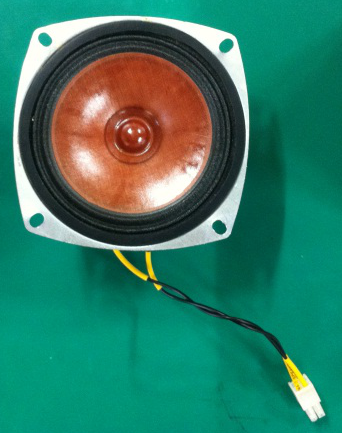
[picture p526: figure]

## Slide 7

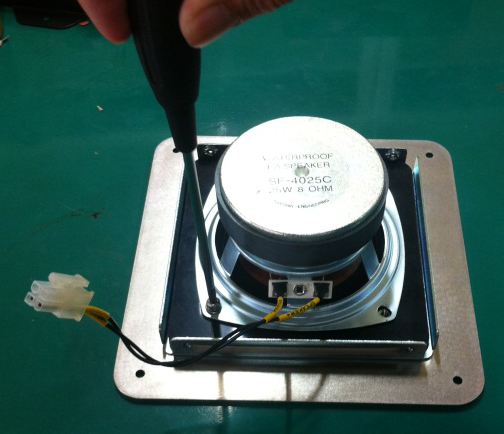
[picture p527: figure]

## Slide 8

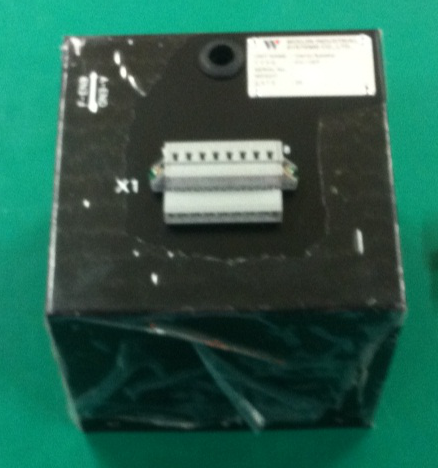
[picture p528: figure]
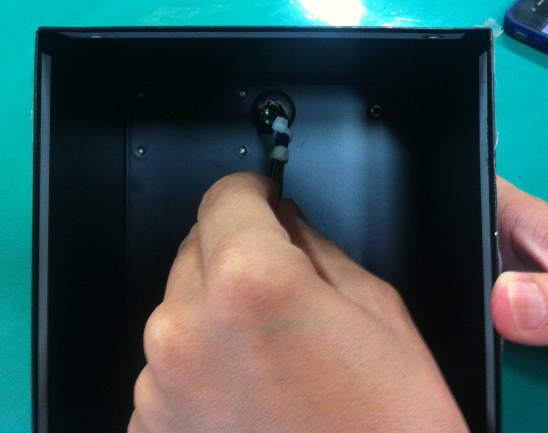
[picture p529: figure]
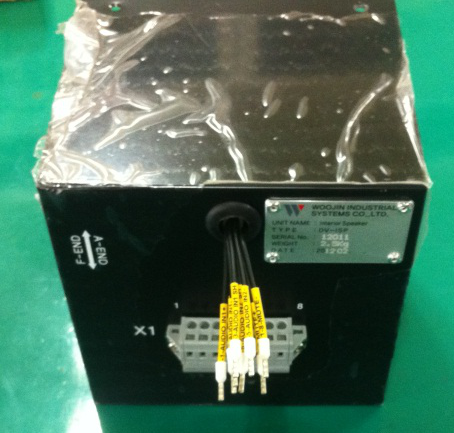
[picture p530: figure]

## Slide 9

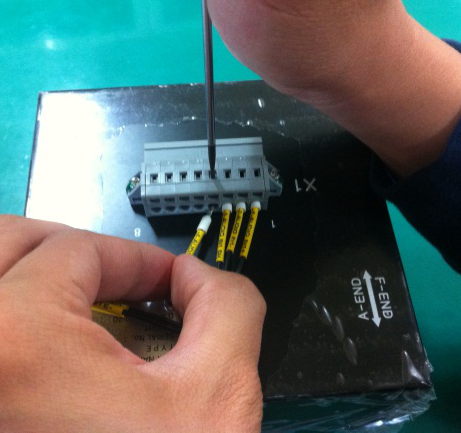
[picture p531: figure]
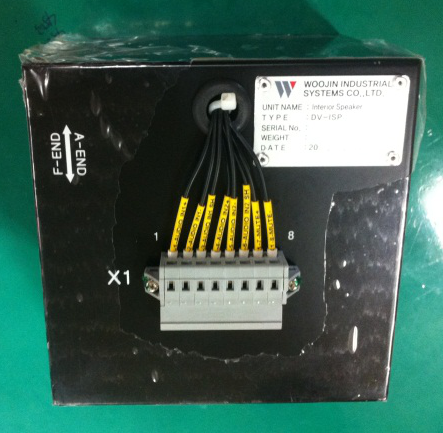
[picture p532: figure]

## Slide 10

+

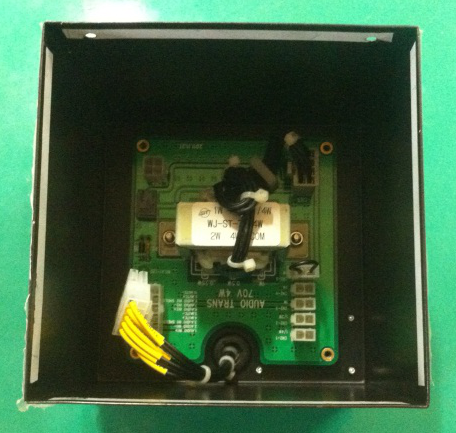
[picture p533: figure]
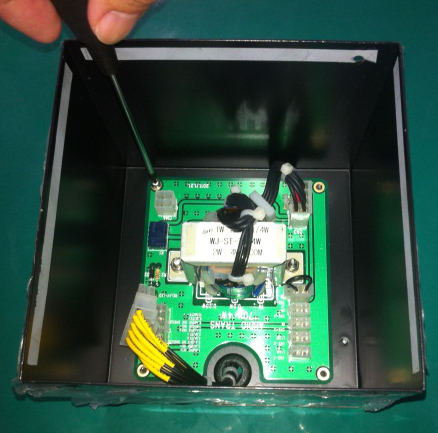
[picture p534: figure]

=

## Slide 11

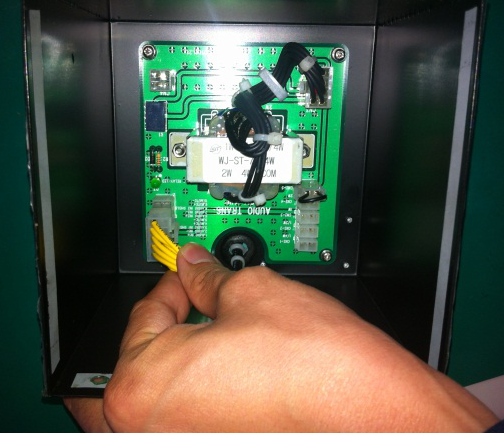
[picture p535: figure]

## Slide 12

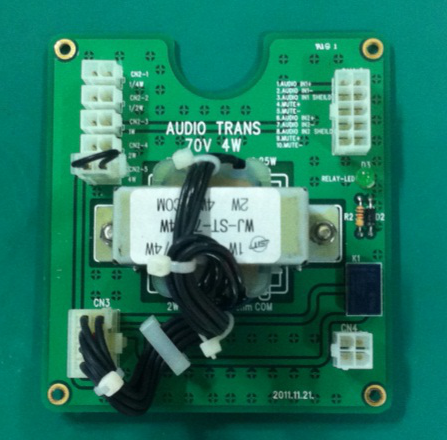
[picture p536: figure]
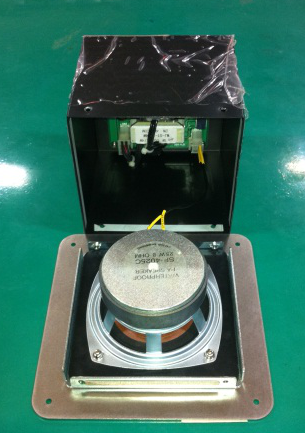
[picture p537: figure]
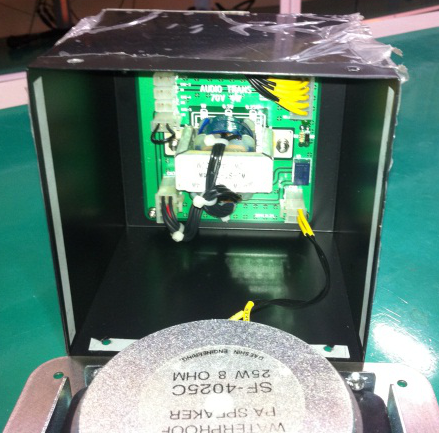
[picture p538: figure]

## Slide 13

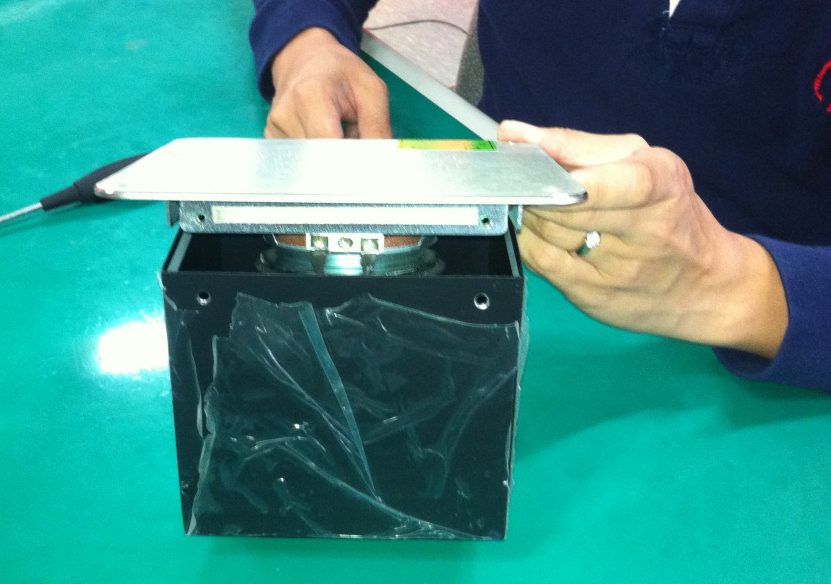
[picture p539: figure]
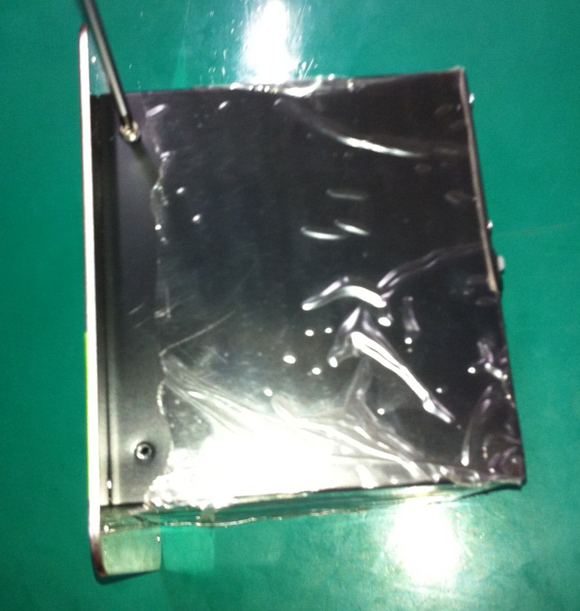
[picture p540: figure]

## Slide 14

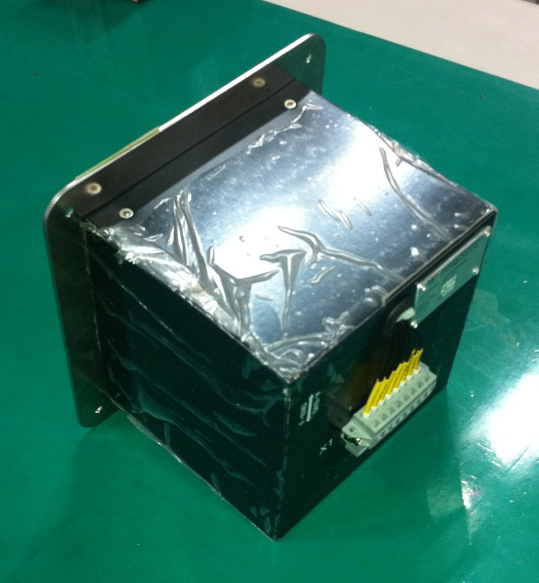
[picture p541: figure]

## Slide 15
