JDSCS-Club/DENVER_CCP/DOC/01_인터페이스_설계/WiMAX_Wayside/03_Penta_PA/Penta PA System Operational Overview.docx

# 1 Penta PA System Operational Overview

The Penta PA system currently interfaces its OCC master server and PA Operator consoles via a WAN to a set of “boxes” based on Windows PCs that remotely located.

Each remote “box” contains software that supports a VOIP stream from the OCC transported via UDP packets.

The audio stream is channeled to one or more computer audio “blaster” outputs, and via various electronic components, to speakers. The Penta protocol supports control data packets in addition to the VOIP stream.

The “box” also contains software that supports text message displaying on various configured signs that are physically placed within the “box’s” local environment, which in most cases is a train station platform(s).

The “box” inputs a standard set of UDP protocol data packets from the host OCC via a Penta specific protocol.

The sign sub-system messaging tells the “box” what to say, on which sign(s) to say it, and how long to say it. The “box” takes this information received from the OCC and converts it to native sign protocol packets, which are transported to the physical signs via serial links or Ethernet.

# 2 Information Required from Woojin

The following information is needed from Woojin so that Penta can progress with its interface to the train PA hardware via the mobile WAN:

a) Does Woojin currently have an “office head-end system” for the transport of audio and sign messages to their trains via a mobile WAN, and if so, can we have copies of the documents defining the interface at the application level? We need a protocol document of the data packets going back and forth for audio and sign messaging.

: 우진도 “office head-end system” 시스템을 가지고 있지 않다.

우진도 로템를 통해 PDR 미팅시 OCC Interface 업체가 선정되면, 업체로부터 “office head-end system” 관련 Interface 문서를 받고 싶다고 했다.

b) If there is no current “office system,” does Woojin have an application interface document detailing the packets to/from the train PA system via a mobile WAN?

: 우진 산전은 현재 상세 문서를 작성 중이며, FDR 미팅시 작업된 부분 까지 제공해 주겠다.

c) For the PA audio, we need to know the details of the VOIP data stream:

What is the codec type and its data rate?

Is there any control data protocol used in addition to the VOIP data stream or does the presence of a data stream in itself control the audio to the speakers?

VoIP Signaling Protocols | SIP (http://www.audiocodes.com/glossary/sip) - RFC 3261, 3262, 3263, 3264, 2327
Media Processing(Audio Codec) | Voice Coders - G.711, G.723.1, G.729A/B, G.726, GSM FR, iLBC Wideband Coders – G.722, G.722.2 (WB-AMR), G.711.1 Echo Cancelation – G.168-2004 compliant, 64 msec tail length
Telephony Signaling | DTMF – TIA464B Programmable Call-Progress Tones
Packetization | RTP/RTCP Packetization – RFC 3550, 3551, 2198 DTMF Relay - RFC 2833

d) For the PA signs, we need to know the physical details and transport protocol:

- How many signs are there on the train and are they all the same size and display format ?

차량에는 3가지 데이터 타입이 필요한다.

LCD : PP 프로토콜 타입.

SP 프로토콜 타입.

LED : PII 프로토콜 타입.

Do they all receive the same message at the same time?

위 프로우 차트에 따라 진행 된다.

- What is the sign display format: scrolling, multi-line, etc., and what information does Woojin need from Penta to provide a single message text content and format information?

우진 산전이 작성중인 상세 Interface 문서에 PP/SP/PII 프로토콜에 대하여 작성 중에 있다.

- Is the data transport via UDP or TCP sockets?

VOIP : TCP/IP

컨트롤 데이터 : UDP

우진 산전이 작성중인 상세 Interface 문서에 위 내용을 포함 한다.

- What is the format of the application level data packets used to send the sign information including how to specify a particular sign or signs (if necessary)?

PP,SP 및 PII 의 별도 Format 을 생성 한다.

- It is assumed that the signs are used for several other sources of messages. Is there a priority scheme for the OCC messages vs. the other messages on the signs?

OCC에서 전송 하는 모든 데이터에는 우선 순위가 있다.

Ex: Level 0 : 차량 자동 방송 우선.

Level 1 : OCC 우선 순의

- Is there any way to determine if the link between the OCC and an individual train is alive, for example a heartbeat message or a request for status message?

OCC에서 차량의 상태정보를 요청하는 방식이 있고, 차량이 살았을 경우, 주기적으로 차량 상태 정보를 주기적으로 전송함으로, 차량의 연결 상태를 알 수 있음.

- Are there any messages established so that the OCC can gather various equipment failure statuses from the train?

OCC에서 차량의 상태정보를 요청하는 방식이 있고, 차량이 살았을 경우, 주기적으로 차량 상태 정보를 주기적으로 전송함으로, 차량의 연결 상태를 알 수 있음.
