JDSCS-Club/DENVER_CCP/DOC/11_SW코드/lic/cpld/decoder/usage_statistics_webtalk.html

### Device Usage Page (usage_statistics_webtalk.html)

This HTML page displays the device usage statistics that will be sent to Xilinx.

Software Version and Target Device
Product Version: | ISE:13.1 (WebPack) - O.40d | Target Family: | Spartan3
OS Platform: | NT | Target Device: | xc3s200
Project ID (random number) | 0de4cac598594239aacfaead033cc507.14E1793901414CE4ABE1DF79D2C8C956.162 | Target Package: | vq100
Registration ID | 174675779_0_0_913 | Target Speed: | -5
Date Generated | 2012-05-15T17:58:32 | Tool Flow | ISE

User Environment
OS Name | Microsoft Windows XP Professional | OS Release | Service Pack 3 (build 2600)
CPU Name | Intel(R) Core(TM) i7-2640M CPU @ 2.80GHz | CPU Speed | 2790 MHz

Device Usage Statistics
Macro Statistics | Miscellaneous Statistics | Net Statistics | Site Usage

Adders/Subtractors=1

16-bit adder=1

Comparators=3

16-bit comparator less=2

23-bit comparator less=1

Counters=4

16-bit up counter=2

23-bit up counter=1

3-bit up counter=1

Latches=14

1-bit latch=14

Registers=61

Flip-Flops=61

MiscellaneousStatistics

AGG_BONDED_IO=63

AGG_IO=63

AGG_SLICE=146

NUM_4_INPUT_LUT=252

NUM_BONDED_IOB=63

NUM_BUFGMUX=2

NUM_CYMUX=78

NUM_IOB_FF=6

NUM_IOB_LATCH=4

NUM_LUT_RT=65

NUM_RAMB16=1

NUM_SLICEL=146

NUM_SLICE_FF=108

NUM_SLICE_LATCH=14

NUM_XOR=66

Xilinx Core blk_mem_gen_v6_1, Xilinx CORE Generator 13.1=1

NetStatistics

NumNets_Active=412

NumNets_Gnd=1

NumNets_Vcc=1

NumNodesOfType_Active_BRAMADDR=22

NumNodesOfType_Active_BRAMDUMMY=16

NumNodesOfType_Active_CLKPIN=95

NumNodesOfType_Active_CNTRLPIN=164

NumNodesOfType_Active_DOUBLE=857

NumNodesOfType_Active_DUMMY=714

NumNodesOfType_Active_DUMMYESC=37

NumNodesOfType_Active_GLOBAL=37

NumNodesOfType_Active_HFULLHEX=21

NumNodesOfType_Active_HLONG=4

NumNodesOfType_Active_HUNIHEX=83

NumNodesOfType_Active_INPUT=805

NumNodesOfType_Active_IOBOUTPUT=38

NumNodesOfType_Active_OMUX=322

NumNodesOfType_Active_OUTPUT=314

NumNodesOfType_Active_PREBXBY=27

NumNodesOfType_Active_VFULLHEX=66

NumNodesOfType_Active_VLONG=26

NumNodesOfType_Active_VUNIHEX=86

NumNodesOfType_Gnd_BRAMDUMMY=2

NumNodesOfType_Gnd_CNTRLPIN=2

NumNodesOfType_Gnd_DOUBLE=7

NumNodesOfType_Gnd_INPUT=16

NumNodesOfType_Gnd_OMUX=14

NumNodesOfType_Gnd_OUTPUT=14

NumNodesOfType_Gnd_PREBXBY=4

SiteStatistics

IOB-DIFFM=31

IOB-DIFFS=31

SLICEL-SLICEM=78

SiteSummary

BUFGMUX=2

BUFGMUX_GCLKMUX=2

BUFGMUX_GCLK_BUFFER=2

IOB=63

IOB_DELAY=2

IOB_IFF1=2

IOB_INBUF=36

IOB_OFF1=6

IOB_OFF2=1

IOB_OUTBUF=35

IOB_PAD=63

IOB_TFF1=1

RAMB16=1

RAMB16_RAMB16=1

RAMB16_RAMB16A=1

RAMB16_RAMB16B=1

SLICEL=146

SLICEL_C1VDD=4

SLICEL_C2VDD=4

SLICEL_CYMUXF=40

SLICEL_CYMUXG=38

SLICEL_F=128

SLICEL_F5MUX=10

SLICEL_FFX=68

SLICEL_FFY=54

SLICEL_G=124

SLICEL_GNDF=36

SLICEL_GNDG=34

SLICEL_XORF=34

SLICEL_XORG=32

Configuration Data

BUFGMUX

S=[S_INV:2] [S:0]

BUFGMUX_GCLKMUX

DISABLE_ATTR=[LOW:2]

S=[S_INV:2] [S:0]

IOB

ICE=[ICE:1] [ICE_INV:1]

ICLK1=[ICLK1_INV:2] [ICLK1:0]

O1=[O1_INV:0] [O1:34]

O2=[O2:1] [O2_INV:0]

OCE=[OCE:4] [OCE_INV:1]

OTCLK1=[OTCLK1_INV:4] [OTCLK1:3]

OTCLK2=[OTCLK2_INV:1] [OTCLK2:0]

SR=[SR:0] [SR_INV:10]

T1=[T1_INV:0] [T1:17]

IOB_IFF1

CE=[CE:1] [CE_INV:1]

CK=[CK:0] [CK_INV:2]

IFF1_INIT_ATTR=[INIT0:1] [INIT1:1]

IFF1_SR_ATTR=[SRLOW:1] [SRHIGH:1]

IFFATTRBOX=[ASYNC:2]

LATCH_OR_FF=[FF:2]

SR=[SR:0] [SR_INV:2]

IOB_OFF1

CE=[CE:3] [CE_INV:1]

CK=[CK:2] [CK_INV:4]

D=[D:6] [D_INV:0]

LATCH_OR_FF=[FF:3] [LATCH:3]

OFF1_INIT_ATTR=[INIT0:3] [INIT1:3]

OFF1_SR_ATTR=[SRLOW:3] [SRHIGH:3]

OFFATTRBOX=[ASYNC:5] [SYNC:1]

SR=[SR:0] [SR_INV:6]

IOB_OFF2

CE=[CE:1] [CE_INV:0]

CK=[CK:0] [CK_INV:1]

D=[D:1] [D_INV:0]

LATCH_OR_FF=[LATCH:1]

OFF2_INIT_ATTR=[INIT1:1]

OFF2_SR_ATTR=[SRHIGH:1]

OFFATTRBOX=[ASYNC:1]

SR=[SR:0] [SR_INV:1]

IOB_OUTBUF

IN=[IN_INV:0] [IN:35]

TRI=[TRI_INV:0] [TRI:17]

IOB_PAD

DRIVEATTRBOX=[12:33] [24:2]

IOATTRBOX=[LVCMOS33:63]

PULL=[PULLUP:16]

SLEW=[SLOW:35]

IOB_TFF1

CK=[CK:1] [CK_INV:0]

D=[D:1] [D_INV:0]

LATCH_OR_FF=[FF:1]

SR=[SR:0] [SR_INV:1]

TFF1_INIT_ATTR=[INIT0:1]

TFF1_SR_ATTR=[SRLOW:1]

TFFATTRBOX=[SYNC:1]

RAMB16

CLKA=[CLKA_INV:0] [CLKA:1]

CLKB=[CLKB_INV:0] [CLKB:1]

ENA=[ENA_INV:0] [ENA:1]

ENB=[ENB_INV:0] [ENB:1]

SSRA=[SSRA_INV:0] [SSRA:1]

SSRB=[SSRB_INV:0] [SSRB:1]

WEA=[WEA:1] [WEA_INV:0]

WEB=[WEB:0] [WEB_INV:1]

RAMB16_RAMB16A

CLKA=[CLKA_INV:0] [CLKA:1]

ENA=[ENA_INV:0] [ENA:1]

PORTA_ATTR=[2048X9:1]

SSRA=[SSRA_INV:0] [SSRA:1]

WEA=[WEA:1] [WEA_INV:0]

WRITEMODEA=[WRITE_FIRST:1]

RAMB16_RAMB16B

CLKB=[CLKB_INV:0] [CLKB:1]

ENB=[ENB_INV:0] [ENB:1]

PORTB_ATTR=[2048X9:1]

SSRB=[SSRB_INV:0] [SSRB:1]

WEB=[WEB:0] [WEB_INV:1]

WRITEMODEB=[WRITE_FIRST:1]

SLICEL

BX=[BX_INV:0] [BX:23]

BY=[BY:14] [BY_INV:1]

CE=[CE:23] [CE_INV:30]

CIN=[CIN_INV:0] [CIN:35]

CLK=[CLK:49] [CLK_INV:34]

SR=[SR:0] [SR_INV:61]

SLICEL_CYMUXF

0=[0:40] [0_INV:0]

1=[1_INV:0] [1:40]

SLICEL_CYMUXG

0=[0:38] [0_INV:0]

SLICEL_F5MUX

S0=[S0:10] [S0_INV:0]

SLICEL_F6MUX

S0=[S0:1] [S0_INV:0]

SLICEL_FFX

CE=[CE:17] [CE_INV:28]

CK=[CK:42] [CK_INV:26]

D=[D:68] [D_INV:0]

FFX_INIT_ATTR=[INIT0:59] [INIT1:9]

FFX_SR_ATTR=[SRLOW:59] [SRHIGH:9]

LATCH_OR_FF=[FF:60] [LATCH:8]

SR=[SR:0] [SR_INV:48]

SYNC_ATTR=[ASYNC:68]

SLICEL_FFY

CE=[CE:11] [CE_INV:29]

CK=[CK:29] [CK_INV:25]

D=[D:53] [D_INV:1]

FFY_INIT_ATTR=[INIT0:46] [INIT1:8]

FFY_SR_ATTR=[SRLOW:46] [SRHIGH:8]

LATCH_OR_FF=[FF:48] [LATCH:6]

SR=[SR:0] [SR_INV:41]

SYNC_ATTR=[ASYNC:53] [SYNC:1]

SLICEL_XORF

1=[1_INV:0] [1:34]

SLICEM

BY=[BY:1] [BY_INV:0]

CLK=[CLK:1] [CLK_INV:0]

SR=[SR:1] [SR_INV:0]

SLICEM_FFY

CK=[CK:1] [CK_INV:0]

D=[D:1] [D_INV:0]

FFY_INIT_ATTR=[INIT0:1]

FFY_SR_ATTR=[SRLOW:1]

LATCH_OR_FF=[FF:1]

SYNC_ATTR=[ASYNC:1]

SLICEM_G

DI=[DI:1] [DI_INV:0]

G_ATTR=[SHIFT_REG:1]

LUT_OR_MEM=[RAM:1]

SLICEM_WSGEN

CK=[CK:1] [CK_INV:0]

SYNC_ATTR=[ASYNC:1]

WE=[WE_INV:0] [WE:1]

Pin Data

BUFGMUX

I0=2

O=2

S=2

BUFGMUX_GCLKMUX

I0=2

OUT=2

S=2

BUFGMUX_GCLK_BUFFER

IN=2

OUT=2

IOB

I=36

ICE=2

ICLK1=2

IQ1=2

O1=34

O2=1

OCE=5

OTCLK1=7

OTCLK2=1

PAD=63

SR=10

T1=17

IOB_DELAY

IN=2

OUT=2

IOB_IFF1

CE=2

CK=2

D=2

Q=2

SR=2

IOB_INBUF

IN=36

OUT=36

IOB_OFF1

CE=4

CK=6

D=6

Q=6

SR=6

IOB_OFF2

CE=1

CK=1

D=1

Q=1

SR=1

IOB_OUTBUF

IN=35

OUT=35

TRI=17

IOB_PAD

PAD=63

IOB_TFF1

CK=1

D=1

Q=1

SR=1

RAMB16

ADDRA10=1

ADDRA11=1

ADDRA12=1

ADDRA13=1

ADDRA3=1

ADDRA4=1

ADDRA5=1

ADDRA6=1

ADDRA7=1

ADDRA8=1

ADDRA9=1

ADDRB10=1

ADDRB11=1

ADDRB12=1

ADDRB13=1

ADDRB3=1

ADDRB4=1

ADDRB5=1

ADDRB6=1

ADDRB7=1

ADDRB8=1

ADDRB9=1

CLKA=1

CLKB=1

DIA0=1

DIA1=1

DIA2=1

DIA3=1

DIA4=1

DIA5=1

DIA6=1

DIA7=1

DIB0=1

DIB1=1

DIB2=1

DIB3=1

DIB4=1

DIB5=1

DIB6=1

DIB7=1

DIPA0=1

DIPB0=1

DOA0=1

DOA1=1

DOA2=1

DOA3=1

DOA4=1

DOA5=1

DOA6=1

DOA7=1

DOB0=1

DOB1=1

DOB2=1

DOB3=1

DOB4=1

DOB5=1

DOB6=1

DOB7=1

ENA=1

ENB=1

SSRA=1

SSRB=1

WEA=1

WEB=1

RAMB16_RAMB16

ADDRA=1

ADDRB=1

DIA=1

DIB=1

DOA=1

DOB=1

RAMB16_RAMB16A

ADDRA=1

ADDRA10=1

ADDRA11=1

ADDRA12=1

ADDRA13=1

ADDRA3=1

ADDRA4=1

ADDRA5=1

ADDRA6=1

ADDRA7=1

ADDRA8=1

ADDRA9=1

CLKA=1

DIA=1

DIA0=1

DIA1=1

DIA2=1

DIA3=1

DIA4=1

DIA5=1

DIA6=1

DIA7=1

DIPA0=1

DOA=1

DOA0=1

DOA1=1

DOA2=1

DOA3=1

DOA4=1

DOA5=1

DOA6=1

DOA7=1

ENA=1

SSRA=1

WEA=1

RAMB16_RAMB16B

ADDRB=1

ADDRB10=1

ADDRB11=1

ADDRB12=1

ADDRB13=1

ADDRB3=1

ADDRB4=1

ADDRB5=1

ADDRB6=1

ADDRB7=1

ADDRB8=1

ADDRB9=1

CLKB=1

DIB=1

DIB0=1

DIB1=1

DIB2=1

DIB3=1

DIB4=1

DIB5=1

DIB6=1

DIB7=1

DIPB0=1

DOB=1

DOB0=1

DOB1=1

DOB2=1

DOB3=1

DOB4=1

DOB5=1

DOB6=1

DOB7=1

ENB=1

SSRB=1

WEB=1

SLICEL

BX=23

BY=15

CE=53

CIN=35

CLK=83

COUT=38

F1=124

F2=87

F3=81

F4=50

G1=124

G2=91

G3=80

G4=65

SR=61

X=64

XQ=68

Y=69

YQ=54

SLICEL_C1VDD

1=4

SLICEL_C2VDD

1=4

SLICEL_CYMUXF

0=40

1=40

OUT=40

S0=40

SLICEL_CYMUXG

0=38

1=38

OUT=38

S0=38

SLICEL_F

A1=124

A2=87

A3=81

A4=50

D=128

SLICEL_F5MUX

F=10

G=10

OUT=10

S0=10

SLICEL_F6MUX

0=1

1=1

OUT=1

S0=1

SLICEL_FFX

CE=45

CK=68

D=68

Q=68

SR=48

SLICEL_FFY

CE=40

CK=54

D=54

Q=54

SR=41

SLICEL_G

A1=124

A2=91

A3=80

A4=65

D=124

SLICEL_GNDF

0=36

SLICEL_GNDG

0=34

SLICEL_XORF

0=34

1=34

O=34

SLICEL_XORG

0=32

1=32

O=32

SLICEM

BY=1

CLK=1

G1=1

G2=1

G3=1

G4=1

SR=1

YQ=1

SLICEM_FFY

CK=1

D=1

Q=1

SLICEM_G

A1=1

A2=1

A3=1

A4=1

D=1

DI=1

WS=1

SLICEM_WSGEN

CK=1

WE=1

WSG=1

Tool Usage

Command Line History

xst -intstyle ise -ifn <ise_file>

xst -intstyle ise -ifn <ise_file>

ngdbuild -intstyle ise -dd _ngo -nt timestamp -i -p xc3s200-vq100-5 <fname>.ngc <fname>.ngd

map -intstyle ise -p xc3s200-vq100-5 -cm area -ir off -pr off -c 100 -o <fname>.ncd <fname>.ngd <fname>.pcf

par -w -intstyle ise -ol high -t 1 <fname>.ncd <fname>.ncd <fname>.pcf

trce -intstyle ise -v 3 -s 5 -n 3 -fastpaths -xml <fname>.twx <fname>.ncd -o <fname>.twr <fname>.pcf

bitgen -intstyle ise -f <fname>.ut <fname>.ncd

xst -intstyle ise -ifn <ise_file>

ngdbuild -intstyle ise -dd _ngo -nt timestamp -i -p xc3s200-vq100-5 <fname>.ngc <fname>.ngd

map -intstyle ise -p xc3s200-vq100-5 -cm area -ir off -pr off -c 100 -o <fname>.ncd <fname>.ngd <fname>.pcf

par -w -intstyle ise -ol high -t 1 <fname>.ncd <fname>.ncd <fname>.pcf

trce -intstyle ise -v 3 -s 5 -n 3 -fastpaths -xml <fname>.twx <fname>.ncd -o <fname>.twr <fname>.pcf

xst -intstyle ise -ifn <ise_file>

xst -intstyle ise -ifn <ise_file>

xst -intstyle ise -ifn <ise_file>

xst -intstyle ise -ifn <ise_file>

xst -intstyle ise -ifn <ise_file>

xst -intstyle ise -ifn <ise_file>

xst -intstyle ise -ifn <ise_file>

xst -intstyle ise -ifn <ise_file>

xst -intstyle ise -ifn <ise_file>

xst -intstyle ise -ifn <ise_file>

xst -intstyle ise -ifn <ise_file>

xst -intstyle ise -ifn <ise_file>

xst -intstyle ise -ifn <ise_file>

xst -intstyle ise -ifn <ise_file>

xst -intstyle ise -ifn <ise_file>

xst -intstyle ise -ifn <ise_file>

xst -intstyle ise -ifn <ise_file>

xst -intstyle ise -ifn <ise_file>

xst -intstyle ise -ifn <ise_file>

xst -intstyle ise -ifn <ise_file>

xst -intstyle ise -ifn <ise_file>

xst -intstyle ise -ifn <ise_file>

xst -intstyle ise -ifn <ise_file>

ngdbuild -intstyle ise -dd _ngo -nt timestamp -i -p xc3s200-vq100-5 <fname>.ngc <fname>.ngd

map -intstyle ise -p xc3s200-vq100-5 -cm area -ir off -pr off -c 100 -o <fname>.ncd <fname>.ngd <fname>.pcf

xst -intstyle ise -ifn <ise_file>

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

par -w -intstyle ise -ol high -t 1 <fname>.ncd <fname>.ncd <fname>.pcf

trce -intstyle ise -v 3 -s 5 -n 3 -fastpaths -xml <fname>.twx <fname>.ncd -o <fname>.twr <fname>.pcf -ucf <fname>.ucf

bitgen -intstyle ise -f <fname>.ut <fname>.ncd

xst -intstyle ise -ifn <ise_file>

xst -intstyle ise -ifn <ise_file>

ngdbuild -intstyle ise -dd _ngo -nt timestamp -uc <fname>.ucf -p xc3s200-vq100-5 <fname>.ngc <fname>.ngd

map -intstyle ise -p xc3s200-vq100-5 -cm area -ir off -pr off -c 100 -o <fname>.ncd <fname>.ngd <fname>.pcf

par -w -intstyle ise -ol high -t 1 <fname>.ncd <fname>.ncd <fname>.pcf

trce -intstyle ise -v 3 -s 5 -n 3 -fastpaths -xml <fname>.twx <fname>.ncd -o <fname>.twr <fname>.pcf -ucf <fname>.ucf

bitgen -intstyle ise -f <fname>.ut <fname>.ncd

xst -intstyle ise -ifn <ise_file>

ngdbuild -intstyle ise -dd _ngo -nt timestamp -uc <fname>.ucf -p xc3s200-vq100-5 <fname>.ngc <fname>.ngd

map -intstyle ise -p xc3s200-vq100-5 -cm area -ir off -pr off -c 100 -o <fname>.ncd <fname>.ngd <fname>.pcf

par -w -intstyle ise -ol high -t 1 <fname>.ncd <fname>.ncd <fname>.pcf

trce -intstyle ise -v 3 -s 5 -n 3 -fastpaths -xml <fname>.twx <fname>.ncd -o <fname>.twr <fname>.pcf -ucf <fname>.ucf

bitgen -intstyle ise -f <fname>.ut <fname>.ncd

xst -intstyle ise -ifn <ise_file>

ngdbuild -intstyle ise -dd _ngo -nt timestamp -uc <fname>.ucf -p xc3s200-vq100-5 <fname>.ngc <fname>.ngd

map -intstyle ise -p xc3s200-vq100-5 -cm area -ir off -pr off -c 100 -o <fname>.ncd <fname>.ngd <fname>.pcf

par -w -intstyle ise -ol high -t 1 <fname>.ncd <fname>.ncd <fname>.pcf

trce -intstyle ise -v 3 -s 5 -n 3 -fastpaths -xml <fname>.twx <fname>.ncd -o <fname>.twr <fname>.pcf -ucf <fname>.ucf

bitgen -intstyle ise -f <fname>.ut <fname>.ncd

xst -intstyle ise -ifn <ise_file>

ngdbuild -intstyle ise -dd _ngo -nt timestamp -uc <fname>.ucf -p xc3s200-vq100-5 <fname>.ngc <fname>.ngd

map -intstyle ise -p xc3s200-vq100-5 -cm area -ir off -pr off -c 100 -o <fname>.ncd <fname>.ngd <fname>.pcf

par -w -intstyle ise -ol high -t 1 <fname>.ncd <fname>.ncd <fname>.pcf

trce -intstyle ise -v 3 -s 5 -n 3 -fastpaths -xml <fname>.twx <fname>.ncd -o <fname>.twr <fname>.pcf -ucf <fname>.ucf

bitgen -intstyle ise -f <fname>.ut <fname>.ncd

xst -intstyle ise -ifn <ise_file>

ngdbuild -intstyle ise -dd _ngo -nt timestamp -uc <fname>.ucf -p xc3s200-vq100-5 <fname>.ngc <fname>.ngd

map -intstyle ise -p xc3s200-vq100-5 -cm area -ir off -pr off -c 100 -o <fname>.ncd <fname>.ngd <fname>.pcf

par -w -intstyle ise -ol high -t 1 <fname>.ncd <fname>.ncd <fname>.pcf

bitgen -intstyle ise -f <fname>.ut <fname>.ncd

xst -intstyle ise -ifn <ise_file>

ngdbuild -intstyle ise -dd _ngo -nt timestamp -uc <fname>.ucf -p xc3s200-vq100-5 <fname>.ngc <fname>.ngd

map -intstyle ise -p xc3s200-vq100-5 -cm area -ir off -pr off -c 100 -o <fname>.ncd <fname>.ngd <fname>.pcf

par -w -intstyle ise -ol high -t 1 <fname>.ncd <fname>.ncd <fname>.pcf

trce -intstyle ise -v 3 -s 5 -n 3 -fastpaths -xml <fname>.twx <fname>.ncd -o <fname>.twr <fname>.pcf -ucf <fname>.ucf

bitgen -intstyle ise -f <fname>.ut <fname>.ncd

Software Quality
Run Statistics
_impact | 17 | 11 | 0 | 0 | 0 | 0 | 0
bitgen | 106 | 106 | 0 | 0 | 0 | 0 | 0
map | 114 | 114 | 0 | 0 | 0 | 0 | 0
ngcbuild | 3 | 3 | 0 | 0 | 0 | 0 | 0
ngdbuild | 117 | 117 | 0 | 0 | 0 | 0 | 0
par | 114 | 105 | 9 | 0 | 0 | 0 | 0
trce | 104 | 104 | 0 | 0 | 0 | 0 | 0
xst | 112 | 112 | 0 | 0 | 0 | 0 | 0

Project Statistics
PROP_Enable_Message_Filtering=false | PROP_FitterReportFormat=HTML
PROP_LastAppliedGoal=Balanced | PROP_LastAppliedStrategy=Xilinx Default (unlocked)
PROP_ManualCompileOrderImp=false | PROP_PropSpecInProjFile=Store all values
PROP_Simulator=Modelsim-SE VHDL | PROP_SynthOpt=Area
PROP_SynthTopFile=changed | PROP_Top_Level_Module_Type=HDL
PROP_UseSmartGuide=false | PROP_UserConstraintEditorPreference=Text Editor
PROP_intProjectCreationTimestamp=2012-04-30T14:40:18 | PROP_intWbtProjectID=14E1793901414CE4ABE1DF79D2C8C956
PROP_intWbtProjectIteration=162 | PROP_intWorkingDirLocWRTProjDir=Same
PROP_intWorkingDirUsed=No | PROP_xilxBitgCfg_Unused=Pull Up
PROP_AutoTop=true | PROP_DevFamily=Spartan3
PROP_DevDevice=xc3s200 | PROP_DevFamilyPMName=spartan3
PROP_DevPackage=vq100 | PROP_Synthesis_Tool=XST (VHDL/Verilog)
PROP_DevSpeed=-5 | PROP_PreferredLanguage=VHDL
FILE_UCF=1 | FILE_VHDL=2

Unisim Statistics
NGDBUILD_PRE_UNISIM_SUMMARY
NGDBUILD_NUM_BUFG=1 | NGDBUILD_NUM_BUFGP=1 | NGDBUILD_NUM_FDC=13 | NGDBUILD_NUM_FDCE=36
NGDBUILD_NUM_FDCE_1=12 | NGDBUILD_NUM_FDC_1=11 | NGDBUILD_NUM_FDE=30 | NGDBUILD_NUM_FDP=5
NGDBUILD_NUM_FDPE=1 | NGDBUILD_NUM_FDPE_1=3 | NGDBUILD_NUM_FDR=3 | NGDBUILD_NUM_GND=2
NGDBUILD_NUM_IBUF=27 | NGDBUILD_NUM_INV=14 | NGDBUILD_NUM_IOBUF=8 | NGDBUILD_NUM_LD=3
NGDBUILD_NUM_LDC_1=2 | NGDBUILD_NUM_LDP=3 | NGDBUILD_NUM_LDPE=10 | NGDBUILD_NUM_LUT1=65
NGDBUILD_NUM_LUT2=17 | NGDBUILD_NUM_LUT3=46 | NGDBUILD_NUM_LUT4=115 | NGDBUILD_NUM_MUXCY=78
NGDBUILD_NUM_MUXF5=10 | NGDBUILD_NUM_OBUF=18 | NGDBUILD_NUM_OBUFT=9 | NGDBUILD_NUM_VCC=2

NGDBUILD_NUM_XORCY=66
NGDBUILD_POST_UNISIM_SUMMARY
NGDBUILD_NUM_BUFG=2 | NGDBUILD_NUM_FDC=13 | NGDBUILD_NUM_FDCE=36 | NGDBUILD_NUM_FDCE_1=12
NGDBUILD_NUM_FDC_1=11 | NGDBUILD_NUM_FDE=30 | NGDBUILD_NUM_FDP=5 | NGDBUILD_NUM_FDPE=1
NGDBUILD_NUM_FDPE_1=3 | NGDBUILD_NUM_FDR=3 | NGDBUILD_NUM_GND=2 | NGDBUILD_NUM_IBUF=35
NGDBUILD_NUM_IBUFG=1 | NGDBUILD_NUM_INV=14 | NGDBUILD_NUM_LD=3 | NGDBUILD_NUM_LDC_1=2
NGDBUILD_NUM_LDP=3 | NGDBUILD_NUM_LDPE=10 | NGDBUILD_NUM_LUT1=65 | NGDBUILD_NUM_LUT2=17
NGDBUILD_NUM_LUT3=46 | NGDBUILD_NUM_LUT4=115 | NGDBUILD_NUM_MUXCY=78 | NGDBUILD_NUM_MUXF5=10
NGDBUILD_NUM_OBUF=18 | NGDBUILD_NUM_OBUFT=17 | NGDBUILD_NUM_PULLUP=17 | NGDBUILD_NUM_RAMB16_S9_S9=1
NGDBUILD_NUM_VCC=2 | NGDBUILD_NUM_XORCY=66
