JDSCS-Club/DENVER_CCP/DOC/11_SW코드/lic/cpld/잡동사니/lic-c3/decoder/usage_statistics_webtalk.html

### Device Usage Page (usage_statistics_webtalk.html)

This HTML page displays the device usage statistics that will be sent to Xilinx.

Software Version and Target Device
Product Version: | ISE:13.4 (WebPack) - O.87xd | Target Family: | Spartan3
OS Platform: | NT | Target Device: | xc3s200
Project ID (random number) | 81aad5e77ec24494a78e96617b14e6fc.14E1793901414CE4ABE1DF79D2C8C956.155 | Target Package: | vq100
Registration ID | 177278680_0_0_515 | Target Speed: | -5
Date Generated | 2012-05-17T14:38:55 | Tool Flow | ISE

User Environment
OS Name | Microsoft Windows 7 , 32-bit | OS Release | Service Pack 1 (build 7601)
CPU Name | Intel(R) Core(TM)2 Duo CPU P8700 @ 2.53GHz | CPU Speed | 2520 MHz

Device Usage Statistics
Macro Statistics | Miscellaneous Statistics | Net Statistics | Site Usage

Adders/Subtractors=1

16-bit adder=1

Comparators=3

16-bit comparator less=2

23-bit comparator less=1

Counters=4

16-bit up counter=2

23-bit up counter=1

3-bit up counter=1

Latches=14

1-bit latch=14

Registers=61

Flip-Flops=61

MiscellaneousStatistics

AGG_BONDED_IO=63

AGG_IO=63

AGG_SLICE=158

NUM_4_INPUT_LUT=276

NUM_BONDED_IOB=63

NUM_BUFGMUX=2

NUM_CYMUX=78

NUM_IOB_FF=6

NUM_IOB_LATCH=4

NUM_LUT_RT=65

NUM_RAMB16=1

NUM_SLICEL=158

NUM_SLICE_FF=109

NUM_SLICE_LATCH=14

NUM_XOR=66

Xilinx Core blk_mem_gen_v6_1, Xilinx CORE Generator 13.1=1

NetStatistics

NumNets_Active=419

NumNets_Gnd=1

NumNets_Vcc=1

NumNodesOfType_Active_BRAMADDR=22

NumNodesOfType_Active_BRAMDUMMY=16

NumNodesOfType_Active_CLKPIN=96

NumNodesOfType_Active_CNTRLPIN=165

NumNodesOfType_Active_DOUBLE=865

NumNodesOfType_Active_DUMMY=764

NumNodesOfType_Active_DUMMYESC=37

NumNodesOfType_Active_GLOBAL=32

NumNodesOfType_Active_HFULLHEX=15

NumNodesOfType_Active_HLONG=4

NumNodesOfType_Active_HUNIHEX=97

NumNodesOfType_Active_INPUT=872

NumNodesOfType_Active_IOBOUTPUT=38

NumNodesOfType_Active_OMUX=339

NumNodesOfType_Active_OUTPUT=321

NumNodesOfType_Active_PREBXBY=44

NumNodesOfType_Active_VFULLHEX=52

NumNodesOfType_Active_VLONG=21

NumNodesOfType_Active_VUNIHEX=79

NumNodesOfType_Gnd_BRAMDUMMY=2

NumNodesOfType_Gnd_CNTRLPIN=2

NumNodesOfType_Gnd_DOUBLE=8

NumNodesOfType_Gnd_INPUT=16

NumNodesOfType_Gnd_OMUX=15

NumNodesOfType_Gnd_OUTPUT=12

NumNodesOfType_Gnd_PREBXBY=4

NumNodesOfType_Gnd_VUNIHEX=1

SiteStatistics

IOB-DIFFM=31

IOB-DIFFS=31

SLICEL-SLICEM=85

SiteSummary

BUFGMUX=2

BUFGMUX_GCLKMUX=2

BUFGMUX_GCLK_BUFFER=2

IOB=63

IOB_DELAY=2

IOB_IFF1=2

IOB_INBUF=36

IOB_OFF1=6

IOB_OFF2=1

IOB_OUTBUF=35

IOB_PAD=63

IOB_TFF1=1

RAMB16=1

RAMB16_RAMB16=1

RAMB16_RAMB16A=1

RAMB16_RAMB16B=1

SLICEL=158

SLICEL_C1VDD=4

SLICEL_C2VDD=4

SLICEL_CYMUXF=40

SLICEL_CYMUXG=38

SLICEL_F=140

SLICEL_F5MUX=27

SLICEL_FFX=70

SLICEL_FFY=53

SLICEL_G=136

SLICEL_GNDF=36

SLICEL_GNDG=34

SLICEL_XORF=34

SLICEL_XORG=32

Configuration Data

BUFGMUX

S=[S_INV:2] [S:0]

BUFGMUX_GCLKMUX

DISABLE_ATTR=[LOW:2]

S=[S_INV:2] [S:0]

IOB

ICE=[ICE:1] [ICE_INV:1]

ICLK1=[ICLK1_INV:2] [ICLK1:0]

O1=[O1_INV:0] [O1:34]

O2=[O2:1] [O2_INV:0]

OCE=[OCE:4] [OCE_INV:1]

OTCLK1=[OTCLK1_INV:4] [OTCLK1:3]

OTCLK2=[OTCLK2_INV:1] [OTCLK2:0]

SR=[SR:0] [SR_INV:10]

T1=[T1_INV:0] [T1:17]

IOB_IFF1

CE=[CE:1] [CE_INV:1]

CK=[CK:0] [CK_INV:2]

IFF1_INIT_ATTR=[INIT0:1] [INIT1:1]

IFF1_SR_ATTR=[SRLOW:1] [SRHIGH:1]

IFFATTRBOX=[ASYNC:2]

LATCH_OR_FF=[FF:2]

SR=[SR:0] [SR_INV:2]

IOB_OFF1

CE=[CE:3] [CE_INV:1]

CK=[CK:2] [CK_INV:4]

D=[D:6] [D_INV:0]

LATCH_OR_FF=[FF:3] [LATCH:3]

OFF1_INIT_ATTR=[INIT0:3] [INIT1:3]

OFF1_SR_ATTR=[SRLOW:3] [SRHIGH:3]

OFFATTRBOX=[ASYNC:5] [SYNC:1]

SR=[SR:0] [SR_INV:6]

IOB_OFF2

CE=[CE:1] [CE_INV:0]

CK=[CK:0] [CK_INV:1]

D=[D:1] [D_INV:0]

LATCH_OR_FF=[LATCH:1]

OFF2_INIT_ATTR=[INIT1:1]

OFF2_SR_ATTR=[SRHIGH:1]

OFFATTRBOX=[ASYNC:1]

SR=[SR:0] [SR_INV:1]

IOB_OUTBUF

IN=[IN_INV:0] [IN:35]

TRI=[TRI_INV:0] [TRI:17]

IOB_PAD

DRIVEATTRBOX=[12:33] [24:2]

IOATTRBOX=[LVCMOS33:63]

PULL=[PULLUP:16]

SLEW=[SLOW:35]

IOB_TFF1

CK=[CK:1] [CK_INV:0]

D=[D:1] [D_INV:0]

LATCH_OR_FF=[FF:1]

SR=[SR:0] [SR_INV:1]

TFF1_INIT_ATTR=[INIT0:1]

TFF1_SR_ATTR=[SRLOW:1]

TFFATTRBOX=[SYNC:1]

RAMB16

CLKA=[CLKA_INV:0] [CLKA:1]

CLKB=[CLKB_INV:0] [CLKB:1]

ENA=[ENA_INV:0] [ENA:1]

ENB=[ENB_INV:0] [ENB:1]

SSRA=[SSRA_INV:0] [SSRA:1]

SSRB=[SSRB_INV:0] [SSRB:1]

WEA=[WEA:1] [WEA_INV:0]

WEB=[WEB:0] [WEB_INV:1]

RAMB16_RAMB16A

CLKA=[CLKA_INV:0] [CLKA:1]

ENA=[ENA_INV:0] [ENA:1]

PORTA_ATTR=[2048X9:1]

SSRA=[SSRA_INV:0] [SSRA:1]

WEA=[WEA:1] [WEA_INV:0]

WRITEMODEA=[WRITE_FIRST:1]

RAMB16_RAMB16B

CLKB=[CLKB_INV:0] [CLKB:1]

ENB=[ENB_INV:0] [ENB:1]

PORTB_ATTR=[2048X9:1]

SSRB=[SSRB_INV:0] [SSRB:1]

WEB=[WEB:0] [WEB_INV:1]

WRITEMODEB=[WRITE_FIRST:1]

SLICEL

BX=[BX_INV:1] [BX:40]

BY=[BY:14] [BY_INV:0]

CE=[CE:24] [CE_INV:30]

CIN=[CIN_INV:0] [CIN:35]

CLK=[CLK:50] [CLK_INV:34]

SR=[SR:0] [SR_INV:61]

SLICEL_CYMUXF

0=[0:40] [0_INV:0]

1=[1_INV:0] [1:40]

SLICEL_CYMUXG

0=[0:38] [0_INV:0]

SLICEL_F5MUX

S0=[S0:27] [S0_INV:0]

SLICEL_F6MUX

S0=[S0:1] [S0_INV:0]

SLICEL_FFX

CE=[CE:18] [CE_INV:28]

CK=[CK:44] [CK_INV:26]

D=[D:69] [D_INV:1]

FFX_INIT_ATTR=[INIT0:60] [INIT1:10]

FFX_SR_ATTR=[SRLOW:60] [SRHIGH:10]

LATCH_OR_FF=[FF:62] [LATCH:8]

SR=[SR:0] [SR_INV:49]

SYNC_ATTR=[ASYNC:70]

SLICEL_FFY

CE=[CE:11] [CE_INV:29]

CK=[CK:28] [CK_INV:25]

D=[D:53] [D_INV:0]

FFY_INIT_ATTR=[INIT0:46] [INIT1:7]

FFY_SR_ATTR=[SRLOW:46] [SRHIGH:7]

LATCH_OR_FF=[FF:47] [LATCH:6]

SR=[SR:0] [SR_INV:40]

SYNC_ATTR=[ASYNC:52] [SYNC:1]

SLICEL_XORF

1=[1_INV:0] [1:34]

SLICEM

BY=[BY:1] [BY_INV:0]

CLK=[CLK:1] [CLK_INV:0]

SR=[SR:1] [SR_INV:0]

SLICEM_FFY

CK=[CK:1] [CK_INV:0]

D=[D:1] [D_INV:0]

FFY_INIT_ATTR=[INIT0:1]

FFY_SR_ATTR=[SRLOW:1]

LATCH_OR_FF=[FF:1]

SYNC_ATTR=[ASYNC:1]

SLICEM_G

DI=[DI:1] [DI_INV:0]

G_ATTR=[SHIFT_REG:1]

LUT_OR_MEM=[RAM:1]

SLICEM_WSGEN

CK=[CK:1] [CK_INV:0]

SYNC_ATTR=[ASYNC:1]

WE=[WE_INV:0] [WE:1]

Pin Data

BUFGMUX

I0=2

O=2

S=2

BUFGMUX_GCLKMUX

I0=2

OUT=2

S=2

BUFGMUX_GCLK_BUFFER

IN=2

OUT=2

IOB

I=36

ICE=2

ICLK1=2

IQ1=2

O1=34

O2=1

OCE=5

OTCLK1=7

OTCLK2=1

PAD=63

SR=10

T1=17

IOB_DELAY

IN=2

OUT=2

IOB_IFF1

CE=2

CK=2

D=2

Q=2

SR=2

IOB_INBUF

IN=36

OUT=36

IOB_OFF1

CE=4

CK=6

D=6

Q=6

SR=6

IOB_OFF2

CE=1

CK=1

D=1

Q=1

SR=1

IOB_OUTBUF

IN=35

OUT=35

TRI=17

IOB_PAD

PAD=63

IOB_TFF1

CK=1

D=1

Q=1

SR=1

RAMB16

ADDRA10=1

ADDRA11=1

ADDRA12=1

ADDRA13=1

ADDRA3=1

ADDRA4=1

ADDRA5=1

ADDRA6=1

ADDRA7=1

ADDRA8=1

ADDRA9=1

ADDRB10=1

ADDRB11=1

ADDRB12=1

ADDRB13=1

ADDRB3=1

ADDRB4=1

ADDRB5=1

ADDRB6=1

ADDRB7=1

ADDRB8=1

ADDRB9=1

CLKA=1

CLKB=1

DIA0=1

DIA1=1

DIA2=1

DIA3=1

DIA4=1

DIA5=1

DIA6=1

DIA7=1

DIB0=1

DIB1=1

DIB2=1

DIB3=1

DIB4=1

DIB5=1

DIB6=1

DIB7=1

DIPA0=1

DIPB0=1

DOA0=1

DOA1=1

DOA2=1

DOA3=1

DOA4=1

DOA5=1

DOA6=1

DOA7=1

DOB0=1

DOB1=1

DOB2=1

DOB3=1

DOB4=1

DOB5=1

DOB6=1

DOB7=1

ENA=1

ENB=1

SSRA=1

SSRB=1

WEA=1

WEB=1

RAMB16_RAMB16

ADDRA=1

ADDRB=1

DIA=1

DIB=1

DOA=1

DOB=1

RAMB16_RAMB16A

ADDRA=1

ADDRA10=1

ADDRA11=1

ADDRA12=1

ADDRA13=1

ADDRA3=1

ADDRA4=1

ADDRA5=1

ADDRA6=1

ADDRA7=1

ADDRA8=1

ADDRA9=1

CLKA=1

DIA=1

DIA0=1

DIA1=1

DIA2=1

DIA3=1

DIA4=1

DIA5=1

DIA6=1

DIA7=1

DIPA0=1

DOA=1

DOA0=1

DOA1=1

DOA2=1

DOA3=1

DOA4=1

DOA5=1

DOA6=1

DOA7=1

ENA=1

SSRA=1

WEA=1

RAMB16_RAMB16B

ADDRB=1

ADDRB10=1

ADDRB11=1

ADDRB12=1

ADDRB13=1

ADDRB3=1

ADDRB4=1

ADDRB5=1

ADDRB6=1

ADDRB7=1

ADDRB8=1

ADDRB9=1

CLKB=1

DIB=1

DIB0=1

DIB1=1

DIB2=1

DIB3=1

DIB4=1

DIB5=1

DIB6=1

DIB7=1

DIPB0=1

DOB=1

DOB0=1

DOB1=1

DOB2=1

DOB3=1

DOB4=1

DOB5=1

DOB6=1

DOB7=1

ENB=1

SSRB=1

WEB=1

SLICEL

BX=41

BY=14

CE=54

CIN=35

CLK=84

COUT=38

F1=129

F2=92

F3=87

F4=56

G1=134

G2=101

G3=89

G4=64

SR=61

X=75

XQ=70

Y=64

YQ=53

SLICEL_C1VDD

1=4

SLICEL_C2VDD

1=4

SLICEL_CYMUXF

0=40

1=40

OUT=40

S0=40

SLICEL_CYMUXG

0=38

1=38

OUT=38

S0=38

SLICEL_F

A1=129

A2=92

A3=87

A4=56

D=140

SLICEL_F5MUX

F=27

G=27

OUT=27

S0=27

SLICEL_F6MUX

0=1

1=1

OUT=1

S0=1

SLICEL_FFX

CE=46

CK=70

D=70

Q=70

SR=49

SLICEL_FFY

CE=40

CK=53

D=53

Q=53

SR=40

SLICEL_G

A1=134

A2=101

A3=89

A4=64

D=136

SLICEL_GNDF

0=36

SLICEL_GNDG

0=34

SLICEL_XORF

0=34

1=34

O=34

SLICEL_XORG

0=32

1=32

O=32

SLICEM

BY=1

CLK=1

G1=1

G2=1

G3=1

G4=1

SR=1

YQ=1

SLICEM_FFY

CK=1

D=1

Q=1

SLICEM_G

A1=1

A2=1

A3=1

A4=1

D=1

DI=1

WS=1

SLICEM_WSGEN

CK=1

WE=1

WSG=1

Tool Usage

Command Line History

xst -intstyle ise -ifn <ise_file>

xst -intstyle ise -ifn <ise_file>

ngdbuild -intstyle ise -dd _ngo -nt timestamp -i -p xc3s200-vq100-5 <fname>.ngc <fname>.ngd

map -intstyle ise -p xc3s200-vq100-5 -cm area -ir off -pr off -c 100 -o <fname>.ncd <fname>.ngd <fname>.pcf

par -w -intstyle ise -ol high -t 1 <fname>.ncd <fname>.ncd <fname>.pcf

trce -intstyle ise -v 3 -s 5 -n 3 -fastpaths -xml <fname>.twx <fname>.ncd -o <fname>.twr <fname>.pcf

bitgen -intstyle ise -f <fname>.ut <fname>.ncd

xst -intstyle ise -ifn <ise_file>

ngdbuild -intstyle ise -dd _ngo -nt timestamp -i -p xc3s200-vq100-5 <fname>.ngc <fname>.ngd

map -intstyle ise -p xc3s200-vq100-5 -cm area -ir off -pr off -c 100 -o <fname>.ncd <fname>.ngd <fname>.pcf

par -w -intstyle ise -ol high -t 1 <fname>.ncd <fname>.ncd <fname>.pcf

trce -intstyle ise -v 3 -s 5 -n 3 -fastpaths -xml <fname>.twx <fname>.ncd -o <fname>.twr <fname>.pcf

xst -intstyle ise -ifn <ise_file>

xst -intstyle ise -ifn <ise_file>

xst -intstyle ise -ifn <ise_file>

xst -intstyle ise -ifn <ise_file>

xst -intstyle ise -ifn <ise_file>

xst -intstyle ise -ifn <ise_file>

xst -intstyle ise -ifn <ise_file>

xst -intstyle ise -ifn <ise_file>

xst -intstyle ise -ifn <ise_file>

xst -intstyle ise -ifn <ise_file>

xst -intstyle ise -ifn <ise_file>

xst -intstyle ise -ifn <ise_file>

xst -intstyle ise -ifn <ise_file>

xst -intstyle ise -ifn <ise_file>

xst -intstyle ise -ifn <ise_file>

xst -intstyle ise -ifn <ise_file>

xst -intstyle ise -ifn <ise_file>

xst -intstyle ise -ifn <ise_file>

xst -intstyle ise -ifn <ise_file>

xst -intstyle ise -ifn <ise_file>

xst -intstyle ise -ifn <ise_file>

xst -intstyle ise -ifn <ise_file>

xst -intstyle ise -ifn <ise_file>

ngdbuild -intstyle ise -dd _ngo -nt timestamp -i -p xc3s200-vq100-5 <fname>.ngc <fname>.ngd

map -intstyle ise -p xc3s200-vq100-5 -cm area -ir off -pr off -c 100 -o <fname>.ncd <fname>.ngd <fname>.pcf

xst -intstyle ise -ifn <ise_file>

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

trce -intstyle ise -v 3 -s 5 -n 3 -fastpaths -xml <fname>.twx <fname>.ncd -o <fname>.twr <fname>.pcf -ucf <fname>.ucf

bitgen -intstyle ise -f <fname>.ut <fname>.ncd

xst -intstyle ise -ifn <ise_file>

xst -intstyle ise -ifn <ise_file>

ngdbuild -intstyle ise -dd _ngo -nt timestamp -uc <fname>.ucf -p xc3s200-vq100-5 <fname>.ngc <fname>.ngd

map -intstyle ise -p xc3s200-vq100-5 -cm area -ir off -pr off -c 100 -o <fname>.ncd <fname>.ngd <fname>.pcf

par -w -intstyle ise -ol high -t 1 <fname>.ncd <fname>.ncd <fname>.pcf

trce -intstyle ise -v 3 -s 5 -n 3 -fastpaths -xml <fname>.twx <fname>.ncd -o <fname>.twr <fname>.pcf -ucf <fname>.ucf

bitgen -intstyle ise -f <fname>.ut <fname>.ncd

xst -intstyle ise -ifn <ise_file>

ngdbuild -intstyle ise -dd _ngo -nt timestamp -uc <fname>.ucf -p xc3s200-vq100-5 <fname>.ngc <fname>.ngd

map -intstyle ise -p xc3s200-vq100-5 -cm area -ir off -pr off -c 100 -o <fname>.ncd <fname>.ngd <fname>.pcf

par -w -intstyle ise -ol high -t 1 <fname>.ncd <fname>.ncd <fname>.pcf

trce -intstyle ise -v 3 -s 5 -n 3 -fastpaths -xml <fname>.twx <fname>.ncd -o <fname>.twr <fname>.pcf -ucf <fname>.ucf

bitgen -intstyle ise -f <fname>.ut <fname>.ncd

xst -intstyle ise -ifn <ise_file>

xst -intstyle ise -ifn <ise_file>

xst -intstyle ise -ifn <ise_file>

ngdbuild -intstyle ise -dd _ngo -nt timestamp -uc <fname>.ucf -p xc3s200-vq100-5 <fname>.ngc <fname>.ngd

map -intstyle ise -p xc3s200-vq100-5 -cm area -ir off -pr off -c 100 -o <fname>.ncd <fname>.ngd <fname>.pcf

par -w -intstyle ise -ol high -t 1 <fname>.ncd <fname>.ncd <fname>.pcf

trce -intstyle ise -v 3 -s 5 -n 3 -fastpaths -xml <fname>.twx <fname>.ncd -o <fname>.twr <fname>.pcf -ucf <fname>.ucf

bitgen -intstyle ise -f <fname>.ut <fname>.ncd

xst -intstyle ise -ifn <ise_file>

ngdbuild -intstyle ise -dd _ngo -nt timestamp -uc <fname>.ucf -p xc3s200-vq100-5 <fname>.ngc <fname>.ngd

map -intstyle ise -p xc3s200-vq100-5 -cm area -ir off -pr off -c 100 -o <fname>.ncd <fname>.ngd <fname>.pcf

par -w -intstyle ise -ol high -t 1 <fname>.ncd <fname>.ncd <fname>.pcf

trce -intstyle ise -v 3 -s 5 -n 3 -fastpaths -xml <fname>.twx <fname>.ncd -o <fname>.twr <fname>.pcf -ucf <fname>.ucf

bitgen -intstyle ise -f <fname>.ut <fname>.ncd

xst -intstyle ise -ifn <ise_file>

ngdbuild -intstyle ise -dd _ngo -nt timestamp -uc <fname>.ucf -p xc3s200-vq100-5 <fname>.ngc <fname>.ngd

map -intstyle ise -p xc3s200-vq100-5 -cm area -ir off -pr off -c 100 -o <fname>.ncd <fname>.ngd <fname>.pcf

par -w -intstyle ise -ol high -t 1 <fname>.ncd <fname>.ncd <fname>.pcf

trce -intstyle ise -v 3 -s 5 -n 3 -fastpaths -xml <fname>.twx <fname>.ncd -o <fname>.twr <fname>.pcf -ucf <fname>.ucf

bitgen -intstyle ise -f <fname>.ut <fname>.ncd

Software Quality
Run Statistics
Program Name | Runs Started | Runs Finished | Errors | Fatal Errors | Internal Errors | Exceptions | Core Dumps
XSLTProcess | 7 | 7 | 0 | 0 | 0 | 0 | 0
_impact | 55 | 49 | 0 | 0 | 0 | 0 | 0
bitgen | 60 | 60 | 0 | 0 | 0 | 0 | 0
compxlib | 3 | 3 | 0 | 0 | 0 | 0 | 0
cpldfit | 7 | 7 | 0 | 0 | 0 | 0 | 0
hprep6 | 7 | 7 | 0 | 0 | 0 | 0 | 0
map | 64 | 64 | 0 | 0 | 0 | 0 | 0
ngdbuild | 76 | 76 | 0 | 0 | 0 | 0 | 0
par | 63 | 60 | 3 | 0 | 0 | 0 | 0
taengine | 2 | 2 | 0 | 0 | 0 | 0 | 0
trce | 59 | 59 | 0 | 0 | 0 | 0 | 0
tsim | 7 | 7 | 0 | 0 | 0 | 0 | 0
xst | 90 | 90 | 0 | 0 | 0 | 0 | 0

Project Statistics
PROP_Enable_Message_Filtering=false | PROP_FitterReportFormat=HTML
PROP_LastAppliedGoal=Balanced | PROP_LastAppliedStrategy=Xilinx Default (unlocked)
PROP_ManualCompileOrderImp=false | PROP_PropSpecInProjFile=Store all values
PROP_Simulator=Modelsim-SE VHDL | PROP_SynthOpt=Area
PROP_SynthTopFile=changed | PROP_Top_Level_Module_Type=HDL
PROP_UseSmartGuide=false | PROP_UserConstraintEditorPreference=Constraints Editor
PROP_intProjectCreationTimestamp=2012-04-30T14:40:18 | PROP_intWbtProjectID=14E1793901414CE4ABE1DF79D2C8C956
PROP_intWbtProjectIteration=155 | PROP_intWorkingDirLocWRTProjDir=Same
PROP_intWorkingDirUsed=No | PROP_xilxBitgCfg_Unused=Pull Up
PROP_AutoTop=true | PROP_DevFamily=Spartan3
PROP_DevDevice=xc3s200 | PROP_DevFamilyPMName=spartan3
PROP_DevPackage=vq100 | PROP_Synthesis_Tool=XST (VHDL/Verilog)
PROP_DevSpeed=-5 | PROP_PreferredLanguage=VHDL
FILE_UCF=1 | FILE_VHDL=2

Unisim Statistics
NGDBUILD_PRE_UNISIM_SUMMARY
NGDBUILD_NUM_BUFG=1 | NGDBUILD_NUM_BUFGP=1 | NGDBUILD_NUM_FDC=13 | NGDBUILD_NUM_FDCE=36
NGDBUILD_NUM_FDCE_1=12 | NGDBUILD_NUM_FDC_1=11 | NGDBUILD_NUM_FDE=31 | NGDBUILD_NUM_FDP=5
NGDBUILD_NUM_FDPE=1 | NGDBUILD_NUM_FDPE_1=3 | NGDBUILD_NUM_FDR=3 | NGDBUILD_NUM_GND=2
NGDBUILD_NUM_IBUF=27 | NGDBUILD_NUM_INV=14 | NGDBUILD_NUM_IOBUF=8 | NGDBUILD_NUM_LD=3
NGDBUILD_NUM_LDC_1=2 | NGDBUILD_NUM_LDP=3 | NGDBUILD_NUM_LDPE=10 | NGDBUILD_NUM_LUT1=65
NGDBUILD_NUM_LUT2=17 | NGDBUILD_NUM_LUT3=56 | NGDBUILD_NUM_LUT4=120 | NGDBUILD_NUM_MUXCY=78
NGDBUILD_NUM_MUXF5=27 | NGDBUILD_NUM_OBUF=18 | NGDBUILD_NUM_OBUFT=9 | NGDBUILD_NUM_VCC=2

NGDBUILD_NUM_XORCY=66
NGDBUILD_POST_UNISIM_SUMMARY
NGDBUILD_NUM_BUFG=2 | NGDBUILD_NUM_FDC=13 | NGDBUILD_NUM_FDCE=36 | NGDBUILD_NUM_FDCE_1=12
NGDBUILD_NUM_FDC_1=11 | NGDBUILD_NUM_FDE=31 | NGDBUILD_NUM_FDP=5 | NGDBUILD_NUM_FDPE=1
NGDBUILD_NUM_FDPE_1=3 | NGDBUILD_NUM_FDR=3 | NGDBUILD_NUM_GND=2 | NGDBUILD_NUM_IBUF=35
NGDBUILD_NUM_IBUFG=1 | NGDBUILD_NUM_INV=14 | NGDBUILD_NUM_LD=3 | NGDBUILD_NUM_LDC_1=2
NGDBUILD_NUM_LDP=3 | NGDBUILD_NUM_LDPE=10 | NGDBUILD_NUM_LUT1=65 | NGDBUILD_NUM_LUT2=17
NGDBUILD_NUM_LUT3=56 | NGDBUILD_NUM_LUT4=120 | NGDBUILD_NUM_MUXCY=78 | NGDBUILD_NUM_MUXF5=27
NGDBUILD_NUM_OBUF=18 | NGDBUILD_NUM_OBUFT=17 | NGDBUILD_NUM_PULLUP=17 | NGDBUILD_NUM_RAMB16_S9_S9=1
NGDBUILD_NUM_VCC=2 | NGDBUILD_NUM_XORCY=66

XST Command Line Options
XST_OPTION_SUMMARY
-ifn=<fname>.prj | -ifmt=mixed | -ofn=<design_top> | -ofmt=NGC
-p=xc3s200-5-vq100 | -top=<design_top> | -opt_mode=Area | -opt_level=1
-iuc=NO | -keep_hierarchy=No | -netlist_hierarchy=As_Optimized | -rtlview=Yes
-glob_opt=AllClockNets | -read_cores=YES | -write_timing_constraints=NO | -cross_clock_analysis=NO
-bus_delimiter=<> | -slice_utilization_ratio=100 | -bram_utilization_ratio=100 | -verilog2001=YES
-fsm_extract=YES | -fsm_encoding=Auto | -safe_implementation=No | -fsm_style=LUT
-ram_extract=Yes | -ram_style=Auto | -rom_extract=Yes | -shreg_extract=YES
-rom_style=Auto | -auto_bram_packing=NO | -resource_sharing=YES | -async_to_sync=NO
-mult_style=Auto | -iobuf=YES | -max_fanout=500 | -bufg=8
-register_duplication=YES | -register_balancing=No | -optimize_primitives=NO | -use_clock_enable=Yes
-use_sync_set=Yes | -use_sync_reset=Yes | -iob=Auto | -equivalent_register_removal=YES

-slice_utilization_ratio_maxmargin=5
