JDSCS-Club/DENVER_CCP/DOC/05_정비_매뉴얼/운영매뉴얼/42D-2016-0021_RTD_DBEditor_Manual.pdf

## DENVER RTD EAGLE P3 COMMUNICATION SYSTEM

# DATABASE EDITOR USER’S MANUAL

CONTRACT NO. P110701149
CDRL NO. | N/A
WIS DOC. NO. | 42D-2016-0021
REVISION: | 1.0
DESIGNED: | J. S. JEONG
REVIEWED: | J. Y. LEE
APPROVED: | B. J. JONE
DATE: | 4/15/2016

DATABASE EDITOR USER’S MANUAL | Document no. | 42D-2016-0021
| Issued date | 4/15/2016
| Rev. no. | 1.0

REVISION RECORD

Rev. No. | PAGE | Description | Date
0 | | Initial release | December 06, 2010

### USER’S MANUAL

Rev. no. | 1.0

## Table of Contents

### USER’S MANUAL

Rev. no. | 1.0

### USER’S MANUAL

Rev. no. | 1.0

### 1. General 1.1. Definition

The Database Editor is a GUI application that allows the user to edit and manage the Communication System content data and compile the content updates to be loaded on the cars. This document provides the user instructions of the Database Editor.

### 1.2. Requirements

### 1.2.1. System Requirements

Item | Requirements
CPU | Core Duo (1.66 GHz) or better
Graphics | 1280 * 1024 or more
RAM | 1024MB or more
HDD | 80GB or more
Operating System | Windows XP, Windows 7

### USER’S MANUAL

Rev. no. | 1.0

### 2. User Instruction 2.1. Train Information

Below screen is displayed when the program is executed.

Figure 1 Train Information Screen

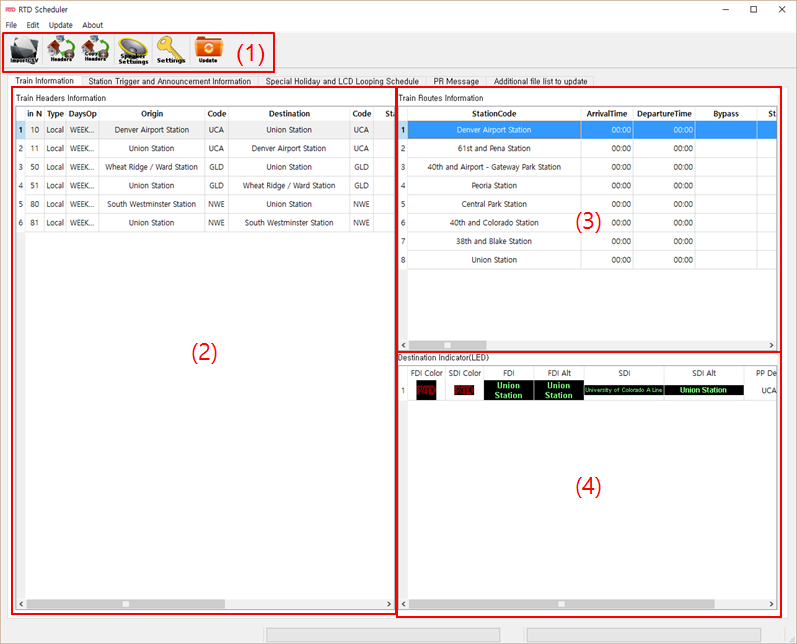
[picture p542: figure]

1) Menu Icons
2) Train Headers Information
3) Train Routes Information
4) Destination Indicator

### USER’S MANUAL

Rev. no. | 1.0

### 2.1.1. Menu Icons

Table 1 Menu Icons (Train Information)
Icon | Name | Description
| Import CSV | Import CSV
| Add Header | Add operation information
| Copy Header | Copy operation information
| Speaker Settings | Exterior speaker level settings
| Settings | User settings
| Update | Create update data

### USER’S MANUAL

Rev. no. | 1.0

### 2.1.2. Train Headers Information

This section shows the train schedules and related characteristics.

Figure 2 Train Headers Information

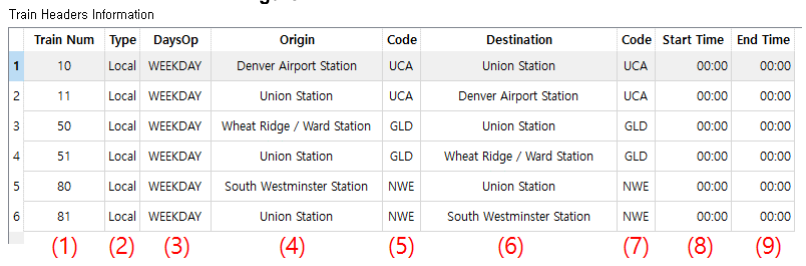
[picture p543: figure]

1) Train Number
2) Service type
3) DaysOP
- WEEKDAY: Operate Monday through Friday.
- FRIDAY: Operate Friday only.
- SATURDAY: Operate Saturday only.
- SUNDAY: Operate Sunday only.
4) Origin
5) Origin Code
6) Destination
7) Destination Code
8) Start Time
9) End Time

### USER’S MANUAL

Rev. no. | 1.0

### 2.1.3. Train Route Information

This section shows the station stop listings of the selected train number.

Figure 3 Train Routes Information

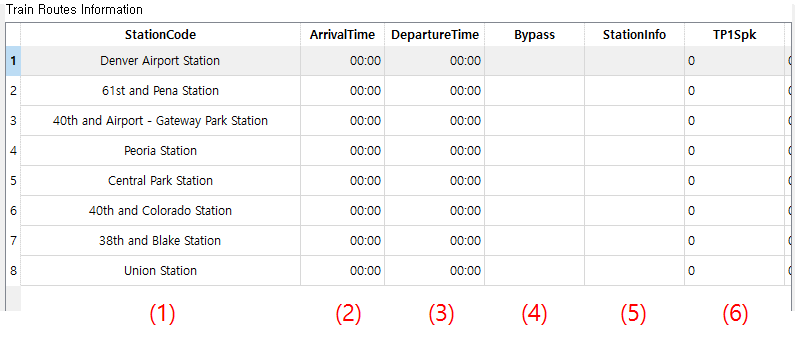
[picture p544: figure]

1) Station name
2) Arrival time
3) Departure time
4) ByPass: [SKIP] if the station is scheduled to be skipped.
5) Station Info: Other characteristics of the station (CONNECT, DISCHARGE, FLAG STOP)
6) TP1Spk~TP9Spk: Speaker settings for each individual trigger points related to the station

### USER’S MANUAL

Rev. no. | 1.0

### 2.1.4. Destination Indicator

This section shows the LED destination indicator images related to the selected train number.

Figure 4 Destination Indicator

1) FDI color block image
2) SDI color block image
3) Primary FDI destination message
4) Secondary FDI destination message
5) Primary SDI destination message
6) Secondary SDI destination message
7) Destination code to determine PID message header

### USER’S MANUAL

Rev. no. | 1.0

### 2.1.5. Editing Train Headers Information

In the Train Headers Information table, double click an item to make change.

Figure 5 Editing Train Headers Information

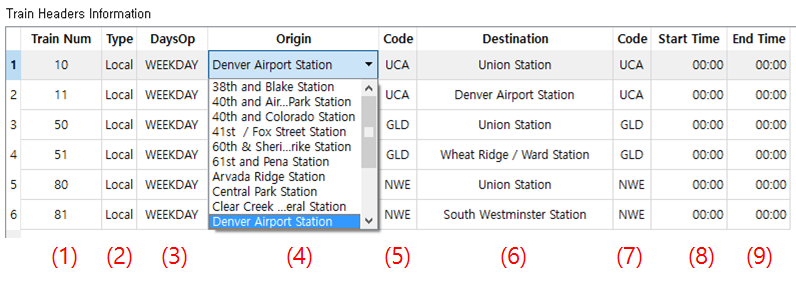
[picture p545: figure]

1) Train Num: Input train number
2) Type: Not used for RTD system. Use ‘Local’ only
3) DaysOp: Select from WEEKDAY/SATURDAY/SUNDAY/FRIDAY
4) Origin: Departure station
5) Origin Code: Route code before Center City
6) Destination: Destination station
7) Destination Code: Route code after Center City
8) Start Time: Input starting time of train operation
9) End Time: Input ending time of the train operation

### USER’S MANUAL

Rev. no. | 1.0

### 2.1.6. Adding Train Headers

To add new train headers, do one of the following:

- Click icon
- Click Edit – Add Train Headers Information in the pull-down menu
- Press [F9] (new train number created at the bottom of the table)
- Press [Insert] (new train number created at the selected location)

Below dialogue will pop up:

Figure 6 Adding New Train Headers Information

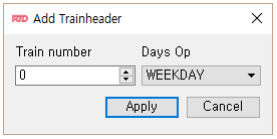
[picture p546: figure]

Enter the desired train number in the Train Number field.
Select the desired operating days in the DaysOp field
Click Apply to create the new train number. Click Cancel to cancel.

*** Duplicate Train Number will not be applied to the database.

### USER’S MANUAL

Rev. no. | 1.0

### 2.1.7. Copying Train Headers

To make a copy of an existing train number, select a train number to copy and do one of the following:

- Click icon
- Click Edit – Copy Train Headers Information in the pull-down menu

Below dialogue will pop up:
Figure 7 Copy Header

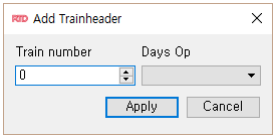
[picture p547: figure]

Enter the desired train number in the Train Number field.
Select the desired operating days in the DaysOp field
Click Apply to create the new train number. Click Cancel to cancel.

### USER’S MANUAL

Rev. no. | 1.0

### 2.1.8. Deleting Train Headers

Select a train number to delete, and press [DEL] key on the keyboard.

Figure 8 Deleting Train Headers

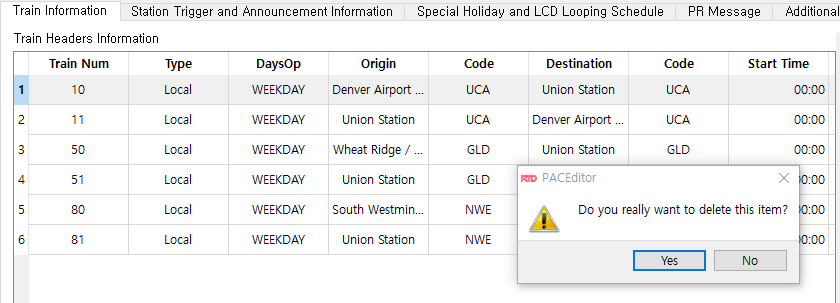
[picture p548: figure]

Click “Yes” to delete the train headers and all related data.

### USER’S MANUAL

Rev. no. | 1.0

### 2.1.9. Editing Train Routes Information

In the Train Routes Information table, double click an item to make change.

Figure 9 Editing Train Routes Information

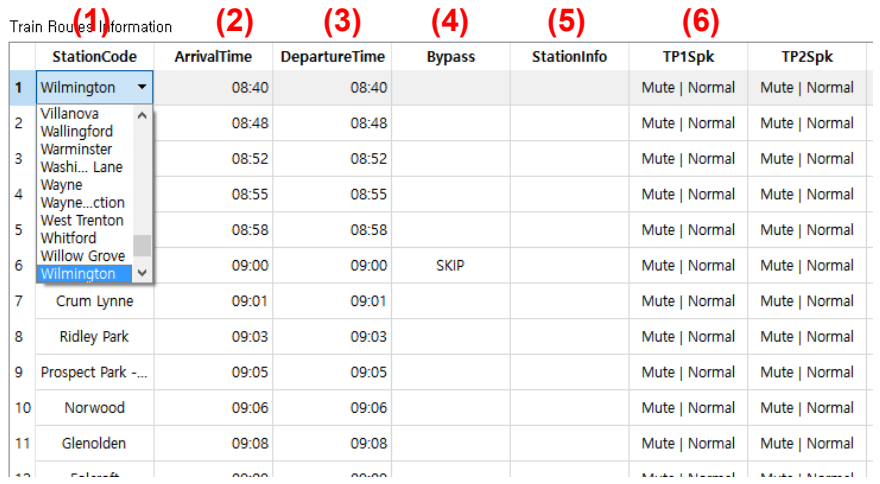
[picture p549: figure]

1) StationCode: Select station name
2) ArrivalTime: Enter arrival schedule for the station
3) DepartureTime: Enter departure schedule for the station
4) Bypass: Select [SKIP] to schedule the station to be skipped as default
5) StationInfo: Select other properties as CONNECT, DISCHARGES, FLAGSTOP
6) TP1Spk~TP9Spk: Select speaker settings for each individual trigger points

### 2.1.10. Adding Station to Route

To add a station to a train number, do one of the following:
- Select a station and press [Insert] (new field created at the selected location)
- Press [F9] (new field created at the bottom of the table)

Select/enter data into each data fields as appropriate.

### USER’S MANUAL

Rev. no. | 1.0

### 2.1.11. Deleting Station from Route

To delete a station from a route, click the station to delete and press [Delete].

Figure 10 Deleting Station from Route

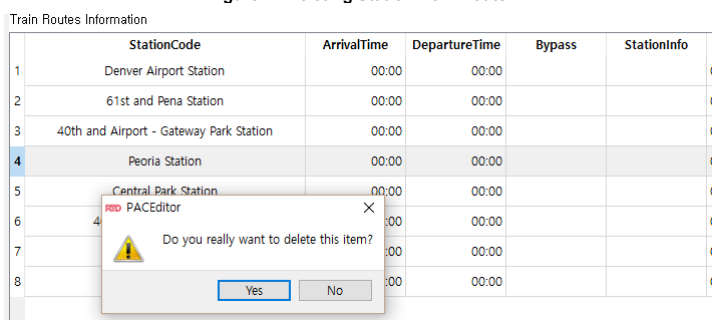
[picture p550: figure]

Click Yes to delete, No to cancel.

### USER’S MANUAL

Rev. no. | 1.0

### 2.1.12. Configuring Destination Indicator Images

To configure destination indicator images, double click the item to make change.

Figure 11 Configuring Destination Indicator Images

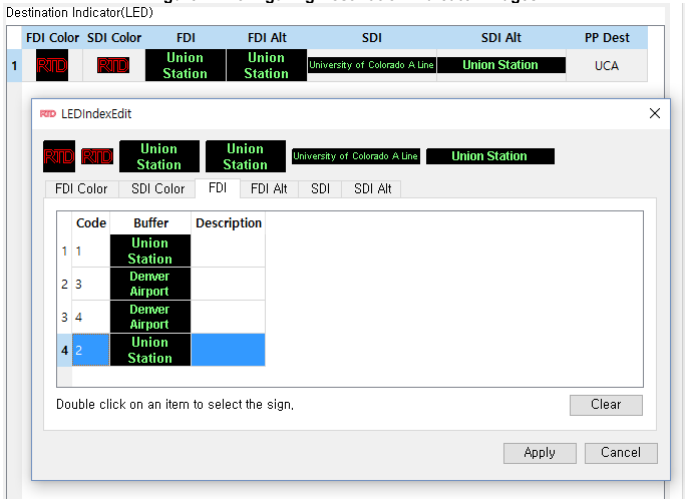
[picture p551: figure]

- The top row of the dialogue shows the currently selected images
- Use FDI Color ~ SDI Alt tabs to select the image type where you wish to configure an image
- Double click an image from the table to make selection
- Click Apply to complete. Click Cancel to dismiss

### USER’S MANUAL

Rev. no. | 1.0

### 2.1.13. Exterior Speaker Settings

Click | icon to open the Exterior Speaker Settings Dialogue
Figure 12 Exterior Speaker Settings

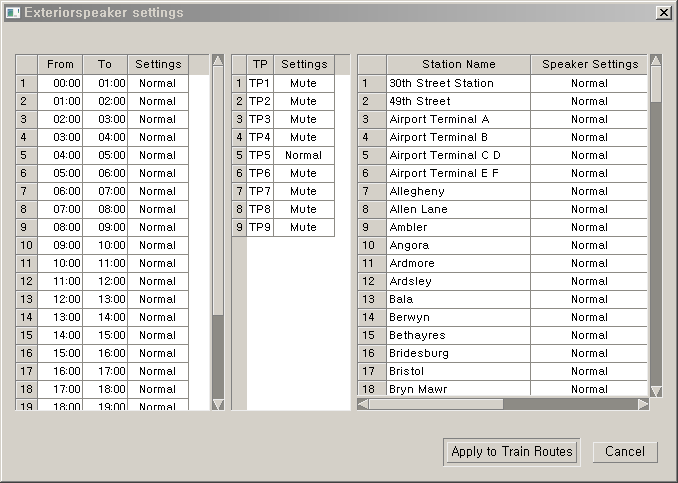
[picture p552: figure]

This dialogue allows the user to set the Exterior Speaker level per time of day, trigger points and stations. Double click the setting value and select the desired speaker level. Available values are “Normal”, “Soft” and “Mute”.

*** Note: When the selected values from time, TP and station settings are different, the lower value takes the priority (i.e. Mute>Soft>Normal). Refer to Table 2.
Table 2 Example of Speaker Value Priority
| TP1 | TP2 | TP3 | TP4 | TP5 | TP6 | TP7 | TP8 | TP9
07:00~08:00 | Soft | Soft | Soft | Soft | Soft | Soft | Soft | Soft | Soft
TP Settings | Mute | Soft | Normal | Normal | Mute | Normal | Normal | Soft | Mute
Applied value | Mute | Soft | Soft | Soft | Mute | Soft | Soft | Soft | Mute

### USER’S MANUAL

Rev. no. | 1.0

### 2.1.14. User Settings

Click | icon to open the User Settings Dialogue.

Figure 13 Registry Settings

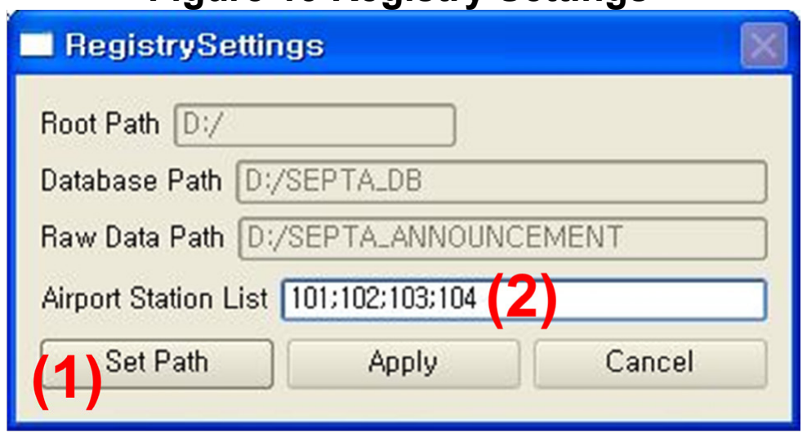
[picture p553: figure]

1) Set Path: Select the drive or directory to store the database and the raw data. Changes are applied upon the next execution of the application.
2) Airport Station List: Add station codes to make exception from the Speaker settings.

*** Note: Database path and raw data path is automatically selected when the root path is selected.

### USER’S MANUAL

Rev. no. | 1.0

### 2.2. Station Trigger and Announcement Information

Click “Station Trigger and Announcement Information” tab. Figure 14 Station Trigger and Announcement Information

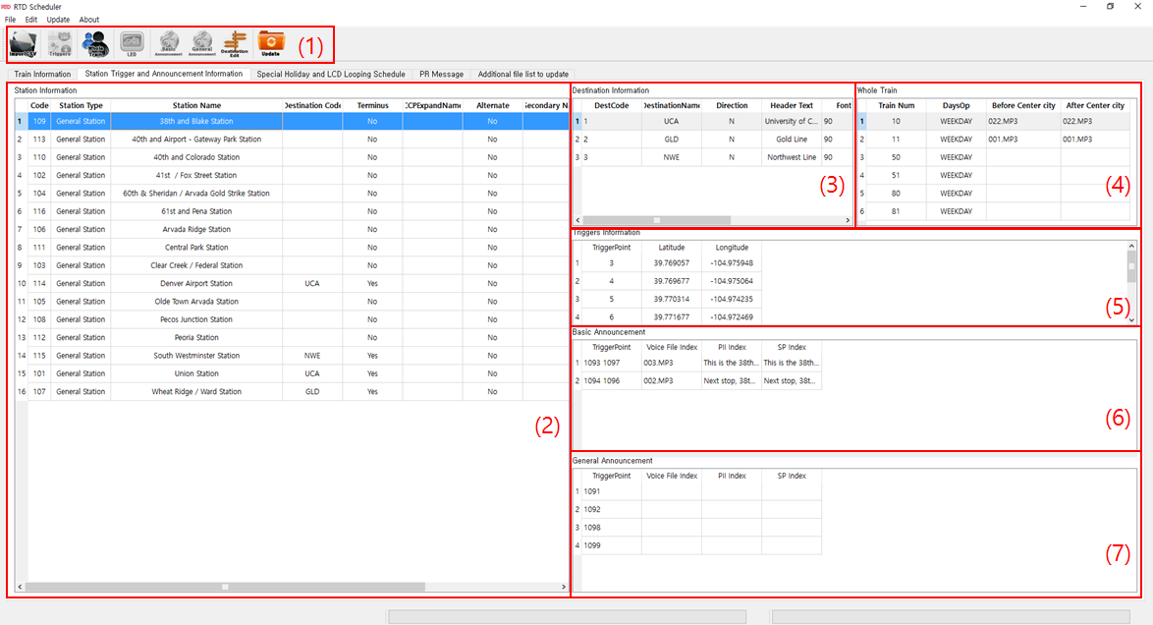
[picture p554: figure]

1) Menu Icons
2) Station Information
3) Destination Information
4) Whole Train Route Announcements
5) GPS Trigger Point Information
6) Basic Announcements
7) General Announcements

### USER’S MANUAL

Rev. no. | 1.0

### 2.2.1. Menu Icons

Table 3 Menu Icons (Station Trigger and Announcement Information)
Icon | Icon Name | Contents
| Import CSV | Import CSV
| Triggers | Trigger point information
| Whole Train | Whole train announcements
| LED | LED displays on Destination Indicators
| Basic Announcement | Automatic station stop announcements
| General Announcement | General announcements using extra trigger points
| Destination Edit | Route code and Primary Player header text
| Update | Create update data

### USER’S MANUAL

Rev. no. | 1.0

### 2.2.2. Station Information

This section shows the list of stations registered in the database.

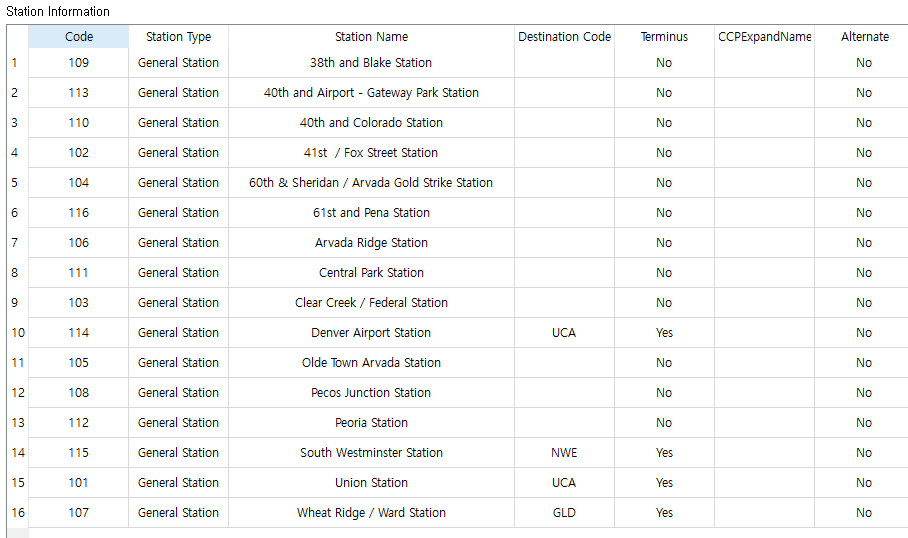
[picture p555: figure]

Figure 15 Station Information

### USER’S MANUAL

Rev. no. | 1.0

### 2.2.2.1. Modifying Existing Station Information

In the Station Information table, double click a data field to make change. Type in text, or make selection from combo box as appropriate.

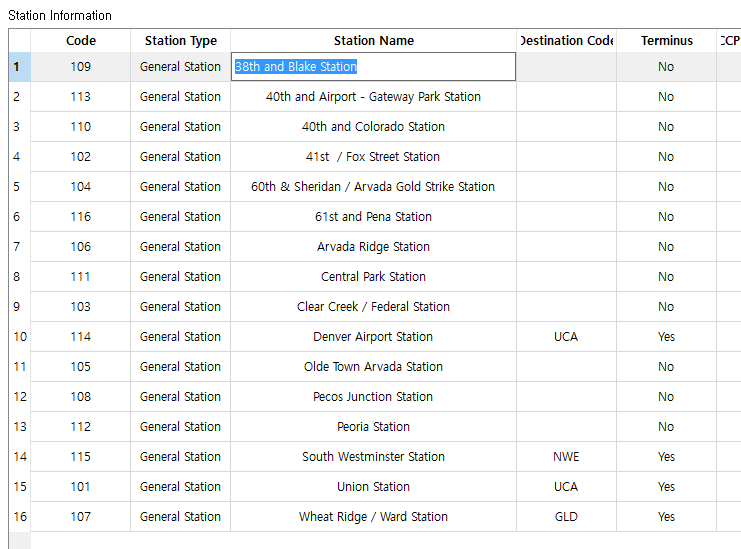
[picture p556: figure]

Figure 16 Modifying Station Information

### USER’S MANUAL

Rev. no. | 1.0

### 2.2.2.2. Adding New Station Information

To add a new station to the database, do one of the following:
- Select a location and press [Insert] (new field created at the selected location)
- Press [F9] (new field created at the bottom of the table)

Select/enter data into each data fields as appropriate.

### 2.2.2.3. Deleting Station Information

To delete a station from the database, click the station to delete and press [Delete].

Figure 17 Deleting Station Information

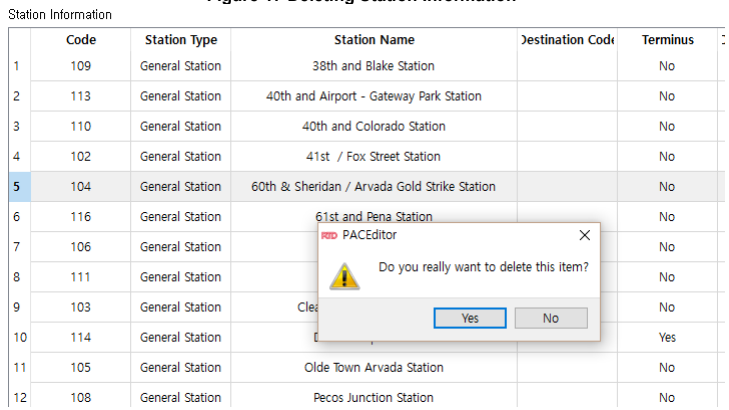
[picture p557: figure]

Click Yes to delete, No to cancel.

### USER’S MANUAL

Rev. no. | 1.0

### 2.2.3. Trigger Information

This section shows the GPS trigger point coordinates used for the automatic announcement.

Figure 18 Trigger Information

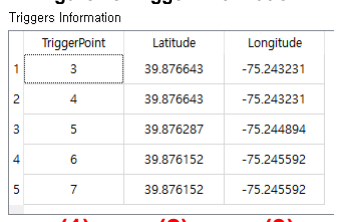
[picture p558: figure]

1) Trigger point index number
2) Longitude coordinate
3) Latitude coordinate

***Note: A trigger point can be configured with multiple GPS coordinates to provide better GPS coverage.

### 2.2.3.1. Modifying Existing Trigger Information

In the Trigger Information table, double click a data field to make change. Type in text, or make selection from combo box as appropriate.

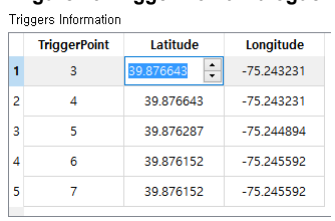
[picture p559: figure]

Figure 19 Trigger Point Dialogue

(1) | (2) | (3)

### USER’S MANUAL

Rev. no. | 1.0

### 2.2.3.2. Adding New Trigger Point Information

To add a new trigger point to a station, do one of the following:
- Select a location and press [Insert] (new field created at the selected location)
- Press [F9] (new field created at the bottom of the table)

Select/enter data into each data fields as appropriate.

### 2.2.3.3. Deleting Trigger Point Information

To delete a trigger point from a station, select a trigger point and press [Delete].

Figure 20 Deleting Trigger Point Information

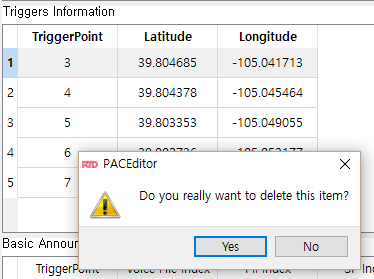
[picture p560: figure]

Click Yes to delete, No to cancel.

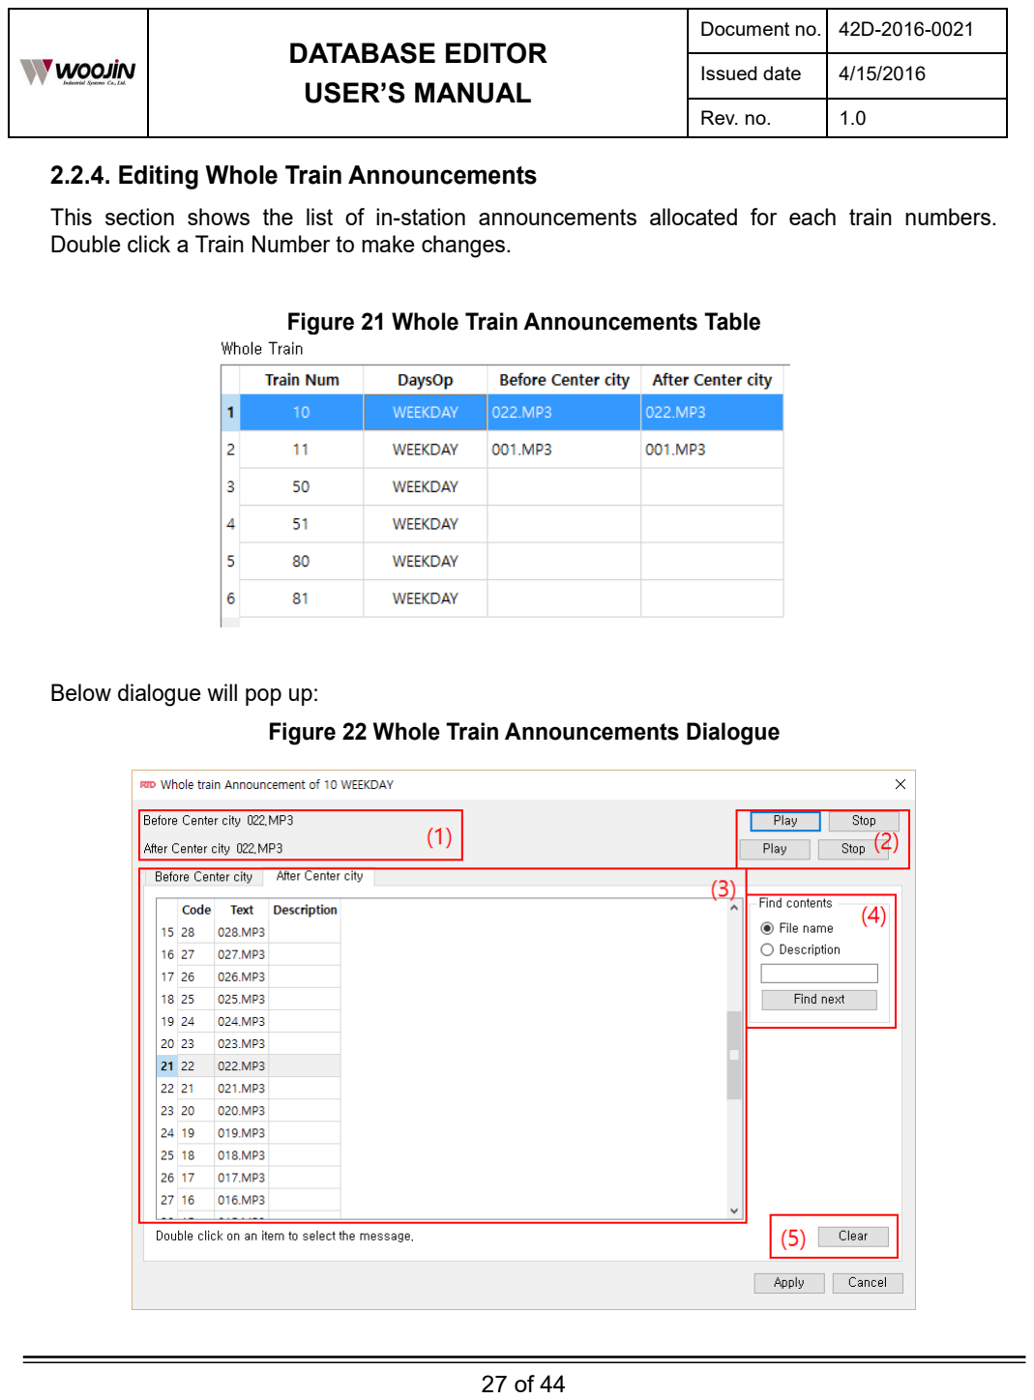
[picture p561: page 27]

### USER’S MANUAL

Rev. no. | 1.0

### 2.2.4. Editing Whole Train Announcements

This section shows the list of in-station announcements allocated for each train numbers. Double click a Train Number to make changes.

Figure 21 Whole Train Announcements Table

Below dialogue will pop up: Figure 22 Whole Train Announcements Dialogue

### USER’S MANUAL

Rev. no. | 1.0
1) Shows currently selected audio file
2) Play/stop currently selected audio file
3) Shows list of selectable audio file. Double click an item to select
4) Search content by text
5) Remove currently selected audio file

Click Apply to confirm, Cancel to dismiss.

*** Note: Audio files selected from this dialogue are automatically mapped to TP5 of each station.

### USER’S MANUAL

Rev. no. | 1.0

### 2.2.5. Editing Basic Announcements

Trigger points 3, 4, 6 and 7 are used for regular station stop announcements and messages. Double click a trigger point to make changes on the contents.

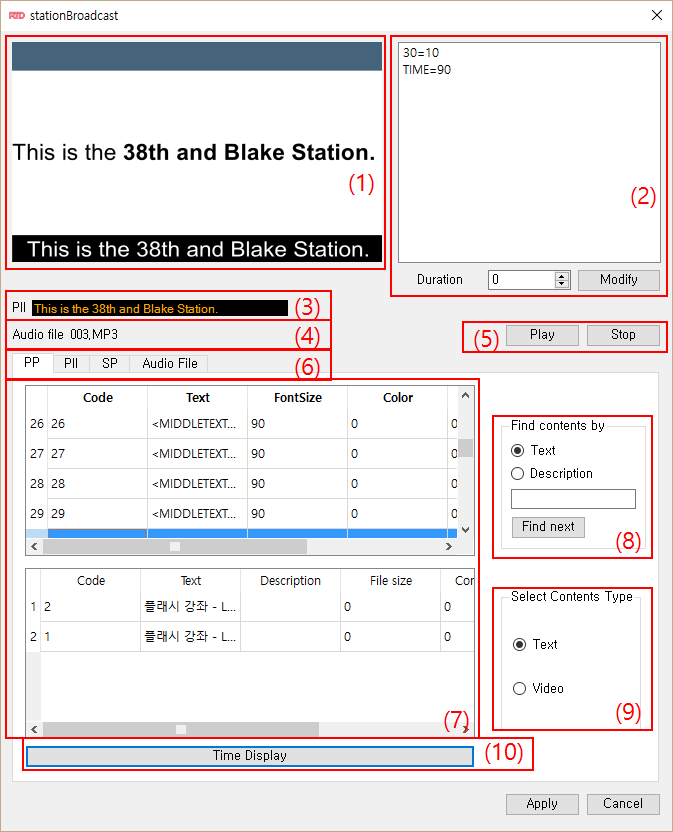
[picture p562: figure]

Figure 23 Basic Announcement Dialogue

### USER’S MANUAL

Rev. no. | 1.0
1) Preview of PP/SP messages
2) Message properties
- [XX=YY], where:
- [XX] indicates message index
- [YY] indicates the length of message display (in seconds)
- [TIME=ZZ], where:
- [ZZ] indicates the length of clock display after the regular message (in seconds)
3) Preview of PII message
4) Currently selected audio file
5) Play/stop audio file
6) Select tab to display list of selectable content (PP/PII/SP/Audio)
7) Shows list of selcetable content. Double click an item to select
8) Search content by text
9) Select PP content type (text or video)
10)Add clock display to the message properties

Click “Apply” to store the data. Click “Cancel” to dismiss.

### 2.2.6. Editing General Announcements

Trigger points 1, 2, 8 and 9 are used for additional general announcements. Follow the same method as Section 2.2.5 to register informations for general announements.
*** Note: When you add contents to trigger points 1, 2, 8 or 9, ensure there are GPS coordinates defined for that trigger point. Refer to Section 0.

* Trigger Point Reference
TP1 | TP2 | TP3 | TP4 | TP5 | TP6 | TP7 | TP8 | TP9
General announcement | General announcement | This stop announcement | announcement Next stop | Station | Next stop announcement | This stop announcement | General announcement | General announcement
| | Basic announcement | Basic announcement | Whole Train broadcast | Basic announcement | Basic announcement

### USER’S MANUAL

Rev. no. | 1.0

### 2.2.7. Route Code and Primary Player Heading

Click icon to open below dialogue. Double click an item to make change.

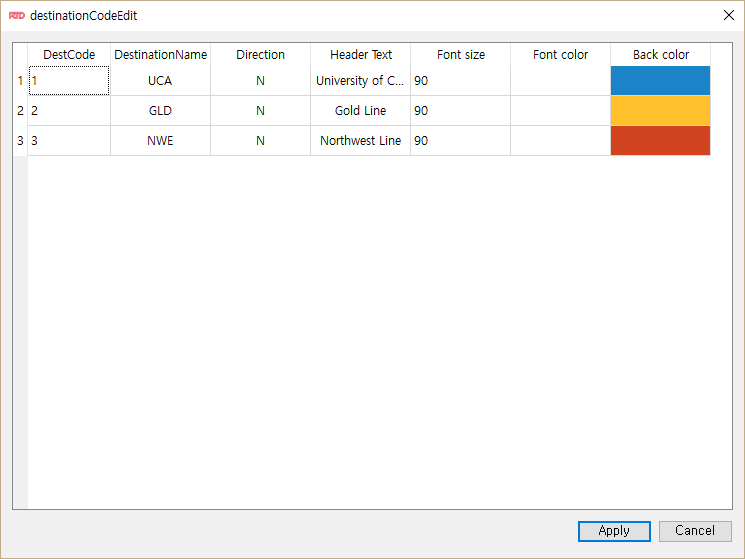
[picture p563: figure]

Figure 24 Route Dialogue (1/2)

### USER’S MANUAL

Rev. no. | 1.0

Figure 25 Route Dialogue (2/2)

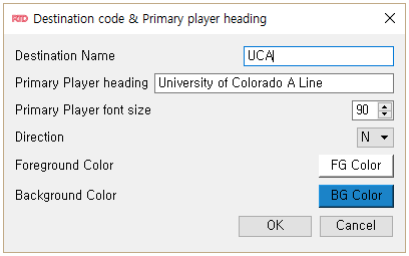
[picture p564: figure]

Make change(s) to the content. Click “OK” to register the information to the database.

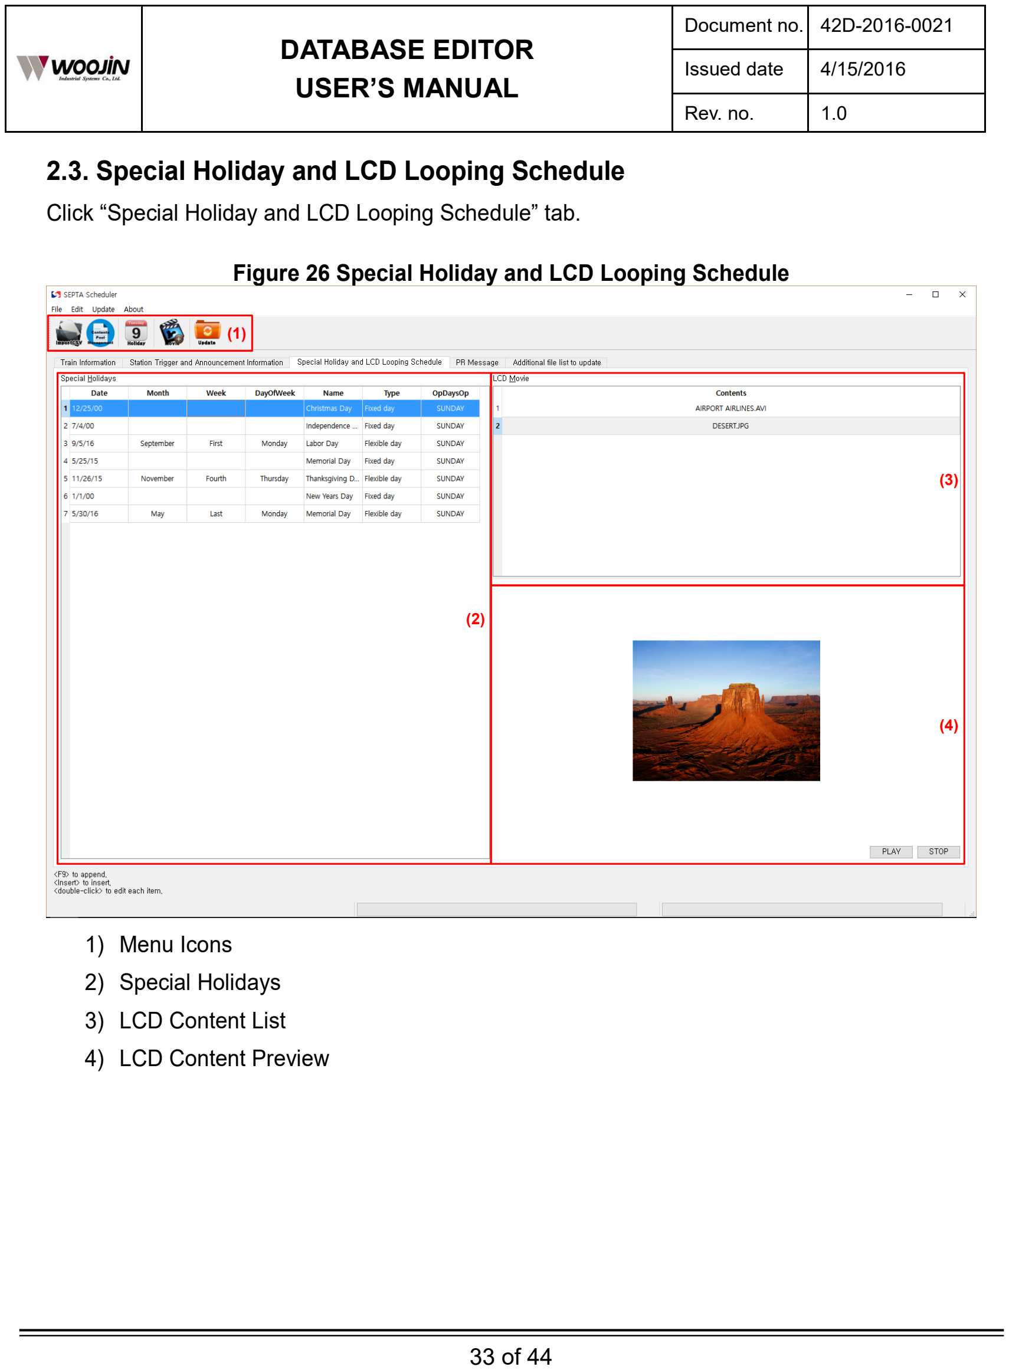
[picture p565: page 33]

### USER’S MANUAL

Rev. no. | 1.0

### 2.3. Special Holiday and LCD Looping Schedule

Click “Special Holiday and LCD Looping Schedule” tab.

Figure 26 Special Holiday and LCD Looping Schedule

1) Menu Icons
2) Special Holidays
3) LCD Content List
4) LCD Content Preview

(1)

(2)

(3)

(4)

### USER’S MANUAL

Rev. no. | 1.0

### 2.3.1. Menu Icons

Table 4 Menu Icons (Special Holiday and LCD Looping Schedule)
Icon | Icon Name | Contents
| Import CSV | Import CSV
| Content Pool Management | Open content pool dialogue
| Holiday | Edit Holiday information
| Movie | Edit Video information
| Update | Create Update Data

### USER’S MANUAL

Rev. no. | 1.0

### 2.3.2. LCD Movie

### 2.3.2.1. Changing LCD Content

In the LCD Movie table, double click an item to change. Select an item from the combo box.

Figure 27 LCD Content

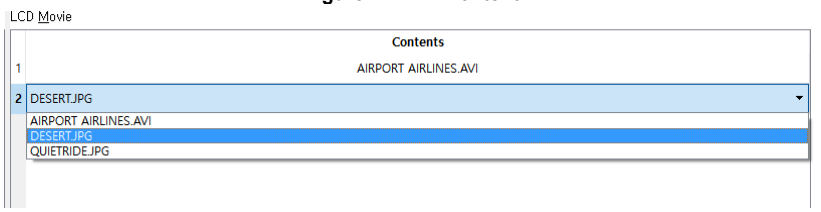
[picture p566: figure]

### 2.3.2.2. Adding LCD Content

To add a new content to the table, do one of the following:
- Select a location and press [Insert] (new field created at the selected location)
- Press [F9] (new field created at the bottom of the table)

Double click the new item to select content.

### USER’S MANUAL

Rev. no. | 1.0

### 2.3.2.3. Deleting LCD Content

To delete a content from the table, select an item and press [Delete].

Figure 28 Deleting LCD Content

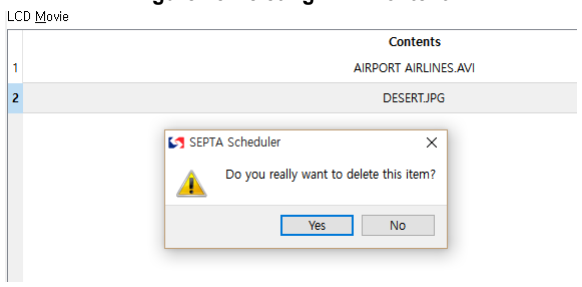
[picture p567: figure]

Click Yes to delete, No to dismiss.

### USER’S MANUAL

Rev. no. | 1.0

### 2.3.2.4. Content Preview

Select a content to preview. Click PLAY to start preview. Click Stop to stop.

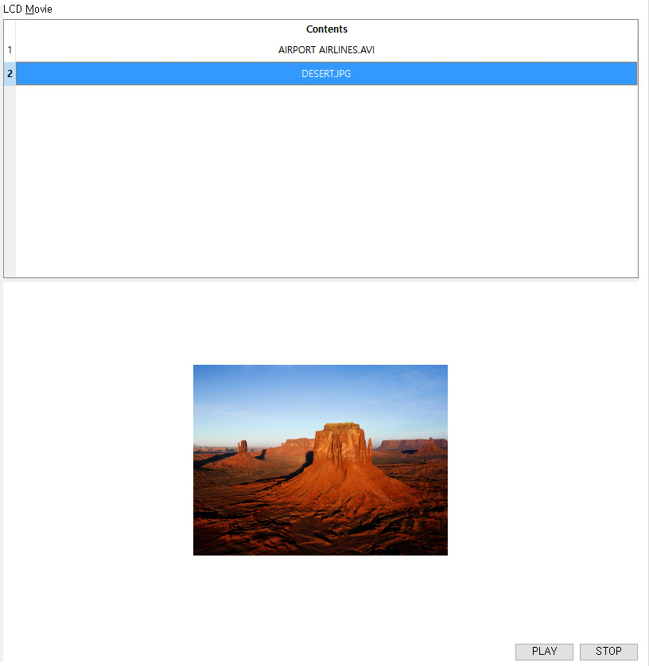
[picture p568: figure]

Figure 29 Video Preview

### USER’S MANUAL

Rev. no. | 1.0

### 2.4. PR Message

Click PR Message tab to access the screen. Up to 100 PR messages are available.

Figure 30 PR Message Screen

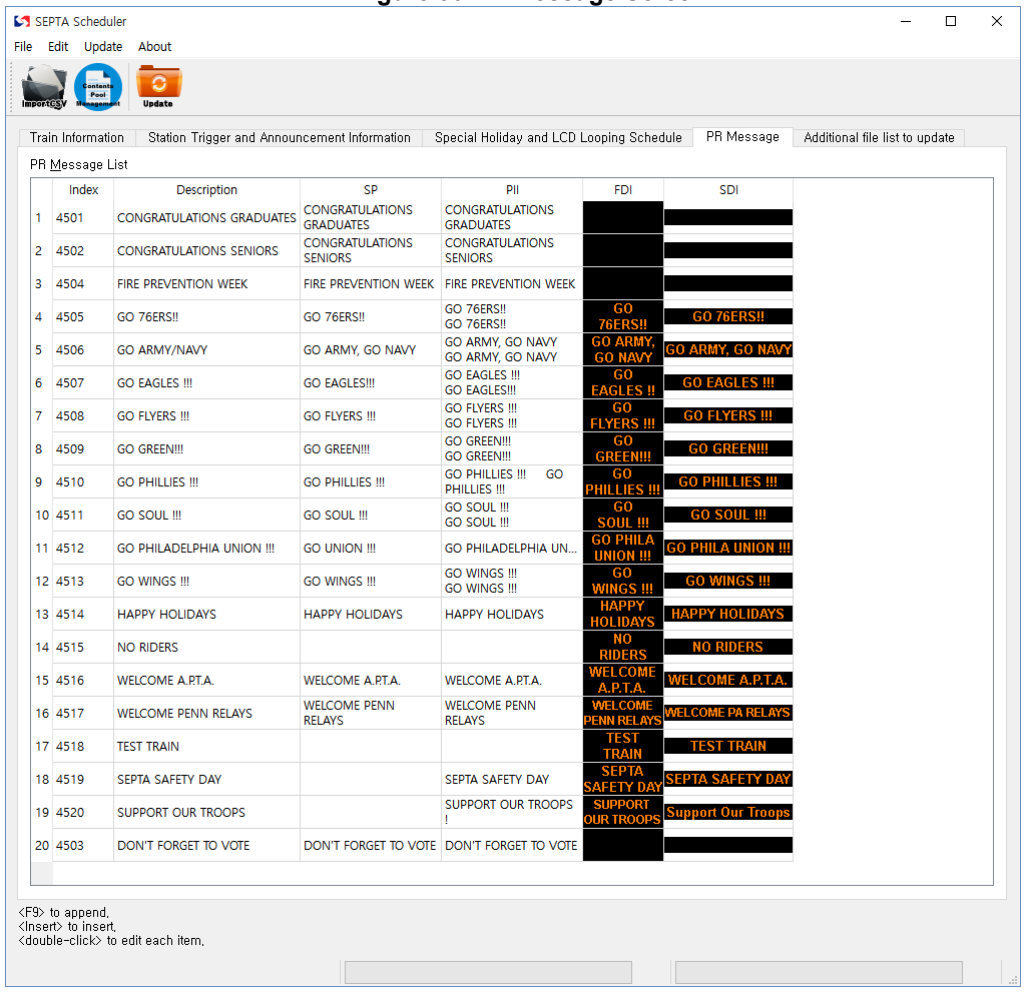
[picture p569: figure]

Double click a PR message to open the dialogue.

### USER’S MANUAL

Rev. no. | 1.0
Figure 31 PR Message Dialogue

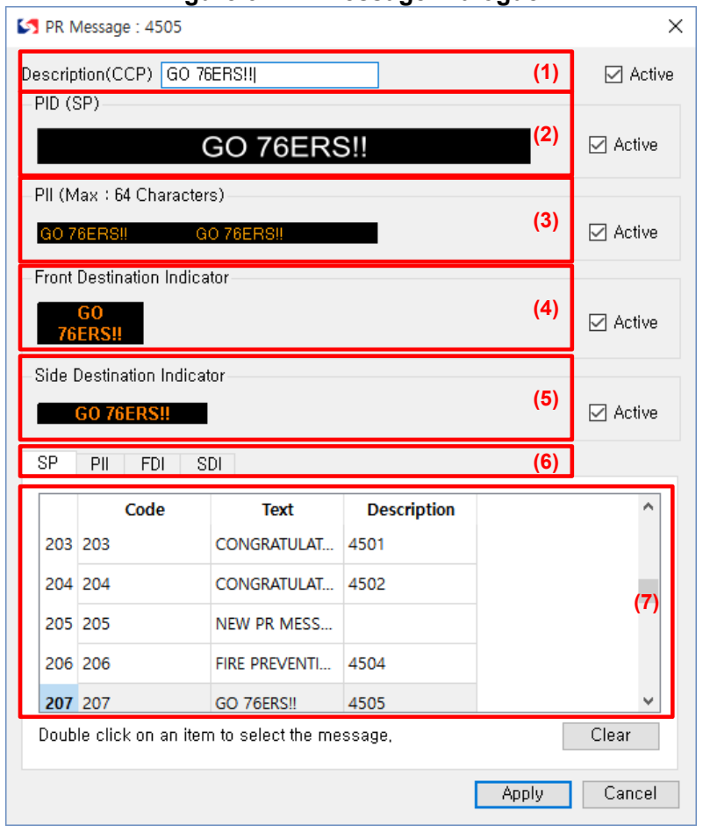
[picture p570: figure]

1) Description of PR message to be displayed on CCP selection screen
2) PR message to be displayed on the PID Secondary Player
3) PR message to be displayed on PII
4) PR message to be displayed on FDI
5) PR message to be displayed on SDI
6) SP/PII/FDI/SDI tabs: Select to view the content list
7) Content list: Double click an item to select

Click “Apply” to register the information. Click “Cancel” to dismiss.

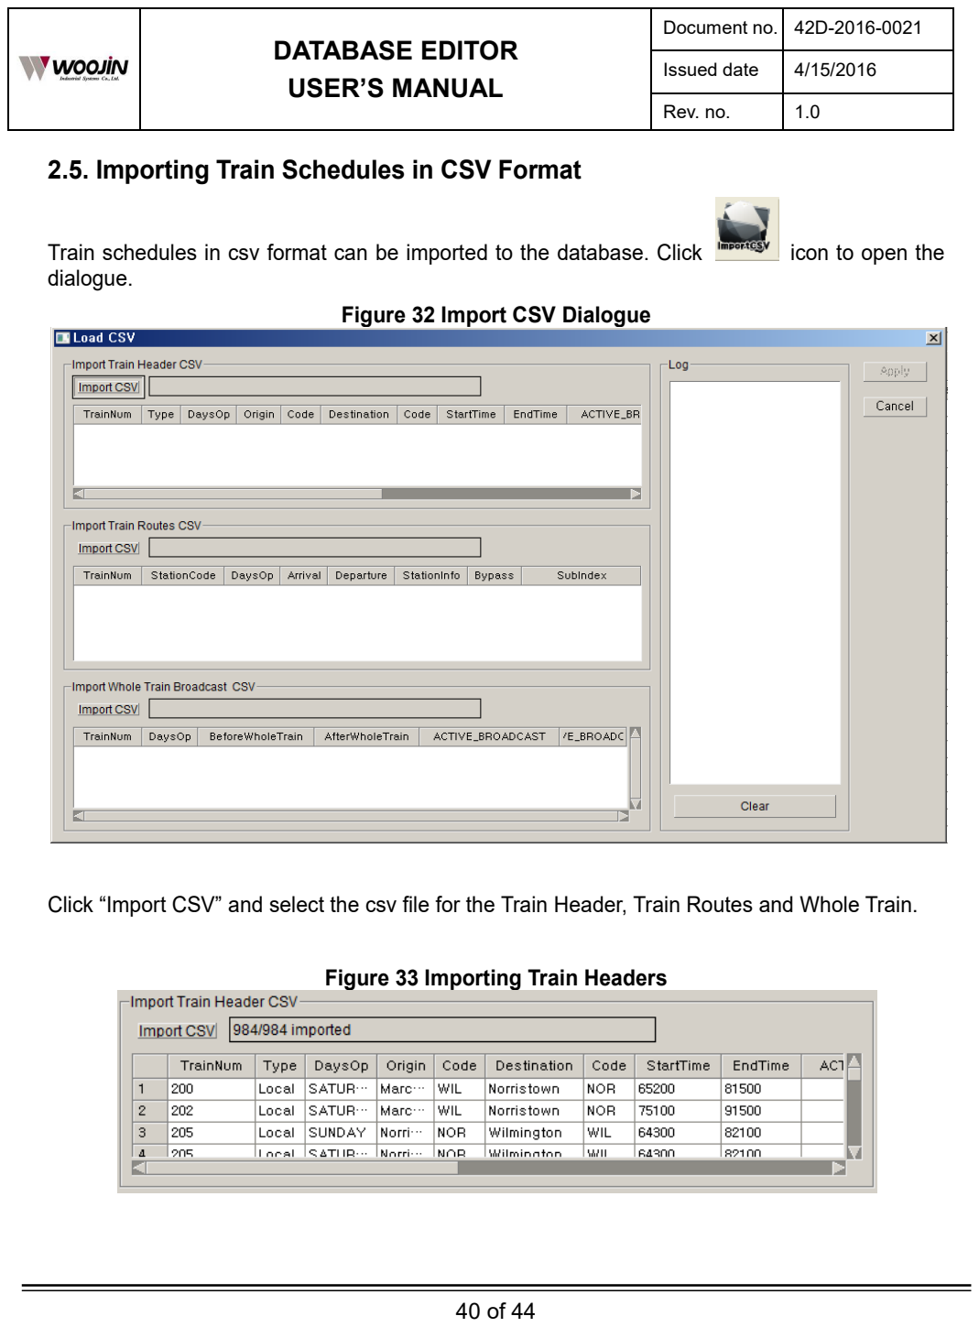
[picture p571: page 40]

### USER’S MANUAL

Rev. no. | 1.0

### 2.5. Importing Train Schedules in CSV Format

Train schedules in csv format can be imported to the database. Click icon to open the dialogue.
Figure 32 Import CSV Dialogue

Click “Import CSV” and select the csv file for the Train Header, Train Routes and Whole Train.

Figure 33 Importing Train Headers

### USER’S MANUAL

Rev. no. | 1.0
Figure 34 Importing Train Routes

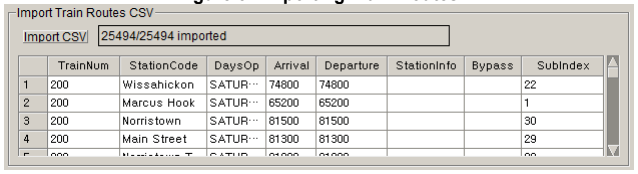
[picture p572: figure]

Figure 35 Importing Whole Train Information

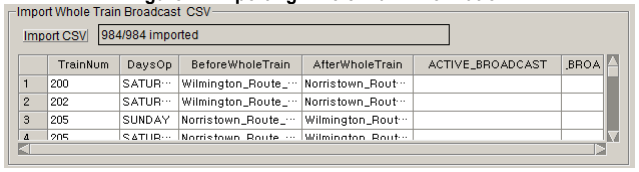
[picture p573: figure]

If the contents of the csv file do not match the database, the information will be shown in the error log window. Click “Clear” to delete the logs.
Figure 36 Error Log

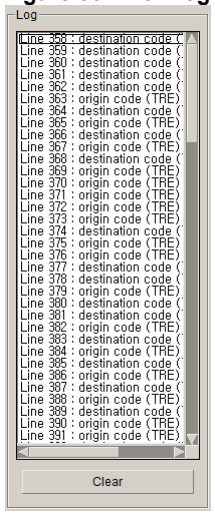
[picture p574: figure]

### USER’S MANUAL

Rev. no. | 1.0

### 2.5.1. Acceptable File Format

The csv train schedule file shall be in below format. Any format other than specified in this manual is not supported.

Train Headers
Figure 37 CSV File Format – Train Headers

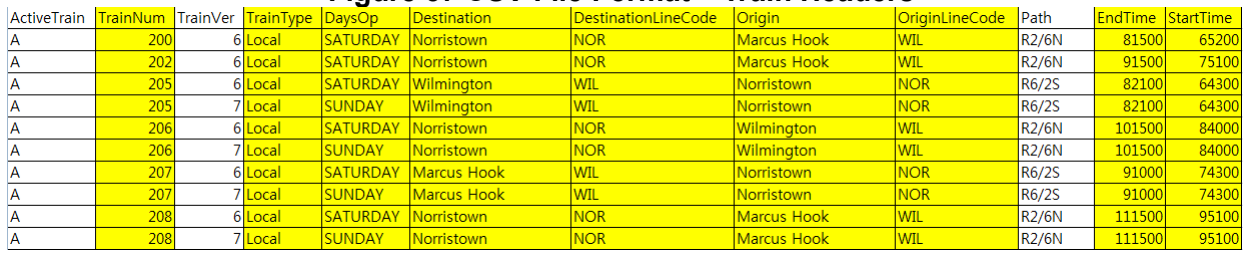
[picture p575: figure]

Train Routes
Figure 38 CSV File Format – Train Routes

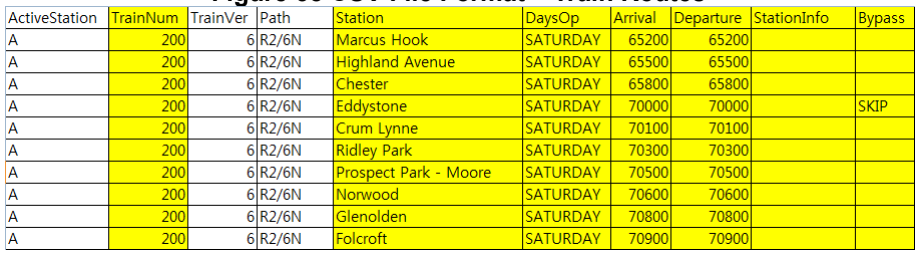
[picture p576: figure]

Whole Train
Figure 39 CSV File Format – Whole Train

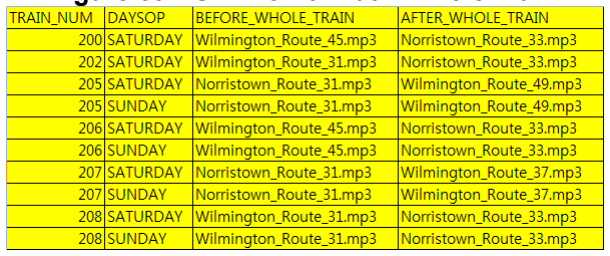
[picture p577: figure]

*** Note: Data fields marked in yellow color are referenced by the Scheduler.

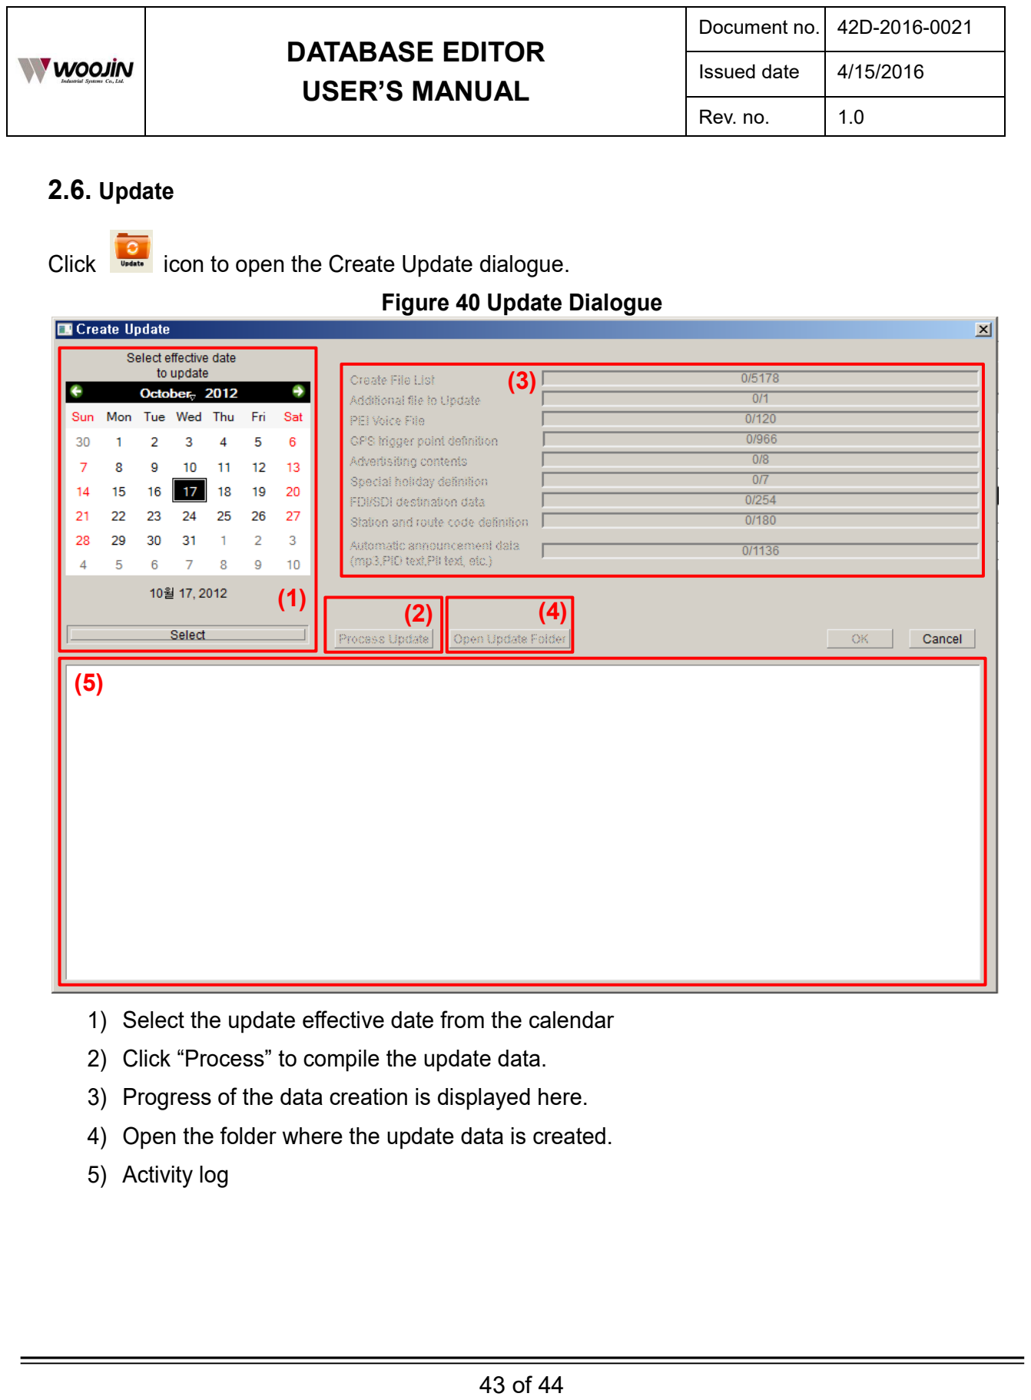
[picture p578: page 43]

### USER’S MANUAL

Rev. no. | 1.0

### 2.6. Update

Click icon to open the Create Update dialogue. Figure 40 Update Dialogue

1) Select the update effective date from the calendar
2) Click “Process” to compile the update data.
3) Progress of the data creation is displayed here.
4) Open the folder where the update data is created.
5) Activity log
(2) (1)

(3)

(4)

(5)

### USER’S MANUAL

Rev. no. | 1.0

### 2.7. Update Folder Composition

Update data processed by the Scheduler are stored in the directory as below: Figure 41 Update Folder

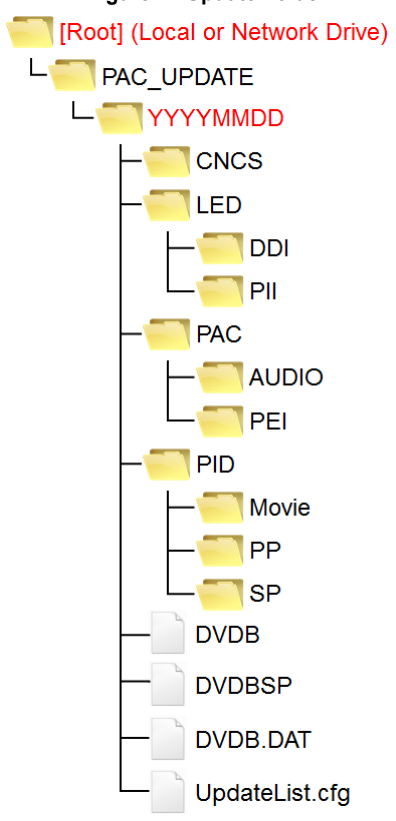
[picture p579: figure]
