JDSCS-Club/DENVER_CCP/DOC/09_발표_보고/04_장치별_기술/wayside test 구성.pptx

WABTEC

Server

CMU

E-Net cable

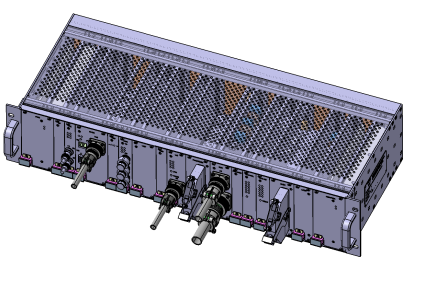
[picture p580: figure]

1. MDS 파일 전송
2. VOIP 음성 통화.
3. TEXT 전송 형식 정의.
