JDSCS-Club/DENVER_CCP/DOC/06_이슈_대응/자동방송_불량/01_대책서_보고서/Onboard Test Result (FAN Install)Eng.pptx

▣ Onboard Test Result Of Communication System Failure (FAN Installation 3/3)
◈ CRA-CNCS heating plate temperature change - Measured CRA-CNCS heating plate temperature change July 11. - CRA ambient temperature was measured max. 45°. | ◈ Test result - Two days monitoring of 4066 car after FAN installation on July 13th -> CPU internal temperature 95° → 62° -> CNCS heating plate 75° → 43° # Confirm cooling effect by FAN installation - FAN 2분만에 자동 방송 정상 동작, 20분후 주변온도까지

Before FAN installation

Test result after FAN installation

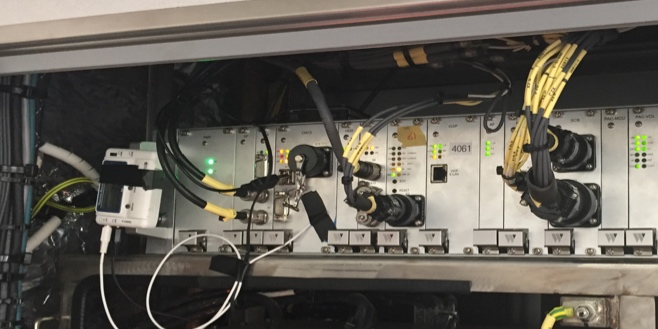
[picture p581: figure]
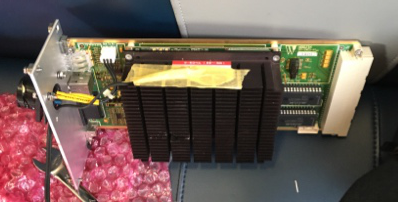
[picture p582: figure]
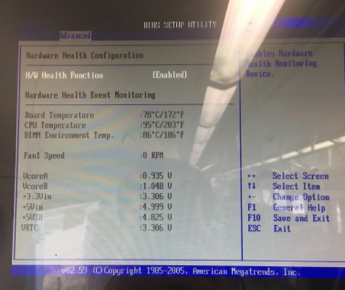
[picture p583: figure]
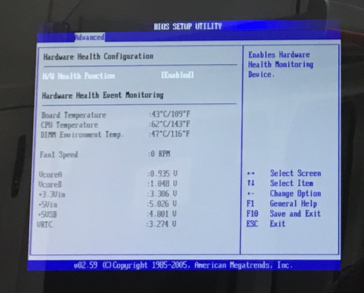
[picture p584: figure]

4066 CRA-CNCS heating plate temperature change

<CRA-CNCS heating plate>
Max 43°
/ average up to 40 °

<CRA CNCS ambient temperature >
Max 35 ° / average 30°

# 4066 CRA-CNCS average heating temperature was 40 degree


4066 CRA-CNCS heating temperature change

# 4066 CRA-CNCS average heating temperature was 70°


<CRA-CNCS heating temperature>
Max 75°/ average 70°

<CRA CNCS ambient temperature>
Max. 40°/ average 30°
