JDSCS-Club/DENVER_CCP/DOC/06_이슈_대응/자동방송_불량/03_Onboard_시험/Onboard Test Plan _20170710(ROTEM)_Eng.pdf

# ▣ Onboard Test Plan for Communication System Failure

## ◈ Details

- The onboard test result for the communication system failure (Car 62,
57) during on July 5th ~ 6th in Denver.
1) Check CPU load status by an unknown reason.
2) Internal temperature rise by CPU overload. (from 70 rising to 95 degree)
3) Communication system function was affected by internal temperature rise.

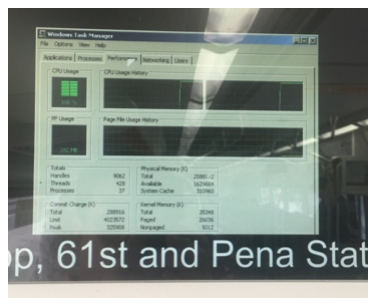
[picture p603: figure]

## ◈ Cause

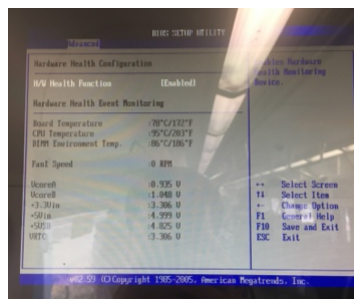
[picture p604: figure]

1) When GPS data is received through the network switch, the CNCS is overloaded due to the data proliferation by an unknown reason.
2) Failure will be continue to identify the cause during business trip.

## ◈ Temporary measure

- Restart the devices when CNCS is overloaded (Network data proliferation

occurs)

## ◈ Action plan

1) Install FAN at the top to forcibly cool the CNCS internal temperature
- The FAN is controlled by the temperature sensor and operated by sensing the temperature rise.
2) According to the failure analysis results from May to June, it is mainly occurred in specific car.
- Pre-correction of 10EA on the car (66,61,62,57,49,45,43,44,25,09)
that the failure occurred over 2 times.
⇒ Plan : 7/10 ~ 7/14 (FAN installation and monitoring on 10 cars)

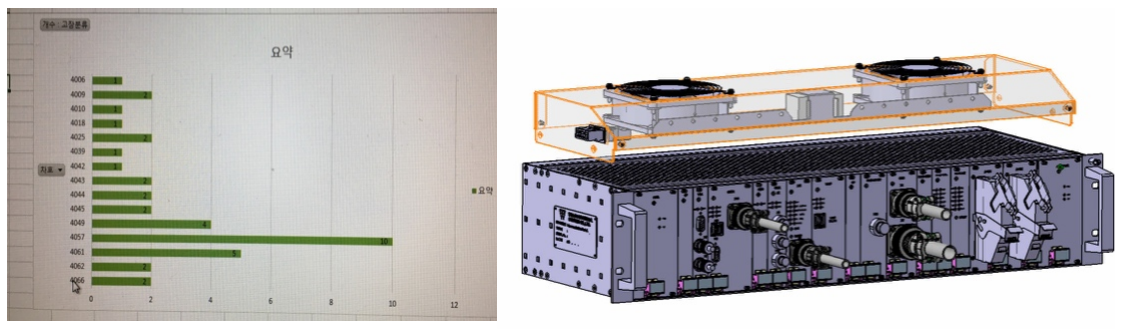
[picture p605: figure]

* 우진 산전 온도 시험 결과 FAN 동작시 20도 이상 하강 효과 확인.

Issue | Corrective action
<Overload Occurrence> | <CPU internal temperature rise>

Microsoft Excel 워
크시트

# ▣ Onboard Test Plan for Communication System Failure

## ◈ Installation Method

- On 7th July, FAN was installed on train 4035 and temperature change test was conducted.
1) FAN installation to the upper side of CRA
2) Install CRA-CNCS temperature recorder
3) Install CRA on the car (FAN installation)

## ◈ FAN Operation Method

- Use train power as operating power
- The operating temperature can be set by the temperature sensor.
- The FAN operates when the CRA ambient temperature is higher than the

set temperature.

### FAN Component Description and Operation Method

<Before FAN installation> | <After FAN installation>

### FAN Installation Method

TR-71Ui

<FAN > | <temperature sensor>

# ▣ Onboard Test Plan for Communication System Failure

## ◈ Measurement of ambient temperature change

- CRA ambient temperature was measured on July 5-6 using temperature recorder (TR-71Ui)
- CRA operating environment temperature up to 45 degree. .

## ◈ Test result

- When CPU overload is occurred by CPU monitoring, records the internal temperature.
- After operating FAN for 2 mins, the communication system is returned to normal and decrease the ambient temperature.
- The ambient temperature is up to 45 degrees on the car.
Result: When FAN is operating, the temperature is decreased both ambient and CRA-CNCS which is maintained 50 degree.

### First onboard test result

<CRA ambient
temperature>

<CRA CNCS Heating plate temperature>

- CPU overload.
à Communication system failure
- CPU internal temperature is 99 degree
- Heating plate is 67 degree
- CPU internal
temperature 80 degree.
- Heating plate is 40
degree
- FAN operation for 2 mins
à Heating plate temperature is decrease from 67 to 50 degree
- Return the normal
communication system function

### CRA Operating environment temperature

TR-71Ui

<CRA CNCS upper side>

<CRA ambient
temperature>

4061 CRA ambient temperature measurement

Check # 4061 CRA operating environment temperature up to 45 degree
