JDSCS-Club/DENVER_CCP/DOC/06_이슈_대응/PID_불량/01_보고서_ECN/Test result_D4 in DPO.xlsx

TEST RESULT OF 'D4' on DPO control board
TRAINSET # | SERIAL NUMBER OF DPO |  | DATE | VALUE |  | RESULT (P: PASS, F: Fail) | REMARK
 | A car | B car |  | A car | B car
4001
4003
4005
4007
4009
4011
4013
4015
4017
4019
4021
4023
4025
4027
4029
4031
4033
4035
4037
4039
4041
4043
4045
4047
4049
4051
4053
4055
4057
4059
4061
4063
4065
