JDSCS-Club/DENVER_CCP/DOC/09_발표_보고/04_장치별_기술/Wayside Test Blouck.pptx

Woojin

Inter-M

## Slide 2


CRA

DPO

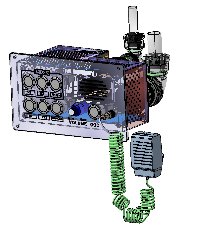
[picture p627: figure]

Woojin
VPN Server

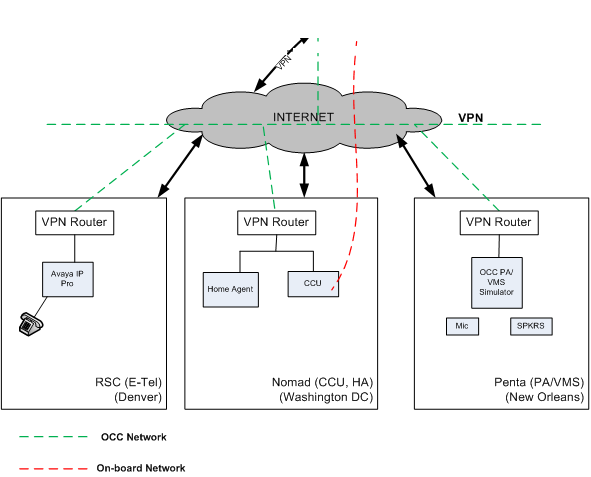
[picture p628: figure]

PEI
