JDSCS-Club/DENVER_CCP/DOC/06_이슈_대응/FMI/TEST1.pptx

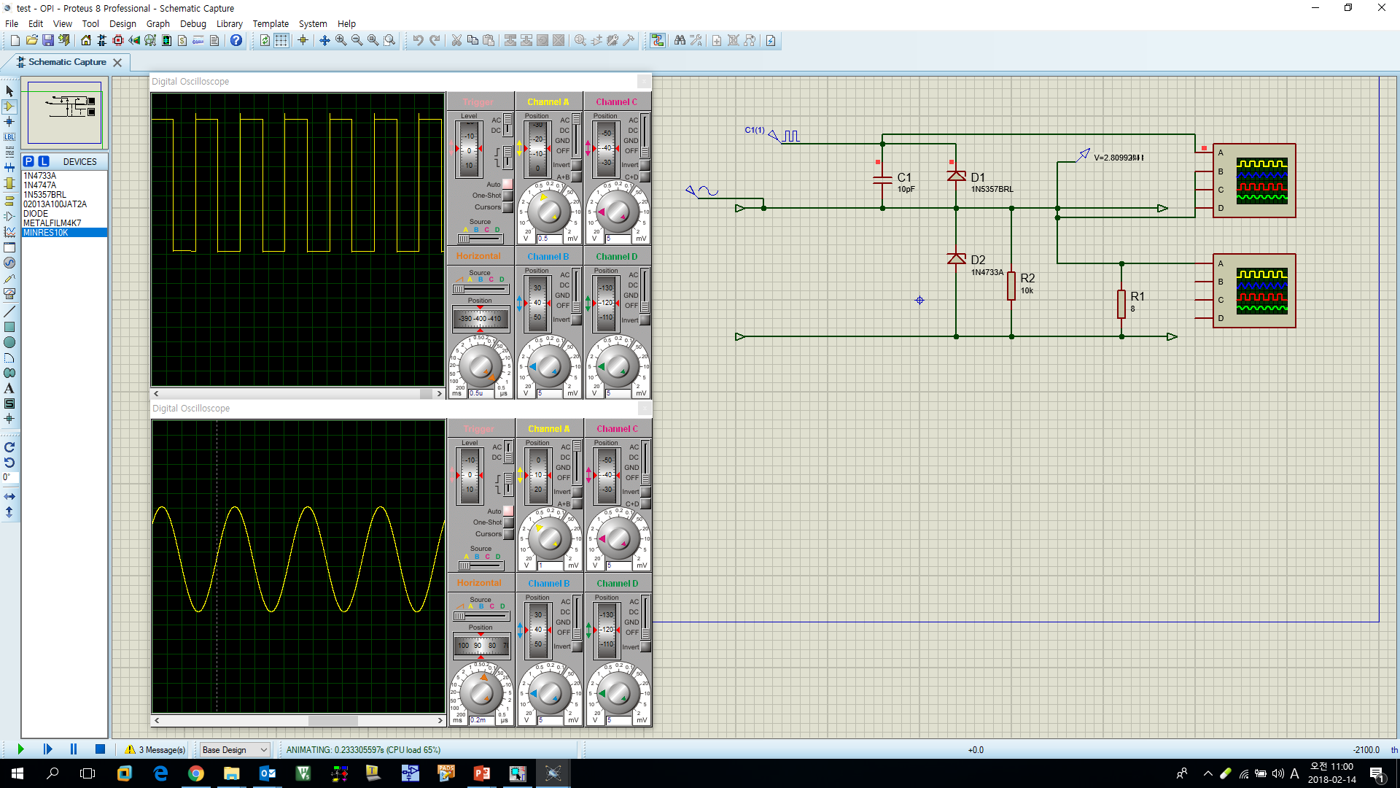
[picture p629: figure]
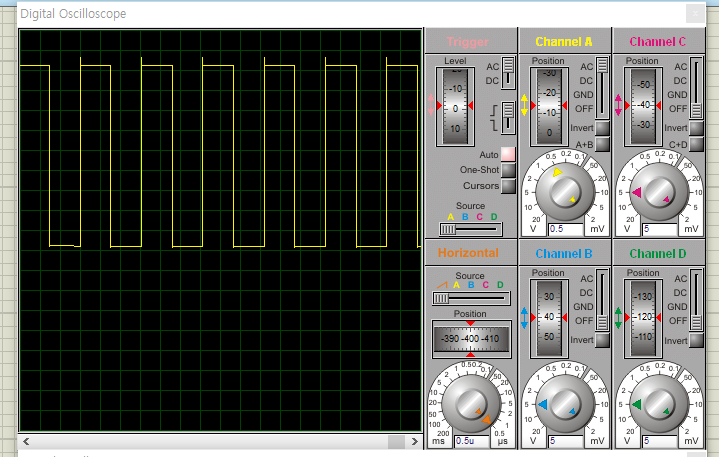
[picture p630: figure]

## Slide 2

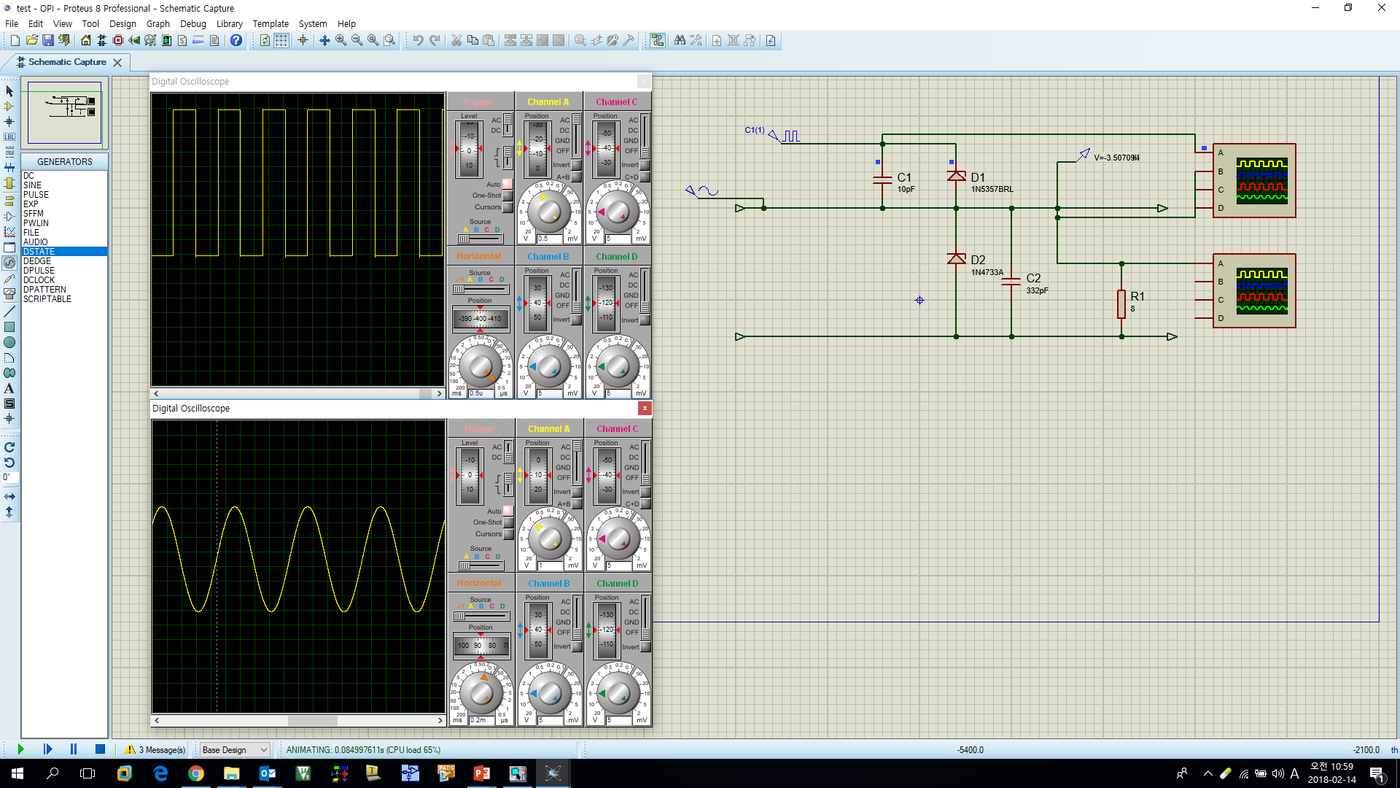
[picture p631: figure]
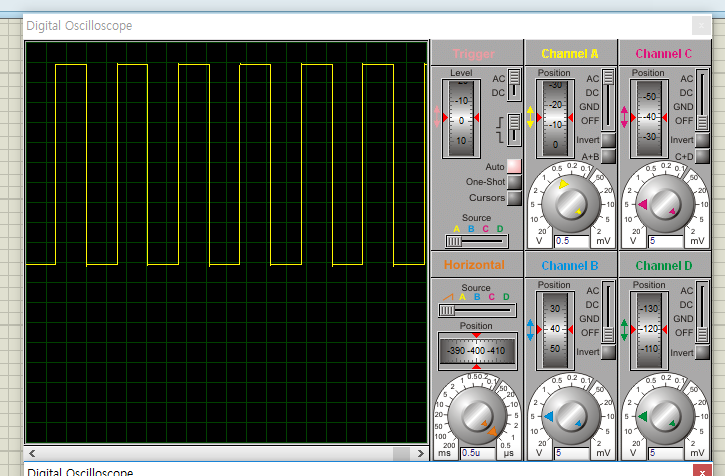
[picture p632: figure]

## Slide 3
