JDSCS-Club/DENVER_CCP/DOC/01_인터페이스_설계/MDS_ICD/07_시험_검증/Requirements Verification Matrix.docx

Requirement | Source of Requirement | Rotem Understanding Of Requirement | Customer Agreement with Understanding | Design Compliance Status | Description Of Compliance Difficulty | Resolution Of Design Compliance Difficulty | Requirement Verification Method | Requirement Verification Result and Report | Customer Acceptance Of Verification

In my experience, this will turn out to be the most valuable piece of paper involved in the project!

Green – Compliance with requirement anticipated with no difficulty

Yellow – Compliance with requirement is at risk or in doubt

Red – A design change or requirements relief is need to achieve compliance

Requirements Verification Matrix
