JDSCS-Club/DENVER_CCP/DOC/10_프로그램문서/2012_06_04(케나다 출장 완료)_문서/문서/CI Phase Shift Function Test Records 확인서(2012.5.24).pdf

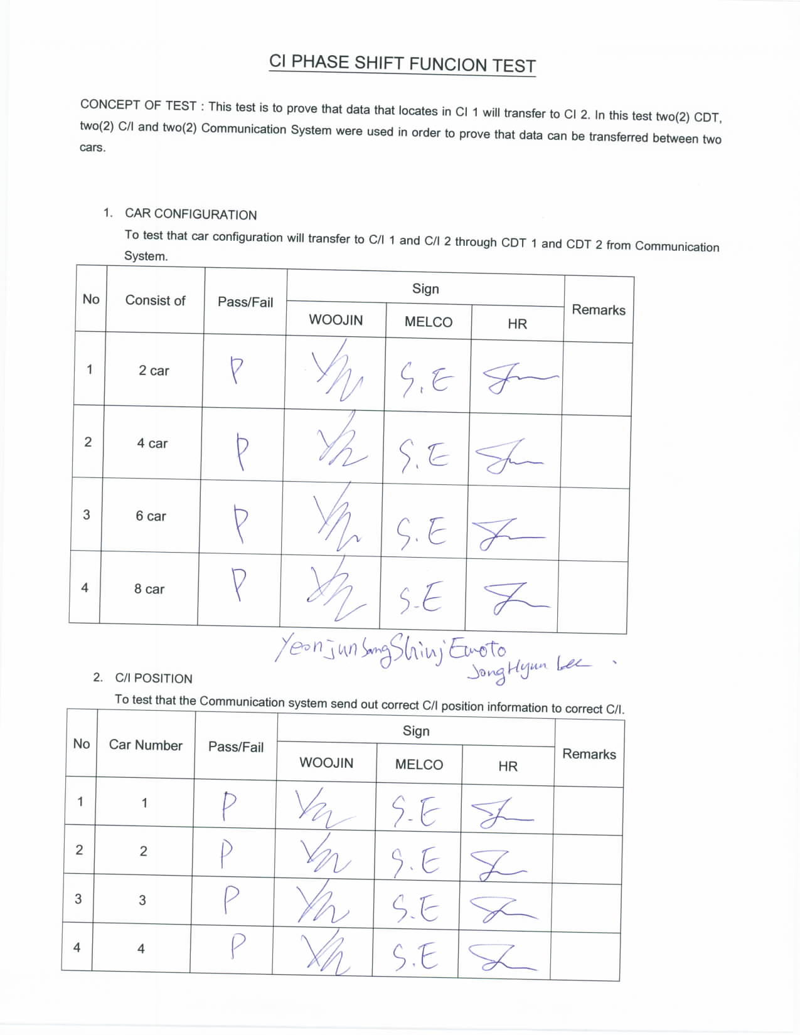
[picture p702: page 1]
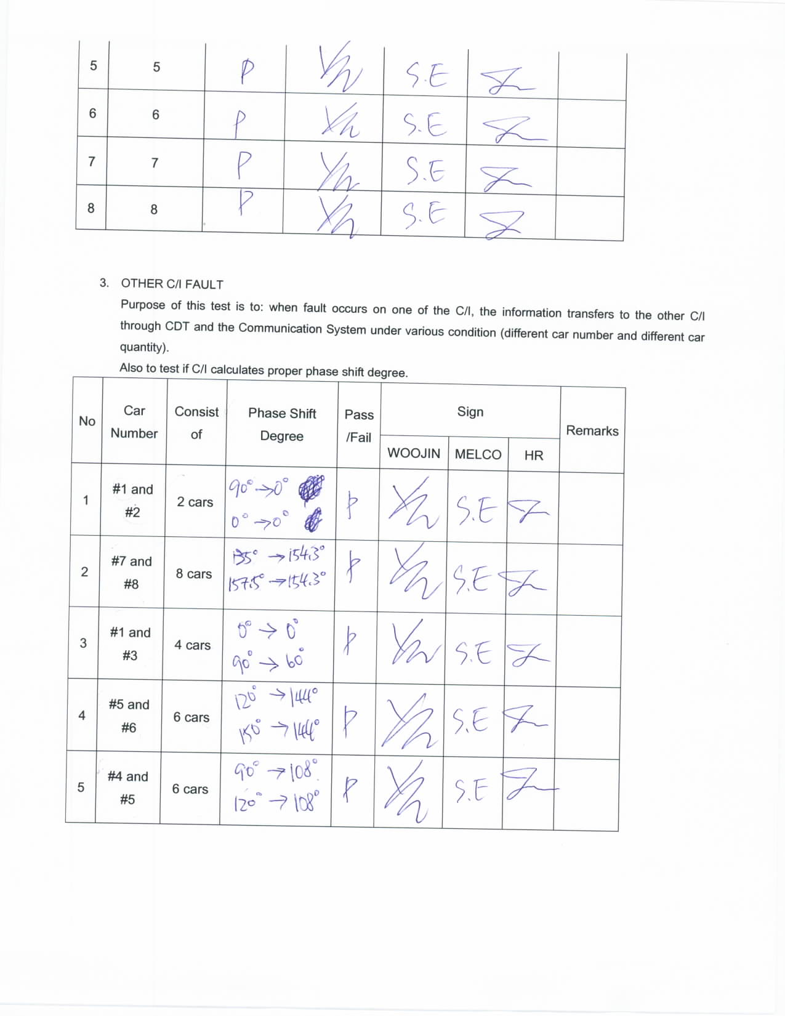
[picture p703: page 2]
