JDSCS-Club/DENVER_CCP/DOC/04_SW_문서/CMMI/Appendix VIII_Subsystem Hazard Analysis.xls

Sheet: SSHA
Hazard No. | Subsystem | Hazard Description | Hazard Causes | Hazard Effects | Original Risk |  |  | Can Software contribute to the Hazard (Yes/No) | Software Control Category (I,ii,iii,iv) | Software Module(s) Contributing To Hazard | Recommended Control / Mitigation. | Residual Risk |  |  | Remark
 |  |  |  |  | Frequency | Severity | Risk Index |  |  |  |  | Frequency | Severity | Risk Index
SSHA-01 | ATC | False detection of speed command carrier signals. | Attenuation of out-of-band signals degraded. | Possible reception of false speed command thus leading to collision or derailment. | 2 | II | R | Yes | iii | HSVCFD | Design ATC equipment in a fail safe manner with a highly selective filter to separate valid cab carrier signals from electrical noise. | 4 | II | Y | The MicroCabmatic ATC design will implement the signal filtering function in diverse channels with error detection protection. Safety assurance of the function is provided by proven design techniques, including validation of safe operation by the VPC, The ATC design automatically requests for braking, as necessary, to ensure safe circuit operation.
SSHA-02 | Brake System | Emergency brakes fail to ap-ply when re-quested (per car). | Failure of the Brake Pipe Control Unit, Brake Cylinder Control Unit, Brake Handle Unit or other friction brake devices | Potential se-vere injury due to an over-speed condi-tion and colli-sion. Loss of emergency friction brakes on the associ-ated car. Emergency braking is re-duced up to 50% on a mar-ried pair and 100% on a sin-gle car during an emergency brake applica-tion. | 3 | II | Y | Yes | i | Wheel Slide Control Module, Input Proc-essing, Self-test | 1. Software failure only ef-fects possible loss of emergency braking when the wheel slip trainline is energized. 2. Independent emergency friction brake controls are provided for each car. 3. Brake Pipe Control Unit is provided per car. 4. Brake Cylinder Control Unit, brake assurance pneumatic emergency, and wheel slip control are provided per truck. 5. Emergency brake applica-tion can be initiated both electrically and pneumati-cally. 6. Emergency circuit is de-signed such that an open circuit in either leg will re-sult in an emergency brake application. | 5 | II | G
Hazard No.: Sequential Number such as SSHA-01, SSHA-02
Subsystem: the relevant subsystem related to the concerned hazard
Hazard Description.: A description of real or potential conditions that cause injury or death, or damage to or loss of equipment or property
Hazard Causes: Identify all of the potential causes of the hazardous condition
Hazard Effects: describe what the consequences of the hazard occurring are likely to be. As a minimum, this should include a description of the most likely consequence, and the worst consequence
In Original Risk, enter assessments of.:
Probability(Frequency):the probability of occurrence of the hazardous event in terms of the most likely consequence and the worst consequence,
using the classification system described in attached risk matrix worksheet
Severity:the severity of the consequences of the hazardous event in terms of the most likely consequence and the worst consequence, using the classification system described in attached risk matrix worksheet
Risk Index: an estimation of the acceptability of the risk arising from the combination of the qualitative measure of the worst and most frequent potential consequences resulting from the hazard,
and their probability of occurrence using the risk assessment matrix reproduced in attached risk matrix worksheet
Can Software contribute to the Hazard (Yes/No): Indicate Yes or No whether the hazard is related to Software
Software Control Category: This is an indicator that describes the degree that software contributes or exercise control over functions that are critical to the hazard using Software Control Category Table in attached risk matrix worksheet
Recommended Control / Mitigation.: describe actions that can be taken or procedural changes that can be made to prevent the anticipated hazardous event from occurring,
reduce it’s probability, or reduce it’s severity.
Enter which approach is being proposed : design change, safety device, warning device, procedures, special training, etc.
In Residual Risk , enter assessments of.: enter the probability, severity and criticality arising from the hazard following the implementation of the controlling measures
Remark: enter any other relevant considerations

Sheet: Risk Matrix
Hazard Probability
Hazard Probability Description | Hazard Probability Category | Definition
FREQUENT | 1 | Likely to occur frequently : X> 10-3
PROBABLE | 2 | Will occur several times in the life of an item: 10-3 > X> 10-5
OCCASIONAL | 3 | Likely to occur some time in the life of an item: 10-5 > X> 10-7
REMOTE | 4 | Unlikely but possible to occur in the life of an item: 10-7 > X> 10-9
IMPROBABLE | 5 | So unlikely, it can be assumed occurrence may not be experienced: 10-9 > X
Hazard Severity
Hazard Severity Description | Hazard Severity Category | Definition
CATASTROPHIC | I | Multiple fatalities, high speed collision, major environmental damage, loss > one car
CRITICAL | II | Severe injury, collision < 15 mph, loss of one car or significant damage to two cars.
MARGINAL | III | Minor injury, minor damage (< $100K) to one or two cars, major operational disruption.
NEGLIGABLE | IV | No lost time injuries, very minor damage (< $10K) to one or two cars, minor to moderate operational disruption.
Hazard Risk Assessment Matrix
Software Control Categories
