JDSCS-Club/DENVER_CCP/DOC/06_이슈_대응/CNCS_발열/01_보고서_분석/CNCS failure list 20161102.xlsx

Sheet: Sheet1
 |  |  |  | Date: 7/1/2016
Car Number | serial# | Date | Detail | Service Detail
4007 | 13028 and 14030 | 2016-07-11 | Bad front PEI on 4007. When you press the front PEI, you can not hear the operator. | Bad PEI. Replaced it from 4047 On my desk HT7/11/16 Give it to Rotem to sent to Korean (8/10/16)
4010 | 12025 | 2016-10-17 | All PA system is not working. Bad AMP Power board. Replaced it from 4024. | 4010 AMP Power board send to Korean for repair. HT10/17/16
4014 | 13009 | 2016-11-02 | No auto anoouncement on 10/30/16 | Bad CNCS board. Sent to Korean team for repair. HT11/2/16
4017 | 15022 | 2016-11-02 | No auto anoouncement and blackout pid screen on 11/1/16. | Bad CNCS board. Sent to Korean team for repair. HT11/2/16
4020 | 13005 | 2016-11-02 | No auto anoouncement on 10/24/16 | Bad CNCS board. Sent to Korean team for repair. HT11/2/16
4021 | 12033 | 2016-09-23 | All PA system is no working. Bad AMP POWER Board. Replaced it from 4048 to 4021. | 4021 Bad AMP POWER board send to Korean for repair. HT9/23/16
4027 | 13042 | 2016-07-13 | CNCS board in 4027 is bad. When you key up, it auto announcement for 2 to 3 seconds then stop for 4 to 5 seconds and it continue to do that . Replaced it with the one spare that I have on my desk. | Missing CNCS Board. Send to the Korean for repair.HT7/13/16. Received on 10/17/16 HT | 14
4032 | 13201 | 2016-09-23 | No Cab announcement. Bad PAC INT board. Replaced it from 4048 to 4032 | Bad PCA INT Board. HT9/23/16 | 17
4044 |  | 2016-09-17 | Black PID2 screen in 4044. Replaced (whole PID2 screen) from the one in 4024 | Bad power supply board only. Now on 4024 PID2 screen. 9/19/16 | 51
4045 | 14001 | 2016-11-02 | No auto anoouncement and blackout pid screen on 9/17/16. | Bad CNCS board. Sent to Korean team for repair. HT11/2/16
4045 |  | 2016-09-17 | No auto announcement in 4045. Bad CNCS board. Repla ed it from the one on 4024. | 4024 have a bad CNCS board now. It on my desk. HT9/19/16. Waiting to received the other from Korean then will send this one to Them.
4046 | 13029 | 2016-09-07 | CNCS board in 4046 is bad. When you key up, it auto announcement for 2 to 3 minutes then stop and it won't work after that. Replaced it with the one from 4048. | 4048 Missing CNCS Board. Send to the Korean for repair.HT9/7/16. Received back from Korean on 10/17/16
4049 | 14017 | 2016-07-01 | HDD board is taken to Korean by Sangsam Lee | Korean team have the HDD Board. HT7/1/16
4050 | 14002 | 2016-11-02 | No auto anoouncement on 10/27/16 | Bad CNCS board. Sent to Korean team for repair. HT11/2/16
4050 | 14040 | 2016-09-07 | Bad CNCS board | 4048 Missing CNCS Board. Send to the Korean for repair.HT9/7/16.
4050 |  | 2016-11-02 | HDD Board | Give to Eric. HT11/2/16
4051 | 12007 | 2016-07-13 | CNCS board in 4051 is bad. When you key up, it showed lines on the PIDS screen. Replaced it with the one spare that I have on my desk. | Missing CNCS Board. Send to the Korean team for repair.HT7/13/16. Received it on 10/17/16
4051 | 13010 | 2016-11-02 | No auto anoouncement on 10/28/16 | Bad CNCS board. Sent to Korean team for repair. HT11/2/16
4062 | 14009 | 2016-09-15 | No interior in all the speaker in 4062. Bad AAB1 board and got it from 4048 to replaced it. | 4048 missing AAB1 board. Send to Korean for repaired. HT9/7/16
4062 | 14030 | 2016-08-03 | Bad front PEI on 4062. When you press the front PEI, no auto announcement in the Cab | Bad PEI. Replaced it from 4047 On my desk. HT8/3/16 Give it to Rotem to sent to Korean.HT(8/10/16)
 |  | 2016-11-02 | 2 voip,2 RS485, PAC MCU | Give to Eric. HT11/2/16

Sheet: CNCS
CNCS Board Status
Date | Serial # | Car # | Issue | Status
2016-07-13 | 12007 | 4051 | CNCS board in 4051 is bad. When you key up, it showed lines on the PIDS screen. Replaced it with the one spare that I have on my desk. | Returned
2016-07-13 | 13042 | 4027 | CNCS board in 4027 is bad. When you key up, it auto announcement for 2 to 3 seconds then stop for 4 to 5 seconds and it continue to do that . Replaced it with the one spare that I have on my desk. | Returned
2016-09-07 | 13029 | 4046 | CNCS board in 4046 is bad. When you key up, it auto announcement for 2 to 3 minutes then stop and it won't work after that. Replaced it with the one from 4048. | Returned
2016-09-07 | 14040 | 4050 | Bad CNCS board (announcement too fast) | In Korea
2016-09-17 | 14001 | 4045 | No auto anoouncement and blackout pid screen on 9/17/16. | In Denver
2016-10-24 | 13005 | 4020 | No audio auto announcement | In Denver
2016-10-27 | 14002 | 4050 | No audio auto announcement | In Denver
2016-10-28 | 13010 | 4051 | No audio auto announcement | In Denver | CNCS 통신 고장 현시
2016-10-30 | 13009 | 4014 | No audio auto announcement | In Denver | CNCS 통신 고장 현시
2016-11-01 | 15022 | 4017 | No auto anoouncement and blackout pid screen on 11/1/16. | In Denver | CNCS 통신 고장 현시
