JDSCS-Club/DENVER_CCP/CCP/SW/엑스바이더/CCP_1.0.0.2/BuildLog.htm

빌드 로그

| | 빌드 시작: 프로젝트: CCP, 구성: Release|MVC100 (ARMV4I)

명령줄

다음 내용이 포함된 "d:\작업공간\Denver\CCP\CCP_1.0.0.0\MVC100 (ARMV4I)\Release\RSP0000011875219472.rsp" 임시 파일을 만들고 있습니다.
[
/Od /D "NDEBUG" /D "_WIN32_WCE=0x600" /D "UNDER_CE" /D "WINCE" /D "ARM" /D "_ARM_" /D "STANDARDSHELL_UI_MODEL" /D "_UNICODE" /D "UNICODE" /FD /EHsc /MT /fp:fast /GR- /Yu"stdafx.h" /Fp"MVC100 (ARMV4I)\Release/AnCCP_MFC.pch" /Fo"MVC100 (ARMV4I)\Release/" /Fd"MVC100 (ARMV4I)\Release/vc80.pdb" /W3 /c /Zi /TP

.\Serial.cpp
]
"cl.exe @"d:\작업공간\Denver\CCP\CCP_1.0.0.0\MVC100 (ARMV4I)\Release\RSP0000011875219472.rsp" /nologo" 명령줄을 만들고 있습니다.
다음 내용이 포함된 "d:\작업공간\Denver\CCP\CCP_1.0.0.0\MVC100 (ARMV4I)\Release\RSP0000021875219472.rsp" 임시 파일을 만들고 있습니다.
[
/OUT:"MVC100 (ARMV4I)\Release\AnCCP_MFC.exe" /INCREMENTAL:NO /MANIFEST:NO /NODEFAULTLIB:"oldnames.lib" /DEBUG /PDB:"d:\작업공간\Denver\CCP\CCP_1.0.0.0\MVC100 (ARMV4I)\Release\AnCCP_MFC.pdb" /MAP /STACK:65536,65536 /OPT:REF /OPT:ICF /ENTRY:"WinMainCRTStartup" /DYNAMICBASE:NO /subsystem:windowsce,6.00 libsqlite3.lib ole32.lib oleaut32.lib uuid.lib

".\libsqlite3.lib"

".\MVC100 (ARMV4I)\Release\BmpDC.obj"

".\MVC100 (ARMV4I)\Release\CCP.obj"

".\MVC100 (ARMV4I)\Release\CCPDlg.obj"

".\MVC100 (ARMV4I)\Release\stdafx.obj"

".\MVC100 (ARMV4I)\Release\util.obj"

".\MVC100 (ARMV4I)\Release\CCP.res"

".\MVC100 (ARMV4I)\Release\BmpButton.obj"

".\MVC100 (ARMV4I)\Release\RichStatic.obj"

".\MVC100 (ARMV4I)\Release\PageCar.obj"

".\MVC100 (ARMV4I)\Release\PageCI.obj"

".\MVC100 (ARMV4I)\Release\PageConfig.obj"

".\MVC100 (ARMV4I)\Release\PageHelp.obj"

".\MVC100 (ARMV4I)\Release\PageManager.obj"

".\MVC100 (ARMV4I)\Release\PageNumber.obj"

".\MVC100 (ARMV4I)\Release\PagePR.obj"

".\MVC100 (ARMV4I)\Release\PageRoute.obj"

".\MVC100 (ARMV4I)\Release\CeSQLite.obj"

".\MVC100 (ARMV4I)\Release\DBCM.obj"

".\MVC100 (ARMV4I)\Release\DBRoute.obj"

".\MVC100 (ARMV4I)\Release\DBSchedule.obj"

".\MVC100 (ARMV4I)\Release\DBTrigger.obj"

".\MVC100 (ARMV4I)\Release\StatusVariable.obj"

".\MVC100 (ARMV4I)\Release\Packet.obj"

".\MVC100 (ARMV4I)\Release\Serial.obj"

".\MVC100 (ARMV4I)\Release\Update.obj"
]
"link.exe @"d:\작업공간\Denver\CCP\CCP_1.0.0.0\MVC100 (ARMV4I)\Release\RSP0000021875219472.rsp" /NOLOGO /ERRORREPORT:PROMPT" 명령줄을 만들고 있습니다.

출력 창

| | 컴파일하고 있습니다... Serial.cpp 링크하고 있습니다...

결과

| | 빌드 로그가 "file://d:\작업공간\Denver\CCP\CCP_1.0.0.0\MVC100 (ARMV4I)\Release\BuildLog.htm"에 저장되었습니다. CCP - 오류: 0개, 경고: 0개
