JDSCS-Club/DENVER_CCP/DOC/11_SW코드/아이텍_GPIO/release_우진산전_l0215/bkk0105_gpiotest_timerfunction_tested/gpiotest/mvc100 (armv4i)/Debug/BuildLog.htm

Build Log

| | Rebuild started: Project: gpiotest, Configuration: Debug|MVC100 (ARMV4I)

Command Lines

Creating temporary file "e:\VS2005\Projects\gpiotest\gpiotest\MVC100 (ARMV4I)\Debug\RSP00000D36163120.rsp" with contents
[
/Od /Os /D "_DEBUG" /D "_WIN32_WCE=0x600" /D "UNDER_CE" /D "WINCE" /D "DEBUG" /D "ARM" /D "_ARM_" /D "STANDARDSHELL_UI_MODEL" /D "_UNICODE" /D "UNICODE" /Gm /EHsc /MTd /fp:fast /GR- /Yu"stdafx.h" /Fp"MVC100 (ARMV4I)\Debug/gpiotest.pch" /Fo"MVC100 (ARMV4I)\Debug/" /Fd"MVC100 (ARMV4I)\Debug/vc80.pdb" /W3 /c /Zi /TP

.\gpiotestDlg.cpp

.\gpiotest.cpp
]
Creating command line "cl.exe @"e:\VS2005\Projects\gpiotest\gpiotest\MVC100 (ARMV4I)\Debug\RSP00000D36163120.rsp" /nologo"
Creating temporary file "e:\VS2005\Projects\gpiotest\gpiotest\MVC100 (ARMV4I)\Debug\RSP00000E36163120.rsp" with contents
[
/Od /Os /D "_DEBUG" /D "_WIN32_WCE=0x600" /D "UNDER_CE" /D "WINCE" /D "DEBUG" /D "ARM" /D "_ARM_" /D "STANDARDSHELL_UI_MODEL" /D "_UNICODE" /D "UNICODE" /Gm /EHsc /MTd /fp:fast /GR- /Yc"stdafx.h" /Fp"MVC100 (ARMV4I)\Debug/gpiotest.pch" /Fo"MVC100 (ARMV4I)\Debug/" /Fd"MVC100 (ARMV4I)\Debug/vc80.pdb" /W3 /c /Zi /TP

.\stdafx.cpp
]
Creating command line "cl.exe @"e:\VS2005\Projects\gpiotest\gpiotest\MVC100 (ARMV4I)\Debug\RSP00000E36163120.rsp" /nologo"
Creating command line "rc.exe /d "_DEBUG" /d "_WIN32_WCE=0x600" /d "UNDER_CE" /d "_UNICODE" /d "UNICODE" /l 0x409 /I "MVC100 (ARMV4I)\Debug" /fo"MVC100 (ARMV4I)\Debug/gpiotest.res" .\gpiotest.rc"
Creating temporary file "e:\VS2005\Projects\gpiotest\gpiotest\MVC100 (ARMV4I)\Debug\RSP00000F36163120.rsp" with contents
[
/OUT:"MVC100 (ARMV4I)\Debug\gpiotest.exe" /INCREMENTAL /MANIFEST:NO /NODEFAULTLIB:"oldnames.lib" /DEBUG /PDB:"e:\VS2005\Projects\gpiotest\gpiotest\MVC100 (ARMV4I)\Debug\gpiotest.pdb" /STACK:65536,4096 /ENTRY:"WinMainCRTStartup" /subsystem:windowsce,6.00 ole32.lib oleaut32.lib uuid.lib

".\MVC100 (ARMV4I)\Debug\gpiotest.obj"

".\MVC100 (ARMV4I)\Debug\gpiotestDlg.obj"

".\MVC100 (ARMV4I)\Debug\stdafx.obj"

".\MVC100 (ARMV4I)\Debug\gpiotest.res"
]
Creating command line "link.exe @"e:\VS2005\Projects\gpiotest\gpiotest\MVC100 (ARMV4I)\Debug\RSP00000F36163120.rsp" /NOLOGO /ERRORREPORT:PROMPT"

Output Window

Compiling...
stdafx.cpp
D:\Microsoft Visual Studio 5\VC\ce\atlmfc\include\atlosapice.h(879) : warning C4996: 'wcsncpy' was declared deprecated
c:\program files\windows ce tools\wce600\mvc100\include\armv4i\stdlib.h(177) : see declaration of 'wcsncpy'
Message: 'This function or variable may be unsafe. Consider using wcsncpy_s instead. To disable deprecation, use _CRT_SECURE_NO_DEPRECATE. See online help for details.'
D:\Microsoft Visual Studio 5\VC\ce\atlmfc\include\atlosapice.h(893) : warning C4996: '_vsnwprintf' was declared deprecated
c:\program files\windows ce tools\wce600\mvc100\include\armv4i\stdlib.h(382) : see declaration of '_vsnwprintf'
Message: 'This function or variable may be unsafe. Consider using _vsnwprintf_s instead. To disable deprecation, use _CRT_SECURE_NO_DEPRECATE. See online help for details.'
D:\Microsoft Visual Studio 5\VC\ce\atlmfc\include\atlosapice.h(910) : warning C4996: '_vsnprintf' was declared deprecated
c:\program files\windows ce tools\wce600\mvc100\include\armv4i\stdlib.h(377) : see declaration of '_vsnprintf'
Message: 'This function or variable may be unsafe. Consider using _vsnprintf_s instead. To disable deprecation, use _CRT_SECURE_NO_DEPRECATE. See online help for details.'
D:\Microsoft Visual Studio 5\VC\ce\atlmfc\include\atlosapice.h(1075) : warning C4996: 'wcsncpy' was declared deprecated
c:\program files\windows ce tools\wce600\mvc100\include\armv4i\stdlib.h(177) : see declaration of 'wcsncpy'
Message: 'This function or variable may be unsafe. Consider using wcsncpy_s instead. To disable deprecation, use _CRT_SECURE_NO_DEPRECATE. See online help for details.'
D:\Microsoft Visual Studio 5\VC\ce\atlmfc\include\atlosapice.h(1123) : warning C4996: 'wcsncpy' was declared deprecated
c:\program files\windows ce tools\wce600\mvc100\include\armv4i\stdlib.h(177) : see declaration of 'wcsncpy'
Message: 'This function or variable may be unsafe. Consider using wcsncpy_s instead. To disable deprecation, use _CRT_SECURE_NO_DEPRECATE. See online help for details.'
D:\Microsoft Visual Studio 5\VC\ce\atlmfc\include\atlchecked.h(157) : warning C4996: '_strlwr' was declared deprecated
C:\Program Files\Windows CE Tools\wce600\MVC100\include\ARMV4I\stdlib.h(240) : see declaration of '_strlwr'
Message: 'This function or variable may be unsafe. Consider using _strlwr_s instead. To disable deprecation, use _CRT_SECURE_NO_DEPRECATE. See online help for details.'
D:\Microsoft Visual Studio 5\VC\ce\atlmfc\include\atlchecked.h(167) : warning C4996: '_wcslwr' was declared deprecated
C:\Program Files\Windows CE Tools\wce600\MVC100\include\ARMV4I\stdlib.h(189) : see declaration of '_wcslwr'
Message: 'This function or variable may be unsafe. Consider using _wcslwr_s instead. To disable deprecation, use _CRT_SECURE_NO_DEPRECATE. See online help for details.'
D:\Microsoft Visual Studio 5\VC\ce\atlmfc\include\atlchecked.h(192) : warning C4996: '_wcslwr' was declared deprecated
C:\Program Files\Windows CE Tools\wce600\MVC100\include\ARMV4I\stdlib.h(189) : see declaration of '_wcslwr'
Message: 'This function or variable may be unsafe. Consider using _wcslwr_s instead. To disable deprecation, use _CRT_SECURE_NO_DEPRECATE. See online help for details.'
D:\Microsoft Visual Studio 5\VC\ce\atlmfc\include\atlchecked.h(209) : warning C4996: '_wcsupr' was declared deprecated
C:\Program Files\Windows CE Tools\wce600\MVC100\include\ARMV4I\stdlib.h(190) : see declaration of '_wcsupr'
Message: 'This function or variable may be unsafe. Consider using _wcsupr_s instead. To disable deprecation, use _CRT_SECURE_NO_DEPRECATE. See online help for details.'
D:\Microsoft Visual Studio 5\VC\ce\atlmfc\include\atlchecked.h(226) : warning C4996: '_wcsupr' was declared deprecated
C:\Program Files\Windows CE Tools\wce600\MVC100\include\ARMV4I\stdlib.h(190) : see declaration of '_wcsupr'
Message: 'This function or variable may be unsafe. Consider using _wcsupr_s instead. To disable deprecation, use _CRT_SECURE_NO_DEPRECATE. See online help for details.'
D:\Microsoft Visual Studio 5\VC\ce\atlmfc\include\atlchecked.h(291) : warning C4996: '_gcvt' was declared deprecated
C:\Program Files\Windows CE Tools\wce600\MVC100\include\ARMV4I\stdlib.h(529) : see declaration of '_gcvt'
Message: 'This function or variable may be unsafe. Consider using _gcvt_s instead. To disable deprecation, use _CRT_SECURE_NO_DEPRECATE. See online help for details.'
Compiling...
gpiotest.cpp
gpiotestDlg.cpp
Generating Code...
Compiling resources...
Linking...

Results

| | Build log was saved at "file://e:\VS2005\Projects\gpiotest\gpiotest\MVC100 (ARMV4I)\Debug\BuildLog.htm" gpiotest - 0 error(s), 11 warning(s)
