JDSCS-Club/DENVER_CCP/DOC/04_SW_문서/SW_버전_릴리즈/Denver_Software Version  Revision History_20160920_CommUpdate_Rev.0.pdf

Date: 30-Aug-2016

## Software Version Summary Sheet for Denver Project

Sub-System | Software Configuration Item | Software Version No. | Release Date (DD-MM-YYYY) | Method to identify software version number | Executable File | Status / Remark
MDS Display | PTU | Revision Tag (on PCB board or name | Segment (e.g. LED Display)
K D LVPS&BC | MC_CCU_LVPS | MC_2000_135_V31_35_04_0012 | 30-03-2015 | | O | | | O
| MS_CCU_LVPS | MS_2000_135_V31_35_03_0010 | 26-08-2013 | | O | | | O
| DSP_CCU_LVPS | DSP_2000_135_V31_35_01_0004 | 09-10-2012 | | O | | | O
| PLD_CCU_LVPS | PLD_2000_135_V08_04_005 | 09-10-2012 | | O | | | O
| MC_QC_INV | MC_2000_136_V31_36_01_0002 | 09-10-2012 | | O | | | O
| MS_QC_INV | MS_2000_136_V31_36_01_0003 | 09-10-2012 | | O | | | O
| DSP_QC_INV | DSP_2000_136_V31_36_01_0001 | 09-10-2012 | | O | | | O
| PLD_QC_INV | PLD_2000_136_V03_01_009 | 09-10-2012 | | O | | | O
W C Brake | FBCU Application Software | 1.01 | 19-08-2015 | | | | | X | Test Release
| Boot Loader (MCM5 Boot Software) | 01.02 | 04-04-2012 | | O | | | O
| NURN FBCU (FBCU Neuron MDS Application) | 01.03 | 16-04-2014 | | O | | | O
| NURN PRP (FBCU Neuron Prop Application) | 02.05 | 22-04-2010 | | O | | | O
| WAB-LINK Interface Software | V1.7 | 27-05-2009 | | | | | X
| WAB-LINK Interface Database | V1.02 | 19-08-2015 | | | | | X
I B CCTV | DVR-4600 | 1.12 | 15-07-2014 | O | | | | O | X.YZ: Y=Application Software Version; Z=Lonworks Board Firmware
| ICAM | 20120917 | 17-09-2012 | O | | | | X
| OCAM | 20120815 | 15-08-2012 | O | | | | X
| FCAM | 20120815 | 15-08-2012 | O | | | | X
| CCAM | 20120917 | 17-09-2012 | O | | | | X
W J Door | Portable Test Unit Application | 1.1.0 | 22-03-2013 | | O | | | O
| Door Control Unit Application | 1.01 | 09-10-2013 | O | O | | | O
| Boot Loader Application | 1.00 | 08-11-2012 | O | O | | | O
| Neuron Gateway Application | 1.08 | 05-02-2013 | O | O | | | O
M K Propulsion | SYS | 6BAD2206 | 31-05-2013 | O | O | | | X
| IVF | 81475174 | 13-07-2012 | O | O | | | X
| CVF | 280B45DE | 09-07-2012 | O | O | | | X
| LON | 00000003 | 13-05-2013 | O | O | | | X
| SYS26 | 000007B2 | 24-11-2011 | O | O | | | X
W HVAC C | TCU | 1.4 | 22-05-2014 | | O | | | O | Parameter 1.8
| PTU | 1.1.1 | 17-07-2014
W s Event Recorder | 54003 AM SCI (Analog 1 SCI) | 1.60 | 18-12-2012 | | O | | | X
| 54710-04 FIDS SCI (FCM SCI) | 1.10 | 18-12-2012 | | O | | | X
| 55100 PM SCI (Processor Modu | 1.04 | 18-03-2014 | | O | | | X
| 52789 PTU SCI | 1.48 | 01-04-2014 | | O | | | O
| PTC Recorder SCI | 2.0.0.2 | 31-01-2014 | | O | | | X
| DAS II PTU SCI | 1.3.28.1 | 25-06-2015 | | O | | | O
W J ( Comunicatio n | CCP | 1.0.04 | 23-08-2016 | O | | | | O
| VTX | 1.0.01 | 20-10-2015 | O | | | | X
| CRA-Main | 1.0.06 | 30-08-2016 | O | | | | O
| CRA-LAUN | 1.0.01 | 30-10-2015 | O | | | | O
| CRA-UP | 1.0.01 | 30-10-2015 | O | | | | O
| CRA-PP | 1.0.01 | 30-10-2015 | O | | | | O
| CRA-SP | 1.0.01 | 30-10-2015 | O | | | | O
| CRA-FTP | 1.0.03 | 30-08-2016 | O | | | | O
| CRA-CDT | 1.0.03 | 30-08-2016 | O | | | | O
| CRA-LICL | 1.1.02 | 09-05-2013 | O | | | | X
| CRA-LICM | 1.1.00 | 02-11-2015 | O | | | | X
| CRA-VOIP | 1.0.03 | 26-04-2016 | O | | | | X
| CRA-PAC | 1.0.04 | 09-20-2016 | O | | | | X
| FDI1 | 1.0.01 | 20-10-2015 | O | | | | X
| SDI1 | 1.0.01 | 20-10-2015 | O | | | | X
| SDI2 | 1.0.01 | 20-10-2015 | O | | | | X
| SDI3 | 1.0.01 | 20-10-2015 | O | | | | X
| SDI4 | 1.0.01 | 20-10-2015 | O | | | | X
| PII1 | 1.0.01 | 20-10-2015 | O | | | | X
| PII2 | 1.0.01 | 20-10-2015 | O | | | | X
| VRX1 | 1.0.01 | 20-10-2015 | O | | | | X
| VRX2 | 1.0.01 | 20-10-2015 | O | | | | X
| VRX3 | 1.0.01 | 20-10-2015 | O | | | | X
| VRX4 | 1.0.01 | 20-10-2015 | O | | | | X
| VRX5 | 1.0.01 | 20-10-2015 | O | | | | X
Q H ( MDS | CCP | R04 | 19-09-2014 | O | O | | | O
| CCP Boot | R01 | 19-08-2009 | O | O | | | O
| IOP1 | R00 | 11-01-2012 | O | O | | | O
| IOP1 Boot | R01 | 19-08-2009 | O | O | | | O
| IOP2 | R00 | 11-01-2012 | O | O | | | O
| IOP2 Boot | R01 | 19-08-2009 | O | O | | | O
x M ATC/PTC | (Nomad)
| Onboard WiMax Radio | Firmware 4.3.4624.34 | | | | | | O | No firmware update will be done until system commissioning
| CCU | Units being shipped without SW. Will be updated at a later date once communication design is completed (wayside & onboard).
| (ATC)
| A073G01-A58 ATC Main PCB IC1 Software | 2 | 31-12-2014 | | O | | | O
| I/O PCB IC1 Software A073G01-A59 | 3 | 31-12-2014 | | O | | | O
| Cab Test PCB IC1 Software A073G01-A60 | 0 | 09-04-2013 | | O | | | O
| ATC Decoder PCB IC1 Software A073G01-A61 | 1 | 31-12-2014 | | O | | | O
| (PTC)
| I-ETMS | 6.3.8.22 | 05-08-2014 | | | | CDU | O
I h s a l c e d APC o ( l u c e r o ) | COPILOTpc | 4.81 | 16-06-2013 | | TOUCHit Device | | | O
| Analyzer | SDIST4_AA21C8_CI-5.97_IZZZZ- 07_PV-6.03-10.HEX | 06-03-2010 | | O | | | O
