JDSCS-Club/DENVER_CCP/DOC/04_SW_문서/CMMI/Appendix II_Risk Matrix.xls

Sheet: Risk Matrix
Hazard Probability
Hazard Probability Description | Hazard Probability Category | Definition
FREQUENT | 1 | More than 2 per year or 2.5 x 106 fleet vehicle miles
PROBABLE | 2 | Less than 2 per year or 2.5 x 106 vehicle miles greater or equal to once / 5 years / 2.5 x 107 fleet vehicle miles
OCCASIONAL | 3 | Less than once / 5 years / 2.5 x 107 fleet vehicle miles greater or equal to once / 50 years / 2.5 x 108 fleet vehicle miles
REMOTE | 4 | Less than once per 50 years / 2.5 x 108 fleet vehicle miles greater or equal to once / 1000 years / 2.5 x 109 fleet vehicle miles
IMPROBABLE | 5 | Less than once per 1000 years / 2.5 x 109 fleet vehicle miles
Hazard Severity
Hazard Severity Description | Hazard Severity Category | Definition
CATASTROPHIC | I | Multiple fatalities, high speed collision, major environmental damage, loss of more than one car
CRITICAL | II | Severe injury, collision under 15 mph, loss of one car or significant damage to two cars.
MARGINAL | III | Minor injury, minor damage (under $100,000 per car) to one or two cars, major operational disruption.
NEGLIGABLE | IV | No lost time injuries, very minor damage (under $10,000 per car) to one or two cars, minor to moderate operational disruption.
Hazard Risk Assessment Matrix
Hazard Risk Index (HRI)
 | HRI | HRI Description
 | Un | Not acceptable.
 | Ud | Undesirable – Redesign must be attempted and detailed analysis performed – may be approved if no practical alternative.
 | Ar | Acceptable with approval – Redesign may be required at RTD’s option.
 | Ac | Acceptable, no approval required

Sheet: Sheet2
 |  | HAZARD SEVERITY
HAZARD FREQUENCY |  | CATASTROPHIC | CRITICAL | MARGINAL | NEGLIGABLE
 |  | I | II | III | IV
FREQUENT | 1 | Un | Un | Ud | Ar
PROBABLE | 2 | Un | Un | Ud | Ar
OCCASIONAL | 3 | Un | Ud | Ar | Ac
REMOTE | 4 | Ud | Ar | Ar | Ac
IMPROBABLE | 5 | Ar | Ar | Ar | Ac
