JDSCS-Club/DENVER_CCP/DOC/06_이슈_대응/CNCS_발열/02_FAN_설계도면/R1D014257 (WIRING DIAGRAM) 20170713.pdf

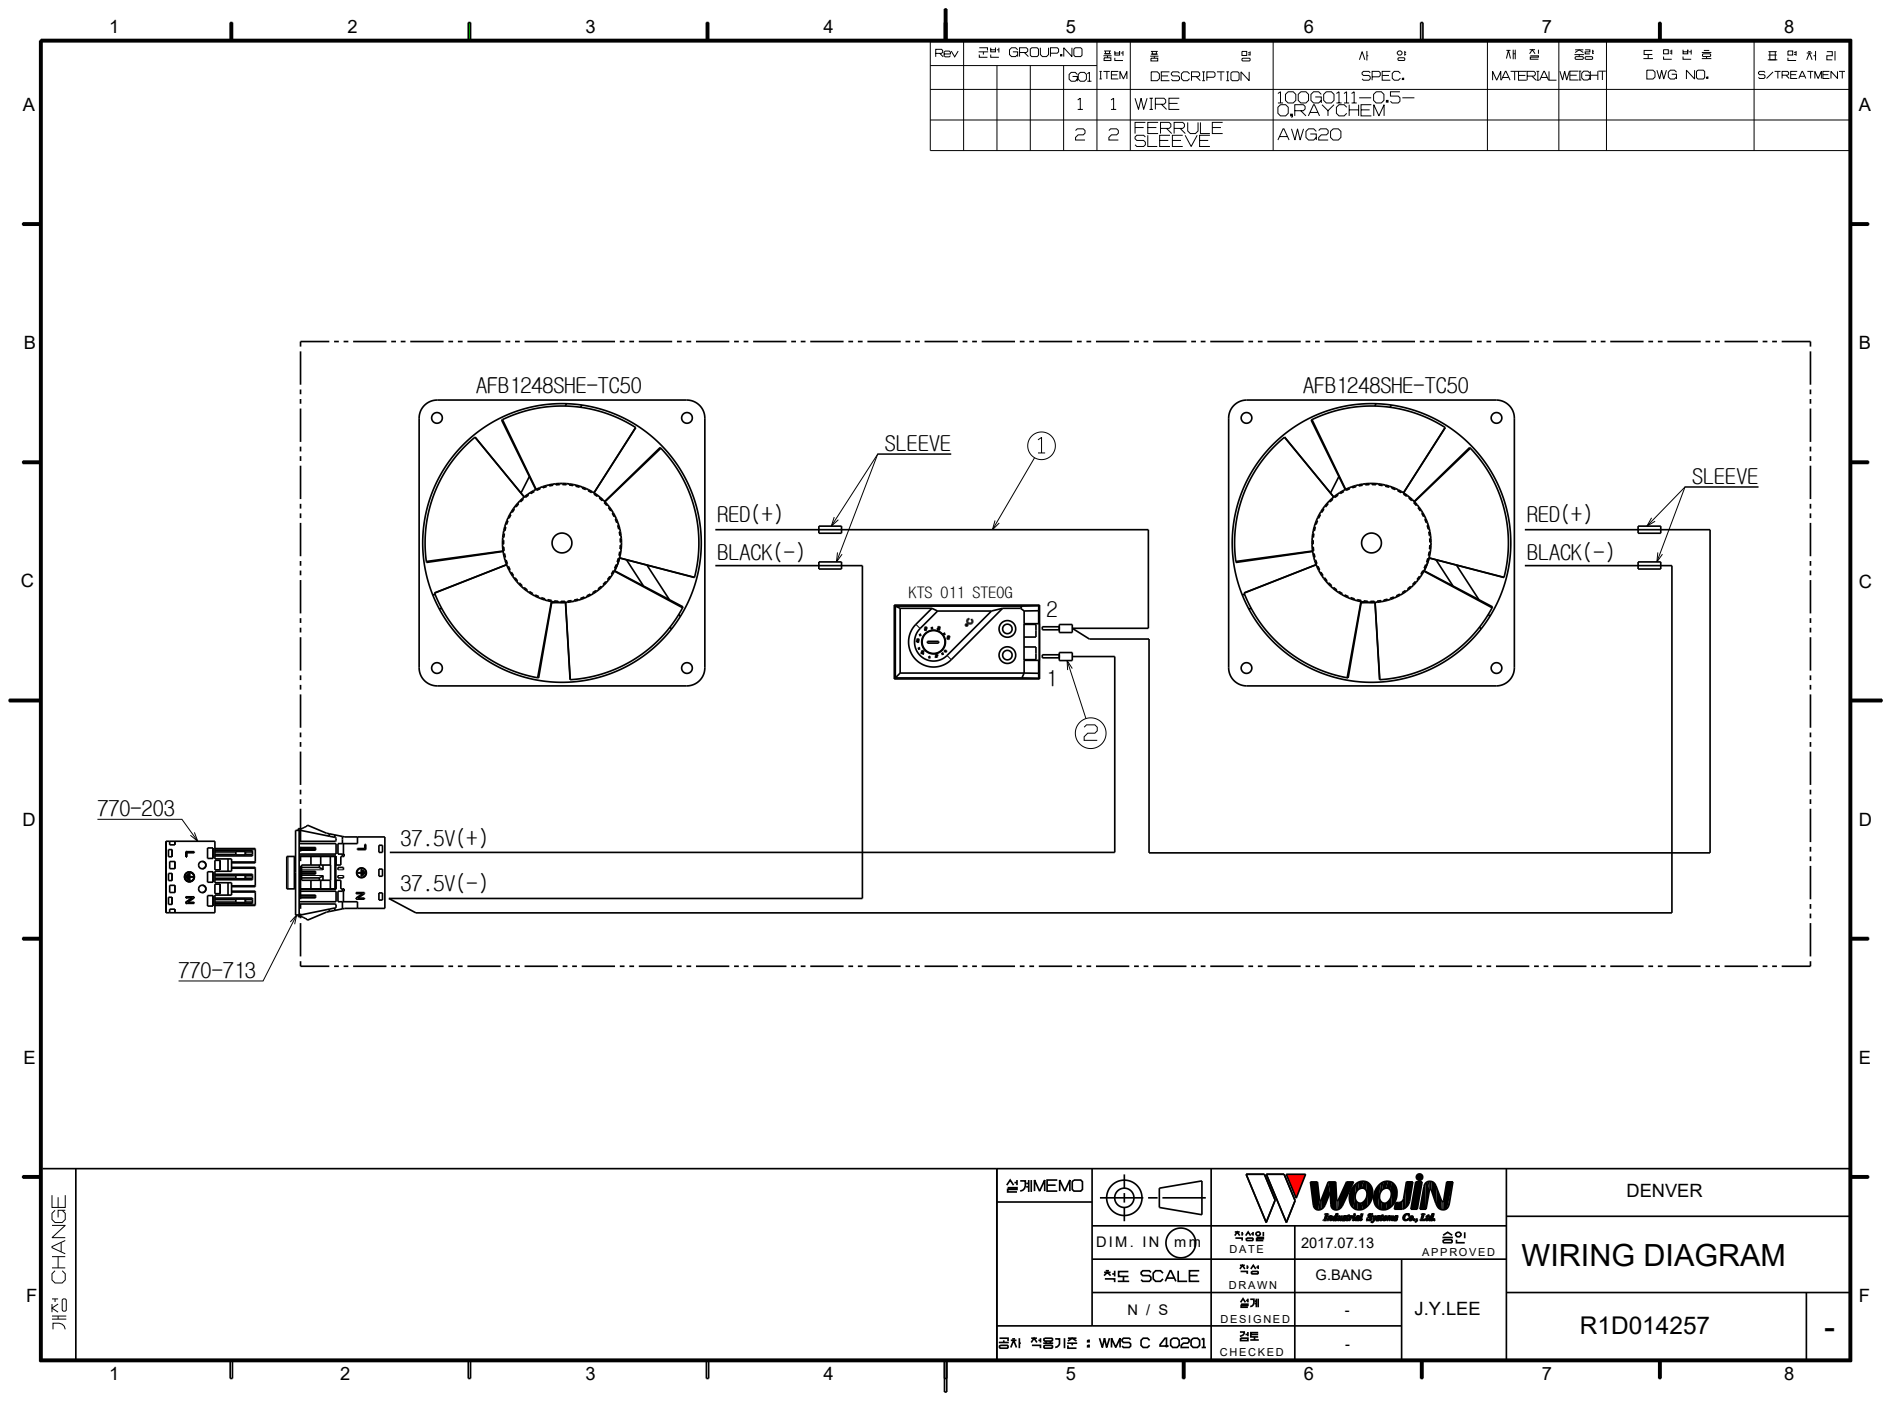
[picture p711: page 1]
WIRING DIAGRAM; KTS 011 STEOG

DIM. IN mm | DATE | 2017.07.13 APPROVED

DRAWN | G.BANG | J.Y.LEE

N / S | DESIGNED | - | R1D014257 | -

CHECKED | -
