JDSCS-Club/DENVER_CCP/DOC/01_인터페이스_설계/LON_Works/05_하드웨어_회로도/SCHEMATIC1 _ SENSOR_FINGUR_IO.pdf

## ATmega8 ISP Connector

## Cds

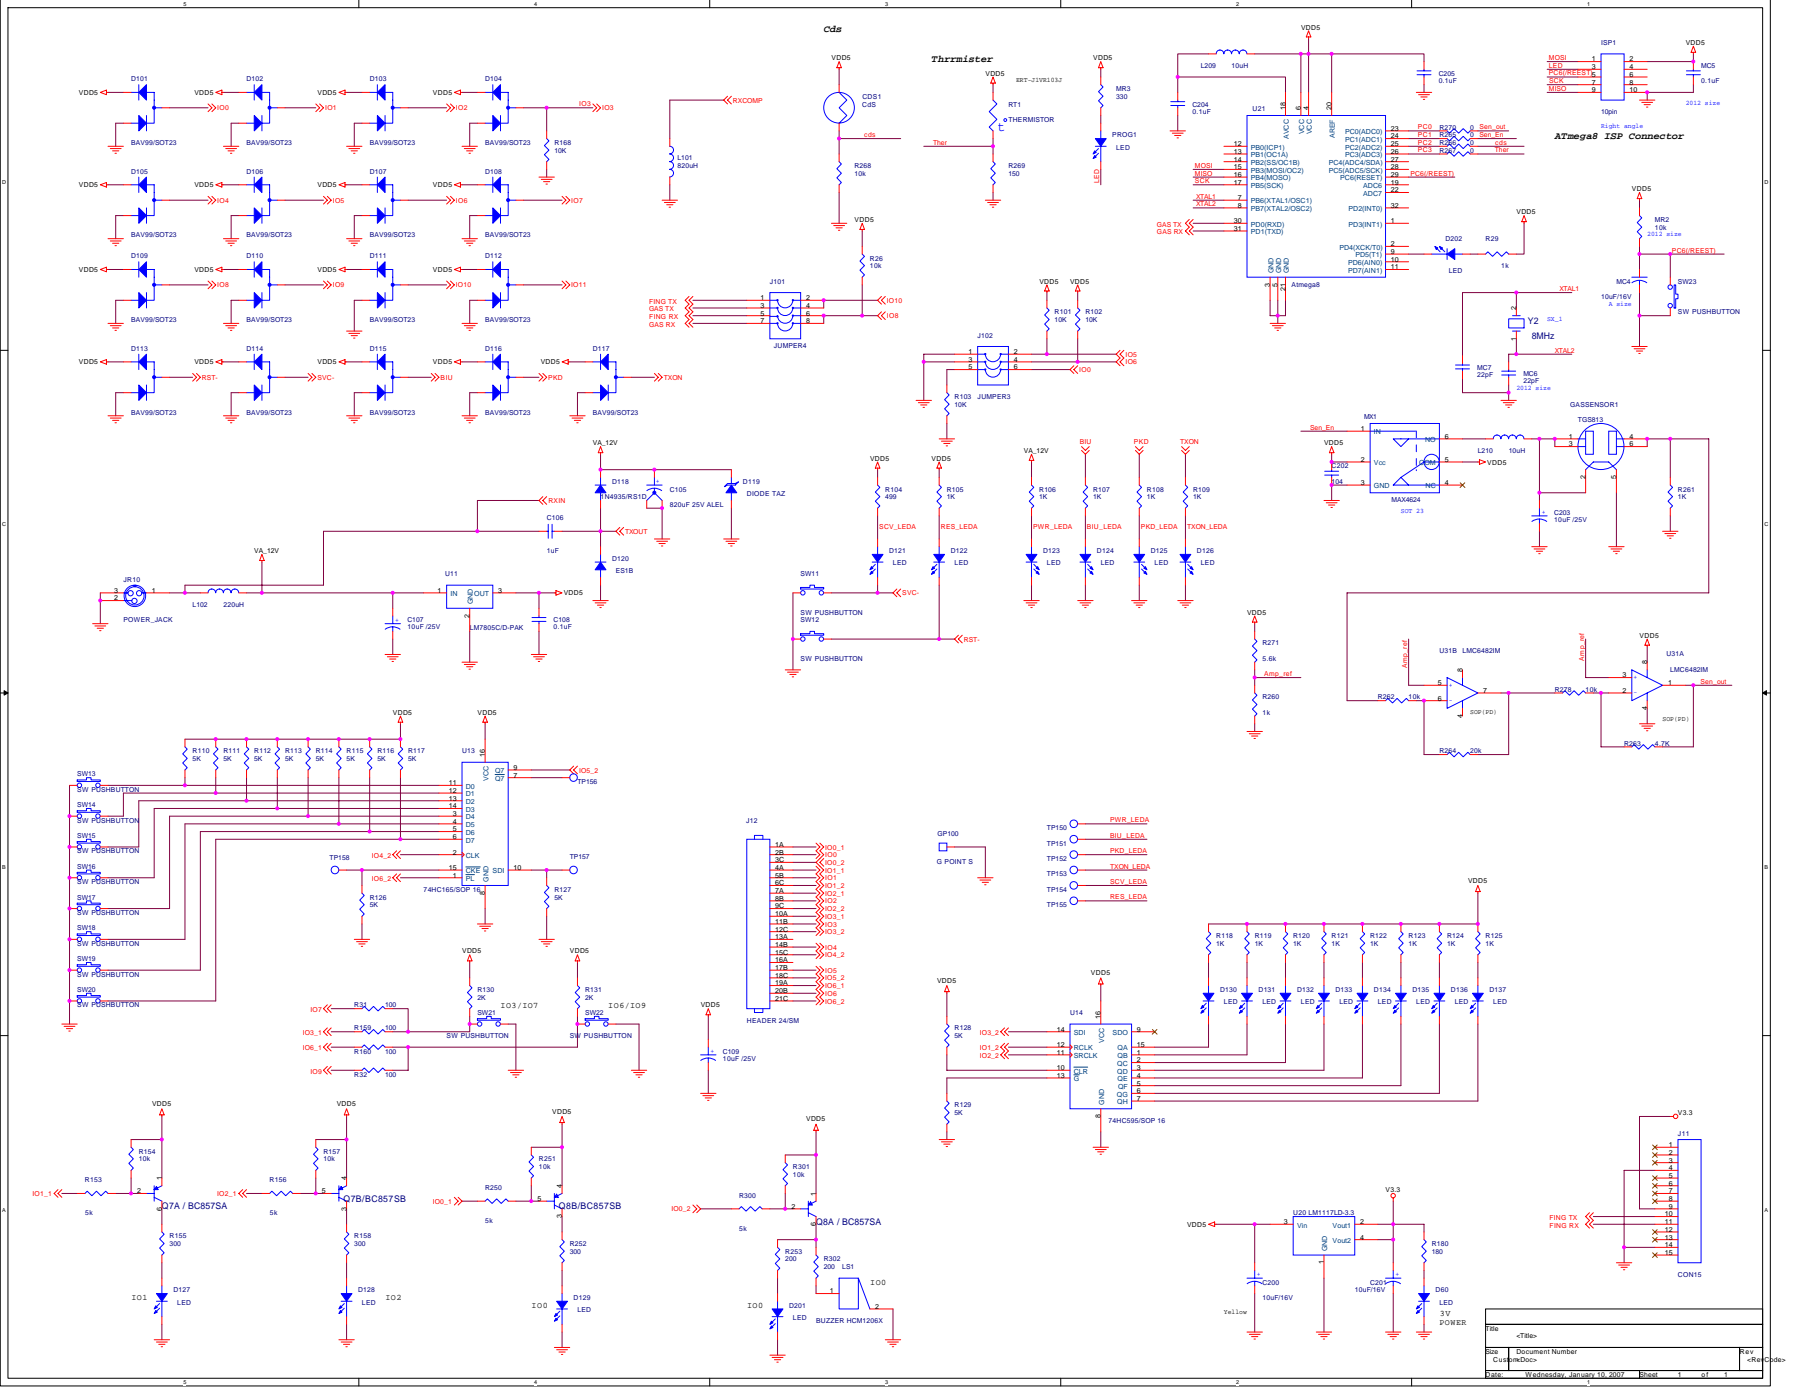
[picture p712: page 1]

D1 12
D2 13
D3 14
D4 3

D6 5 | BIU_LEDA
D7 6
