JDSCS-Club/DENVER_CCP/DOC/01_인터페이스_설계/MDS_ICD/04_MDS_회로도/99_DSC-0432-1500-R00_Fault_Trainline_Schematics.PDF

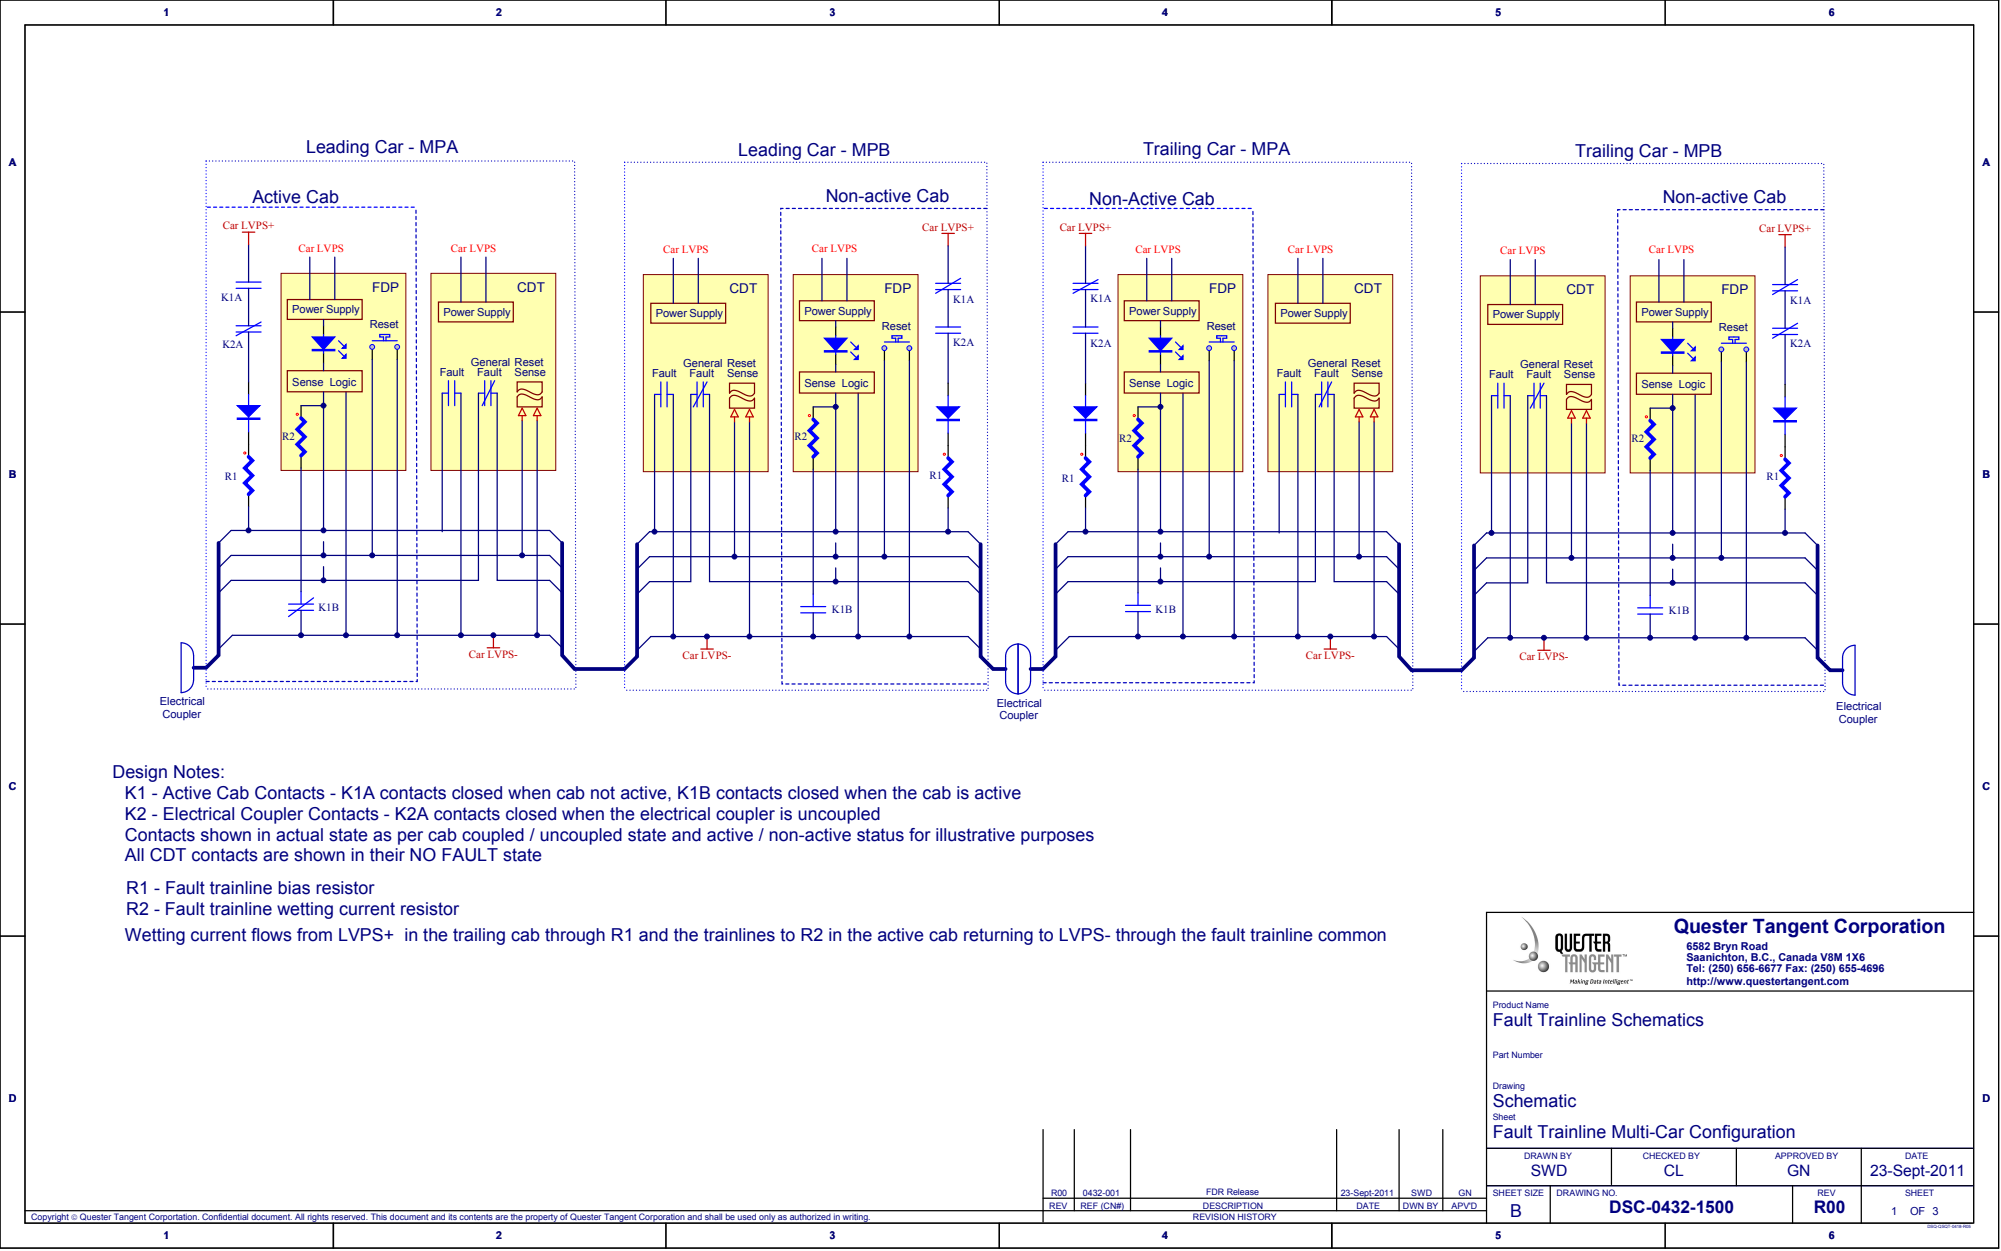
[picture p713: page 1]

Design Notes:
K1 - Active Cab Contacts - K1A contacts closed when cab not active, K1B contacts closed when the cab is active
K2 - Electrical Coupler Contacts - K2A contacts closed when the electrical coupler is uncoupled
Contacts shown in actual state as per cab coupled / uncoupled state and active / non-active status for illustrative purposes
All CDT contacts are shown in their NO FAULT state

R1 - Fault trainline bias resistor
R2 - Fault trainline wetting current resistor
Wetting current flows from LVPS+ in the trailing cab through R1 and the trainlines to R2 in the active cab returning to LVPS- through the fault trainline common

6582 Bryn Road
Saanichton, B.C., Canada V8M 1X6
Tel: (250) 656-6677 Fax: (250) 655-4696
http://www.questertangent.com

Drawing
Schematic
Fault Trainline Multi-Car Configuration

DRAWN BY SWD | CHECKED BY CL | APPROVED BY GN | DATE 23-Sept-2011

SHEET SIZE B | DRAWING NO. DSC-0432-1500 | REV R00 | SHEET 1 OF 3

REV | REF (CN#) | DESCRIPTION | DATE | DWN BY | APV'D

Copyright Quester Tangent Corportation. Confidential document. All rights reserved. This document and its contents are the property of Quester Tangent Corporation and shall be used only as authorized in writing. | REVISION HISTORY

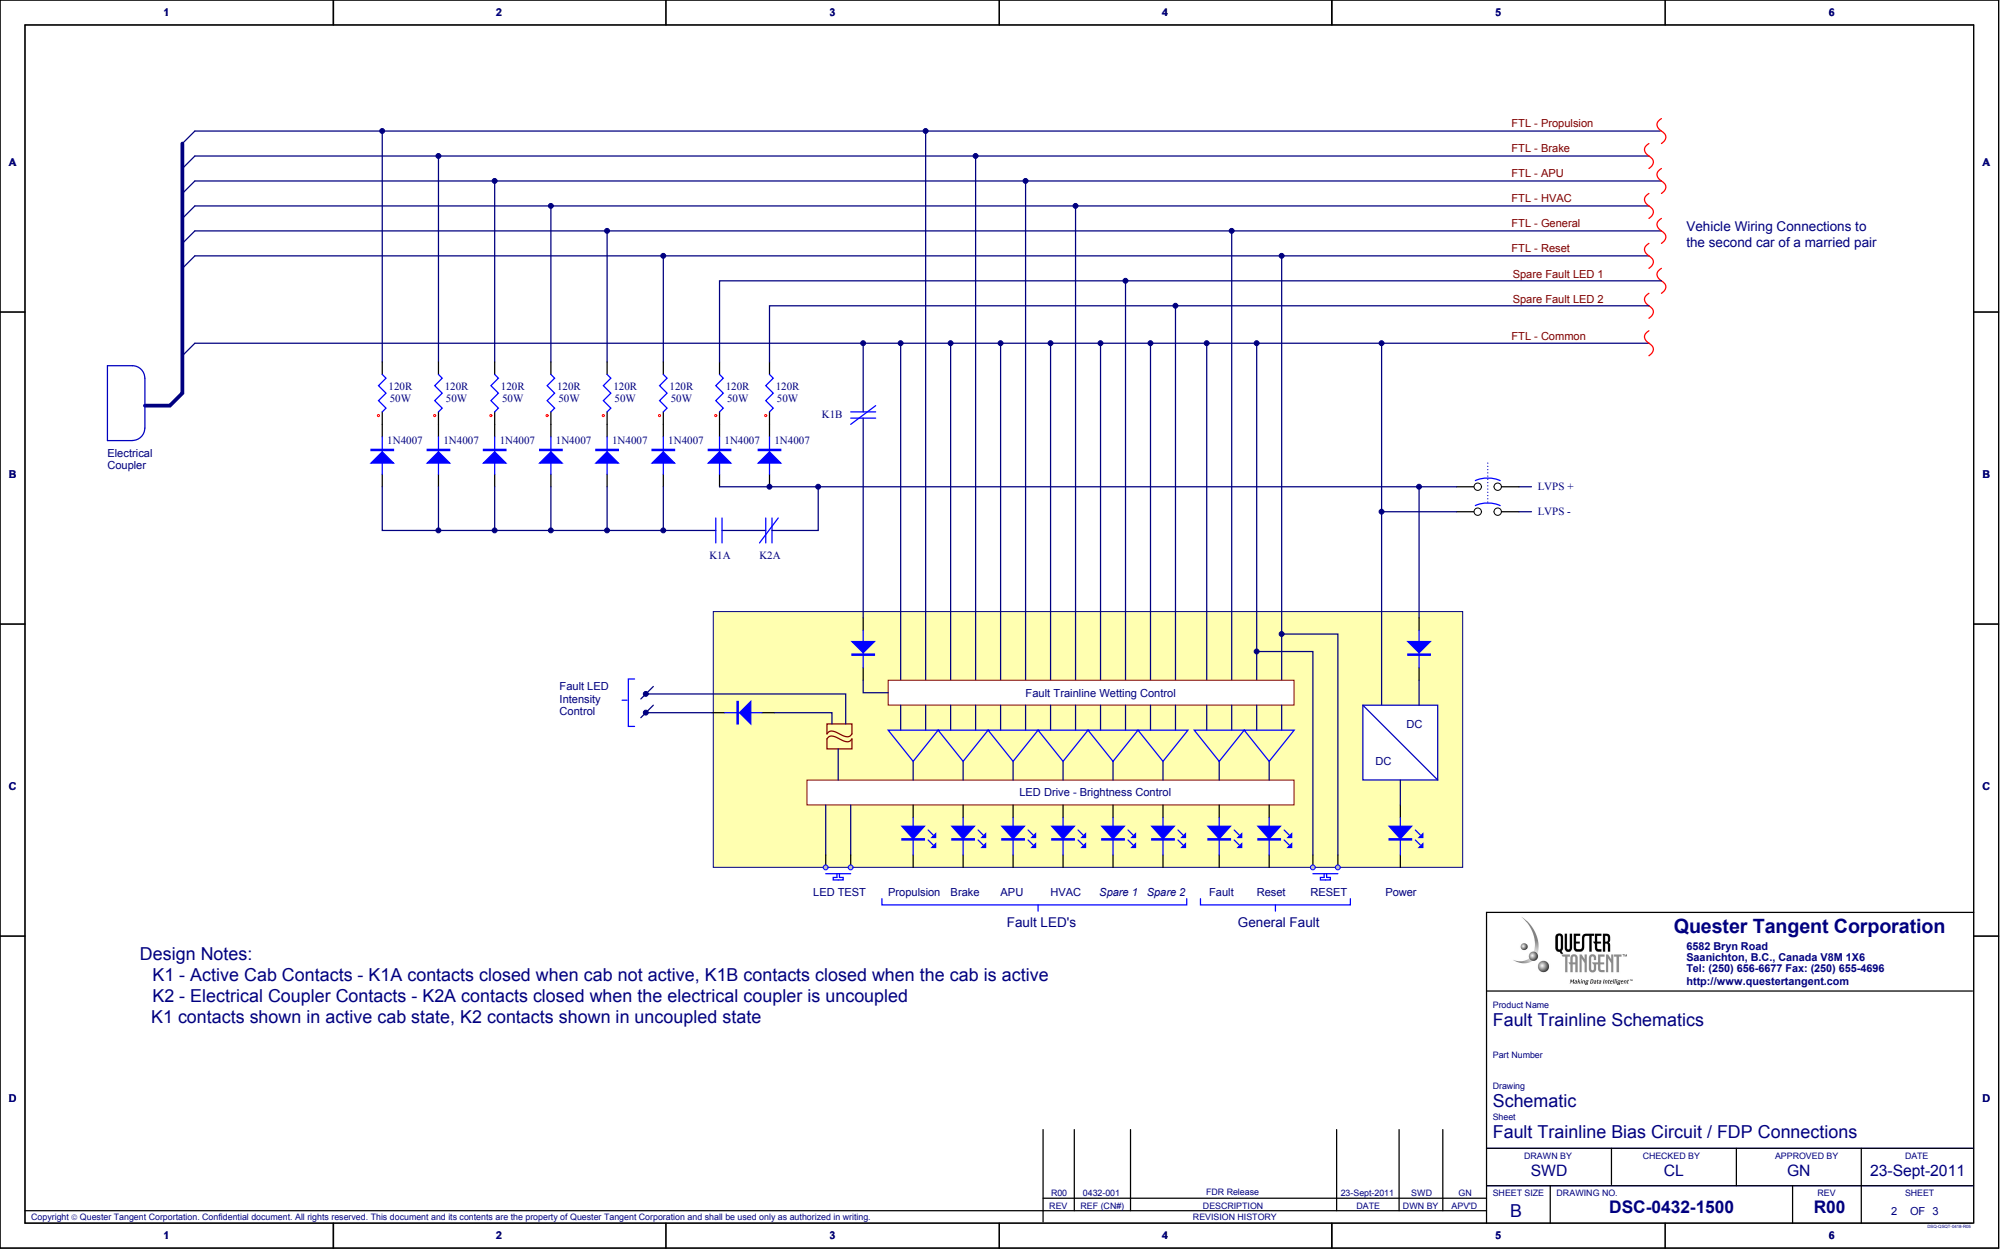
[picture p714: page 2]

FTL - Propulsion

Vehicle Wiring Connections to
the second car of a married pair

Spare Fault LED 2

FTL - Common

Fault Trainline Wetting Control

LED Drive - Brightness Control

Design Notes:
K1 - Active Cab Contacts - K1A contacts closed when cab not active, K1B contacts closed when the cab is active
K2 - Electrical Coupler Contacts - K2A contacts closed when the electrical coupler is uncoupled
K1 contacts shown in active cab state, K2 contacts shown in uncoupled state

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

Drawing
Schematic
Fault Trainline Bias Circuit / FDP Connections

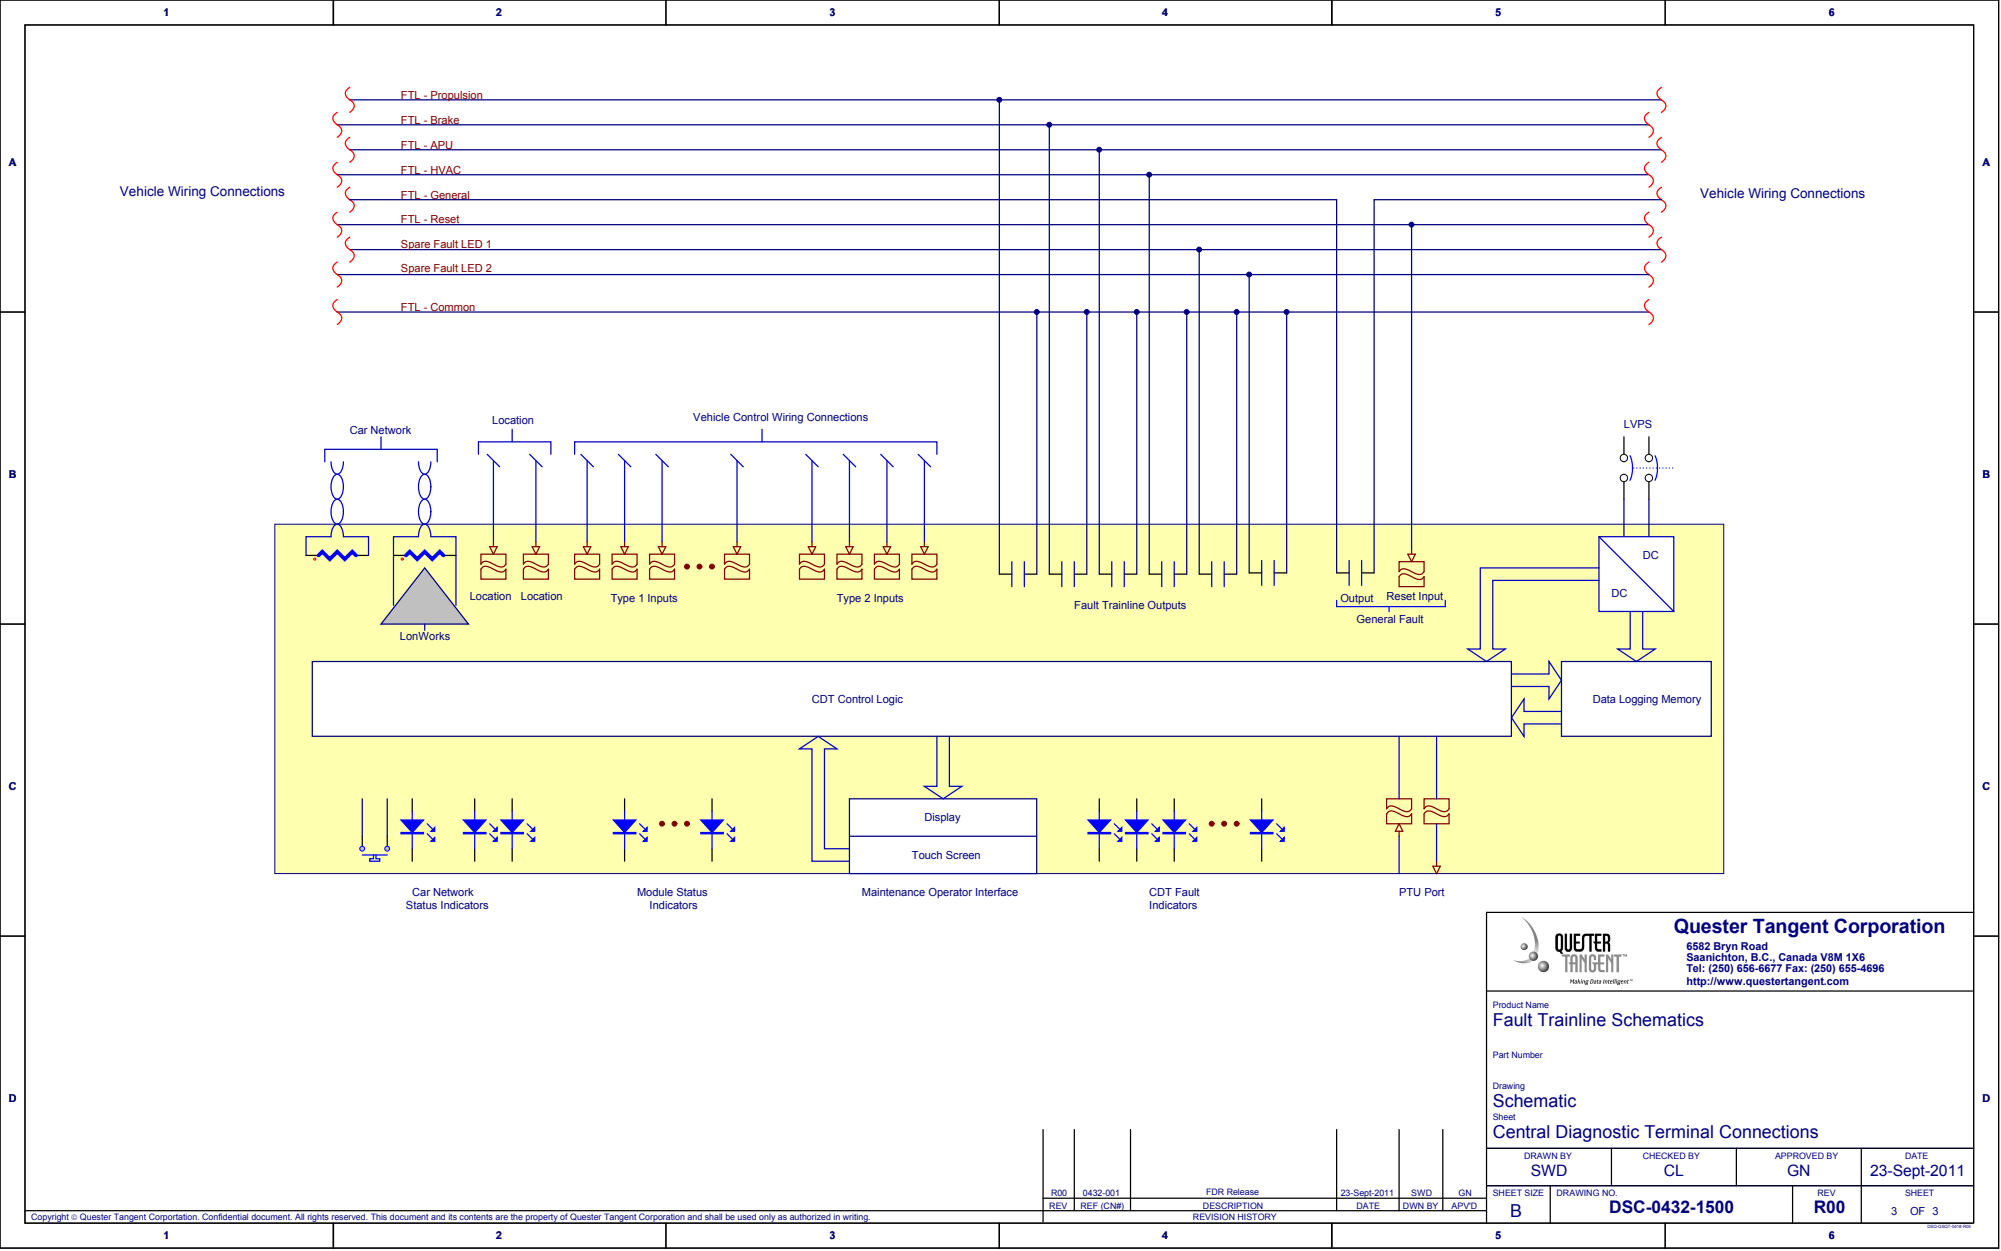
[picture p715: page 3]

FTL - Reset Spare Fault LED 1

Spare Fault LED 2 FTL - Common Vehicle Control Wiring Connections Location

LonWorks | DC

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

Drawing
Schematic
Central Diagnostic Terminal Connections
