JDSCS-Club/DENVER_CCP/DOC/02_설계_도면/승인도/R1D000447-PEI2Ab(PEI WIRING DIAGRAM)20130401.pdf

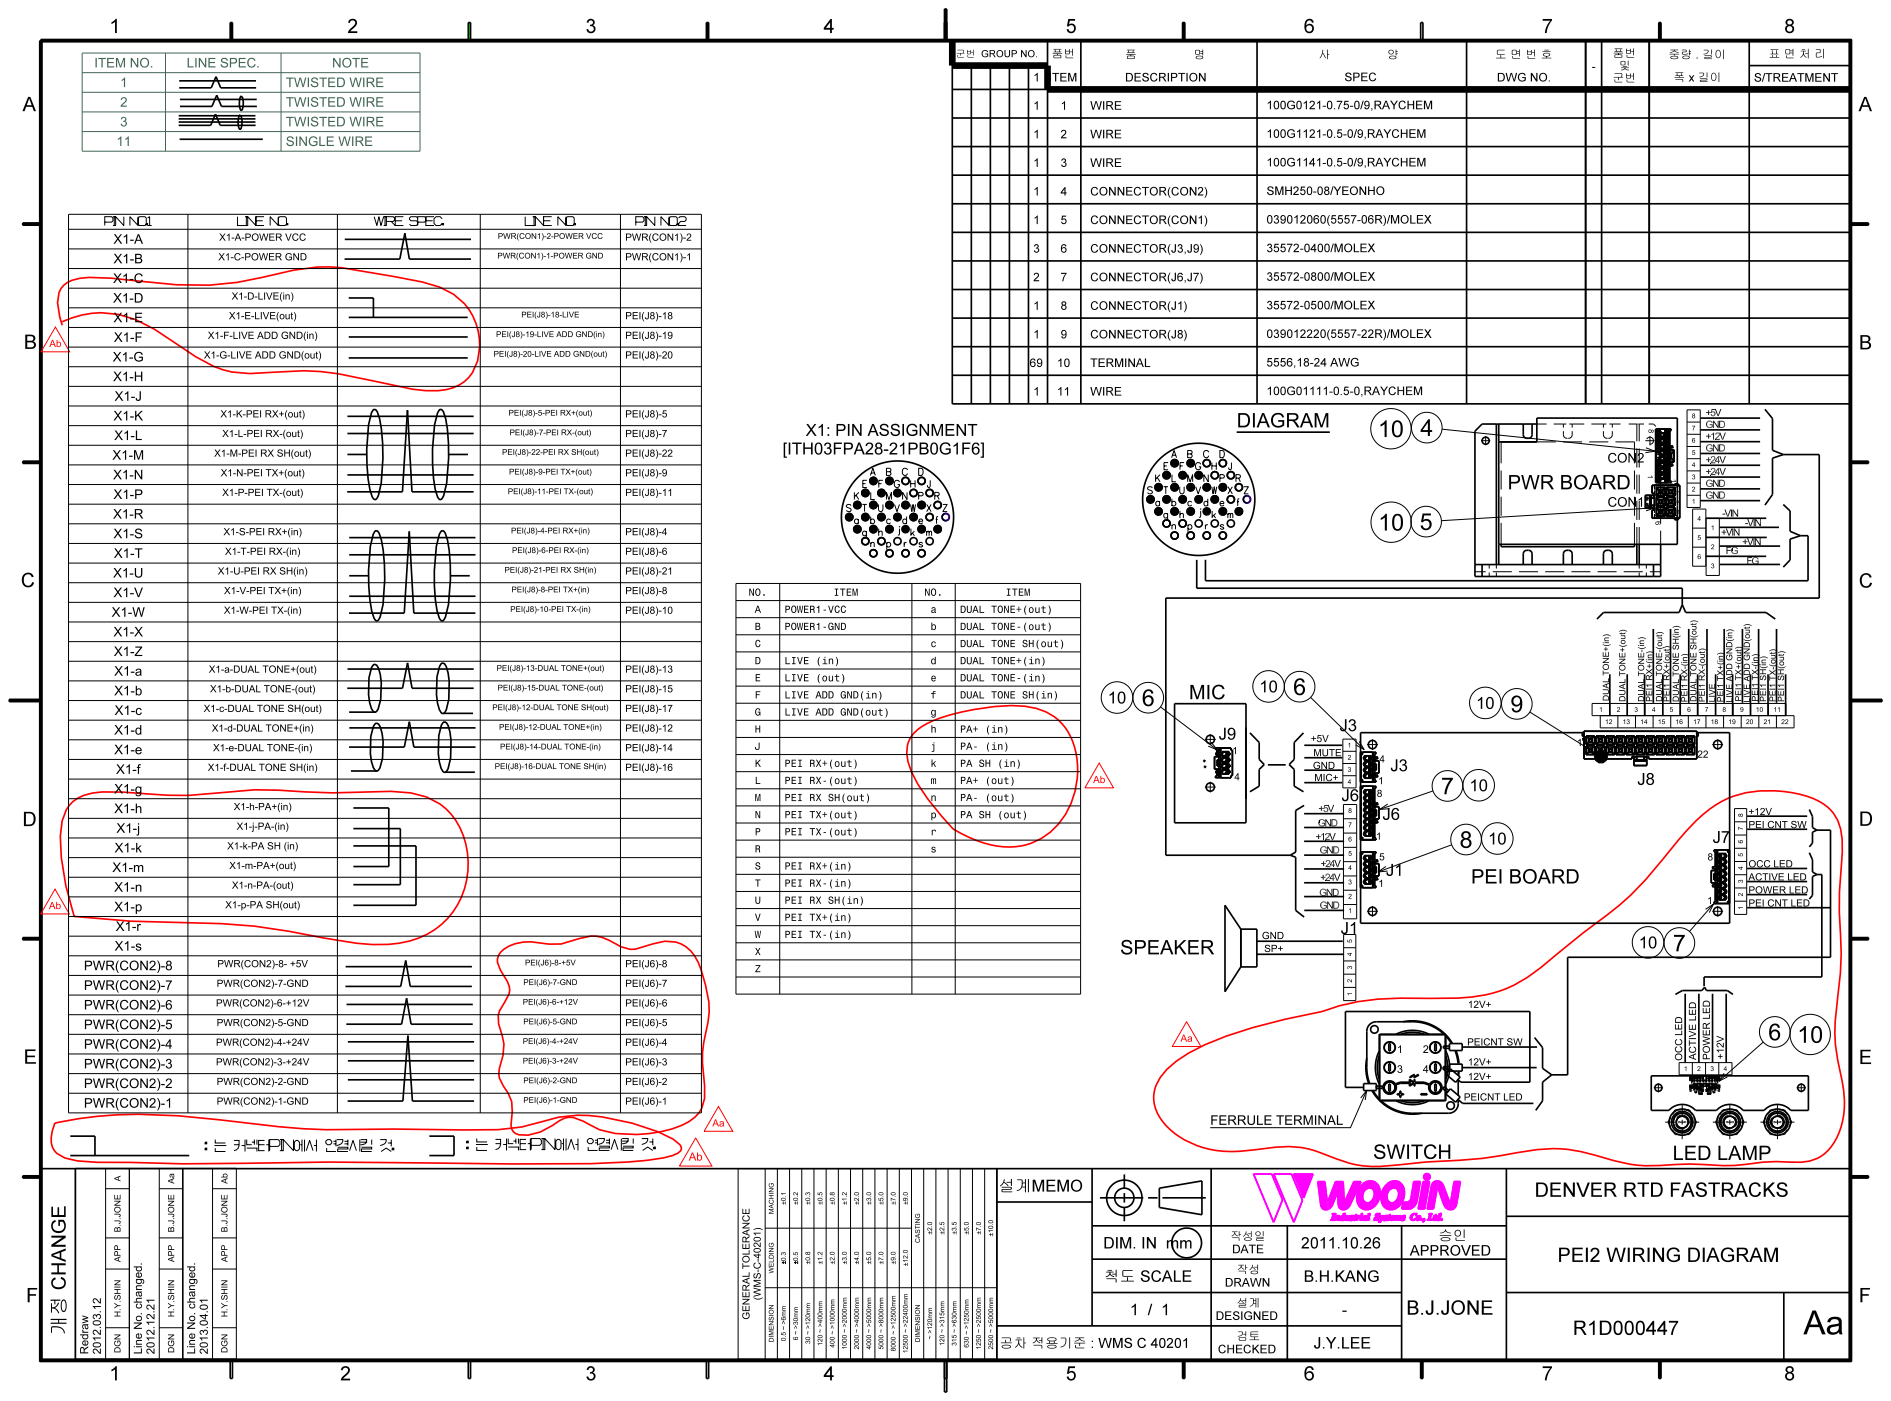
[picture p716: page 1]
