JDSCS-Club/DENVER_CCP/DOC/06_이슈_대응/기타_문서/05_ICD_기술문서/R1D000463-DPO-WIRING DIAGRAM-A3 20120817.pdf

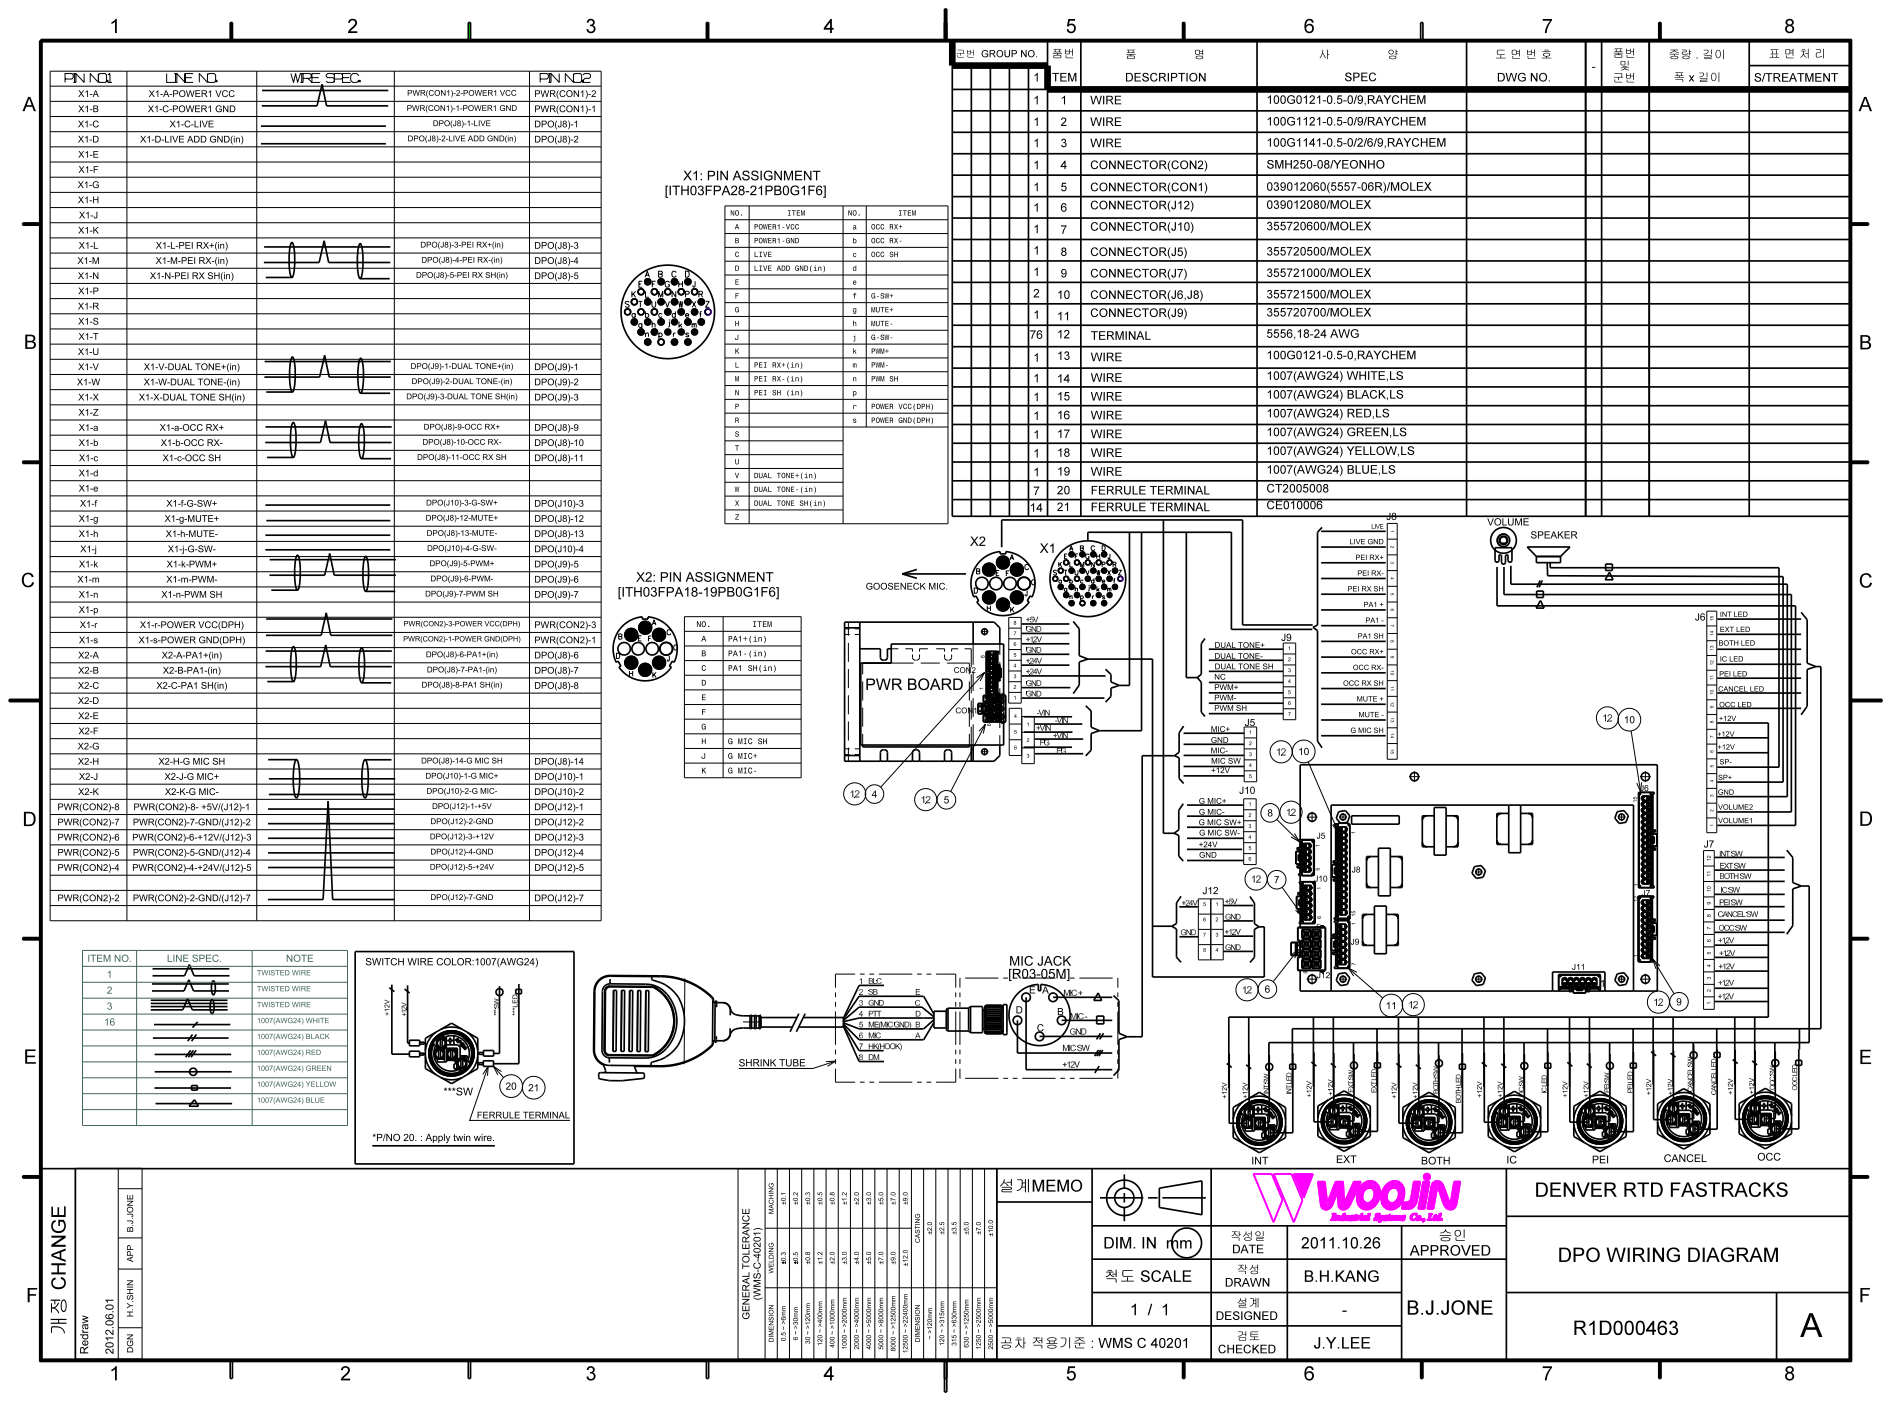
[picture p717: page 1]
