JDSCS-Club/DENVER_CCP/DOC/01_인터페이스_설계/LON_Works/05_하드웨어_회로도/SCHEMATIC1 _ AVR_RFID_IO.pdf

1K
(WR)PG0 | 33 (RD)PG1 | 34 (A8)PC0 | 35 (A9)PC1 | 36 (A10)PC2 | 37 (A11)PC3 | 38 (A12)PC4 | 39 (A13)PC5 | 40 (A14)PC6 | 41 (A15)PC7 | 42 (ALE)PG2 | 43 (AD7)PA7 | 44 (AD6)PA6 | 45 (AD5)PA5 | 46 (AD4)PA4 | 47 (AD3)PA3 | 48

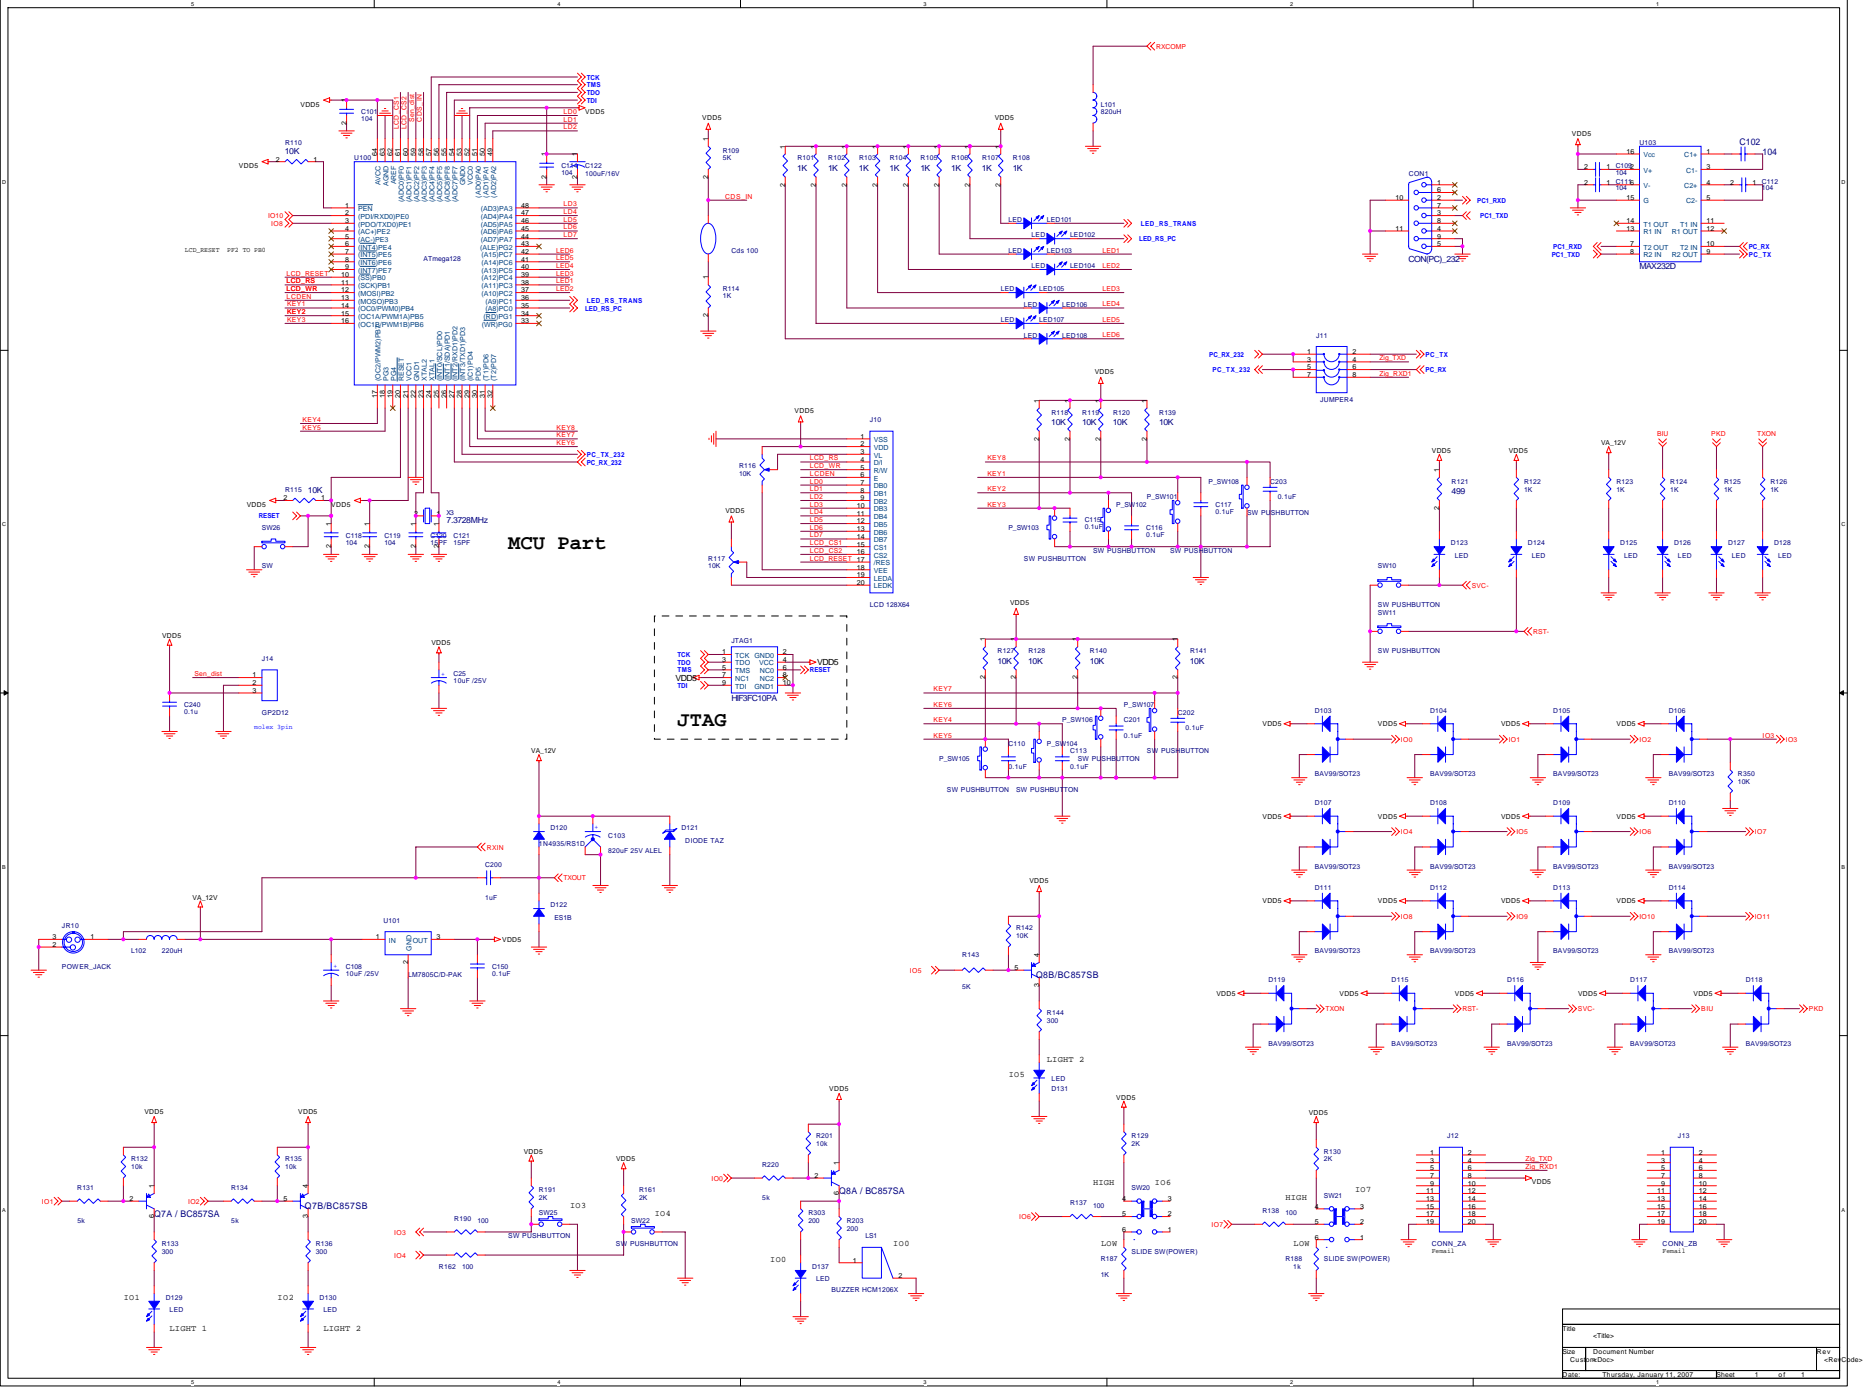
[picture p718: page 1]
