JDSCS-Club/DENVER_CCP/DOC/01_인터페이스_설계/LON_Works/05_하드웨어_회로도/SCHEMATIC1 _ DISPLAY_IO.pdf

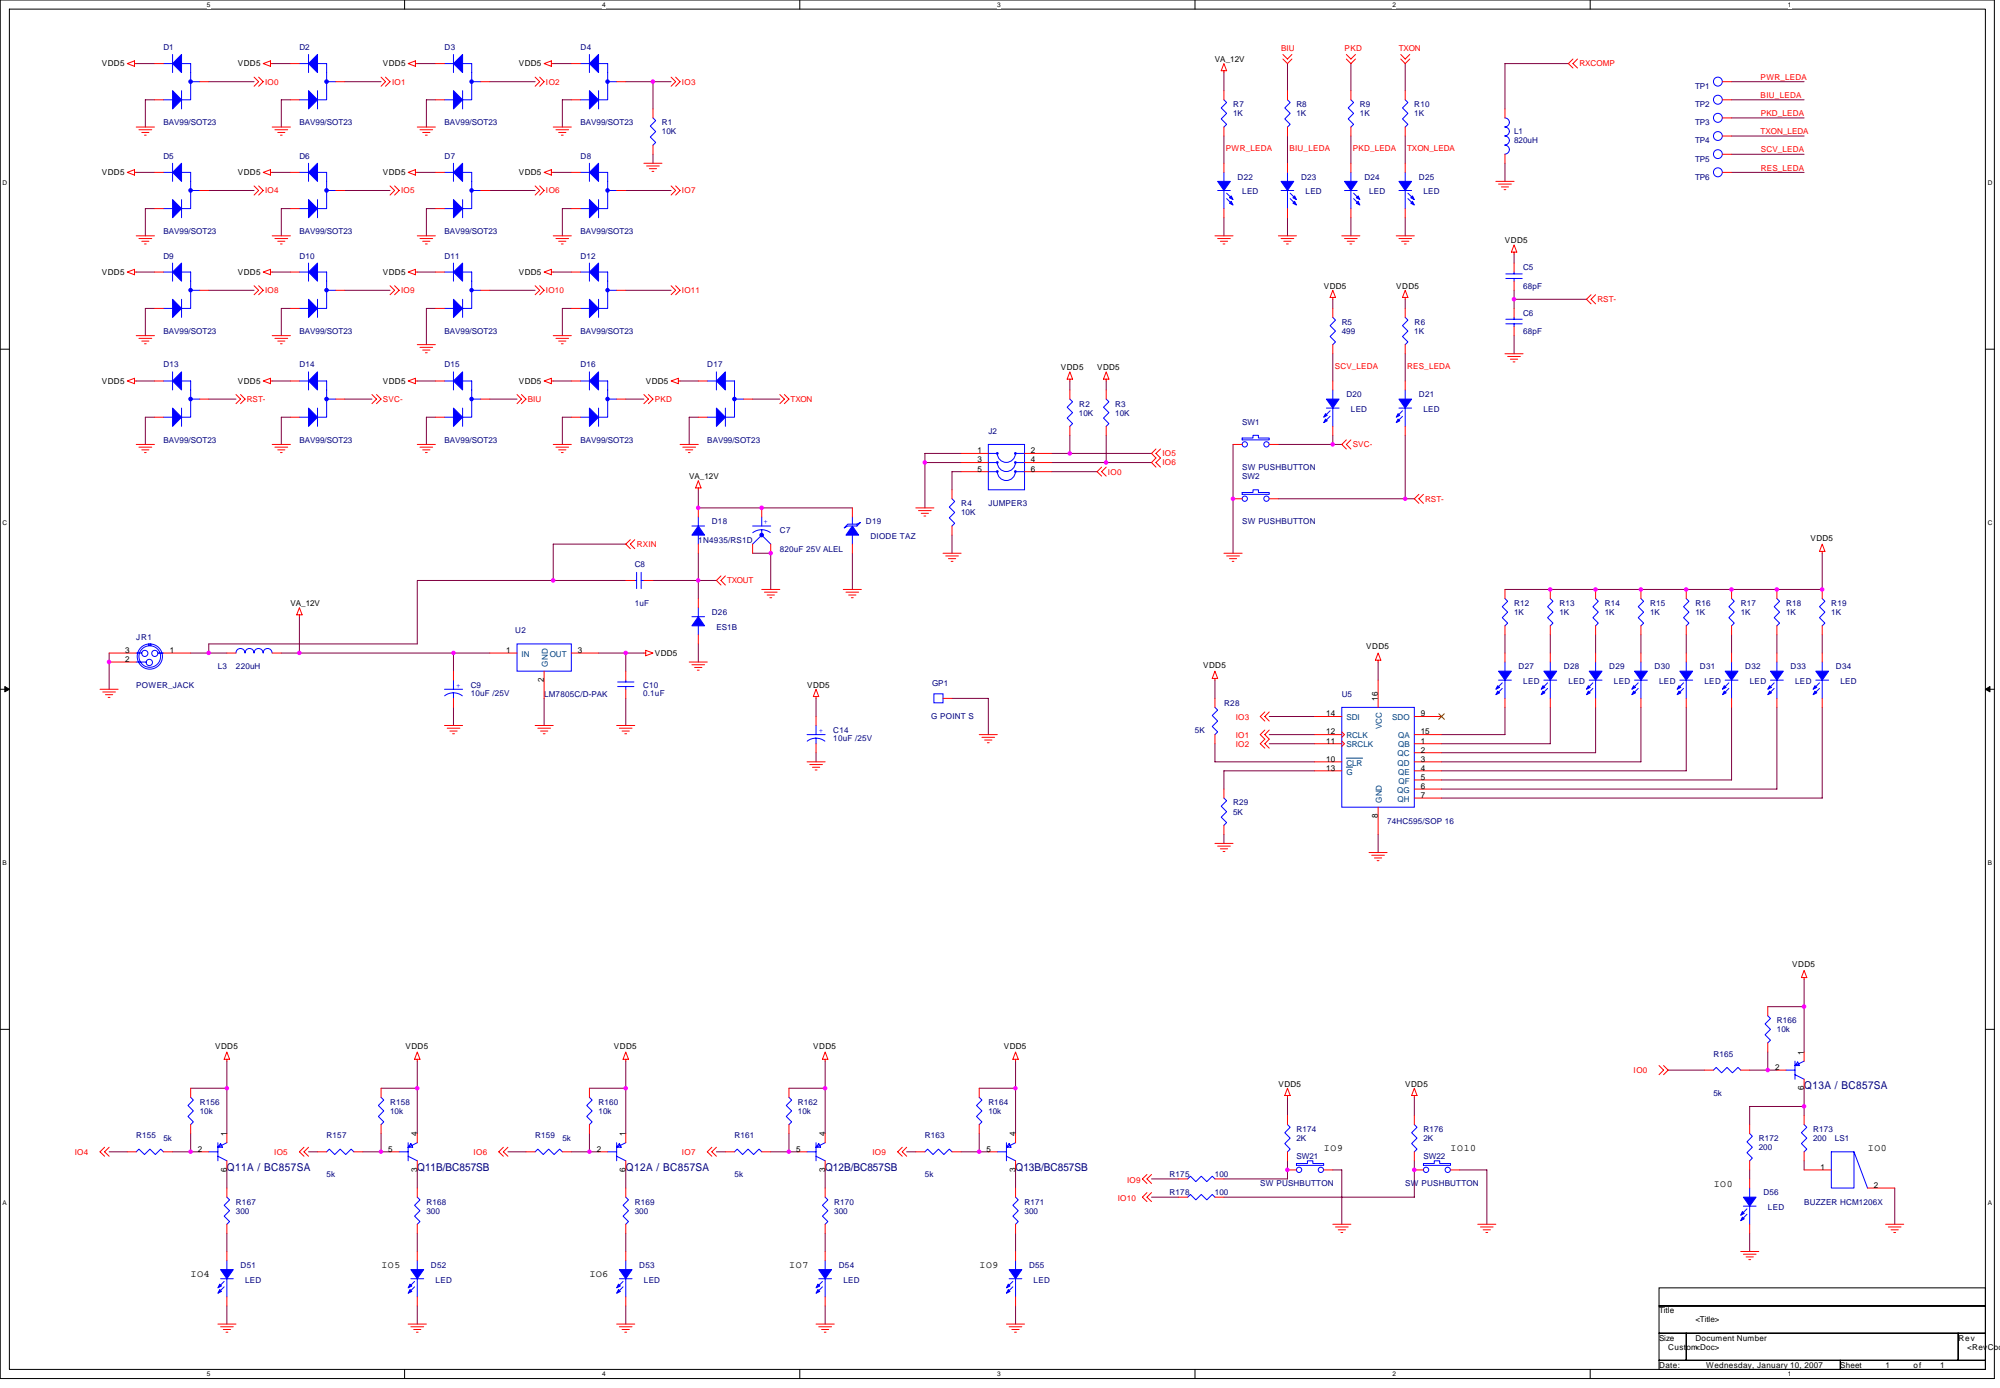
[picture p719: page 1]
