JDSCS-Club/DENVER_CCP/DOC/01_인터페이스_설계/LON_Works/05_하드웨어_회로도/SCHEMATIC1 _ PL3120CONTROL_IO.pdf

### PC_TXD

### PC_RXD

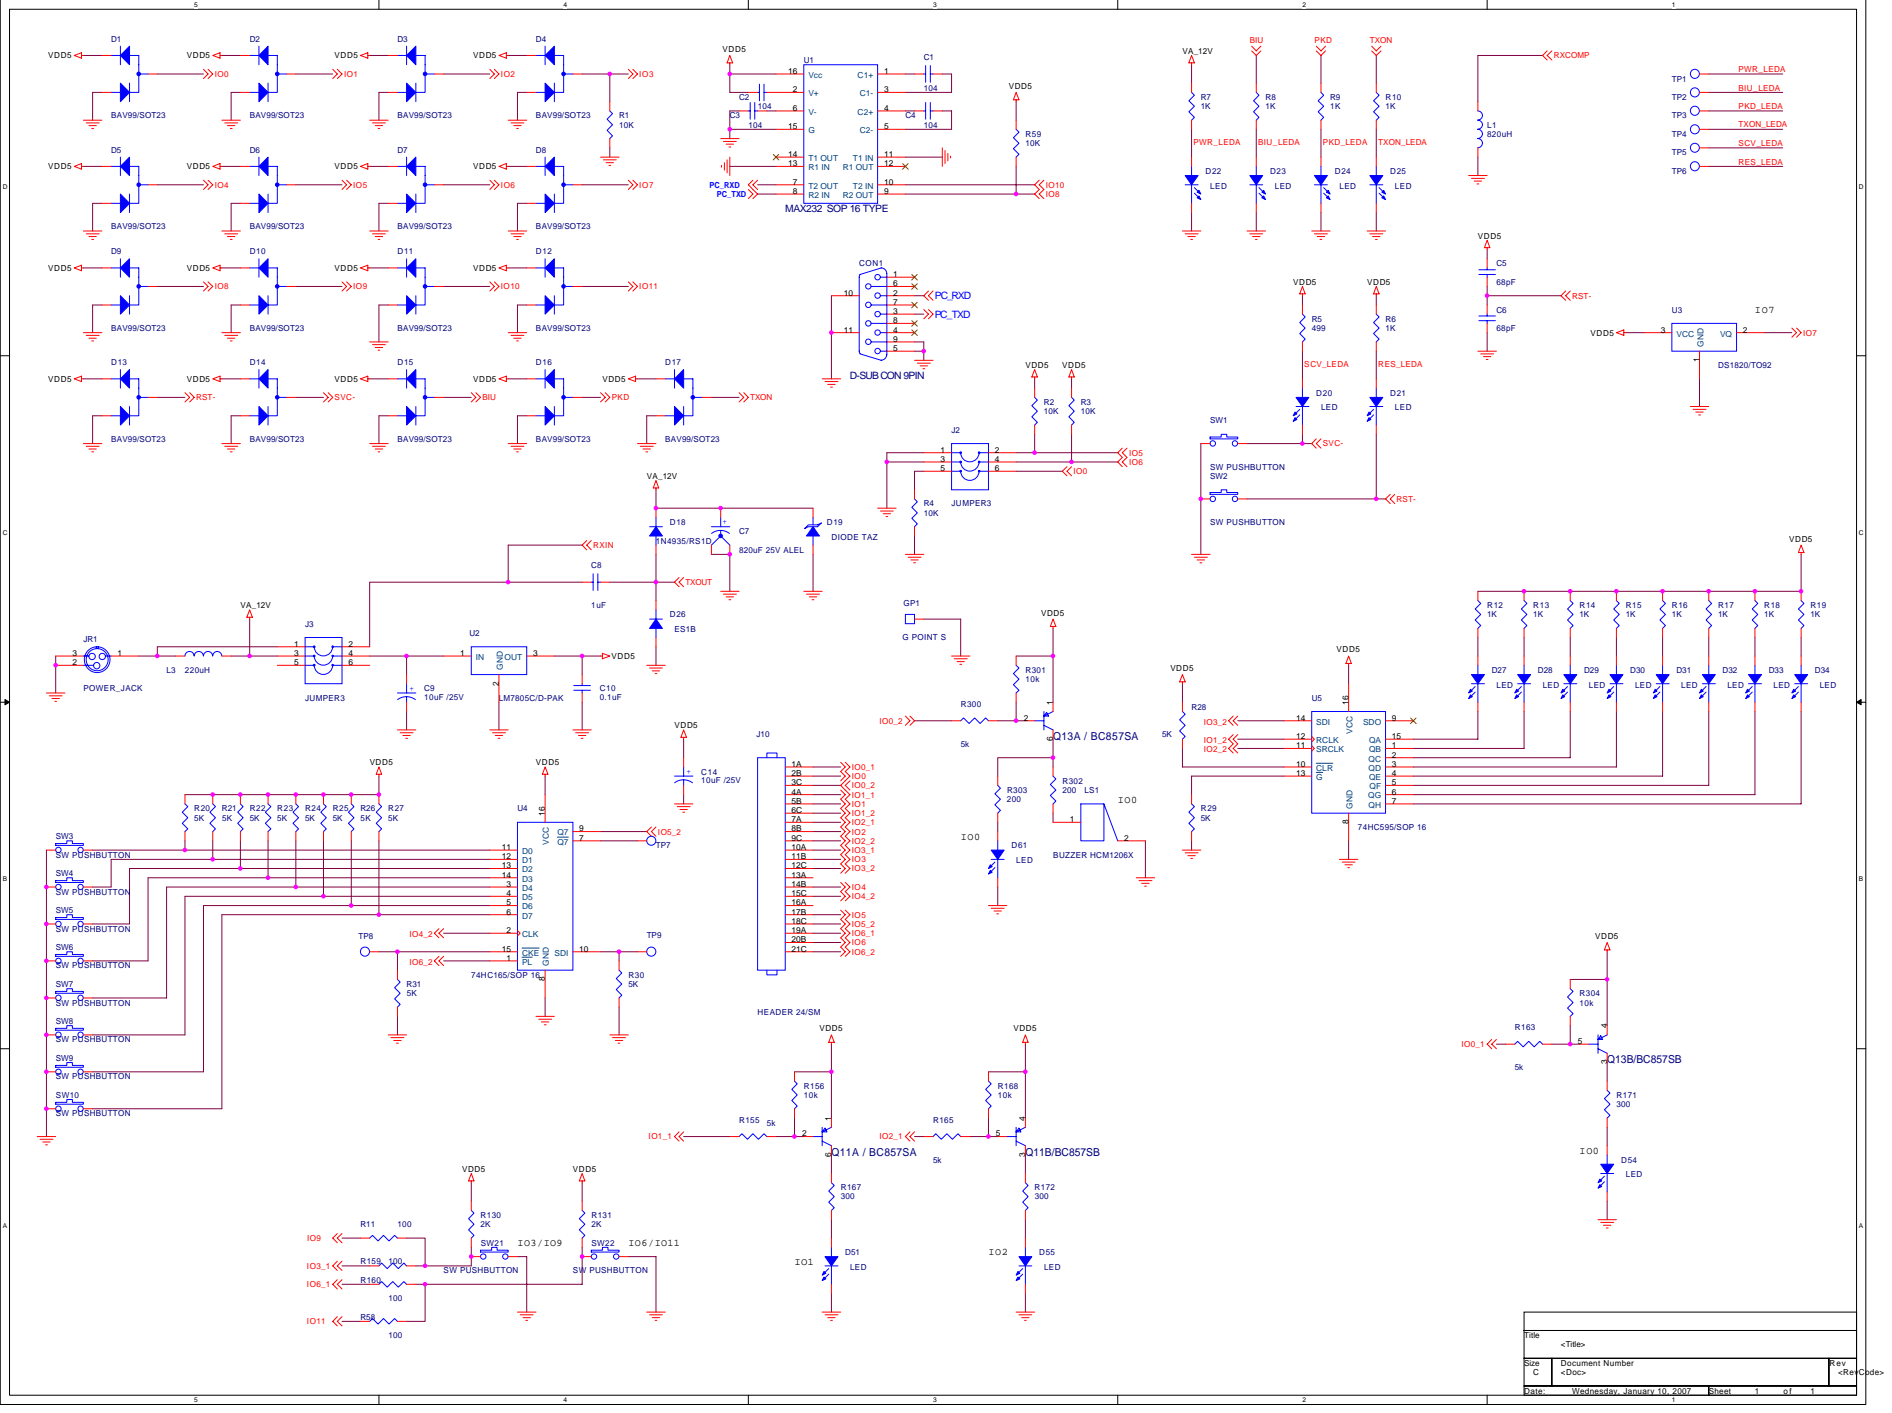
[picture p720: page 1]

D1 12
D2 13
D3 14
