JDSCS-Club/DENVER_CCP/DOC/01_인터페이스_설계/MDS_ICD/04_MDS_회로도/DENVER_MDS_Schematic_InOutput Signal Module_MA_REC90034CT0.pdf

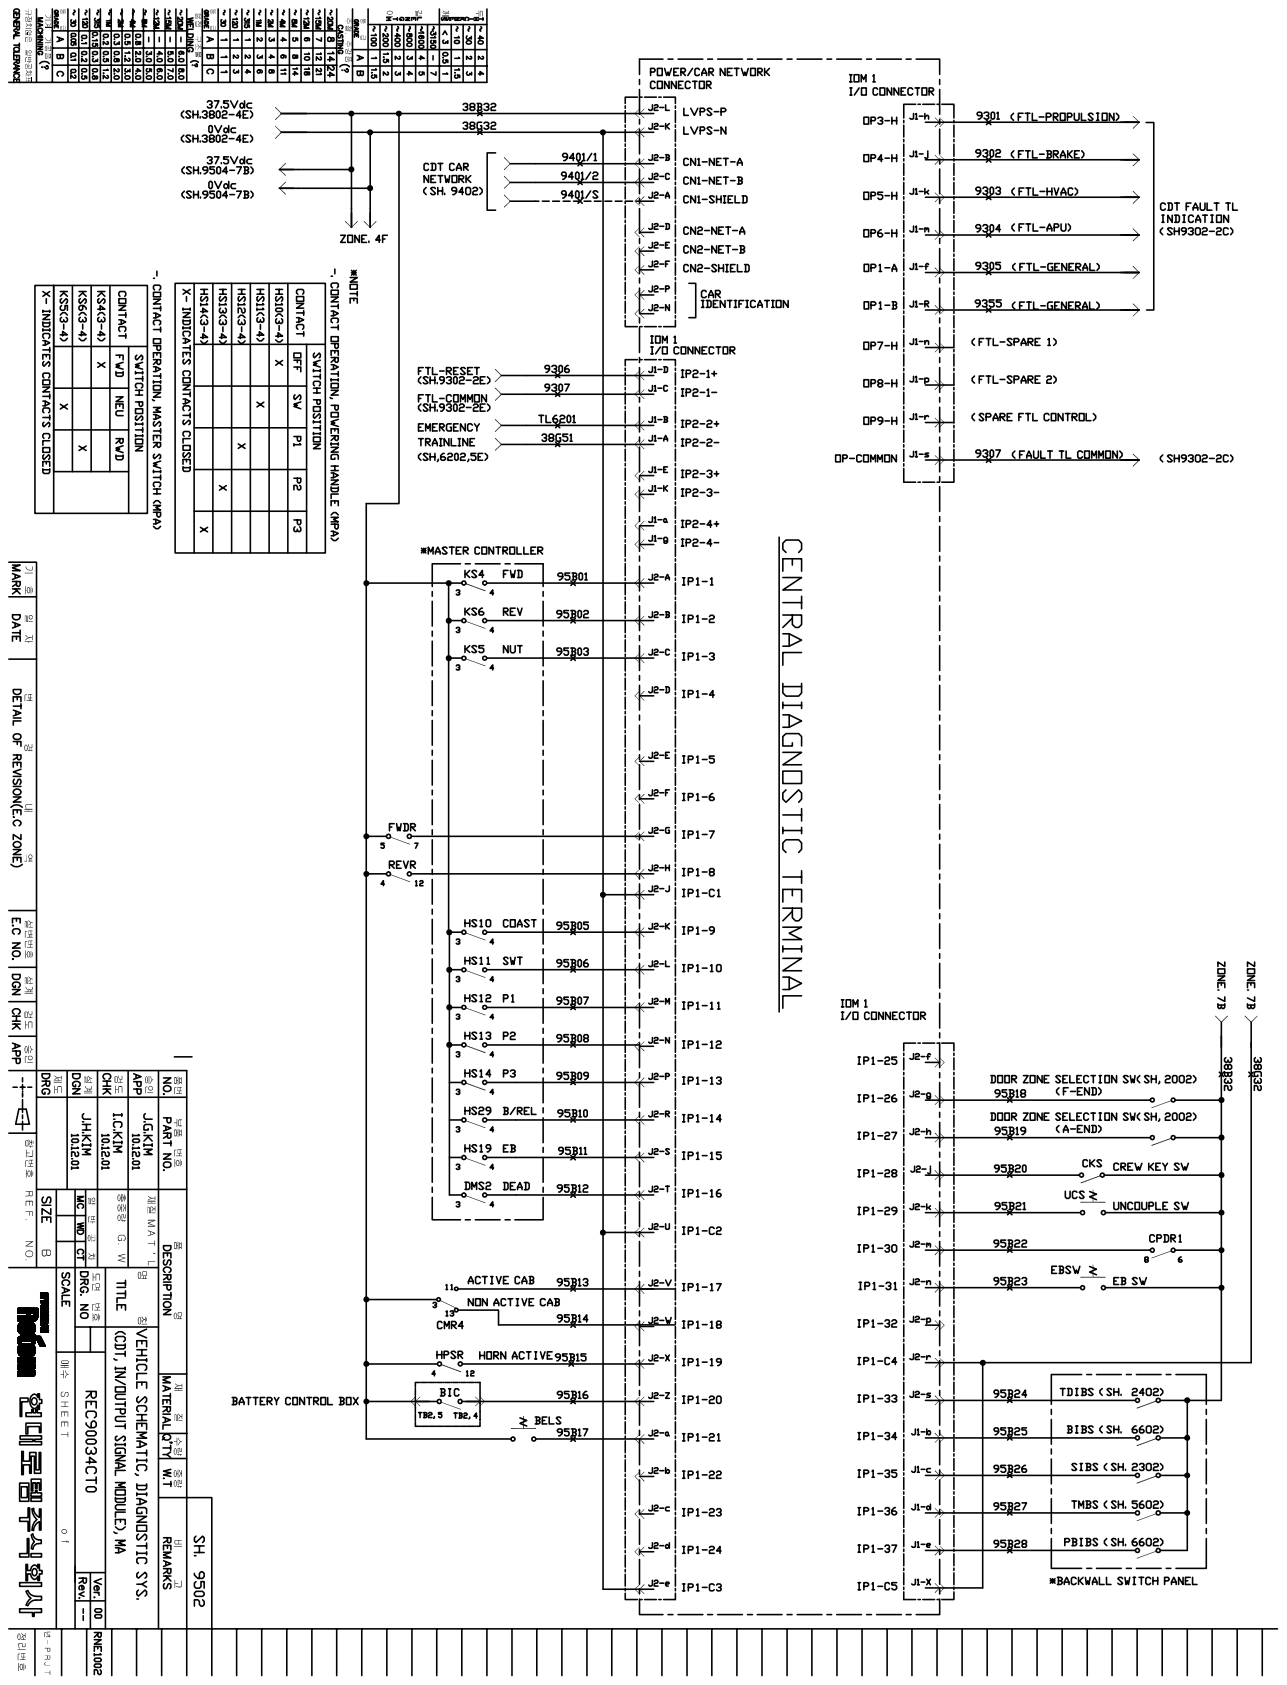
[picture p724: page 1]
