JDSCS-Club/DENVER_CCP/DOC/01_인터페이스_설계/MDS_ICD/04_MDS_회로도/DENVER_MDS_Schematic_InOutput Signal Module_MB_REC90040CT0.pdf

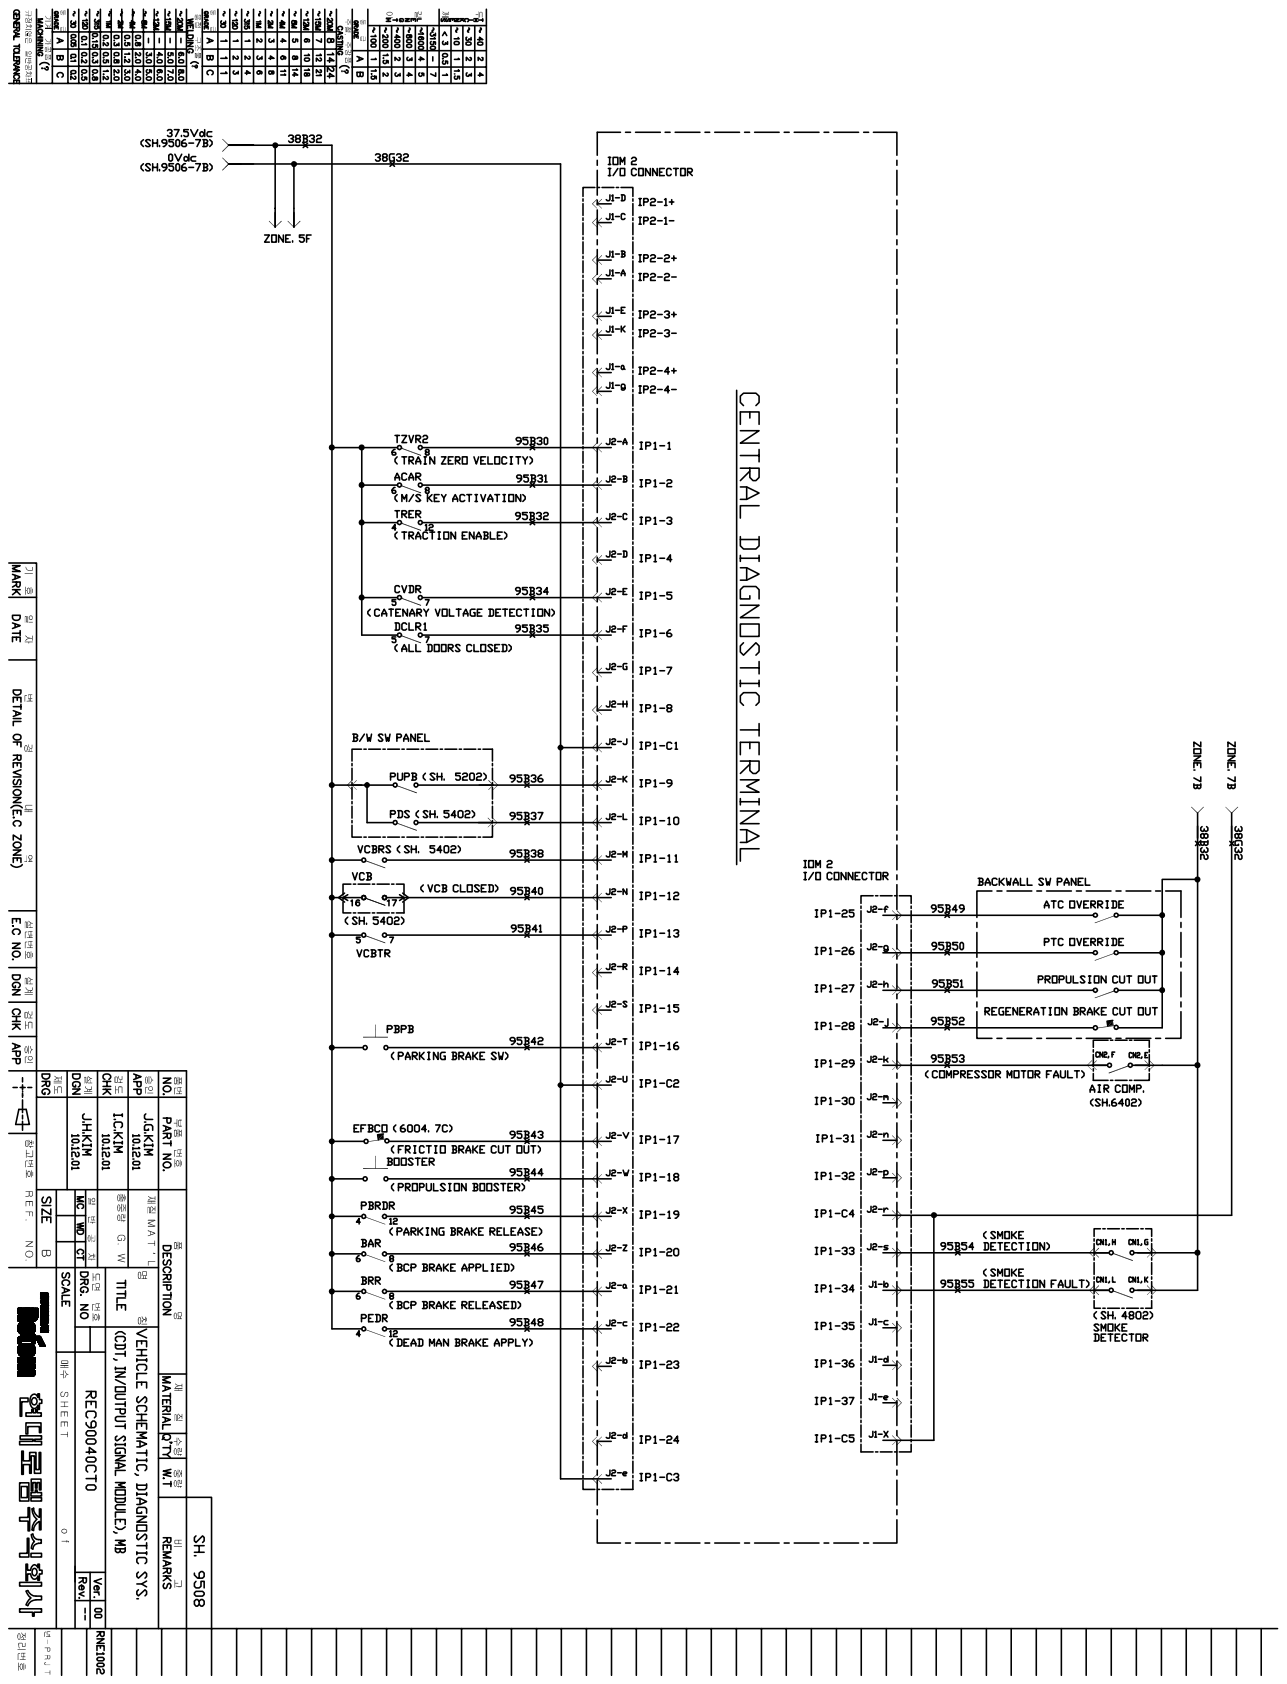
[picture p727: page 1]
