JDSCS-Club/DENVER_CCP/(list of files, drawings)

Other design files:
DOC/02_설계_도면/CCP/CCP-V1.4-121104_A(FINAL).pcb
DOC/02_설계_도면/CCP/CCP-V1.4-201201105(FINAL).DSN
DOC/02_설계_도면/CCP/ccp-v1.4-201201105(final).opj
DOC/02_설계_도면/LIC-C2/LIC-C2.DSN
DOC/02_설계_도면/LIC-C2/LIC-C2.opj
DOC/02_설계_도면/LIC-C2/LIC-C2.pcb
DOC/02_설계_도면/LIC-C2/LIC-C2B.DSN
DOC/02_설계_도면/Others/DENVER PIN.DSN
DOC/02_설계_도면/회로도/LIC-C3/LIC-C3.DSN
DOC/02_설계_도면/회로도/LIC-C3/lic-c3.opj
DOC/02_설계_도면/회로도/LIC-C3/LIC-C3.pcb
DOC/11_SW코드/2012_06_04(케나다 출장 완료)/pcb/lic/C3/LIC-C3.DSN
DOC/11_SW코드/2012_06_04(케나다 출장 완료)/pcb/lic/C3/lic-c3.opj
DOC/11_SW코드/2012_06_04(케나다 출장 완료)/pcb/lic/C3/LIC-C3.pcb
