JDSCS-Club/DENVER_CCP/DOC/11_SW코드/lic/LON_Works/참고자료_소스/68360.CFG

set vectbase = 0x0
set vectaddr = 0x0
write -l CPU:0x3FF00 = 0x01000101
write -l SD:0x01001000 = 0x6001EC7F
write -b SD:0x01001022 = 0x74
write -l SD:0x01001040 = 0x18840380
write -l SD:0x01001050 = 0x0FC00003
write -l SD:0x01001054 = 0x6FC00000
write -l SD:0x01001060 = 0x00000021
write -l SD:0x01001064 = 0x1FF00009
write -b SD:0x0100100C = 0x0F
write -w SD:0x01001010 = 0x0000
write -w SD:0x01001014 = 0x0000
write -w SD:0x01001016 = 0x3440
