JDSCS-Club/DENVER_CCP/CCP/SW/엑스바이더/CCP_1.0.0.2/bmpfile.h

#pragma once

#define IDB_MAIN_BG                     "\\NandFlash\\res\\main_bg.bmp"
#define IDB_CHECK_CAR_BG                "\\NandFlash\\res\\check_car_bg.bmp"
#define IDB_DEFAULT_BG                  "\\NandFlash\\res\\default_bg.bmp"
#define IDB_HOME_BG                     "\\NandFlash\\res\\home_bg.bmp"
#define IDB_MSG_BG                      "\\NandFlash\\res\\message_bg.bmp"
#define IDB_ROUTE_BG                    "\\NandFlash\\res\\route_bg.bmp"
#define IDB_CREW_TRAIN_BG               "\\NandFlash\\res\\crew_train_bg.bmp"
#define IDB_CHECK_SINGLE_BG             "\\NandFlash\\res\\check_single.bmp"
#define IDB_CHECK_MARRIEDA_BG           "\\NandFlash\\res\\check_marrieda.bmp"
#define IDB_CHECK_MARRIEDB_BG           "\\NandFlash\\res\\check_marriedb.bmp"
#define IDB_PEI_MARRIEDA_BG				"\\NandFlash\\res\\pei_marrieda.bmp"
#define IDB_PEI_MARRIEDB_BG				"\\NandFlash\\res\\pei_marriedb.bmp"
#define IDB_CONFIG_LCD_BG               "\\NandFlash\\res\\config_lcd_bg.bmp"
#define IDB_CONFIG_RESET_BG             "\\NandFlash\\res\\reset_confirm.bmp"
#define IDB_SPEAKER_BG                  "\\NandFlash\\res\\speaker_bg.bmp"
#define IDB_TOUCH_POINTER               "\\NandFlash\\res\\touch_pointer.bmp"
#define IDB_CAP_HOME                    "\\NandFlash\\res\\messagebar-1.bmp"
#define IDB_CAP_TRAIN                   "\\NandFlash\\res\\messagebar-2.bmp"
#define IDB_CAP_CREW                    "\\NandFlash\\res\\messagebar-3.bmp"
#define IDB_CAP_ROUTE                   "\\NandFlash\\res\\messagebar-4.bmp"
#define IDB_CAP_CONFIG                  "\\NandFlash\\res\\messagebar-5.bmp"
#define IDB_CAP_CHECK                   "\\NandFlash\\res\\messagebar-6.bmp"
#define IDB_CAP_HELP                    "\\NandFlash\\res\\messagebar-7.bmp"
#define IDB_CAP_PEI                     "\\NandFlash\\res\\messagebar-8.bmp"
#define IDB_CHECK_CAR_RED               "\\NandFlash\\res\\car_red.bmp"
#define IDB_CHECK_CAR_GREEN             "\\NandFlash\\res\\car_green.bmp"

#define IDB_MAIN_HOME_DN                "\\NandFlash\\res\\main_home_dn.bmp"
#define IDB_MAIN_HOME_UP                "\\NandFlash\\res\\main_home_up.bmp"
#define IDB_MAIN_TRAIN_DN               "\\NandFlash\\res\\main_train_dn.bmp"
#define IDB_MAIN_TRAIN_UP               "\\NandFlash\\res\\main_train_up.bmp"
#define IDB_MAIN_CREW_DN                "\\NandFlash\\res\\main_crew_dn.bmp"
#define IDB_MAIN_CREW_UP                "\\NandFlash\\res\\main_crew_up.bmp"
#define IDB_MAIN_CHECK_DN               "\\NandFlash\\res\\main_check_dn.bmp"
#define IDB_MAIN_CHECK_UP               "\\NandFlash\\res\\main_check_up.bmp"
#define IDB_MAIN_CONFIG_DN              "\\NandFlash\\res\\main_config_dn.bmp"
#define IDB_MAIN_CONFIG_UP              "\\NandFlash\\res\\main_config_up.bmp"
#define IDB_MAIN_HELP_DN                "\\NandFlash\\res\\main_help_dn.bmp"
#define IDB_MAIN_HELP_UP                "\\NandFlash\\res\\main_help_up.bmp"
#define IDB_MAIN_ROUTE_DN               "\\NandFlash\\res\\main_route_dn.bmp"
#define IDB_MAIN_ROUTE_UP               "\\NandFlash\\res\\main_route_up.bmp"
#define IDB_MAIN_MSG_UP                 "\\NandFlash\\res\\main_msg_up.bmp"
#define IDB_MAIN_MSG_DN                 "\\NandFlash\\res\\main_msg_dn.bmp"
#define IDB_MAIN_PEI_DN                 "\\NandFlash\\res\\main_pei_dn.bmp"
#define IDB_MAIN_PEI_UP					"\\NandFlash\\res\\main_pei_up.bmp"
#define IDB_MAIN_PEI_OR                 "\\NandFlash\\res\\main_pei_or.bmp"
#define IDB_MAIN_PR_DN					"\\NandFlash\\res\\main_cm_dn.bmp"
#define IDB_MAIN_PR_UP					"\\NandFlash\\res\\main_cm_up.bmp"

#define IDB_CAP_HOME                    "\\NandFlash\\res\\messagebar-1.bmp"
#define IDB_CAP_TRAIN                   "\\NandFlash\\res\\messagebar-2.bmp"
#define IDB_CAP_CREW                    "\\NandFlash\\res\\messagebar-3.bmp"
#define IDB_CAP_ROUTE                   "\\NandFlash\\res\\messagebar-4.bmp"
#define IDB_CAP_CONFIG                  "\\NandFlash\\res\\messagebar-5.bmp"
#define IDB_CAP_CHECK                   "\\NandFlash\\res\\messagebar-6.bmp"
#define IDB_CAP_HELP                    "\\NandFlash\\res\\messagebar-7.bmp"
#define IDB_CAP_PEI                     "\\NandFlash\\res\\messagebar-8.bmp"
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
