JDSCS-Club/DENVER_CCP/DOC/11_SW코드/lic/LIC_MCU/Ver1.0.35_20150917/xr16l784.c

#include "def.h"
#include "user.h"
#include "xr16l784.h"

UCHAR *m_ucXr16l784TxBuf1 = (UCHAR *)NVSRAM_UARTMONFIFO_BASE;
//UCHAR *m_ucXr16l784TxBuf1[XR16L784_TXBUF_1CH_MAX];
//UCHAR m_ucXr16l784TxBuf1Temp[XR16L784_BUF_1CH_MAX];
UCHAR m_ucXr16l784RxBuf1[XR16L784_RXBUF_1CH_MAX];
int m_nXr16l784TxLen1 = 0;
int m_nXr16l784TxLen1Temp = 0;
int m_nXr16l784TxPos1 = 0;
int m_nXr16l784TxRear1 = 1;
int m_nXr16l784TxFront1 = 0;
int m_nXr16l784RxLen1 = 0;
int m_nXr16l784RxRear1 = 1;
int m_nXr16l784RxFront1 = 0;
int m_nXr16l784TxEnableDly1 = 0;
int m_nXr16l784TxStartEnableDly1 = 0;

UCHAR m_ucXr16l784TxBuf2[XR16L784_BUF_2CH_MAX];
UCHAR m_ucXr16l784TxBuf2Temp[XR16L784_BUF_2CH_MAX];
UCHAR m_ucXr16l784RxBuf2[XR16L784_BUF_2CH_MAX];
int m_nXr16l784TxLen2 = 0;
int m_nXr16l784TxLen2Temp = 0;
int m_nXr16l784TxPos2 = 0;
int m_nXr16l784TxRear2 = 1;
int m_nXr16l784TxFront2 = 0;
int m_nXr16l784RxLen2 = 0;
int m_nXr16l784RxRear2 = 1;
int m_nXr16l784RxFront2 = 0;
int m_nXr16l784TxEnableDly2 = 0;
int m_nXr16l784TxStartEnableDly2 = 0;

UCHAR m_ucXr16l784TxBuf3[XR16L784_BUF_3CH_MAX];
UCHAR m_ucXr16l784TxBuf3Temp[XR16L784_BUF_3CH_MAX];
UCHAR m_ucXr16l784RxBuf3[XR16L784_BUF_3CH_MAX];
int m_nXr16l784TxLen3 = 0;
int m_nXr16l784TxLen3Temp = 0;
int m_nXr16l784TxPos3 = 0;
int m_nXr16l784TxRear3 = 1;
int m_nXr16l784TxFront3 = 0;
int m_nXr16l784RxLen3 = 0;
int m_nXr16l784RxRear3 = 1;
int m_nXr16l784RxFront3 = 0;
int m_nXr16l784TxEnableDly3 = 0;
int m_nXr16l784TxStartEnableDly3 = 0;

UCHAR m_ucXr16l784TxBuf4[XR16L784_BUF_4CH_MAX];
UCHAR m_ucXr16l784TxBuf4Temp[XR16L784_BUF_4CH_MAX];
UCHAR m_ucXr16l784RxBuf4[XR16L784_BUF_4CH_MAX];
int m_nXr16l784TxLen4 = 0;
int m_nXr16l784TxLen4Temp = 0;
int m_nXr16l784TxPos4 = 0;
int m_nXr16l784TxRear4 = 1;
int m_nXr16l784TxFront4 = 0;
int m_nXr16l784RxLen4 = 0;
int m_nXr16l784RxRear4 = 1;
int m_nXr16l784RxFront4 = 0;
int m_nXr16l784TxEnableDly4 = 0;
int m_nXr16l784TxStartEnableDly4 = 0;

PXR16L784BDY pXr16Reg = (XR16L784BDY *)XR16L784_BASE;
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
