JDSCS-Club/DENVER_CCP/(commit log)

2026-04-01 덴버 CCP Git 등록
    [CCP-V1.4-121104_A(FINAL).pcb, CCP-V1.4-201201105(FINAL).DSN, Config.cfg, ccp-v1.4-201201105(final).opj]
2026-04-02 덴버 정리 1/8 - 인터페이스설계
    [92_REDE114559_MDS Diagnostics Data Dictionary_R0.xls, DCM-0432-0200-R01 Diagnostic Data Dictionary (Woojin).xls, DCM-0432-0200-R01 Diagnostic Data Dictionary.xls, DCM-0432-0200-R03 Diagnostic Data Dictionary Main_(Supplier Fault Code Update).xls, DDD_1_5(원본).xls, DDD_1_5.xls, DDD_20111114.xls, DENVER - R04 - 2012-04-27.xlsx]
2026-04-02 덴버 정리 2/8 - 설계도면
    [APEM_2.dxf, APEM_3.dxf, APEM_4.dxf, APEM_5.dxf, APEM_6.dxf, APEM_7.dxf, APEM_8.dxf, APEM_9.dxf]
2026-04-02 덴버 정리 3/8 - 시험인증, SW문서
    [Appendix III_Corrective Maintenance Analysis.xls, Appendix II_Risk Matrix.xls, Appendix IV_Reliability Prediction for Communication System.xls, Appendix IV_Scheduled Preventive Maintenance Plan (Format).xls, Appendix IX_SHA.xls, Appendix I_List of LRU and LLRU.xls, Appendix VIII_Subsystem Hazard Analysis.xls, Appendix VII_PHA.xls]
2026-04-02 덴버 정리 4/8 - 정비매뉴얼
    [01-09.AAB1 Board1.dwg, 01-10.AAB1 Board2.dwg, 01-11.AAB1 Layer1.dwg, 01-12.AAB1 Layer2.dwg, 01-13.AAB1 Layer3.dwg, 01-14.AAB1 Layer4.dwg, 01-15.AAB1 Partlist1.dwg, 01-16.AAB1 Partlist2.dwg]
2026-04-02 덴버 정리 5a - 이슈대응/FMI
    [() PTT BOX ASSY.stp, 2016-0211 PTT BOX R03.dwg, 770-713.CATPart, 770_203(WAGO).CATPart, BLIND RIVET SSK-(42 grip1.6-3.2) -SSBS D3.2mm.CATPart, DCFAN(AFB1248SHE-TC50 DELTA).CATProduct, Denver_Software Version Revision History_180214.xls, Denver_Software Version Revision History_180406.xls]
2026-04-02 덴버 정리 5b - 이슈대응/CNCS발열, 자동방송불량
    [770-713.CATPart, 770_203(WAGO).CATPart, BLIND RIVET SSK-(42 grip1.6-3.2) -SSBS D3.2mm.CATPart, CNCS failure list 20161102.xlsx, DCFAN(AFB1248SHE-TC50 DELTA).CATProduct, EXHAUST FAN MODULE ASSY.CATProduct, FAN MOUNT FRAME AL t2 Anodizing.CATPart, FAN MOUNT FRAME ASSY.CATProduct]
2026-04-02 덴버 정리 5c - 이슈대응/기타문서
    [120605 VOIPC GPIO and 485.xlsx, 121027 VOIPC GPIO and 485.xlsx, 121027 VOIPC GPIO(20150425) and 485.xlsx, 2012_03_13 CCP 업무 회의.xls, DENVER - R15 - 2016-03-09.xlsx, DENVER 수리 LIST.xlsx, VoIP변경 프로토콜(2015-10-23).xlsx, 덴버 CCP 개발 진행사항.xlsx]
2026-04-02 덴버 정리 5d - 이슈대응/CCP,PID,RS485,FTP,LIC,기타
    [SEPTA 문제점 정리 - 덴버 보완 내용 정리 - 복사본.xlsx, SEPTA 문제점 정리 - 덴버 보완 내용 정리.xlsx, Test result_D4 in DPO.xlsx, 붙임2_SEPTA_ Software Version & Revision History_Total_121116_Rev_0_20121227_Comm Update.xls]
2026-04-02 덴버 정리 6 - 계약, 데이터시트, 발표, 프로그램문서
    [Action_Item_Woojin.xlsx, Combustible Material Matrix.xls, DENVER FAI Comments-2012.03.06.xlsx, DENVER_문서계획.xlsx, DENVER_전원사양(R2).xlsx, Denver FasTracks 50량 견적 100211 - 복사본 - 복사본 - 복사본.xls, Denver FasTracks 50량 견적 100211 - 복사본 - 복사본.xls, Denver FasTracks 50량 견적 100211 - 복사본.xls]
2026-04-02 덴버 정리 7 - SW코드
    [68360.CFG, CCP_PCB도면(임시)_20111008-a.dwg, CCP_PCB도면(임시)_20111008.dwg, Config.cfg, DENVER_LIC (from Jds-MacPro - 23).sdf, DENVER_LIC (from Jds-MacPro).sdf, DENVER_LIC.sdf, DPO_V_pad.csv]
2026-04-02 덴버 정리 8 - CCP, 자료, 분석문서
    [CCP-V1.4-121104_A(FINAL).pcb, CCP-V1.4-201201105(FINAL).DSN, Config.cfg, DTO PSA Parts List 102919.xlsx, Denver_FasTracks_10량_견적_140418.xls, SEPTA SLV PSA Parts List.xlsx, ccp-v1.4-201201105(final).opj, 덴버 1량 원가.xlsx]
2026-04-02 설계 자료
    [CCP-V1.4-121104_A(FINAL).pcb, CCP-V1.4-201201105(FINAL).DSN, DENVER PIN.DSN, LIC-C2.DSN, LIC-C2.opj, LIC-C2.pcb, LIC-C2B.DSN, LIC-C3.DSN]
2026-04-02 프로그램 소스 추가 정리
    [DENVER_LIC (from Jds-MacPro - 23).sdf, DENVER_LIC (from Jds-MacPro).sdf, DENVER_LIC.sdf, LIC-C3.DSN, LIC-C3.pcb, debug3x.obj, en29lv040.obj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]
2026-04-02 LIN 추가
    [DENVER_LIC (from Jds-MacPro - 23).sdf, DENVER_LIC (from Jds-MacPro).sdf, DENVER_LIC.sdf, Diagnostic Data Dictionary_Update Request to Subsystems_20150825_V100.9_....xls, debug3x.obj, decoder_pad.csv, en29lv040.obj, loninfo.obj]
2026-04-02 DOC 폴더 정리 및 Others 파일 추가
    [68360.CFG, DENVER_LIC (from Jds-MacPro - 23).sdf, DENVER_LIC (from Jds-MacPro).sdf, DENVER_LIC.sdf, Diagnostic Data Dictionary_Update Request to Subsystems_20150825_V100.9_....xls, debug3x.obj, en29lv040.obj, loninfo.obj]
