JDSCS-Club/DENVER_CCP/DOC/06_이슈_대응/기타_문서/06_사진_동영상/IMG_3890.JPG

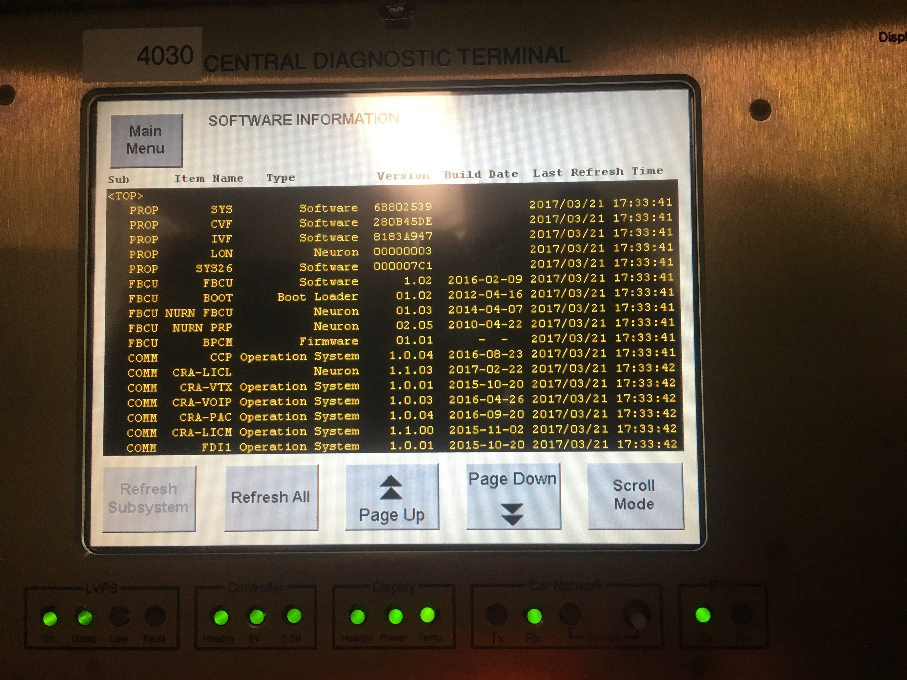
DOC/06_이슈_대응/기타_문서/06_사진_동영상/IMG_3890.JPG
